UWCubeSat/DubSat1/teams/power/Documentation/Images/Battery board V4.3 v2 Z View.png

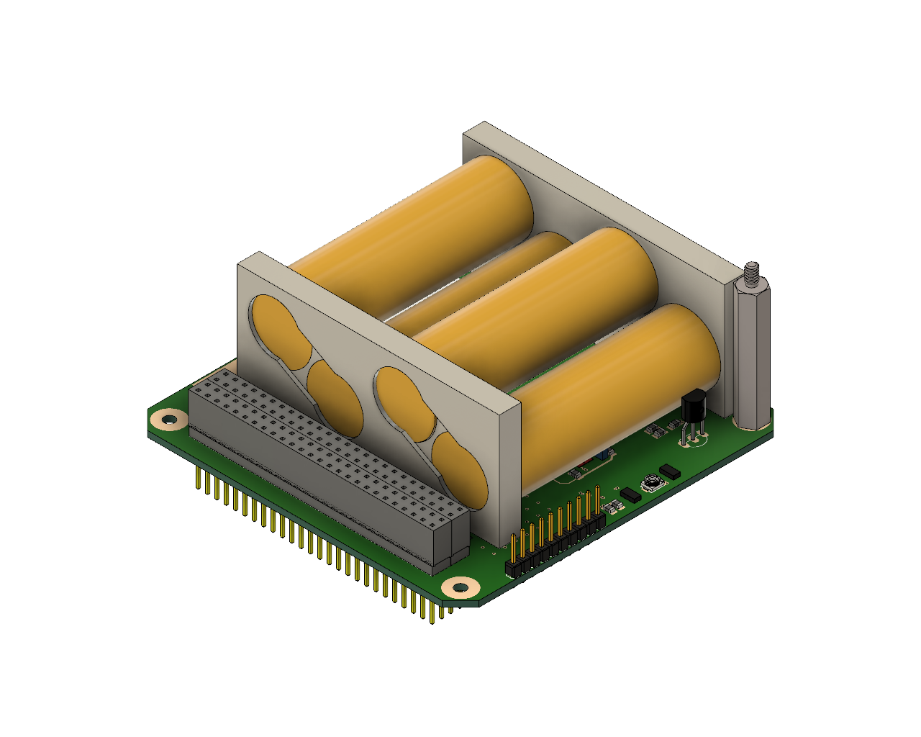
teams/power/Documentation/Images/Battery board V4.3 v2 Z View.png
