UWCubeSat/DubSat1/teams/power/Battery Board/README.md

This folder is for the Battery Board and associated assemblies.
