UWCubeSat/DubSat1/teams/power/Distribution Board/README.md

This folder is for the Distribution Board and associated assemblys
