UWCubeSat/DubSat1/teams/power/Gen Board/README.md

This folder is for the Gen Board and associated assemblies
