UWCubeSat/DubSat1/teams/power/Solar Panels/README.md

This folder is for center and side solar panels. Including assemblies and documantation related to solar panels.
