UWCubeSat/DubSat1/src/dsbase/interfaces/README.txt

This folder will hold the files that define any "interfaces" that need to be used between subsystems.  Examples of these include:

- CAN-Bus message structures (along with helpers for parsing/creating/viewing them, made as generic as possible)
- <that's all for now :)>
