UWCubeSat/DubSat1/teams/power/Gen Board/Gen Board V4/README.MD

This is an ordered board. Please See latest version
