UWCubeSat/DubSat1/teams/power/Battery Board/Battery Ballancer/README.md

This folder is for documents related to the battery balancer.
