UWCubeSat/DubSat1/teams/power/Battery Board/Coulomb Counter/README.md

This folder is for the coulomb counter. Including board designs and related documentation.
