UWCubeSat/DubSat1/teams/power/Battery Board/Battery Board V2/README.md

This is an ordered board, do not modify. See a more recent version.
