UWCubeSat/DubSat1/teams/power/Battery Board/Battery Board V3/README.md

# V3 is an ordered board please do not modify. See a more recent version.
