UWCubeSat/DubSat1/teams/power/Solar Panels/Side Panel V4/README.md

This is an ordered board, do not modify. See a more recent version.
