UWCubeSat/DubSat1/assets/calculationsCorrect.png

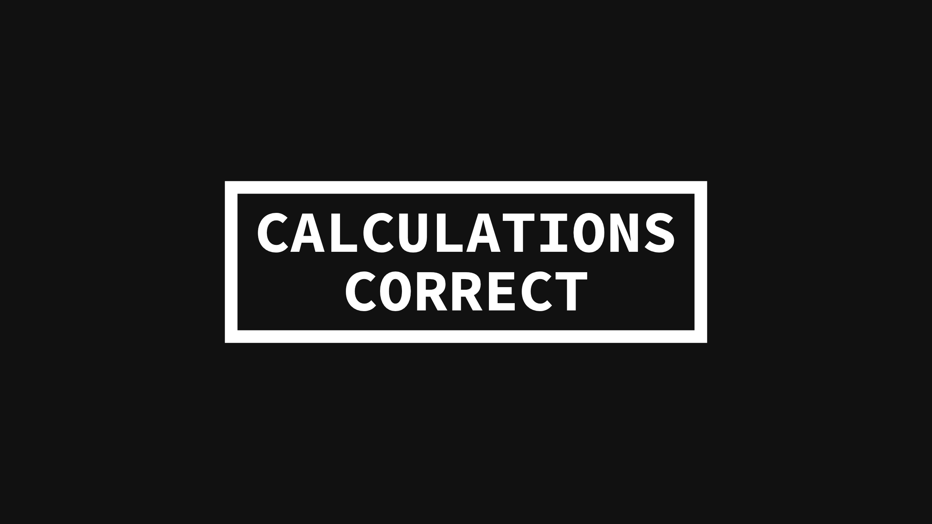
assets/calculationsCorrect.png
