UWCubeSat/DubSat1/teams/power/Documentation/Images/Blank Diagram - Page 1 (4).png

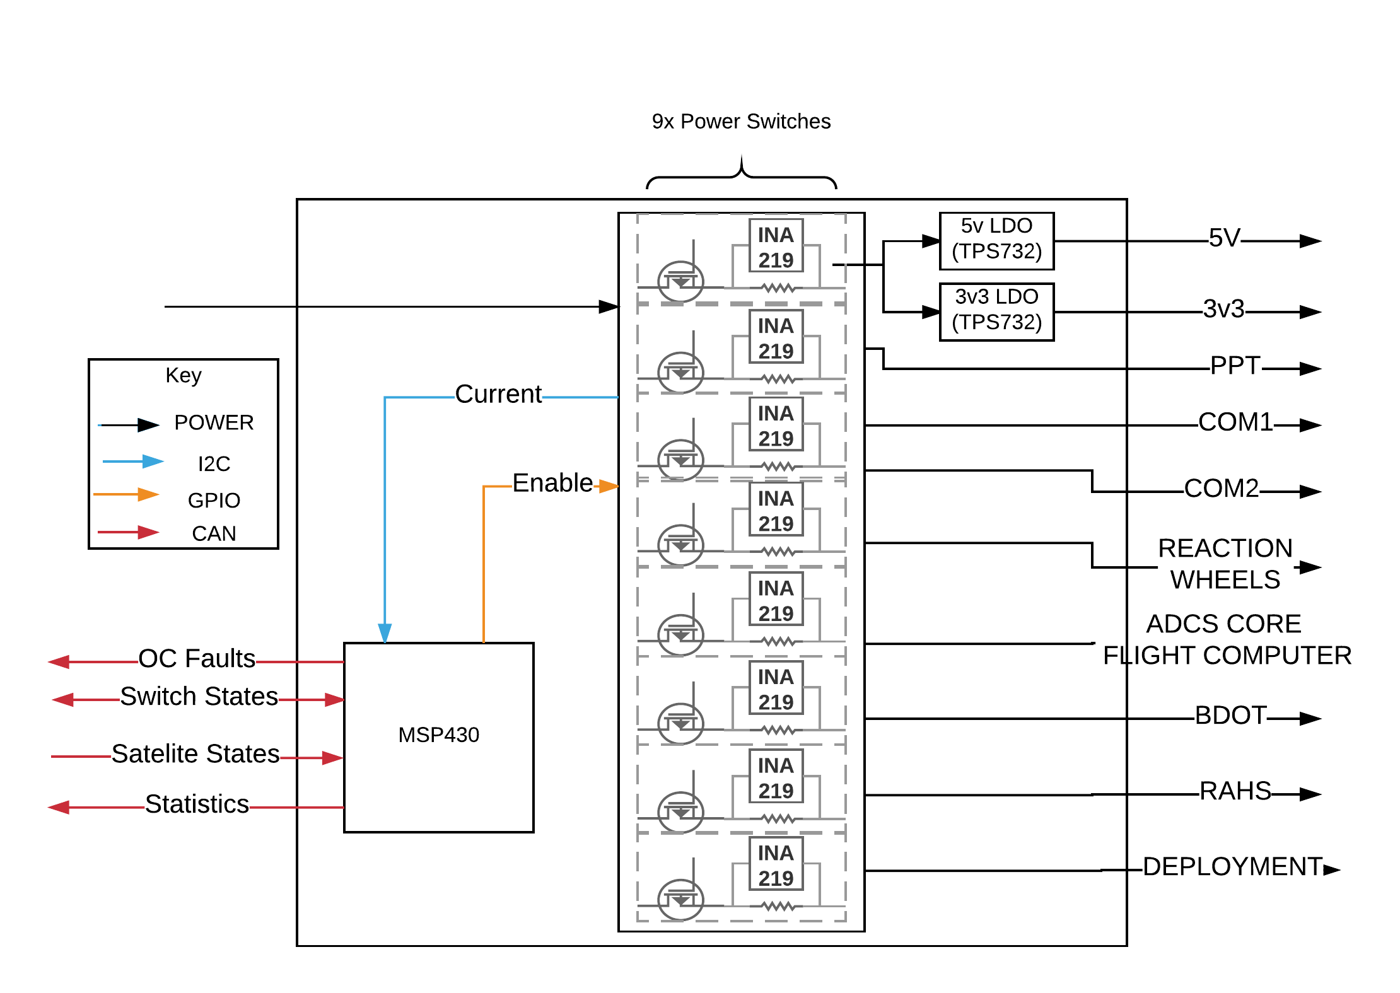
teams/power/Documentation/Images/Blank Diagram - Page 1 (4).png
