UWCubeSat/DubSat1/teams/power/Documentation/Images/Center panel V1.3 Eagle Layout.png

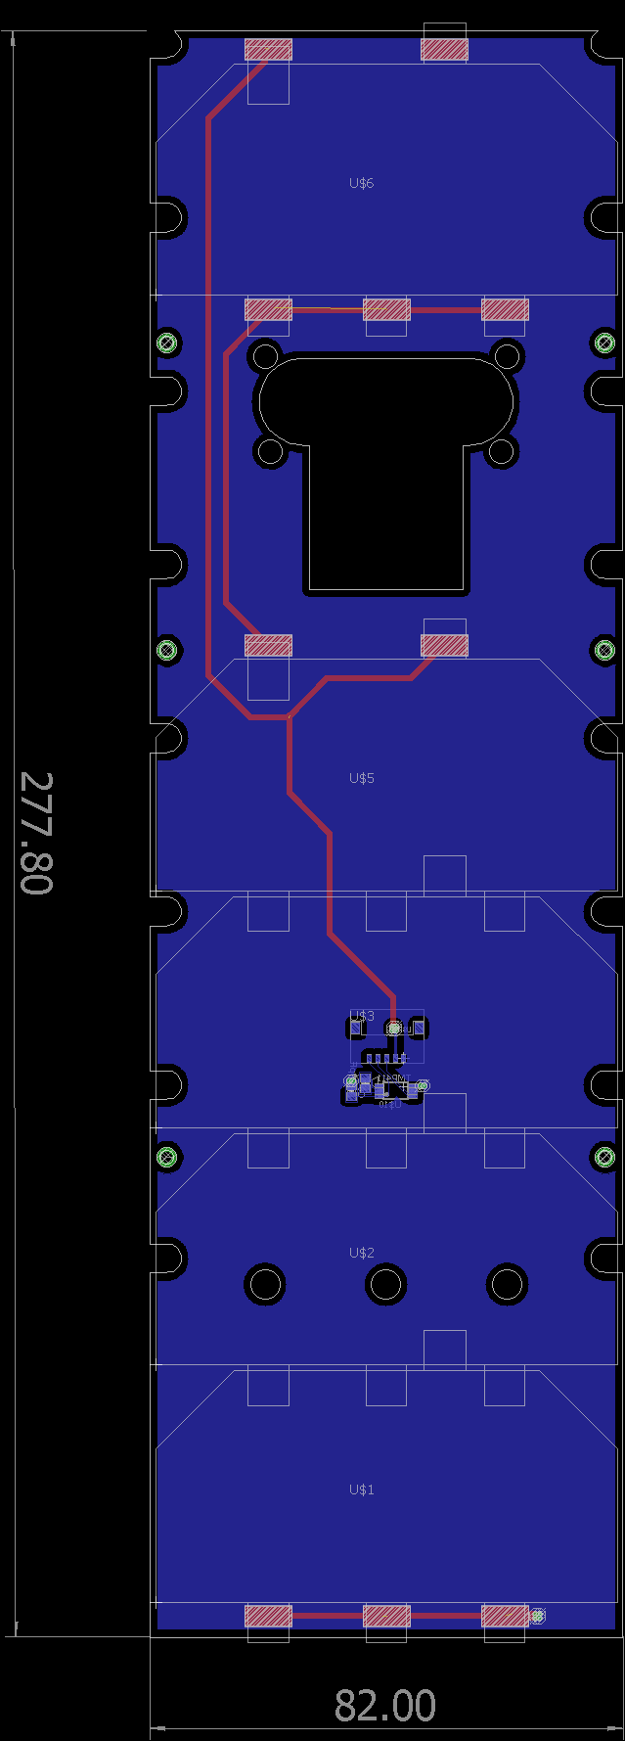
teams/power/Documentation/Images/Center panel V1.3 Eagle Layout.png
