UWCubeSat/DubSat1/teams/power/Documentation/Images/Center panel V1.3.brd v3.png

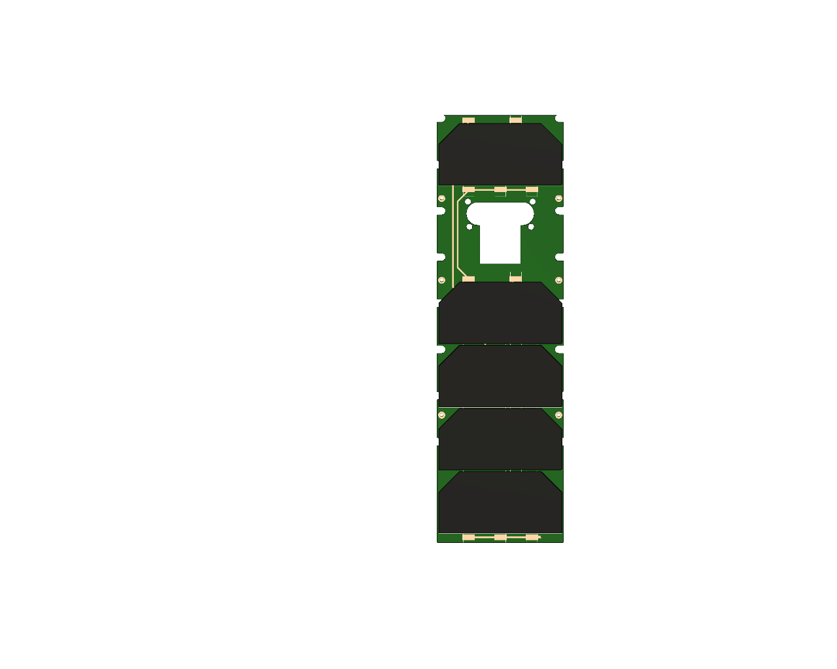
teams/power/Documentation/Images/Center panel V1.3.brd v3.png
