UWCubeSat/DubSat1/teams/power/Documentation/Images/Power Block Diagram - Page 1 (3).png

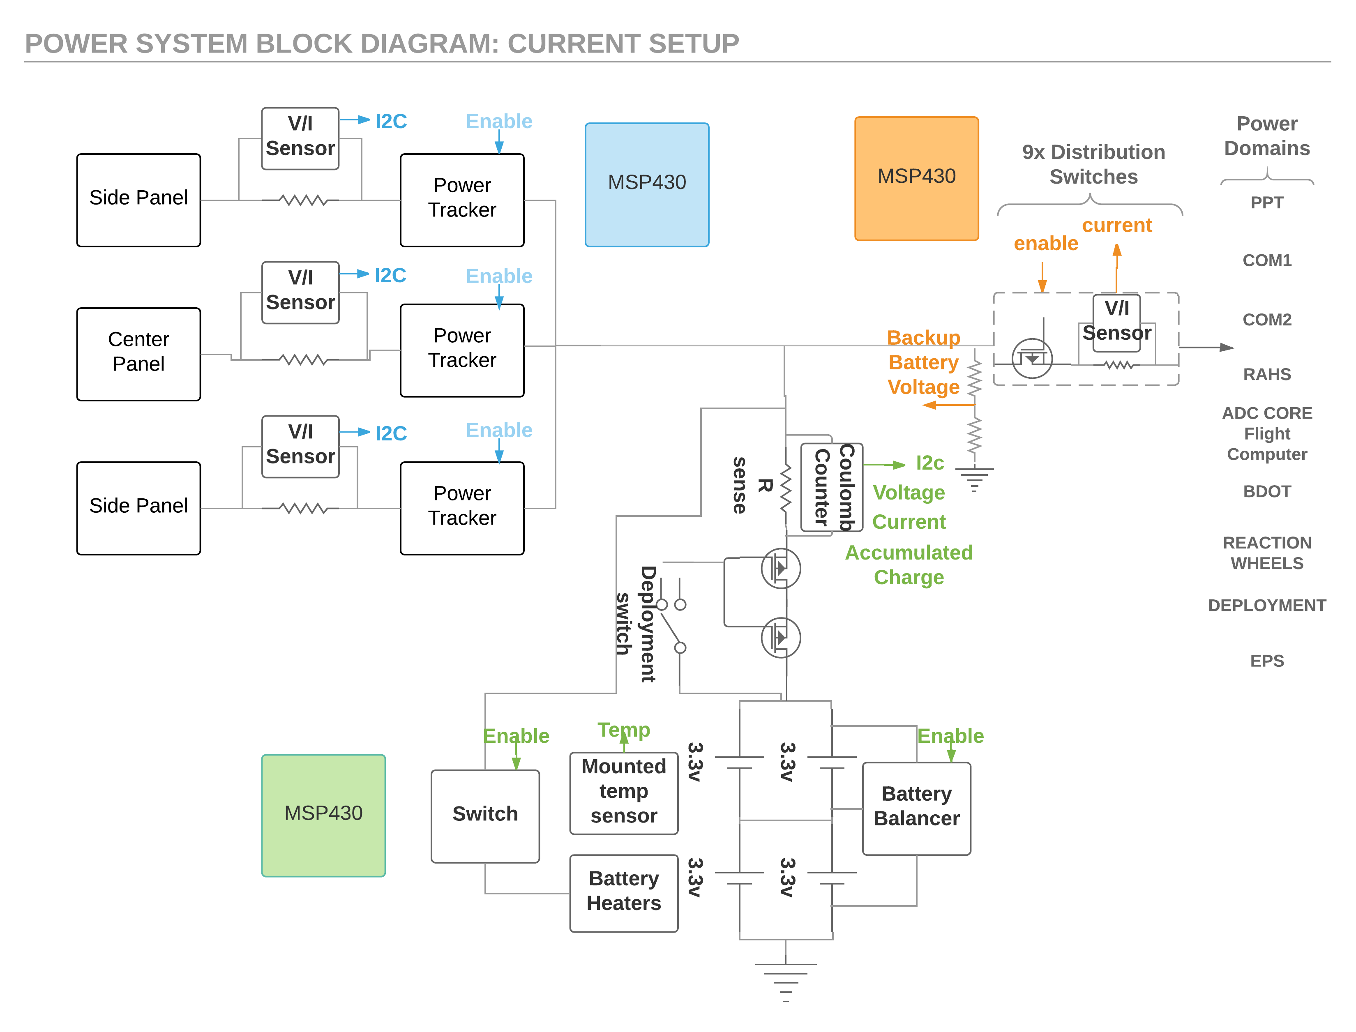
teams/power/Documentation/Images/Power Block Diagram - Page 1 (3).png
