UWCubeSat/DubSat1/teams/power/Documentation/Images/Power Gen Board Block Diagram - Page 1.png

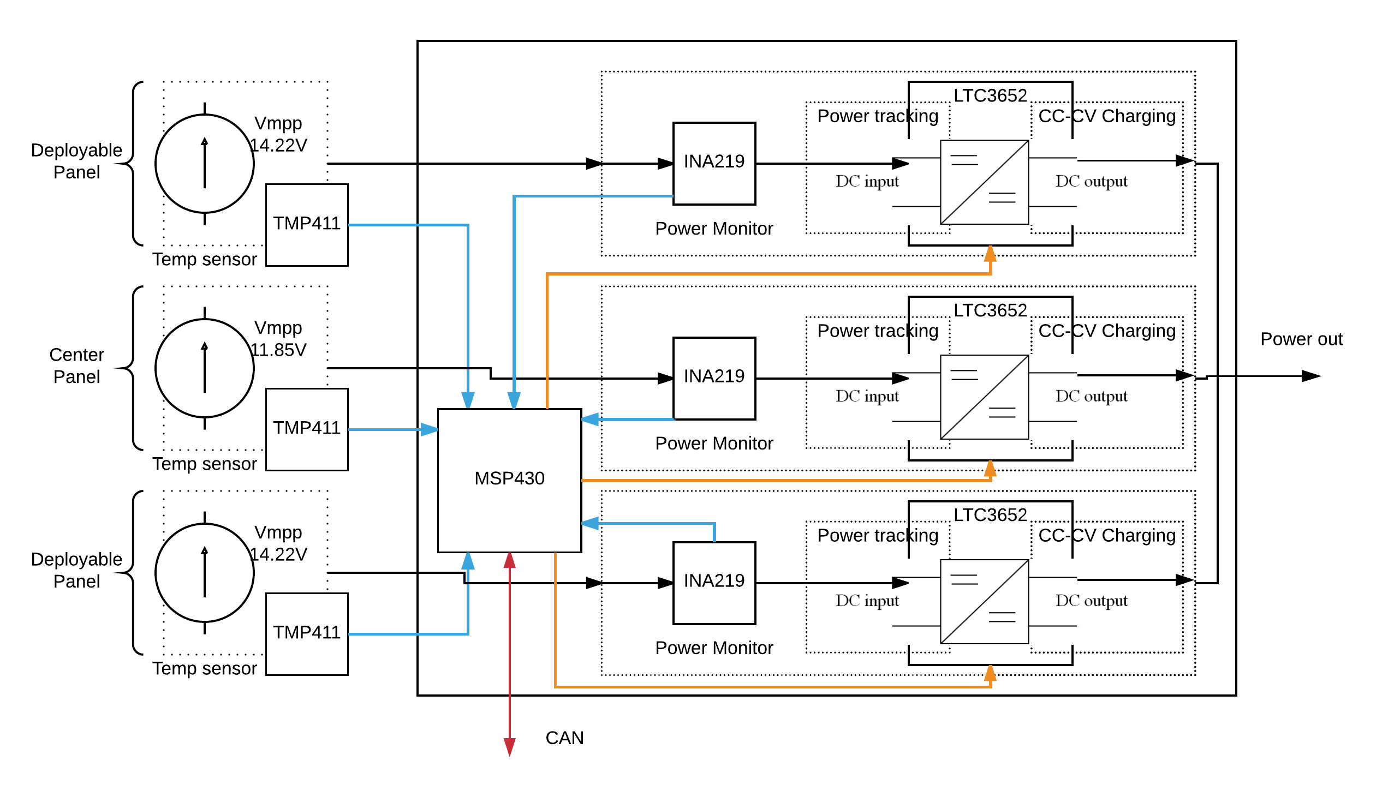
teams/power/Documentation/Images/Power Gen Board Block Diagram - Page 1.png
