UWCubeSat/DubSat1/teams/power/Documentation/Images/Power system overview - Page 1 (2).png

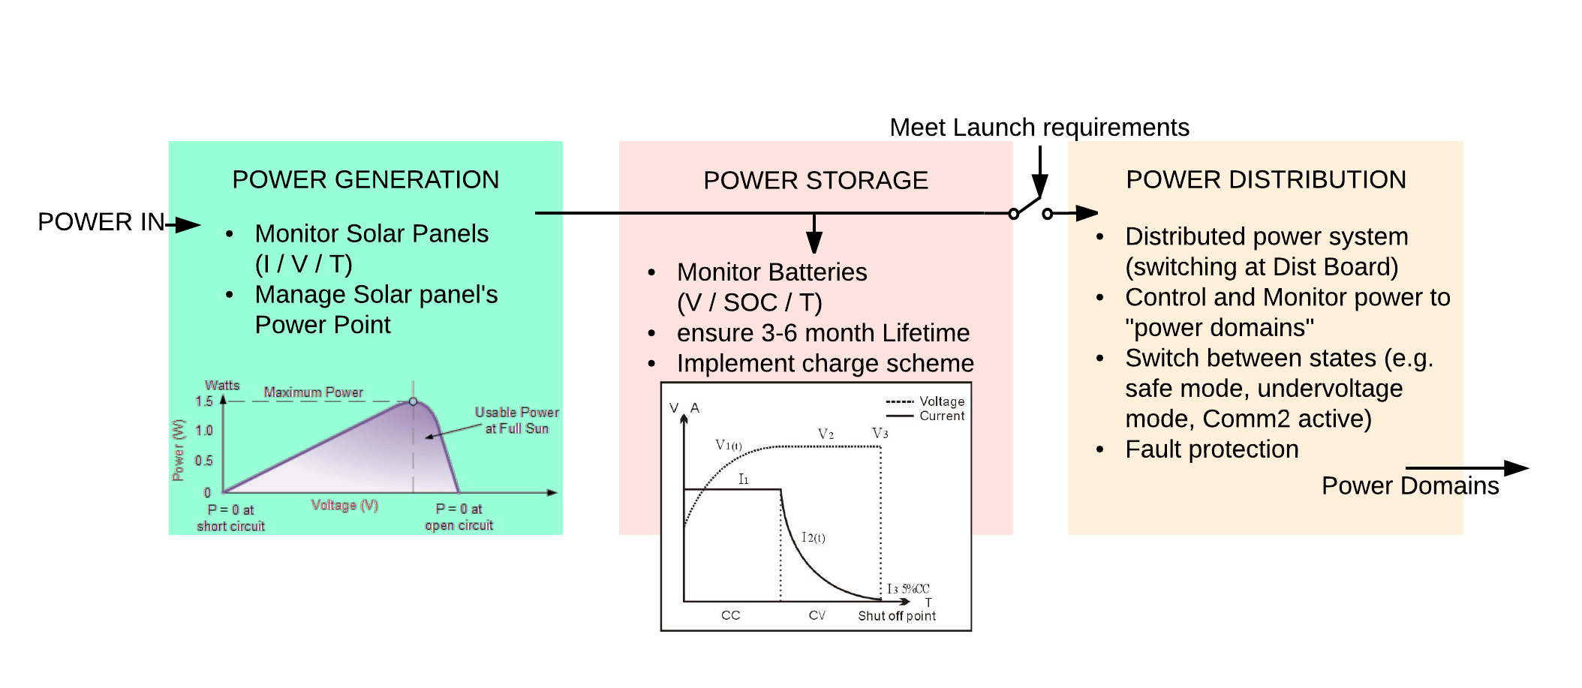
teams/power/Documentation/Images/Power system overview - Page 1 (2).png
