UWCubeSat/DubSat1/teams/power/Documentation/Images/Side panel - exploded view local render.png

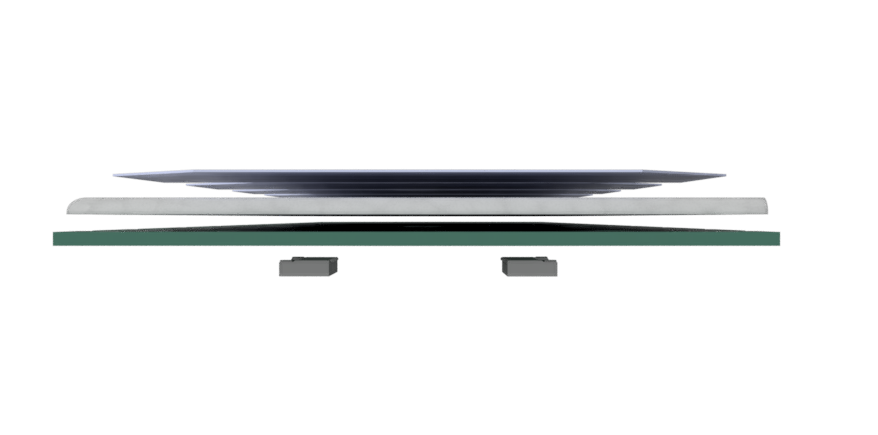
teams/power/Documentation/Images/Side panel - exploded view local render.png
