UWCubeSat/DubSat1/teams/power/Documentation/Images/Side panel Exploded View Mark-up - Page 1 (2).png

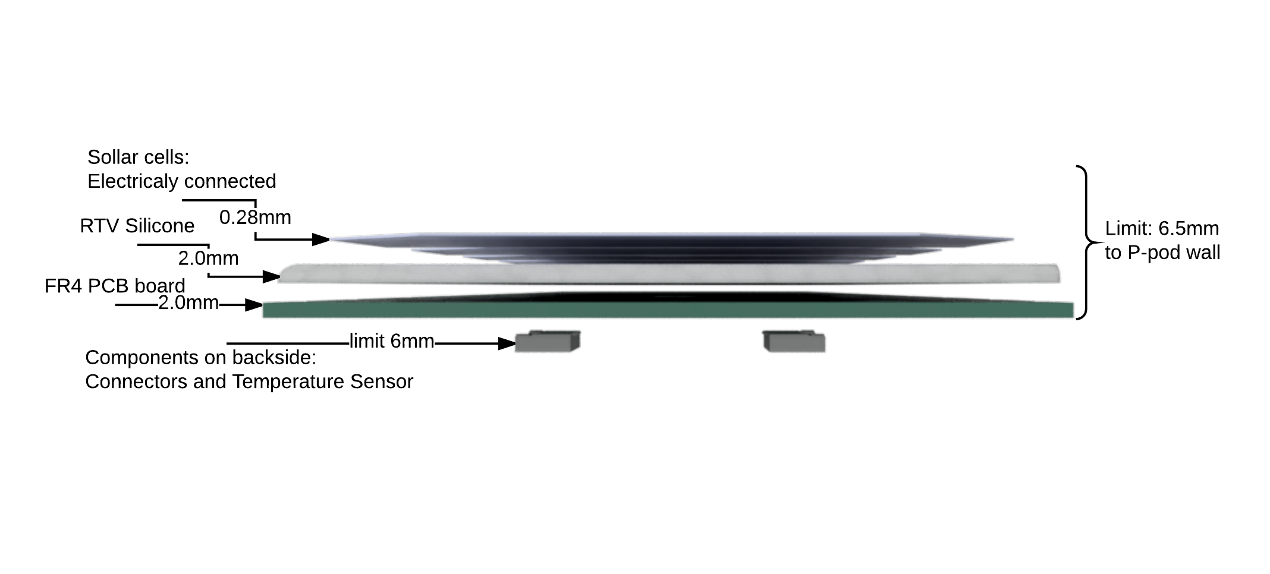
teams/power/Documentation/Images/Side panel Exploded View Mark-up - Page 1 (2).png
