UWCubeSat/DubSat1/teams/power/Documentation/Images/Side Panel V5.2 Eagle.png

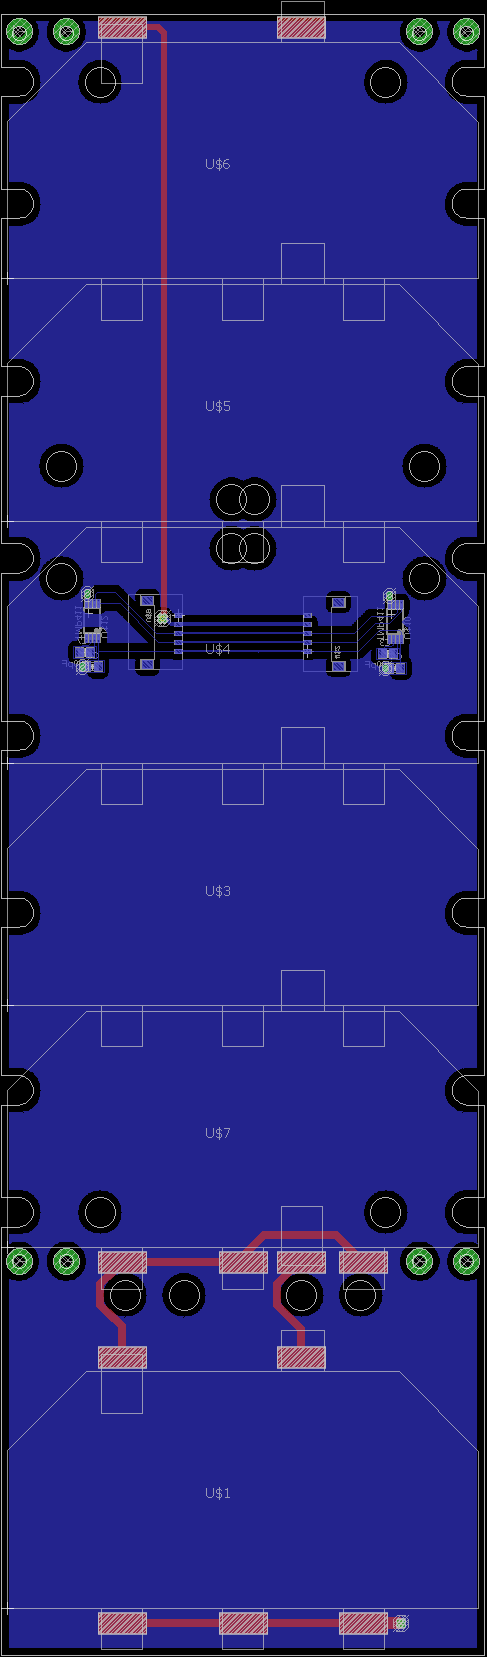
teams/power/Documentation/Images/Side Panel V5.2 Eagle.png
