UWCubeSat/DubSat1/teams/general/MOLEX comunications/Pico-lock order request 10-12-17.docx

Total order:

5x 4pin Header: 504050-0491

5x 4pin crimp housing: 504051-0401

18x 5pin Header: 504050-0591

18x 5pin crimp housing: 504051-0501

5x 6pin Header: 504050-0691

5x 6pin crimp housing: 504051-0601

5x Header: 504050-0891

5x crimp housing: 504051-0801

180x Crimp terminal 24-28 awg: 5040520098

1x Crimper: 63827-0800

Breakdown

Crimper part number: 63827-0800

1.5mm pitch – 4 pin

5x Header: 504050-0491

5x crimp housing: 504051-0401

20x Crimp terminal 24-28 awg: 5040520098

1.5mm pitch – 5 pin (these are harder to come buy so I’m asking for enough to make sets of solar panels and 3 power gen boards)

18x Header: 504050-0591

18x crimp housing: 504051-0501

90x Crimp terminal 24-28 awg: 5040520098

1.5mm Pitch – 6 pin

5x Header: 504050-0691

5x crimp housing: 504051-0601

30x Crimp terminal 24-28 awg: 5040520098

1.5mm pitch – 8 pin

5x Header: 504050-0891

5x crimp housing: 504051-0801

40x Crimp terminal 24-28 awg: 5040520098
