UWCubeSat/DubSat1/teams/power/Cycle Test/Build info/cycle test parts.xlsx

part | spec | datasheet | order | quantity
relay | 10A/ 5v coil |  | amazon (https://www.amazon.com/Songle-SRD-05VDC-SL-C-Household-Appliance-Pieces/dp/B00O9WPAJ6) | 1= (10pcs)
5/10A resistor | .33Ω/600W |  | amazon (https://www.amazon.com/SODIAL-Green-Aluminum-Shell-Resistors/dp/B00ZT9U494?s=industrial) | 2 = (4pcs)
1A resistor | 6Ω/600W |  | amazon (https://www.amazon.com/Uxcell-a12042100ux0234-Aluminum-Wirewound-Resistors/dp/B008IDA8FI) | 1 = (2pcs)
