UWCubeSat/DubSat1/teams/power/Documentation/Power Budget/power budget 7-11-2017.xlsx

Summary |  |  |  |  | Key
Average Power Disipated (W) (based on percent of orbit that devices are on) | 4.062812 | Best Case Power Gen (W) (100% in the sun 100% sun pointing) | 18.47
current on distributed 3.3V rail (mA) (everything on) | 409.55 | Worst Case Power Gen (W) (55% in the sun, Velocity pointing) | 10.82
current on distributed 5V rail (mA) (everythin on) | 50
PPT
Charge Waveform
sawtooth waveform average (1 second) | sawtoth waveform Max | charge unit (2 seconds total: 1 second sawtooth waveform between 1/2 second breaks) | fire rate ( sawtooth waveform every 2 seconds) | average current | Duty cycle (per orbit) | nominal current (mA) | nominal power (W) | comments
2.12A (14W) | 8A (52.8W) | 1.06A (7W) | .5 Hz | 1.06A | 30% | 1060 | 7 | Only fires in the sun, after the batteries are fully charged.
 |  |  |  |  |  |  | average power per orbit (W)
 |  |  |  |  |  |  | 2.1
ADCS
Battery Rail (6.6v nominal)
subassembly | Part Information | quantity | nominal current (mA) | Duty cycle (per orbit) | peak current | nominal power | average power per orbit | comments
reaction wheels | reaction wheels | 3 | 50 | 70 | 150 | 0.99 | 0.693
 |  |  |  |  |  |  | 0
 |  |  |  |  |  |  | 0
 |  |  |  |  |  |  | 0
 |  |  |  |  |  |  | 0
 |  |  |  |  |  |  | 0
 |  |  | total current (mA) |  | total peak current (mA) | Total nominal power (W) | Average Power Per Orbit
 |  |  | 70 |  | 200 | 0.462 | 0.693
3.3V Rail
subassembly | Part information |  | nominal current (mA) | Duty cycle (per orbit) | peak current | nominal power (W) | average ower per orbit | comments
msp430 | msp430 | 8 | 1.9 | 100 |  | 0.05016 | 0.05016
msp432 | msp432 | 2 | 3.9 | 80 |  | 0.02574 | 0.020592
IMU | lsm6dsm | 1 | 0.65 | 20 |  | 0.002145 | 0.000429
 | hmc5883l | 2 | 0.1 | 80 |  | 0.00066 | 0.000528
 | nano SSOC d60 | 2 | 23 | 40 |  | 0.1518 | 0.06072
 | NOVATEL OEM 615 | 1 | 300 | 10 |  | 0.99 | 0.099
photodiod wire path | photodiod wire path | 1 | tbd based on wire lengths |  |  |  | 0
 |  |  | total current (mA) |  | total peak current (mA) | total power (W) | Average power per orbit
 |  |  | 329.55 |  | 0 | 1.220505 | 0.231429
5V Rail
subassembly | Part information |  | nominal current (mA) | Duty cycle (percent of an orbit) | peak current | nominal power (W) | average ower per orbit | comments
magnetorquers | magnetorquers | 3 | 20 | 30 | 50 | 0.3 | 0.09
 |  |  |  |  |  | 0 | 0
 |  |  |  |  |  | 0 | 0
 |  |  |  |  |  | 0 | 0
 |  |  |  |  |  | 0 | 0
 |  |  |  |  |  | 0 | 0
 |  |  |  |  |  |  | 0
 |  |  | total current (mA) |  | total peak current (mA) | total power (W) | Average power per orbit
 |  |  | 20 |  | 50 | 0.3 | 0.09
Summary
 |  |  |  |  |  | total power (W) | Average power per orbit | comments
 |  |  |  |  |  | 2.962965 | 1.014429
Comm 2
Battery Rail (6.6v nominal)
subassembly | Part Information | quantity | nominal current (mA) | Duty cycle (per orbit) | peak current | nominal power (W) | average power per orbit | comments
sdr |  |  | 303 | 1.00 |  | 2 | 0.02 | 1% duty cycle is an overestimate because this syubsystem will hardly every be on.. IT will only be on during a rare pass when we happen to be pointing at UW while also velocit and sun pointing.
rasbery pi 3 |  |  | 454 | 1.00 |  | 3 | 0.03
rf front end |  |  | 1666 | 1.00 |  | 11 | 0.11
 |  |  | total current (mA) |  | total peak current (mA) | Total nominal power (W) | Average Power Per Orbit
 |  |  | 2423 |  | 0 | 16 | 0.16
Comm 1
Battery Rail (6.6v nominal)
State | Nominal current (mA) | Time on (minutes) (estimate) | On every (hours) (estimate) | Duty cycle (per orbit) | peak current | nominal power (W) | Average power per orbit | comments
Idle | 53 |  |  | 97.08333333 | 53 | 0.35 | 0.3397916667 | Duty cycle based on estimate of transmitting for 7 min every 4 hours.
Transmitting | 190 | 7 | 4 | 2.916666667 | 190 | 1.25 | 0.03645833333
 | total current (mA) |  |  |  | total peak current (mA) | Total nominal power (W) | Average Power Per Orbit
 | 243 |  |  |  | 243 | 1.6 | 0.37625
Power
Battery Rail (6.6v nominal)
subassembly | Part Information | quantity | nominal current (mA) | Duty cycle (percent of orbit) | peak current | nominal power (with efficiency) | average power per orbit | comments
Coulomb Counter | LTC2943 | 1 | 0.65 | 100 | 0.75 | 0.00429 | 0.00429
Battery Heater |  | 4 | 48.3 | 30 | 48.3 | 1.27512 | 0.382536
components running off of 5V LDO, efficiency = 5v / 6.6v = .757 |  |  |  |  |  |  | 0
Temp Sensor | LM57-q1 | 1 | 0.026 | 100 | 0.029 | 0.000227 | 0.000227
components running off of 3.3V LDO, efficiency = 3.3v / 6.6v = .5 |  |  |  |  |  |  | 0
MSP430 |  | 1 | 1.9 | 100 | 2.5 | 0.02508 | 0.02508
 |  |  | total current (mA) | Total current adjusted for efficiencys | total peak current (mA) | Total nominal power (W) | Average Power Per Orbit
 |  |  | 50.876 | 52.7843461 | 54.08830911 | 1.304717 | 0.412133
Rasbeck Aviation High School
Battery Rail (6.6v nominal)
subassembly | Part Information | quantity | nominal current (mA) | Duty cycle (percent of an orbit) | peak current | nominal power | average power per orbit | comments
Camera |  | 1 | 250 | 1 |  | 1.65 | 0.0165 | This subsystem is only turned on from the ground so I chose to estimate it as 1%
 |  |  |  |  |  | 0 | 0
 |  |  |  |  |  | 0 | 0
 |  |  |  |  |  | 0 | 0
 |  |  |  |  |  | 0 | 0
 |  |  |  |  |  | 0 | 0
 |  |  |  |  |  | 0 | 0
 |  |  | total current (mA) |  | total peak current (mA) | Total nominal power (W) | Average Power Per Orbit
 |  |  |  |  |  | 1.65 | 0.0165
3.3V Rail
subassembly | Part information |  | nominal current (mA) | Duty cycle (percent of an orbit) | peak current | nominal power (W) | average ower per orbit | comments
Rasbery Pi Zero |  | 1 | 80 | 0.01 |  | 0.264 | 2.64e-05 | This subsystem is only turned on from the ground so I chose to estimate it as 1%
 |  |  |  |  |  | 0 | 0
 |  |  |  |  |  | 0 | 0
 |  |  |  |  |  | 0 | 0
 |  |  |  |  |  | 0 | 0
 |  |  |  |  |  | 0 | 0
 |  |  |  |  |  |  | 0
 |  |  | total current (mA) |  | total peak current (mA) | total power (W) | Average power per orbit
 |  |  | 80 |  | 0 | 0.264 | 2.64e-05
5V Rail
subassembly | Part information |  | nominal current (mA) | Duty cycle (percent of an orbit) | peak current | nominal power (W) | average ower per orbit | comments
 |  |  |  |  |  | 0 | 0
 |  |  |  |  |  | 0 | 0
 |  |  |  |  |  | 0 | 0
 |  |  |  |  |  | 0 | 0
 |  |  |  |  |  | 0 | 0
 |  |  |  |  |  | 0 | 0
 |  |  |  |  |  |  | 0
 |  |  | total current (mA) |  | total peak current (mA) | total power (W) | Average power per orbit
 |  |  | 0 |  | 0 | 0 | 0
Summary
 |  |  |  |  |  | total power (W) | Average power per orbit | comments
 |  |  |  |  |  | 1.914 | 0.0165264
