UWCubeSat/DubSat1/teams/power/Documentation/purchase requests/Intro projects + temp sensor.xls

 |  |  |  |  |  |  |  | P.O., Trans., or E.P. #
 |  |  |  |  |  |  |  | Department Approval
 |  |  |  |  | Required for All Grant Budgets |  |  | (Office Use)
Your Name | Sean Poulter | Vendor Name | digikey | Purpose: | Intro project components + temp sensor for solar panels
Phone | 4257367405 | Address
Email | spoulter@uw.edu | Contact |  |  |  |  |  | PI Budget Approval
Date | 2017-12-14 | Phone
Need by: | 2017-12-21 | Email
 |  | URL | http://www.digikey.com/
 |  |  |  |  |  |  |  | Budget | % or $
 |  |  |  |  |  |  | 1
 |  |  |  |  |  |  | 2
M&E Policy & Assistance. Click here |  |  |  |  |  |  | 3
 |  |  |  |  |  |  | 4
Part # | Description |  |  | Quantity | Unit Price | Total
MCP3428-E/SL-ND | Analog to digital converter MCP3428 |  |  | 6 | 3.74 | 22.44
TMP36GRTZ-REEL7CT-ND | TMP36GRTZ-REEL7 surface mount TMP36 |  |  | 10 | 1.59 | 15.90
LM555CMX/NOPBCT-ND | LM555 |  |  | 2 | 1.02 | 2.04
 |  |  |  | 1 | 0.00 | 0.00
 |  |  |  | 1 | 0.00 | 0.00
 |  |  |  | 1 | 0.00 | 0.00
 |  |  |  | 1 | 0.00 | 0.00
 |  |  |  | 1 | 0.00 | 0.00
 |  |  |  | 1 | 0.00 | 0.00
 |  |  |  | 1 | 0.00 | 0.00
 |  |  |  |  | Subtotal | 40.38
Comments: |  |  |  |  | Estimated Shipping
Cart link: http://www.digikey.com/short/qqm95t |  |  |  |  | Tax at 10.1% | 4.08
 |  |  |  |  | Total | 44.46
 |  |  |  |  |  |  |  |  | v.7.0
