UWCubeSat/DubSat1/teams/power/Documentation/purchase requests/Hex inserts purchase request.xlsx

 |  |  |  |  |  |  |  | P.O., Trans., or E.P. #
 |  |  |  |  |  |  |  | Department Approval
 |  |  |  |  | Required for All Grant Budgets |  |  | (Office Use)
Your Name | Sean Poulter | Vendor Name | Mcmaster-Carr | Purpose: | CubeSat development
Phone | 425-736-7405 | Address | 9630 Norwalk Blvd. 90670-2932
Email | spoulter@uw.edu | Contact |  |  |  |  |  | PI Budget Approval
Date | 2017-11-11 | Phone | (562) 692-5911
Need by: | 2017-11-22 | Email | la.sales@mcmaster.com
 |  | URL | https://www.mcmaster.com/
 |  |  |  |  |  |  |  | Budget | % or $
 |  |  |  |  |  |  | 1
 |  |  |  |  |  |  | 2
M&E Policy & Assistance. Click here |  |  |  |  |  |  | 3
 |  |  |  |  |  |  | 4
Part # | Description |  |  | Quantity | Unit Price | Total
92398A112 | 18-8 Stainless Steel Twist-Resistant Hex-Shaped Inserts - 4-40 (25pk) |  |  | 1 | 9.19 | 9.19
 |  |  |  | 1 | 0.00 | 0.00
 |  |  |  | 1 | 0.00 | 0.00
 |  |  |  | 1 | 0.00 | 0.00
 |  |  |  | 1 | 0.00 | 0.00
 |  |  |  | 1 | 0.00 | 0.00
 |  |  |  | 1 | 0.00 | 0.00
 |  |  |  | 1 | 0.00 | 0.00
 |  |  |  | 1 | 0.00 | 0.00
 |  |  |  | 1 | 0.00 | 0.00
 |  |  |  |  | Subtotal | 9.19
Comments: |  |  |  |  | Estimated Shipping
Link for part: https://www.mcmaster.com/#92398a112/=1a6omp6 |  |  |  |  | Tax at 10.1% | 0.93
 |  |  |  |  | Total | 10.12
 |  |  |  |  |  |  |  |  | v.7.0
