UWCubeSat/DubSat1/teams/power/Documentation/purchase requests/INA219 breakout purchase request.xlsx

 |  |  |  |  |  |  |  | P.O., Trans., or E.P. #
 |  |  |  |  |  |  |  | Department Approval
 |  |  |  |  | Required for All Grant Budgets |  |  | (Office Use)
Your Name | Sean Poulter | Vendor Name | Amazon | Purpose: | CubeSat development
Phone | 425 736 7405 | Address
Email | spoulter@uw.edu | Contact |  |  |  |  |  | PI Budget Approval
Date | 2017-11-16 | Phone
Need by: | 2016-11-22 | Email
 |  | URL | www.amazon.com
 |  |  |  |  |  |  |  | Budget | % or $
 |  |  |  |  |  |  | 1
 |  |  |  |  |  |  | 2
M&E Policy & Assistance. Click here |  |  |  |  |  |  | 3
 |  |  |  |  |  |  | 4
Part # | Description |  |  | Quantity | Unit Price | Total
B00SK8M5GG | Adafruit Accessories INA219 DC Current Sensor Breakout (1 piece) |  |  | 2 | 13.66 | 27.32
 |  |  |  | 1 | 0.00 | 0.00
 |  |  |  | 1 | 0.00 | 0.00
 |  |  |  | 1 | 0.00 | 0.00
 |  |  |  | 1 | 0.00 | 0.00
 |  |  |  | 1 | 0.00 | 0.00
 |  |  |  | 1 | 0.00 | 0.00
 |  |  |  | 1 | 0.00 | 0.00
 |  |  |  | 1 | 0.00 | 0.00
 |  |  |  | 1 | 0.00 | 0.00
 |  |  |  |  | Subtotal | 27.32
Comments: |  |  |  |  | Estimated Shipping | 0.00
Link to part: https://www.amazon.com/Adafruit-Accessories-INA219-Current-Breakout/dp/B00SK8M5GG?s=industrial |  |  |  |  | Tax at 10.1% | 2.76
 |  |  |  |  | Total | 30.08
 |  |  |  |  |  |  |  |  | v.7.0
