UWCubeSat/DubSat1/teams/power/Documentation/purchase requests/RTV162 and silver sheet purchase request.xlsx

 |  |  |  |  |  |  |  | P.O., Trans., or E.P. #
 |  |  |  |  |  |  |  | Department Approval
 |  |  |  |  | Required for All Grant Budgets |  |  | (Office Use)
Your Name | Sean Poulter | Vendor Name | Amazon | Purpose: | CubeSat development
Phone | 425-736-7405 | Address
Email | spoulter@uw.edu | Contact |  |  |  |  |  | PI Budget Approval
Date | 2017-11-11 | Phone
Need by: | 2017-11-22 | Email
 |  | URL | www.amazon.com
 |  |  |  |  |  |  |  | Budget | % or $
 |  |  |  |  |  |  | 1
 |  |  |  |  |  |  | 2
M&E Policy & Assistance. Click here |  |  |  |  |  |  | 3
 |  |  |  |  |  |  | 4
Part # | Description |  |  | Quantity | Unit Price | Total
B004V40LXW | Momentive RTV162 One Part Silicone Sealant, 10.1 Ounce Caulker, White |  |  | 1 | 46.78 | 46.78
B00C2D67K0 | 6"x1" Solid Fine.999 Silver Sheet From 28 Gauge |  |  | 1 | 23.74 | 23.74
 |  |  |  | 1 | 0.00 | 0.00
 |  |  |  | 1 | 0.00 | 0.00
 |  |  |  | 1 | 0.00 | 0.00
 |  |  |  | 1 | 0.00 | 0.00
 |  |  |  | 1 | 0.00 | 0.00
 |  |  |  | 1 | 0.00 | 0.00
 |  |  |  | 1 | 0.00 | 0.00
 |  |  |  | 1 | 0.00 | 0.00
 |  |  |  |  | Subtotal | 70.52
Comments: |  |  |  |  | Estimated Shipping
RTV link: https://www.amazon.com/Momentive-RTV162-Silicone-Sealant-Ounce/dp/B004V40LXW Silver link: https://www.amazon.com/Solid-Fine-999-Silver-Sheet-Gauge/dp/B00C2D67K0?s=arts-crafts |  |  |  |  | Tax at 10.1% | 7.12
 |  |  |  |  | Total | 77.64
 |  |  |  |  |  |  |  |  | v.7.0
