UWCubeSat/DubSat1/teams/power/Documentation/purchase requests/RTV162 purchase request.xlsx

 |  |  |  |  |  |  |  | P.O., Trans., or E.P. #
 |  |  |  |  |  |  |  | Department Approval
 |  |  |  |  | Required for All Grant Budgets |  |  | (Office Use)
Your Name | Sean Poulter | Vendor Name | Amazon | Purpose: | CubeSat development
Phone | 425-736-7405 | Address
Email | spoulter@uw.edu | Contact |  |  |  |  |  | PI Budget Approval
Date | 2017-11-11 | Phone
Need by: | 2017-11-22 | Email
 |  | URL | www.amazon.com
 |  |  |  |  |  |  |  | Budget | % or $
 |  |  |  |  |  |  | 1
 |  |  |  |  |  |  | 2
M&E Policy & Assistance. Click here |  |  |  |  |  |  | 3
 |  |  |  |  |  |  | 4
Part # | Description |  |  | Quantity | Unit Price | Total
RTV162-10.1 | Momentive RTV162 One Part Silicone Sealant, 10.1 Ounce Caulker, White |  |  | 1 | 46.78 | 46.78
 |  |  |  | 1 | 0.00 | 0.00
 |  |  |  | 1 | 0.00 | 0.00
 |  |  |  | 1 | 0.00 | 0.00
 |  |  |  | 1 | 0.00 | 0.00
 |  |  |  | 1 | 0.00 | 0.00
 |  |  |  | 1 | 0.00 | 0.00
 |  |  |  | 1 | 0.00 | 0.00
 |  |  |  | 1 | 0.00 | 0.00
 |  |  |  | 1 | 0.00 | 0.00
 |  |  |  |  | Subtotal | 46.78
Comments: |  |  |  |  | Estimated Shipping
link: https://www.amazon.com/Momentive-RTV162-Silicone-Sealant-Ounce/dp/B004V40LXW |  |  |  |  | Tax at 10.1% | 4.72
 |  |  |  |  | Total | 51.50
 |  |  |  |  |  |  |  |  | v.7.0
