UWCubeSat/DubSat1/teams/power/Documentation/purchase requests/Through hole temp sensors.xlsx

 |  |  |  |  |  |  |  | P.O., Trans., or E.P. #
 |  |  |  |  |  |  |  | Department Approval
 |  |  |  |  | Required for All Grant Budgets |  |  | (Office Use)
Your Name | Sean Poulter | Vendor Name | Mouser | Purpose: | Temp sensor for intro projects and battery board
Phone | 4257367405 | Address
Email | spoulter@uw.edu | Contact |  |  |  |  |  | PI Budget Approval
Date | 2017-12-14 | Phone
Need by: | 2017-12-22 | Email
 |  | URL | www.mouser.com
 |  |  |  |  |  |  |  | Budget | % or $
 |  |  |  |  |  |  | 1
 |  |  |  |  |  |  | 2
M&E Policy & Assistance. Click here |  |  |  |  |  |  | 3
 |  |  |  |  |  |  | 4
Part # | Description |  |  | Quantity | Unit Price | Total
584-TMP36GT9 | TMP36GT9 |  |  | 10 | 1.39 | 13.90
 |  |  |  | 1 | 0.00 | 0.00
 |  |  |  | 1 | 0.00 | 0.00
 |  |  |  | 1 | 0.00 | 0.00
 |  |  |  | 1 | 0.00 | 0.00
 |  |  |  | 1 | 0.00 | 0.00
 |  |  |  | 1 | 0.00 | 0.00
 |  |  |  | 1 | 0.00 | 0.00
 |  |  |  | 1 | 0.00 | 0.00
 |  |  |  | 1 | 0.00 | 0.00
 |  |  |  |  | Subtotal | 13.90
Comments: |  |  |  |  | Estimated Shipping
cart link: https://www.mouser.com/ProjectManager/ProjectDetail.aspx?AccessID=02e7d1a32b |  |  |  |  | Tax at 10.1% | 1.40
 |  |  |  |  | Total | 15.30
 |  |  |  |  |  |  |  |  | v.7.0
