UWCubeSat/DubSat1/teams/adcs/hardware/actuators/reaction_wheels/RW01 - RW Board Assy Rev02 Footprint.DXF

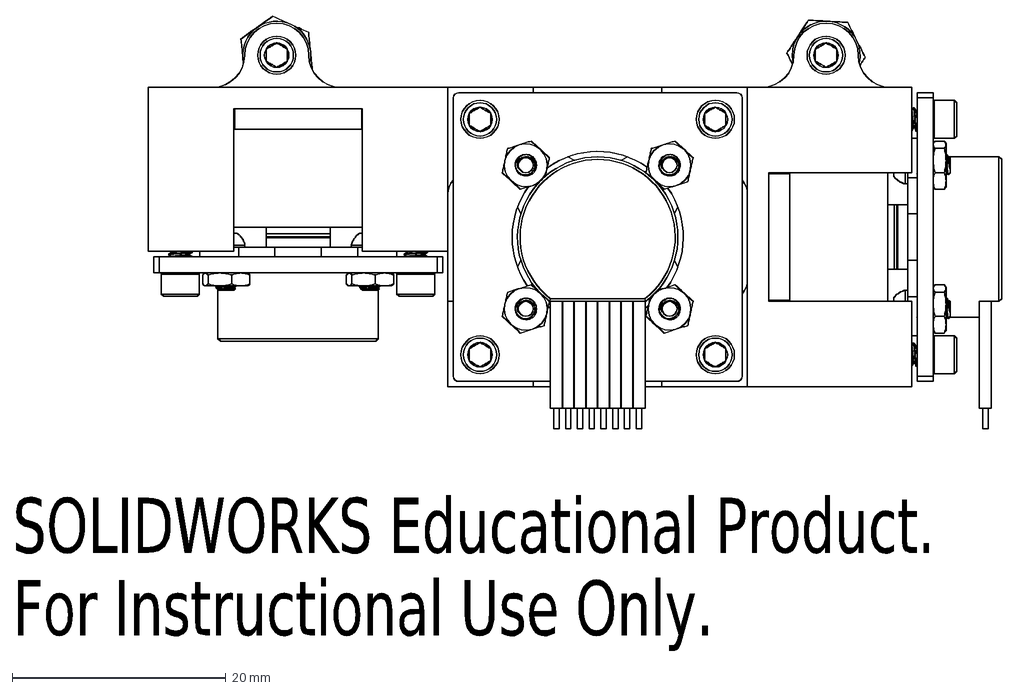
[picture p28: CAD file, 2018-04-01]
teams/adcs/hardware/actuators/reaction_wheels/RW01 - RW Board Assy Rev02 Footprint.DXF
SOLIDWORKS Educational Product.
For Instructional Use Only.
