UWCubeSat/DubSat1/teams/comm2/flight/FeedAssembly_v1/FeedAssembly_v1 DXF for flat mount2.dxf

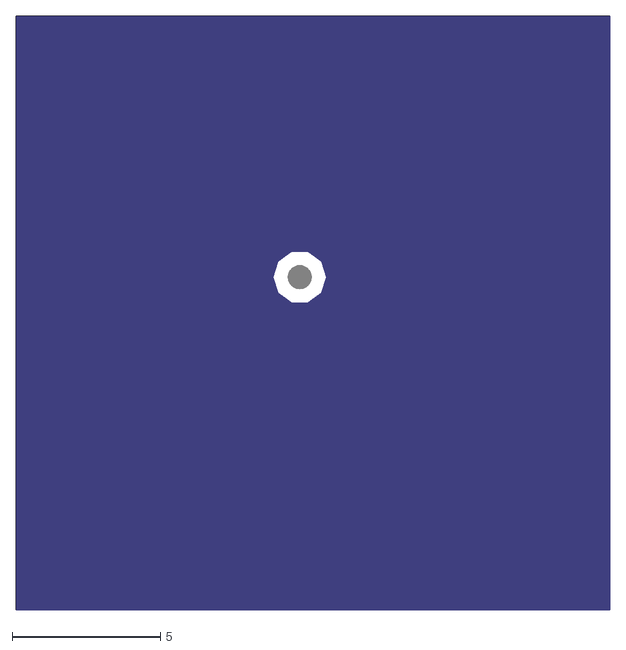
[picture p29: CAD file, 2019-07-06]
teams/comm2/flight/FeedAssembly_v1/FeedAssembly_v1 DXF for flat mount2.dxf
20.0 x 20.0
