UWCubeSat/DubSat1/teams/propulsion/flight/charger/ppt_full_charger_f1.dxf

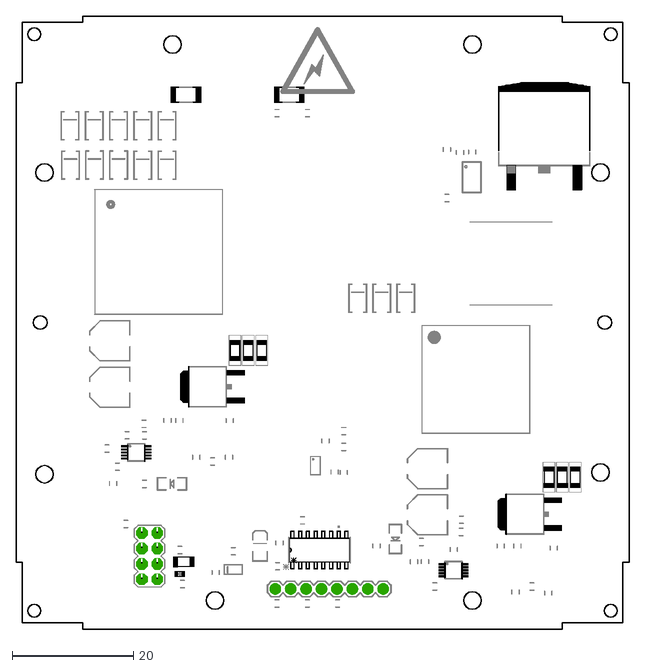
[picture p30: CAD file, 2019-07-06]
teams/propulsion/flight/charger/ppt_full_charger_f1.dxf
101.0 x 101.0
