UWCubeSat/DubSat1/teams/comm2/flight/FeedAssembly_v1/FeedAssembly_v1 for flat mount 3.dxf

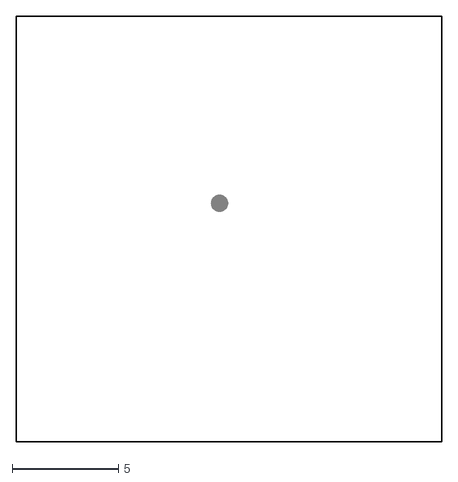
[picture p31: CAD file, 2019-07-06]
teams/comm2/flight/FeedAssembly_v1/FeedAssembly_v1 for flat mount 3.dxf
20.0 x 20.0
