UWCubeSat/DubSat1/teams/comm2/flight/FeedAssembly_v1/FeedAssembly_v1.step

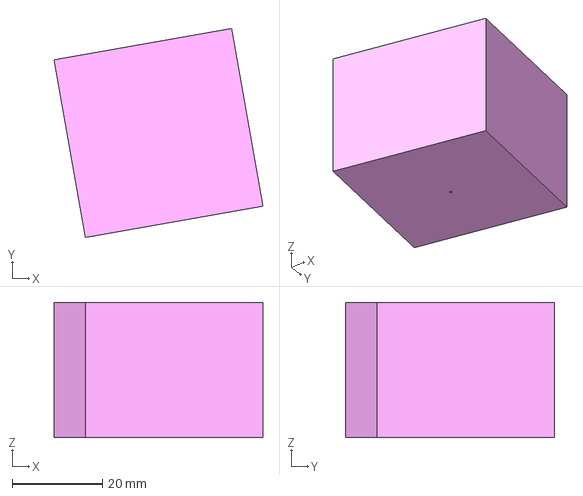
[picture p32: CAD file, 2018-04-18]
teams/comm2/flight/FeedAssembly_v1/FeedAssembly_v1.step
46.3 x 46.3 x 30.0 mm
