UWCubeSat/DubSat1/grnd/COSMOS/Demo/config/data/diamond.STL

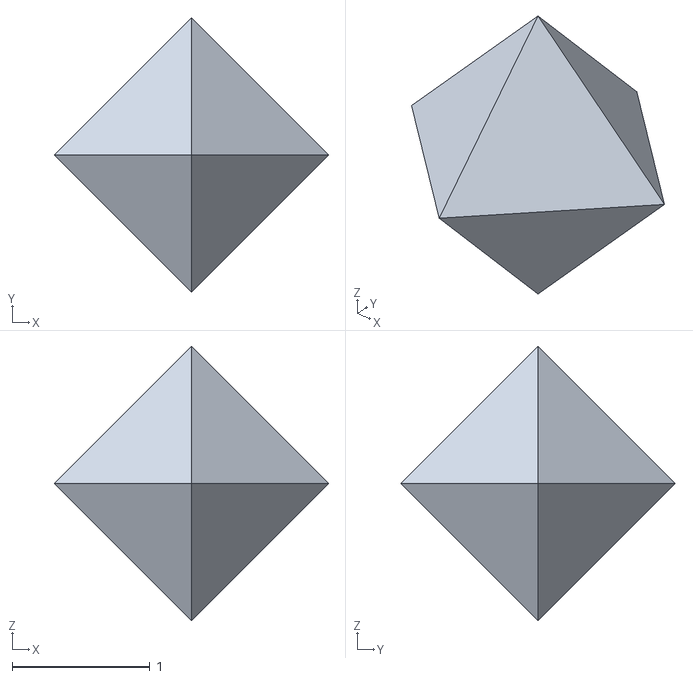
[picture p33: CAD file, 2017-10-12]
grnd/COSMOS/Demo/config/data/diamond.STL
2.00 x 2.00 x 2.00
