UWCubeSat/DubSat1/teams/comm2/flight/spacer_f1/spacer_f1.dxf

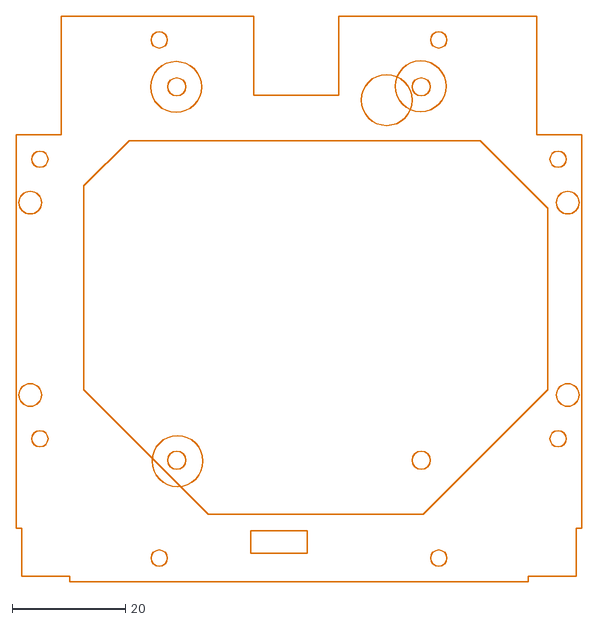
[picture p34: CAD file, 2019-07-06]
teams/comm2/flight/spacer_f1/spacer_f1.dxf
100.0 x 100.0
