UWCubeSat/DubSat1/teams/power/Battery Board/Documents/Battery Holders/Battery Holder Other Side.STEP

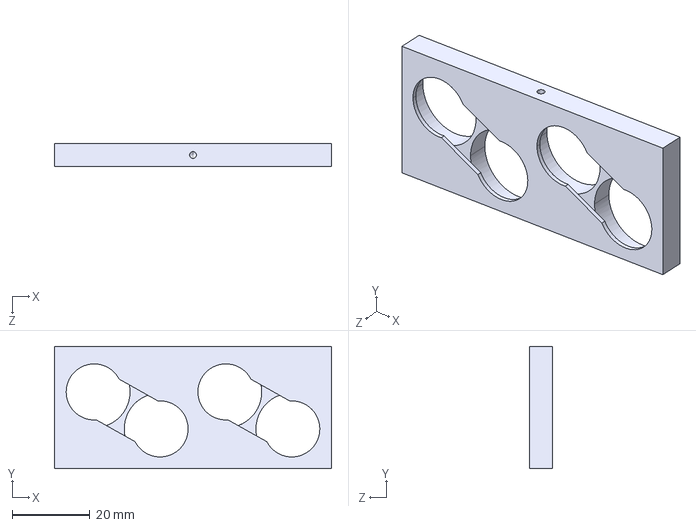
[picture p35: CAD file, 2017-10-12]
teams/power/Battery Board/Documents/Battery Holders/Battery Holder Other Side.STEP
71.1 x 31.4 x 6.00 mm
