UWCubeSat/DubSat1/teams/power/Solar Panels/documents/Solar Panel Plate.STEP

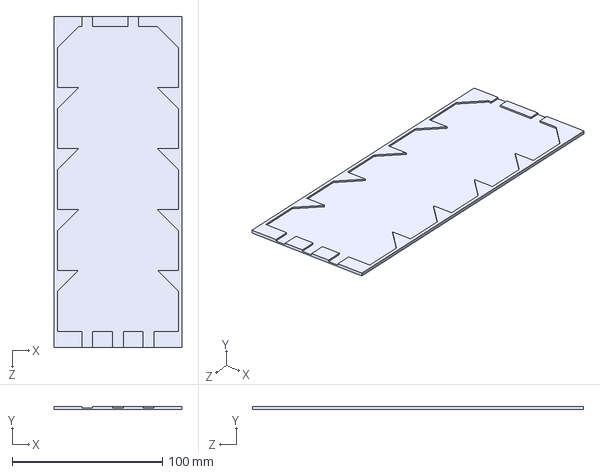
[picture p36: CAD file, 2017-10-26]
teams/power/Solar Panels/documents/Solar Panel Plate.STEP
85.0 x 2.00 x 220.0 mm
