UWCubeSat/DubSat1/teams/propulsion/charge_board_v5-3/propulsion_Structure_ChargeSection_V1.0.DXF

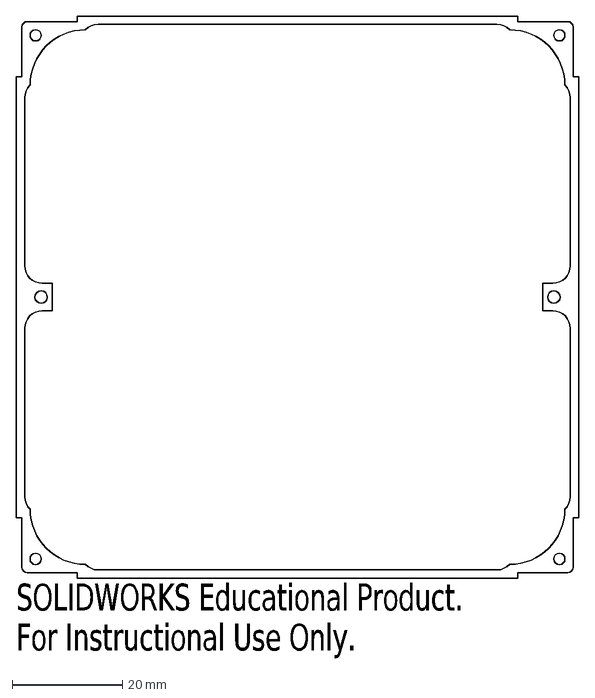
[picture p37: CAD file, 2019-07-06]
teams/propulsion/charge_board_v5-3/propulsion_Structure_ChargeSection_V1.0.DXF
SOLIDWORKS Educational Product.
For Instructional Use Only.
