UWCubeSat/DubSat1/teams/adcs/hardware/actuators/reaction_wheels/RW03 - Reaction Wheel Bracket Footprint.DXF

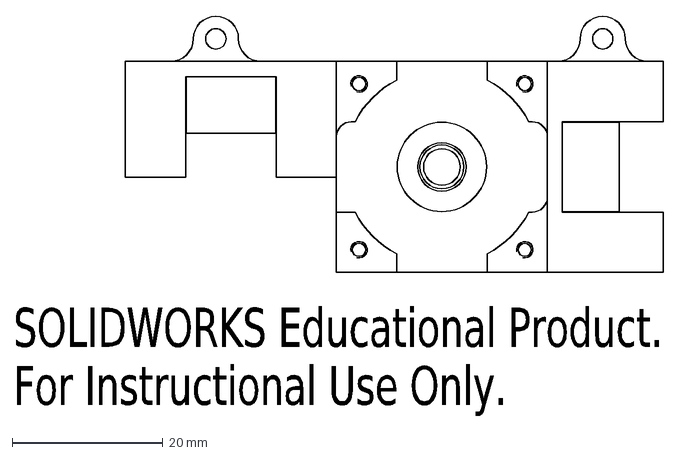
[picture p38: CAD file, 2018-04-01]
teams/adcs/hardware/actuators/reaction_wheels/RW03 - Reaction Wheel Bracket Footprint.DXF
SOLIDWORKS Educational Product.
For Instructional Use Only.
