UWCubeSat/DubSat1/teams/power/Solar Panels/documents/solar_panel_side_v6.DXF

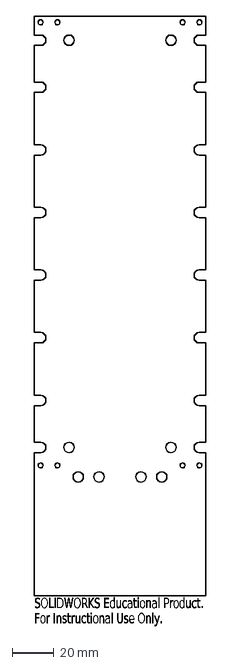
[picture p40: CAD file, 2017-09-08]
teams/power/Solar Panels/documents/solar_panel_side_v6.DXF
SOLIDWORKS Educational Product.
For Instructional Use Only.
