UWCubeSat/DubSat1/teams/propulsion/flight/charger/propulsion_Structure_ControllerSection_V1.1.DXF

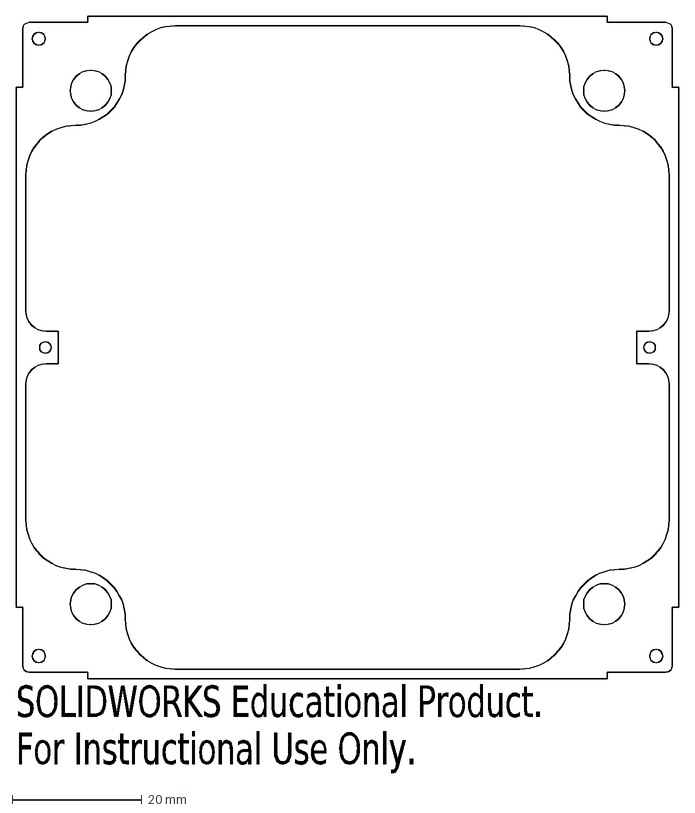
[picture p41: CAD file, 2019-07-06]
teams/propulsion/flight/charger/propulsion_Structure_ControllerSection_V1.1.DXF
SOLIDWORKS Educational Product.
For Instructional Use Only.
