UWCubeSat/DubSat1/teams/power/Battery Board/Battery Holder/Battery Holder Right side.stl

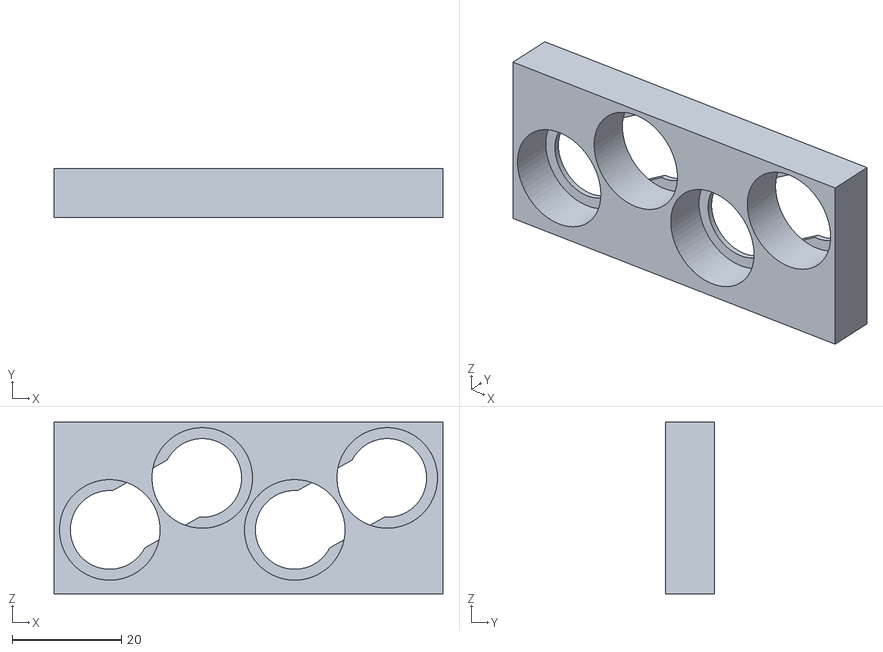
[picture p42: CAD file, 2018-01-11]
teams/power/Battery Board/Battery Holder/Battery Holder Right side.stl
71.1 x 9.00 x 31.4
