UWCubeSat/DubSat1/teams/power/Solar Panels/documents/solar_panel_center_v6.DXF

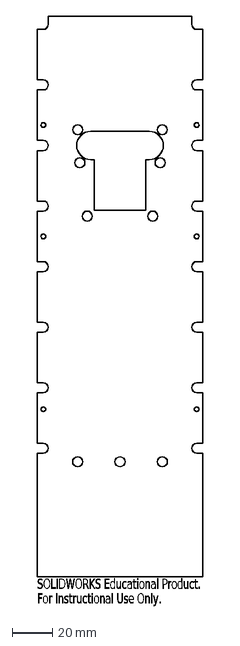
[picture p43: CAD file, 2017-09-08]
teams/power/Solar Panels/documents/solar_panel_center_v6.DXF
SOLIDWORKS Educational Product.
For Instructional Use Only.
