UWCubeSat/DubSat1/teams/comm2/flight/FeedAssembly_v1/antennas_only.dxf

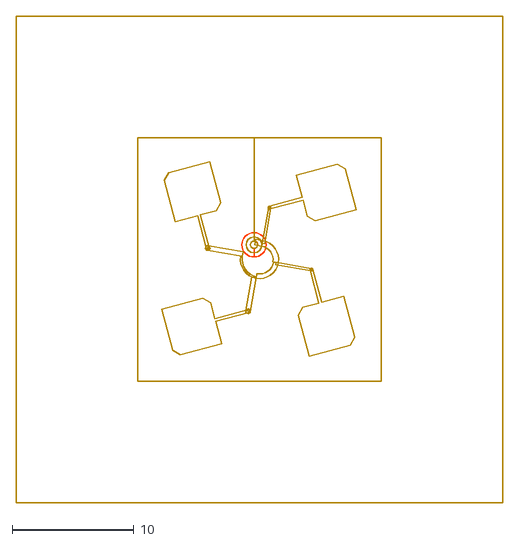
[picture p44: CAD file, 2018-04-18]
teams/comm2/flight/FeedAssembly_v1/antennas_only.dxf
40.0 x 40.0
