UWCubeSat/DubSat1/teams/comm2/flight/FeedAssembly_v1/circles.dxf

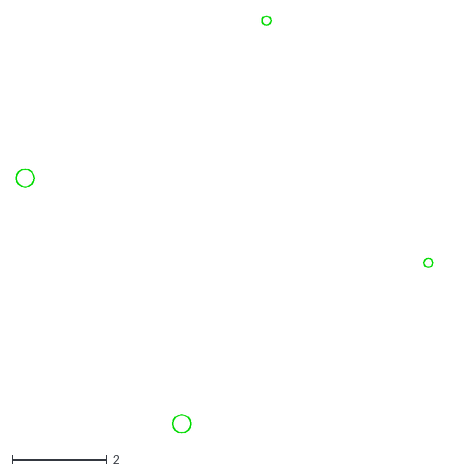
[picture p45: CAD file, 2018-04-18]
teams/comm2/flight/FeedAssembly_v1/circles.dxf
8.80 x 8.80
