UWCubeSat/DubSat1/(list of files, cad)

Other CAD files:
teams/cdh/BusExperiments/aardvark_thunk_pcwin64.obj
teams/cdh/BusExperiments/ADCS_Bdot_Experiment/aardvark_thunk_pcwin64.obj
teams/power/Battery Board/Documents/Battery Holders/Battery Holder.STEP
teams/comm2/flight/FeedAssembly_v1/FeedAssembly_v1.dxf
teams/comm2/flight/FeedAssembly_v1/FeedAssembly_v1.iges
teams/power/Battery Board/Battery Board V4/Documentation/BATTERY_PACK.f3d
teams/power/Battery Board/Battery Board V4/Documentation/Batery Pack v3 v7 v1.step
teams/power/Battery Board/Battery Board V4/Documentation/Fusion Batery Pack v3 v5.step
teams/power/Battery Board/Battery Board V5/Battery Board V5.dxf
teams/power/Battery Board/Battery Holder/92398A112_TWIST-RESISTANT PRESS-FIT INSERT FOR PLASTICS.STEP
teams/power/Battery Board/Documents/Battery Holders/Battery Holder Other Side.DXF
teams/power/Battery Board/Documents/Battery Holders/Battery Holder.DXF
teams/power/Solar Panels/Center Panel V1/Fusion360 exports/Center panel V1.2.brd v4.iges
teams/power/Solar Panels/Center Panel V1/Fusion360 exports/Center panel V1.2.brd v4.step
teams/power/Solar Panels/Center Panel V1/Fusion360 exports/Center panel V1.3.brd v1.step
teams/power/Solar Panels/Center Panel V1/Fusion360 exports/side panel V5.1.brd v2.step
teams/power/Solar Panels/Center Panel V1/dxf's/Center panel V1.2.dxf
teams/power/Solar Panels/Center Panel V1/dxf's/Center panel V1.2_2.dxf
teams/power/Solar Panels/Center Panel V1/dxf's/Center panel V1.2_3.dxf
teams/power/Solar Panels/Center Panel V1/dxf's/Center panel V1.2_4.dxf
teams/power/Solar Panels/Center Panel V1/dxf's/over-under sun sensor panel mount footprint.dxf
teams/power/Solar Panels/Center Panel V1/dxf's/side-by-side sun sensor panel mount footprint.dxf
teams/power/Solar Panels/Center Panel V1/dxf's/solar_panel_center_PCB.DXF
teams/power/Solar Panels/Side Panel V5/DXFs/side panel V5.dxf
teams/power/Solar Panels/Side Panel V5/DXFs/solar_panel_side_PCB.DXF
teams/power/Solar Panels/Side Panel V5/DXFs/structure_panel_(x).DXF
teams/power/Solar Panels/Side Panel V5/Fusion360 exports/side panel V5.1 v1.step
