UWCubeSat/DubSat1/teams/comm2/flight/FeedAssembly_v1/readme.txt

both the built in DXF importer and the ULP attached was used.

all linear pieces ported properly but all curved sections needed to be redrawn in eagle
