UWCubeSat/DubSat1/teams/power/Battery Board/Temp sensor & Heater assembly/README.md

This folder is for documents related to the the heaters including the switch and the temperature sensor setup.
