UWCubeSat/DubSat1/ref/canGettingStarted.md

# MCP25625 Getting Started

The MCP25625 has more features than this, but this is a quick and dirty guide to
getting started. **This guide does not guarentee the most efficient
implementation,** but is a reliable way to start.

Full documetnation can be found
[here](http://ww1.microchip.com/downloads/en/DeviceDoc/20005282B.pdf)

## Intro

MCP25625 CAN interfaces via 4-wire SPI.

Most of the interaction with the MCP will be in the form of a command, usually
followed a register address, possibly followed by 1 or 2 more arguments for a
value. If that command was to read something, sending an extra bit (we use 0x00)
will the MCP25625 to respond over the MISO/SDO SPI Line during that extra bit
transmission. 

The chip has 3 modes. When powering on or resetting the MCP, it goes into
configuration mode. It will only send and recieve packets after it is set
to normal mode after you've finished your configuration routine.

The chip has 3 send buffers. You can send any one of the 3 buffers. They
are mainly there for your convenience, as far as we know.

The chip has 2 receive buffers. Unlike the Tx buffers, these serve a more
important purpose. Along with each Rx buffer, there are filters associated
with it, which will reduce the number of interrupts you get for messages
you don't actually care about.

The filters work on extended IDs or standard IDs + the first 2 bits of the
message. We use extended ID filtering for HuskySat-1. Each buffer has its own
bit mask, Rx0 has 2 filters for its mask, and Rx1 has 4 filters for its mask.
The acceptance condition is as follows: For every bit in the mask that is a 1,
the corresponding filter bit must match the id bit for a message to be accepted.

The filters on Rx0 have a higher priority than the filters on Rx1.

If the filters are confusing, there is a more detailed description in the
full documentation, linked at the top. If you would like a tutorial for that,
let us know.

## Table of Commands

| Command | Byte | Description |
| --- | ----:|:---:|
| RESET | 0xC0 | Reset all registers, put into config mode |
| READ | 0x03 | Read a byte from a register |
| WRITE | 0x02 | Set a register to a value |
| RTS | 0x8? | Request to Send a message in the Tx Buffer (1)  |
| READ_STATUS | 0xA0 | Quick command to poll several status bits |
| READ_RX_BUFFER | 0x9? | Quick read Rx buffer (3) |
| BIT_MODIFY | 0x05 | Use a bit mask to set bits in a register |
| LOAD_TX_BUFFER | 0x4? | Shorthand for sending several bits to Tx Buf (2)|

(1) ?=0x4 to send Tx Buffer 2, ?=0x2 to send TxB 1, ?=0x1 to send TxB 0

(2) ?=0x0 for Tx Buffer 0 ID, ?=0x1 for TxB 0 Data, ?=0x2 for TxB 1 ID, ?=0x3
for TxB 1 Data, ?=0x4 for TxB 2 ID, ?=0x5 for TxB 2 Data.

(3) ?=0x2 for Rx0 Buffer 0 data, ?=0x6 for Rx1B Data.

## Table of Registers/Macros

This does not include all Registers, just the ones that are
necessary to get started.

| Register/Macro | Byte | Description |
| --- | ----:|:---:|
| CNF1 | 0xC0 | Configuration 1 Regsiter |
| CNF2 | 0x03 | Configuration 2 Regsiter |
| CNF3 | 0x02 | Configuration 3 Regsiter |
| CANINTE | 0x2B | CAN Interrupt Enable Register |
| CANINTF | 0x2C | CAN Interrupt Flag Register |
| RXB0CTRL | 0x60 | Rx Buffer 0 Control Register |
| RXB1CTRL | 0x70 | Rx Buffer 1 Control Register |
| CANCTRL | 0x0F | CAN Control Register |
| RXB0DLC | 0x65 | Rx Buffer 0 Data Length Register |
| RXB0SIDH | 0x61 | Rx Buffer 0 ID register (1st of 4) |
| RXB1DLC | 0x75 | Rx Buffer 1 Data Length Register |
| RXB1SIDH | 0x71 | Rx Buffer 0 ID register (1st of 4) |
| RX_BYTE | 0x00 | Macro meaning Tx any byte to receive one over SPI |

## Sequences
Here is a sequence of bits to transmit and receive over SPI we use to
initialize, Tx and Rx packets with our MCP:

### CAN Initialization

Here are the steps to follow to initialize the CAN bus. A full example
showing the initialization is at the bottom.

1. Reset
2. Set Configuration Bits
3. Enable the Rx Interrupt
4. Acceptance Filter Settings
5. Set operating mode to normal

#### 1. RESET

Commands:

```RESET```

Bits:

```0x07```

Description:

First, you need to send the RESET instruction, as you may have power-cycled,
but the MCP may not have, so you should do this to make sure you and the MCP
agree on your state.

#### 2. Set the configuration bits

Commands:

```SET CNF1 0x83 SET CNF2 0xBF SET CNF3 0x02```

Bits:

```0x02 0x2A 0x83 0x02 0x29 0xBF 0x02 0x28 0x02```

Description:

This sets registers CNF1 CNF2 and CNF3 to their correct values. This tells
the MCP25625 the speed of the bus (125kbps), the SJW (3), and some other
things. This is what we are using for HuskySat-1.

#### 3. Enable the Rx Interrupt

Commands:

```BIT_MODIFY CANINTE 0x03 0x03```

Bits:

```0x05 0x2B 0x03 0x03```

Description:

This enables the interrupts for the RX0Buffer and RX1Buffer. This will
mean the INT pin will go low when a new message has been received in either
buffer. 

#### 4. Acceptance Filter Settings

Commands:

```BIT_MODIFY RXB0CTRL 0x60 0x00 BIT_MODIFY RXB1CTRL 0x60 0x00```

Bits:

```0x05 0x60 0x60 0x00 0x05 0x70 0x60 0x00```

Description:

This sets the acceptance filters to filter only on extended IDs. This is
what we are using for Huskysat-1.

#### 5. Set Operating mode to Normal

Commands:

```BIT_MODIFY CANCTRL 0xE0 0x00```

Bits:

```0x05 0x0F 0xE0 0x00```

Description:

This will set the MCP25625 to normal mode. The chip will now start looking
for packets on the bus, as well as be able to send them.

#### Full Example:

Commands:

```
RESET

SET CNF1 0x83
SET CNF2 0xBF
SET CNF3 0x02

BIT_MODIFY CANINTE 0x03 0x03

BIT_MODIFY RXB0CTRL 0x60 0x00
BIT_MODIFY RXB1CTRL 0x60 0x00

BIT_MODIFY CANCTRL 0xE0 0x00
```

Bits:

```
0x07

0x02 0x2A 0x83
0x02 0x29 0xBF
0x02 0x28 0x02

0x05 0x2B 0x03 0x03

0x05 0x60 0x60 0x00
0x05 0x70 0x60 0x00

0x05 0x0F 0xE0 0x00
```

Description:

This fully initializes the MCP25625 so that it is ready to send and receive
messages at 125kbps, SJW 3

### CAN Sending

Unfortunately, the ID register bits don't really align with any normal byte
alignment. Don't worry, though as we've already solved this problem and will
provide example code to translate an extedned ID encoded as a uint32_t
into the correct bytes to load to the MCP25625.

We will be sending a packet of length 8 with ID 0x1BADASSS and
Data 0x0123456789ABCDEF.

A full example showing the initialization is at the bottom.

1. Convert ID to align with Registers
2. Load ID and len into TX Buffer
3. Load Data into TX Buffer
4. RTS (Request to Send)

#### 1. Convert ID to align with Registers

Code:

```c
uint32_t id = 0x1BAD555;
uint8_t NEWID_0 = (uint8_t) (id >> 21); // 0xDD
uint8_t NEWID_1 = (uint8_t) (id >> 16) & 0x03 | (uint8_t) (id >> 13) & 0xE0 | 0x08; // 0x69
uint8_t NEWID_2 = (uint8_t) (id >> 8); // 0xA5
uint8_t NEWID_3 = (uint8_t) id; // 0x55
```

Description:

We need to load the ID into the proper register, but it the registers are
not all byte aligned so we need to do some translation. the results are in
NEWID_0, NEWID_1, NEWID_2, and NEWID_3

NEWID_1 has a bitwise OR with 0x08. This enables sending the extended ID
as opposed to a Standard ID.

(Im using inttypes.h for fix width integers if it wasn't clear.)

#### 2. Load ID and len into TX Buffer

Commands:

```LOAD_TX_BUFFER NEWID_0 NEWID_1 NEWID_2 NEWID_3 0x08```

Bits:

```0x40 0xDD 0x69 0xA5 0x55 0x08```

Description:

For this example, we'll just TXB0, Therefore LOAD_TX_BUFFER will be 0x40 for
the ID.

The last bit in this step is the length of our payload. 8 in this case.

#### 3. Load Data into TX Buffer

Commands:

```LOAD_TX_BUFFER 0x01 0x23 0x45 0x67 0x89 0xAB 0xCD 0xEF```

Bits:

```0x41 0x01 0x23 0x45 0x67 0x89 0xAB 0xCD 0xEF```

Description:

For this example, we'll just TXB0, Therefore LOAD_TX_BUFFER will be 0x41 for
the data.

We are using data payload 0x0123456789ABCDEF, you can replace this with your
actual payload. It shouldn't be hard to figure out how to do that.

If the data length is less than 8, just send any garbage bits as the last bits
of this message.

#### 4. RTS (Request to Send)

Commands:

```RTS```

Bits:

```0x81```

Description:

Now all that's left is request to send the buffer. This instruction does that.
Since we're transmitting out of Tx Buffer 0, we are using 0x81.

#### Full Example:

Commands:

```
LOAD_TX_BUFFER NEWID_0 NEWID_1 NEWID_2 NEWID_3 0x08

LOAD_TX_BUFFER 0x01 0x23 0x45 0x67 0x89 0xAB 0xCD 0xEF

RTS
```

Bits:

```
0x40 0xDD 0x69 0xA5 0x55 0x08

0x41 0x01 0x23 0x45 0x67 0x89 0xAB 0xCD 0xEF

0x81
```

Description:

This example sends a message of length 8 with ID 0x1BADASSS and
Data 0x0123456789ABCDEF out of TX Buffer 0.

NEWID_0 ... NEWID_3 are defined in step 1.

### CAN Receiving

When receiving a packet, it has either been received in RxB0 or RxB1. We have
to check and act appropriately. **It is important read the packet and clear
the interrupt as fast as possible to avoid any possibility of a lost message.**
As with transmitting, the ID register bits don't really align with any normal
byte alignment. We also did the opposite conversion, from the ID bits to a
uint32_t, so code for that is below.

In this example, we will be receiving a packet of length 6 with an extended ID
that was recevied in Rx Buffer 0.

For the purposes of this tutorial, we will always assume we are going to
read an extended ID, because we always use extended IDs in space.

A full example showing the initialization is at the bottom.

1. Determine which buffer received the message
2. Get the message length
3. Get the message data
4. Get and decode the message ID
5. Clear Rx Interrupt flag

#### 1. Determine which buffer received the message

Commands:

```READ_STATUS RX_BYTE```

Bits:

```0xA0 0x00```

Code Snippet:

```c
uint8_t status;
readStatus(&status);

if(status & 0x01){
  // Message was received in Rx Buffer 0
}
if(status & 0x02){
  // Message was received in Rx Buffer 1
}
```

Description:

As you transmit RX_BYTE, you will receive the state of the status register over
the SPI MISO/SDO line. For this example, we'll pretend that the message
was received in buffer 0.

#### 2. Get the message length

Commands:

```READ RXB0DLC RX_BYTE```

Bits:

```0x03 0x65 0x00```

Description:

As you transmit RX_BYTE, you will receive the length of the message in RxB0
over the SPI MISO/SDO line. Use RXB1DLC if you got the message in RxB1.

#### 3. Get the message data

Commands:

```READ_RX_BUFFER RX_BYTE RX_BYTE RX_BYTE RX_BYTE RX_BYTE RX_BYTE RX_BYTE RX_BYTE```

Bits:

```0x92 0x00 0x00 0x00 0x00 0x00 0x00 0x00 0x00```

Description:

As you transmit the RX_BYTEs, you will receive the data payload of the message
over the SPI MISO/SDO line.

READ_RX_BUFFER=0x92 for Rx0 Buffer 0 ID, READ_RX_BUFFER=0x96 for Rx1B.

If the message is shorter than 8 bytes, that's fine, just read the remaining
bits and throw them out later. It's pretty easy that way.

#### 4. Get and decode the message ID

Commands:

```READ RXB0SIDH RX_BYTE READ RXB0SIDH+1 RX_BYTE READ RXB0SIDH+2 RX_BYTE READ RXB0SIDH+3 RX_BYTE```

Bits:

```0x03 0x61 0x00 0x03 0x62 0x00 0x03 0x63 0x00 0x03 0x64 0x00```

Code Snippet:

```c
uint32_t decoded_id = 0;
uint8_t bit_0, bit_1, bit_2, bit_3;

readRegister(MCP_RXB1SIDH, &bit_0);
readRegister(MCP_RXB1SIDH + 1, &bit_1);
readRegister(MCP_RXB1SIDH + 2, &bit_2);
readRegister(MCP_RXB1SIDH + 3, &bit_3);

decoded_id |= (uint32_t) bit_0 << 21;
decoded_id |= (uint32_t) (bit_1 & 0xE0) << 13;
decoded_id |= (uint32_t) (bit_1 & 0x03) << 16;
decoded_id |= (uint32_t) bit_2 << 8;
decoded_id |= bit_3;
```

Description:

As you transmit the RX_BYTEs, you will receive the four bytes of data
corresponding to the registers that hold the extended ID.

The code snippet shows how one would go about decoding them into a normal
uint32_t.

#### 5. Clear Rx Interrupt Flag

Commands:

```BIT_MODIFY CANINTF 0x02 0x00```

Bits:

```0x05 0x2C 0x02 0x00```

Description:

This clears the interrupt pin, and allows you to receive more messages in
the buffer.

#### Full Example:

Commands:

```
READ_STATUS RX_BYTE

READ RXB0DLC RX_BYTE

READ_RX_BUFFER RX_BYTE RX_BYTE RX_BYTE RX_BYTE RX_BYTE RX_BYTE RX_BYTE RX_BYTE

READ RXB0SIDH RX_BYTE
READ RXB0SIDH+1 RX_BYTE
READ RXB0SIDH+2 RX_BYTE
READ RXB0SIDH+3 RX_BYTE

BIT_MODIFY CANINTF 0x02 0x00
```

Bits:

```
0xA0 0x00

0x03 0x65 0x00

0x92 0x00 0x00 0x00 0x00 0x00 0x00 0x00 0x00

0x03 0x61 0x00
0x03 0x62 0x00
0x03 0x63 0x00
0x03 0x64 0x00
0x05 0x2C 0x02 0x00
```

Description:

This example receives a message with an extended ID of any length.

## Contact

Good luck! If you need any help or find a problem with these
docs, you can contact me directly at emoryeng@gmail.com
