UWCubeSat/DubSat1/teams/power/Documentation/Operations Manual/README.md

This folder is for a operations manual for flight opperations.
