UWCubeSat/DubSat1/grnd/COSMOS/Test/README.txt

This folder will hold COSMOS targets used in the ground segment.
