UWCubeSat/DubSat1/teams/cdh/VISAExperiments/instrument_hub/README.md

Instrument Bridge
=================

This tool collects instrumentation data and exposes it on a network socket.

`pip install instrument_hub`
