UWCubeSat/DubSat1/teams/adcs/tests/imu/postvibe1/README.txt

Board: A
Date completed: 3/17/18

Test:  26 Hz (High Perf)
Samples taken: 93600
Elapsed time: 4399.6359 s
Avg. sample rate: 21.2745 Hz
ARW X/Y/Z = 0.0038513/0.0054813/0.0034981
Bias instability X = 0.0012629 dps (4.5464 dph)
Bias instability Y = 0.0030615 dps (11.0215 dph)
Bias instability Z = 0.0002951 dps (1.0624 dph)
