UWCubeSat/DubSat1/teams/adcs/tests/imu/postvibe2/README.txt

Board: A
Date completed: 3/17/18

Test:  26 Hz (High Perf)
Samples taken: 93600
Elapsed time: 4390.072 s
Avg. sample rate: 21.3208 Hz
ARW X/Y/Z = 0.0039048/0.0054851/0.0035833
Bias instability X = 0.0012986 dps (4.6748 dph)
Bias instability Y = 0.0033099 dps (11.9157 dph)
Bias instability Z = 0.00030987 dps (1.1155 dph)
