UWCubeSat/DubSat1/teams/adcs/tests/imu/postvibe3/README.txt

Board: A
Date completed: 3/17/18

Test:  26 Hz (High Perf)
Samples taken: 93600
Elapsed time: 4389.1302 s
Avg. sample rate: 21.3254 Hz
ARW X/Y/Z = 0.0038095/0.0054552/0.0035616
Bias instability X = 0.00080474 dps (2.8971 dph)
Bias instability Y = 0.00201 dps (7.2361 dph)
Bias instability Z = 0.00023367 dps (0.84122 dph)
