UWCubeSat/DubSat1/teams/adcs/tests/imu/previbeB_2_14_18__1/README.txt

board: B
duration: 1 hour
date: 2/14/18, 11:20 AM
notes:
