UWCubeSat/DubSat1/teams/adcs/tests/imu/previbeB_2_14_18__2/README.txt

board: B
duration: 1 hour
date: 2/14/18, 12:39 PM
notes: the raw results show a bump ~1400 seconds in. The bias instability is noticeably higher than in the first test, especially in the Y axis.
