UWCubeSat/DubSat1/grnd/experiments/ArdMOS/cosmos/config/tools/tlm_grapher/BlinkyWatch.txt

SECONDS_PLOTTED 71.74
POINTS_SAVED 1000000
POINTS_PLOTTED 1000
REFRESH_RATE_HZ 10.0
CTS_TIMEOUT 10.0

TAB "Tab 1"
  PLOT LINEGRAPH
    X_AXIS_TITLE "Time (Seconds)"
    SHOW_ABS_X_GRID_LABELS TRUE
    SHOW_X_GRID_LINES FALSE
    SHOW_Y_GRID_LINES TRUE
    POINT_SIZE 5
    SHOW_LINES TRUE
    SHOW_LEGEND TRUE
    UNIX_EPOCH_X_VALUES TRUE
    DATA_OBJECT HOUSEKEEPING
      Y_AXIS LEFT
      ITEM BLINK SOH DELAY
      TIME_ITEM RECEIVED_TIMESECONDS
      VALUE_TYPE CONVERTED
      ANALYSIS NONE
      ANALYSIS_SAMPLES 3
      SHOW_LIMITS_LINES FALSE
    DATA_OBJECT HOUSEKEEPING
      Y_AXIS LEFT
      ITEM BLINK SOH CMDACCEPT
      TIME_ITEM RECEIVED_TIMESECONDS
      VALUE_TYPE CONVERTED
      ANALYSIS NONE
      ANALYSIS_SAMPLES 3
      SHOW_LIMITS_LINES FALSE
    DATA_OBJECT HOUSEKEEPING
      Y_AXIS LEFT
      ITEM BLINK SOH CMDRCVD
      TIME_ITEM RECEIVED_TIMESECONDS
      VALUE_TYPE CONVERTED
      ANALYSIS NONE
      ANALYSIS_SAMPLES 3
      SHOW_LIMITS_LINES FALSE

TAB "Tab 2"
  PLOT LINEGRAPH
    X_AXIS_TITLE "Time (Seconds)"
    SHOW_ABS_X_GRID_LABELS TRUE
    SHOW_X_GRID_LINES FALSE
    SHOW_Y_GRID_LINES TRUE
    POINT_SIZE 5
    SHOW_LINES TRUE
    SHOW_LEGEND TRUE
    UNIX_EPOCH_X_VALUES TRUE
