UWCubeSat/DubSat1/grnd/experiments/ArdMOS/cosmos/config/targets/RWS/screens/test.txt

SCREEN AUTO AUTO 1.0

TITLE "Reaction Wheel"

  VERTICALBOX
    LABELVALUE RWS PIDMOT RECEIVED_TIMEFORMATTED WITH_UNITS 25 # COSMOS Received Time (Local time zone, Formatted string)
    LABELVALUE RWS PIDMOT TIMECHANGE WITH_UNITS 25 # Time change covered by this telemetry entry.
    LABELVALUE RWS PIDMOT DERR WITH_UNITS 25 # Value of derivative term.
    LABELVALUE RWS PIDMOT OUTPUT WITH_UNITS 25 # Value of generated output from PID loop.
    LABELVALUELIMITSBAR RWS PIDMOT ERRSUM WITH_UNITS 25 # Total value of integral term.

    HORIZONTALLINE      
    
    LABELVALUELIMITSBAR RWS PIDMOT SETPOINT WITH_UNITS 25 # Current setpoint of PID controller.
    LABELVALUELIMITSBAR RWS PIDMOT INPUT WITH_UNITS 25 # Current input value.
    
    HORIZONTALLINE
    
    LABELVALUE RWS PIDMOT ERROR WITH_UNITS 25 # Current measured error value.
    TRENDBAR RWS PIDMOT ERROR RAW 30 400 50

  END
