UWCubeSat/DubSat1/grnd/experiments/ArdMOS/cosmos/outputs/handbooks/blink_cmd_tlm.pdf

Document No.: XXXXXXX
Revision: TBD
Date: TBD

Copies are Uncontrolled

# BLINK Command and Telemetry Handbook

### For the COSMOS Demo Project

2
3
3
3
3

## Table of Contents

### Table of Contents Commands

BLINK DELAY

### Telemetry Packets

BLINK SOH

Document No.: XXXXXXX
Revision: TBD
Date: TBD

Copies are Uncontrolled

# Commands

## BLINK DELAY

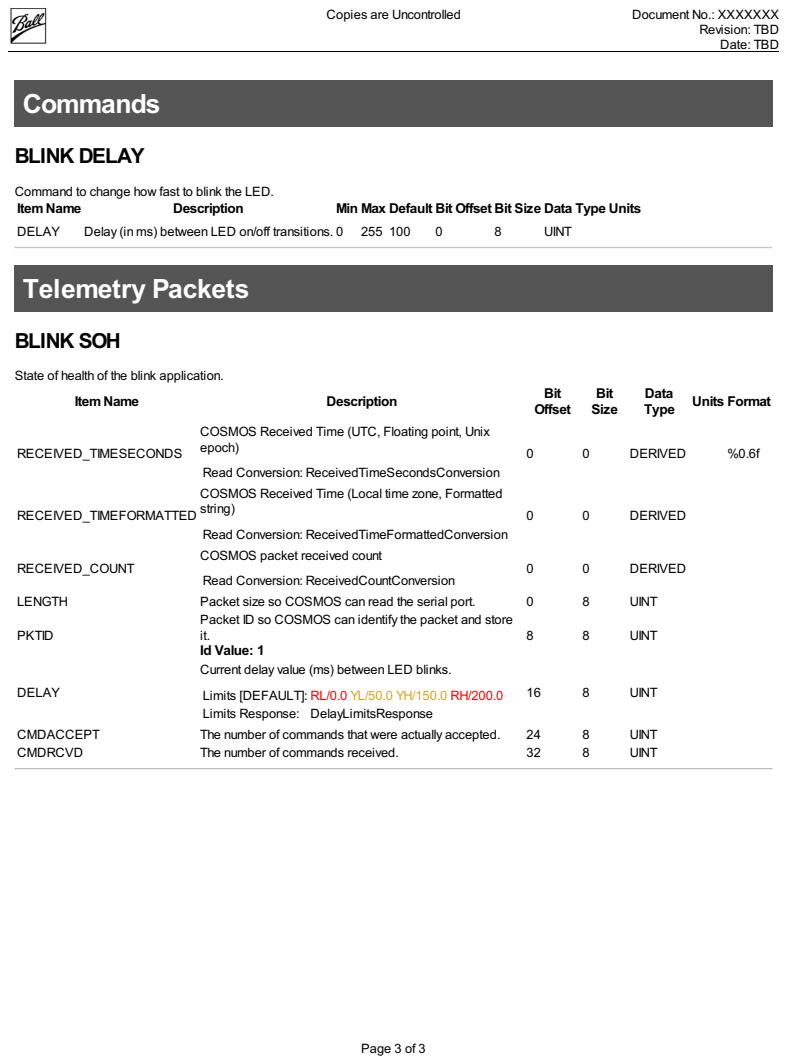
[picture p52: page 3]
ItemName; Description; Min Max Default Bit Offset Bit Size Data Type Units; DELAY; Delay (in ms) between LED on/off transitions. 0; UINT; Telemetry Packets; BLINK SOH; Bit Offset; Bit Size; Data Type; Units Format; RECEIVED_TIMESECONDS; DERIVED; RECEIVED_TIMEFORMATTED; RECEIVED_COUNT; LENGTH; Packet size so COSMOS can read the serial port.; PKTID; CMDACCEPT; The number of commands that were actually accepted.; CMDRCVD; The number of commands received.; Revision: TBD Date: TBD

Copies are Uncontrolled

Document No.: XXXXXXX

Command to change how fast to blink the LED.

State of health of the blink application.

COSMOS Received Time (UTC, Floating point, Unix
epoch)

Read Conversion: ReceivedTimeSecondsConversion
COSMOS Received Time (Local time zone, Formatted
string)

Read Conversion: ReceivedTimeFormattedConversion
COSMOS packet received count

Read Conversion: ReceivedCountConversion

Packet ID so COSMOS can identify the packet and store
Id Value: 1
Current delay value (ms) between LED blinks.

Limits [DEFAULT]: RL/0.0 YL/50.0 YH/150.0 RH/200.0
Limits Response: DelayLimitsResponse
