UWCubeSat/DubSat1/teams/cdh/BusExperiments/IMUComparison.xlsx

ID | IMU Model | Nominal Sample Rate | Info | Samp Rate | ARW-X | ARW-Y | ARW-Z | Avg ARW | Bias Stab-X | Bias Stab-Y | Bias Stab-Z | Avg Bias Stab | Avg BI Rank | Avg ARW Rank
1 | BMI160 | 25 | NormalFilter | 21.63792608 | 0.008891357282 | 0.008047274561 | 0.008109123576 | 0.008349251806 | 5.657696858 | 4.348511711 | 4.087537898 | 4.697915489 | 4 | 3
2 | BMI160 | 50 | NormalFilter | 46.68647411 | 0.01257874427 | 0.01134674851 | 0.01158233935 | 0.01183594405 | 6.999407305 | 0.9664003858 | 4.09408677 | 4.01996482 | 2 | 5
3 | BMI160 | 100 | NormalFilter | 90.77503234 | 0.01772343564 | 0.01624362877 | 0.01634918828 | 0.01677208423 | 2.336382194 | 4.106504364 | 4.100245239 | 3.514377266 | 1 | 6
4 | LSM6DSM | 12.5 | Low Power | 7.978951996 | 0.0291615891 | 0.02466406548 | 0.01990093142 | 0.02457552867 | 12.82844287 | 9.621385213 | 6.537677124 | 9.662501737 | 9 | 8
5 | LSM6DSM | 12.5 | High Perf | 7.971422454 | 0.004191971656 | 0.003249251318 | 0.002990169818 | 0.003477130931 | 9.482858209 | 4.819894605 | 4.777457711 | 6.360070175 | 6 | 1
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
