UWCubeSat/DubSat1/teams/power/Cycle Test/README.md

This folder is for code, data, and analysis of the cycle test.
