UWCubeSat/DubSat1/teams/cdh/BusExperiments/MTQ_hlt/readme.txt

4/28/2018

Hi. This directory was created by Eloise to work on matlab scripts for 
hardware-in-the-loop testing for MTQ.
