UWCubeSat/DubSat1/teams/power/thermal tests/heater test data/Heater test arduino data  3-22-18.txt

Time(s)	Ch2(C)	Ch3(C)	Ch4(C)	Ch6(C)	Ch7(C)	Ch8(C)
0.000	-52.21	22.37	-47.63	24.58	26.45	-40.98	
5.238	-51.54	22.39	-48.05	24.54	26.42	-42.92	
10.474	-51.02	22.39	-48.32	24.52	26.39	-44.34	
15.711	-50.62	22.39	-48.48	24.52	26.36	-45.38	
20.949	-50.29	22.41	-48.59	24.50	26.35	-46.14	
26.186	-50.03	22.41	-48.64	24.54	26.34	-46.65	
31.423	-49.81	22.41	-48.69	24.49	26.31	-47.09	
36.660	-49.63	22.39	-48.71	24.49	26.31	-47.41	
41.898	-49.46	22.40	-48.71	24.53	26.31	-47.63	
47.135	-49.33	22.41	-48.69	24.57	26.31	-47.80	
52.372	-49.21	22.41	-48.68	24.61	26.31	-47.89	
57.609	-49.12	22.41	-48.66	24.64	26.31	-48.01	
62.847	-49.03	22.42	-48.64	24.67	26.31	-48.08	
68.084	-48.96	22.42	-48.62	24.70	26.30	-48.13	
73.321	-48.89	22.42	-48.59	24.72	26.29	-48.16	
78.558	-48.99	22.05	-48.78	24.40	25.99	-48.38	
83.796	-49.10	21.62	-48.89	23.54	25.65	-48.47	
89.033	-49.10	21.61	-48.85	22.94	25.49	-48.45	
94.270	-49.07	21.59	-48.79	22.60	25.37	-48.46	
99.507	-49.02	21.58	-48.75	22.47	25.28	-48.43	
104.745	-48.96	21.53	-48.71	22.42	25.26	-48.44	
109.982	-48.89	21.56	-48.67	22.38	25.25	-48.43	
115.219	-48.83	21.63	-48.62	22.34	25.24	-48.41	
120.456	-48.76	21.65	-48.58	22.31	25.24	-48.40	
125.694	-48.69	21.66	-48.54	22.32	25.25	-48.38	
130.931	-48.64	21.67	-48.50	22.32	25.26	-48.37	
136.168	-48.59	21.67	-48.47	22.36	25.28	-48.36	
141.406	-48.55	21.68	-48.44	22.41	25.29	-48.34	
146.643	-48.51	21.69	-48.41	22.46	25.32	-48.33	
151.881	-48.46	21.69	-48.39	22.53	25.34	-48.26	
157.117	-48.43	21.69	-48.36	22.61	25.36	-48.25	
162.355	-48.43	21.70	-48.37	22.76	25.39	-48.29	
167.592	-48.41	21.70	-48.36	22.92	25.42	-48.29	
172.830	-48.39	21.71	-48.34	23.09	25.46	-48.28	
178.066	-48.38	21.71	-48.33	23.27	25.52	-48.28	
183.304	-48.36	21.71	-48.33	23.44	25.57	-48.28	
188.541	-48.35	21.71	-48.32	23.61	25.64	-48.28	
193.779	-48.34	21.71	-48.31	23.78	25.72	-48.27	
199.015	-48.33	21.72	-48.31	23.94	25.81	-48.26	
204.253	-48.33	21.72	-48.30	24.09	25.89	-48.26	
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
