UWCubeSat/DubSat1/grnd/experiments/ArdMOS/cosmos/outputs/handbooks/command_handbook.pdf

Document No.: XXXXXXX
Revision: TBD
Date: TBD

Copies are Uncontrolled

# Command Handbook

### For the COSMOS Demo Project

2
3
3
3

## Table of Contents

### Table of Contents Commands

BLINK DELAY
SYSTEM META

Document No.: XXXXXXX
Revision: TBD
Date: TBD

Copies are Uncontrolled

# Commands

## BLINK DELAY

Command to change how fast to blink the LED.
ItemName | Description | Min Max Default Bit Offset Bit Size Data Type Units
DELAY | Delay (in ms) between LED on/off transitions. 0 | 255 100 | 0 | 8 | UINT

## SYSTEM META

ItemName | Description | Min Max Default Bit Offset Bit Size Data Type Units
PKTID | Packet Id Id Value: 1
0 | 8 | UINT
CONFIG | Configuration Name | 8 | 256 | STRING
COSMOS_VERSION COSMOS Version | 264 | 240 | STRING
USER_VERSION | User Project Version | 504 | 240 | STRING
RUBY_VERSION | Ruby Version | 744 | 240 | STRING

Document No.: XXXXXXX
Revision: TBD
Date: TBD

Copies are Uncontrolled
