UWCubeSat/DubSat1/grnd/experiments/ArdMOS/cosmos/outputs/handbooks/system_cmd_tlm.pdf

Document No.: XXXXXXX
Revision: TBD
Date: TBD

Copies are Uncontrolled

# SYSTEM Command and Telemetry Handbook

### For the COSMOS Demo Project

2
3
3
3
3

## Table of Contents

### Table of Contents Commands

SYSTEM META

### Telemetry Packets

SYSTEM META

Document No.: XXXXXXX
Revision: TBD
Date: TBD

Copies are Uncontrolled

# Commands

## SYSTEM META

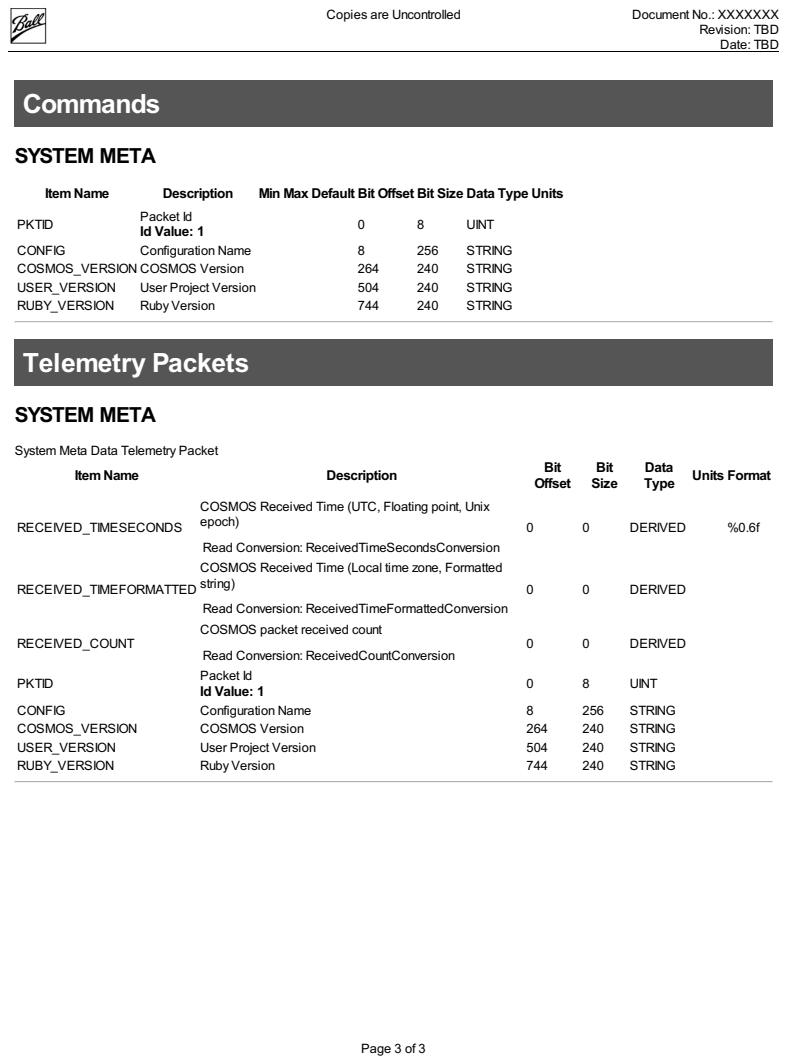
[picture p53: page 3]
ItemName; Description; Min Max Default Bit Offset Bit Size Data Type Units; PKTID; Packet Id Id Value: 1; UINT; CONFIG; Configuration Name; STRING; COSMOS_VERSION COSMOS Version; USER_VERSION; User Project Version; RUBY_VERSION; Ruby Version; Telemetry Packets; SYSTEM META; Bit Offset; Bit Size; Data Type; Units Format; RECEIVED_TIMESECONDS; DERIVED; RECEIVED_TIMEFORMATTED; RECEIVED_COUNT; COSMOS_VERSION; COSMOS Version; Revision: TBD Date: TBD

Copies are Uncontrolled

Document No.: XXXXXXX

System Meta Data Telemetry Packet

COSMOS Received Time (UTC, Floating point, Unix
epoch)

Read Conversion: ReceivedTimeSecondsConversion
COSMOS Received Time (Local time zone, Formatted
string)

Read Conversion: ReceivedTimeFormattedConversion
COSMOS packet received count

Read Conversion: ReceivedCountConversion
Packet Id
Id Value: 1
