UWCubeSat/DubSat1/grnd/experiments/ArdMOS/cosmos/outputs/handbooks/telemetry_handbook.pdf

Document No.: XXXXXXX
Revision: TBD
Date: TBD

Copies are Uncontrolled

# Telemetry Handbook

### For the COSMOS Demo Project

2
3
3
3

## Table of Contents

### Table of Contents Telemetry Packets

BLINK SOH
SYSTEM META

Document No.: XXXXXXX
Revision: TBD
Date: TBD

Copies are Uncontrolled

# Telemetry Packets

## BLINK SOH

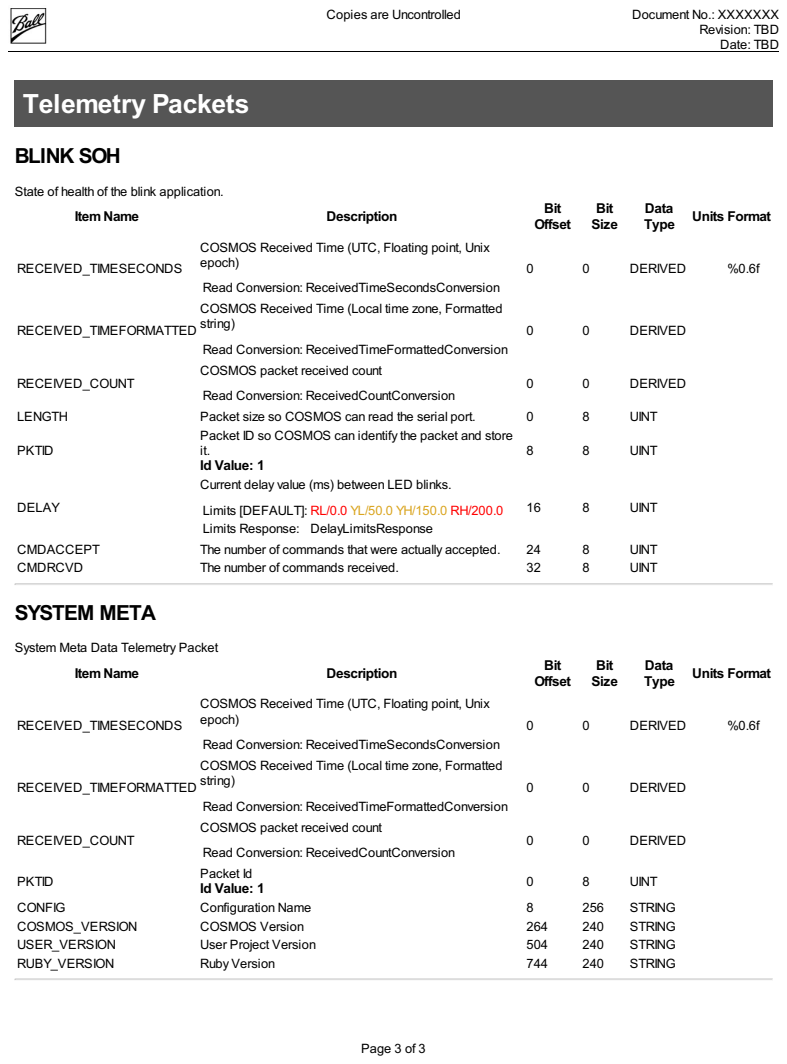
[picture p54: page 3]
ItemName; Description; Bit Offset; Bit Size; Data Type; Units Format; RECEIVED_TIMESECONDS; DERIVED; RECEIVED_TIMEFORMATTED; RECEIVED_COUNT; LENGTH; Packet size so COSMOS can read the serial port.; UINT; PKTID; DELAY; CMDACCEPT; The number of commands that were actually accepted.; CMDRCVD; The number of commands received.; SYSTEM META; CONFIG; Configuration Name; STRING; COSMOS_VERSION; COSMOS Version; USER_VERSION; User Project Version; RUBY_VERSION; Ruby Version; Revision: TBD Date: TBD

Copies are Uncontrolled

Document No.: XXXXXXX

State of health of the blink application.

COSMOS Received Time (UTC, Floating point, Unix
epoch)

Read Conversion: ReceivedTimeSecondsConversion
COSMOS Received Time (Local time zone, Formatted
string)

Read Conversion: ReceivedTimeFormattedConversion
COSMOS packet received count

Read Conversion: ReceivedCountConversion

Packet ID so COSMOS can identify the packet and store
Id Value: 1
Current delay value (ms) between LED blinks.

Limits [DEFAULT]: RL/0.0 YL/50.0 YH/150.0 RH/200.0
Limits Response: DelayLimitsResponse

System Meta Data Telemetry Packet

Packet Id
