UWCubeSat/DubSat1/teams/power/Cycle Test/charge test 7-19-2017.xlsx

VOLTAGE | CHARGE | TIMESTAMPE
6484.19 | 0.93 | 1055.33 | 1615
5717.51 | 0.93 | -18.92 | 1617
5713.91 | 0.93 | -18.92 | 1618
5714.63 | 0.93 | -18.92 | 1619
5716.79 | 0.93 | -18.92 | 1620
5719.67 | 0.93 | -18.92 | 1621
6597.63 | 1.2 | 1055.33 | 1622
6627.88 | 1.55 | 1055.33 | 1623
6640.12 | 1.82 | 1055.33 | 1624
6656.69 | 2.17 | 1055.33 | 1625
6670.37 | 2.44 | 1055.33 | 1626
5847.15 | 2.44 | -18.92 | 1627
5836.35 | 2.44 | -18.92 | 1628
5829.87 | 2.44 | -18.92 | 1629
5826.27 | 2.44 | -18.92 | 1630
5824.47 | 2.44 | -18.92 | 1631
6595.83 | 2.79 | 1055.33 | 1632
6618.16 | 3.06 | 1055.33 | 1633
6631.84 | 3.32 | 1055.33 | 1634
6643 | 3.68 | 1055.33 | 1635
6654.89 | 3.94 | 1055.33 | 1636
5912.69 | 3.94 | -18.92 | 1637
5901.89 | 3.94 | -18.92 | 1638
5895.41 | 3.94 | -18.92 | 1639
5891.45 | 3.94 | -18.92 | 1640
5888.21 | 3.94 | -18.92 | 1641
6643 | 4.3 | 1055.33 | 1642
6662.45 | 4.56 | 1055.33 | 1643
6676.13 | 4.92 | 1055.33 | 1644
6688.02 | 5.18 | 1055.33 | 1645
6697.74 | 5.45 | 1055.33 | 1646
5960.59 | 5.54 | -18.92 | 1647
5949.79 | 5.54 | -18.92 | 1648
5942.94 | 5.54 | -18.92 | 1649
5938.98 | 5.54 | -18.92 | 1650
5935.38 | 5.54 | -18.92 | 1651
6684.42 | 5.8 | 1055.33 | 1652
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
