UWCubeSat/DubSat1/teams/power/Cycle Test/charge test 7-5-2017.xlsx

VOLTAGE | CHARGE | TIMESTAMPE
6240 | 0 | -9.16 | 0
6240 | 0.27 | -9.16 | 1
6240 | 0.62 | -9.16 | 2
6240 | 0.89 | -9.16 | 3
6240 | 1.15 | -9.16 | 4
6240 | 1.42 | -9.16 | 5
6678 | 1.68 | 977.2 | 6
6678 | 1.95 | 977.2 | 7
6678 | 2.3 | 977.2 | 8
6678 | 2.57 | 977.2 | 9
6678 | 2.83 | 977.2 | 10
6678 | 3.1 | 977.2 | 11
6678 | 3.36 | 977.2 | 12
6697 | 3.72 | 986.97 | 13
6697 | 3.98 | 986.97 | 14
6697 | 4.25 | 986.97 | 15
6697 | 4.52 | 986.97 | 16
6697 | 4.78 | 986.97 | 17
6697 | 5.05 | 986.97 | 18
6697 | 5.4 | 986.97 | 19
6712 | 5.67 | 986.97 | 20
6712 | 5.93 | 986.97 | 21
6712 | 6.2 | 986.97 | 22
6712 | 6.46 | 986.97 | 23
6712 | 6.73 | 986.97 | 24
6712 | 7.08 | 986.97 | 25
6724 | 7.35 | 986.97 | 26
6724 | 7.61 | 986.97 | 27
6724 | 7.88 | 986.97 | 28
6724 | 8.15 | 986.97 | 29
6724 | 8.5 | 986.97 | 30
6724 | 8.77 | 986.97 | 31
6724 | 9.03 | 986.97 | 32
6733 | 9.3 | 986.97 | 33
6733 | 9.56 | 986.97 | 34
6733 | 9.83 | 986.97 | 35
6733 | 10.18 | 986.97 | 36
6733 | 10.45 | 986.97 | 37
6733 | 10.71 | 986.97 | 38
6743 | 10.98 | 986.97 | 39
6743 | 11.24 | 986.97 | 40
6743 | 11.51 | 986.97 | 41
6743 | 11.86 | 986.97 | 42
6743 | 12.13 | 986.97 | 43
6743 | 12.4 | 986.97 | 44
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
