UWCubeSat/DubSat1/teams/power/Cycle Test/discharge test 7-19-2017.xlsx

VOLTAGE | CHARGE
6592.23 | 10.41 | -18.92 | 153
6587.91 | 10.41 | -18.92 | 154
6585.75 | 10.41 | -18.92 | 155
6583.94 | 10.41 | -18.92 | 157
6582.14 | 10.41 | -18.92 | 158
6581.06 | 10.41 | -18.92 | 159
6579.98 | 10.41 | -18.92 | 160
6579.26 | 10.41 | -18.92 | 161
6578.54 | 10.41 | -18.92 | 162
6578.18 | 10.41 | -18.92 | 163
6577.82 | 10.41 | -18.92 | 164
6577.1 | 10.41 | -18.92 | 165
4217.28 | -0.8 | -3056.12 | 166
6535.69 | -0.8 | -18.92 | 167
6547.57 | -0.8 | -18.92 | 168
6552.97 | -0.8 | -18.92 | 169
6556.22 | -0.8 | -18.92 | 170
6558.02 | -0.8 | -18.92 | 171
4237.81 | -1.68 | -3065.89 | 172
4233.49 | -2.48 | -3056.12 | 173
4228.45 | -3.36 | -3056.12 | 174
4244.65 | -4.25 | -3065.89 | 175
4343.68 | -5.14 | -3144.02 | 176
6453.22 | -5.14 | -18.92 | 177
6471.95 | -5.14 | -18.92 | 178
6484.91 | -5.14 | -18.92 | 179
6493.56 | -5.14 | -18.92 | 180
6500.76 | -5.14 | -18.92 | 181
4354.85 | -6.02 | -3144.02 | 182
4351.6 | -6.91 | -3144.02 | 183
4341.16 | -7.79 | -3134.25 | 184
4343.32 | -8.68 | -3134.25 | 185
4344.04 | -9.56 | -3144.02 | 186
6424.05 | -9.56 | -18.92 | 187
6443.86 | -9.56 | -18.92 | 188
6456.46 | -9.56 | -18.92 | 189
6466.55 | -9.56 | -18.92 | 190
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
