UWCubeSat/DubSat1/teams/power/Cycle Test/discharge test 7-5-2017.xlsx

VOLTAGE | CHARGE |  | TIMESTAMPE
 |  | -9.16 | 0
 |  | -9.16 | 1
 |  | -9.16 | 2
 |  | -9.16 | 3
 |  | -9.16 | 4
 |  | -9.16 | 5
6313 | -1.77 | -1044.34 | 6
6313 | -2.13 | -1044.34 | 7
6313 | -2.39 | -1044.34 | 8
6313 | -2.66 | -1044.34 | 9
6313 | -3.01 | -1044.34 | 10
6313 | -3.28 | -1044.34 | 11
6291 | -3.54 | -1044.34 | 12
6291 | -3.9 | -1044.34 | 13
6291 | -4.16 | -1044.34 | 14
6291 | -4.43 | -1044.34 | 15
6291 | -4.78 | -1044.34 | 16
6291 | -5.05 | -1044.34 | 17
6291 | -5.31 | -1044.34 | 18
6281 | -5.67 | -1044.34 | 19
6281 | -5.93 | -1044.34 | 20
6281 | -6.2 | -1044.34 | 21
6281 | -6.55 | -1044.34 | 22
6281 | -6.82 | -1044.34 | 23
6281 | -7.08 | -1044.34 | 24
6281 | -7.44 | -1044.34 | 25
6274 | -7.7 | -1044.34 | 26
6274 | -7.97 | -1044.34 | 27
6274 | -8.32 | -1044.34 | 28
6274 | -8.59 | -1044.34 | 29
6274 | -8.85 | -1044.34 | 30
6274 | -9.21 | -1044.34 | 31
6269 | -9.47 | -1044.34 | 32
6269 | -9.74 | -1044.34 | 33
6269 | -10.09 | -1044.34 | 34
6269 | -10.36 | -1044.34 | 35
6269 | -10.63 | -1044.34 | 36
6269 | -10.98 | -1044.34 | 37
6269 | -11.25 | -1044.34 | 38
6266 | -11.51 | -1044.34 | 39
6266 | -11.86 | -1044.34 | 40
6266 | -12.13 | -1044.34 | 41
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
