UWCubeSat/DubSat1/teams/power/Distribution Board/Distribution Board V2/Documentation/Distribution board testing log.docx

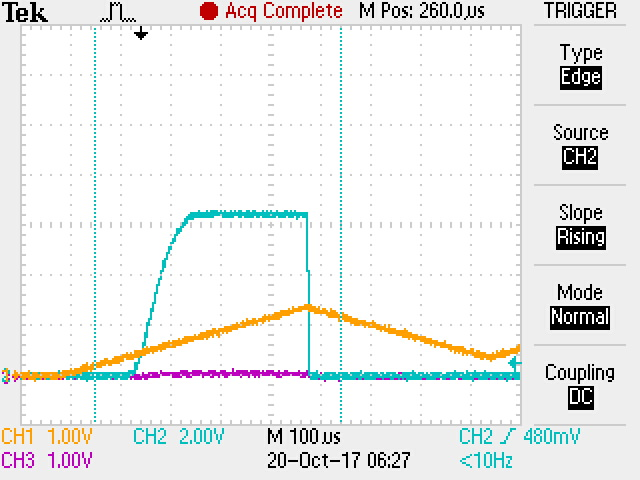
[picture p55: figure]

Figure 1: TPS Switch #5, 12 Ohm load

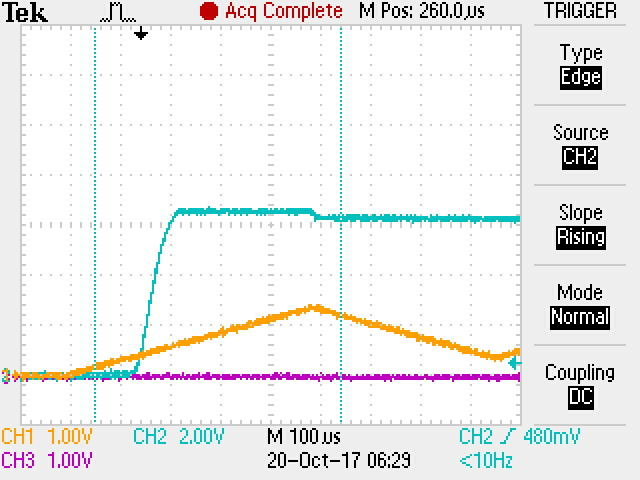
[picture p56: figure]

Figure 2: TPS Switch #5, no load

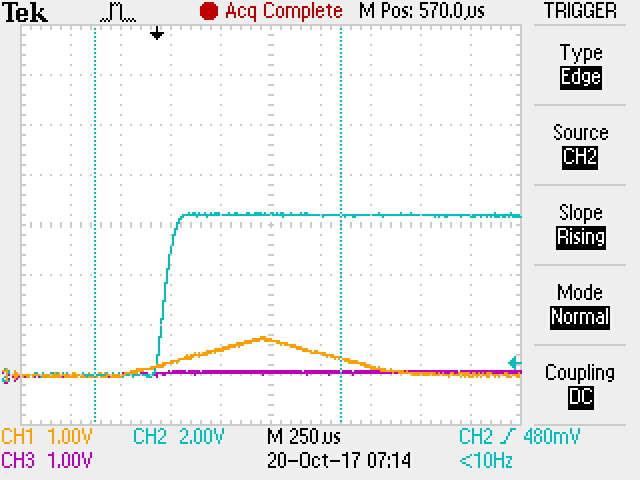
[picture p57: figure]

Figure 3: Switch #4 with 10 nF instead of 3.9 nF C_TIMER. Steady-state IMON = 0.085 V

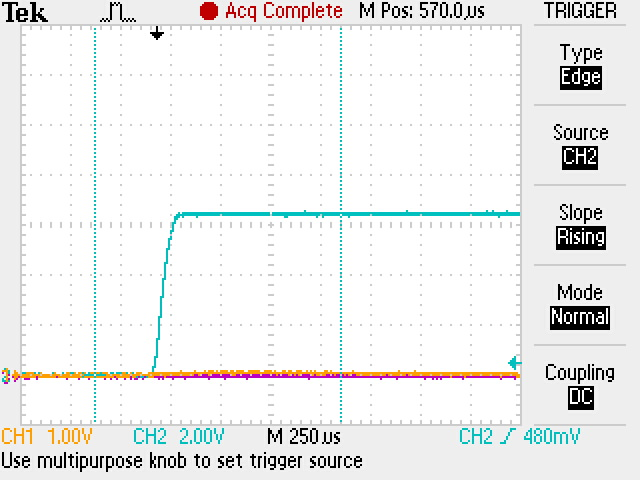
[picture p58: figure]

Figure 4: TPS switch, 12 Ohm load, steady stae IMON = 0.002 V, C_TIMER = 0.1 uF

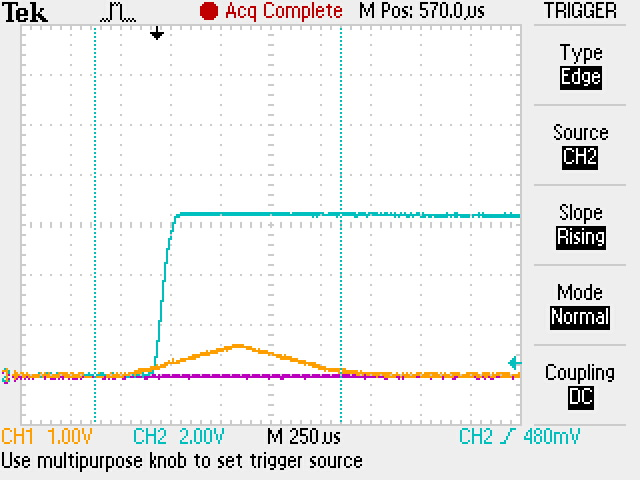
[picture p59: figure]

Figure 5: PPT Switch w/ 10 nF cap on C_TIMER, Load = 12 Ohm
