UWCubeSat/DubSat1/teams/power/Cycle Test/test 1.JPG

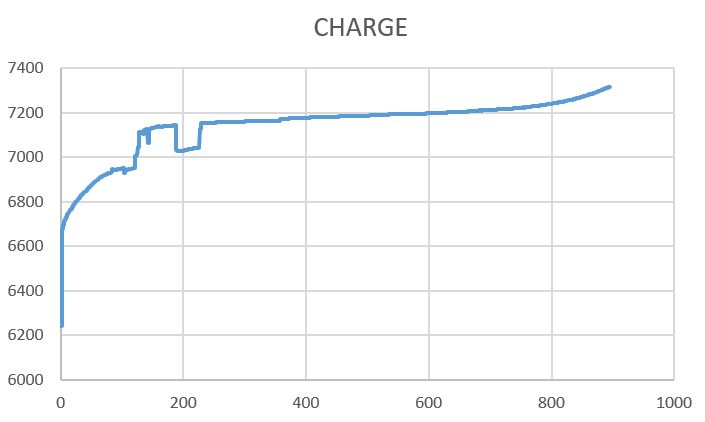
teams/power/Cycle Test/test 1.JPG
