UWCubeSat/DubSat1/teams/power/thermal tests/cold test/2018_04_02_12_55_38_tlmgrapher_screenshot.png

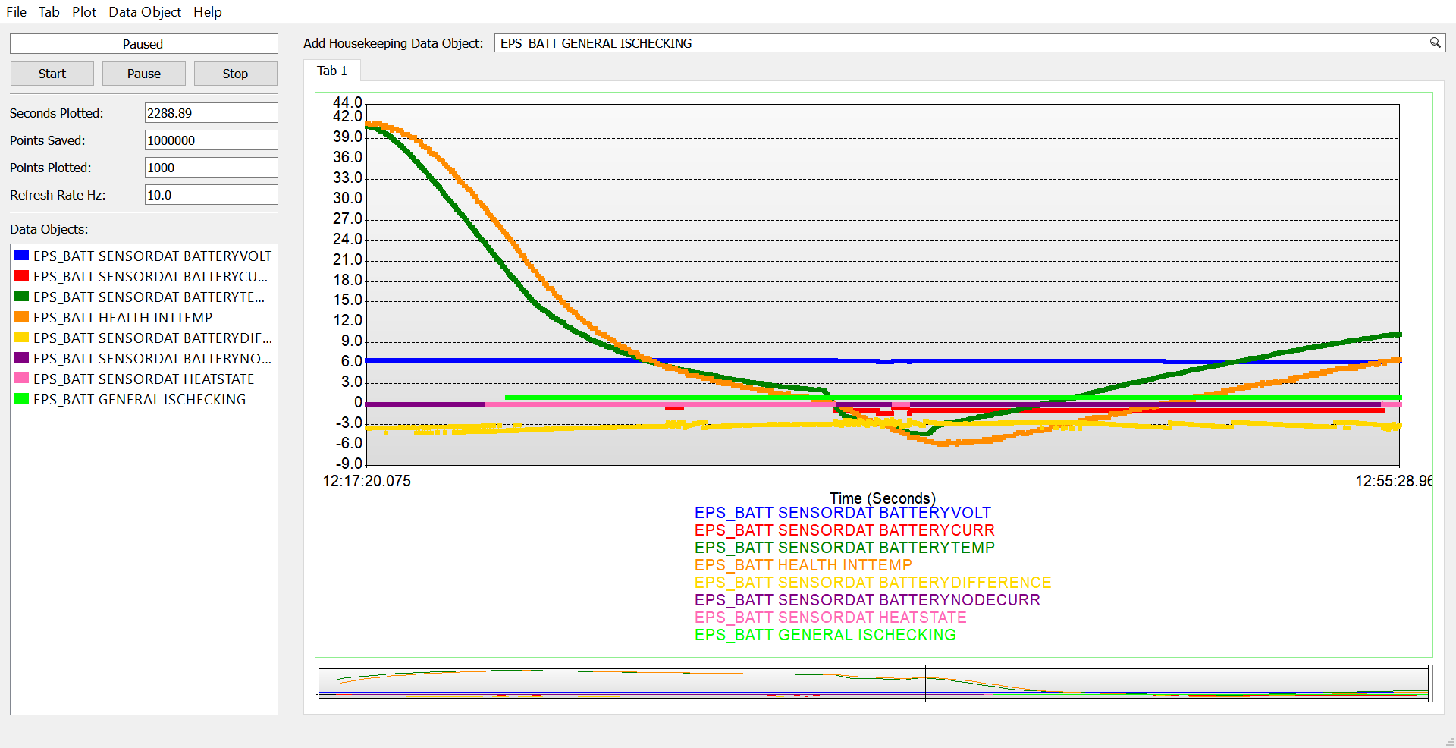
teams/power/thermal tests/cold test/2018_04_02_12_55_38_tlmgrapher_screenshot.png
