UWCubeSat/DubSat1/teams/power/thermal tests/heater test data/2018_03_22_18_08_33_tlmgrapher_screenshot.png

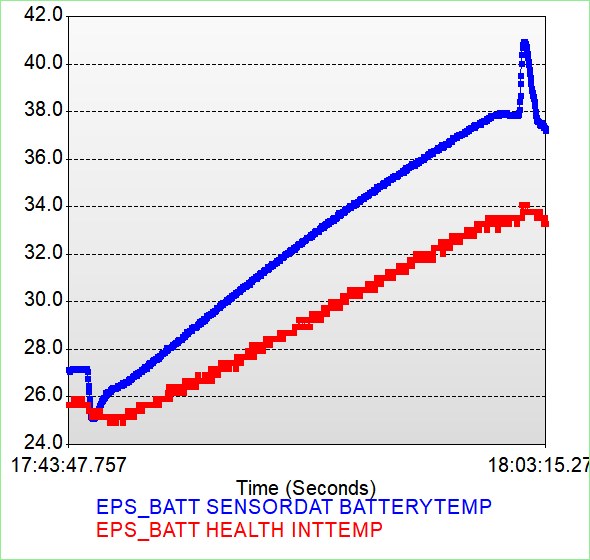
teams/power/thermal tests/heater test data/2018_03_22_18_08_33_tlmgrapher_screenshot.png
