UWCubeSat/DubSat1/teams/power/thermal tests/heater test data/Heater test matlab loacation comparison.png

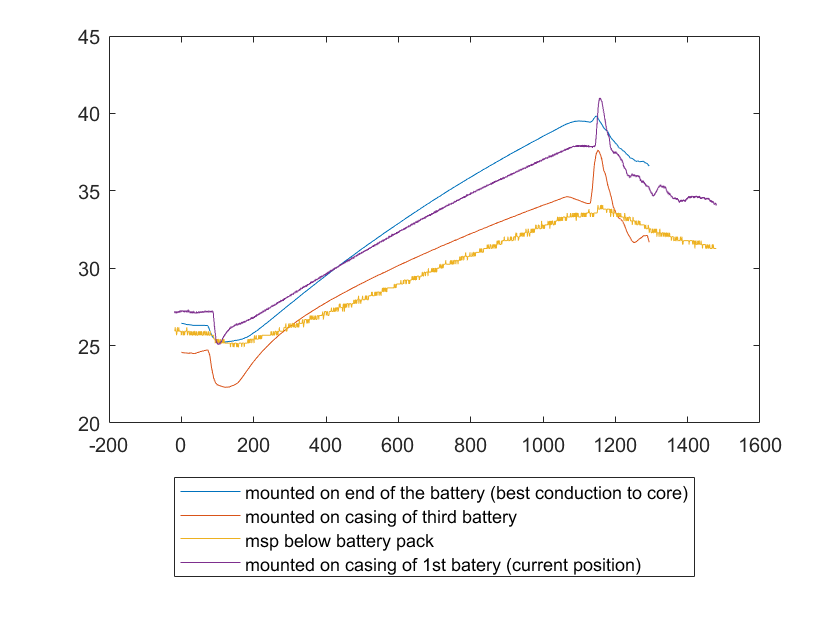
teams/power/thermal tests/heater test data/Heater test matlab loacation comparison.png
