UWCubeSat/DubSat1/teams/power/thermal tests/heater test data/heater test sections - Page 1.png

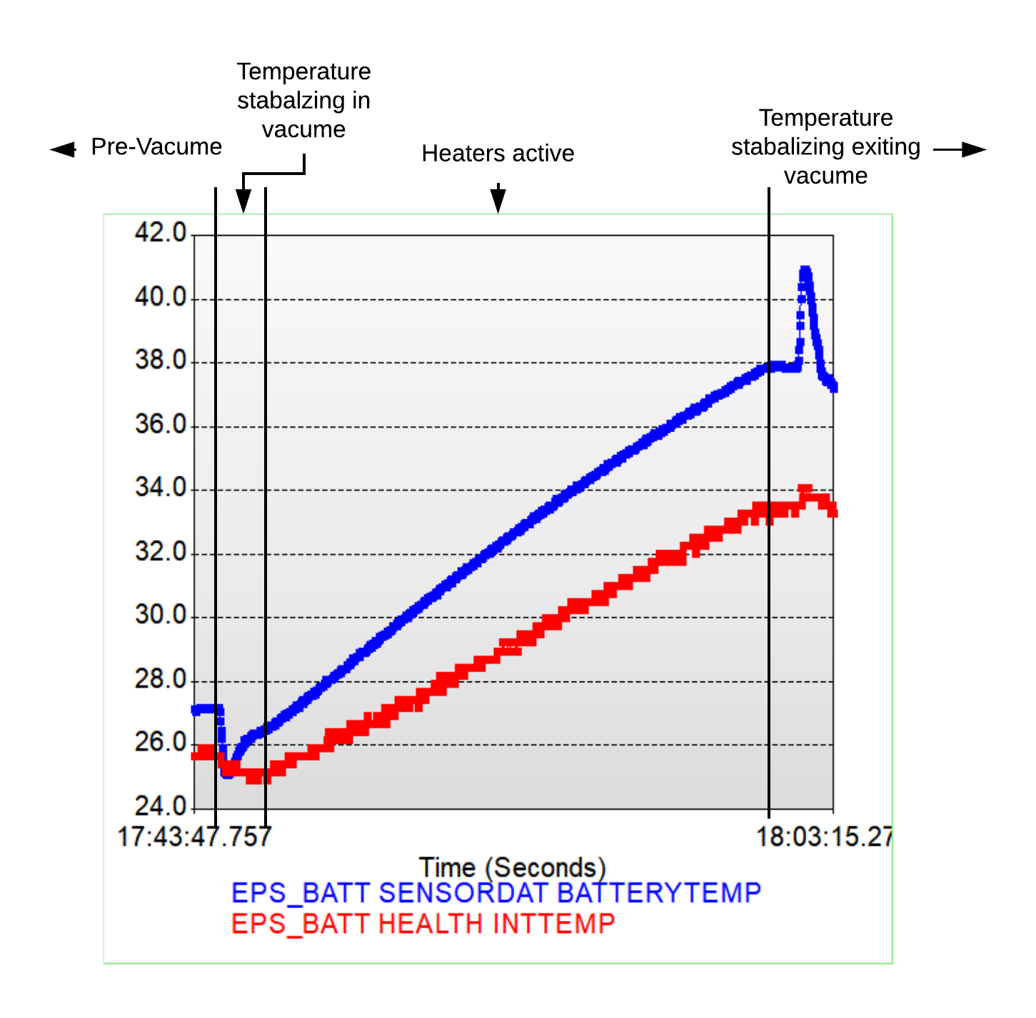
teams/power/thermal tests/heater test data/heater test sections - Page 1.png
