UWCubeSat/DubSat1/teams/power/thermal tests/heater test data/Heater test slopes.png

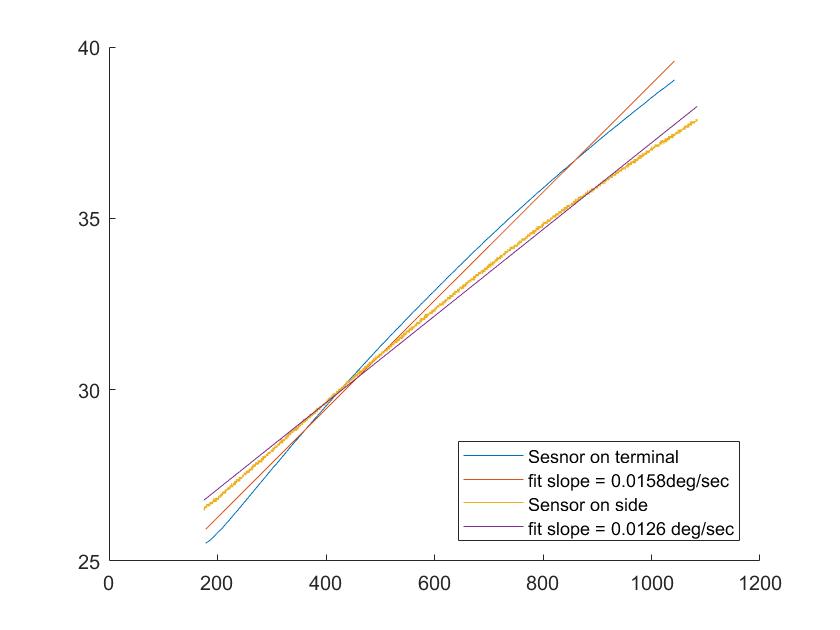
teams/power/thermal tests/heater test data/Heater test slopes.png
