UWCubeSat/DubSat1/(threads)

Thread 1 (2017-04-29):

Add I2C "middle layer" (i2cWriteBytes, etc. - sync and a sync versions, eventually)

jeffchrisope, 2017-04-29:
_From @jeffchrisope on April 10, 2017 12:9_

_Copied from original issue: UWCubeSat/I2C#8_

jeffchrisope, 2017-04-29:
Probably base loosely on wire.h, to make ports from Arduino (e.g. from the power guys) maybe less painful.

jeffchrisope, 2017-04-29:
Oops, hit the close button by mistake.  :)

jeffchrisope, 2017-04-29:
Done.

Closed 2017-04-29.

Thread 2 (2017-04-29):

Look into feasibility of introducing Hercules support to I2C library

jeffchrisope, 2017-04-29:
_From @jeffchrisope on April 10, 2017 7:33_

Likely too costly, at a number of levels.

_Copied from original issue: UWCubeSat/I2C#7_

jeffchrisope, 2017-04-29:
Almost certainly the right thing to do with I2C on the Hercules (if we end up needing to go that hardware route) is to use the Halcogen-generated I2C wrapper.  This is preferable to genericizing all the innards of our I2C library for the MSP43x.

Closed 2017-04-29.

Thread 3 (2017-04-29):

Make #define-based mechanism for specifying which I2C module is being used on MSP43x

jeffchrisope, 2017-04-29:
_From @jeffchrisope on April 10, 2017 7:33_

_Copied from original issue: UWCubeSat/I2C#6_

jeffchrisope, 2017-04-29:
Done.

jeffchrisope, 2017-04-29:
Oops, closed the wrong one.  This is still very much alive, but "nice to have" at this point, so low priority.

jeffchrisope, 2017-05-09:
New and maybe unfortunate requirement:  we MIGHT have to support multiple I2C buses going to the same 430, particularly in the ADCS subsystem, which has lots of "submodules" that will need to talk and one I2C for all of it is probably not the right call.

jeffchrisope, 2017-05-13:
See #39 for other possible twists on this - particularly the need for MULTIPLE peripherals ... ugh.

HuskySatLab, 2017-10-26:
Multiple buses now supported (as well as multiple devices.)

Closed 2017-10-26.

Thread 4 (2017-04-29):

Experiment with I2C interrupt behaviors, in preparation to do async flavor of wrapper

jeffchrisope, 2017-04-29:
_From @jeffchrisope on April 10, 2017 7:29_

_Copied from original issue: UWCubeSat/I2C#5_

Thread 5 (2017-04-29):

Add async call option for core call I2C call types

jeffchrisope, 2017-04-29:
_From @jeffchrisope on April 10, 2017 7:29_

_Copied from original issue: UWCubeSat/I2C#4_

Thread 6 (2017-04-29):

Add additional edge-case handling to synchronous I2C wrapper calls

jeffchrisope, 2017-04-29:
_From @jeffchrisope on April 10, 2017 7:27_

Right, the while loops are pretty brain-dead - at least several of them should know how to handle NACKS or otherwise exceptional cases, otherwise they will hang forever.

_Copied from original issue: UWCubeSat/I2C#3_

Thread 7 (2017-04-29):

Extract I2C and mag code from initial test harness.

jeffchrisope, 2017-04-29:
_From @jeffchrisope on April 10, 2017 7:23_

_Copied from original issue: UWCubeSat/I2C#2_

jeffchrisope, 2017-04-29:
Yep, closed.

Closed 2017-04-29.

Thread 8 (2017-04-29):

Create MAG3110 header file from datasheet

jeffchrisope, 2017-04-29:
_From @jeffchrisope on April 10, 2017 7:13_

_Copied from original issue: UWCubeSat/I2C#1_

jeffchrisope, 2017-04-29:
This is completed, and initial tests with MAG3110 are working.

Closed 2017-04-29.

Thread 16 (2017-04-30):

Create "misbehavior machine" for testing bus libraries.

jeffchrisope, 2017-04-30:
Poor behaviors include:
- simultaneous spamming SPI, I2C, UART
- invalid addresses for I2C
- CAN-Bus spamming, poorly formed messages (unknown ID's, incorrect length messages)

Thread 18 (2017-05-01):

Add standardized "bus status" structure and helpers to all comm layers (SPI, CAN, I2C)

jeffchrisope, 2017-05-01:
Should use UART as example.  Probably add sprint-based (debug only) statusToString fund for each bus, for debug console.

jeffchrisope, 2017-05-31:
Maybe have the notion of two layers of status - lightweight vs. intrusive.  The former simply captures what the software has collected (e.g. Number of bytes sent since reboot, number of overruns called), while the latter would actually call into hardware to get more info (e.g. CAN chipmtransmit/receive errors, etc.).  The idea is that sometimes just asking for status from hardware is enough to change the status, so it'd be good to have control over how lightly you want to tread.

Thread 20 (2017-05-01):

Gather requirements (from IO document?) on the range of expected analog devices

jeffchrisope, 2017-05-01:
Using ADC sensor chips? Direct connect to MSP?  How will nonlinear conversions and calibration be handled?

Thread 25 (2017-05-01):

Build first pass interrupt vector handlers for standard interrupt events

jeffchrisope, 2017-05-01:
First (and most obvious) thing to add to subsystem template, callback functions for the "standard" interrupts, including:
- sync pulse 1 and 2
- CAN messages incoming (after filter applied? Or all?)
- analog read ready on stuff?
- debug UART access

Thread 27 (2017-05-01):

BDot v2+:  sort out why always 0 outputs, despite varying inputs

jeffchrisope, 2017-05-01:

jeffchrisope, 2017-05-02:
According to input from RAIN Lab folks (thanks guys!) it looks like the issue is that my tests statically set MT_on to some value, but it's CHANGES to that variable that "pump" the system (or at least one change).  Not sure how we'll resolve this in the real situation - something will need to prime it - but for now I'll kick off a timer-based PWM with about a 1Hz/70% duty cycle and toggle it.  Should be enough to get us the next layer of testing.

jeffchrisope, 2017-05-13:
We are now getting reasonable numbers, given the noise levels from the sensor and parameters in the controller.  More tuning required.

Closed 2017-05-13.

Thread 28 (2017-05-01):

Come up with general shape and behavior of backchannel UART-based "debug console"

jeffchrisope, 2017-05-01:
Likely will have - on DEBUG builds only - the receive interrupt on the backchannel UART always on, and sending enter will yield a prompt.  From there, it's not clear if we should create some kind of pluggable "command" infrastructure, or just let each subsystem do whatever.  The former would be a better design, certainly, but might get overly complicated.

Shared stuff all subsystems SHOULD support, at least:
- access to bus status structures (so maybe those "register themselves" with commanding, when used?
- access to the state/substate (or mode/state, whatever the language is we end up using)
- specific access to CAN-Bus statistics for that subsystems

Also, would be good to be able to use the UART to see received CAN bus traffic, though that means someone has to be running with filters on

jeffchrisope, 2017-05-13:
More thoughts:
- two modes:  a "pretty print" mode for readability, and s CSV-spew mode for data capture

Closed 2017-08-20.

Thread 35 (2017-05-01):

Add correct logic for determining "is valid" for magtom measurements

jeffchrisope, 2017-05-01:

jeffchrisope, 2017-05-01:
Right now, it's just hard wired to 1 for testing ...

Thread 36 (2017-05-03):

Build lightweight SDcard logger for debugging, characterization data capture

jeffchrisope, 2017-05-03:
Current code base for this (based on Out of Box demo) is a pig, at over 60k, mostly due to the MSPWare library usage.  If we can't get this size down to something reasonable (e.g. <20k? Smaller?) then maybe we just stream data out of the UART and capture on the PC side.

jeffchrisope, 2017-06-01:
Yeah ... probably not a great idea, as the SD card interface is pretty slow, and converging on using the serial UART instead would allow us to leverage work done on the debug console.  So ... bye bye, for now.

Closed 2017-06-01.

Thread 38 (2017-05-13):

I2C hardening:  consider "reset lines"

jeffchrisope, 2017-05-13:
To protect against a misbehaving slave device from hanging the whole bus, need some way to cycle the sensor.  This could be as simple as cycling the whole subsystem board, or just power to the sensor (which should have a way to be turned off anyway?), or a true reset signal (if the device supports it).

jeffchrisope, 2017-05-20:
An alternative to this is to use the MSP430's "clock low timeout" interrupt on the I2C module (see 26.3.7.3 in the family datasheet).

Thread 39 (2017-05-13):

Determine true need for inter-board I2C bus communications and design solution

jeffchrisope, 2017-05-13:
Most likely culprit subsystem here is ADCS, and a good example is the magnetometer, which will very possibly NOT be on the same board as the BDot controller, or might be on the same board with the BDot but on a different board from the state estimator 432s, etc.

Main issues that will need to be resolved will be bus length problems (maybe needing buffers to re-boost so we don't have capacitance issues slowing the bus down and making it unreliable), and almost certainly having to solve the "reset line" issue as well.

jeffchrisope, 2017-06-03:
At this point, it looks like I2C will be used for all comms between components on the same board (if supported).  This means we need multimastering working, as well as easy use of multiple devices (with different IDs) per bus AND multiple I2C buses.

MrWilson1, 2017-06-03:
Thanks Jeff for detailed explanation on this design decision.

Hello Everyone,

If the decision is to use I2C to communicate between processors on the same board, we need to make sure that we minimize its proliferation - because it a risky endeavor (it may look easy now, but the problems won't be seen until the end).

If the plan is to have sun sensors on every subsystem board, the sensors should tie into  the existing subsystem 430 rather than adding a second 430 with an I2C communication bus.

Otherwise, we will be adding unnecessary complexity and risk to every subsystem - meaning reading a sensor is not core to the software design of a subsystem 430, but an I2C communication bus is.  And if we have a latent bug that does not show until we are in orbit - it would take out all subsystems.

Mark

Sent from my iPhone

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

jeffchrisope, 2017-06-03:
Agreed - hopefully there won't be too much cross-processor I2C needed, most of the need will be multiple I2C slave devices (sensors), which we can't get away from.  In some cases, we might want to have slaves on different buses from the same processor to mitigate risk, but I'm not 100% sure that will be needed.

The ADCS MSP432 is the main case where it's easy to imagine a scenario where a high-bandwidth comm channel is needed between it and another 430 (I.e faster than CAN), but it's possible we will avoid that entirely.  Most of that comes down to the channel between the state estimator and the model predictive controller, which likely will have to reside on two different processors.

Re: your point about whether ADCS assets located on non-ADCS-dedicated boards should drive the decision to put another (ADCS) MSP on that board ... I think we can probably avoid doing that in most, or maybe even all, cases - but if we determine we MUST add another  (e.g. the complexity of the ADCS functionality starts to drive risk up on the mission critical portions of the subsystems processor), that processor won't have a I2C channel to that local subsystem processor I wouldn't think - it will be its own island, throwing stuff onto the CAN bus.  So that is "good", I think.

But ironically, just in general, we did get the feedback from the Planetary Resources demo yesterday to not have too many compute elements.  They ended up in that boat (17!), and believe now they went a bit overboard.  Of course, they are using more powerful processors, but still ... valid general point.

On Jun 3, 2017, at 10:07 AM, Mr. Wilson <notifications@github.com<mailto:notifications@github.com>> wrote:

Thanks Jeff for detailed explanation on this design decision.

Hello Everyone,

If the decision is to use I2C to communicate between processors on the same board, we need to make sure that we minimize its proliferation - because it a risky endeavor (it may look easy now, but the problems won't be seen until the end).

If the plan is to have sun sensors on every subsystem board, the sensors should tie into the existing subsystem 430 rather than adding a second 430 with an I2C communication bus.

Otherwise, we will be adding unnecessary complexity and risk to every subsystem - meaning reading a sensor is not core to the software design of a subsystem 430, but an I2C communication bus is. And if we have a latent bug that does not show until we are in orbit - it would take out all subsystems.

Mark

Sent from my iPhone

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

—
You are receiving this because you authored the thread.
Reply to this email directly, view it on GitHub<https://github.com/UWCubeSat/DubSat1/issues/39#issuecomment-305988275>, or mute the thread<https://github.com/notifications/unsubscribe-auth/AGdloO16EjjJX-PdHHFA4WpTaCIc4dTnks5sAZLOgaJpZM4NZ-eR>.

Thread 46 (2017-05-31):

Move watchdog timer disable-ment to before C initialization

jeffchrisope, 2017-05-31:
I finally ran into this problem actually occurring when I initialized some not-terribly-large data structures.  EXTREMELY irritating.

Two ways to fix it:
- move the code to disable the WDT into int _system_pre_init(), which supposedly works in CCS
- leave code where it is (in bspInit(), currently) and link with --cinit_hold_wdt option (buried under linker settings somewhere in the CCS project properties UI)

Not sure which is better, but we have to do something.  ADCS *will* bump against this issue once their full flight software components come online.

Thread 48 (2017-06-01):

Investigate optimal feature set for BLDC drivers

jeffchrisope, 2017-06-01:
Includes stuff like whether to use Hall sensor inputs or go sensorless for the driver's commutation/coordination logic, and how tunable the driver needs to be for things like open-loop start-up time/acceleration, etc.

HuskySatLab, 2017-10-26:
Done, driver chosen.

Closed 2017-10-26.

Thread 49 (2017-06-01):

Build macro magic layer to make switching between different timers easier.

jeffchrisope, 2017-06-01:
This issue became particularly evident on the bdot controller, as there is a need to track the timing of a number of different aspects of the behavior, and not all the timers are created equal (TAx and TBx are different, of course, but also - irritatingly - e.g. TA4 has far fewer CCR registers from TA3, etc.).  I'm not sure we want a full wrapper that catches those things - you catch them pretty quickly when the macro expansion yields a register that simply doesn't exist - so for now we'll do macros and see how that holds.

Thread 50 (2017-06-01):

Add interrupt handlers for all the various non-maskable sources from the system.

jeffchrisope, 2017-06-01:
From the family datasheet:

1.3.7 SYS Interrupt Vector Generators
SYS collects all system NMI (SNMI) sources, user NMI (UNMI) sources, and BOR, POR, or PUC (reset)
sources of all the other modules. They are combined into three interrupt vectors. The interrupt vector
registers SYSRSTIV, SYSSNIV, SYSUNIV are used to determine which flags requested an interrupt or a
reset. T

Thread 54 (2017-06-03):

Move to the new HMC5983L magtom model, per PRI guidance

jeffchrisope, 2017-06-03:
Has built-in automatic temperature compensation, also faster (though that's not that interesting to us).

HuskySatLab, 2017-10-26:
Our breakout board with the new chip has been tested and works fine with identical code as the 5983.  We will want to fork the code, however, due to the slightly different settings for things like the tempco functionality.

Thread 56 (2017-06-03):

Fix error handling/telemetry in the "ERT Main" code tie-in to be smarter about recovery

jeffchrisope, 2017-06-03:
Currently, we do very little with task overrun information.  Needs to change.

Thread 62 (2017-08-12):

Add magtom self-test functionality (trippable by debug console/CAN/at startup?)

jeffchrisope, 2017-08-12:
Definitely want to do this, particularly to test for heat damage after reflow/ESD.

Thread 63 (2017-08-20):

Change I2C init take care of configuring pins as well

jeffchrisope, 2017-08-20:
Note that this should be done by redirecting through the BSP layer, so that the correct board/pin layout can be determined.

HuskySatLab, 2017-10-26:
Done.

Closed 2017-10-26.

Thread 64 (2017-08-20):

Standardize on ALL libraries taking care of pin setup.

jeffchrisope, 2017-08-20:
Note that this should be done via the BSP layer, so that the current board layout can be determined.

Thread 65 (2017-08-20):

Known new CAN messages needed

jeffchrisope, 2017-08-20:
Please use this issue/item as a temporary storage place for the CAN messages we have discussed recently, that need to be included in the official DBC file once that is picked up by the appropriate person.

Definitely needed:
- "Wake up" message:  sent upon a subsystem starting up, with as much info from registers as possible to indicate why they were power cycled
- "Request to power cycle" - since our power domains won't be fine-grained enough to allow an MSP to cycle individual (or all of its) sensors, we are going with the model that they can either power cycle just their chip (typically done by writing to the watchdog register without the magic password value, hence forcing an MSP 'reboot') or a true power cycle, by sending out this message.  The power system would listen for it, and power cycle the requesting board's power entirely.

djdupre, 2017-09-14:
I'v proposed some GPS messages in this commit: 02ffb1dfffb547e120a29692e1cb78381083c7be.

I'll see if these the Rain Lab guys agree.

djdupre, 2017-09-15:
I want to broadcast six floats for standard deviation of position and velocity. Should they each have their own message, or should they be grouped to fit in just three messages?

jeffchrisope, 2017-09-15:
Pack ‘em in as tightly as you can, the more the merrier.

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

Thread 66 (2017-09-02):

Look through latest (and correct) silicon errata for MSP43x's

jeffchrisope, 2017-09-02:
First we will need to determine which version is correct ...

Examples:  one of the latest versions mentions the ADC barfing under re-entrant sample calls, and something about certain clock phase settings only stable on some eUSCI SPI instances.  Also, the DCO continues to have possible out-of-spec transients when moving to certain higher clock speeds, necessitating a roundabout messy way of configuring the clock system.

NOTE:
- DCO issue workaround IS in place, in bspInit()

jeffchrisope, 2017-09-02:
Fairly current:  http://www.ti.com.cn/cn/lit/er/slaz681e/slaz681e.pdf

Thread 71 (2017-10-28):

CORE:  Timer library v0.9

HuskySatLab, 2017-10-28:
This initial version will have core timer functionality, allowing for easy, low-overhead timer tracking.

MrWilson1, 2017-10-28:
Task 1:  Design and Implement simple timers:
                a) Compile the existing Core code onto an MSP5994 board and become familiar BSP.h
                b) Using TimerA (values from 1uS to approx 65ms).......
                     1) Create a setTimerToZero_us_resolution() function that returns the value of TimerA
                            - Application defines variables, say CAN_timeout and I2C_timeout
                            - "clear" these variables as follows - in the appropriate places in the app code
                                     CAN_timeout = setTimerToZero_us_resolution():  //turn ON LED 0
                                     I2C_timeout = setTimerToZero_us_resolution():  // turn ON LED 1
                     2) Then use chkTimer_us_resolution(int timer_value)
                             - Application would use in appropriate places in App code
                                      if(chkTimer_us_resolution(CAN_timeout) > 50ms //make this a define
                                      {
                                            do something here - maybe record an error
                                            For now, turn OFF the LED 0 //put in place holder for now - wait for d) below to get this working
                                      }
                    
                                      if(chkTimer_us_resolution(I2C_timeout) > 2ms //make this a define
                                      {
                                            do something here
                                            For now, turn OFF the LED 1 //put in place holder for now - wait for d) below to get this working
                                      }
                b) Using variable "seconds_timer" (values from 65ms to approx 72 minutes)......
                     1) Use a setTimerToZero_sec_resolution() function that returns the value of seconds_timer
                            - Application defines variable, say Sync_timeout
                            - "clear" as follows - in appropriate place in the app code
                                     Sync_timeout = setTimerToZero_sec_resolution():  //turn ON LED 3
                     2) Then use chkTimer_sec_resolution(int timer_value)
                             - Application would use in appropriate place in App code
                                      if(chkTimer_sec_resolution(Sync_timeout) > 800ms //make this a define
                                      {
                                            do something here - maybe record an error
                                            For now, turn OFF the LED 2  //put in place holder for now - wait for d) below to get this working
                                      }

                  d) create test functions that use LED 0, 1 and 2 in bsp.h - make sure we do not check
                        these into main

MrWilson1, 2017-10-31:
Timer Type 2:  Design and Implement:

1. An Event Timer (with a 10ms Interrupt Rate, for now) Requires
    - An Interrupt Service Routine
       - Code to reload the event timer overflow register (each time)
       - 2 lines of code for each timer
    - Define 10 general timers, which will count down to zero (general_timer1, general_timer2, etc)
    - A set_timer(timer name, timer value) function that
       - Relates timer name to one of the general timers
          - Intent is to hide general timers from app developer
          - So that the ISR does not need to be updated for each new App timer
    - A chk_timer_expired(timer name) function
       - that returns True if timer equals zero
       - Needs to remove timer name from list when done (free up general timer)

Thread 72 (2017-10-28):

CORE:  Mini-stats library v0.9

HuskySatLab, 2017-10-28:
Main design points:
- user of library owns the actual arrays of data that will be analyzed (to avoid dynamic memory allocation within stats library)
- user initializes library with location and length of buffer, then library manages insertions/deletions, treating as a circular buffer as required
- statistics that are required:  min, max, mean, mode
- management functions required:  initialize, add, clear

Thread 73 (2017-10-28):

ADCS:  Photodiode library v1.0

HuskySatLab, 2017-10-28:
Remaining issue includes:
- moving to naming model where device-specific names are moved out of class/function/file names, except where they are truly device specific
- move to multi-device model, probably based on opaque handles

NOTE:  this will be the first time the new I2C multi-device work will be thoroughly exercised, so I suspect there will be bugs ... please plan accordingly.

Thread 75 (2017-10-28):

ADCS:  Sun sensor library v0.5

HuskySatLab, 2017-10-28:
First pass at the sun sensor library.  Should be pretty easy ...

... if the hardware were working ... which it apparently is not.  Jeff and Jerrold are in communications with the sensor manufacturer (Solar MEMS), and have shared a full output from the failed communication attempts.

We will update this as required.

Closed 2017-11-11.

Thread 77 (2017-10-28):

EPS:  Distribution board min-implementation v0.3

HuskySatLab, 2017-10-28:
This is an initial pass at creating MSP-based logic for the distribution board logic, specifically making sure driving the switches properly works well.  Need to confirm with EPS folks exactly what is needed, however.  Also, note this is heavily depedent on #74.

jeffchrisope, 2017-11-08:
Moving to next sprint (or later) due to hardware readiness.

Thread 80 (2017-10-28):

ADCS:  Fix RWS timing problems

HuskySatLab, 2017-10-28:
Currently there is an unknown more or less linear error source when spinning up the reaction wheels and comparing the externally measured speeds (verified with certified photo tachometers) and the calculated speeds based on timing deltas tracked in on-chip timer interrupt handlers.  The total error is on the order of 1200rpm at 8000rpm indicated.

Thread 82 (2017-10-28):

ADCS:  Address RWS dead-band and negative RPM issues

HuskySatLab, 2017-10-28:
Currently, there is no special notion of a dead-band for the reaction wheel (here referring to the minimum RPM at which the motor is still controllable - lower than that and stiction and ??? tends to stop the motor).  We will likely rely heavily on the ADCS software sending the reaction wheels commands only when outside of the band, but there still needs to be sane handling if commands happen to fall within the band - plus, more importantly, it's also possible the dead band will develop over time.

Thread 83 (2017-10-28):

ADCS:  Finish RWS PID loop tuning

HuskySatLab, 2017-10-28:
The current PID constants in the RWS test code works well enough (though note that at the time of this writing, Kd = 0 due to noise on speed feedback line), but they really should be tuned to match ADCS RWS requirements in terms of overshoot, settling time, rise time and (particularly) fall time.  Note that this last value is hard to achieve without using the "active" braking mode on the motor controllers, but it isn't yet clear that we want to enable this in all scenarios, enable in just some (i.e. when error is over a certain amount), or never.

Thread 84 (2017-10-28):

GROUND:  CAN2LAN COSMOS bridge setup working for telemetry

HuskySatLab, 2017-10-28:
We are using the PCAN-Ethernet Gateway DR for the CAN to LAN bridge for the flat-sat interface.  It is being used in the "raw TCP port" mode, where all messages are dropped onto the TCP network with a fixed, 36-byte structure per CAN message.

This task is to get the device setup and configured to talk to COSMOS, and allow COSMOS to see the CAN data fields.  It does NOT show how to read individual CAN message types at this time.

HuskySatLab, 2017-10-28:
Complete.  Note that most of the fields in the PCAN TCP packets are fixed, regardless of CAN message type - even different length CAN messages don't matter, as the PCAN packets always contain 8 bytes for the data, even if DLC is <8.

Closed 2017-10-28.

Thread 87 (2017-10-28):

PPT:  First prototype PPT software v0.5

HuskySatLab, 2017-10-28:
Actual logic needs to be written to use the timers and stats libraries to stitch together the correct control behavior.  Also includes fleshing out the state machine for the overall PPT.

Thread 88 (2017-10-28):

CAN:  Update initial DBC master for testing purposes

HuskySatLab, 2017-10-28:
The current master DBC - located at .../ref/CAN/CANDB-MASTER-DS1.dbc - is still far from complete.  Other issues will be created to track completing this file.  However, what would be useful immediately would be to make sure there is at least one instance of each "sort" of message and signal.

This includes:
- all signal bit lengths, including ones that don't map C data types cleanly
- enum-like handling using DBC "value tables/value descriptions" (note that at least the DBC Vector editor does weird stuff with these as you're saving a file ... still need to understand what's happening there)
- passing all custom "attribute definitions" along, so that they can be used "downstream" if necessary ...

HuskySatLab, 2017-11-12:
@emorye  - FYI, this file (CANDB-FeatureTest.dbc) now represents the "subset" of DBC features that we want to support, so it should be useful as a minimum test case for the wrapper generation tools.  Note that attributes at several levels (messages, nodes) are used (both enumerations and numeric types), and value tables.

Closed 2017-11-25.

Thread 90 (2017-11-01):

ADCS:  Get autocode from SL running on a 432 and perform memory/perf tests

jeffchrisope, 2017-11-01:
This is the first real attempt to get library blocks from Simulink running on the MSP432 chip.  The folder with the generated code is actually in the ADCS repo, in the adcs_fsw/matlab/test/fsw-autocode-test/ folder (specifically CDR_autocode_ert_rtw for this round).  Success here will look like taking the autocoded env estimator and EKF components, get them compiled successfully targeting our MSP432 environment, deployed, and running.  Once compiled, we will capture memory usage statistics (and hopefully find we have some headroom).  Once running, we will run the oneStep() function(s) for as much as we can, at the maximum rate, and see what that rate is.

HuskySatLab, 2017-11-01:
Updating MSP432 toolset standard version in repo.

HuskySatLab, 2017-11-01:
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
Memory usage (see project src/devmods/adcsfswtest_cdr_msp432), deployed onto actual MSP432 Launchpad.  rt_OneStep() call rates in the 35-45Hz region, which is a good starting point - though note that no actual sensor data is being fed into the system, so things will likely slow when there are more "things to do."

jeffchrisope, 2017-11-03:
Actually ... new process:  tasks aren't closed until the sprint meeting, so they can be confirmed done.  The task cards can (and should) still be moved to the completed column once done, however.

Closed 2017-11-11.

Thread 92 (2017-11-11):

EPS:  Create library for the INA power monitor.

HuskySatLab, 2017-11-11:
One of the first building-block pieces of the gen board software implementation on the MSP430.

mkyl, 2017-11-13:
I've spent the weekend reading up on the MSP430, and setting up the development chain on my laptop. I'll verify that I can push code the MSP and run it on Monday.

Thread 101 (2017-11-12):

Setup and actually use MSP43x watchdog timers

HuskySatLab, 2017-11-12:
We currently just immediately disable the WDT in all test and subsystem code.  We need to investigate if there are subsystems that should/must have watchdog protection via this timer vs. having it through some other mechanism (e.g. EPS dist board reboot on lack of role-call response)

Thread 102 (2017-12-20):

fix this piece of crap board

HuskySatLab, 2017-12-20:
sdfsdfsdf

HuskySatLab, 2017-12-20:
This was a test milestone/task to show Paul how Git can be used to track board change requests.

HuskySatLab, 2017-12-26:
Adding Paul, so he can fix this piece of crap board.

Thread 106 (2017-12-23):

Battery board v6: reinforce battery positive terminal

spoulter, 2017-12-23:

Thread 110 (2017-12-23):

battery board v6: reverse CB_EN and BB_EN

spoulter, 2017-12-23:
In the battery balance's enable logic, the gate of the transistor is supposed to go to the MSP while the source is supposed to pull down the battery balancer's enable pin. They are currently reversed.

Thread 111 (2017-12-23):

I2C:  Fix lingering reliability issues

HuskySatLab, 2017-12-23:
Two main problems became apparent working on the INA219s for the distribution board.

1)  At least Write operations, and perhaps read as well, are not totally "done" when the function returns currently - if a read or write operation is placed immediately after the write operation, the first operation is corrupted (with the partial byte problem indicated on the Total Phase Beagle).

2)  Small changes in bus response, caused by for instance unplugging the Beagle from the computer (which leads to the resistance on the I2C lines going from 25K to 50K) actually yields a lock up situation, which only very rarely the MSP can recover from.  This is apparently due to the bus getting into a bad state and the library locking up in some state that it can't recover from.

One or both of these issues could be due to peculiarities with the INA219, as we haven't run into them before, but that's not a sure thing.  More investigation needed.

Thread 112 (2018-01-29):

CAN wrap struct fields are redundant

djdupre, 2018-01-29:
Is there a reason we have struct field names like "msp_temp_temp"?

jeffchrisope, 2018-01-29:
I’m going to blame the CCS renaming “feature”.

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

emorye, 2018-01-29:
I found that it was best to not have signals ever share the same names, even if they are exclusively in different packets, since vector displays all of them in one list, and just to avoid confusion. The easiest way to prevent collisions happened to be to preceed the signal name with the frame name. So this is works as intended unless people want me to change it enough.

Closed 2018-01-29.

Thread 114 (2018-03-22):

EPS / Battery board: Correct the pin order of temp sensor

spoulter, 2018-03-22:
The temp sensors pin order is flipped, currently requiring the power and ground wires to cross and bending the temp sensor leads. Reorder according to datasheet.

Thread 115 (2018-03-22):

EPS / Battery board: Extend Coulomb Counter Pads.

spoulter, 2018-03-22:
Soldering the coulomb counter has been a constant issue due to shorting under the DFN pads. Extending the pads beyond the outline of the package will make it easier to see when the chip is aligned and provide overflow area for the solder paste.

Thread 116 (2018-03-22):

EPS / Battery board and Distribution board: Resolve jumpers colliding with battery heaters.

spoulter, 2018-03-22:
Jumpers on the distribution board are digging holes in the battery heaters. They need to be moved or possible ground down.

Thread 118 (2018-04-08):

Incorrect CAN enum error codes for sun sensor

djdupre, 2018-04-08:
The master dbc file has the correct value descriptions for sensorproc_sun_status but the macros in canwrap.h do not match (under/over illumination should be 11/12, but they're 17/18 instead).

emorye, 2018-04-08:
Has been fixed in develop

Closed 2018-04-08.

Thread 123 (2018-04-26):

SPI:  SPI hangs in some heavy CAN use scenarios (e.g. MTQ)

HuskySatLab, 2018-04-26:
From Slack:
... if you break into the MTQ code, it is hung in a SPI while loop, and IIRC nothing else comes from the MTQ (no ack packets, no COSMOS zeros).

garrettdreyfus, 2018-04-26:
Think we’re good now. The zeroes were because of stack. The other problem was conflicting interrupts.

Closed 2018-04-26.

Thread 124 (2018-04-27):

CAN delay before Port 5 Interrupt

emorye, 2018-04-27:
There is sometimes a few ms. between INT going low on the MCP And the interrupt being triggered on the MSP

garrettdreyfus, 2018-05-04:
This issue has been solved. It was due to improper interrupt usage. Rtonestep the autocode function which does a majority of the bdots logic was being called by the timer interrupt. This would take priority over the can interrupt and therefore delay its servicing.

Closed 2018-05-04.

Thread 127 (2018-04-28):

Aardvark is choking when trying to read more than ~10,000 samples

HuskySatLab, 2018-04-28:

djdupre, 2018-05-04:
I've successfully read ~40,000 samples so far with [my sendIMU script](https://github.com/UWCubeSat/DubSat1/blob/develop/teams/cdh/BusExperiments/ADCS_SP_Experiment/sendIMU.m).

djdupre, 2018-05-19:
Calling aa_i2c_slave_write_stats_ext seems to help get rid of the communication errors and allow the master to write.

Thread 130 (2018-04-29):

PD board hangs at instruction 0x04

garrettdreyfus, 2018-04-29:
cmd_rollcall is the only packet that hangs this MSP, hangs even without inserting data payload. Steps to reproduce: send cmd_rollcall

emorye, 2018-04-29:
We no longer think it is cmd_rollcall.

emorye, 2018-04-29:
Using CANWrap without registering a callback is bad as its set up right now. Default function pointer is like 0x0.

emorye, 2018-04-29:
Registered a callback, no longer freezes

Closed 2018-04-29.

Thread 135 (2018-05-04):

MTQ CAN filter not working

eloise18, 2018-05-04:
withFilter initialization of CAN doesn't receive bdot commands packet

emorye, 2018-05-04:
Incorrect Mask 1 literal was used. Switched to correct mask in canwrap.c

Closed 2018-05-04.

Thread 138 (2018-05-07):

Battery Board doesn't send rollcall

nkwacker, 2018-05-07:
Function to send rollcall exits after this line:
                rollcallPkt9_info.rc_eps_gen_9_pnl_3_temp_avg = getAvg_uint16_t(panel3Temp);
rcFlag also appears to get set to zero
also the can interrupt appears to never get hit again

nkwacker, 2018-05-07:
It appears that panel3Temp was initialized by dataArray to 12, but that the array of handlers only goes up to index 9

Closed 2018-05-08.

Thread 141 (2018-05-08):

Rollcall response packets not being sent consistently.

garrettdreyfus, 2018-05-08:
Heavy suspicion that the first rollcall response packet being sent more often than subsequent packets is due to distribution board double sending rollcall command packets.

nkwacker, 2018-05-08:
The dist board changes appear to have fixed the issue

Closed 2018-05-08.

Thread 144 (2018-05-09):

ESTIM/SensorProc:  Current draw on power domain is too high, and highly variable

HuskySatLab, 2018-05-09:
Need to understand why we draw .24A steady-state, and frequently spike above .3A (thus triggering the dist board overcurrent protection shutdown logic).  I'd rather figure out why we are drawing this much, and why it varies, than just bumping up the threshold.

djdupre, 2018-05-13:
Fixed by removing the MSP432s.

Closed 2018-05-13.

Thread 148 (2018-05-10):

Sensor proc. rollcall packets use wrong types

djdupre, 2018-05-10:
The dbc file correctly uses int16_t, but the structs for the rollcall packets use uint8_t (except for packet #1).

garrettdreyfus, 2018-05-10:
Rollcall.c also bit shifts the fields by 16 not 8

djdupre, 2018-05-10:
Fixed in #149

Closed 2018-05-10.

Thread 153 (2018-05-10):

Canwrap is filtering out rollcall commands

djdupre, 2018-05-10:
Sensor proc. doesn't get a rollcall command unless I use `canWrapInit()` without the filter.

Thread 154 (2018-05-10):

BDot HIL:  BDot response and MTQ loop spends way too long pegged at extremes

HuskySatLab, 2018-05-10:

thup15, 2018-05-10:
Bug: Magnetometer data was off by a factor of 10. ..lol

Closed 2018-05-10.

Thread 155 (2018-05-10):

Gen doesn't send rollcall

nkwacker, 2018-05-10:
Gen no longer responds to rollcall.  To reproduce, simply power cycle flatsat.

Closed 2018-05-14.

Thread 158 (2018-05-11):

Batt hangs

nkwacker, 2018-05-11:
A lot.  Just power cycle and it is bound to hang most of the time

HuskySatLab, 2018-05-12:
commenting first

nkwacker, 2018-05-12:
The issue might be hardware related, as it doesn't appear in the eps setup

nkwacker, 2018-05-14:
Can't reproduce

Closed 2018-05-14.

Thread 165 (2018-05-15):

Can Bus gets bit errors every once in awhile

garrettdreyfus, 2018-05-15:
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

Here the bit error seems to be the sun sensors sun packet, but the first 4 bytes or so are 0's.

HuskySatLab, 2018-05-15:
https://www.kvaser.com/about-can/the-can-protocol/can-error-handling/

Thread 172 (2018-05-16):

ESTIM produces garbage CAN data

nkwacker, 2018-05-16:
something on the ESTIM pd causes the CAN bus to go down and a CAN error is reported.  to reproduce, simply turn on the estim pd

Thread 173 (2018-05-17):

Add temperature readings to rollcall packets

garrettdreyfus, 2018-05-17:

garrettdreyfus, 2018-05-17:
Wasn't there once an issue with asensors ability to read temperature @nkwacker ?

nkwacker, 2018-05-17:
I believe so, but I don't recall the nature of the issue or how to replicate it.

garrettdreyfus, 2018-05-18:
all right I'll check it out tomorrow.

nkwacker, 2018-05-26:
There appears to be no issue reading temperatures

Closed 2018-05-26.

Thread 176 (2018-05-19):

CAN_LOCAL CAN_SHARED_DATA screen has many issues

HuskySatLab, 2018-05-19:
Various stuff needs fixing here, as it currently doesn't work, looks like crap, etc.  Including:
- virtually none of the fields are actually showing data (this obviously has something to do with individual boards, please followup with owners and get these working
- text fields are too small
- overall layout looks bizarre
- some values have limit bars, some don't
- screen title should be English not STUFF_LIKE_THIS
- weird label font sizes

Thread 177 (2018-05-19):

Dist sometimes doesn't send CAN

nkwacker, 2018-05-19:
After hanging and resetting, dist fails to send CAN sometimes.  The boards calls the library function, but when looking at it with a Saleae, insufficient SPI can be observed.

nkwacker, 2019-04-01:
No longer observed

Closed 2019-04-01.

Thread 179 (2018-05-20):

cosmos plots data are sporatic from all boards

HuskySatLab, 2018-05-20:
all boards's comos telemetry packets are not receiving at a constant rate. If you run it for a while, the symptoms starts to show up. Reloading configurations on cosmos temporarily relieves the problem for a few seconds.

HuskySatLab, 2018-05-20:
Sending udp packets at 600/s makes this problem show up.

HuskySatLab, 2018-05-20:
Decreasing the rate at which udp packets are sent through cosmos at 2hz with three packets of udp make everything work correctly again. Thanks David!

Closed 2018-05-20.

Thread 180 (2018-05-22):

Sensor proc's processed mag vector always reads 0

djdupre, 2018-05-22:
The autocode output for mag vector reads 0 even though the inputs are non-zero

djdupre, 2018-06-03:
The rollcall packets for mag1 and mag2 also always read 0. Updating the autocode would help.

atikinf, 2018-06-30:
Fixed by 06792a45680ff53a6cbc284b4e10d40417a73875

Closed 2018-06-30.

Thread 181 (2018-05-22):

Dist stuff I've implemented but is not running

nkwacker, 2018-05-22:

nkwacker, 2018-05-22:
Turning off subsystems if not rc response

nkwacker, 2018-05-22:
Rebooting every hour

nkwacker, 2018-05-22:
Waiting for 30min on first powerup

nkwacker, 2018-06-29:
autosequencer initialization (remove autostart)

Thread 182 (2018-05-23):

Dist's batt voltage spikes down to 0

nkwacker, 2018-05-23:
The distribution board's measured battery voltage often spikes down to 0 every 7-8min and occasionally spikes ridiculously high (3.6e16V)

Thread 184 (2018-05-25):

Distribution board wrecks CAN bus

garrettdreyfus, 2018-05-25:
Busmaster showed just bit errors being sent. We narrowed it down to the distribution board by turning off every power domain and it still sent errors.  The SPI line on the bus was acting very strangely

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

emorye, 2018-05-25:
How is the spi line acting weird?

garrettdreyfus, 2018-05-25:
Those photos of the oscilloscope are of the SPI line.

emorye, 2018-05-25:
Also is it reproducible? What are the steps to reproduce? @Paul-Sturmer @garrettdreyfus

garrettdreyfus, 2018-05-25:
The COM2 board was attached also not sure if it caused the FlatSat to be put in a bad state.

emorye, 2018-05-25:
Looks like the spi line is acting normally, characteristic of 3 tx buffers full I'll have to check why it thinks all the buffers are full.

garrettdreyfus, 2018-05-25:
That is good to know

garrettdreyfus, 2018-05-25:
Emory told me that "It looks clear that we MUST check what canSendPacket() returns
because I can 99% guarantee you it is returning nonzero (for Send failed)
(for boards in general)"  So maybe that should be the criteria for the distribution board to reset itself? @nkwacker  @Paul-Sturmer @jeffchrisope

garrettdreyfus, 2018-05-25:
Paul says this is due to deployment switch.

emorye, 2018-05-25:
What's the deployment switch?

Paul-Sturmer, 2018-05-25:
it's the switch the when depressed unpowers the entire satellite. this is
how the satellite turns on when it leaves the dispenser

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

Closed 2018-05-25.

Thread 185 (2018-05-26):

MET lengths are reversed in dist rc

nkwacker, 2018-05-26:
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
Note how overflow is 4 bytes where it should be 1 and met is 1 byte where it should be 4.

Also on a slightly unrelated note, in the COSMOS packet `RC_EPS_DIST_2` only has `RC_EPS_DIST_2_MET` but not the overflow field

garrettdreyfus, 2018-05-26:
:P. Just switched the two.
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

nkwacker, 2018-05-26:
What about the COSMOS issue?

garrettdreyfus, 2018-05-26:
canwrap issue resolved

emorye, 2018-05-26:
(Reopened b/c Cosmos issue not resolved)

nkwacker, 2018-06-14:
Remaining problem appears in issue #201

Closed 2018-06-14.

Thread 188 (2018-05-27):

Dist measures all power domains low in bursts (and they are actually low)

nkwacker, 2018-05-27:
We noticed that on the BDot power domain, both bus voltage and current would spike to zero in brief bursts at the same time that dist would report some (likely all) of power domains were low.  Reset counts on boards are also quite high, but do not appear to increment when the power domains "flicker".

nkwacker, 2018-06-22:
No that aggLib appears to be working in the long term, it is apparent that the measured voltage on dist does not spike down that low.  More likely the uart packet was somehow mangled

Closed 2018-06-22.

Thread 194 (2018-06-03):

FSW is filtering out too much CAN

djdupre, 2018-06-03:
FSW (aka MPC) isn't getting any of the CAN packets it needs. I've tested it with `CAN_ID_SENSORPROC_MAG`, `CAN_ID_MTQ_ACK`, and `CAN_ID_ESTIM_STATE`. I get the packets when I use `canWrapInit` instead of `canWrapInitWithFilter`.

emorye, 2018-06-03:
which of

cat_none
cat_brd
cat_pwr
cat_cfg
cat_cmd
cat_sensor
cat_rw
cat_adcs
cat_comm2
cat_health

does it need to receive?

djdupre, 2018-06-03:
Which ones do I need to get the three signals I listed?

djdupre, 2018-06-03:
Nevermind it's cat_adcs and cat_sensor.

emorye, 2018-06-03:
cat_sensor and cat_adcs, do you want me to add those?

djdupre, 2018-06-03:
Yes

djdupre, 2018-06-03:
Fixed by 758d428a54a5c3c49dd2cf5f160972c19cb3bfd4

Closed 2018-06-03.

Thread 197 (2018-06-09):

Phantom CAN

nkwacker, 2018-06-09:
When running rollcall at 1.25Hz, after powering off flatsat, COSMOS still seems to get data from `CAN_LOCAL` for a while.  The issue does not appear to be happening with rollcall at 0.17 Hz.

nkwacker, 2018-06-15:
We noticed the issue over uart as well as CAN.  While in the powered off state we also noticed COSMOS would show that uart targets could be disconnected and reconnected.  Reloading the COSMOS config also does not stop the inflow of data.

nkwacker, 2019-04-01:
COSMOS appears to have an issue with large amounts of data.  When rollcall runs every 2 seconds and all power domains are on, COSMOS no longer shows data coming in, likely due to the data flood from the PEAK interface.  We might be able to simply avoid the issue, but it would be good to know exactly what's going on.

Thread 202 (2018-06-14):

Averages eventually become 0xFFFF

nkwacker, 2018-06-14:
Pretty self-explanatory.  The mins and maxes seem to be reasonable, but the average does not fall between them.

nkwacker, 2018-06-19:
Reopened because the issue is still happening, specifically on dist board for all currents, COM1 voltage average, and Estim voltage average.  It is also interesting to note that these averages do not fall between their respective mins and maxes, which are still quite reasonable

nkwacker, 2018-06-19:
Bdot also seems to have the same problem for its magnetometer aggregates

nkwacker, 2018-06-19:
For Bdot this behavior makes a lot of sense, as it only was happening during SPAM.  Likely something similar is going on on dist

nkwacker, 2018-06-21:
This issue is also happening with all averages on batt

Closed 2018-06-22.

Thread 212 (2018-06-26):

Dist reboots twice

nkwacker, 2018-06-26:
Whenever the dist board starts up, it reboots once before entering normal operation

nkwacker, 2018-07-05:
The issue arises from trying to power the INA.  Paul is working on a hardware fix

nkwacker, 2018-07-09:
Adding a series resistor to the INA enable line seems to have fixed the issue

Closed 2018-07-09.

Thread 213 (2018-06-30):

Estim magnetic field is always NaN

djdupre, 2018-06-30:
The `mag_eci_unit` output is consistently NaN for all axes. Taylor told this can happen in env_estim when the TLE year falls outside a valid range, but I'm now using a 2018 TLE (copied from the [SWISSCUBE TLE in the uw_hs1_adcs repo](https://github.com/tpreynolds/uw_hs1_adcs/blob/develop/adcs/sw/components/adcs_fsw/matlab/test/sgp4-test/SWISSCUBE/SWISSCUBE.tle)) and it's still NaN.

This issue is meant to replace the "NaN BAD" sticky note.

Thread 218 (2018-07-12):

DIst turns off all power domains overnight

nkwacker, 2018-07-12:
every morning when I get in, all power domains are set to OFF_MANUAL

nkwacker, 2019-04-01:
No longer observed

Closed 2019-04-01.

Thread 221 (2018-07-21):

IMU byte endianness does not match datasheet

djdupre, 2018-07-21:
The IMU was sending terrible data (-140 deg/s on the X axis) until I flipped the byte order in 6b49b6d96c59c9420dff5e7dab85c8260e58f0a7. I tilted the flatsat on each axis and the readings are much more reasonable.

The weird part is that the datasheet says the default is "LSB @ the lower address" (little-endian), but the working code now uses the MSB at the lower address:

```C
idata.rawGyroX = (int16_t)(i2cBuff[1] | ((uint16_t)i2cBuff[0] << 8));
```

Thread 224 (2019-04-01):

Power domains tripping overcurrent while off

nkwacker, 2019-04-01:
Thought I fixed this issue with fc6614abfc0b912fb40a81f98d928093b6f8d127, but I'm still observing the behavior as of 5706647fcb874688426d97d97aae4c59f225e9df.

nkwacker, 2019-04-16:
The current spikes are not reported over backchannel, so the issue is likely in software.
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
Note here how CAN (top) reports a minimum current of ~5.2A, but the backchannel readings (bottom) stay between -0.5mA and 0.5mA.

nkwacker, 2019-05-17:
Can't replicate.  Likely resolved in fc6614abfc0b912fb40a81f98d928093b6f8d127 with https://github.com/UWCubeSat/DubSat1/blob/fc6614abfc0b912fb40a81f98d928093b6f8d127/src/ssmods/ss_EPS_Dist/eps_dist_main.c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

and the issue persisted through bad control of which code was flashed

Closed 2019-05-17.

Thread 225 (2019-04-01):

Batt board gets into a weird I2C state

nkwacker, 2019-04-01:
Batt board reports only the same 2 or 3 hex values for readings over I2C.  The issue can be fixed inconsistently through a restart, but happens after in indeterminate amount of time running.

nkwacker, 2019-04-21:
Could not replicate the issue by a continuous run of one week, so switched to cycling the power every 8 seconds (the maximum that we could achieve on orbit)

nkwacker, 2019-04-21:
Was able to observe the state both instantaneously
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
and over the course of a few restarts.
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

Both graphs have one read per cycle

nkwacker, 2019-05-01:
When the batt board is in the state, there is no I2C activity

nkwacker, 2019-05-02:
After cycling from a bad state, the i2c bus goes through a series of NAKs and ACKs before finally resuming normal operation.   This behavior is not present when cycling from a normal to a normal state.
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

nkwacker, 2019-05-09:
I can consistently replicate the issue by setting the reset bit of `UCBxCTLW0` high before a read or write, leaving I2C in a "reset state".  I suspect that this was causing the issue, as initializing the I2C library left this bit high, which I changed in 90d33a5e3f8834fd59290c174e1c4019464f60c4.  Before the change, the library would enter `i2cCoreRead()` with the reset bit high, but then it would be set low when initializing autostop. https://github.com/UWCubeSat/DubSat1/blob/90d33a5e3f8834fd59290c174e1c4019464f60c4/src/dsbase/core/i2c.c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
Note that `i2cEnable(bus);` is the line where reset is set low.

I suspect this is also the issue that caused `i2cMasterCombinedWriteRead()` to break since it does not initialize autostop, though there is no time to test if that is the case.

I am running another continuous-cycling test (the same one I used above) and if there is no error in ~36 hours I will close this issue

nkwacker, 2019-05-10:
The failure is still happening, but hopefully I can use my earlier findings to more easily diagnose and solve what is going on

nkwacker, 2019-05-14:
The bus hanging state seems to resolve itself after the SDA line is manually grabbed and pulled high, then control returned to the USCI.  I added this workaround before the registers are initialized in `bspI2CInit()` and it seems to be able to consistently recover a bus from a bad state.  (62bb41742adf6121998e332782f418570e0e68ec)

As before, I will run this new code on batt board overnight, then close this issue if there are no errors.

nkwacker, 2019-05-16:
That seems to have done it

Closed 2019-05-16.

Thread 226 (2019-04-13):

Camera Permanent Shutoff

nkwacker, 2019-04-13:
For legal reasons, we need to implement a command to permanently disable the camera

nkwacker, 2019-05-06:
No longer necessary

Closed 2019-05-06.

Thread 227 (2019-04-14):

Dist Readings pegged high after extended poweroff

nkwacker, 2019-04-14:
After towersat has been powered down for an extended period of time (over a day or so), strange behavior surrounding I2C emerges.  In this instance, it was all currents reporting ~(-5.5)A and all voltages reporting ~20.5V.  The exact time to replicate still needs to be ascertained.

nkwacker, 2019-05-17:
It appears that the fix to #225 also works for dist board as well, but I will also add the ability to manually reset i2c

nkwacker, 2019-05-20:
Could not replicate the issue through several tests of powering the satellite off overnight.  Likely fixed in the same way as #225.

Closed 2019-05-20.

Thread 228 (2019-04-14):

Duplicate WOD Data in Health

nkwacker, 2019-04-14:
For testing purposes, we need to assure that all signals present in WOD data are also present in health and that the averages and variances are over the same duration (reset after both are sent).

nkwacker, 2019-04-22:
Duplicated data from the battery and distribution boards.  Average solar panel power is currently only present in in WOD, but WOD blocking was implemented in UWCubeSat/DS1Ops@3f37bfe809f34a9a5cc26e5a4ecc75dc76c7905d

Closed 2019-04-22.
