UWCubeSat/DubSat1/teams/power/Battery Board/Battery Holder/threaded_insert_hex_4-40_92398A112.PDF

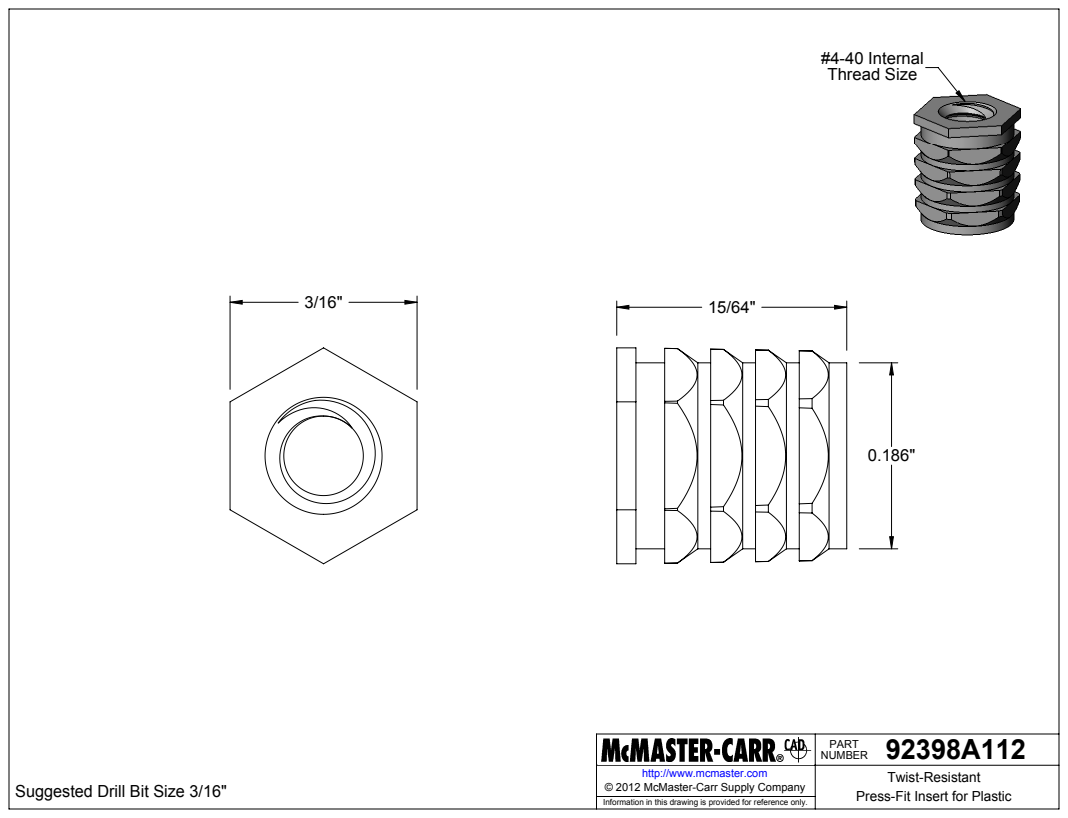
[picture p66: page 1]
#4-40 Internal Thread Size; Suggested Drill Bit Size 3/16"; Press-Fit Insert for Plastic © 2012 McMaster-Carr Supply Company

92398A112 PART NUMBER

http://www.mcmaster.com | Twist-Resistant

Information in this drawing is provided for reference only.
