UWCubeSat/DubSat1/teams/power/Gen Board/Gen Board V4/Documentation/PwrGenBrd_v4.pdf

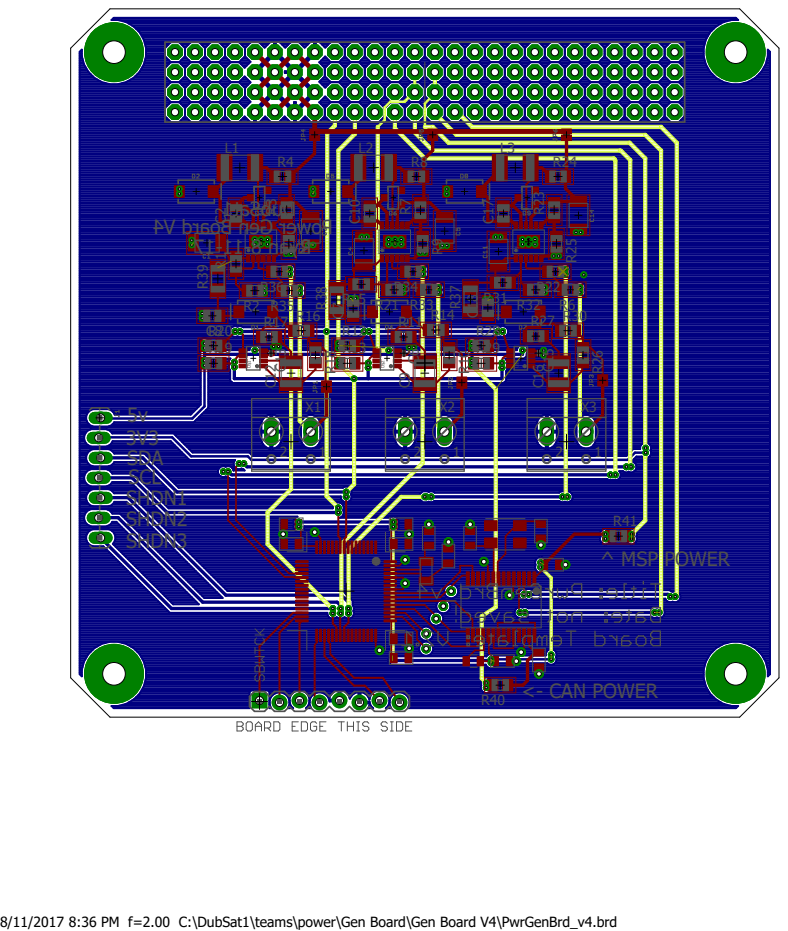
[picture p67: page 1]

8/11/2017 8:36 PM f=2.00 C:\DubSat1\teams\power\Gen Board\Gen Board V4\PwrGenBrd_v4.brd
