UWCubeSat/DubSat1/teams/power/Battery Board/Battery Board V5/Battery Board V5 back.pdf

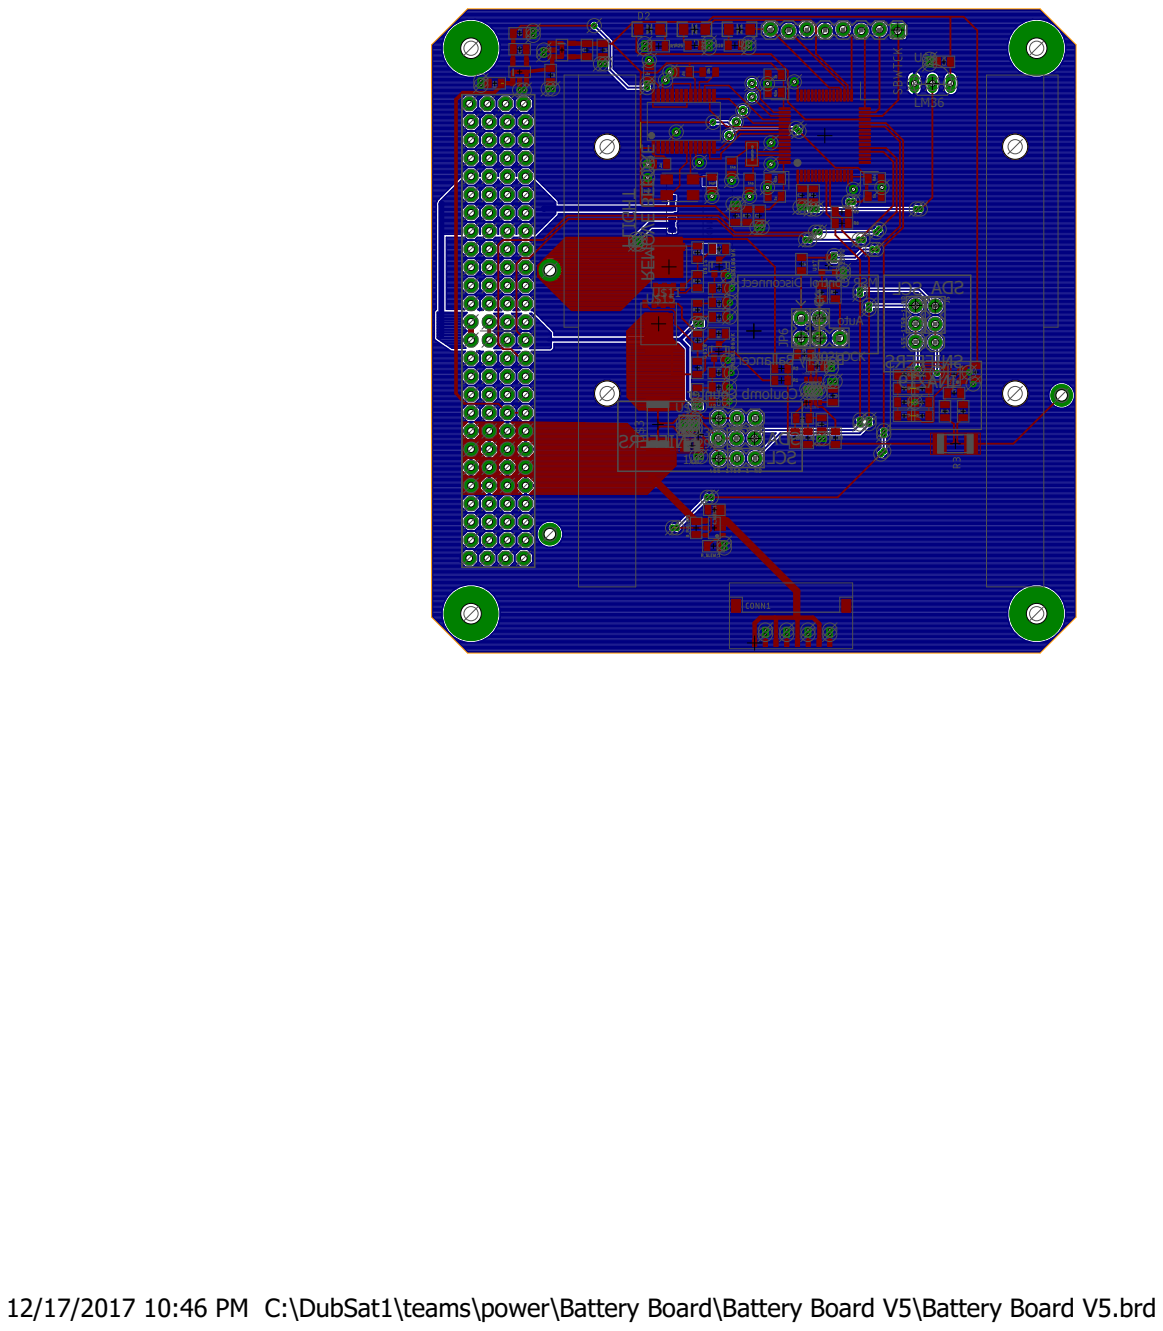
[picture p68: page 1]

12/17/2017 10:46 PM C:\DubSat1\teams\power\Battery Board\Battery Board V5\Battery Board V5.brd
