UWCubeSat/DubSat1/teams/power/Battery Board/Battery Board V5/Battery Board V5.pdf

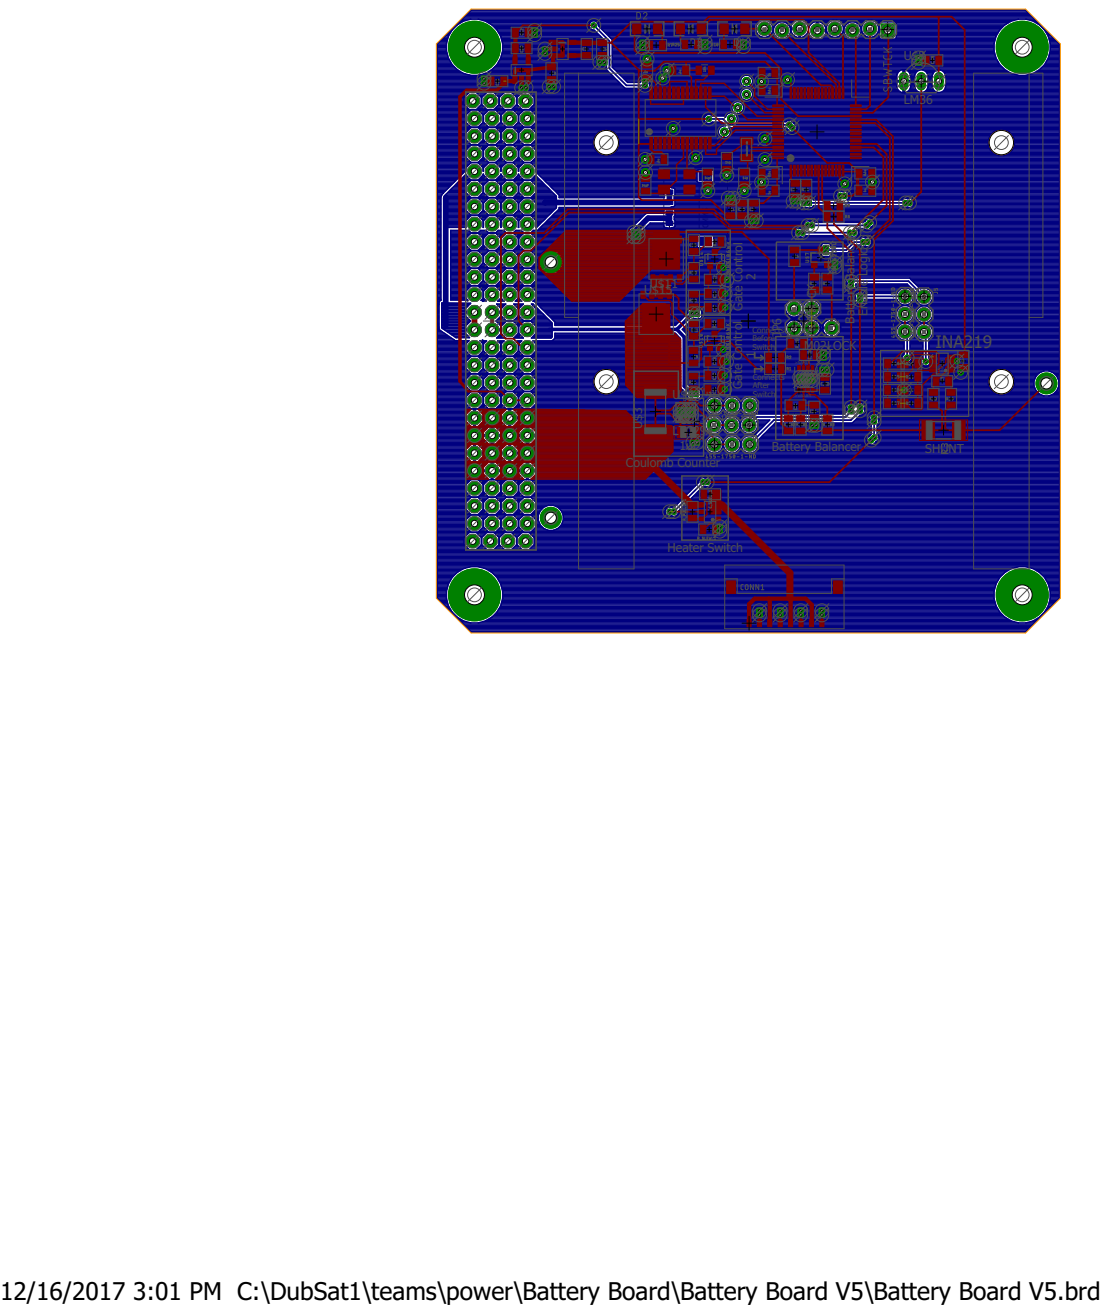
[picture p69: page 1]

Battery Balancer Enable Logic

Gate Control 2 Gate Control 1

>VALUES M02LOCK M02LOCK
Connects Before Switch Connects After Switch

12/16/2017 3:01 PM C:\DubSat1\teams\power\Battery Board\Battery Board V5\Battery Board V5.brd
