UWCubeSat/DubSat1/teams/propulsion/flight/charger/ppt_full_charger_f1.brd

## EAGLE design teams/propulsion/flight/charger/ppt_full_charger_f1.brd (2019-07-06)

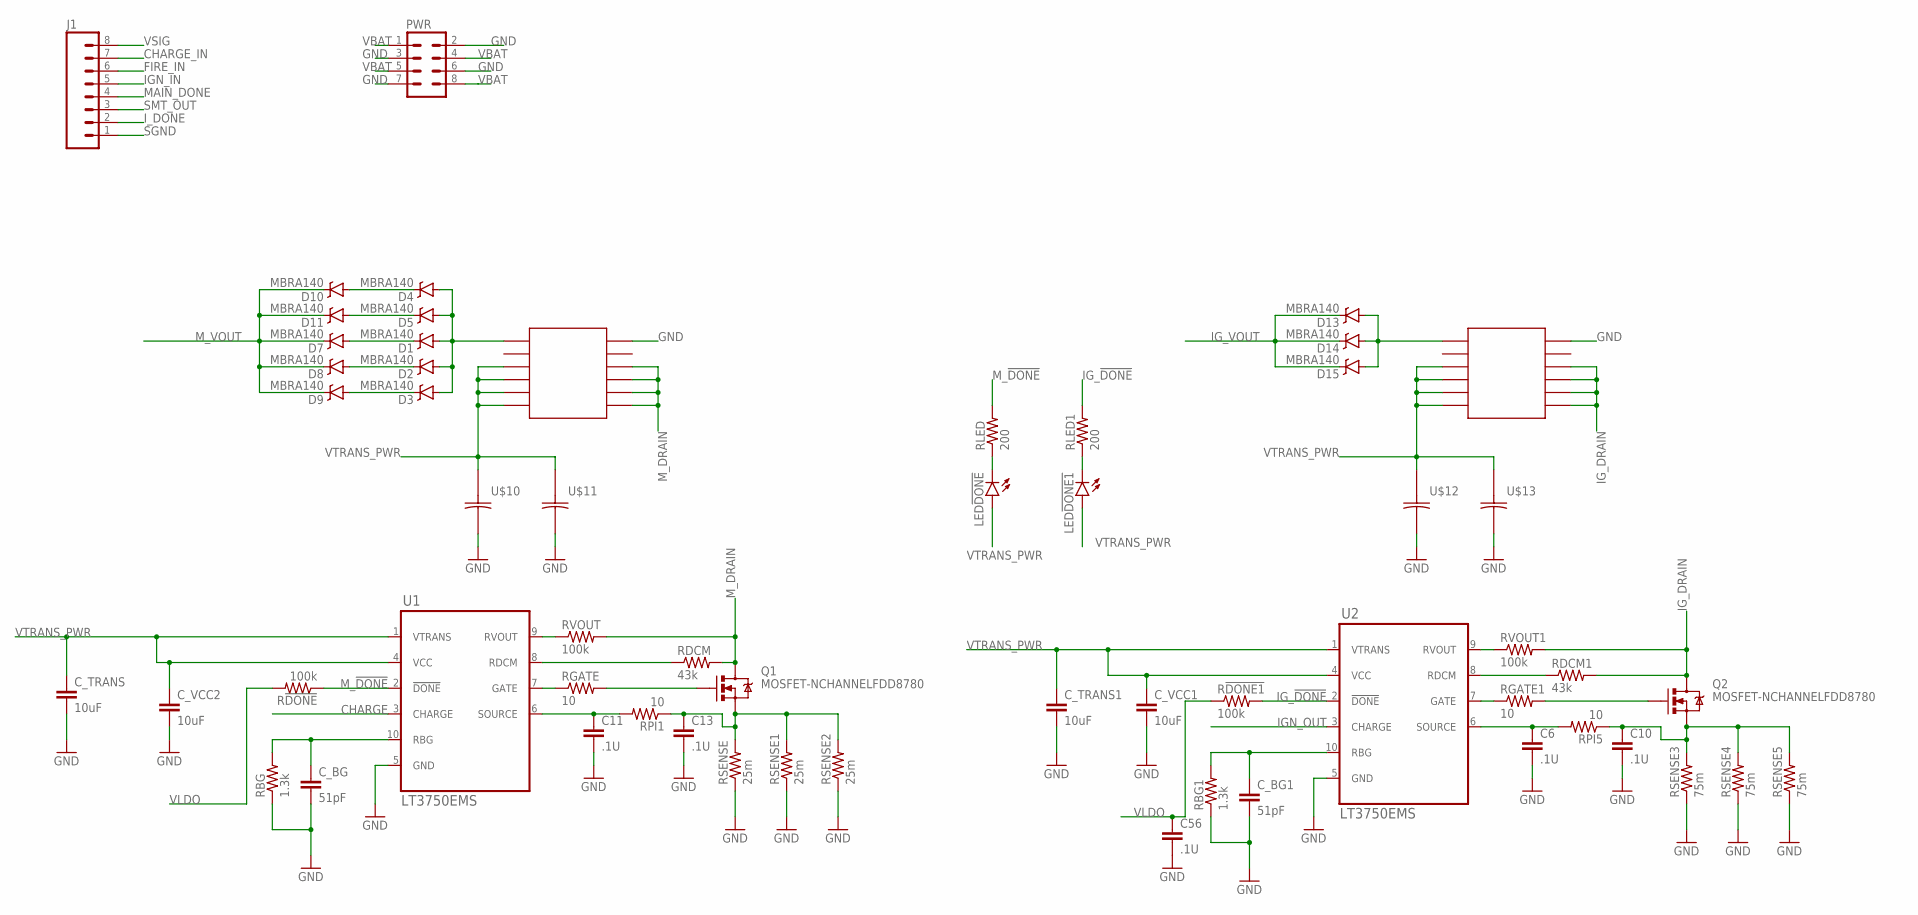
[picture p70: schematic ppt_full_charger_f1.sch, sheet 1]

Parts:
C6, C10, C11, C13, C56: .1U; 0805
C_BG, C_BG1: 51pF; 0805
C_TRANS, C_TRANS1: 10uF; 0805
C_VCC1, C_VCC2: 10uF; 0805
D1, D2, D3, D4, D5, D7, D8, D9, D10, D11, D13, D14, D15: MBRA140; SMA-DIODE
J1: M08; 1X08_ROUND
LED!DONE, LED!DONE1: LED1206; LED-1206
PWR: M04X2; 2X4
Q1, Q2: MOSFET-NCHANNELFDD8780; DPAK
R!DONE, R!DONE1: 100k; 0805
RBG, RBG1: 1.3k; 0805
RDCM, RDCM1: 43k; 0805
RGATE, RGATE1: 10; 0805
RLED, RLED1: 200; 0805
RPI1, RPI5: 10; 0805
RSENSE, RSENSE1, RSENSE2: 25m; 1206
RSENSE3, RSENSE4, RSENSE5: 75m; 1206
RVOUT, RVOUT1: 100k; 0805
U1, U2: LT3750EMS; MSOP10
U$1: COILCRAFT_DA2034; DA2034
U$2: COILCRAFT_DA2033; DA2033
U$10, U$11, U$12, U$13: PANASONIC_16SVPG270M; PANASONIC_SVPG

Connections:
7: RGATE1.1, U2.7 (GATE)
8: RDCM1.1, U2.8 (RDCM)
9: RVOUT1.1, U2.9 (RVOUT)
CHARGE: U1.3 (CHARGE); also elsewhere on the board
CHARGE_IN: J1.7; also elsewhere on the board
FIRE_IN: J1.6; also elsewhere on the board
GND: C6.2, C10.2, C11.2, C13.2, C56.2, C_BG.2, C_BG1.2, C_TRANS.2, C_TRANS1.2, C_VCC1.2, C_VCC2.2, PWR.2, PWR.3, PWR.6, PWR.7, RBG.1, RBG1.1, RSENSE.1, RSENSE1.1, RSENSE2.1, RSENSE3.1, RSENSE4.1, RSENSE5.1, U1.5 (GND), U2.5 (GND), U$1.P$12, U$2.P$12, U$10.NEG, U$11.NEG, U$12.NEG, U$13.NEG; also elsewhere on the board
IGN_IN: J1.5; also elsewhere on the board
IGN_OUT: U2.3 (CHARGE); also elsewhere on the board
IG_!DONE: R!DONE1.2, RLED1.2, U2.2 (!DONE); also elsewhere on the board
IG_BG: C_BG1.1, RBG1.2, U2.10 (RBG)
IG_DRAIN: Q2.4 (D), RDCM1.2, RVOUT1.2, U$2.P$7, U$2.P$8, U$2.P$9, U$2.P$10
IG_GATE: Q2.1 (G), RGATE1.2
IG_SENSE: C10.1, Q2.3 (S), RPI5.1, RSENSE3.2, RSENSE4.2, RSENSE5.2
IG_VOUT: D13.C, D14.C, D15.C; also elsewhere on the board
I_DONE: J1.2; also elsewhere on the board
MAIN_DONE: J1.4; also elsewhere on the board
M_!DONE: R!DONE.1, RLED.2, U1.2 (!DONE); also elsewhere on the board
M_BG: C_BG.1, RBG.2, U1.10 (RBG)
M_DRAIN: Q1.4 (D), RDCM.2, RVOUT.2, U$1.P$7, U$1.P$8, U$1.P$9, U$1.P$10
M_GATE: Q1.1 (G), RGATE.2
M_SCHMITT: J1.2
M_SENSE: C13.1, Q1.3 (S), RPI1.1, RSENSE.2, RSENSE1.2, RSENSE2.2
M_VOUT: D7.C, D8.C, D9.C, D10.C, D11.C; also elsewhere on the board
unnamed: C6.1, RPI5.2, U2.6 (SOURCE)
unnamed: RVOUT.1, U1.9 (RVOUT)
unnamed: D4.C, D10.A
unnamed: RDCM.1, U1.8 (RDCM)
unnamed: RGATE.1, U1.7 (GATE)
unnamed: D5.C, D11.A
unnamed: D1.C, D7.A
unnamed: D2.C, D8.A
unnamed: D3.C, D9.A
unnamed: LED!DONE.C, RLED.1
unnamed: LED!DONE1.C, RLED1.1
unnamed: D1.A, D2.A, D3.A, D4.A, D5.A, U$1.P$1
unnamed: C11.1, RPI1.2, U1.6 (SOURCE)
unnamed: D13.A, D14.A, D15.A, U$2.P$1
SGND: J1.1; also elsewhere on the board
SMT_OUT: J1.3; also elsewhere on the board
VBAT: PWR.1, PWR.4, PWR.5, PWR.8; also elsewhere on the board
VLDO: C56.1, R!DONE.2, R!DONE1.1; also elsewhere on the board
VSIG: J1.8; also elsewhere on the board
VTRANS_PWR: C_TRANS.1, C_TRANS1.1, C_VCC1.1, C_VCC2.1, LED!DONE.A, LED!DONE1.A, U1.1 (VTRANS), U1.4 (VCC), U2.1 (VTRANS), U2.4 (VCC), U$1.P$3, U$1.P$4, U$1.P$5, U$1.P$6, U$2.P$3, U$2.P$4, U$2.P$5, U$2.P$6, U$10.POS, U$11.POS, U$12.POS, U$13.POS; also elsewhere on the board

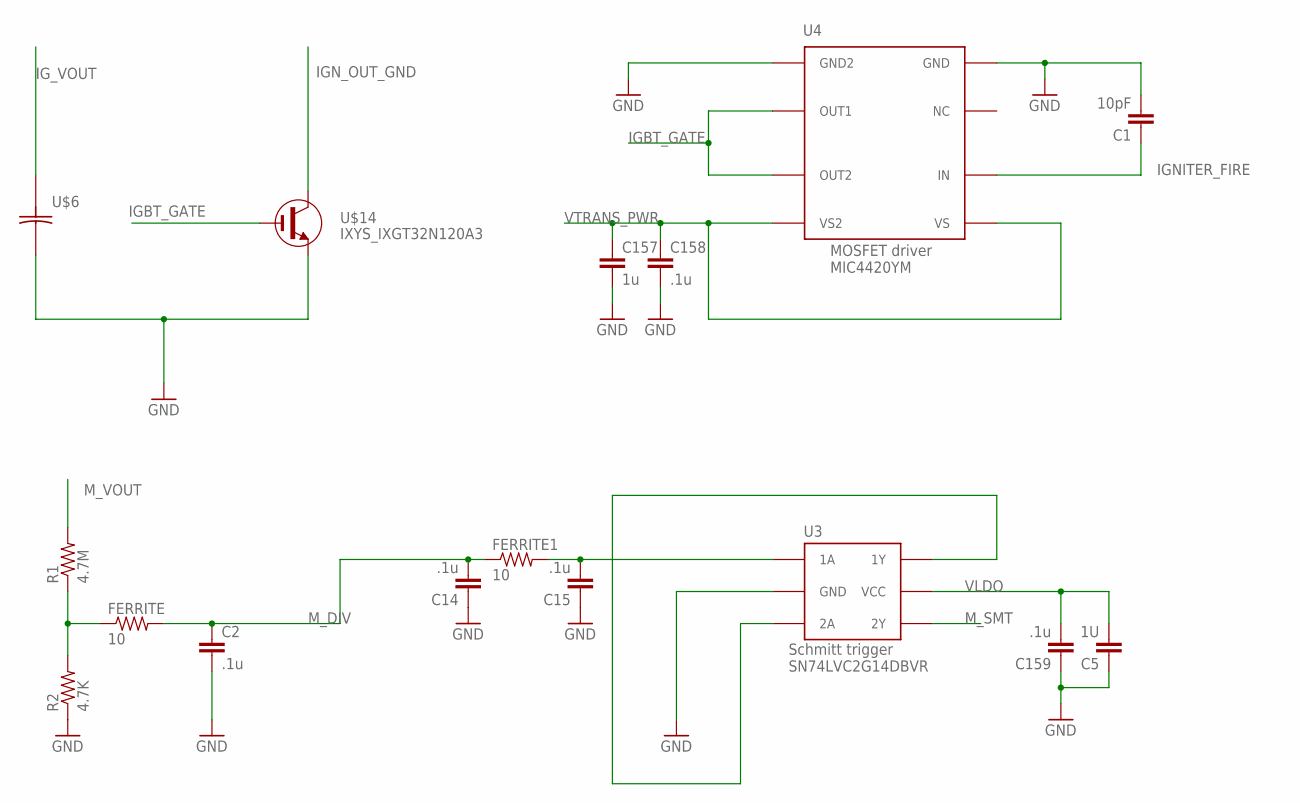
[picture p71: schematic ppt_full_charger_f1.sch, sheet 2]

Parts:
C1: 10pF; 0805
C2, C14, C15, C158, C159: .1u; 0805
C5: 1U; 0805
C157: 1u; 0805
FERRITE, FERRITE1: 10; 0805
R1: 4.7M; R2010
R2: 4.7K; R2010
U3: TI_SCHMITTRIGGER_SN74; SOT-23-6
U4: MICREL_MOSFETDRIVER_MIC4420; 8-SOIC
U$6: KEMET_LDEQH3100KA5N00; KEMET_F3078
U$14: IXYS_IXGT32N120A3; TO-268

Connections:
GND: C1.2, C2.2, C5.1, C14.1, C15.1, C157.2, C158.2, C159.1, R2.1, U3.P$2 (GND), U4.P$4 (GND), U4.P$5 (GND2), U$6.NEG, U$14.3 (E); also elsewhere on the board
IGBT_GATE: U4.P$6 (OUT1), U4.P$7 (OUT2), U$14.1 (G)
IGNITER_FIRE: C1.1, U4.P$2 (IN); also elsewhere on the board
IGN_OUT_GND: U$14.2 (C)
IG_VOUT: U$6.POS; also elsewhere on the board
M_DIV: C2.1, C14.2, FERRITE.2, FERRITE1.1
M_SMT: U3.P$4 (2Y); also elsewhere on the board
M_VOUT: R1.2; also elsewhere on the board
unnamed: U3.P$3 (2A), U3.P$6 (1Y)
unnamed: C15.2, FERRITE1.2, U3.P$1 (1A)
unnamed: FERRITE.1, R1.1, R2.2
VLDO: C5.2, C159.2, U3.P$5 (VCC); also elsewhere on the board
VTRANS_PWR: C157.1, C158.1, U4.P$1 (VS), U4.P$8 (VS2); also elsewhere on the board

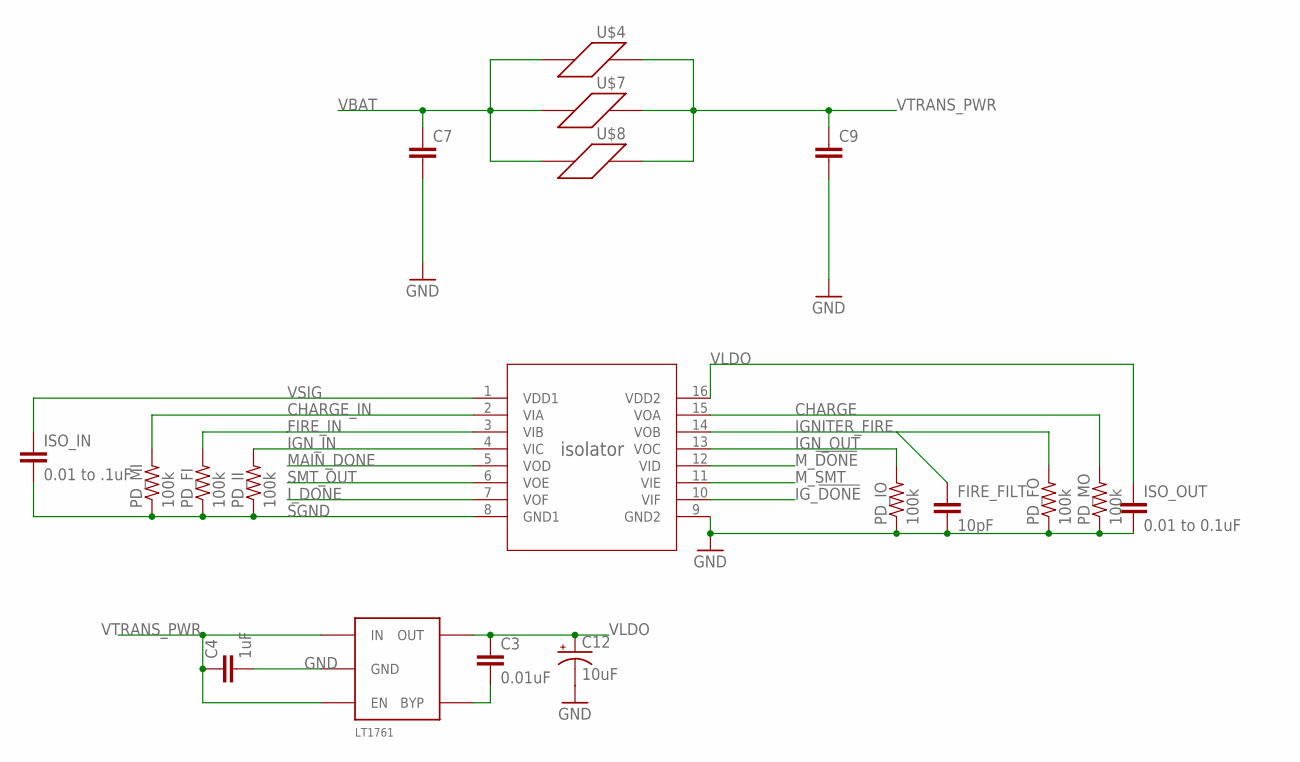
[picture p72: schematic ppt_full_charger_f1.sch, sheet 3]

Parts:
ADUM163N: ADUM163N1BRZ; R_16
C3: 0.01uF; 0805
C4: 1uF; 0805
C7, C9: CAP0805; 0805
C12: 10uF; EIA3216
FIRE_FILT: 10pF; 0805
ISO_IN: 0.01 to .1uF; 0805
ISO_OUT: 0.01 to 0.1uF; 0805
LDO: LINEAR_LDO_LT1761-X; SOT-23-5
PD_FI: 100k; 0805
PD_FO: 100k; 0805
PD_II: 100k; 0805
PD_IO: 100k; 0805
PD_MI: 100k; 0805
PD_MO: 100k; 0805
U$4: B.L1_FBMJ2125HS420-T; 0805
U$7: B.L2_FBMH1608HL121-T; 0603
U$8: I.L1_587-3855-1-ND; 1206

Connections:
CHARGE: ADUM163N.15 (VOA), PD_MO.2; also elsewhere on the board
CHARGE_IN: ADUM163N.2 (VIA), PD_MI.2; also elsewhere on the board
FIRE_IN: ADUM163N.3 (VIB), PD_FI.2; also elsewhere on the board
GND: ADUM163N.9 (GND2), C4.2, C7.2, C9.2, C12.C (-), FIRE_FILT.2, ISO_OUT.2, LDO.P$2 (GND), PD_FO.1, PD_IO.1, PD_MO.1; also elsewhere on the board
IGNITER_FIRE: ADUM163N.14 (VOB), FIRE_FILT.1, PD_FO.2; also elsewhere on the board
IGN_IN: ADUM163N.4 (VIC), PD_II.2; also elsewhere on the board
IGN_OUT: ADUM163N.13 (VOC), PD_IO.2; also elsewhere on the board
IG_!DONE: ADUM163N.10 (VIF); also elsewhere on the board
I_DONE: ADUM163N.7 (VOF); also elsewhere on the board
MAIN_DONE: ADUM163N.5 (VOD); also elsewhere on the board
M_!DONE: ADUM163N.12 (VID); also elsewhere on the board
M_SMT: ADUM163N.11 (VIE); also elsewhere on the board
unnamed: C3.2, LDO.P$4 (BYP)
SGND: ADUM163N.8 (GND1), ISO_IN.2, PD_FI.1, PD_II.1, PD_MI.1; also elsewhere on the board
SMT_OUT: ADUM163N.6 (VOE); also elsewhere on the board
VBAT: C7.1, U$4.1, U$7.1, U$8.1; also elsewhere on the board
VLDO: ADUM163N.16 (VDD2), C3.1, C12.A (+), ISO_OUT.1, LDO.P$5 (OUT); also elsewhere on the board
VSIG: ADUM163N.1 (VDD1), ISO_IN.1; also elsewhere on the board
VTRANS_PWR: C4.1, C9.1, LDO.P$1 (IN), LDO.P$3 (EN), U$4.2, U$7.2, U$8.2; also elsewhere on the board

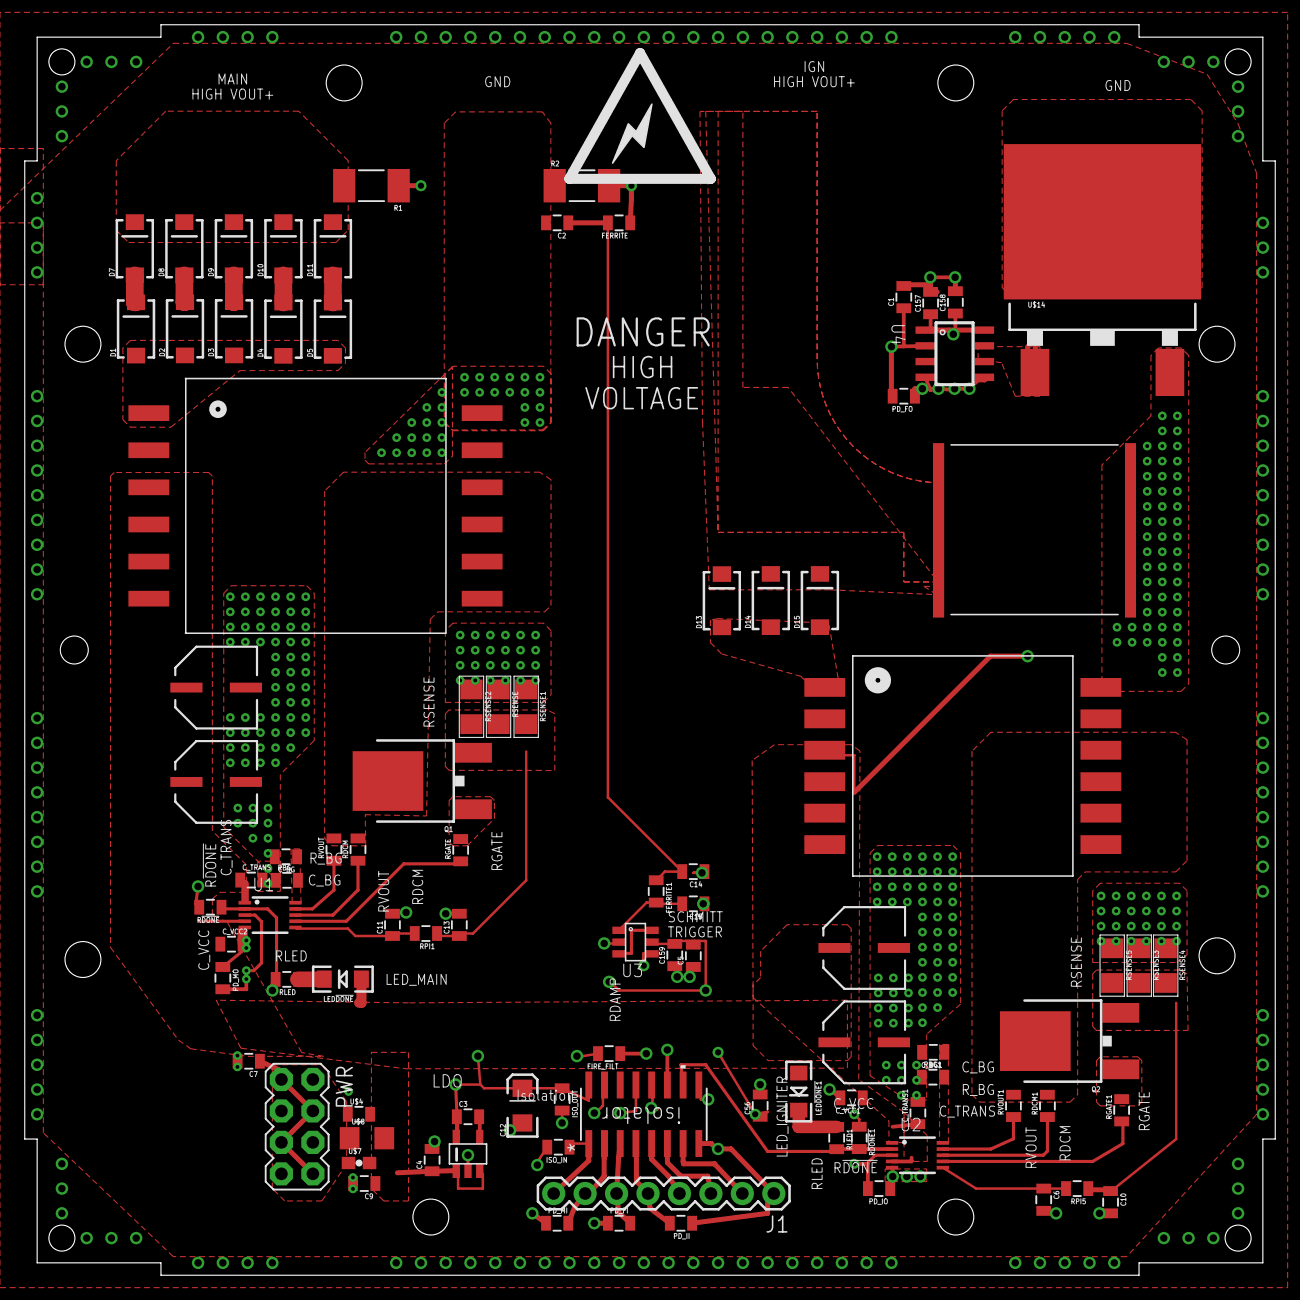
[picture p73: board ppt_full_charger_f1.brd from above]

Board: 4 copper layers, 101.0 x 101.0 mm, 94 parts (0 on the bottom side), 51 nets.

Other parts of the board:
U$3: ICON_BOLT-L
