UWCubeSat/DubSat1/teams/adcs/hardware/flight_model/magnetorquer/magnetorquer_board_f1.brd

## EAGLE design teams/adcs/hardware/flight_model/magnetorquer/magnetorquer_board_f1.brd (2019-07-06)

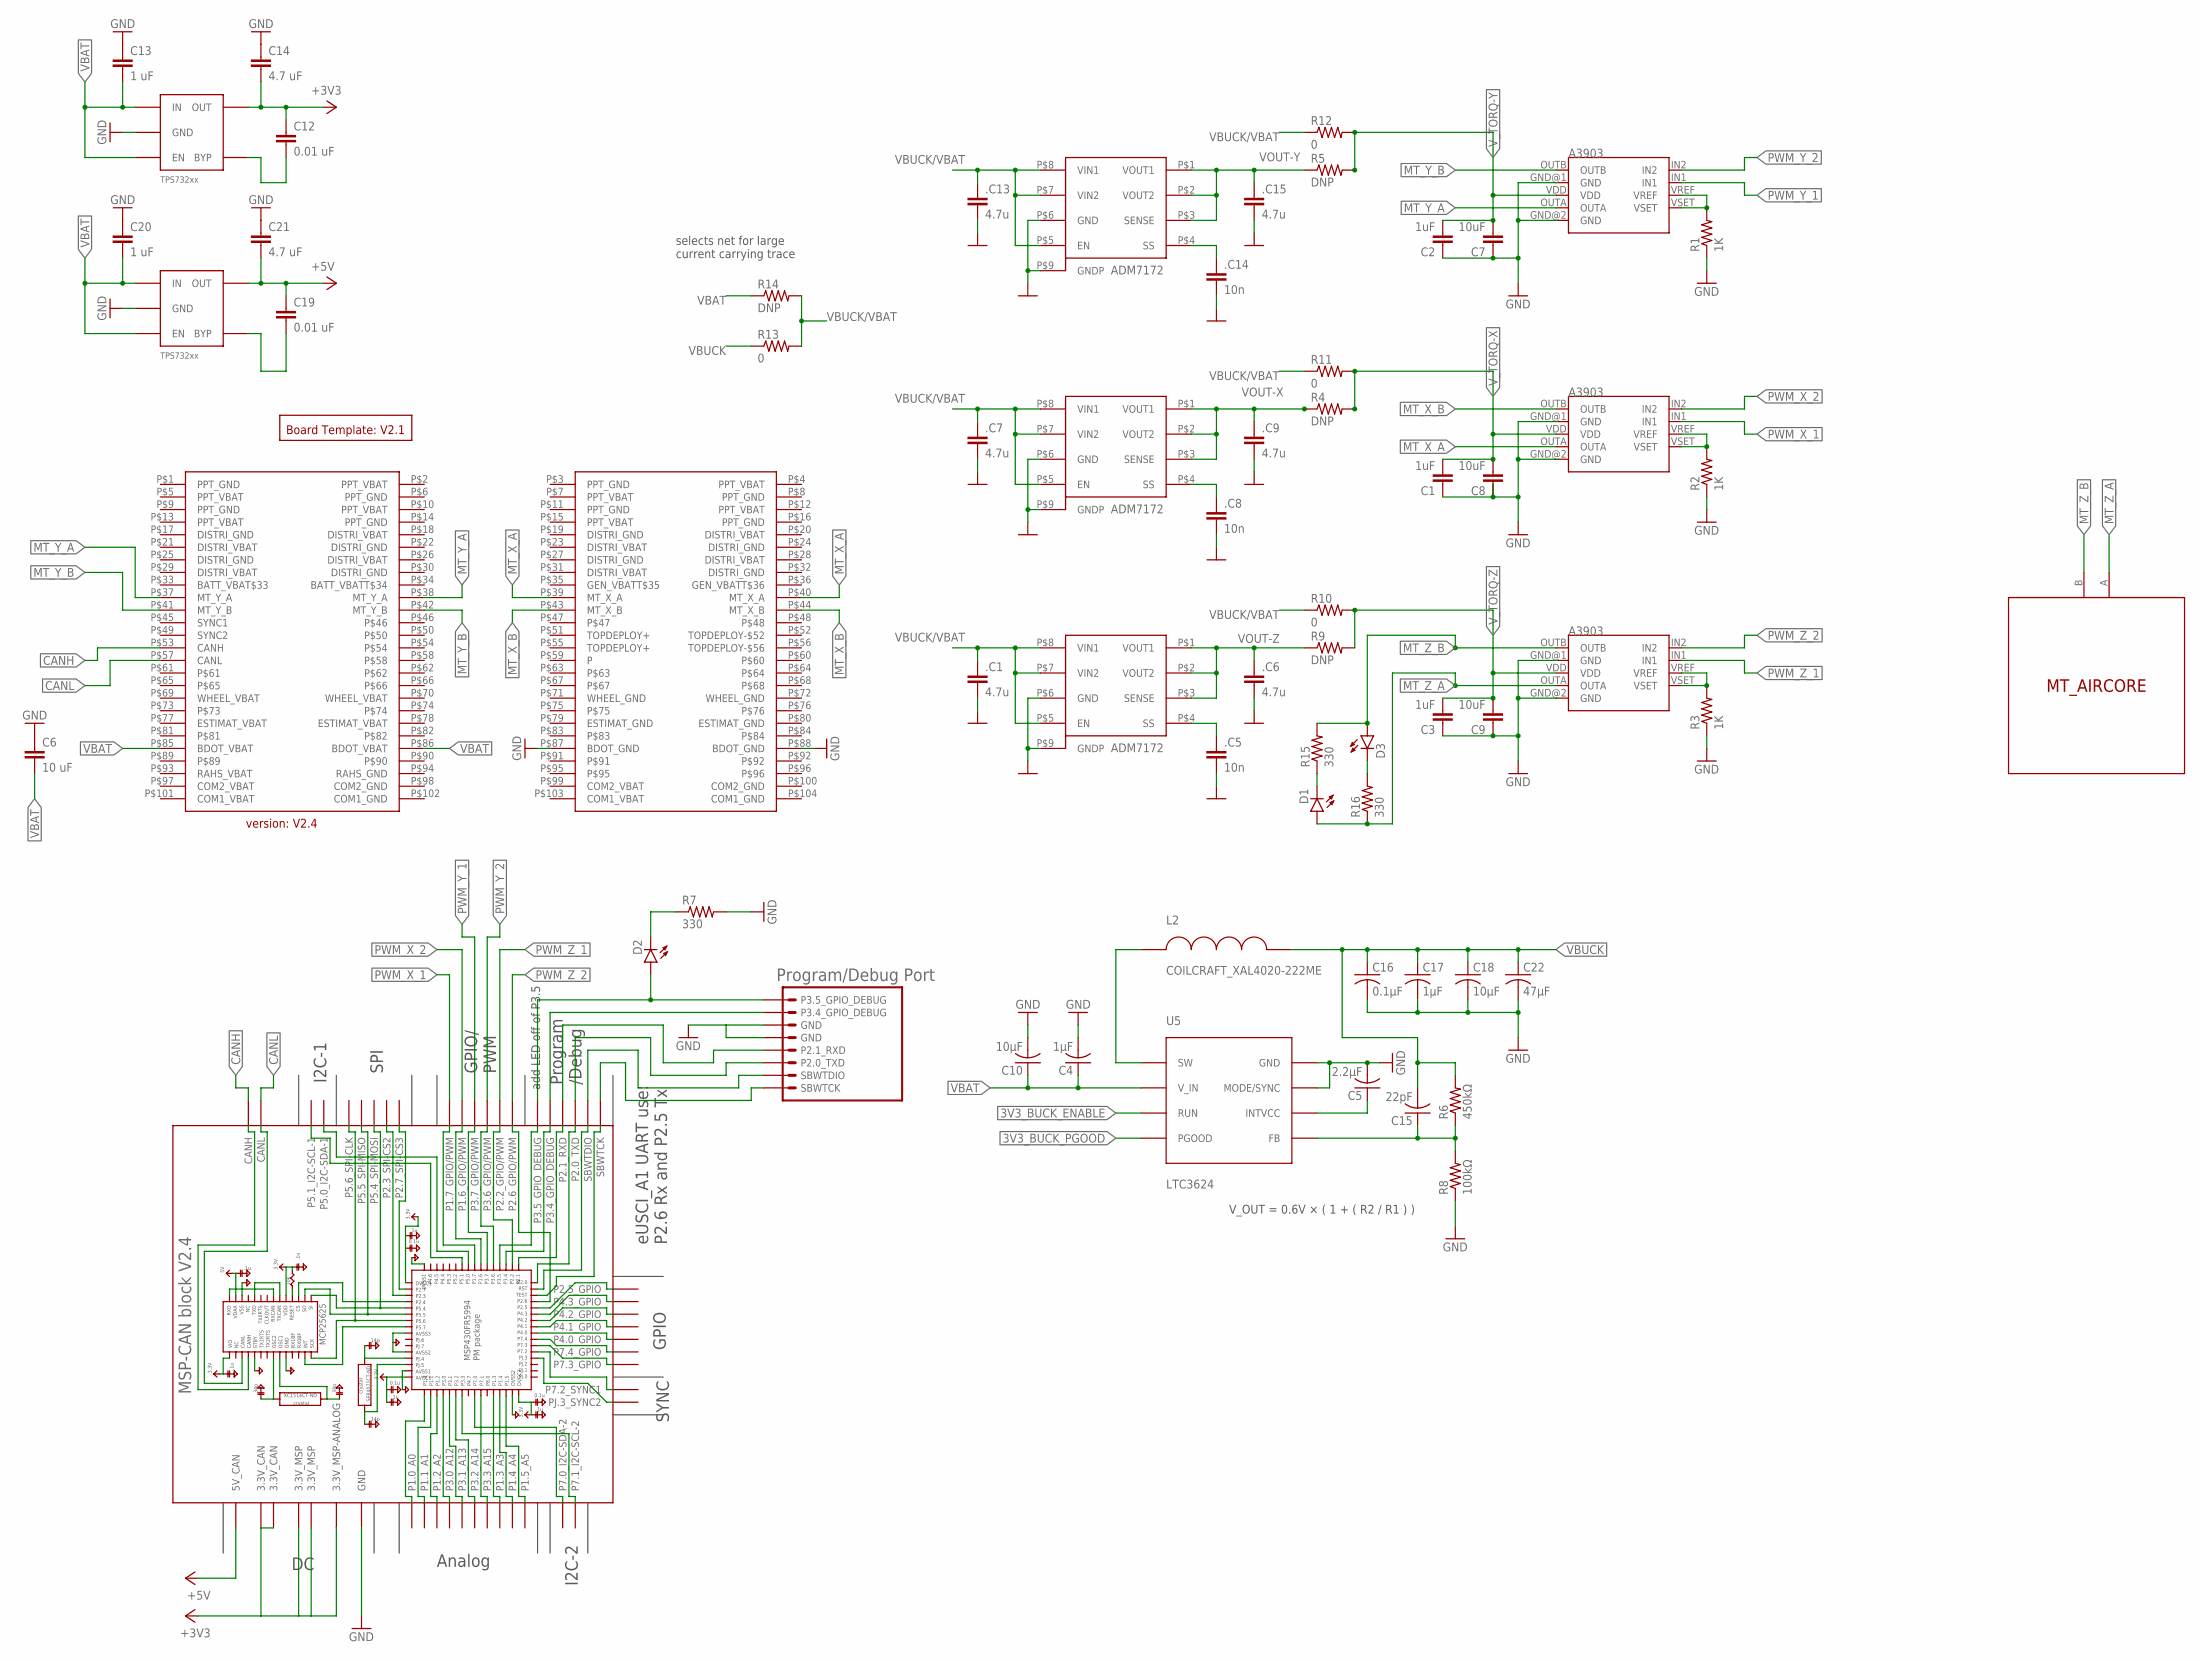
[picture p74: schematic magnetorquer_board_f1.sch]

Parts:
.C1, .C6, .C7, .C9, .C13, .C15: 4.7u; 1206
.C5, .C8, .C14: 10n; 0805
C1, C2, C3: 1uF; 0805
C4, C17: 1µF; C0805
C5: 2.2μF; C0805
C6: 10 uF; 0805
C7, C8, C9: 10uF; 0805
C10, C18: 10µF; C0805
C12, C19: 0.01 uF; 0805
C13, C20: 1 uF; 0805
C14, C21: 4.7 uF; 0805
C15: 22pF; C0805
C16: 0.1µF; C1206
C22: 47µF; C0805
D1, D2, D3: LED; LED-1206
L2: COILCRAFT_XAL4020-222ME; COILCRAFT_XAL4020
LDO_3V1, LDO_5V1: TPS732XX; SOT-23-5
R1, R2, R3: 1K; R0603
R4, R5, R9: DNP; 0805
R6: 450kΩ; R0805
R7, R15, R16: 330; 0805
R8: 100kΩ; R0805
R10, R11, R12: 0; 0805
R13: 0; R2010
R14: DNP; R2010
U1, U2, U3: A3903; DFN-8EE
U5: LTC3624
U$1: PC104_CONNECTOR
U$2: BOARD_TEMPLATE1; BOARD_TEMPLATE
U$3: MT_AIRCORE
U$4, U$5, U$9: ANALOG_LDO_ADM7172; 8-LFCSP
U$7: MSP-CAN_BLOCK
U$8: PROGRAM/DEBUG_PORT; 1X08_CONNECTOR

Connections:
3V3_BUCK_ENABLE: U5.RUN
3V3_BUCK_FB1: C15.1, R6.1, R8.2, U5.FB
3V3_BUCK_INTVCC1: C5.1, U5.INTVCC
3V3_BUCK_PGOOD: U5.PGOOD
3V3_BUCK_SW1: L2.P$1, U5.SW
+3V3: C12.1, C14.2, LDO_3V1.P$5 (OUT), U$7.3.3V@CAN1 (3.3V_CAN), U$7.3.3V@CAN2 (3.3V_CAN), U$7.3.3V@MSP1 (3.3V_MSP), U$7.3.3V@MSP2 (3.3V_MSP), U$7.3.3V_ANALOG@MSP2 (3.3V_MSP-ANALOG)
+5V: C19.1, C21.2, LDO_5V1.P$5 (OUT), U$7.5V (5V_CAN)
CANH: U$1.P$53 (CANH), U$7.CANH
CANL: U$1.P$57 (CANL), U$7.CANL
GND: .C1.2, .C5.2, .C6.2, .C7.2, .C8.2, .C9.2, .C13.2, .C14.2, .C15.2, C1.1, C2.1, C3.1, C4.2, C5.2, C6.1, C7.1, C8.1, C9.1, C10.2, C13.1, C14.1, C16.2, C17.2, C18.2, C20.1, C21.1, C22.2, LDO_3V1.P$2 (GND), LDO_5V1.P$2 (GND), R1.1, R2.1, R3.1, R7.2, R8.1, U1.GND@1 (GND), U1.GND@2 (GND), U2.GND@1 (GND), U2.GND@2 (GND), U3.GND@1 (GND), U3.GND@2 (GND), U5.GND@1 (GND), U5.GND@PAD (GND), U5.MODE/SYNC, U$1.P$87 (BDOT_GND), U$1.P$88 (BDOT_GND), U$4.P$6 (GND), U$4.P$9 (GNDP), U$5.P$6 (GND), U$5.P$9 (GNDP), U$7.GND@1 (GND), U$7.GND@2 (GND), U$7.GND@3 (GND), U$7.GND@4 (GND), U$7.GND@5 (GND), U$7.GND@7 (GND), U$7.GND@8 (GND), U$7.GND@9 (GND), U$7.GND@10 (GND), U$7.GND@11 (GND), U$7.GND@12 (GND), U$7.GND@13 (GND), U$7.GND@14 (GND), U$7.GND@15 (GND), U$7.GND@16 (GND), U$7.GND@17 (GND), U$7.GND@26 (GND), U$8.5 (GND), U$8.6 (GND), U$9.P$6 (GND), U$9.P$9 (GNDP)
MT_X_A: U2.OUTA, U$1.P$39 (MT_X_A), U$1.P$40 (MT_X_A)
MT_X_B: U2.OUTB, U$1.P$43 (MT_X_B), U$1.P$44 (MT_X_B)
MT_Y_A: U1.OUTA, U$1.P$37 (MT_Y_A), U$1.P$38 (MT_Y_A)
MT_Y_B: U1.OUTB, U$1.P$41 (MT_Y_B), U$1.P$42 (MT_Y_B)
MT_Z_A: D1.A, R16.1, U3.OUTA, U$3.A
MT_Z_B: D3.A, R15.2, U3.OUTB, U$3.B
unnamed: R1.2, U1.VREF, U1.VSET
unnamed: R2.2, U2.VREF, U2.VSET
unnamed: D2.C, R7.1
unnamed: C12.2, LDO_3V1.P$4 (BYP)
unnamed: D3.C, R16.2
unnamed: R3.2, U3.VREF, U3.VSET
unnamed: C19.2, LDO_5V1.P$4 (BYP)
unnamed: .C5.1, U$4.P$4 (SS)
unnamed: .C8.1, U$5.P$4 (SS)
unnamed: D1.C, R15.1
unnamed: .C14.1, U$9.P$4 (SS)
unnamed: U$7.SBWTCK, U$8.SBWTCK
unnamed: U$7.SBWTDIO, U$8.2 (SBWTDIO)
unnamed: U$7.P2.0_TXD, U$8.3 (P2.0_TXD)
unnamed: U$7.P2.1_RXD, U$8.4 (P2.1_RXD)
unnamed: U$7.P3.4_GPIO_DEBUG, U$8.7 (P3.4_GPIO_DEBUG)
unnamed: D2.A, U$7.P3.5_GPIO_DEBUG, U$8.8 (P3.5_GPIO_DEBUG)
PWM_X_1: U2.IN1, U$7.P1.7_GPIO/PWM
PWM_X_2: U2.IN2, U$7.P1.6_GPIO/PWM
PWM_Y_1: U1.IN1, U$7.P3.7_GPIO/PWM
PWM_Y_2: U1.IN2, U$7.P3.6_GPIO/PWM
PWM_Z_1: U3.IN1, U$7.P2.2_GPIO/PWM
PWM_Z_2: U3.IN2, U$7.P2.6_GPIO/PWM
VBAT: C4.1, C6.2, C10.1, C13.2, C20.2, LDO_3V1.P$1 (IN), LDO_3V1.P$3 (EN), LDO_5V1.P$1 (IN), LDO_5V1.P$3 (EN), R14.1, U5.V_IN, U$1.P$85 (BDOT_VBAT), U$1.P$86 (BDOT_VBAT)
VBUCK: C15.2, C16.1, C17.1, C18.1, C22.1, L2.P$2, R6.2, R13.1
VBUCK/VBAT: .C1.1, .C7.1, .C13.1, R10.1, R11.1, R12.1, R13.2, R14.2, U$4.P$5 (EN), U$4.P$7 (VIN2), U$4.P$8 (VIN1), U$5.P$5 (EN), U$5.P$7 (VIN2), U$5.P$8 (VIN1), U$9.P$5 (EN), U$9.P$7 (VIN2), U$9.P$8 (VIN1)
VOUT-X: .C9.1, R4.1, U$5.P$1 (VOUT1), U$5.P$2 (VOUT2), U$5.P$3 (SENSE)
VOUT-Y: .C15.1, R5.1, U$9.P$1 (VOUT1), U$9.P$2 (VOUT2), U$9.P$3 (SENSE)
VOUT-Z: .C6.1, R9.1, U$4.P$1 (VOUT1), U$4.P$2 (VOUT2), U$4.P$3 (SENSE)
V_TORQ-X: C1.2, C8.2, R4.2, R11.2, U2.VDD
V_TORQ-Y: C2.2, C7.2, R5.2, R12.2, U1.VDD
V_TORQ-Z: C3.2, C9.2, R9.2, R10.2, U3.VDD

Notes on the sheet:
V_OUT = 0.6V × ( 1 + ( R2 / R1 ) )
selects net for large current carrying trace

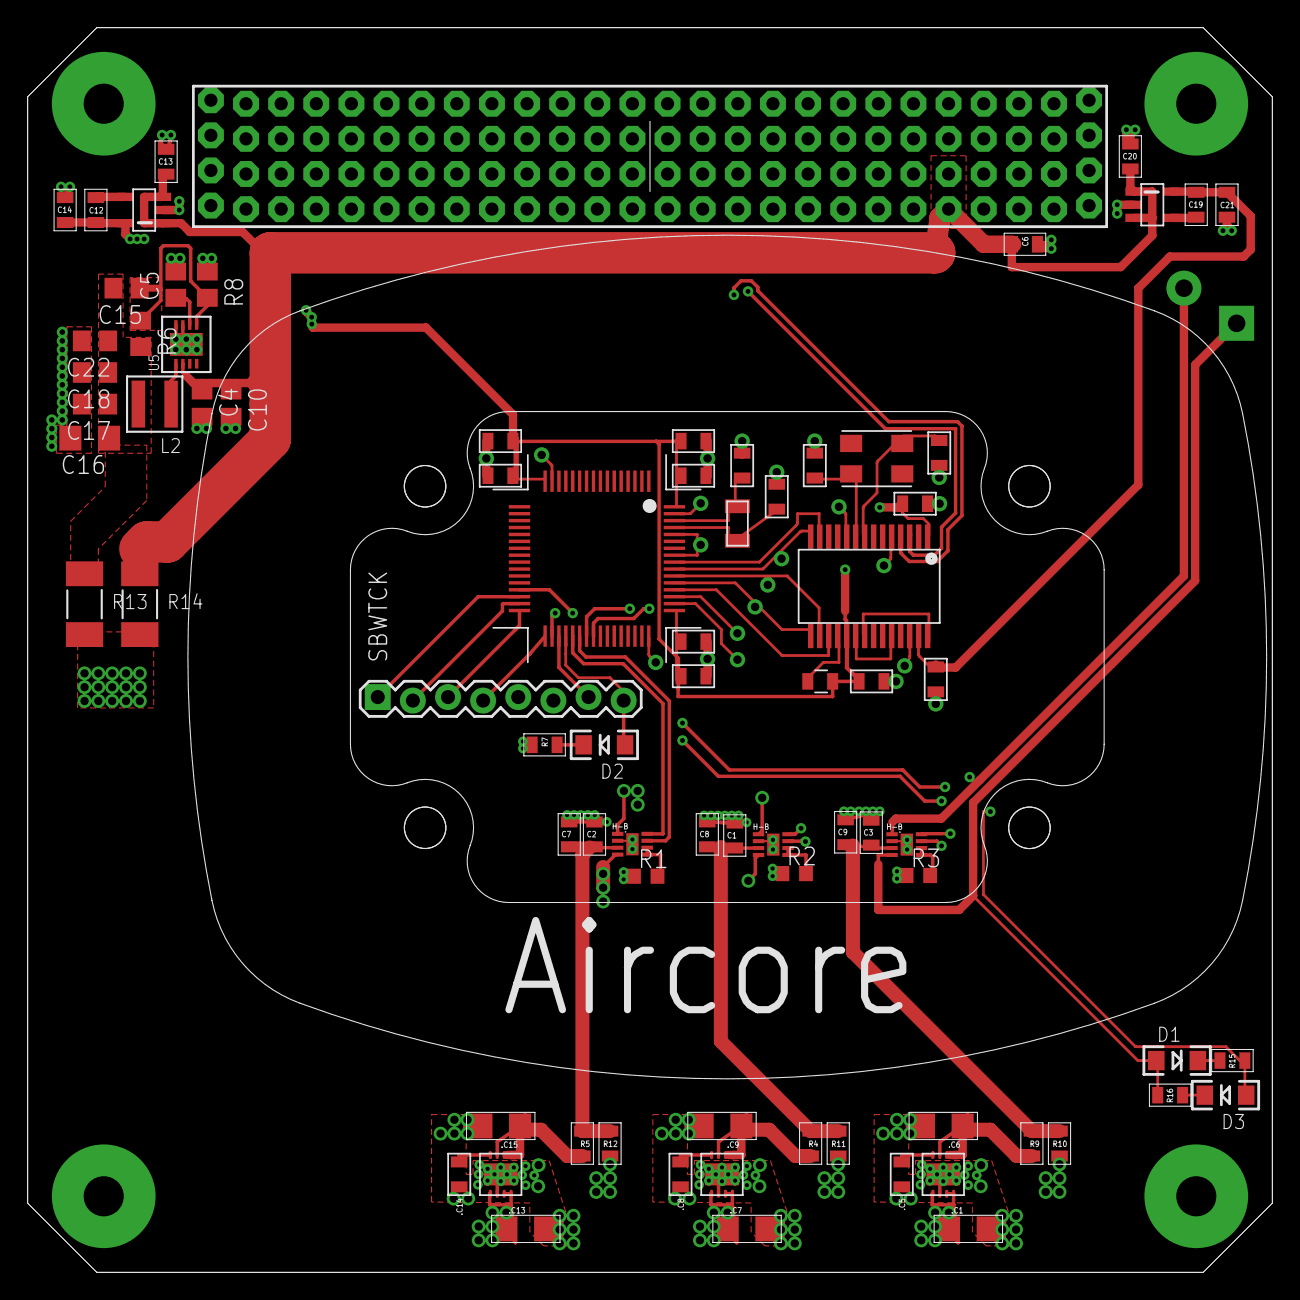
[picture p75: board magnetorquer_board_f1.brd from above]

Board: 4 copper layers, 90.0 x 90.0 mm, 64 parts (0 on the bottom side), 46 nets.
