UWCubeSat/DubSat1/teams/power/Flight/Side Panels/Side_Panel_f1.brd

## EAGLE design teams/power/Flight/Side Panels/Side_Panel_f1.brd (2019-07-06)

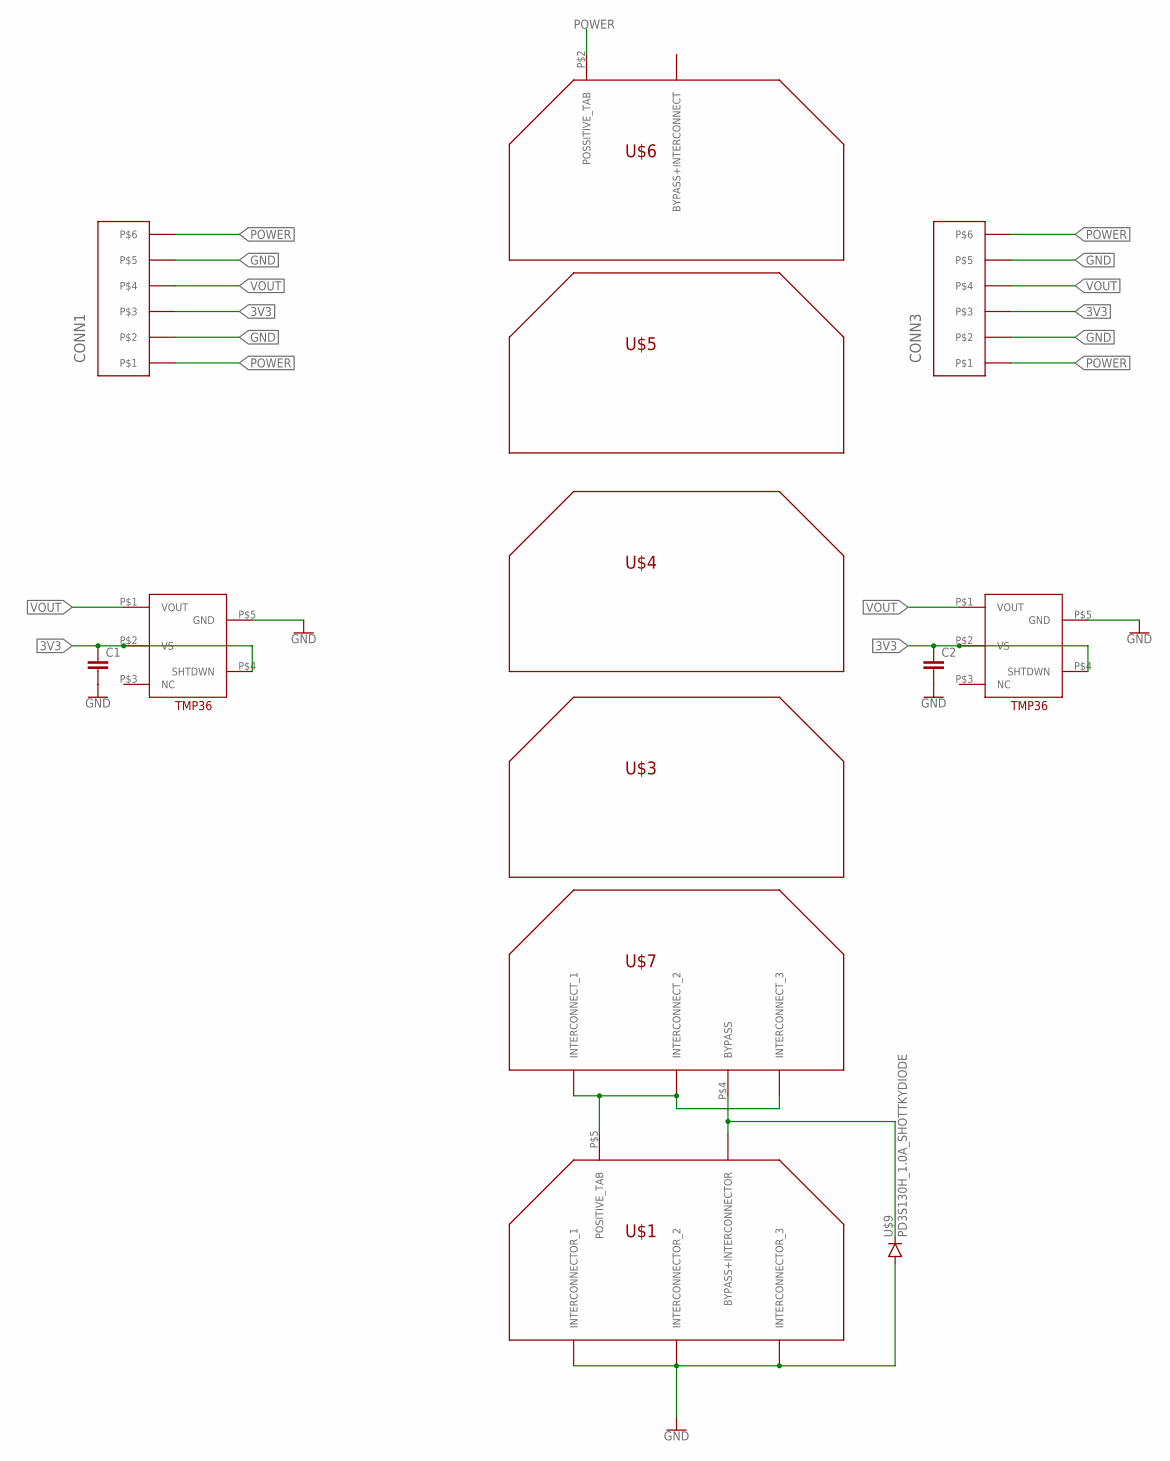
[picture p76: schematic Side_Panel_f1.sch]

Parts:
C1, C2: CAPACITOR0805; 0805
CONN1, CONN3: PICOLOCK_6PICOLOCK_6; PICOLOCK_6
U$1: SOLAR_CELL_STAND-ALONE
U$2, U$8: TMP36; SOT-23-5
U$3, U$4, U$5: SOALAR_CELL_OUTLINE; SOLAR_CELL_OUTLINE
U$6: SOLAR_CELL_TOP; SOLAR_CELL_TOP_SHORT-PAD
U$7: SOLAR_CELL_BOTTOM+BYPASS
U$9: PD3S130H_1.0A_SHOTTKYDIODE; POWERDI_323

Connections:
3V3: C1.1, C2.1, CONN1.P$3, CONN3.P$3, U$2.P$2 (VS), U$2.P$4 (SHTDWN), U$8.P$2 (VS), U$8.P$4 (SHTDWN)
GND: C1.2, C2.2, CONN1.P$2, CONN1.P$5, CONN3.P$2, CONN3.P$5, U$1.P$1 (INTERCONNECTOR_1), U$1.P$2 (INTERCONNECTOR_2), U$1.P$3 (INTERCONNECTOR_3), U$2.P$5 (GND), U$8.P$5 (GND), U$9.P$2 (A)
unnamed: U$1.P$4 (BYPASS+INTERCONNECTOR), U$7.P$4 (BYPASS), U$9.P$1 (C)
unnamed: U$1.P$5 (POSITIVE_TAB), U$7.P$1 (INTERCONNECT_1), U$7.P$2 (INTERCONNECT_2), U$7.P$3 (INTERCONNECT_3)
POWER: CONN1.P$1, CONN1.P$6, CONN3.P$1, CONN3.P$6, U$6.P$2 (POSSITIVE_TAB)
VOUT: CONN1.P$4, CONN3.P$4, U$2.P$1 (VOUT), U$8.P$1 (VOUT)

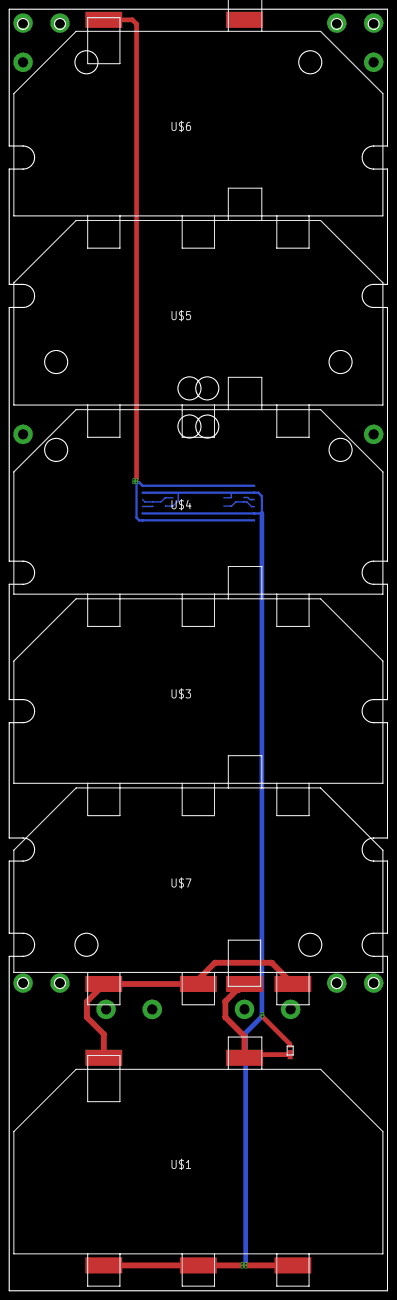
[picture p77: board Side_Panel_f1.brd from above]

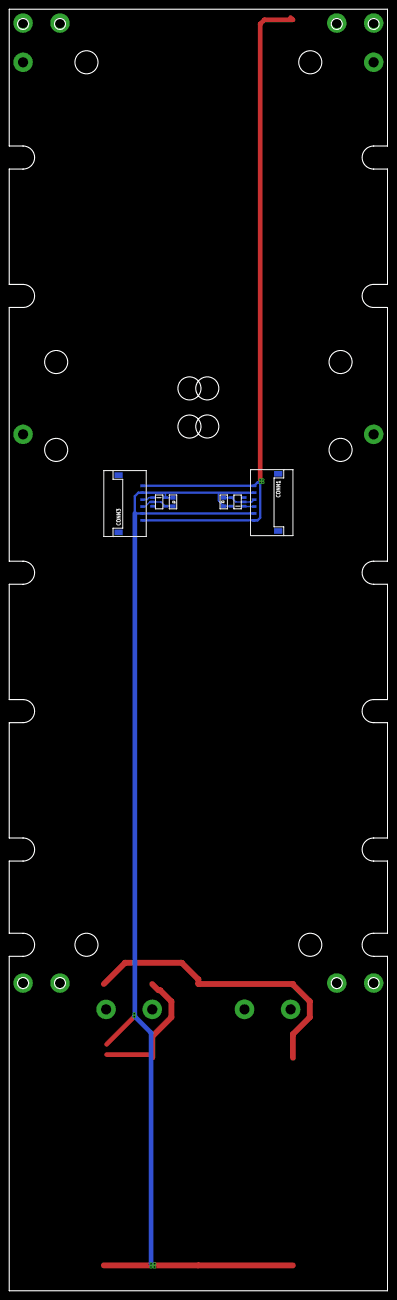
[picture p78: board Side_Panel_f1.brd from below]

Board: 2 copper layers, 82.0 x 277.8 mm, 13 parts (6 on the bottom side), 6 nets.
