UWCubeSat/DubSat1/teams/power/Flight/Generation/generation_board_f1.brd

## EAGLE design teams/power/Flight/Generation/generation_board_f1.brd (2019-07-06)

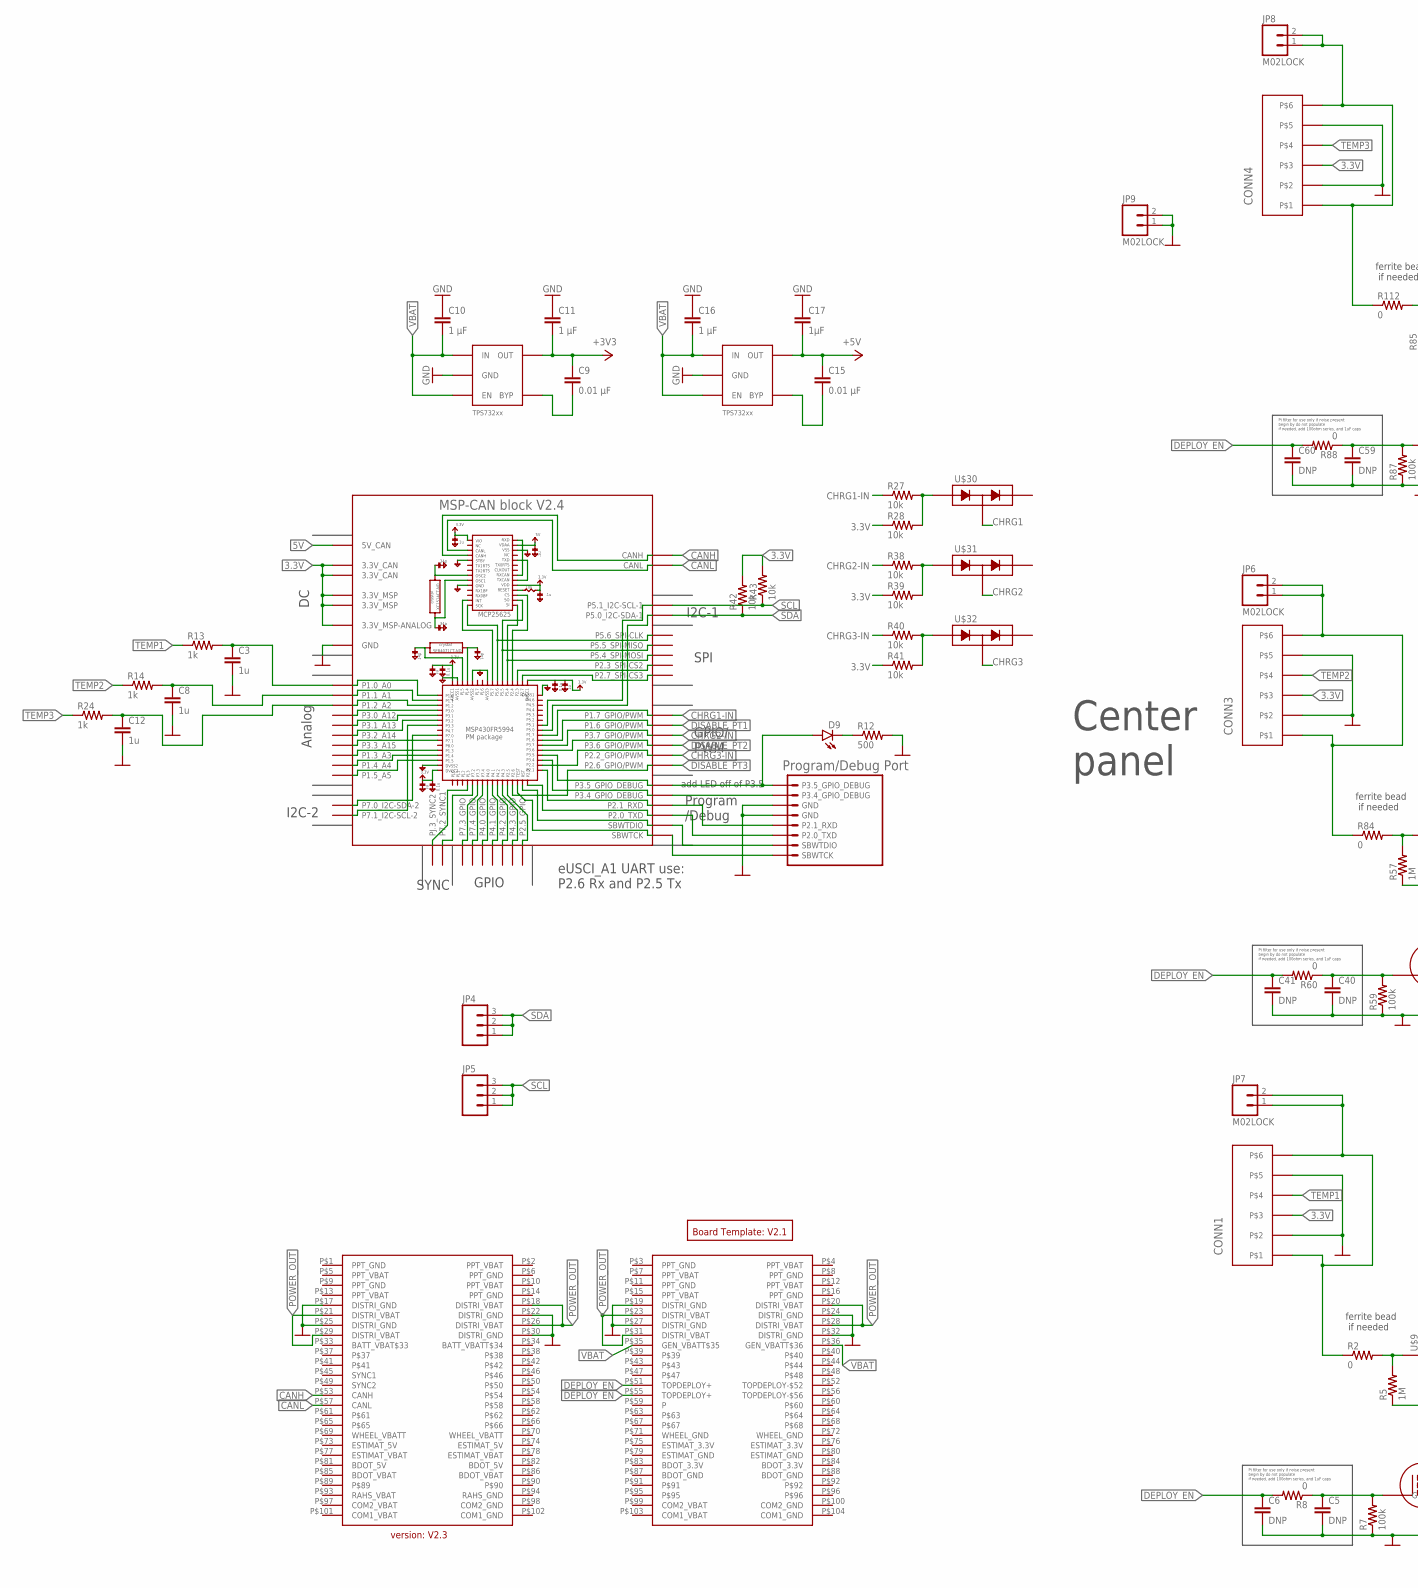
[picture p79: schematic generation_board_f1.sch, part in row 1, column 1]

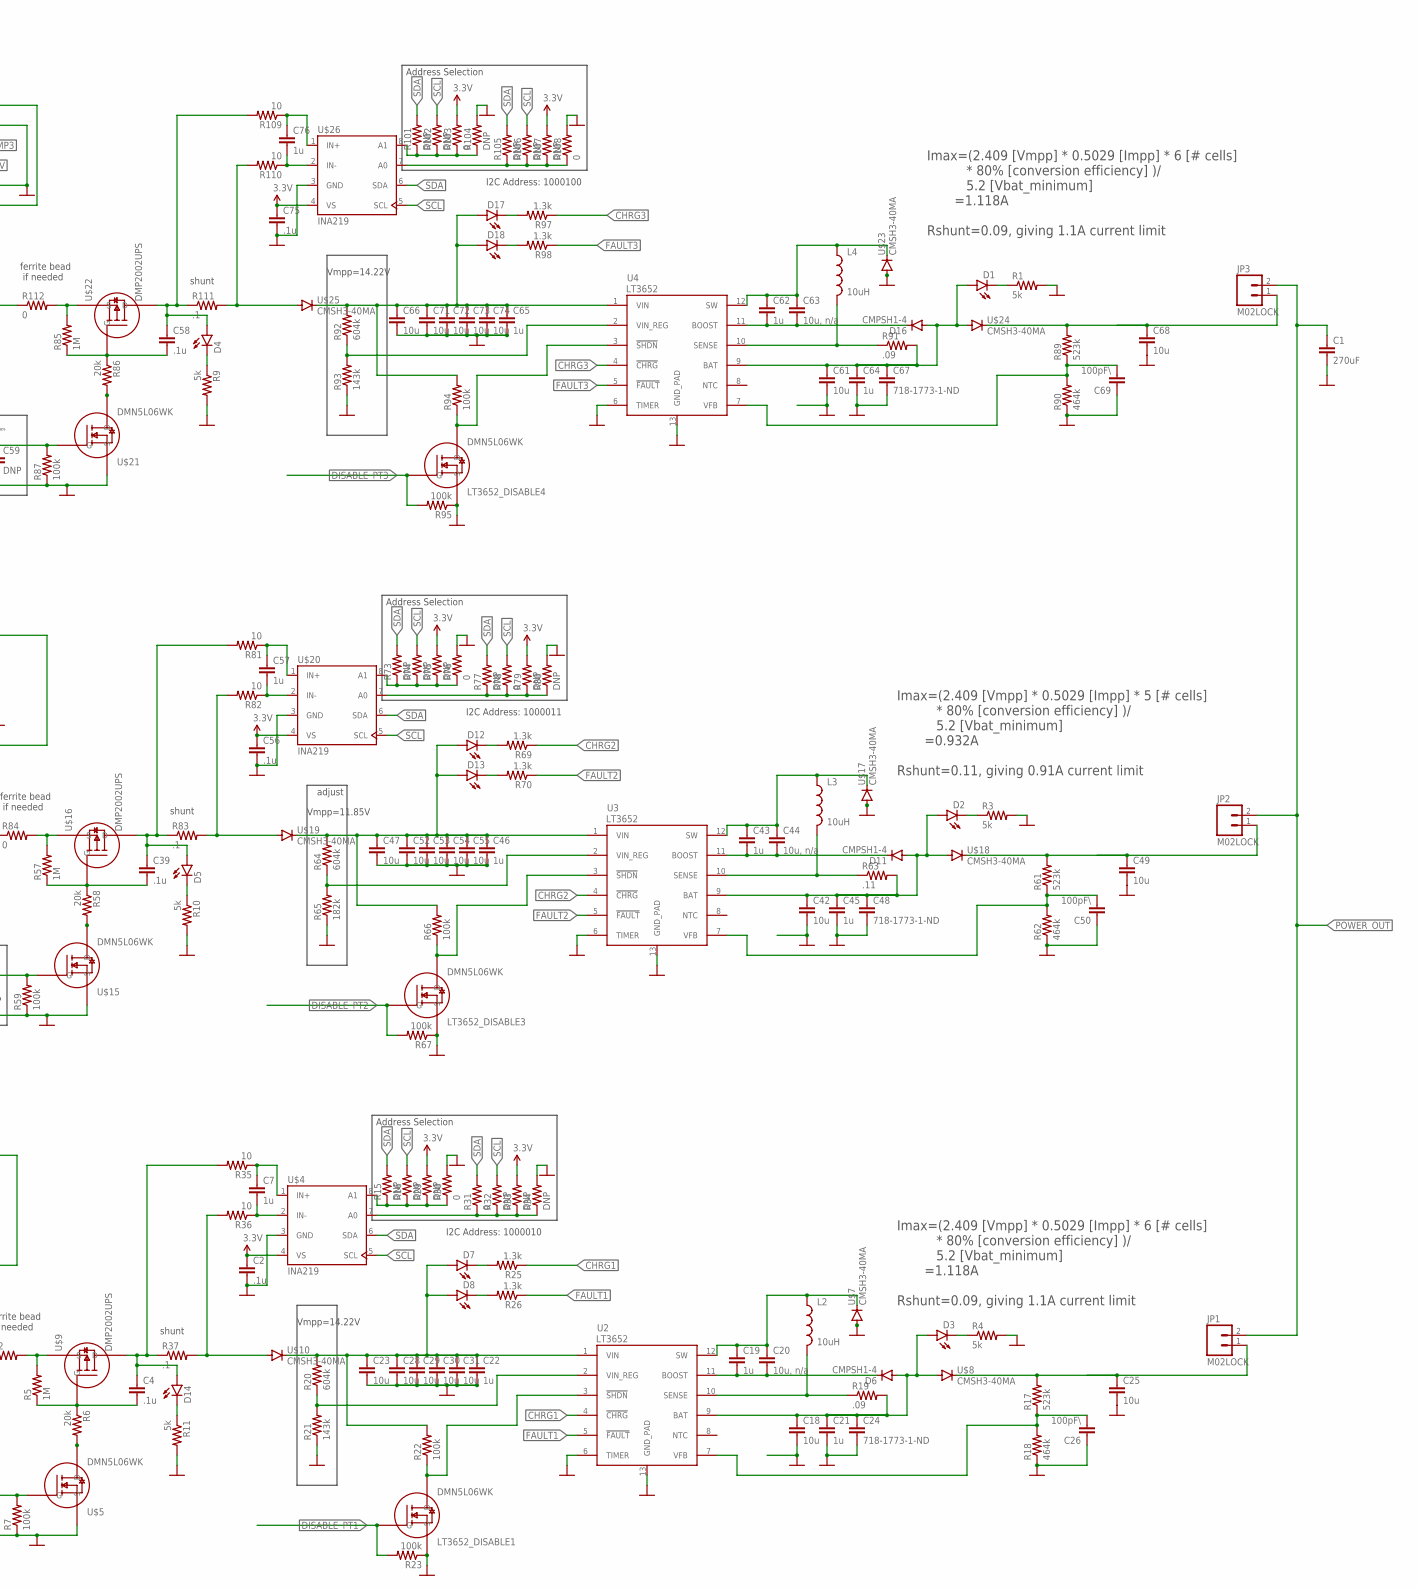
[picture p80: schematic generation_board_f1.sch, part in row 1, column 2]

Parts:
BLK1: MSP-CAN_BLOCK
C1: 270uF; 2917
C2, C4, C39, C56, C58, C75: .1u; 0805
C3, C7, C8, C12, C19, C21, C22, C43, C45, C46, C57, C62, C64, C65, C76: 1u; 0805
C5, C6, C40, C41, C59, C60: DNP; 0805
C9, C15: 0.01 μF; 0805
C10, C11, C16: 1 μF; 0805
C17: 1μF; 0805
C18, C25, C42, C49, C61, C68: 10u; 0805
C20, C44, C63: 10u, n/a; 0805
C23, C28, C29, C30, C31, C47, C52, C53, C54, C55, C66, C71, C72, C73, C74: 10u; 1210
C24, C48, C67: 718-1773-1-ND; 2917
C26, C50, C69: 100pF\; 0805
CONN1, CONN3, CONN4: PICOLOCK_6
D1, D2, D3, D4, D5, D7, D8, D9, D12, D13, D14, D17, D18: LED; LED-1206
D6, D11, D16: CMPSH1-4; SOT23-3
JP1, JP2, JP3, JP6, JP7, JP8, JP9: M02LOCK; 1X02_LOCK
JP4, JP5: M03LOCK; 1X03_LOCK
L2, L3, L4: 10uH; VISHAY_SERIES_01
LT3652_DISABLE1, LT3652_DISABLE3, LT3652_DISABLE4: DMN5L06WK; SOT-323
R1, R3, R4, R9, R10, R11: 5k; 0805
R2, R8, R30, R31, R60, R76, R78, R84, R88, R103, R108, R112: 0; 0805
R5, R57, R85: 1M; 0805
R6, R58, R86: 20k; 0805
R7, R22, R23, R59, R66, R67, R87, R94, R95: 100k; 0805
R12: 500; 0805
R13, R14, R24: 1k; 0805
R15, R16, R29, R32, R33, R34, R73, R74, R75, R77, R79, R80, R101, R102, R104, R105, R106, R107: DNP; 0805
R17, R61, R89: 523k; 0805
R18, R62, R90: 464k; 0805
R19, R91: .09; R2010
R20, R64, R92: 604k; 0805
R21, R93: 143k; 0805
R25, R26, R69, R70, R97, R98: 1.3k; 0805
R27, R28, R38, R39, R40, R41, R42, R43: 10k; 0805
R35, R36, R81, R82, R109, R110: 10; 0805
R37, R83, R111: .1; R2010
R63: .11; R2010
R65: 182k; 0805
U2, U3, U4: LT3652; MSOP-12_GND
U5, U7: TPS732XX; SOT-23-5
U$1: PC104_CONNECTOR
U$2: BOARD_TEMPLATE1; BOARD_TEMPLATE
U$3: PROGRAM/DEBUG_PORT; 1X08_CONNECTOR
U$4, U$20, U$26: INA219; SOT-23-8
U$5, U$15, U$21: DMN5L06WK; SOT-323
U$7, U$8, U$10, U$17, U$18, U$19, U$23, U$24, U$25: CMSH3-40MA; SMA-DIODE
U$9, U$16, U$22: DMP2002UPS; POWERDI5060-8
U$30, U$31, U$32: ONSEMI_DIODE_BAT54SL; SOT23-3

Connections:
3.3V: BLK1.3.3V@CAN1 (3.3V_CAN), BLK1.3.3V@CAN2 (3.3V_CAN), BLK1.3.3V@MSP1 (3.3V_MSP), BLK1.3.3V@MSP2 (3.3V_MSP), BLK1.3.3V_ANALOG@MSP2 (3.3V_MSP-ANALOG), C2.1, C9.1, C11.2, C56.1, C75.1, CONN1.P$3, CONN3.P$3, CONN4.P$3, R28.1, R29.2, R33.2, R39.1, R41.1, R42.2, R43.2, R75.2, R79.2, R103.2, R107.2, U5.P$5 (OUT), U$4.4 (VS), U$20.4 (VS), U$26.4 (VS)
5V: BLK1.5V (5V_CAN), C15.1, C17.2, U7.P$5 (OUT)
BAT1: C18.1, C21.1, C24.1, D3.A, D6.1 (A), R19.2, U2.9 (BAT), U$8.A
BAT2: C42.1, C45.1, C48.1, D2.A, D11.1 (A), R63.2, U3.9 (BAT), U$18.A
BAT3: C61.1, C64.1, C67.1, D1.A, D16.1 (A), R91.2, U4.9 (BAT), U$24.A
BOOST1: C19.2, C20.2, D6.3 (C), U2.11 (BOOST)
BOOST2: C43.2, C44.2, D11.3 (C), U3.11 (BOOST)
BOOST3: C62.2, C63.2, D16.3 (C), U4.11 (BOOST)
CANH: BLK1.CANH, U$1.P$53 (CANH)
CANL: BLK1.CANL, U$1.P$57 (CANL)
CHRG1: R25.1, U2.4 (!CHRG), U$30.3
CHRG1-IN: BLK1.P1.7_GPIO/PWM, R27.1
CHRG2: R69.1, U3.4 (!CHRG), U$31.3
CHRG2-IN: BLK1.P3.7_GPIO/PWM, R38.1
CHRG3: R97.1, U4.4 (!CHRG), U$32.3
CHRG3-IN: BLK1.P2.2_GPIO/PWM, R40.1
DEPLOY_EN: C6.1, C41.1, C60.1, R8.2, R60.2, R88.2, U$1.P$51 (TOPDEPLOY+), U$1.P$55 (TOPDEPLOY+)
DISABLE_PT1: BLK1.P1.6_GPIO/PWM, LT3652_DISABLE1.1 (G), R23.2
DISABLE_PT2: BLK1.P3.6_GPIO/PWM, LT3652_DISABLE3.1 (G), R67.2
DISABLE_PT3: BLK1.P2.6_GPIO/PWM, LT3652_DISABLE4.1 (G), R95.2
FAULT1: R26.1, U2.5 (!FAULT)
FAULT2: R70.1, U3.5 (!FAULT)
FAULT3: R98.1, U4.5 (!FAULT)
GND: BLK1.GND@1 (GND), BLK1.GND@2 (GND), BLK1.GND@3 (GND), BLK1.GND@4 (GND), BLK1.GND@5 (GND), BLK1.GND@7 (GND), BLK1.GND@8 (GND), BLK1.GND@9 (GND), BLK1.GND@10 (GND), BLK1.GND@11 (GND), BLK1.GND@12 (GND), BLK1.GND@13 (GND), BLK1.GND@14 (GND), BLK1.GND@15 (GND), BLK1.GND@16 (GND), BLK1.GND@17 (GND), BLK1.GND@26 (GND), C1.2, C2.2, C3.2, C5.2, C6.2, C8.2, C10.1, C11.1, C12.2, C16.1, C17.1, C18.2, C21.2, C22.2, C23.2, C24.2, C25.2, C26.1, C28.2, C29.2, C30.2, C31.2, C40.2, C41.2, C42.2, C45.2, C46.2, C47.2, C48.2, C49.2, C50.1, C52.2, C53.2, C54.2, C55.2, C56.2, C59.2, C60.2, C61.2, C64.2, C65.2, C66.2, C67.2, C68.2, C69.1, C71.2, C72.2, C73.2, C74.2, C75.2, CONN1.P$2, CONN1.P$5, CONN3.P$2, CONN3.P$5, CONN4.P$2, CONN4.P$5, JP9.1, JP9.2, LT3652_DISABLE1.2 (S), LT3652_DISABLE3.2 (S), LT3652_DISABLE4.2 (S), R1.2, R3.2, R4.2, R7.1, R9.2, R10.2, R11.2, R12.2, R18.1, R21.1, R23.1, R30.2, R34.2, R59.1, R62.1, R65.1, R67.1, R76.2, R80.2, R87.1, R90.1, R93.1, R95.1, R104.2, R108.2, U2.6 (TIMER), U2.13 (GND_PAD), U3.6 (TIMER), U3.13 (GND_PAD), U4.6 (TIMER), U4.13 (GND_PAD), U5.P$2 (GND), U7.P$2 (GND), U$1.P$17 (DISTRI_GND), U$1.P$19 (DISTRI_GND), U$1.P$22 (DISTRI_GND), U$1.P$24 (DISTRI_GND), U$1.P$25 (DISTRI_GND), U$1.P$27 (DISTRI_GND), U$1.P$30 (DISTRI_GND), U$1.P$32 (DISTRI_GND), U$3.5 (GND), U$3.6 (GND), U$4.3 (GND), U$5.2 (S), U$7.A, U$15.2 (S), U$17.A, U$20.3 (GND), U$21.2 (S), U$23.A, U$26.3 (GND)
IN1: R2.2, R5.2, U$9.S1 (S), U$9.S2 (S), U$9.S3 (S)
IN2: R57.2, R84.2, U$16.S1 (S), U$16.S2 (S), U$16.S3 (S)
IN3: R85.2, R112.2, U$22.S1 (S), U$22.S2 (S), U$22.S3 (S)
INA219_A0_1: R31.1, R32.1, R33.1, R34.1, U$4.7 (A0)
INA219_A0_2: R77.1, R78.1, R79.1, R80.1, U$20.7 (A0)
INA219_A0_3: R105.1, R106.1, R107.1, R108.1, U$26.7 (A0)
INA219_A1_1: R15.1, R16.1, R29.1, R30.1, U$4.8 (A1)
INA219_A1_2: R73.1, R74.1, R75.1, R76.1, U$20.8 (A1)
INA219_A1_3: R101.1, R102.1, R103.1, R104.1, U$26.8 (A1)
INA219_IN+_1: C7.1, R35.1, U$4.1 (IN+)
INA219_IN+_2: C57.1, R81.1, U$20.1 (IN+)
INA219_IN+_3: C76.1, R109.1, U$26.1 (IN+)
INA219_IN-_1: C7.2, R36.1, U$4.2 (IN-)
INA219_IN-_2: C57.2, R82.1, U$20.2 (IN-)
INA219_IN-_3: C76.2, R110.1, U$26.2 (IN-)
INPUT_PANEL1: CONN1.P$1, CONN1.P$6, JP7.1, JP7.2, R2.1
INPUT_PANEL2: CONN3.P$1, CONN3.P$6, JP6.1, JP6.2, R84.1
INPUT_PANEL3: CONN4.P$1, CONN4.P$6, JP8.1, JP8.2, R112.1
LDO_3V3_BYP2: C9.2, U5.P$4 (BYP)
LDO_5V_BYP2: C15.2, U7.P$4 (BYP)
LOAD1: R36.2, R37.2, U$10.A
LOAD2: R82.2, R83.2, U$19.A
LOAD3: R110.2, R111.2, U$25.A
unnamed: C4.2, R5.1, R6.1, U$9.G
unnamed: C5.1, R7.2, R8.1, U$5.1 (G)
unnamed: BLK1.P3.5_GPIO_DEBUG, D9.A, U$3.8 (P3.5_GPIO_DEBUG)
unnamed: BLK1.P3.4_GPIO_DEBUG, U$3.7 (P3.4_GPIO_DEBUG)
unnamed: BLK1.P2.1_RXD, U$3.4 (P2.1_RXD)
unnamed: R6.2, U$5.3 (D)
unnamed: BLK1.P2.0_TXD, U$3.3 (P2.0_TXD)
unnamed: BLK1.SBWTDIO, U$3.2 (SBWTDIO)
unnamed: BLK1.SBWTCK, U$3.SBWTCK
unnamed: D1.C, R1.1
unnamed: D2.C, R3.1
unnamed: D3.C, R4.1
unnamed: D4.C, R9.1
unnamed: C39.2, R57.1, R58.1, U$16.G
unnamed: C40.1, R59.2, R60.1, U$15.1 (G)
unnamed: LT3652_DISABLE1.3 (D), R22.1, U2.3 (!SHDN)
unnamed: D8.C, R26.2
unnamed: D7.C, R25.2
unnamed: R58.2, U$15.3 (D)
unnamed: BLK1.P1.1_A1, C8.1, R14.2
unnamed: D9.C, R12.1
unnamed: LT3652_DISABLE3.3 (D), R66.1, U3.3 (!SHDN)
unnamed: D13.C, R70.2
unnamed: D12.C, R69.2
unnamed: D14.C, R11.1
unnamed: D5.C, R10.1
unnamed: C58.2, R85.1, R86.1, U$22.G
unnamed: C59.1, R87.2, R88.1, U$21.1 (G)
unnamed: R86.2, U$21.3 (D)
unnamed: LT3652_DISABLE4.3 (D), R94.1, U4.3 (!SHDN)
unnamed: D18.C, R98.2
unnamed: D17.C, R97.2
unnamed: BLK1.P1.2_A2, C12.1, R24.2
unnamed: BLK1.P1.0_A0, C3.1, R13.2
unnamed: R27.2, R28.2, U$30.1
unnamed: R38.2, R39.2, U$31.1
unnamed: R40.2, R41.2, U$32.1
OUT1: C4.1, D14.A, R35.2, R37.1, U$9.D1 (D), U$9.D2 (D), U$9.D3 (D), U$9.D4 (D), U$9.D5 (D)
OUT2: C39.1, D5.A, R81.2, R83.1, U$16.D1 (D), U$16.D2 (D), U$16.D3 (D), U$16.D4 (D), U$16.D5 (D)
OUT3: C58.1, D4.A, R109.2, R111.1, U$22.D1 (D), U$22.D2 (D), U$22.D3 (D), U$22.D4 (D), U$22.D5 (D)
OUTPUT1: C25.1, JP1.1, R17.2, U$8.C
OUTPUT2: C49.1, JP2.1, R61.2, U$18.C
OUTPUT3: C68.1, JP3.1, R89.2, U$24.C
POWER_OUT: C1.1, JP1.2, JP2.2, JP3.2, U$1.P$18 (DISTRI_VBAT), U$1.P$20 (DISTRI_VBAT), U$1.P$21 (DISTRI_VBAT), U$1.P$23 (DISTRI_VBAT), U$1.P$26 (DISTRI_VBAT), U$1.P$28 (DISTRI_VBAT), U$1.P$29 (DISTRI_VBAT), U$1.P$31 (DISTRI_VBAT)
SCL: BLK1.P5.1_I2C-SCL-1, JP5.1, JP5.2, JP5.3, R16.2, R32.2, R43.1, R74.2, R78.2, R102.2, R106.2, U$4.5 (SCL), U$20.5 (SCL), U$26.5 (SCL)
SDA: BLK1.P5.0_I2C-SDA-1, JP4.1, JP4.2, JP4.3, R15.2, R31.2, R42.1, R73.2, R77.2, R101.2, R105.2, U$4.6 (SDA), U$20.6 (SDA), U$26.6 (SDA)
SENSE1: L2.P$2 (2), R19.1, U2.10 (SENSE)
SENSE2: L3.P$2 (2), R63.1, U3.10 (SENSE)
SENSE3: L4.P$2 (2), R91.1, U4.10 (SENSE)
SW1: C19.1, C20.1, L2.P$1 (1), U2.12 (SW), U$7.C
SW2: C43.1, C44.1, L3.P$1 (1), U3.12 (SW), U$17.C
SW3: C62.1, C63.1, L4.P$1 (1), U4.12 (SW), U$23.C
TEMP1: CONN1.P$4, R13.1
TEMP2: CONN3.P$4, R14.1
TEMP3: CONN4.P$4, R24.1
VBAT: C10.2, C16.2, U5.P$1 (IN), U5.P$3 (EN), U7.P$1 (IN), U7.P$3 (EN), U$1.P$35 (GEN_VBATT$35), U$1.P$36 (GEN_VBATT$36)
VFB1: C26.2, R17.1, R18.2, U2.7 (VFB)
VFB2: C50.2, R61.1, R62.2, U3.7 (VFB)
VFB3: C69.2, R89.1, R90.2, U4.7 (VFB)
VIN1: C22.1, C23.1, C28.1, C29.1, C30.1, C31.1, D7.A, D8.A, R20.2, R22.2, U2.1 (VIN), U$10.C
VIN2: C46.1, C47.1, C52.1, C53.1, C54.1, C55.1, D12.A, D13.A, R64.2, R66.2, U3.1 (VIN), U$19.C
VIN3: C65.1, C66.1, C71.1, C72.1, C73.1, C74.1, D17.A, D18.A, R92.2, R94.2, U4.1 (VIN), U$25.C
VIN_REG1: R20.1, R21.2, U2.2 (VIN_REG)
VIN_REG2: R64.1, R65.2, U3.2 (VIN_REG)
VIN_REG3: R92.1, R93.2, U4.2 (VIN_REG)

Notes on the sheet:
Pi filter for use only if noise present begin by do not populate if needed, add 100ohm series, and 1uF caps
Address Selection
ferrite bead if needed
shunt
adjust
Vmpp=14.22V
Center panel
Imax=(2.409 [Vmpp] * 0.5029 [Impp] * 6 [# cells] * 80% [conversion efficiency] )/ 5.2 [Vbat_minimum] =1.118A Rshunt=0.09, giving 1.1A current limit
Imax=(2.409 [Vmpp] * 0.5029 [Impp] * 5 [# cells] * 80% [conversion efficiency] )/ 5.2 [Vbat_minimum] =0.932A Rshunt=0.11, giving 0.91A current limit
Vmpp=11.85V
I2C Address: 1000010
I2C Address: 1000011
I2C Address: 1000100

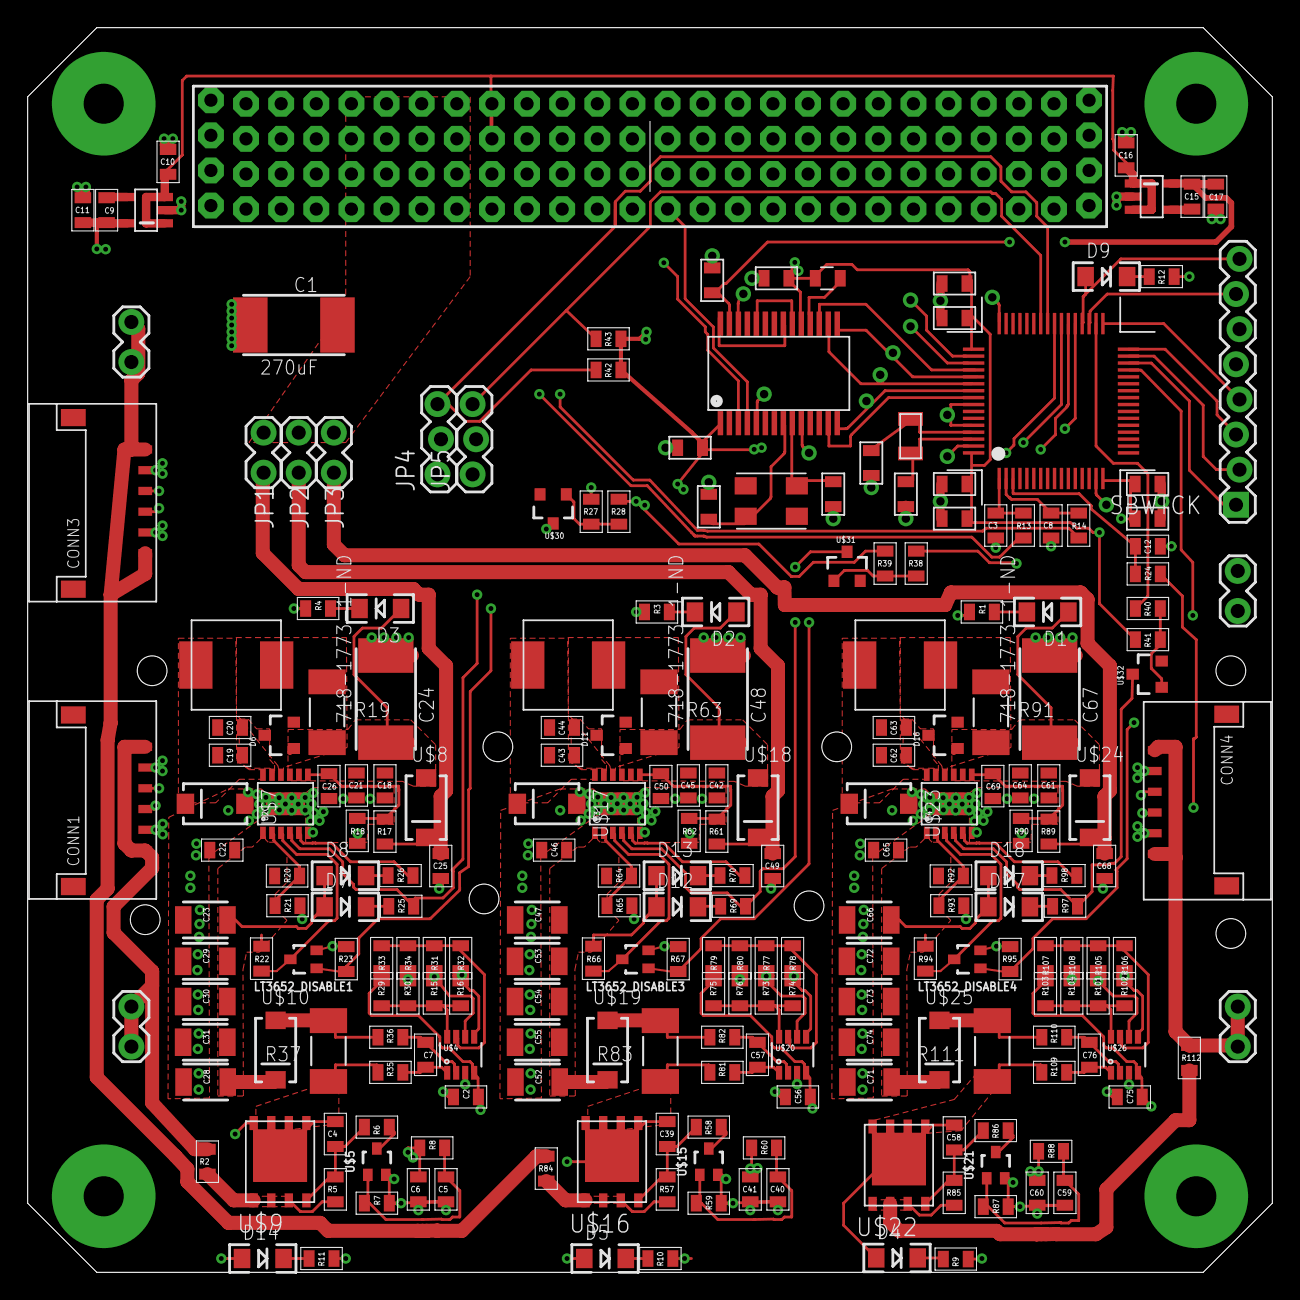
[picture p81: board generation_board_f1.brd from above]

Board: 4 copper layers, 90.0 x 90.0 mm, 229 parts (0 on the bottom side), 112 nets.

Other parts of the board:
U$6, U$11, U$12, U$13, U$14, U$27, U$28, U$29: #2-56_BOLT_HOLE
