UWCubeSat/DubSat1/teams/power/Flight/Center Panel/Center_Panel_f1.brd

## EAGLE design teams/power/Flight/Center Panel/Center_Panel_f1.brd (2019-07-06)

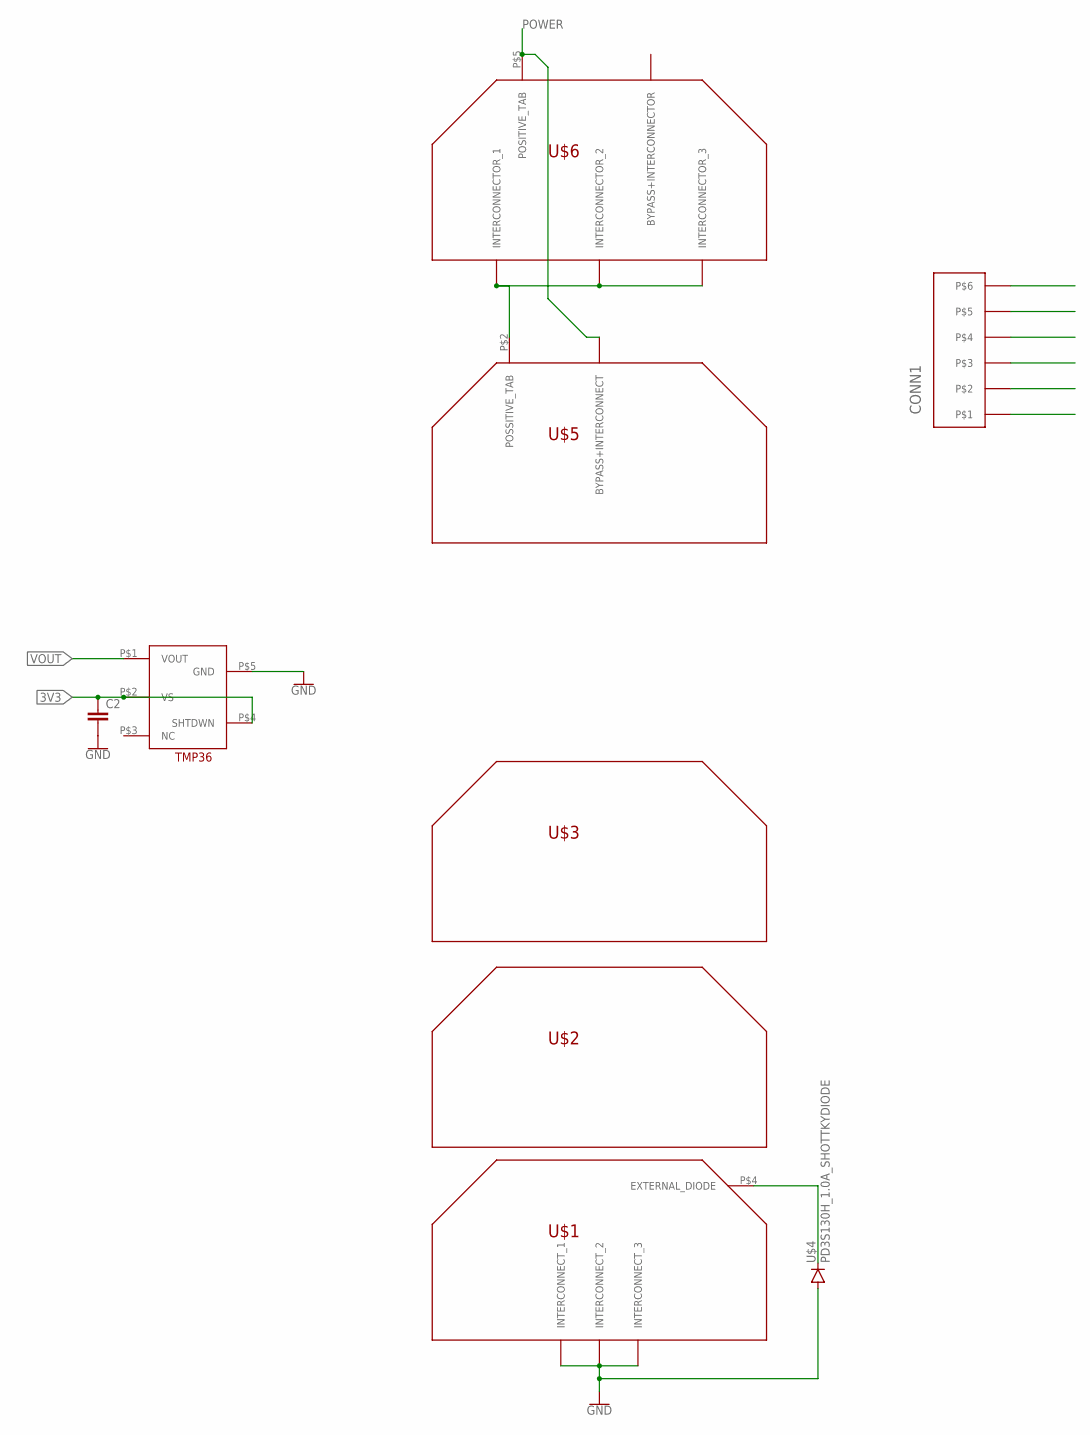
[picture p82: schematic Center_Panel_f1.sch]

Parts:
C2: CAPACITOR0805; 0805
CONN1: PICOLOCK_6
U$1: SOLAR_CELL_BOTTOM_W_DIODE; SOLAR_CELL_BOTTOM_SHORT-PADS
U$2, U$3: SOALAR_CELL_OUTLINE; SOLAR_CELL_OUTLINE
U$4: PD3S130H_1.0A_SHOTTKYDIODE; POWERDI_323
U$5: SOLAR_CELL_TOP; SOLAR_CELL_TOP_SHORT-PAD
U$6: SOLAR_CELL_STAND-ALONE
U$7: TMP36; SOT-23-5

Connections:
3V3: C2.1, CONN1.P$3, U$7.P$2 (VS), U$7.P$4 (SHTDWN)
GND: CONN1.P$2, CONN1.P$5, U$1.P$1 (INTERCONNECT_1), U$1.P$2 (INTERCONNECT_2), U$1.P$3 (INTERCONNECT_3), U$4.P$2 (A), U$7.P$5 (GND)
unnamed: U$5.P$2 (POSSITIVE_TAB), U$6.P$1 (INTERCONNECTOR_1), U$6.P$2 (INTERCONNECTOR_2), U$6.P$3 (INTERCONNECTOR_3)
unnamed: U$1.P$4 (EXTERNAL_DIODE), U$4.P$1 (C)
POWER: CONN1.P$1, CONN1.P$6, U$5.P$1 (BYPASS+INTERCONNECT), U$6.P$5 (POSITIVE_TAB)
VOUT: CONN1.P$4, U$7.P$1 (VOUT)

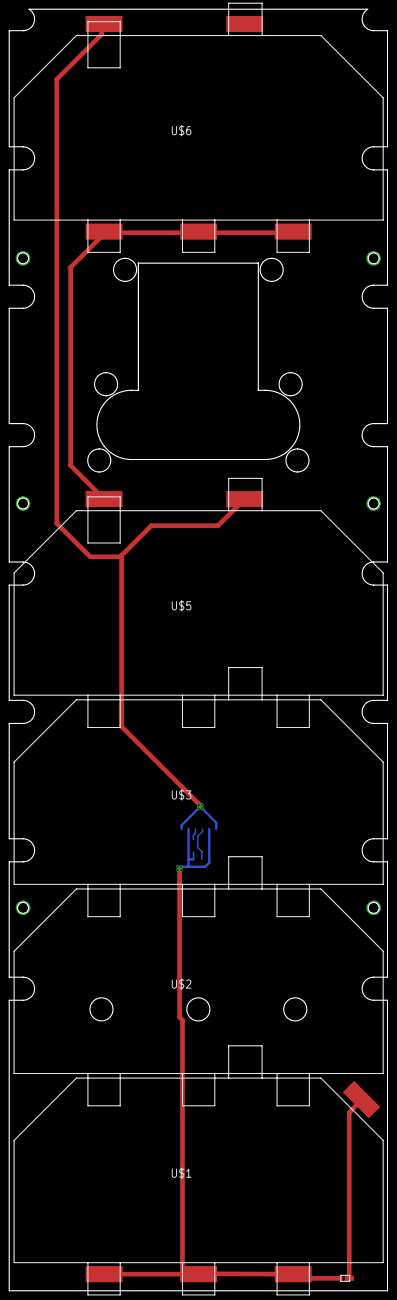
[picture p83: board Center_Panel_f1.brd from above]

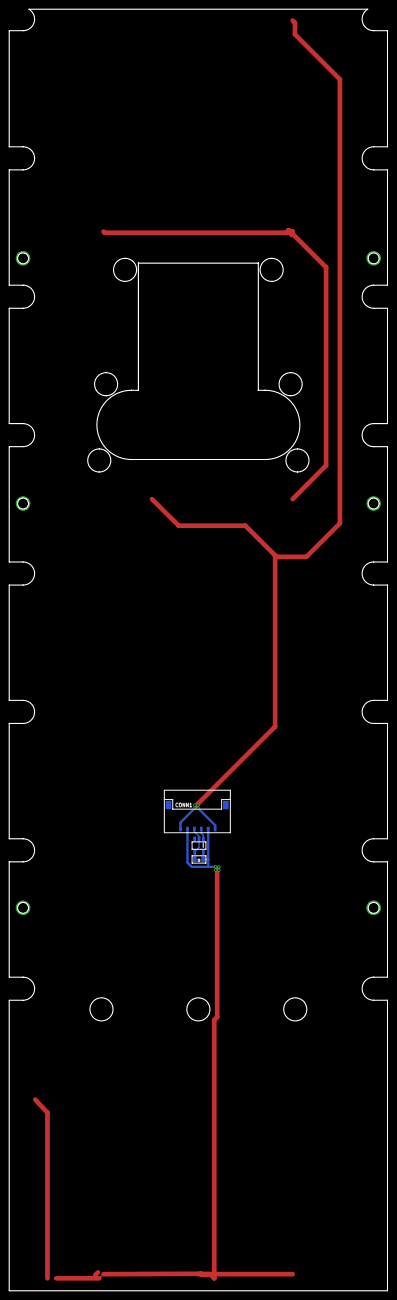
[picture p84: board Center_Panel_f1.brd from below]

Board: 2 copper layers, 82.0 x 277.8 mm, 9 parts (3 on the bottom side), 6 nets.
