UWCubeSat/DubSat1/teams/propulsion/flight/controller/PPT_controller_flight1.brd

## EAGLE design teams/propulsion/flight/controller/PPT_controller_flight1.brd (2019-07-06)

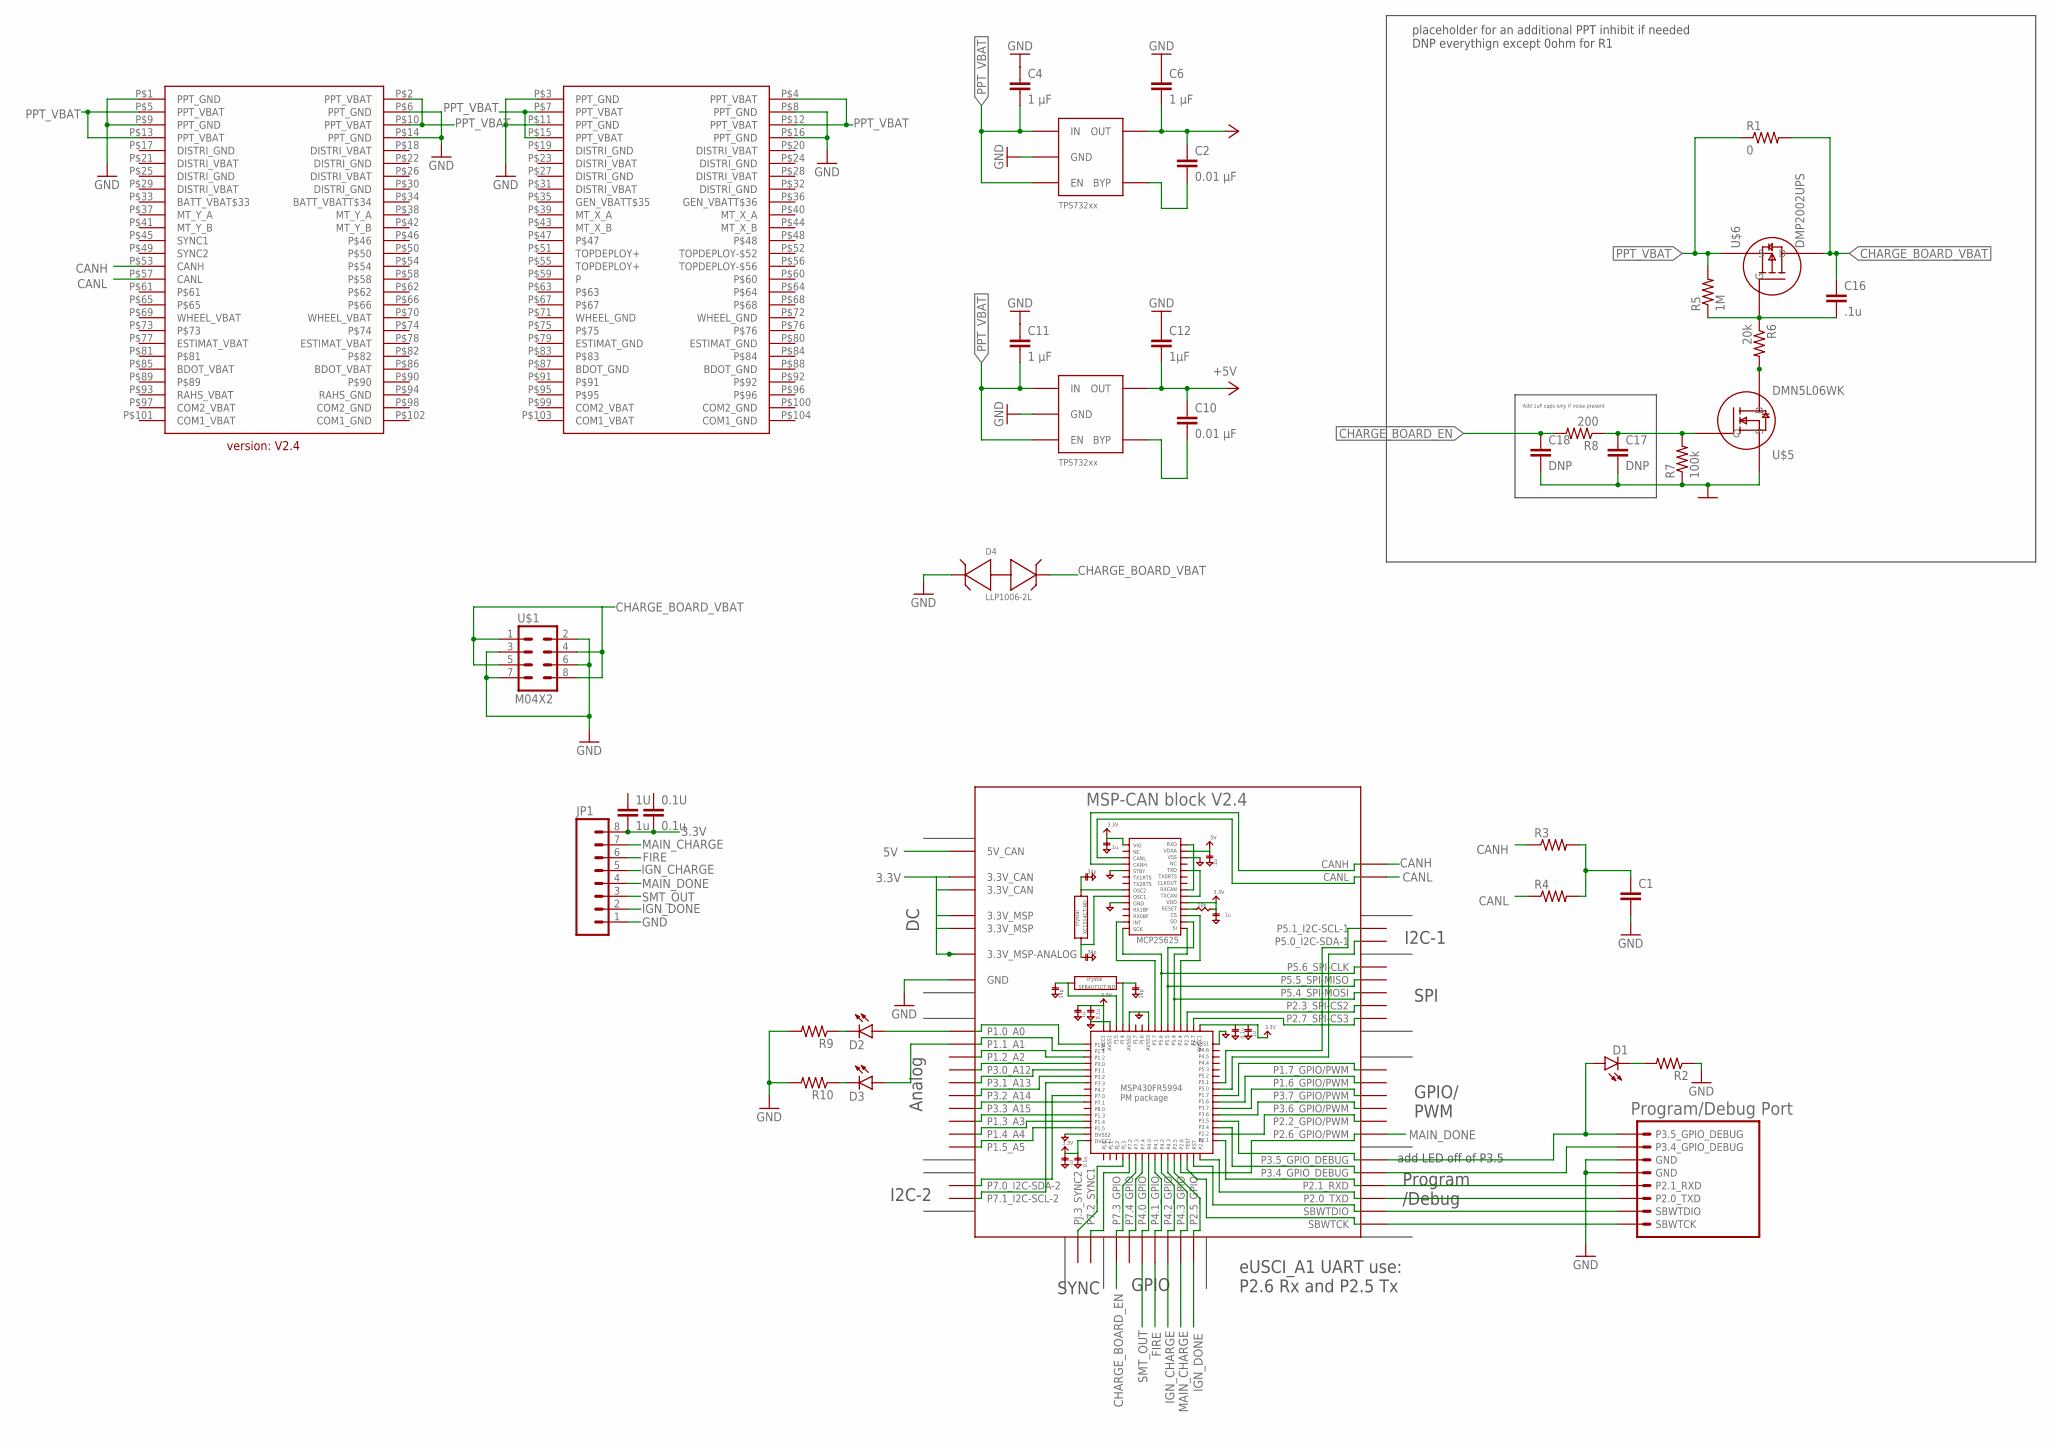
[picture p85: schematic PPT_controller_flight1.sch]

Parts:
0.1U: 0.1u; 0805
1U: 1u; 0805
BLK1: MSP-CAN_BLOCK
C1: CAPACITOR0805; 0805
C2, C10: 0.01 μF; 0805
C4, C6, C11: 1 μF; 0805
C12: 1μF; 0805
C16: .1u; 0805
C17, C18: DNP; 0805
D1, D2, D3: LED; LED-1206
D4: LLP1006-2L
JP1: M08; 1X08_PIN1_NO_SILK
R1: 0; R2010
R2, R3, R4, R9, R10: RESISTOR0805; 0805
R5: 1M; 0805
R6: 20k; 0805
R7: 100k; 0805
R8: 200; 0805
U2, U4: TPS732XX; SOT-23-5
U$1: M04X2; 2X4
U$2: PC104_CONNECTOR
U$3: PROGRAM/DEBUG_PORT; 1X08_CONNECTOR
U$5: DMN5L06WK; SOT-323
U$6: DMP2002UPS; POWERDI5060-8

Connections:
3.3V: 0.1U.2, 1U.2, BLK1.3.3V@CAN1 (3.3V_CAN), BLK1.3.3V@CAN2 (3.3V_CAN), BLK1.3.3V@MSP1 (3.3V_MSP), BLK1.3.3V@MSP2 (3.3V_MSP), BLK1.3.3V_ANALOG@MSP2 (3.3V_MSP-ANALOG), C2.1, C6.2, JP1.8, U2.P$5 (OUT)
5V: BLK1.5V (5V_CAN), C10.1, C12.2, U4.P$5 (OUT)
CANH: BLK1.CANH, R3.1, U$2.P$53 (CANH)
CANL: BLK1.CANL, R4.1, U$2.P$57 (CANL)
CHARGE_BOARD_EN: BLK1.P7.3_GPIO, C18.1, R8.2
CHARGE_BOARD_VBAT: C16.1, D4.P$2, R1.2, U$1.1, U$1.4, U$1.5, U$1.8, U$6.D1 (D), U$6.D2 (D), U$6.D3 (D), U$6.D4 (D), U$6.D5 (D)
FIRE: BLK1.P4.1_GPIO, JP1.6
GND: BLK1.GND@1 (GND), BLK1.GND@2 (GND), BLK1.GND@3 (GND), BLK1.GND@4 (GND), BLK1.GND@5 (GND), BLK1.GND@7 (GND), BLK1.GND@8 (GND), BLK1.GND@9 (GND), BLK1.GND@10 (GND), BLK1.GND@11 (GND), BLK1.GND@12 (GND), BLK1.GND@13 (GND), BLK1.GND@14 (GND), BLK1.GND@15 (GND), BLK1.GND@16 (GND), BLK1.GND@17 (GND), BLK1.GND@26 (GND), C1.2, C4.1, C6.1, C11.1, C12.1, C17.2, C18.2, D4.P$1, JP1.1, R2.1, R7.1, R9.2, R10.2, U2.P$2 (GND), U4.P$2 (GND), U$1.2, U$1.3, U$1.6, U$1.7, U$2.P$1 (PPT_GND), U$2.P$3 (PPT_GND), U$2.P$6 (PPT_GND), U$2.P$8 (PPT_GND), U$2.P$9 (PPT_GND), U$2.P$11 (PPT_GND), U$2.P$14 (PPT_GND), U$2.P$16 (PPT_GND), U$3.5 (GND), U$3.6 (GND), U$5.2 (S)
IGN_CHARGE: BLK1.P4.2_GPIO, JP1.5
IGN_DONE: BLK1.P2.5_GPIO, JP1.2
LDO_3V3_BYP2: C2.2, U2.P$4 (BYP)
LDO_5V_BYP2: C10.2, U4.P$4 (BYP)
MAIN_CHARGE: BLK1.P4.3_GPIO, JP1.7
MAIN_DONE: BLK1.P2.6_GPIO/PWM, JP1.4
unnamed: C16.2, R5.1, R6.1, U$6.G
unnamed: C17.1, R7.2, R8.1, U$5.1 (G)
unnamed: BLK1.SBWTCK, U$3.SBWTCK
unnamed: BLK1.SBWTDIO, U$3.2 (SBWTDIO)
unnamed: BLK1.P2.0_TXD, U$3.3 (P2.0_TXD)
unnamed: R6.2, U$5.3 (D)
unnamed: BLK1.P2.1_RXD, U$3.4 (P2.1_RXD)
unnamed: BLK1.P3.4_GPIO_DEBUG, U$3.7 (P3.4_GPIO_DEBUG)
unnamed: BLK1.P3.5_GPIO_DEBUG, D1.A, U$3.8 (P3.5_GPIO_DEBUG)
unnamed: C1.1, R3.2, R4.2
unnamed: D1.C, R2.2
unnamed: BLK1.P1.0_A0, D2.A
unnamed: BLK1.P1.1_A1, D3.A
unnamed: D3.C, R10.1
unnamed: D2.C, R9.1
PPT_VBAT: C4.2, C11.2, R1.1, R5.2, U2.P$1 (IN), U2.P$3 (EN), U4.P$1 (IN), U4.P$3 (EN), U$2.P$2 (PPT_VBAT), U$2.P$4 (PPT_VBAT), U$2.P$5 (PPT_VBAT), U$2.P$7 (PPT_VBAT), U$2.P$10 (PPT_VBAT), U$2.P$12 (PPT_VBAT), U$2.P$13 (PPT_VBAT), U$2.P$15 (PPT_VBAT), U$6.S1 (S), U$6.S2 (S), U$6.S3 (S)
SMT_OUT: BLK1.P4.0_GPIO, JP1.3

Notes on the sheet:
Add 1uF caps only if noise present
placeholder for an additional PPT inhibit if needed DNP everythign except 0ohm for R1

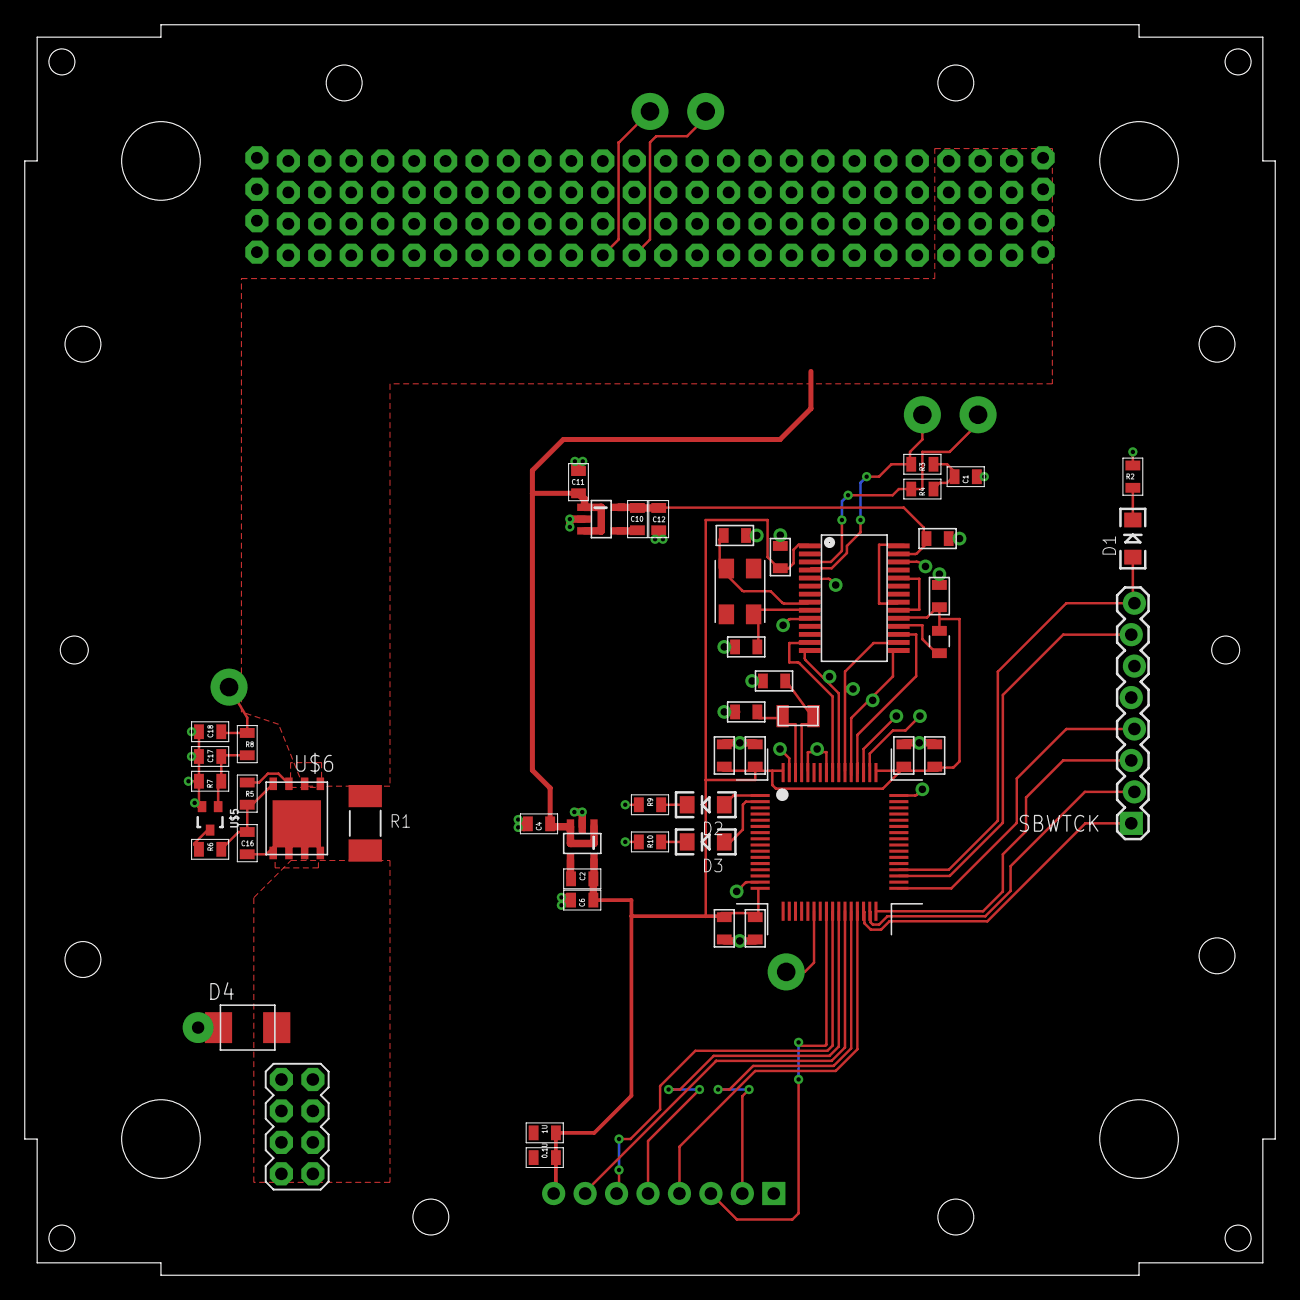
[picture p86: board PPT_controller_flight1.brd from above]

Board: 2 copper layers, 101.0 x 101.0 mm, 35 parts (1 on the bottom side), 31 nets.
