UWCubeSat/DubSat1/teams/power/Flight/Distribution/distribution_board_f1.brd

## EAGLE design teams/power/Flight/Distribution/distribution_board_f1.brd (2019-07-06)

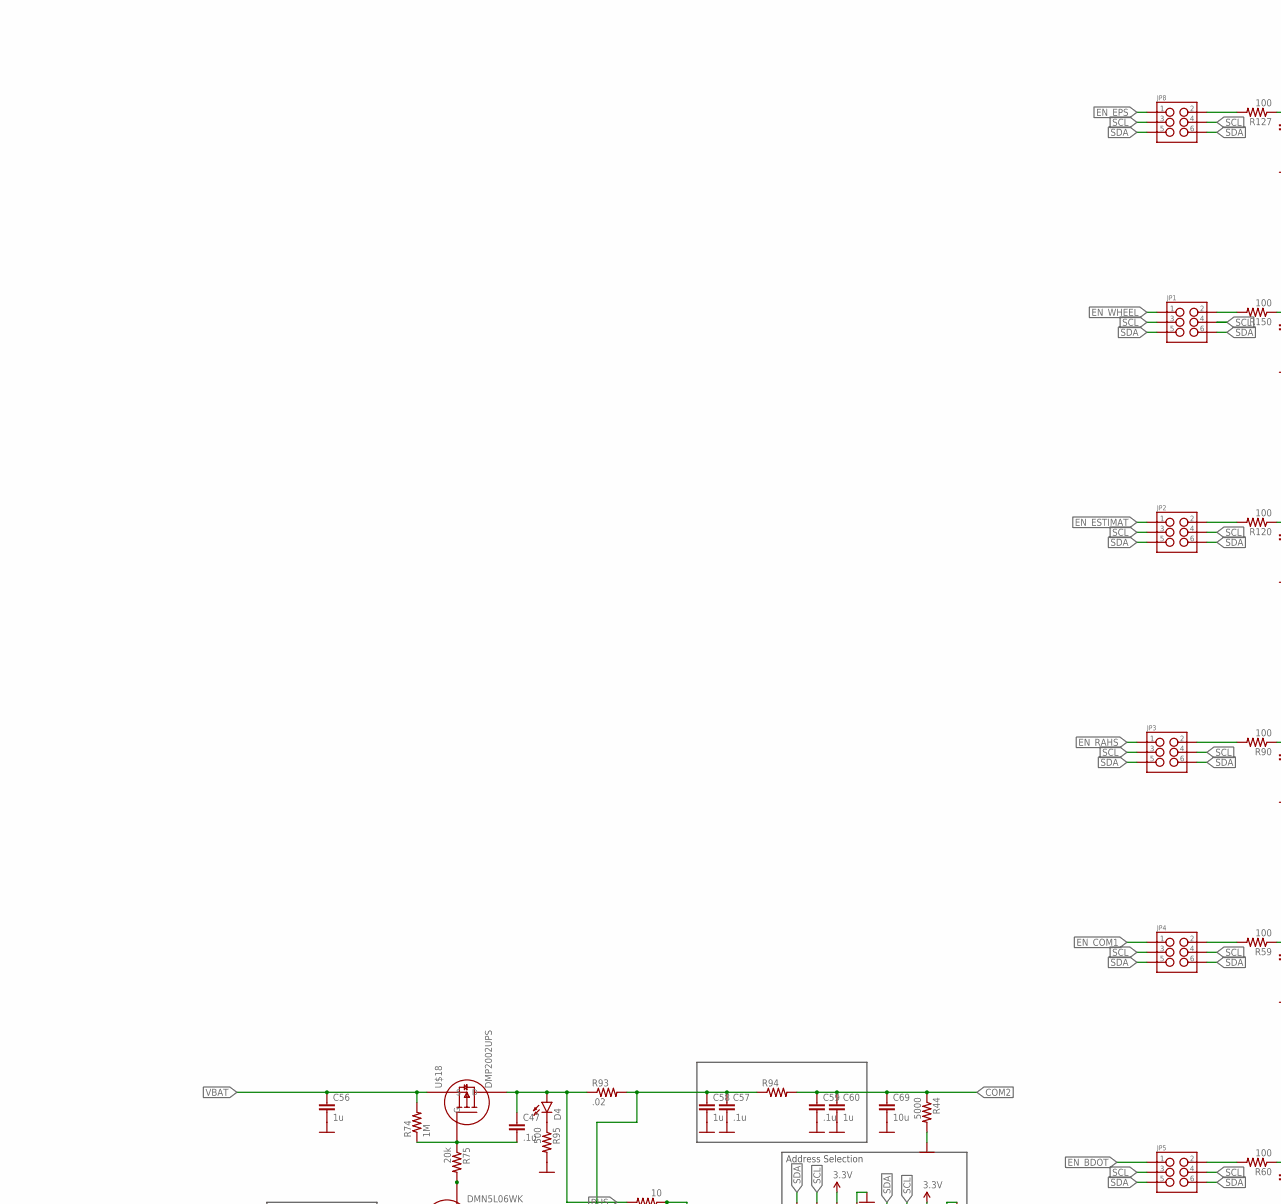
[picture p87: schematic distribution_board_f1.sch, part in row 1, column 1]

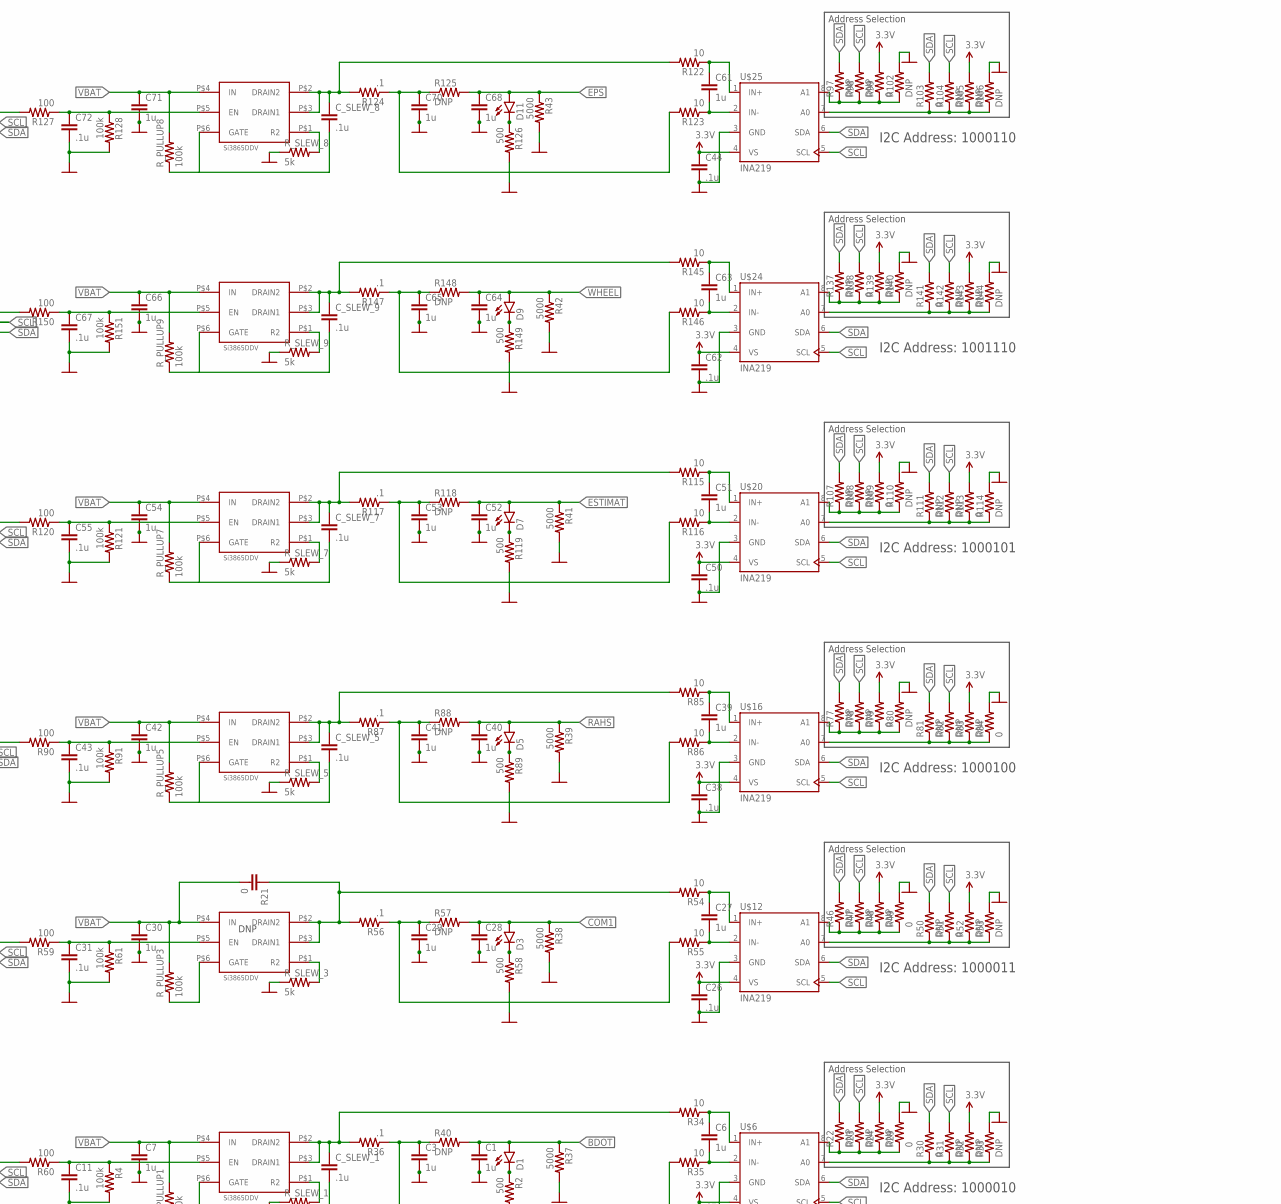
[picture p88: schematic distribution_board_f1.sch, part in row 1, column 2]

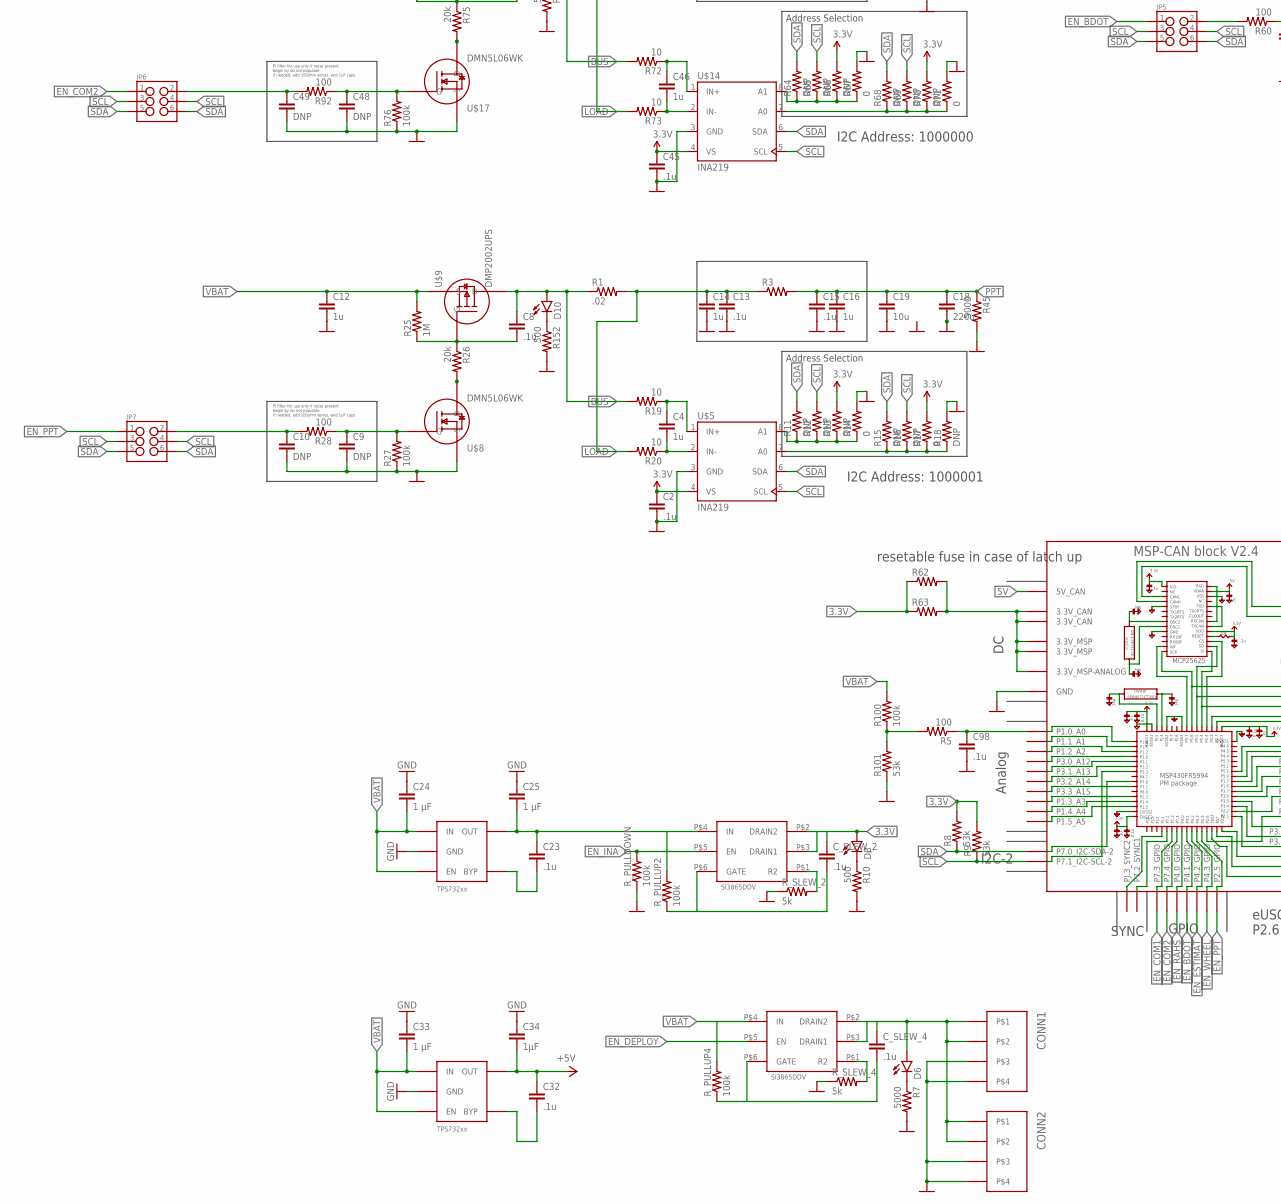
[picture p89: schematic distribution_board_f1.sch, part in row 2, column 1]

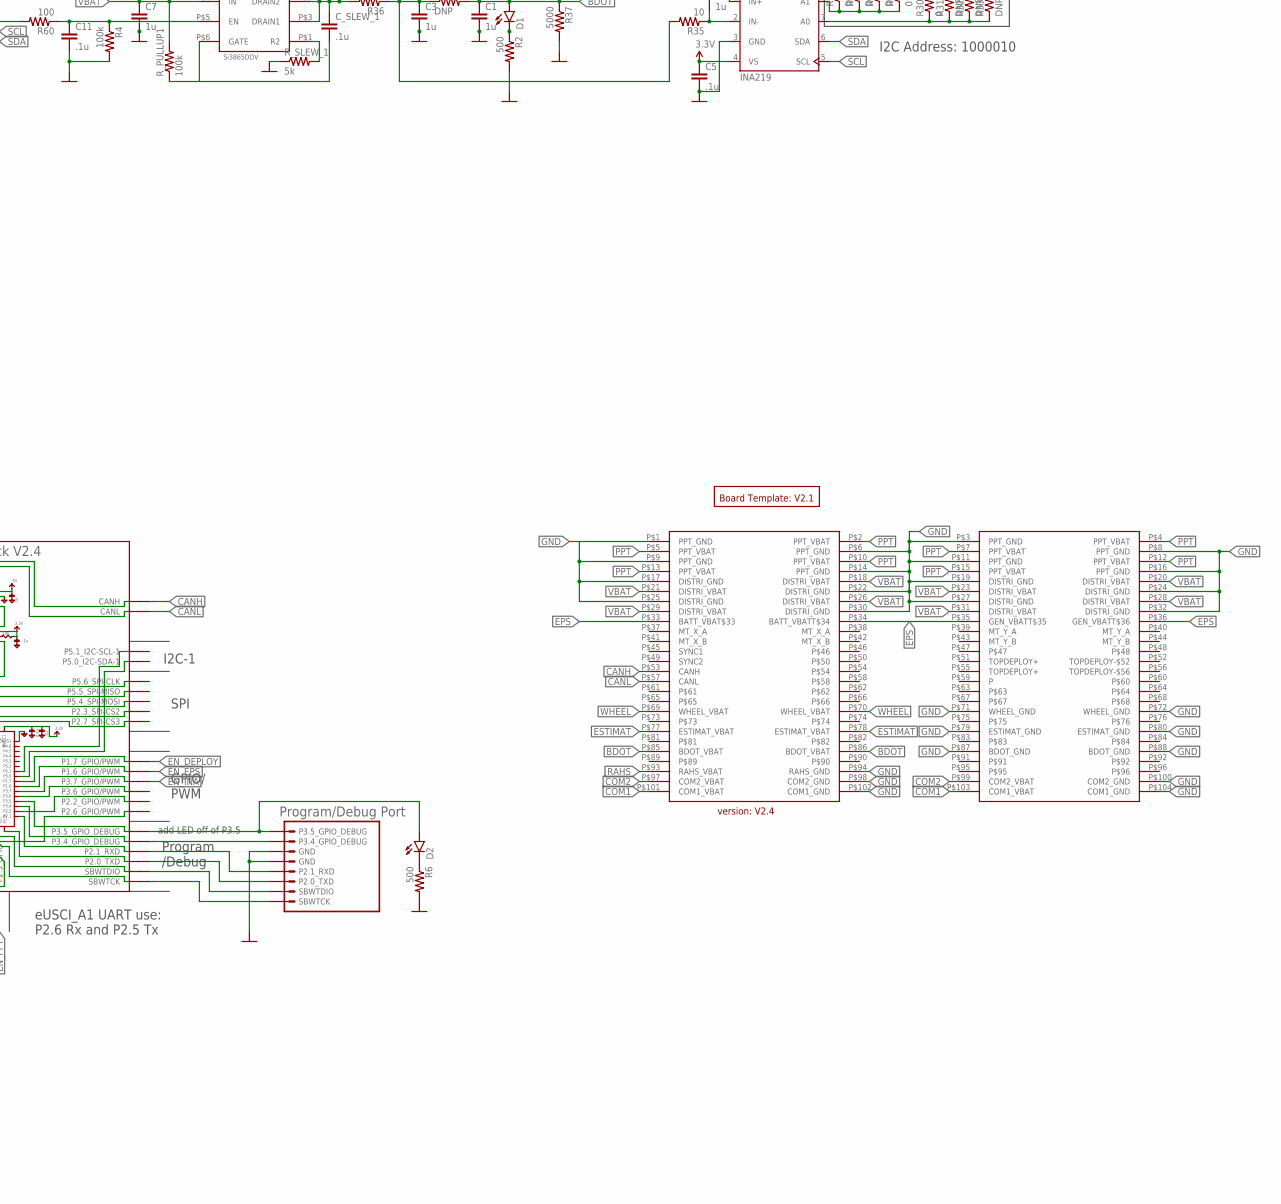
[picture p90: schematic distribution_board_f1.sch, part in row 2, column 2]

Parts:
BLK1: MSP-CAN_BLOCK
C1, C3, C4, C6, C7, C12, C14, C16, C27, C28, C29, C30, C39, C40, C41, C42, C46, C51, C52, C53, C54, C56, C58, C60, C61, C63, C64, C65, C66, C68, C70, C71: 1u; 0805
C2, C5, C8, C11, C13, C15, C23, C26, C31, C32, C38, C43, C44, C45, C47, C50, C55, C57, C59, C62, C67, C72, C98: .1u; 0805
C9, C10, C48, C49: DNP; 0805
C18: 220u; 2917
C19, C69: 10u; 1210
C24, C25, C33: 1 μF; 0805
C34: 1μF; 0805
CONN1, CONN2: PICOLOCK_4-LEGACY
C_SLEW_1, C_SLEW_2, C_SLEW_4, C_SLEW_5, C_SLEW_7, C_SLEW_8, C_SLEW_9: .1u; 0805
D1, D2, D3, D4, D5, D6, D7, D8, D9, D10, D11: LED; LED-1206
JP1, JP2, JP3, JP4, JP5, JP6, JP7, JP8: M03X2NO_SILK; 2X3-NS
R1, R93: .02; R2010
R2, R6, R10, R58, R89, R95, R119, R126, R149, R152: 500; 0805
R3, R94: RESISTOR1206; 1206
R4, R27, R61, R76, R91, R100, R121, R128, R151: 100k; 0805
R5, R28, R59, R60, R90, R92, R120, R127, R150: 100; 0805
R7, R37, R38, R39, R41, R42, R43, R44, R45: 5000; 0805
R8, R9, R101: 53k; 0805
R11, R12, R13, R15, R16, R18, R22, R23, R24, R31, R32, R33, R40, R46, R47, R48, R50, R52, R53, R57, R64, R65, R66, R68, R69, R70, R77, R78, R80, R81, R82, R83, R88, R97, R98, R102, R104, R105, R106, R107, R108, R110, R111, R112, R114, R118, R125, R137, R139, R140, R142, R143, R144, R148: DNP; 0805
R14, R17, R21, R29, R30, R49, R51, R67, R71, R79, R84, R99, R103, R109, R113, R138, R141: 0; 0805
R19, R20, R34, R35, R54, R55, R72, R73, R85, R86, R115, R116, R122, R123, R145, R146: 10; 0805
R25, R74: 1M; 0805
R26, R75: 20k; 0805
R36, R56, R87, R117, R124, R147: .1; R2010
R62: RESISTOR0603; 0603
R63: RESISTOR0805; 0805
R_PULLDOWN: 100k; 0805
R_PULLUP1, R_PULLUP2, R_PULLUP3, R_PULLUP4, R_PULLUP5, R_PULLUP7, R_PULLUP8, R_PULLUP9: 100k; 0805
R_SLEW_1, R_SLEW_2, R_SLEW_3, R_SLEW_4, R_SLEW_5, R_SLEW_7, R_SLEW_8, R_SLEW_9: 5k; 0805
U2, U3: TPS732XX; SOT-23-5
U$1: PROGRAM/DEBUG_PORT; 1X08_CONNECTOR
U$2: PC104_CONNECTOR
U$3: BOARD_TEMPLATE1; BOARD_TEMPLATE
U$5, U$6, U$12, U$14, U$16, U$20, U$24, U$25: INA219; SOT-23-8
U$7, U$10, U$11, U$13, U$15, U$19, U$22, U$23: SI3865DDV; TSOP-6
U$8, U$17: DMN5L06WK; SOT-323
U$9, U$18: DMP2002UPS; POWERDI5060-8

Connections:
3.3V: BLK1.3.3V@CAN1 (3.3V_CAN), BLK1.3.3V@CAN2 (3.3V_CAN), BLK1.3.3V@MSP1 (3.3V_MSP), BLK1.3.3V@MSP2 (3.3V_MSP), BLK1.3.3V_ANALOG@MSP2 (3.3V_MSP-ANALOG), C2.1, C5.1, C23.1, C25.2, C26.1, C38.1, C44.1, C45.1, C50.1, C62.1, C_SLEW_2.1, D8.A, R8.2, R9.2, R13.2, R17.2, R24.2, R32.2, R48.2, R52.2, R62.1, R62.2, R63.1, R63.2, R66.2, R70.2, R79.2, R83.2, R99.2, R105.2, R109.2, R113.2, R139.2, R143.2, R_PULLUP2.2, U2.P$5 (OUT), U$5.4 (VS), U$6.4 (VS), U$7.P$2 (DRAIN2), U$7.P$3 (DRAIN1), U$7.P$4 (IN), U$12.4 (VS), U$14.4 (VS), U$16.4 (VS), U$20.4 (VS), U$24.4 (VS), U$25.4 (VS)
5V: BLK1.5V (5V_CAN), C32.1, C34.2, U3.P$5 (OUT)
BDOT: C1.1, D1.A, R37.1, R40.2, U$2.P$85 (BDOT_VBAT), U$2.P$86 (BDOT_VBAT)
BUS: C8.1, C47.1, D4.A, D10.A, R1.1, R19.2, R72.2, R93.1, U$9.D1 (D), U$9.D2 (D), U$9.D3 (D), U$9.D4 (D), U$9.D5 (D), U$18.D1 (D), U$18.D2 (D), U$18.D3 (D), U$18.D4 (D), U$18.D5 (D)
CANH: BLK1.CANH, U$2.P$53 (CANH)
CANL: BLK1.CANL, U$2.P$57 (CANL)
COM1: C28.1, D3.A, R38.1, R57.2, U$2.P$101 (COM1_VBAT), U$2.P$103 (COM1_VBAT)
COM2: C59.1, C60.1, C69.1, R44.1, R94.2, U$2.P$97 (COM2_VBAT), U$2.P$99 (COM2_VBAT)
DEPLOY: CONN1.P$1, CONN1.P$2, CONN2.P$1, CONN2.P$2, C_SLEW_4.1, D6.A, U$13.P$2 (DRAIN2), U$13.P$3 (DRAIN1)
EN_BDOT: BLK1.P4.1_GPIO, JP5.1, JP5.2, R60.2
EN_COM1: BLK1.P7.3_GPIO, JP4.1, JP4.2, R59.2
EN_COM2: BLK1.P7.4_GPIO, C49.1, JP6.1, JP6.2, R92.2
EN_DEPLOY: BLK1.P1.7_GPIO/PWM, U$13.P$5 (EN)
EN_EPS: BLK1.P1.6_GPIO/PWM, JP8.1, JP8.2, R127.2
EN_ESTIMAT: BLK1.P4.2_GPIO, JP2.1, JP2.2, R120.2
EN_INA: BLK1.P3.7_GPIO/PWM, R_PULLDOWN.2, U$7.P$5 (EN)
EN_PPT: BLK1.P2.5_GPIO, C10.1, JP7.1, JP7.2, R28.2
EN_RAHS: BLK1.P4.0_GPIO, JP3.1, JP3.2, R90.2
EN_WHEEL: BLK1.P4.3_GPIO, JP1.1, JP1.2, R150.2
EPS: C68.1, D11.A, R43.1, R125.2, U$2.P$33 (BATT_VBAT$33), U$2.P$34 (BATT_VBATT$34), U$2.P$35 (GEN_VBATT$35), U$2.P$36 (GEN_VBATT$36)
ESTIMAT: C52.1, D7.A, R41.1, R118.2, U$2.P$77 (ESTIMAT_VBAT), U$2.P$78 (ESTIMAT_VBAT)
GND: BLK1.GND@1 (GND), BLK1.GND@2 (GND), BLK1.GND@3 (GND), BLK1.GND@4 (GND), BLK1.GND@5 (GND), BLK1.GND@7 (GND), BLK1.GND@8 (GND), BLK1.GND@9 (GND), BLK1.GND@10 (GND), BLK1.GND@11 (GND), BLK1.GND@12 (GND), BLK1.GND@13 (GND), BLK1.GND@14 (GND), BLK1.GND@15 (GND), BLK1.GND@16 (GND), BLK1.GND@17 (GND), BLK1.GND@26 (GND), C1.2, C2.2, C3.2, C5.2, C7.2, C9.2, C10.2, C11.2, C12.2, C13.2, C14.2, C15.2, C16.2, C18.2, C19.2, C24.1, C25.1, C26.2, C28.2, C29.2, C30.2, C31.2, C33.1, C34.1, C38.2, C40.2, C41.2, C42.2, C43.2, C44.2, C45.2, C48.2, C49.2, C50.2, C52.2, C53.2, C54.2, C55.2, C56.2, C57.2, C58.2, C59.2, C60.2, C62.2, C64.2, C65.2, C66.2, C67.2, C68.2, C69.2, C70.2, C71.2, C72.2, C98.2, CONN1.P$3, CONN1.P$4, CONN2.P$3, CONN2.P$4, R2.2, R4.2, R6.2, R7.2, R10.2, R14.2, R18.2, R27.1, R29.2, R33.2, R37.2, R38.2, R39.2, R41.2, R42.2, R43.2, R44.2, R45.2, R49.2, R53.2, R58.2, R61.2, R67.2, R71.2, R76.1, R80.2, R84.2, R89.2, R91.2, R95.2, R101.1, R102.2, R106.2, R110.2, R114.2, R119.2, R121.2, R126.2, R128.2, R140.2, R144.2, R149.2, R151.2, R152.2, R_PULLDOWN.1, R_SLEW_1.1, R_SLEW_2.1, R_SLEW_3.1, R_SLEW_4.1, R_SLEW_5.1, R_SLEW_7.1, R_SLEW_8.1, R_SLEW_9.1, U2.P$2 (GND), U3.P$2 (GND), U$1.5 (GND), U$1.6 (GND), U$2.P$1 (PPT_GND), U$2.P$3 (PPT_GND), U$2.P$6 (PPT_GND), U$2.P$8 (PPT_GND), U$2.P$9 (PPT_GND), U$2.P$11 (PPT_GND), U$2.P$14 (PPT_GND), U$2.P$16 (PPT_GND), U$2.P$17 (DISTRI_GND), U$2.P$19 (DISTRI_GND), U$2.P$22 (DISTRI_GND), U$2.P$24 (DISTRI_GND), U$2.P$27 (DISTRI_GND), U$2.P$30 (DISTRI_GND), U$2.P$32 (DISTRI_GND), U$2.P$71 (WHEEL_GND), U$2.P$72 (WHEEL_GND), U$2.P$79 (ESTIMAT_GND), U$2.P$80 (ESTIMAT_GND), U$2.P$87 (BDOT_GND), U$2.P$88 (BDOT_GND), U$2.P$94 (RAHS_GND), U$2.P$98 (COM2_GND), U$2.P$100 (COM2_GND), U$2.P$102 (COM1_GND), U$2.P$104 (COM1_GND), U$5.3 (GND), U$6.3 (GND), U$8.2 (S), U$12.3 (GND), U$14.3 (GND), U$16.3 (GND), U$17.2 (S), U$20.3 (GND), U$24.3 (GND), U$25.3 (GND)
INA219_A0_1: R15.1, R16.1, R17.1, R18.1, U$5.7 (A0)
INA219_A0_2: R30.1, R31.1, R32.1, R33.1, U$6.7 (A0)
INA219_A0_4: R50.1, R51.1, R52.1, R53.1, U$12.7 (A0)
INA219_A0_5: R68.1, R69.1, R70.1, R71.1, U$14.7 (A0)
INA219_A0_6: R81.1, R82.1, R83.1, R84.1, U$16.7 (A0)
INA219_A0_7: R103.1, R104.1, R105.1, R106.1, U$25.7 (A0)
INA219_A0_8: R111.1, R112.1, R113.1, R114.1, U$20.7 (A0)
INA219_A0_10: R141.1, R142.1, R143.1, R144.1, U$24.7 (A0)
INA219_A1_1: R11.1, R12.1, R13.1, R14.1, U$5.8 (A1)
INA219_A1_2: R22.1, R23.1, R24.1, R29.1, U$6.8 (A1)
INA219_A1_4: R46.1, R47.1, R48.1, R49.1, U$12.8 (A1)
INA219_A1_5: R64.1, R65.1, R66.1, R67.1, U$14.8 (A1)
INA219_A1_6: R77.1, R78.1, R79.1, R80.1, U$16.8 (A1)
INA219_A1_7: R97.1, R98.1, R99.1, R102.1, U$25.8 (A1)
INA219_A1_8: R107.1, R108.1, R109.1, R110.1, U$20.8 (A1)
INA219_A1_10: R137.1, R138.1, R139.1, R140.1, U$24.8 (A1)
INA219_IN+_1: C4.1, R19.1, U$5.1 (IN+)
INA219_IN+_2: C6.1, R34.1, U$6.1 (IN+)
INA219_IN+_4: C27.1, R54.1, U$12.1 (IN+)
INA219_IN+_5: C46.1, R72.1, U$14.1 (IN+)
INA219_IN+_6: C39.1, R85.1, U$16.1 (IN+)
INA219_IN+_7: C61.1, R122.1, U$25.1 (IN+)
INA219_IN+_8: C51.1, R115.1, U$20.1 (IN+)
INA219_IN+_10: C63.1, R145.1, U$24.1 (IN+)
INA219_IN-_1: C4.2, R20.1, U$5.2 (IN-)
INA219_IN-_2: C6.2, R35.1, U$6.2 (IN-)
INA219_IN-_4: C27.2, R55.1, U$12.2 (IN-)
INA219_IN-_5: C46.2, R73.1, U$14.2 (IN-)
INA219_IN-_6: C39.2, R86.1, U$16.2 (IN-)
INA219_IN-_7: C61.2, R123.1, U$25.2 (IN-)
INA219_IN-_8: C51.2, R116.1, U$20.2 (IN-)
INA219_IN-_10: C63.2, R146.1, U$24.2 (IN-)
LDO_3V3_BYP2: C23.2, U2.P$4 (BYP)
LDO_5V_BYP2: C32.2, U3.P$4 (BYP)
LOAD: C13.1, C14.1, C57.1, C58.1, R1.2, R3.1, R20.2, R73.2, R93.2, R94.1
unnamed: C8.2, R25.1, R26.1, U$9.G
unnamed: C9.1, R27.2, R28.1, U$8.1 (G)
unnamed: D1.C, R2.1
unnamed: C11.1, R4.1, R60.1, U$11.P$5 (EN)
unnamed: R5.2, R100.1, R101.2
unnamed: R26.2, U$8.3 (D)
unnamed: BLK1.P1.0_A0, C98.1, R5.1
unnamed: R_SLEW_2.2, U$7.P$1 (R2)
unnamed: R_SLEW_1.2, U$11.P$1 (R2)
unnamed: C_SLEW_1.2, R_PULLUP1.1, U$11.P$6 (GATE)
unnamed: C_SLEW_2.2, R_PULLUP2.1, U$7.P$6 (GATE)
unnamed: R_SLEW_3.2, U$10.P$1 (R2)
unnamed: R_PULLUP3.1, U$10.P$6 (GATE)
unnamed: D3.C, R58.1
unnamed: C31.1, R59.1, R61.1, U$10.P$5 (EN)
unnamed: C47.2, R74.1, R75.1, U$18.G
unnamed: C48.1, R76.2, R92.1, U$17.1 (G)
unnamed: R75.2, U$17.3 (D)
unnamed: D4.C, R95.1
unnamed: R_SLEW_5.2, U$15.P$1 (R2)
unnamed: C_SLEW_5.2, R_PULLUP5.1, U$15.P$6 (GATE)
unnamed: D5.C, R89.1
unnamed: C43.1, R90.1, R91.1, U$15.P$5 (EN)
unnamed: BLK1.P3.5_GPIO_DEBUG, D2.A, U$1.8 (P3.5_GPIO_DEBUG)
unnamed: BLK1.P3.4_GPIO_DEBUG, U$1.7 (P3.4_GPIO_DEBUG)
unnamed: BLK1.P2.1_RXD, U$1.4 (P2.1_RXD)
unnamed: BLK1.P2.0_TXD, U$1.3 (P2.0_TXD)
unnamed: R_SLEW_7.2, U$19.P$1 (R2)
unnamed: C_SLEW_7.2, R_PULLUP7.1, U$19.P$6 (GATE)
unnamed: D7.C, R119.1
unnamed: C55.1, R120.1, R121.1, U$19.P$5 (EN)
unnamed: BLK1.SBWTDIO, U$1.2 (SBWTDIO)
unnamed: BLK1.SBWTCK, U$1.SBWTCK
unnamed: R_SLEW_4.2, U$13.P$1 (R2)
unnamed: C_SLEW_4.2, R_PULLUP4.1, U$13.P$6 (GATE)
unnamed: R_SLEW_9.2, U$23.P$1 (R2)
unnamed: C_SLEW_9.2, R_PULLUP9.1, U$23.P$6 (GATE)
unnamed: D9.C, R149.1
unnamed: C67.1, R150.1, R151.1, U$23.P$5 (EN)
unnamed: D10.C, R152.1
unnamed: D2.C, R6.1
unnamed: D8.C, R10.1
unnamed: D6.C, R7.1
unnamed: R_SLEW_8.2, U$22.P$1 (R2)
unnamed: C_SLEW_8.2, R_PULLUP8.1, U$22.P$6 (GATE)
unnamed: D11.C, R126.1
unnamed: C72.1, R127.1, R128.1, U$22.P$5 (EN)
OUTPUT1: C3.1, R35.2, R36.1, R40.1
OUTPUT3: C29.1, R55.2, R56.1, R57.1
OUTPUT4: C70.1, R123.2, R124.1, R125.1
OUTPUT5: C41.1, R86.2, R87.1, R88.1
OUTPUT7: C53.1, R116.2, R117.1, R118.1
OUTPUT9: C65.1, R146.2, R147.1, R148.1
OUT_1: C_SLEW_1.1, R34.2, R36.2, U$11.P$2 (DRAIN2), U$11.P$3 (DRAIN1)
OUT_3: R21.1, R54.2, R56.2, U$10.P$2 (DRAIN2), U$10.P$3 (DRAIN1)
OUT_4: C_SLEW_8.1, R122.2, R124.2, U$22.P$2 (DRAIN2), U$22.P$3 (DRAIN1)
OUT_5: C_SLEW_5.1, R85.2, R87.2, U$15.P$2 (DRAIN2), U$15.P$3 (DRAIN1)
OUT_7: C_SLEW_7.1, R115.2, R117.2, U$19.P$2 (DRAIN2), U$19.P$3 (DRAIN1)
OUT_9: C_SLEW_9.1, R145.2, R147.2, U$23.P$2 (DRAIN2), U$23.P$3 (DRAIN1)
PPT: C15.1, C16.1, C18.1, C19.1, R3.2, R45.1, U$2.P$2 (PPT_VBAT), U$2.P$4 (PPT_VBAT), U$2.P$5 (PPT_VBAT), U$2.P$7 (PPT_VBAT), U$2.P$10 (PPT_VBAT), U$2.P$12 (PPT_VBAT), U$2.P$13 (PPT_VBAT), U$2.P$15 (PPT_VBAT)
RAHS: C40.1, D5.A, R39.1, R88.2, U$2.P$93 (RAHS_VBAT)
SCL: BLK1.P7.1_I2C-SCL-2, JP1.3, JP1.4, JP2.3, JP2.4, JP3.3, JP3.4, JP4.3, JP4.4, JP5.3, JP5.4, JP6.3, JP6.4, JP7.3, JP7.4, JP8.3, JP8.4, R9.1, R12.2, R16.2, R23.2, R31.2, R47.2, R51.2, R65.2, R69.2, R78.2, R82.2, R98.2, R104.2, R108.2, R112.2, R138.2, R142.2, U$5.5 (SCL), U$6.5 (SCL), U$12.5 (SCL), U$14.5 (SCL), U$16.5 (SCL), U$20.5 (SCL), U$24.5 (SCL), U$25.5 (SCL)
SDA: BLK1.P7.0_I2C-SDA-2, JP1.5, JP1.6, JP2.5, JP2.6, JP3.5, JP3.6, JP4.5, JP4.6, JP5.5, JP5.6, JP6.5, JP6.6, JP7.5, JP7.6, JP8.5, JP8.6, R8.1, R11.2, R15.2, R22.2, R30.2, R46.2, R50.2, R64.2, R68.2, R77.2, R81.2, R97.2, R103.2, R107.2, R111.2, R137.2, R141.2, U$5.6 (SDA), U$6.6 (SDA), U$12.6 (SDA), U$14.6 (SDA), U$16.6 (SDA), U$20.6 (SDA), U$24.6 (SDA), U$25.6 (SDA)
VBAT: C7.1, C12.1, C24.2, C30.1, C33.2, C42.1, C54.1, C56.1, C66.1, C71.1, R21.2, R25.2, R74.2, R100.2, R_PULLUP1.2, R_PULLUP3.2, R_PULLUP4.2, R_PULLUP5.2, R_PULLUP7.2, R_PULLUP8.2, R_PULLUP9.2, U2.P$1 (IN), U2.P$3 (EN), U3.P$1 (IN), U3.P$3 (EN), U$2.P$18 (DISTRI_VBAT), U$2.P$20 (DISTRI_VBAT), U$2.P$21 (DISTRI_VBAT), U$2.P$23 (DISTRI_VBAT), U$2.P$26 (DISTRI_VBAT), U$2.P$28 (DISTRI_VBAT), U$2.P$29 (DISTRI_VBAT), U$2.P$31 (DISTRI_VBAT), U$9.S1 (S), U$9.S2 (S), U$9.S3 (S), U$10.P$4 (IN), U$11.P$4 (IN), U$13.P$4 (IN), U$15.P$4 (IN), U$18.S1 (S), U$18.S2 (S), U$18.S3 (S), U$19.P$4 (IN), U$22.P$4 (IN), U$23.P$4 (IN)
WHEEL: C64.1, D9.A, R42.1, R148.2, U$2.P$69 (WHEEL_VBAT), U$2.P$70 (WHEEL_VBAT)

Notes on the sheet:
Address Selection
Pi filter for use only if noise present begin by do not populate if needed, add 100ohm series, and 1uF caps
I2C Address: 1000000
I2C Address: 1000001
I2C Address: 1000010
I2C Address: 1000011
I2C Address: 1000100
I2C Address: 1000101
I2C Address: 1001110
I2C Address: 1000110
DNP
resetable fuse in case of latch up

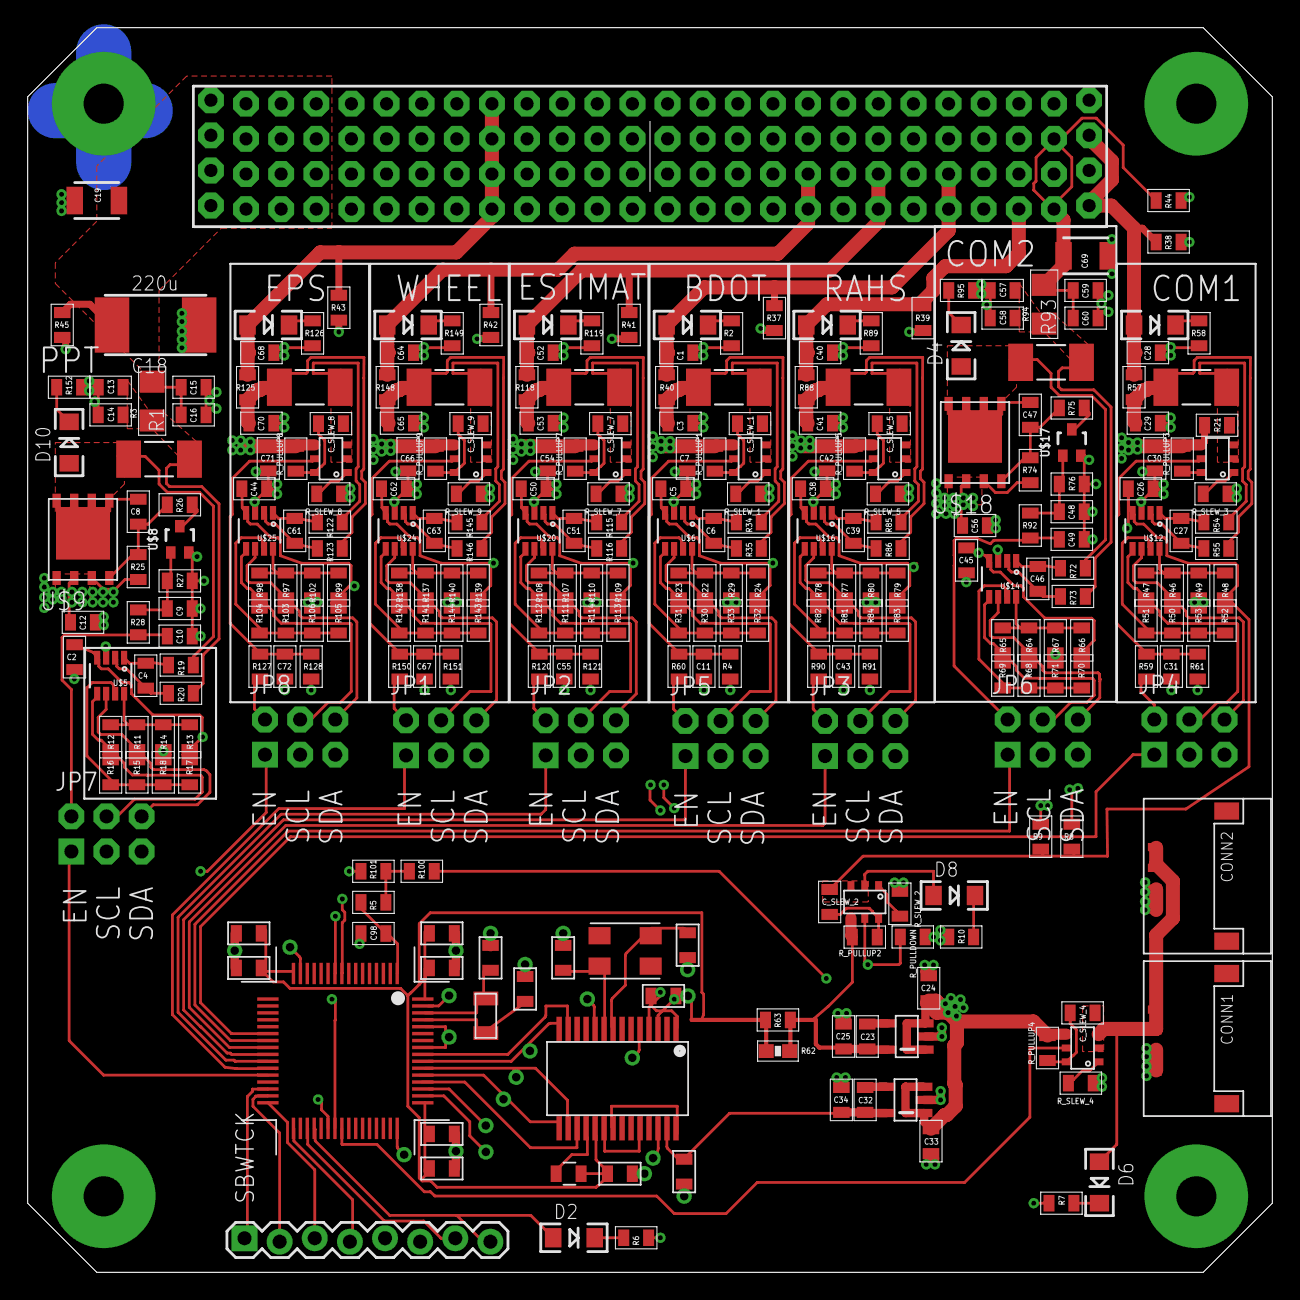
[picture p91: board distribution_board_f1.brd from above]

Board: 4 copper layers, 90.0 x 90.0 mm, 280 parts (0 on the bottom side), 122 nets.
