UWCubeSat/DubSat1/teams/power/Flight/Battery/Battery_Board_f1.brd

## EAGLE design teams/power/Flight/Battery/Battery_Board_f1.brd (2019-07-06)

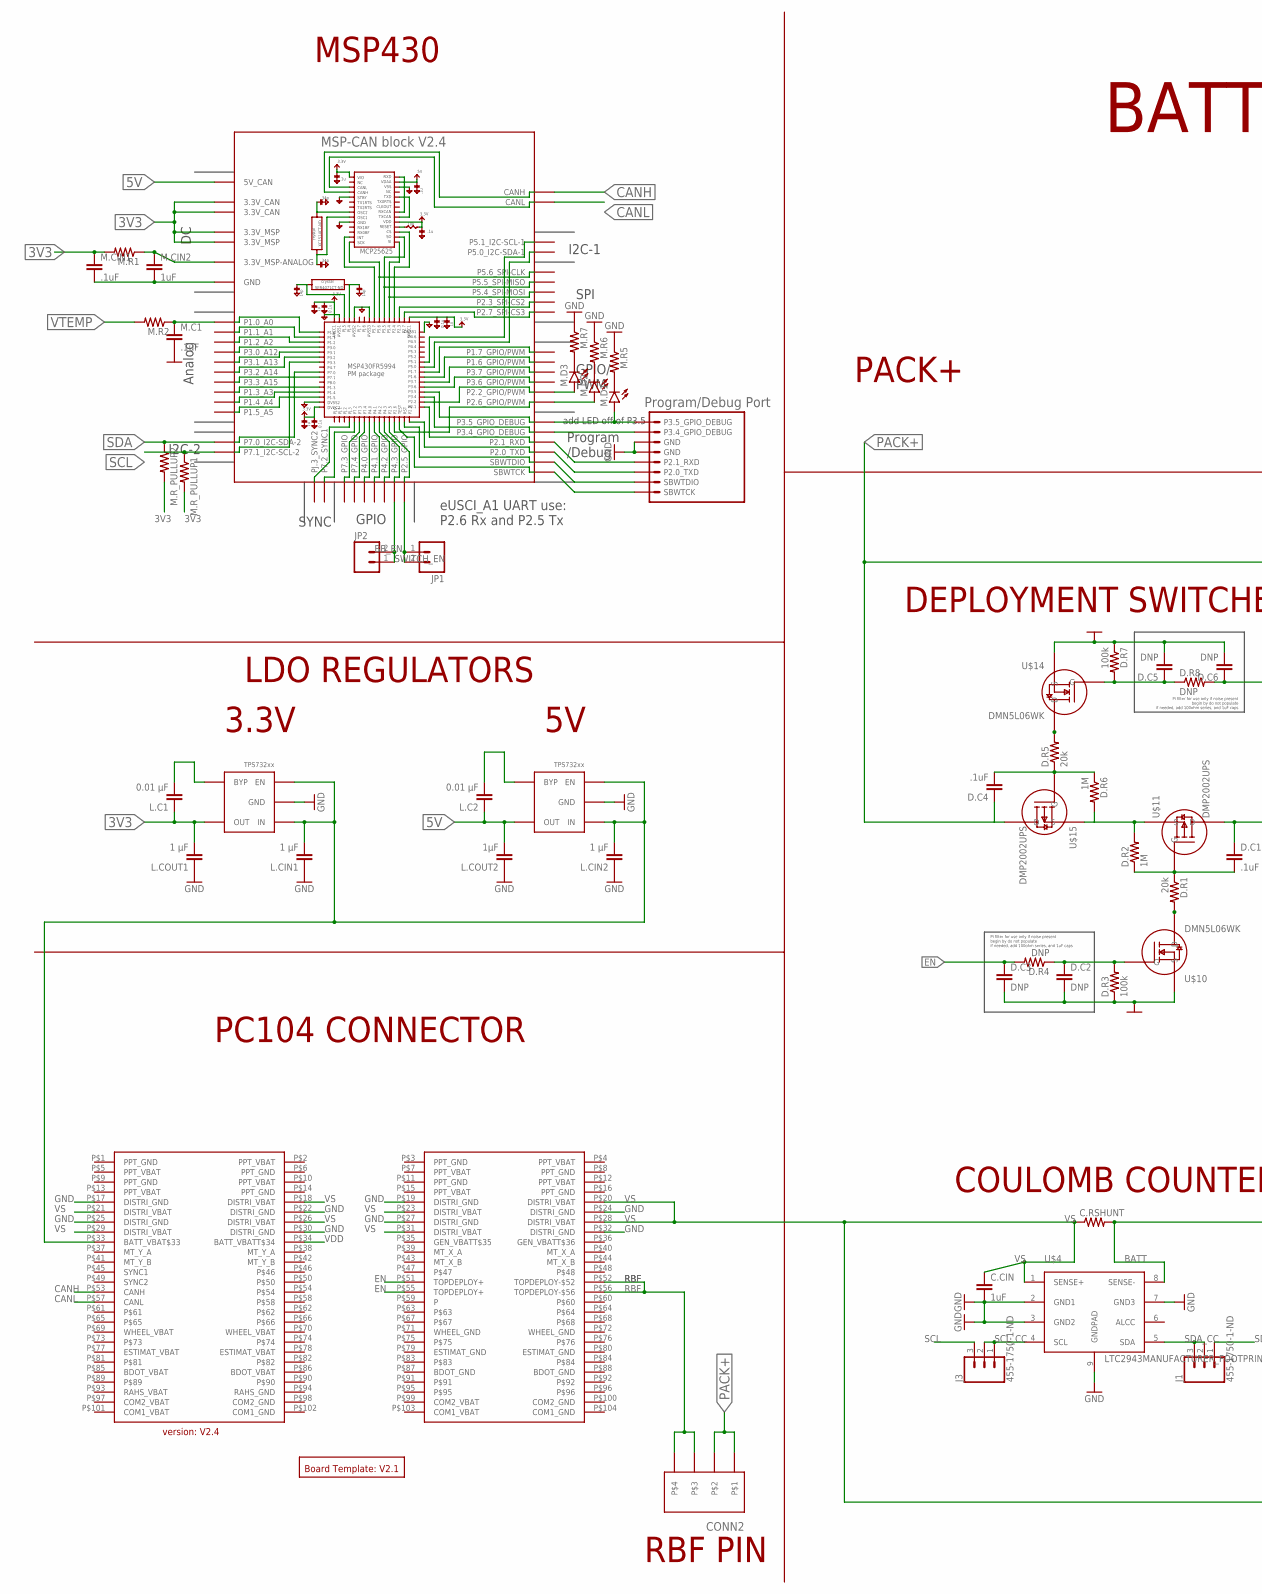
[picture p92: schematic Battery_Board_f1.sch, part in row 1, column 1]

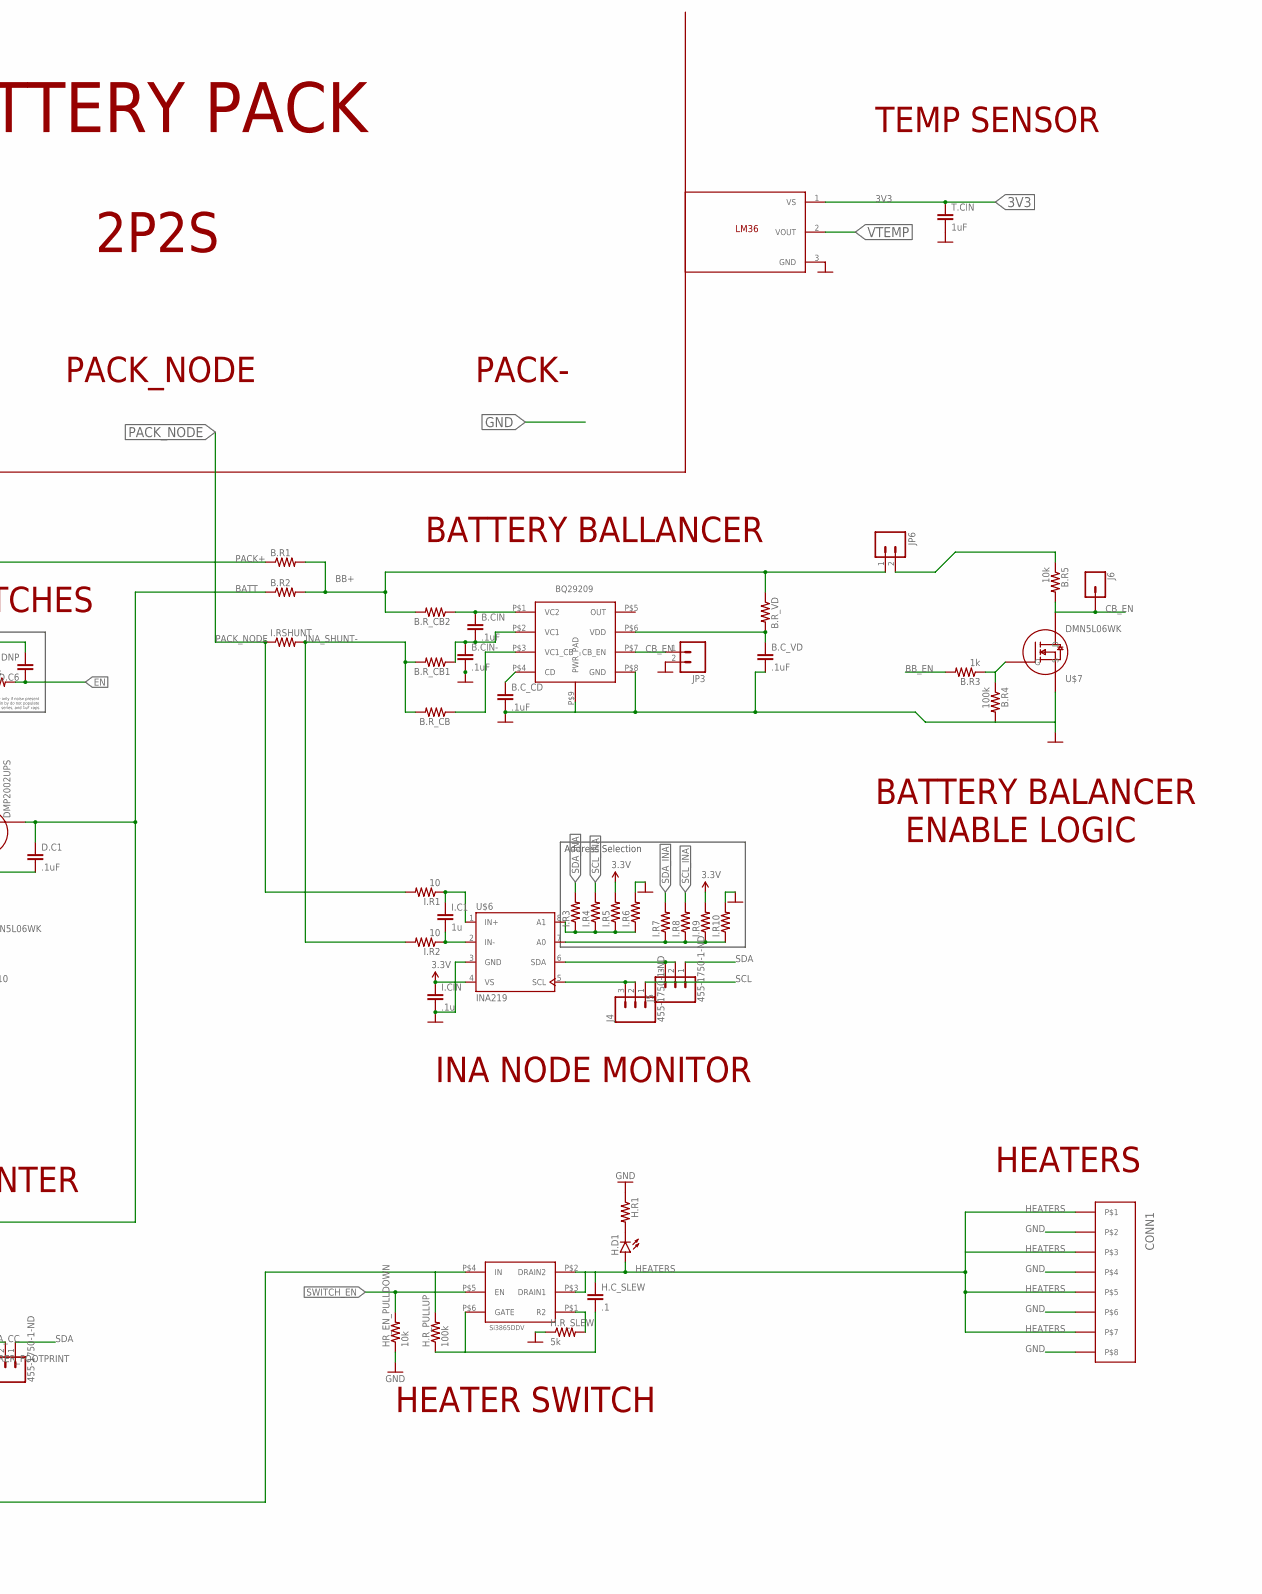
[picture p93: schematic Battery_Board_f1.sch, part in row 1, column 2]

Parts:
B.CIN, B.CIN-, B.C_CD, B.C_VD: .1uF; 0805
B.R1, B.R2, B.R_CB, B.R_CB1, B.R_CB2, B.R_VD: RESISTOR0805; 0805
B.R3: 1k; 0805
B.R4: 100k; 0805
B.R5: 10k; 0805
BLK1: MSP-CAN_BLOCK
C.CIN: 1uF; 0805
C.RSHUNT: RESISTOR2512; R2512
CONN1: PICOLOCK_8PICOLOCK_8; PICOLOCK_8
CONN2: PICOLOCK_4PICOLOCK_4; PICOLOCK_4
D.C1, D.C4: .1uF; 0805
D.C2, D.C3, D.C5, D.C6, D.R4, D.R8: DNP; 0805
D.R1, D.R5: 20k; 0805
D.R2, D.R6: 1M; 0805
D.R3, D.R7: 100k; 0805
H.C_SLEW: .1; 0805
H.D1: LED; LED-1206
H.R1: RESISTOR0805; 0805
H.R_PULLUP: 100k; 0805
H.R_SLEW: 5k; 0805
HR_EN_PULLDOWN: 10k; 0805
I.C1: 1u; 0805
I.CIN: .1u; 0805
I.R1, I.R2: 10; 0805
I.R3, I.R4, I.R5, I.R6, I.R7, I.R8, I.R9, I.R10: RESISTOR0805; 0805
I.RSHUNT: RESISTOR2010; R2010
J1, J3, J4, J5: 455-1750-1-ND; 1X03
J6: CONN_01; 1X01
JP1, JP2, JP3, JP6: M02LOCK; 1X02_LOCK
L.C1, L.C2: 0.01 μF; 0805
L.CIN1, L.CIN2, L.COUT1: 1 μF; 0805
L.COUT2: 1μF; 0805
M.C1, M.CIN1: .1uF; 0805
M.CIN2: 1uF; 0805
M.D1, M.D2, M.D3: LED; LED-1206
M.R1, M.R2, M.R5, M.R6, M.R7, M.R_PULLUP1, M.R_PULLUP2: RESISTOR0805; 0805
T.CIN: 1uF; 0805
U1, U4: TPS732XX; SOT-23-5
U$1: BOARD_TEMPLATE3D; BOARD_TEMPLATE
U$2: PC104_CONNECTOR
U$4: LTC2943MANUFACTURER_FOOTPRINT; DFN-8_DD
U$5: BQ29209; VSON8
U$6: INA219; SOT-23-8
U$7, U$10, U$14: DMN5L06WK; SOT-323
U$8: LM36; TO-92-3
U$11, U$15: DMP2002UPS; POWERDI5060-8
U$12: PROGRAM/DEBUG_PORT; 1X08_CONNECTOR
U$16: SI3865DDV; TSOP-6

Connections:
3V3: BLK1.3.3V@CAN1 (3.3V_CAN), BLK1.3.3V@CAN2 (3.3V_CAN), BLK1.3.3V@MSP1 (3.3V_MSP), BLK1.3.3V@MSP2 (3.3V_MSP), I.CIN.1, I.R5.2, I.R9.2, L.C1.1, L.COUT1.2, M.CIN1.1, M.R1.2, M.R_PULLUP1.2, M.R_PULLUP2.2, T.CIN.1, U1.P$5 (OUT), U$6.4 (VS), U$8.1 (VS)
3V3_MSP-ANALOG: BLK1.3.3V_ANALOG@MSP2 (3.3V_MSP-ANALOG), M.CIN2.1, M.R1.1
5V: BLK1.5V (5V_CAN), L.C2.1, L.COUT2.2, U4.P$5 (OUT)
BATT: B.R2.1, C.RSHUNT.2, D.C1.1, U$4.8 (SENSE-), U$11.D1 (D), U$11.D2 (D), U$11.D3 (D), U$11.D4 (D), U$11.D5 (D)
BB+: B.R1.2, B.R2.2, B.R_CB2.2, B.R_VD.1, JP6.1
BB_EN: B.R3.2, BLK1.P4.3_GPIO, JP2.1, JP2.2
CANH: BLK1.CANH, U$2.P$53 (CANH)
CANL: BLK1.CANL, U$2.P$57 (CANL)
CB_EN: B.R5.2, J6.1, JP3.1, U$5.P$7 (CB_EN), U$7.3 (D)
EN: D.C3.1, D.C6.1, D.R4.2, D.R8.2, U$2.P$51 (TOPDEPLOY+), U$2.P$55 (TOPDEPLOY+)
GND: B.CIN-.2, B.C_CD.2, B.C_VD.2, B.R4.2, BLK1.GND@1 (GND), BLK1.GND@2 (GND), BLK1.GND@3 (GND), BLK1.GND@4 (GND), BLK1.GND@5 (GND), BLK1.GND@7 (GND), BLK1.GND@8 (GND), BLK1.GND@9 (GND), BLK1.GND@10 (GND), BLK1.GND@11 (GND), BLK1.GND@12 (GND), BLK1.GND@13 (GND), BLK1.GND@14 (GND), BLK1.GND@15 (GND), BLK1.GND@16 (GND), BLK1.GND@17 (GND), BLK1.GND@26 (GND), C.CIN.2, CONN1.P$2, CONN1.P$4, CONN1.P$6, CONN1.P$8, D.C2.2, D.C3.2, D.C5.2, D.C6.2, D.R3.1, D.R7.1, H.R1.1, H.R_SLEW.1, HR_EN_PULLDOWN.1, I.CIN.2, I.R6.2, I.R10.2, JP3.2, L.CIN1.1, L.CIN2.1, L.COUT1.1, L.COUT2.1, M.C1.2, M.CIN1.2, M.CIN2.2, M.R5.1, M.R6.1, M.R7.1, T.CIN.2, U1.P$2 (GND), U4.P$2 (GND), U$2.P$17 (DISTRI_GND), U$2.P$19 (DISTRI_GND), U$2.P$22 (DISTRI_GND), U$2.P$24 (DISTRI_GND), U$2.P$25 (DISTRI_GND), U$2.P$27 (DISTRI_GND), U$2.P$30 (DISTRI_GND), U$2.P$32 (DISTRI_GND), U$4.2 (GND1), U$4.3 (GND2), U$4.7 (GND3), U$4.9 (GNDPAD), U$5.P$8 (GND), U$5.P$9 (PWR_PAD), U$6.3 (GND), U$7.2 (S), U$8.3 (GND), U$10.2 (S), U$12.5 (GND), U$12.6 (GND), U$14.2 (S)
HEATERS: CONN1.P$1, CONN1.P$3, CONN1.P$5, CONN1.P$7, H.C_SLEW.1, H.D1.A, U$16.P$2 (DRAIN2), U$16.P$3 (DRAIN1)
IN: D.R2.2, D.R6.2, U$11.S1 (S), U$11.S2 (S), U$11.S3 (S), U$15.S1 (S), U$15.S2 (S), U$15.S3 (S)
INA219_A0_1: I.R7.1, I.R8.1, I.R9.1, I.R10.1, U$6.7 (A0)
INA219_A1_1: I.R3.1, I.R4.1, I.R5.1, I.R6.1, U$6.8 (A1)
INA219_IN+_1: I.C1.1, I.R1.1, U$6.1 (IN+)
INA219_IN-_1: I.C1.2, I.R2.1, U$6.2 (IN-)
INA_SHUNT-: B.R_CB.2, B.R_CB1.2, I.R2.2, I.RSHUNT.2
LDO_3V3_BYP1: L.C1.2, U1.P$4 (BYP)
LDO_5V_BYP1: L.C2.2, U4.P$4 (BYP)
unnamed: BLK1.P3.5_GPIO_DEBUG, M.D1.A, U$12.8 (P3.5_GPIO_DEBUG)
unnamed: B.R5.1, JP6.2
unnamed: BLK1.P3.4_GPIO_DEBUG, U$12.7 (P3.4_GPIO_DEBUG)
unnamed: BLK1.P2.1_RXD, U$12.4 (P2.1_RXD)
unnamed: B.CIN.1, B.R_CB2.1, U$5.P$1 (VC2)
unnamed: B.CIN.2, B.CIN-.1, B.R_CB1.1, U$5.P$2 (VC1)
unnamed: D.C1.2, D.R1.1, D.R2.1, U$11.G
unnamed: D.C2.1, D.R3.2, D.R4.1, U$10.1 (G)
unnamed: B.R_CB.1, U$5.P$3 (VC1_CB)
unnamed: B.C_CD.1, U$5.P$4 (CD)
unnamed: D.R1.2, U$10.3 (D)
unnamed: B.R3.1, B.R4.1, U$7.1 (G)
unnamed: B.C_VD.1, B.R_VD.2, U$5.P$6 (VDD)
unnamed: D.C4.2, D.R5.1, D.R6.1, U$15.G
unnamed: D.C5.1, D.R7.2, D.R8.1, U$14.1 (G)
unnamed: D.R5.2, U$14.3 (D)
unnamed: BLK1.P2.0_TXD, U$12.3 (P2.0_TXD)
unnamed: BLK1.SBWTDIO, U$12.2 (SBWTDIO)
unnamed: BLK1.SBWTCK, U$12.SBWTCK
unnamed: M.D1.C, M.R5.2
unnamed: BLK1.P1.0_A0, M.C1.1, M.R2.1
unnamed: M.D2.C, M.R6.2
unnamed: M.D3.C, M.R7.2
unnamed: H.R_SLEW.2, U$16.P$1 (R2)
unnamed: H.C_SLEW.2, H.R_PULLUP.1, U$16.P$6 (GATE)
unnamed: BLK1.P2.2_GPIO/PWM, M.D3.A
unnamed: BLK1.P2.6_GPIO/PWM, M.D2.A
unnamed: H.D1.C, H.R1.2
PACK+: B.R1.1, CONN2.P$1, CONN2.P$2, D.C4.1, U$15.D1 (D), U$15.D2 (D), U$15.D3 (D), U$15.D4 (D), U$15.D5 (D)
PACK_NODE: I.R1.2, I.RSHUNT.1
RBF: CONN2.P$3, CONN2.P$4, U$2.P$52 (TOPDEPLOY-$52), U$2.P$56 (TOPDEPLOY-$56)
SCL: BLK1.P7.1_I2C-SCL-2, J3.3, J4.1, M.R_PULLUP1.1
SCL_CC: J3.1, J3.2, U$4.4 (SCL)
SCL_INA: I.R4.2, I.R8.2, J4.2, J4.3, U$6.5 (SCL)
SDA: BLK1.P7.0_I2C-SDA-2, J1.1, J5.1, M.R_PULLUP2.1
SDA_CC: J1.2, J1.3, U$4.5 (SDA)
SDA_INA: I.R3.2, I.R7.2, J5.2, J5.3, U$6.6 (SDA)
SWITCH_EN: BLK1.P2.5_GPIO, HR_EN_PULLDOWN.2, JP1.1, JP1.2, U$16.P$5 (EN)
VDD: L.CIN1.2, L.CIN2.2, U1.P$1 (IN), U1.P$3 (EN), U4.P$1 (IN), U4.P$3 (EN), U$2.P$33 (BATT_VBAT$33), U$2.P$34 (BATT_VBATT$34)
VS: C.CIN.1, C.RSHUNT.1, H.R_PULLUP.2, U$2.P$18 (DISTRI_VBAT), U$2.P$20 (DISTRI_VBAT), U$2.P$21 (DISTRI_VBAT), U$2.P$23 (DISTRI_VBAT), U$2.P$26 (DISTRI_VBAT), U$2.P$28 (DISTRI_VBAT), U$2.P$29 (DISTRI_VBAT), U$2.P$31 (DISTRI_VBAT), U$4.1 (SENSE+), U$16.P$4 (IN)
VTEMP: M.R2.2, U$8.2 (VOUT)

Notes on the sheet:
Address Selection
Pi filter for use only if noise present begin by do not populate if needed, add 100ohm series, and 1uF caps
BATTERY PACK
2P2S
PACK+
PACK_NODE
PACK-
DEPLOYMENT SWITCHES
COULOMB COUNTER
HEATER SWITCH
HEATERS
LDO REGULATORS
3.3V
INA NODE MONITOR
BATTERY BALLANCER
BATTERY BALANCER ENABLE LOGIC
TEMP SENSOR
MSP430
PC104 CONNECTOR
RBF PIN
