UWCubeSat/DubSat1/teams/power/Flight/Battery/Battery_Board_f1.brd

## EAGLE design teams/power/Flight/Battery/Battery_Board_f1.brd (continued)

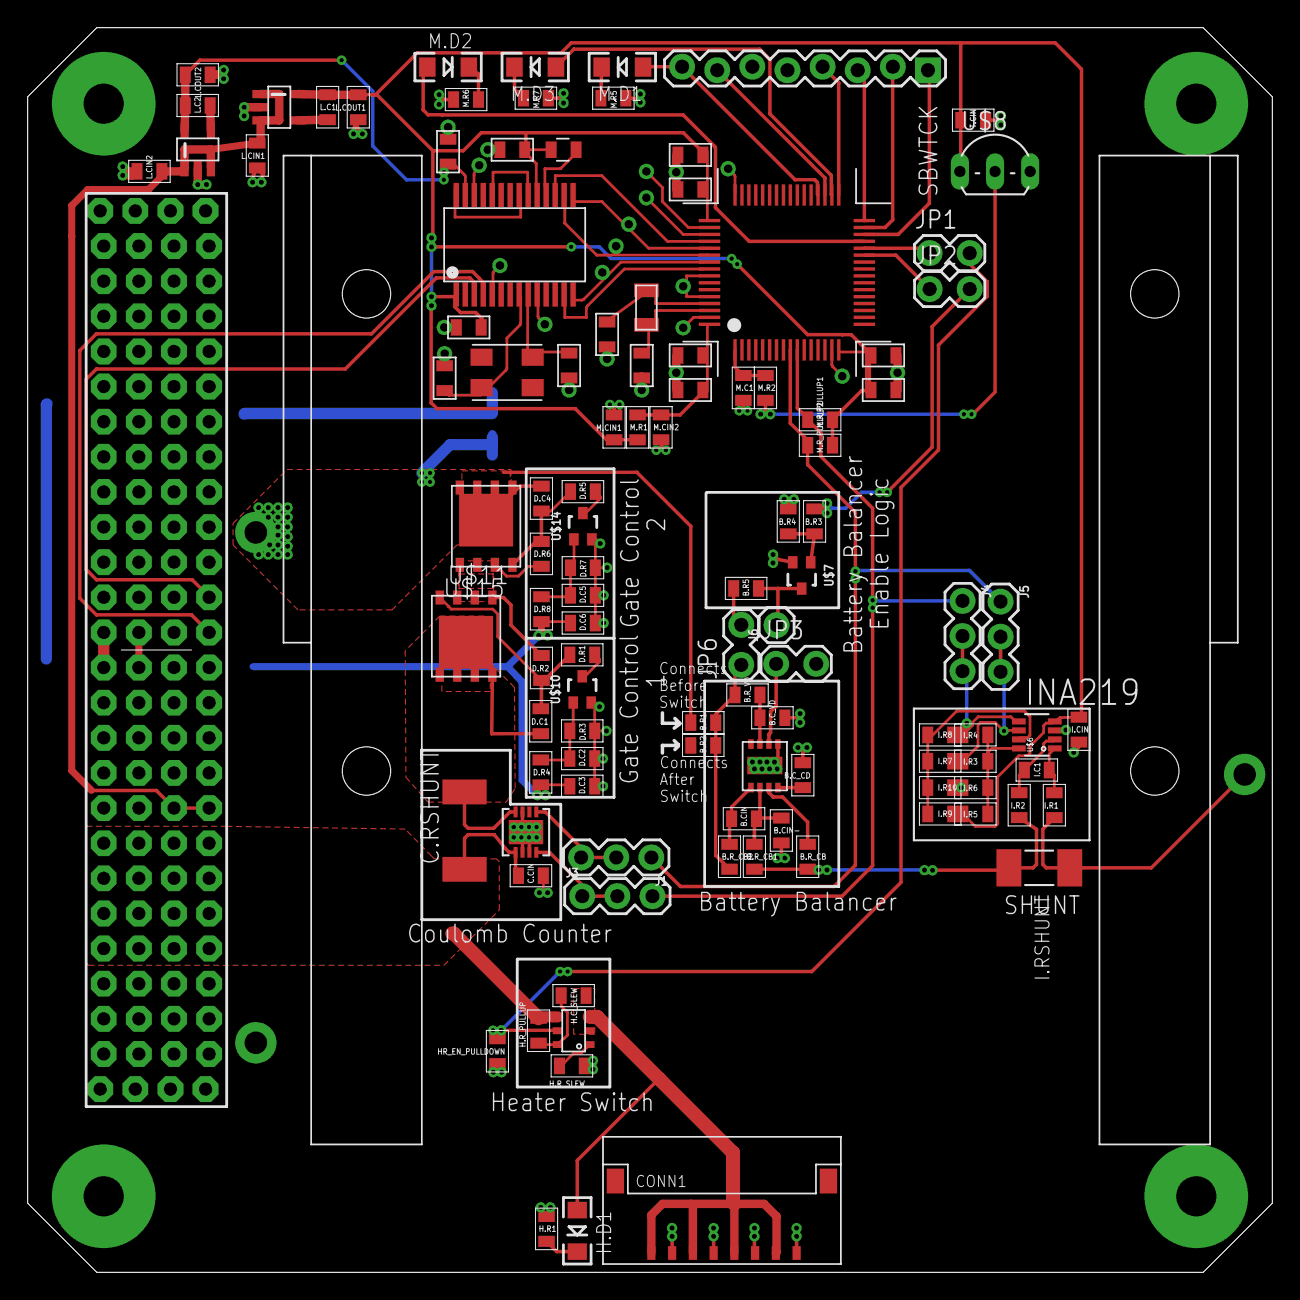
[picture p94: board Battery_Board_f1.brd from above]

Board: 2 copper layers, 90.0 x 90.0 mm, 96 parts (1 on the bottom side), 61 nets.

Other parts of the board:
U$9: BATTERY_HOLDERS
