UWCubeSat/DubSat1/teams/adcs/hardware/flight_model/flight_computer/flight_computer_board_f1.brd

## EAGLE design teams/adcs/hardware/flight_model/flight_computer/flight_computer_board_f1.brd (2019-07-06)

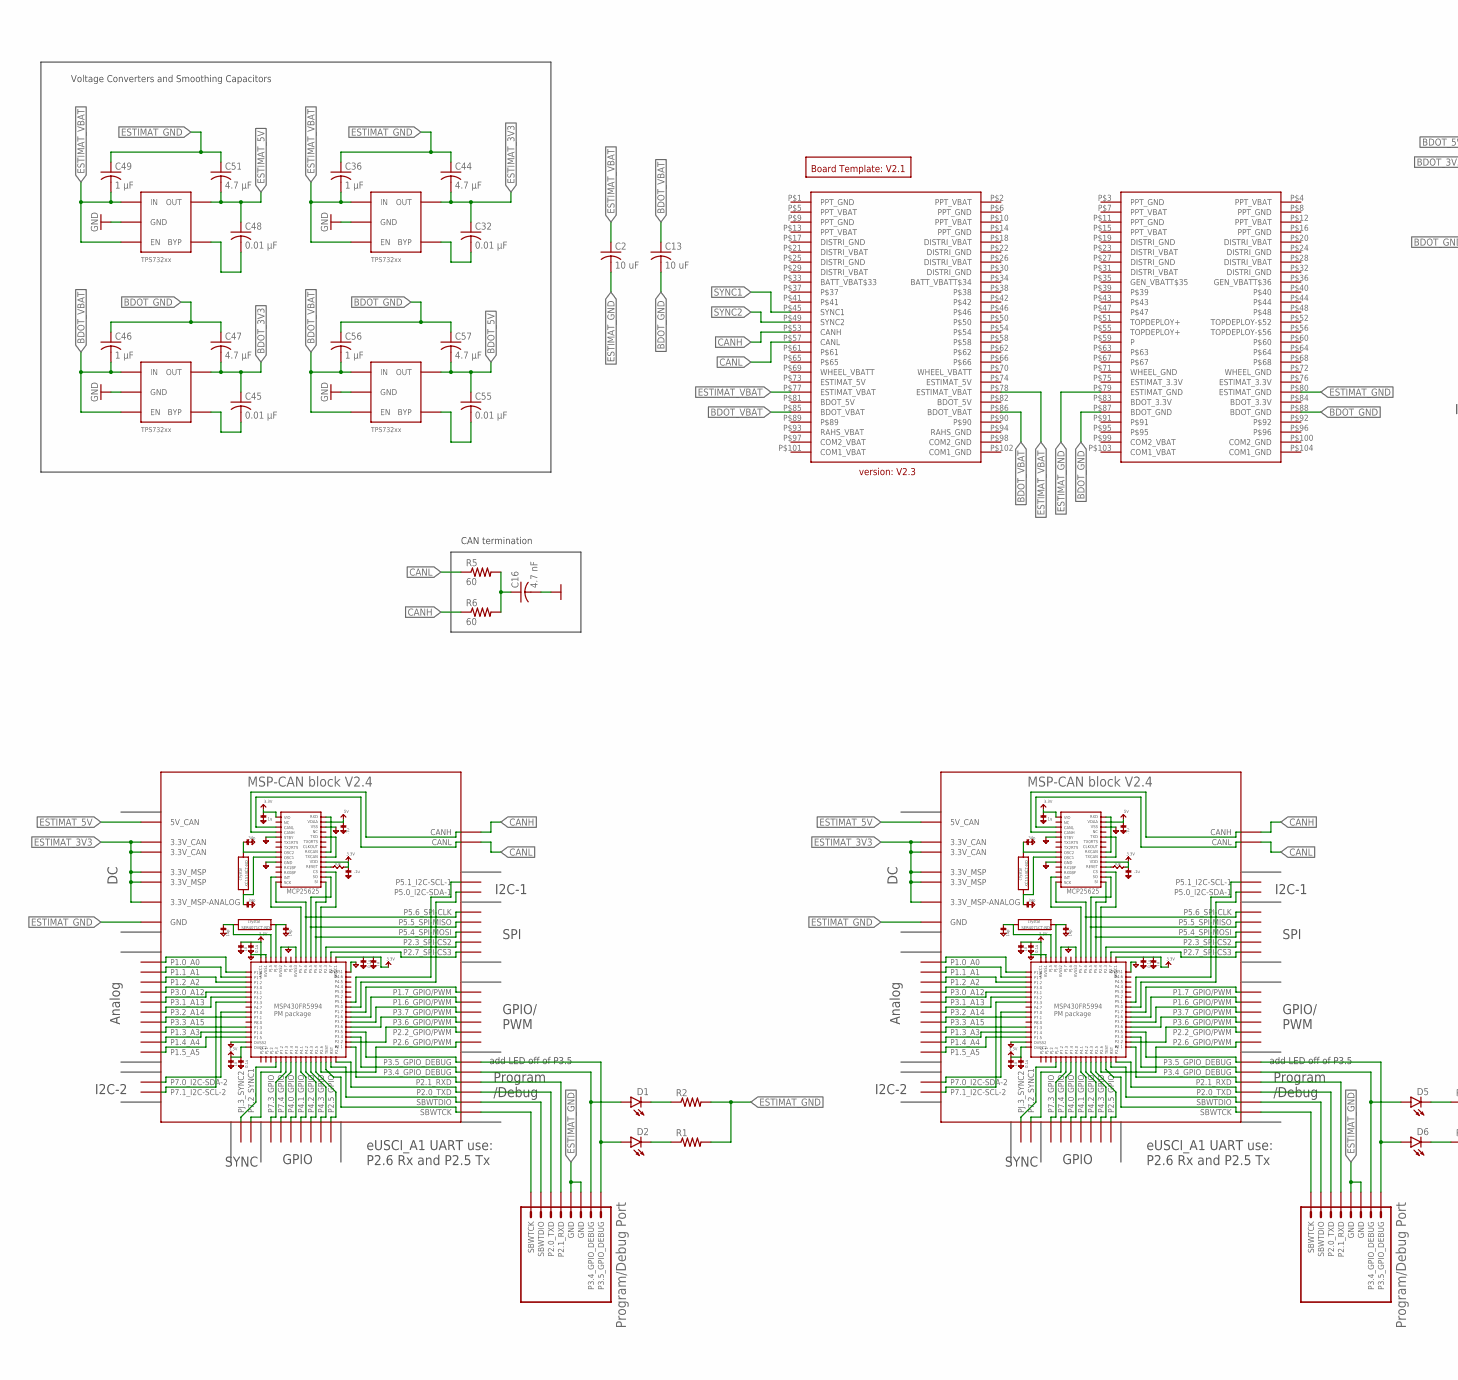
[picture p95: schematic flight_computer_board_f1.sch, part in row 1, column 1]

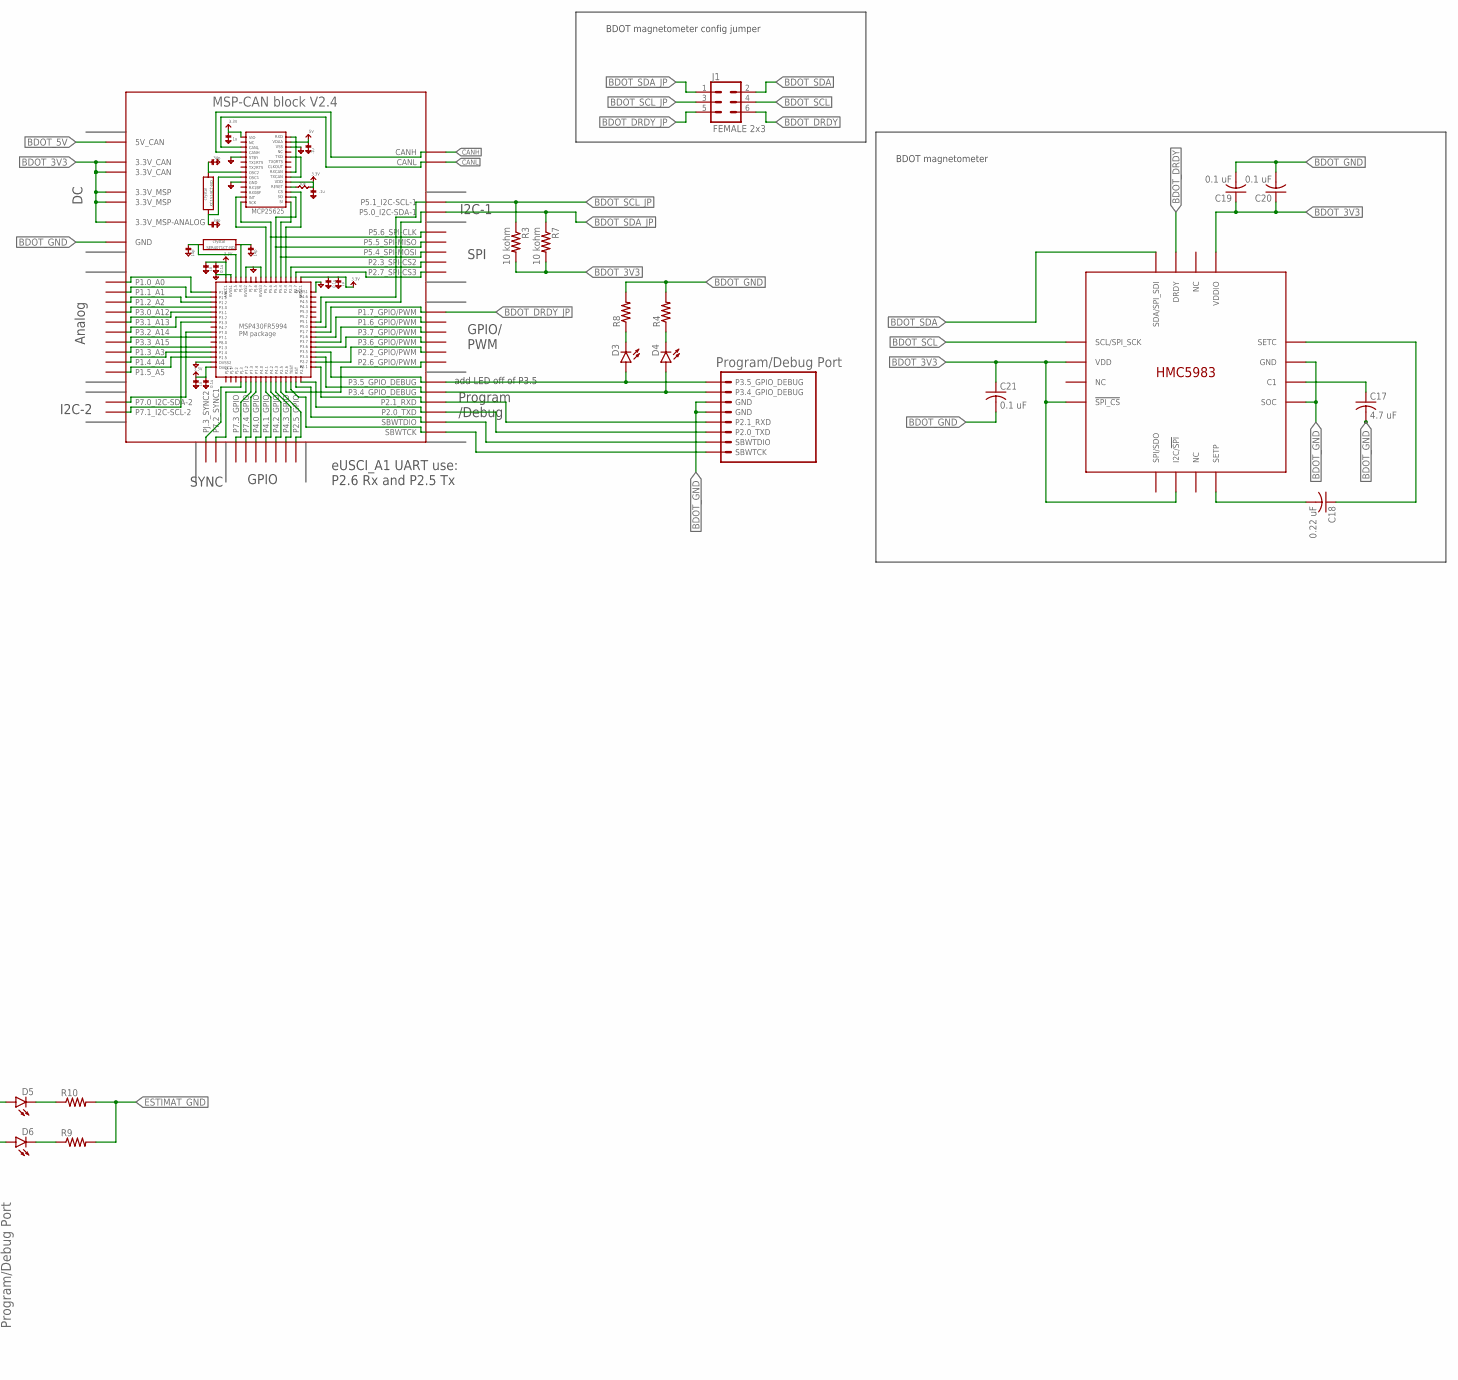
[picture p96: schematic flight_computer_board_f1.sch, part in row 1, column 2]

Parts:
BLK1, BLK2: MSP-CAN_BLOCK
C2, C13: 10 uF; C0805
C16: 4.7 nF; C0805
C17: 4.7 uF; C0805
C18: 0.22 uF; C0805
C19, C20, C21: 0.1 uF; C0805
C32, C45, C48, C55: 0.01 μF; C0805
C36, C46, C49, C56: 1 μF; C0805
C44, C47, C51, C57: 4.7 μF; C0805
D1, D2, D3, D4, D5, D6: LED; LED-1206
J1: FEMALE 2x3; 2X3
R1, R2, R4, R8, R9, R10: RESISTOR0805; 0805
R3, R7: 10 kohm; 0805
R5, R6: 60; 0805
U4, U5, U6, U8: TPS732XX; SOT-23-5
U$1, U$2, U$14: PROGRAM/DEBUG_PORT; 1X08_CONNECTOR
U$5: BOARD_TEMPLATE1; BOARD_TEMPLATE
U$6: PC104_CONNECTOR
U$7: MSP-CAN_BLOCK
U$15: HMC5983

Connections:
BDOT_3V3: C19.1, C20.1, C21.1, C45.1, C47.2, R3.2, R7.2, U5.P$5 (OUT), U$7.3.3V@CAN1 (3.3V_CAN), U$7.3.3V@CAN2 (3.3V_CAN), U$7.3.3V@MSP1 (3.3V_MSP), U$7.3.3V@MSP2 (3.3V_MSP), U$7.3.3V_ANALOG@MSP2 (3.3V_MSP-ANALOG), U$15.!SPI_CS, U$15.I2C/!SPI, U$15.VDD, U$15.VDDIO
BDOT_5V: C55.1, C57.2, U8.P$5 (OUT), U$7.5V (5V_CAN)
BDOT_DRDY: J1.6, U$15.DRDY
BDOT_DRDY_JP: J1.5, U$7.P1.7_GPIO/PWM
BDOT_GND: C13.2, C17.2, C19.2, C20.2, C21.2, C46.1, C47.1, C56.1, C57.1, R4.2, R8.2, U5.P$2 (GND), U8.P$2 (GND), U$6.P$87 (BDOT_GND), U$6.P$88 (BDOT_GND), U$7.GND@1 (GND), U$7.GND@2 (GND), U$7.GND@3 (GND), U$7.GND@4 (GND), U$7.GND@5 (GND), U$7.GND@7 (GND), U$7.GND@8 (GND), U$7.GND@9 (GND), U$7.GND@10 (GND), U$7.GND@11 (GND), U$7.GND@12 (GND), U$7.GND@13 (GND), U$7.GND@14 (GND), U$7.GND@15 (GND), U$7.GND@16 (GND), U$7.GND@17 (GND), U$7.GND@26 (GND), U$14.5 (GND), U$14.6 (GND), U$15.GND, U$15.SOC
BDOT_LDO_3V3_BYP: C45.2, U5.P$4 (BYP)
BDOT_LDO_5V_BYP: C55.2, U8.P$4 (BYP)
BDOT_P3.4_GPIO_DEBUG: D4.A, U$7.P3.4_GPIO_DEBUG, U$14.7 (P3.4_GPIO_DEBUG)
BDOT_P3.5_GPIO_DEBUG: D3.A, U$7.P3.5_GPIO_DEBUG, U$14.8 (P3.5_GPIO_DEBUG)
BDOT_RXD: U$7.P2.1_RXD, U$14.4 (P2.1_RXD)
BDOT_SBWTCK: U$7.SBWTCK, U$14.SBWTCK
BDOT_SBWTDIO: U$7.SBWTDIO, U$14.2 (SBWTDIO)
BDOT_SCL: J1.4, U$15.SCL/SPI_SCK
BDOT_SCL_JP: J1.3, R3.1, U$7.P5.1_I2C-SCL-1
BDOT_SDA: J1.2, U$15.SDA/SPI_SDI
BDOT_SDA_JP: J1.1, R7.1, U$7.P5.0_I2C-SDA-1
BDOT_TXD: U$7.P2.0_TXD, U$14.3 (P2.0_TXD)
BDOT_VBAT: C13.1, C46.2, C56.2, U5.P$1 (IN), U5.P$3 (EN), U8.P$1 (IN), U8.P$3 (EN), U$6.P$85 (BDOT_VBAT), U$6.P$86 (BDOT_VBAT)
CANH: BLK1.CANH, BLK2.CANH, R6.1, U$6.P$53 (CANH), U$7.CANH
CANL: BLK1.CANL, BLK2.CANL, R5.1, U$6.P$57 (CANL), U$7.CANL
ESTIMAT_3V3: BLK1.3.3V@CAN1 (3.3V_CAN), BLK1.3.3V@CAN2 (3.3V_CAN), BLK1.3.3V@MSP1 (3.3V_MSP), BLK1.3.3V@MSP2 (3.3V_MSP), BLK1.3.3V_ANALOG@MSP2 (3.3V_MSP-ANALOG), BLK2.3.3V@CAN1 (3.3V_CAN), BLK2.3.3V@CAN2 (3.3V_CAN), BLK2.3.3V@MSP1 (3.3V_MSP), BLK2.3.3V@MSP2 (3.3V_MSP), BLK2.3.3V_ANALOG@MSP2 (3.3V_MSP-ANALOG), C32.1, C44.2, U4.P$5 (OUT)
ESTIMAT_5V: BLK1.5V (5V_CAN), BLK2.5V (5V_CAN), C48.1, C51.2, U6.P$5 (OUT)
ESTIMAT_GND: BLK1.GND@1 (GND), BLK1.GND@2 (GND), BLK1.GND@3 (GND), BLK1.GND@4 (GND), BLK1.GND@5 (GND), BLK1.GND@7 (GND), BLK1.GND@8 (GND), BLK1.GND@9 (GND), BLK1.GND@10 (GND), BLK1.GND@11 (GND), BLK1.GND@12 (GND), BLK1.GND@13 (GND), BLK1.GND@14 (GND), BLK1.GND@15 (GND), BLK1.GND@16 (GND), BLK1.GND@17 (GND), BLK1.GND@26 (GND), BLK2.GND@1 (GND), BLK2.GND@2 (GND), BLK2.GND@3 (GND), BLK2.GND@4 (GND), BLK2.GND@5 (GND), BLK2.GND@7 (GND), BLK2.GND@8 (GND), BLK2.GND@9 (GND), BLK2.GND@10 (GND), BLK2.GND@11 (GND), BLK2.GND@12 (GND), BLK2.GND@13 (GND), BLK2.GND@14 (GND), BLK2.GND@15 (GND), BLK2.GND@16 (GND), BLK2.GND@17 (GND), BLK2.GND@26 (GND), C2.2, C16.2, C36.1, C44.1, C49.1, C51.1, R1.2, R2.2, R9.2, R10.2, U4.P$2 (GND), U6.P$2 (GND), U$1.5 (GND), U$1.6 (GND), U$2.5 (GND), U$2.6 (GND), U$6.P$79 (ESTIMAT_GND), U$6.P$80 (ESTIMAT_GND)
ESTIMAT_LDO_3V3_BYP: C32.2, U4.P$4 (BYP)
ESTIMAT_LDO_5V_BYP: C48.2, U6.P$4 (BYP)
ESTIMAT_VBAT: C2.1, C36.2, C49.2, U4.P$1 (IN), U4.P$3 (EN), U6.P$1 (IN), U6.P$3 (EN), U$6.P$77 (ESTIMAT_VBAT), U$6.P$78 (ESTIMAT_VBAT)
unnamed: D2.C, R1.1
unnamed: D1.C, R2.1
unnamed: D6.C, R9.1
unnamed: D5.C, R10.1
unnamed: D4.C, R4.1
unnamed: C16.1, R5.2, R6.2
unnamed: D3.C, R8.1
unnamed: C17.1, U$15.C1
unnamed: C18.2, U$15.SETP
unnamed: C18.1, U$15.SETC
P3.4_GPIO_DEBUG: BLK1.P3.4_GPIO_DEBUG, D1.A, U$1.7 (P3.4_GPIO_DEBUG)
P3.4_GPIO_DEBUG1: BLK2.P3.4_GPIO_DEBUG, D5.A, U$2.7 (P3.4_GPIO_DEBUG)
P3.5_GPIO_DEBUG: BLK1.P3.5_GPIO_DEBUG, D2.A, U$1.8 (P3.5_GPIO_DEBUG)
P3.5_GPIO_DEBUG1: BLK2.P3.5_GPIO_DEBUG, D6.A, U$2.8 (P3.5_GPIO_DEBUG)
RXD: BLK1.P2.1_RXD, U$1.4 (P2.1_RXD)
RXD1: BLK2.P2.1_RXD, U$2.4 (P2.1_RXD)
SBWTCK: BLK1.SBWTCK, U$1.SBWTCK
SBWTCK1: BLK2.SBWTCK, U$2.SBWTCK
SBWTDIO: BLK1.SBWTDIO, U$1.2 (SBWTDIO)
SBWTDIO1: BLK2.SBWTDIO, U$2.2 (SBWTDIO)
SYNC1: U$6.P$45 (SYNC1)
SYNC2: U$6.P$49 (SYNC2)
TXD: BLK1.P2.0_TXD, U$1.3 (P2.0_TXD)
TXD1: BLK2.P2.0_TXD, U$2.3 (P2.0_TXD)

Notes on the sheet:
CAN termination
Voltage Converters and Smoothing Capacitors
BDOT magnetometer
BDOT magnetometer config jumper

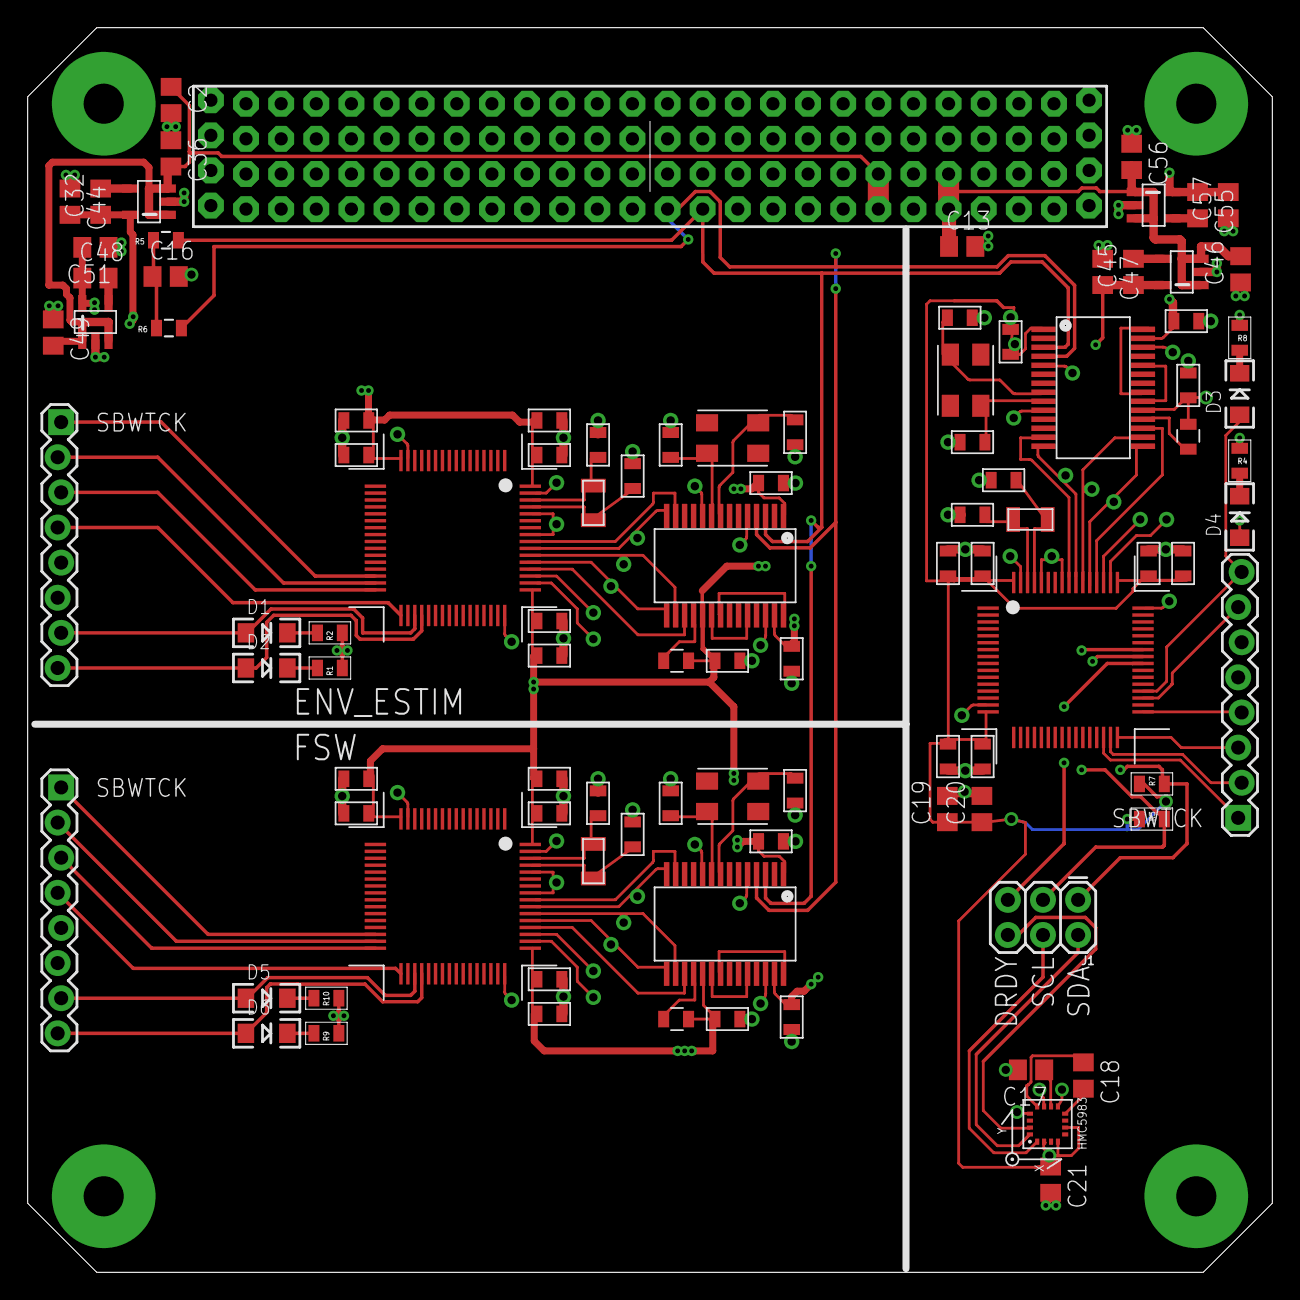
[picture p97: board flight_computer_board_f1.brd from above]

Board: 4 copper layers, 90.0 x 90.0 mm, 50 parts (0 on the bottom side), 48 nets.
