UWCubeSat/DubSat1/teams/adcs/hardware/flight_model/sensor/sensor_f1.brd

## EAGLE design teams/adcs/hardware/flight_model/sensor/sensor_f1.brd (2019-07-06)

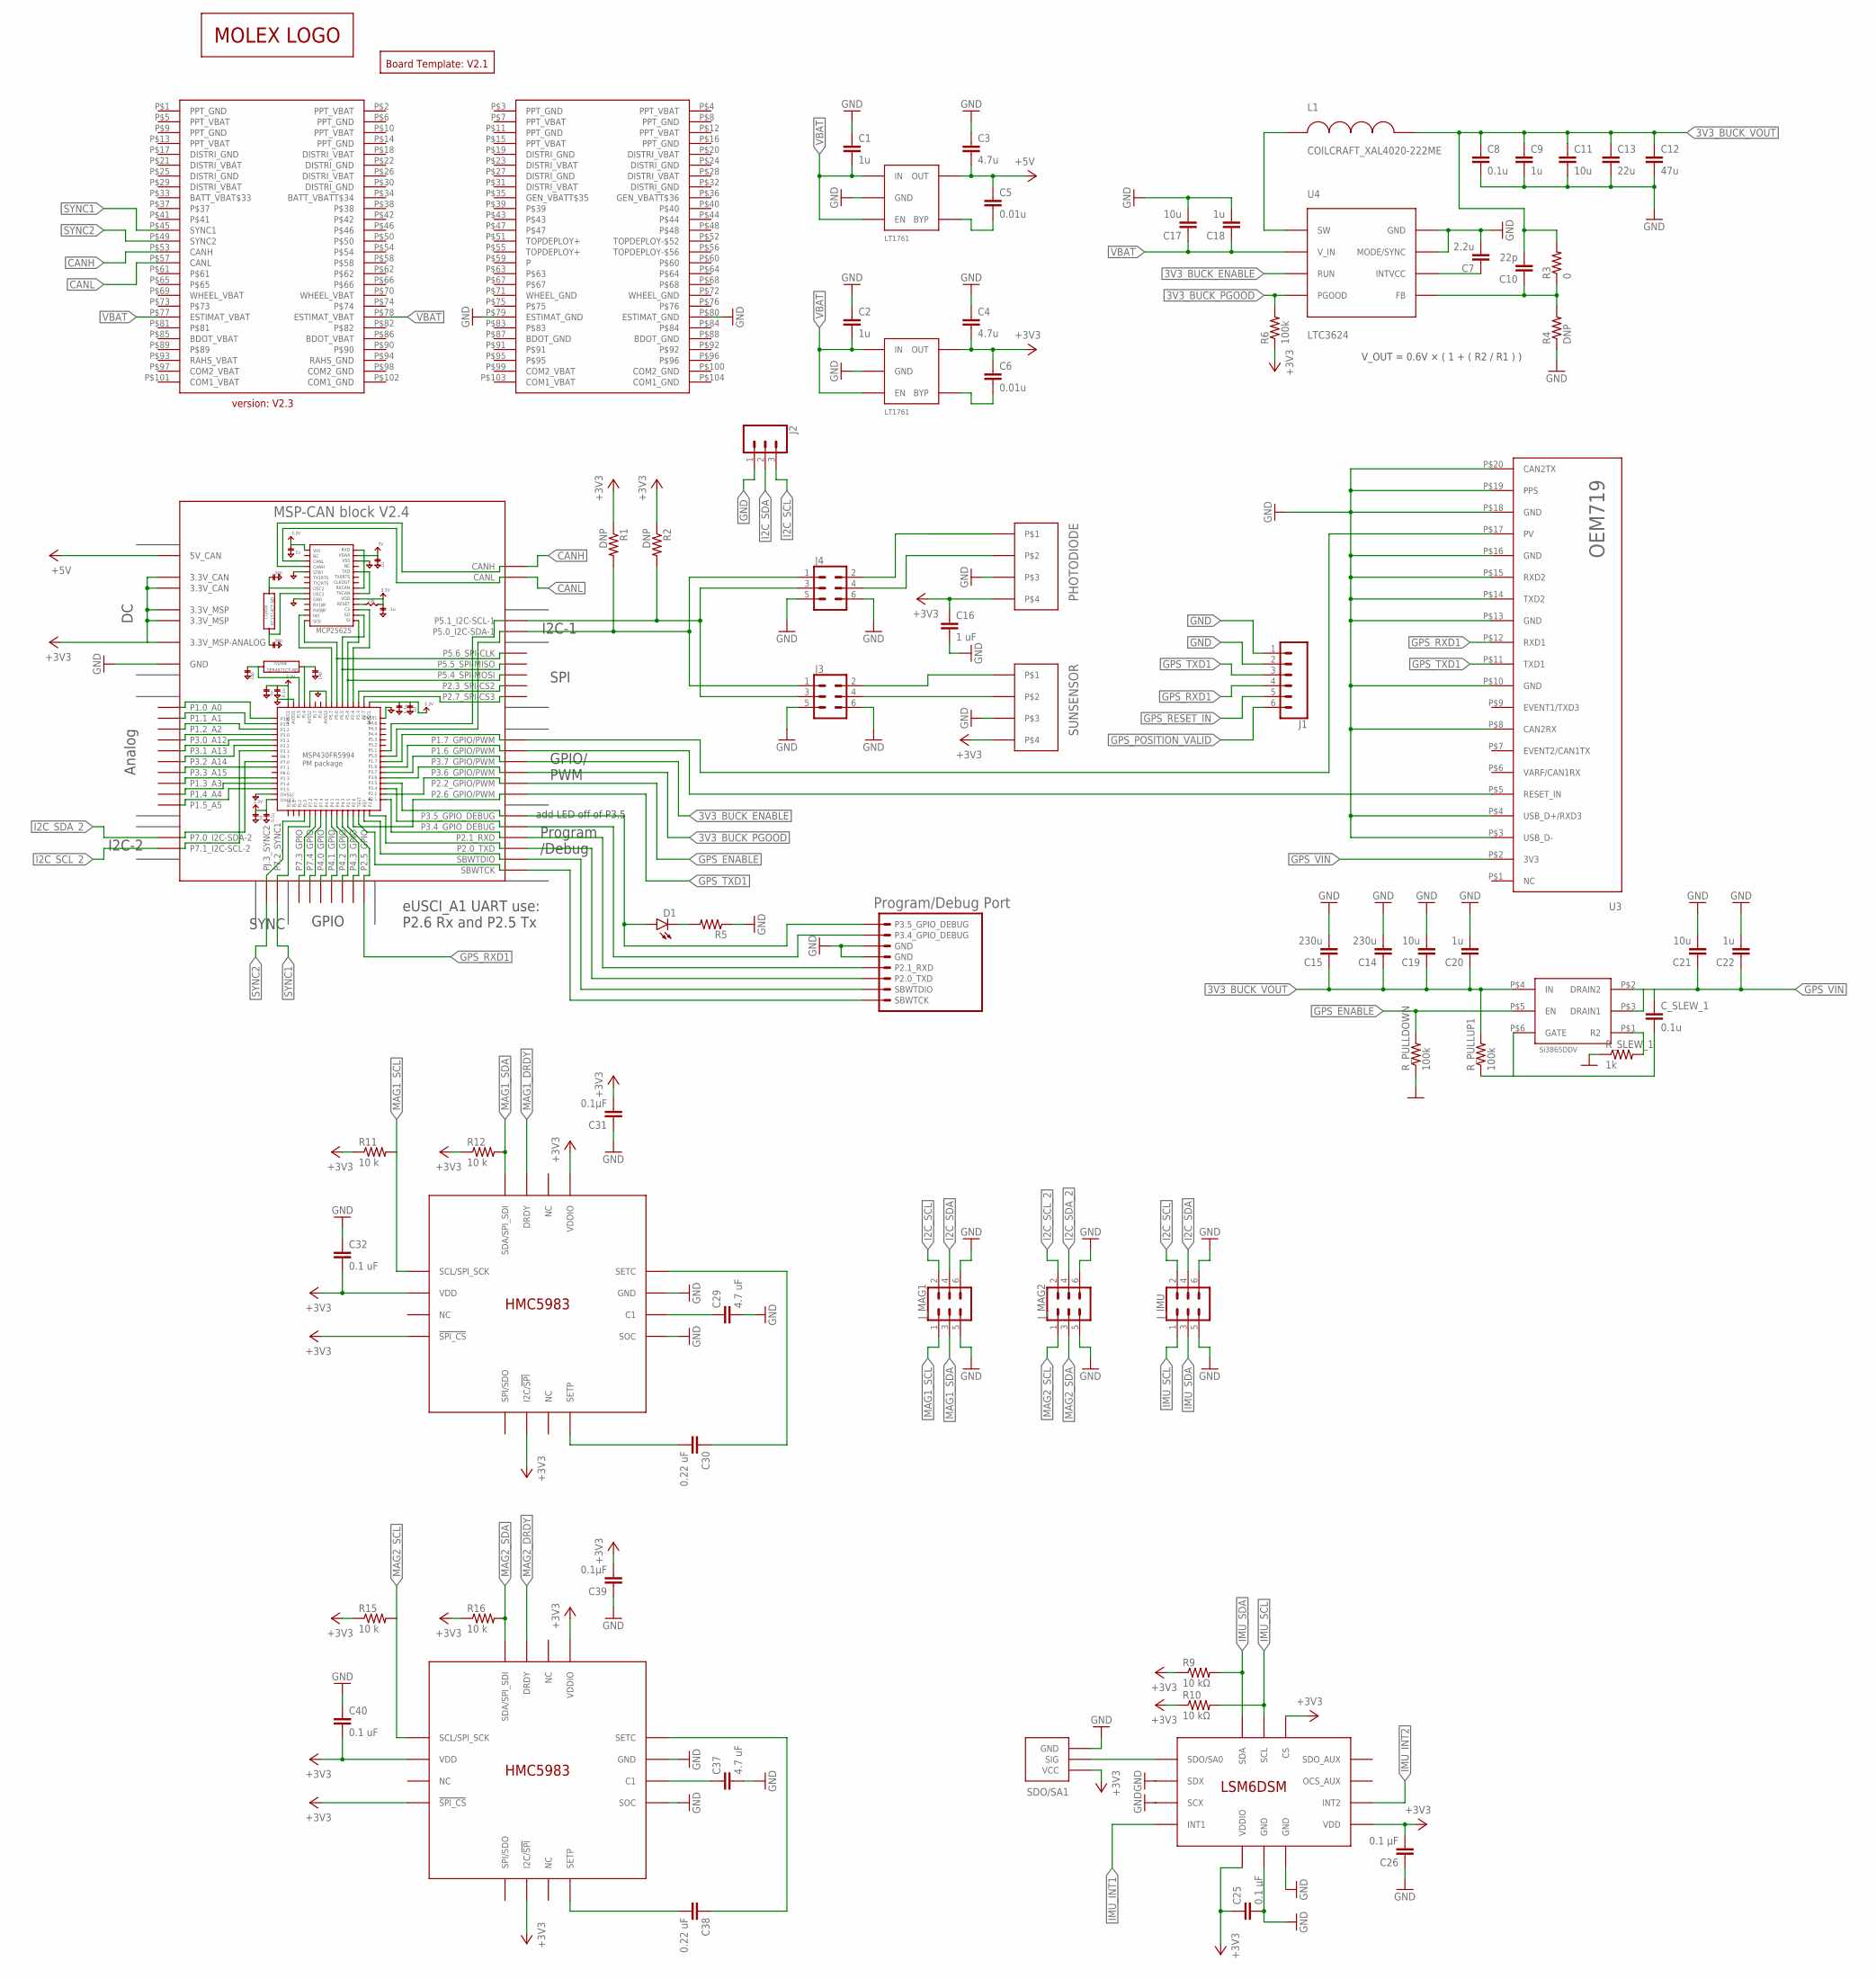
[picture p98: schematic sensor_f1.sch]

Parts:
B1: BOARD_TEMPLATESERCURED; BOARD_TEMPLATE_SECURED
BLK1: MSP-CAN_BLOCK
C1, C2, C9, C18, C20, C22: 1u; 0805
C3, C4: 4.7u; 0805
C5, C6: 0.01u; 0805
C7: 2.2u; 0805
C8: 0.1u; 0805
C10: 22p; 0805
C11, C17, C19, C21: 10u; 0805
C12: 47u; 1206
C13: 22u; 1206
C14, C15: 230u; PANASONIC_SVPG
C16: 1 uF; 0805
C25, C26: 0.1 μF; 0805
C29, C37: 4.7 uF; 0805
C30, C38: 0.22 uF; 0805
C31, C39: 0.1µF; 0805
C32, C40: 0.1 uF; 0805
CONN1: PC104_CONNECTOR
C_SLEW_1: 0.1u; 0805
D1: LED; LED-1206
J1: CONN_06LOCK; 1X06_LOCK
J2: CONN_03LOCK; 1X03_LOCK
J3, J4: CONN_03X22X3_SILK_MALE_PTH; 2X3
J_IMU: CONN_03X22X3_SILK_MALE_PTH; 2X3
J_MAG1, J_MAG2: CONN_03X22X3_SILK_MALE_PTH; 2X3
L1: COILCRAFT_XAL4020-222ME; COILCRAFT_XAL4020
PHOTODIODE: PICOLOCK_4
R1, R2, R4: DNP; 0805
R3: 0; 0805
R5: RESISTOR0805; 0805
R6: 100k; 0805
R9, R10: 10 kΩ; 0805
R11, R12, R15, R16: 10 k; 0805
R_PULLDOWN: 100k; 0805
R_PULLUP1: 100k; 0805
R_SLEW_1: 1k; 0805
SDO/SA1: 0_OHM_JUMPER
SUNSENSOR: PICOLOCK_4
U1, U2: LT1761-X; SOT-23-5
U3: OEM719
U4: LTC3624
U$1: LOGO_MOLEX
U$2: PROGRAM/DEBUG_PORT; 1X08_CONNECTOR
U$3: SI3865DDV; TSOP-6
U$5: LSM6DSM
U$6, U$8: HMC5983

Connections:
3V3_BUCK_ENABLE: BLK1.P3.7_GPIO/PWM, U4.RUN
3V3_BUCK_FB: C10.1, R3.1, R4.2, U4.FB
3V3_BUCK_INTVCC: C7.1, U4.INTVCC
3V3_BUCK_PGOOD: BLK1.P3.6_GPIO/PWM, R6.2, U4.PGOOD
3V3_BUCK_SW: L1.P$1, U4.SW
3V3_BUCK_VOUT: C8.1, C9.1, C10.2, C11.1, C12.1, C13.1, C14.POS (1), C15.POS (1), C19.1, C20.1, L1.P$2, R3.2, R_PULLUP1.2, U$3.P$4 (IN)
+3V3: R6.1
CANH: BLK1.CANH, CONN1.P$53 (CANH)
CANL: BLK1.CANL, CONN1.P$57 (CANL)
GND: BLK1.GND@1 (GND), BLK1.GND@2 (GND), BLK1.GND@3 (GND), BLK1.GND@4 (GND), BLK1.GND@5 (GND), BLK1.GND@7 (GND), BLK1.GND@8 (GND), BLK1.GND@9 (GND), BLK1.GND@10 (GND), BLK1.GND@11 (GND), BLK1.GND@12 (GND), BLK1.GND@13 (GND), BLK1.GND@14 (GND), BLK1.GND@15 (GND), BLK1.GND@16 (GND), BLK1.GND@17 (GND), BLK1.GND@26 (GND), C1.1, C2.1, C3.1, C4.1, C7.2, C8.2, C9.2, C11.2, C12.2, C13.2, C14.NEG (2), C15.NEG (2), C16.2, C17.2, C18.2, C19.2, C20.2, C21.2, C22.2, C25.2, C26.1, C29.2, C31.1, C32.1, C37.2, C39.1, C40.1, CONN1.P$79 (ESTIMAT_GND), CONN1.P$80 (ESTIMAT_GND), J1.1, J1.2, J2.1, J3.5, J3.6, J4.5, J4.6, J_IMU.5, J_IMU.6, J_MAG1.5, J_MAG1.6, J_MAG2.5, J_MAG2.6, PHOTODIODE.P$3, R4.1, R5.1, R_PULLDOWN.1, R_SLEW_1.1, SDO/SA1.P$1 (GND), SUNSENSOR.P$3, U1.P$2 (GND), U2.P$2 (GND), U3.P$3 (USB_D-), U3.P$4 (USB_D+/RXD3), U3.P$8 (CAN2RX), U3.P$10 (GND), U3.P$13 (GND), U3.P$14 (TXD2), U3.P$15 (RXD2), U3.P$16 (GND), U3.P$18 (GND), U3.P$19 (PPS), U3.P$20 (CAN2TX), U4.GND@1 (GND), U4.GND@PAD (GND), U4.MODE/SYNC, U$2.5 (GND), U$2.6 (GND), U$5.GND@1 (GND), U$5.GND@2 (GND), U$5.SCX, U$5.SDX, U$6.GND, U$6.SOC, U$8.GND, U$8.SOC
GPS_ENABLE: BLK1.P2.2_GPIO/PWM, R_PULLDOWN.2, U$3.P$5 (EN)
GPS_POSITION_VALID: BLK1.P1.7_GPIO/PWM, J1.6, U3.P$17 (PV)
GPS_RESET_IN: BLK1.P1.6_GPIO/PWM, J1.5, U3.P$5 (RESET_IN)
GPS_RXD1: BLK1.P2.5_GPIO, J1.4, U3.P$12 (RXD1)
GPS_TXD1: BLK1.P2.6_GPIO/PWM, J1.3, U3.P$11 (TXD1)
GPS_VIN: C21.1, C22.1, C_SLEW_1.1, U3.P$2 (3V3), U$3.P$2 (DRAIN2), U$3.P$3 (DRAIN1)
I2C_SCL: BLK1.P5.1_I2C-SCL-1, J2.3, J3.3, J4.3, J_IMU.2, J_MAG1.2, R2.2
I2C_SCL_2: BLK1.P7.1_I2C-SCL-2, J_MAG2.2
I2C_SDA: BLK1.P5.0_I2C-SDA-1, J2.2, J3.1, J4.1, J_IMU.4, J_MAG1.4, R1.2
I2C_SDA_2: BLK1.P7.0_I2C-SDA-2, J_MAG2.4
IMU_INT1: U$5.INT1
IMU_INT2: U$5.INT2
IMU_SCL: J_IMU.1, R10.2, U$5.SCL
IMU_SDA: J_IMU.3, R9.2, U$5.SDA
LDO_3V3: BLK1.3.3V@CAN1 (3.3V_CAN), BLK1.3.3V@CAN2 (3.3V_CAN), BLK1.3.3V@MSP1 (3.3V_MSP), BLK1.3.3V@MSP2 (3.3V_MSP), BLK1.3.3V_ANALOG@MSP2 (3.3V_MSP-ANALOG), C4.2, C6.1, C16.1, C25.1, C26.2, C31.2, C32.2, C39.2, C40.2, PHOTODIODE.P$4, R1.1, R2.1, R9.1, R10.1, R11.1, R12.1, R15.1, R16.1, SDO/SA1.P$3 (VCC), SUNSENSOR.P$4, U2.P$5 (OUT), U$5.CS, U$5.VDD, U$5.VDDIO, U$6.!SPI_CS, U$6.I2C/!SPI, U$6.VDD, U$6.VDDIO, U$8.!SPI_CS, U$8.I2C/!SPI, U$8.VDD, U$8.VDDIO
LDO_3V3_BYP: C6.2, U2.P$4 (BYP)
LDO_5V: BLK1.5V (5V_CAN), C3.2, C5.1, U1.P$5 (OUT)
LDO_5V_BYP: C5.2, U1.P$4 (BYP)
MA1G_C2: C29.1, U$6.C1
MAG1_DRDY: U$6.DRDY
MAG1_SCL: J_MAG1.1, R11.2, U$6.SCL/SPI_SCK
MAG1_SDA: J_MAG1.3, R12.2, U$6.SDA/SPI_SDI
MAG1_SETC1: C30.1, U$6.SETC
MAG1_SETP1: C30.2, U$6.SETP
MAG2_C1: C37.1, U$8.C1
MAG2_DRDY: U$8.DRDY
MAG2_SCL: J_MAG2.1, R15.2, U$8.SCL/SPI_SCK
MAG2_SDA: J_MAG2.3, R16.2, U$8.SDA/SPI_SDI
MAG2_SETC: C38.1, U$8.SETC
MAG2_SETP: C38.2, U$8.SETP
unnamed: BLK1.P3.5_GPIO_DEBUG, D1.A, U$2.8 (P3.5_GPIO_DEBUG)
unnamed: R_SLEW_1.2, U$3.P$1 (R2)
unnamed: BLK1.P3.4_GPIO_DEBUG, U$2.7 (P3.4_GPIO_DEBUG)
unnamed: C_SLEW_1.2, R_PULLUP1.1, U$3.P$6 (GATE)
unnamed: BLK1.P2.1_RXD, U$2.4 (P2.1_RXD)
unnamed: BLK1.P2.0_TXD, U$2.3 (P2.0_TXD)
unnamed: BLK1.SBWTDIO, U$2.2 (SBWTDIO)
unnamed: BLK1.SBWTCK, U$2.SBWTCK
unnamed: D1.C, R5.2
unnamed: SDO/SA1.P$2 (SIG), U$5.SDO/SA0
PHOTODIODE_SCL: J4.4, PHOTODIODE.P$2
PHOTODIODE_SDA: J4.2, PHOTODIODE.P$1
SUNSENSOR_SCL: J3.4, SUNSENSOR.P$2
SUNSENSOR_SDA: J3.2, SUNSENSOR.P$1
SYNC1: BLK1.P7.2_SYNC1, CONN1.P$45 (SYNC1)
SYNC2: BLK1.PJ.3_SYNC2, CONN1.P$49 (SYNC2)
VBAT: C1.2, C2.2, C17.1, C18.1, CONN1.P$77 (ESTIMAT_VBAT), CONN1.P$78 (ESTIMAT_VBAT), U1.P$1 (IN), U1.P$3 (EN), U2.P$1 (IN), U2.P$3 (EN), U4.V_IN

Notes on the sheet:
V_OUT = 0.6V × ( 1 + ( R2 / R1 ) )

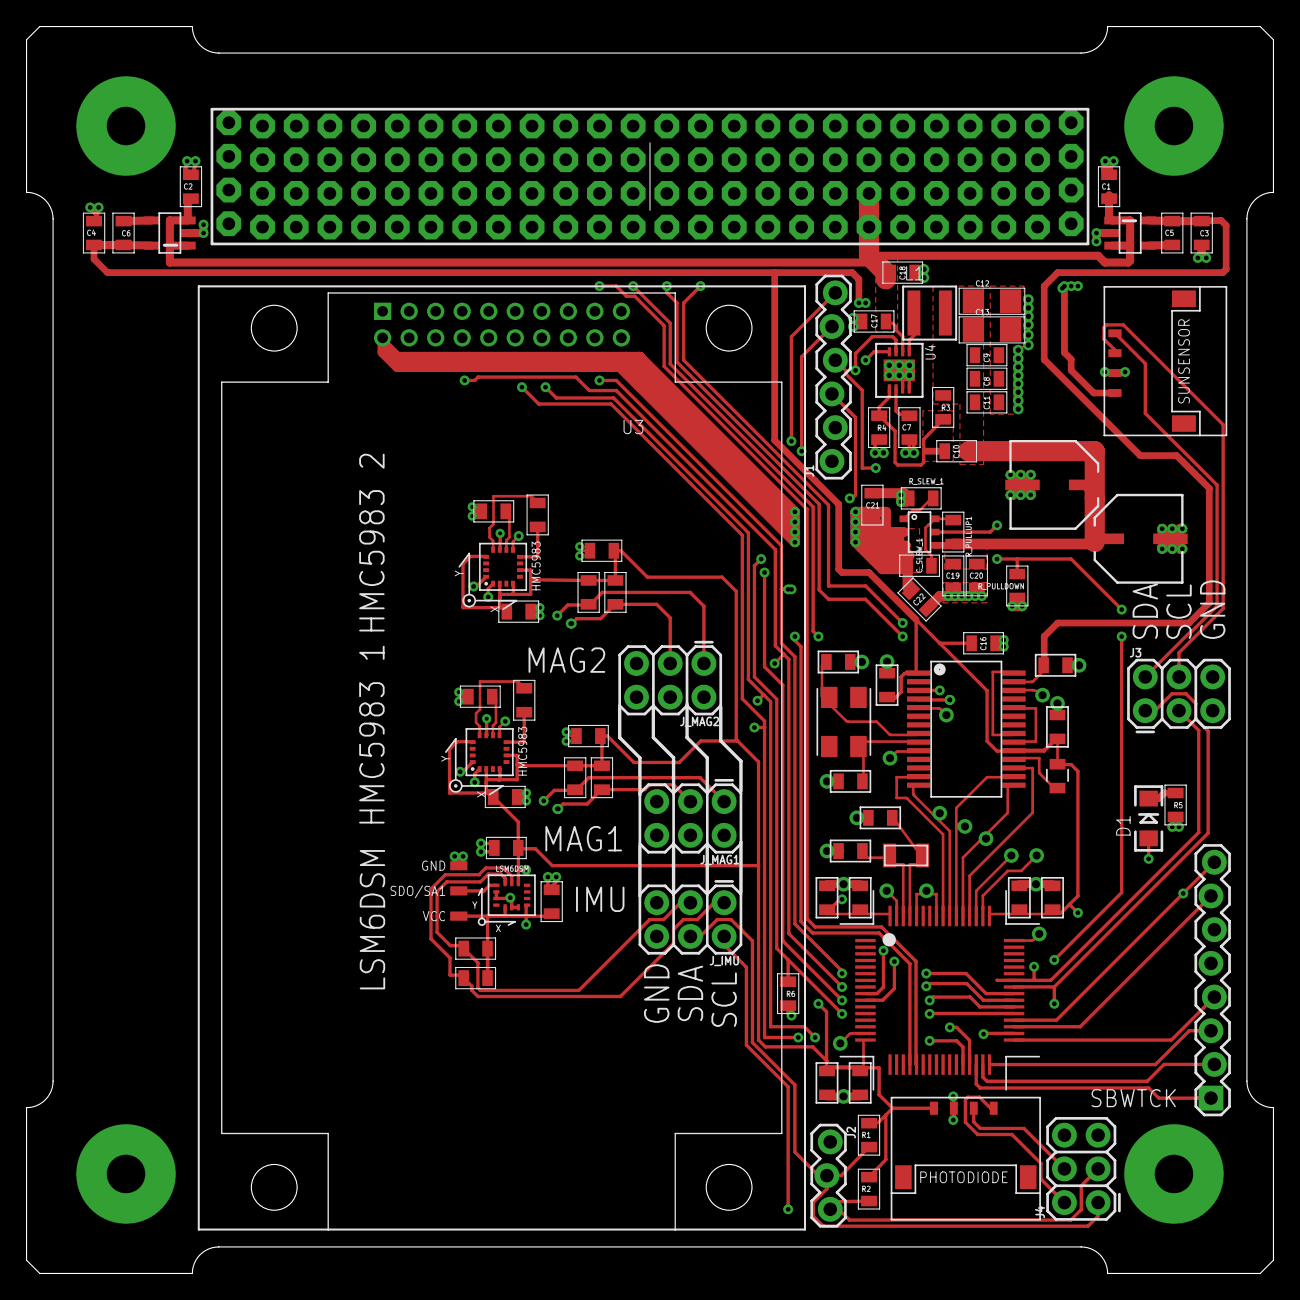
[picture p99: board sensor_f1.brd from above]

Board: 2 copper layers, 94.0 x 94.0 mm, 73 parts (1 on the bottom side), 52 nets.
