UWCubeSat/DubSat1/teams/adcs/hardware/flight_model/magnetorquer_extension/magnetorquer_extension_board_f1.brd

## EAGLE design teams/adcs/hardware/flight_model/magnetorquer_extension/magnetorquer_extension_board_f1.brd (2019-07-06)

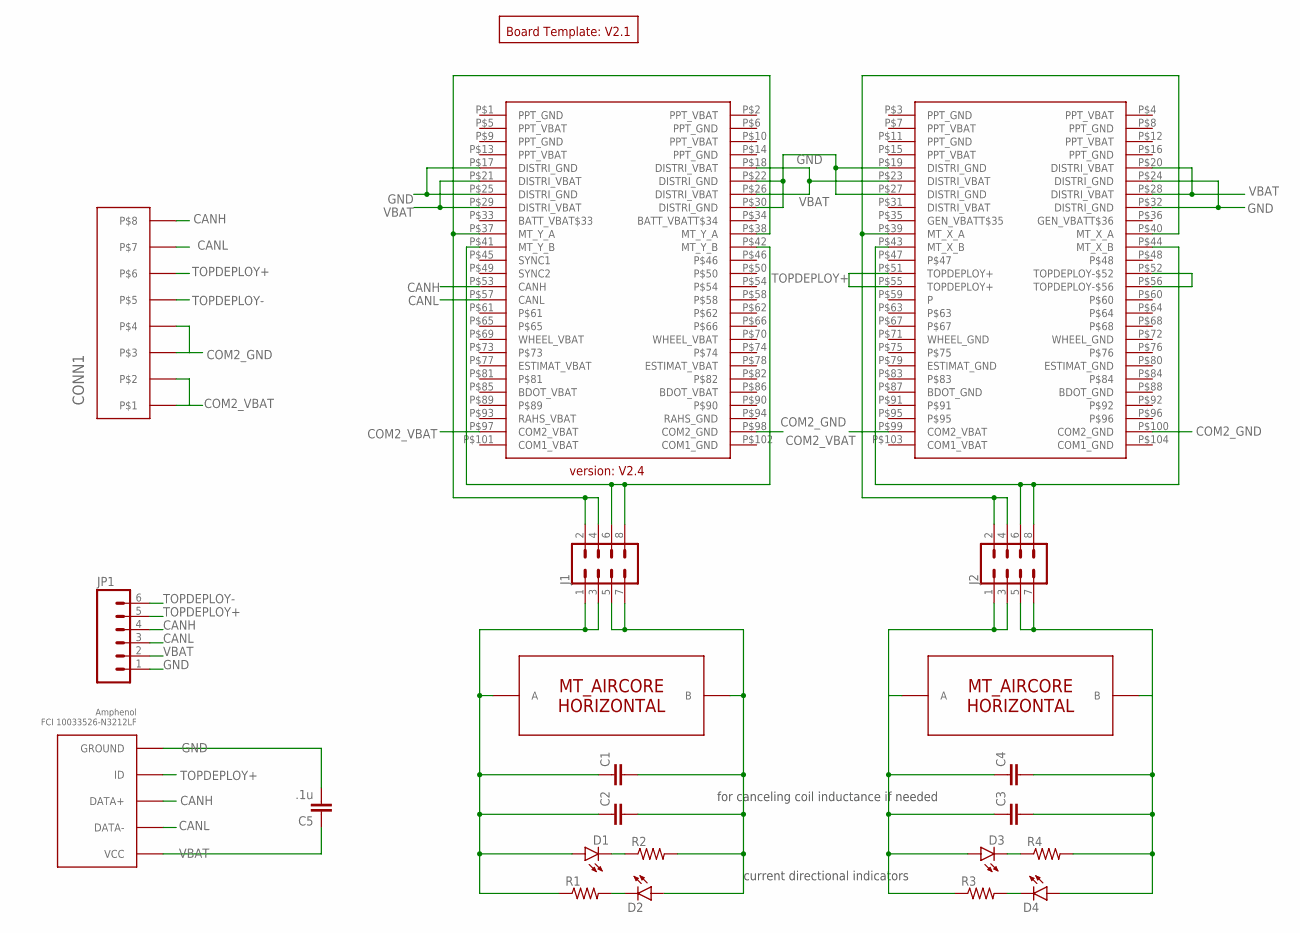
[picture p100: schematic magnetorquer_extension_board_f1.sch]

Parts:
C1, C4: CAPACITOR0805; 0805
C2, C3: CAPACITOR1210; 1210
C5: .1u; 0805
CONN1: PICOLOCK_8PICOLOCK_8; PICOLOCK_8
D1, D2, D3, D4: LED; LED-1206
J1, J2: CONN_04X2; 2X4
JP1: M06LOCK; 1X06_LOCK
MT_X: MT_AIRCORE_HORIZONTAL
MT_Y: MT_AIRCORE_HORIZONTAL
R1, R2, R3, R4: RESISTOR0805; 0805
U$1: PC104_CONNECTOR
U$2: BOARD_TEMPLATESERCURED; BOARD_TEMPLATE_SECURED
U$3: USB_MINI-B_AMPHENOL; USB_MINI_B

Connections:
CANH: CONN1.P$8, JP1.4, U$1.P$53 (CANH), U$3.DATA+
CANL: CONN1.P$7, JP1.3, U$1.P$57 (CANL), U$3.DATA-
COM2_GND: CONN1.P$3, CONN1.P$4, U$1.P$98 (COM2_GND), U$1.P$100 (COM2_GND)
COM2_VBAT: CONN1.P$1, CONN1.P$2, U$1.P$97 (COM2_VBAT), U$1.P$99 (COM2_VBAT)
GND: C5.2, JP1.1, U$1.P$17 (DISTRI_GND), U$1.P$19 (DISTRI_GND), U$1.P$22 (DISTRI_GND), U$1.P$24 (DISTRI_GND), U$1.P$25 (DISTRI_GND), U$1.P$27 (DISTRI_GND), U$1.P$30 (DISTRI_GND), U$1.P$32 (DISTRI_GND), U$3.GND1 (GROUND), U$3.GND2 (GROUND), U$3.GND3 (GROUND), U$3.GND4 (GROUND), U$3.GROUND
MT_X_A: C3.1, C4.1, D3.A, J2.1, J2.3, MT_Y.A, R3.1
MT_X_A_STACK: J2.2, J2.4, U$1.P$39 (MT_X_A), U$1.P$40 (MT_X_A)
MT_X_B: C3.2, C4.2, D4.A, J2.5, J2.7, MT_Y.B, R4.2
MT_X_B_STACK: J2.6, J2.8, U$1.P$43 (MT_X_B), U$1.P$44 (MT_X_B)
MT_Y_A: C1.1, C2.1, D1.A, J1.1, J1.3, MT_X.A, R1.1
MT_Y_A_STACK: J1.2, J1.4, U$1.P$37 (MT_Y_A), U$1.P$38 (MT_Y_A)
MT_Y_B: C1.2, C2.2, D2.A, J1.5, J1.7, MT_X.B, R2.2
MT_Y_B_STACK: J1.6, J1.8, U$1.P$41 (MT_Y_B), U$1.P$42 (MT_Y_B)
unnamed: D1.C, R2.1
unnamed: D2.C, R1.2
unnamed: D3.C, R4.1
unnamed: D4.C, R3.2
TOPDEPLOY+: CONN1.P$6, JP1.5, U$1.P$51 (TOPDEPLOY+), U$1.P$55 (TOPDEPLOY+), U$3.ID
TOPDEPLOY-: CONN1.P$5, JP1.6, U$1.P$52 (TOPDEPLOY-$52), U$1.P$56 (TOPDEPLOY-$56)
VBAT: C5.1, JP1.2, U$1.P$18 (DISTRI_VBAT), U$1.P$20 (DISTRI_VBAT), U$1.P$21 (DISTRI_VBAT), U$1.P$23 (DISTRI_VBAT), U$1.P$26 (DISTRI_VBAT), U$1.P$28 (DISTRI_VBAT), U$1.P$29 (DISTRI_VBAT), U$3.VCC

Notes on the sheet:
for canceling coil inductance if needed
current directional indicators
