UWCubeSat/DubSat1/teams/adcs/hardware/flight_model/magnetorquer_extension/magnetorquer_extension_board_f1.brd

## EAGLE design teams/adcs/hardware/flight_model/magnetorquer_extension/magnetorquer_extension_board_f1.brd (continued)

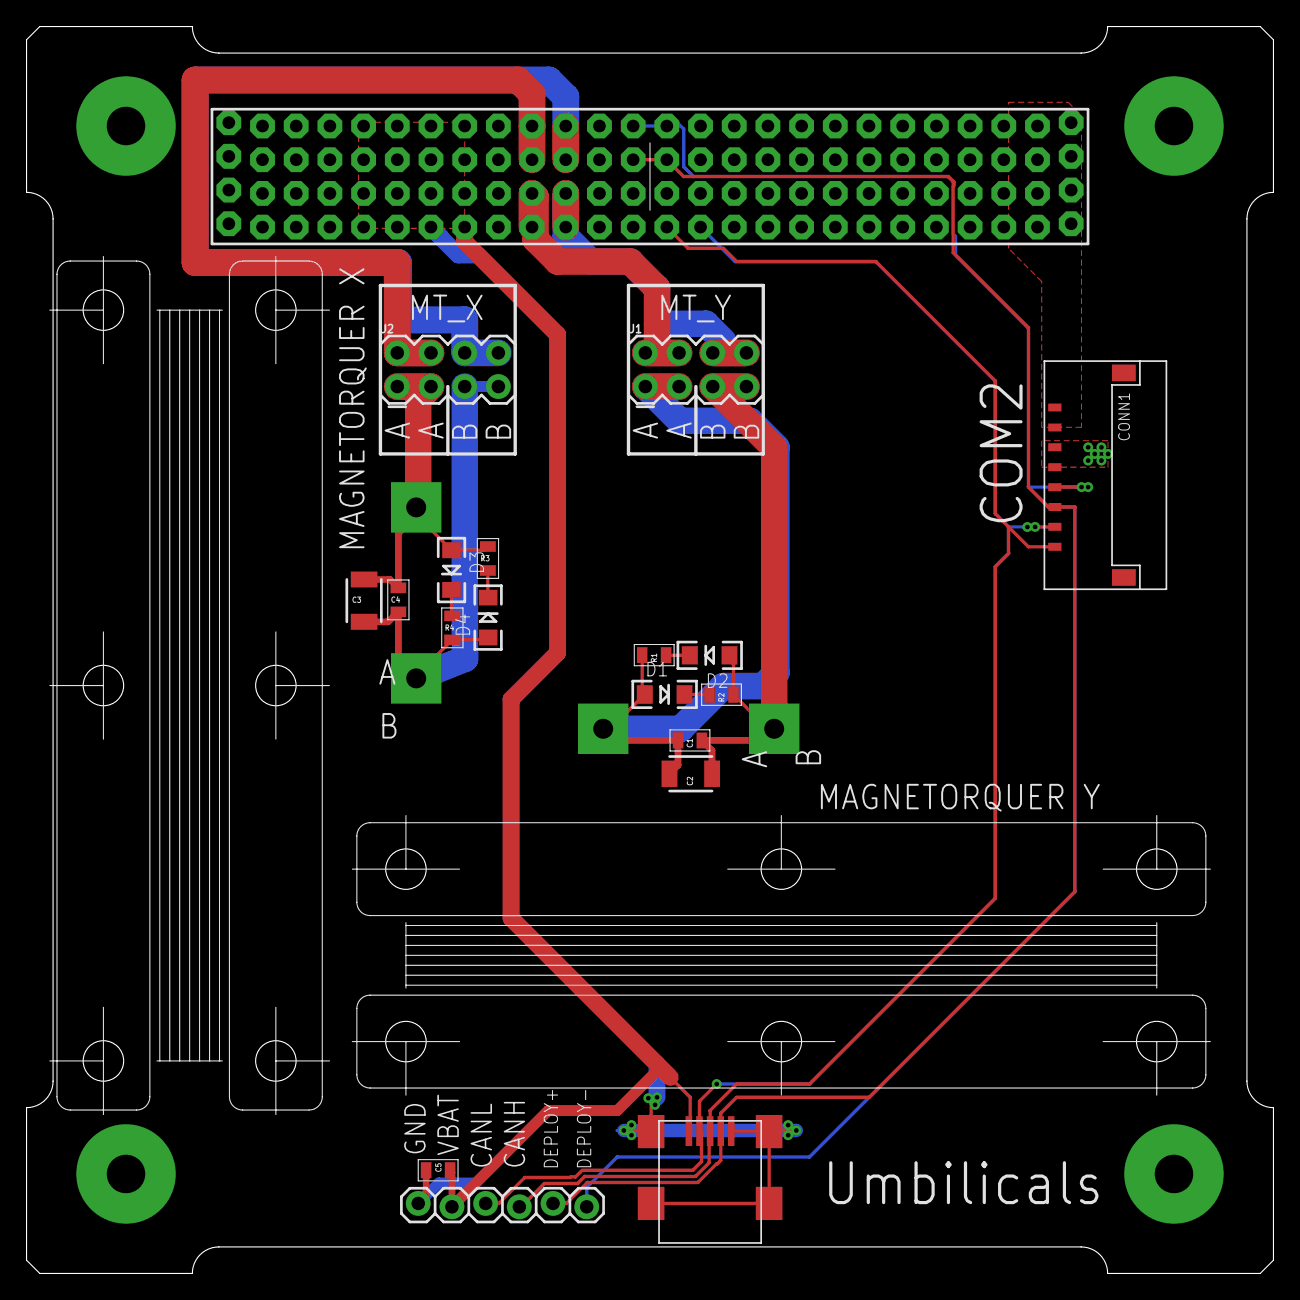
[picture p101: board magnetorquer_extension_board_f1.brd from above]

Board: 2 copper layers, 94.0 x 94.0 mm, 22 parts (0 on the bottom side), 20 nets.
