UWCubeSat/DubSat1/teams/comm2/engineering models/RFfrontend_v3/RFfrontend_v4.brd

## EAGLE design teams/comm2/engineering models/RFfrontend_v3/RFfrontend_v4.brd (2017-11-11)

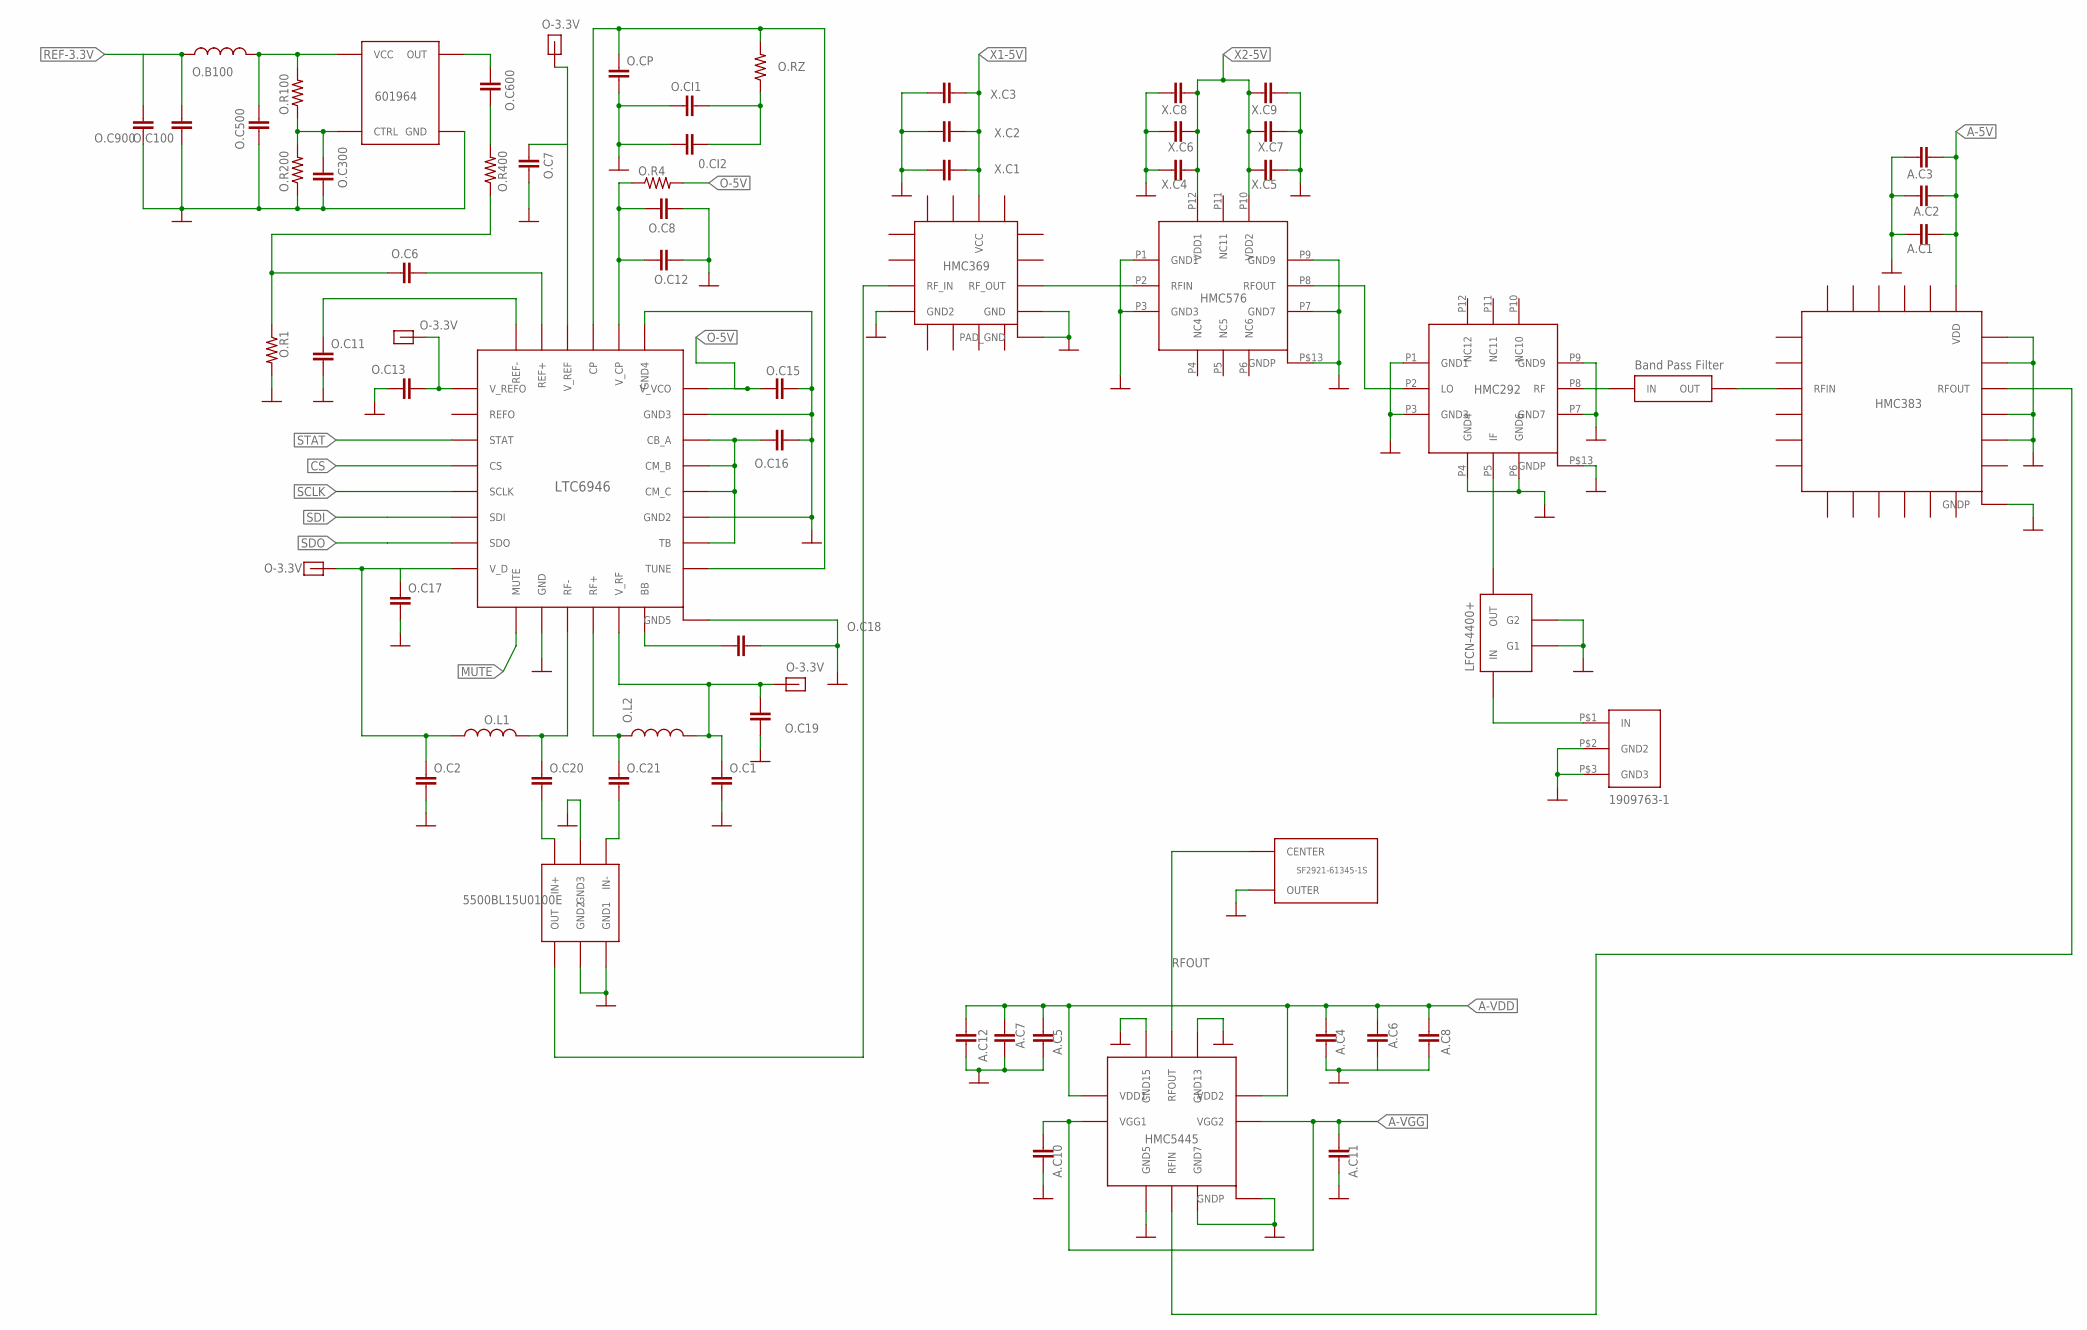
[picture p102: schematic RFfrontend_v4.sch, sheet 1]

Parts:
0.CI2: CAP0805; 0805
3.3V: 1PIN_B-T-B_TOPPAD
A.C1, A.C4, A.C5, A.C10, A.C11: CAP0402-CAP; 0402-CAP
A.C2, A.C6, A.C7: CAP0603-CAP; 0603-CAP
A.C3, A.C8, A.C12: CAP0805; 0805
O-3.3V: 1PIN_B-T-B_TOPPAD
O.B100: INDUCTOR0603; 0603
O.C1, O.C2, O.C6, O.C7, O.C11, O.C12, O.C13, O.C15, O.C17, O.C19, O.C20, O.C21: CAP0402-CAP; 0402-CAP
O.C8, O.C16, O.C18: CAP0805; 0805
O.C100, O.C900: CAP1206; 1206
O.C300, O.C500, O.C600, O.CI1, O.CP: CAP0603-CAP; 0603-CAP
O.L1, O.L2: INDUCTOR0402; C0402
O.R1, O.R4: RESISTOR0402-RES; 0402-RES
O.R100, O.R200, O.R400, O.RZ: RESISTOR0603; 0603-RES
U$1: LINEAR_LTC6946; QFN_28PIN
U$9, U$18: 1PIN_B-T-B_TOPPAD
U$13: CRYSTEK_601964; 4_PIN_9X14MM
U$14: HITTITE_HMC369; LP3
U$15: MINICIRCUITS_LPF; FV1206
U$22: HITTITE_HMC576; 12PIN_QFN
U$29: HITTITE_HMC292; 12PIN_QFN
U$39: JOHNSON_5500BL15U0100; 6_PIN_BALUN
U$41: BPF_24GHZ
U$43: HITTITE_HMC383; 24-QFN
U$44: HITTITE_HMC5445; 16PIN_SMT
U$75: SMA_STRAIGHT_SF2921-61345-1S
U$169: TE_UMCC_CONNECTOR; 3_PIN_UMCC
X.C1, X.C4, X.C5: CAP0402-CAP; 0402-CAP
X.C2, X.C6, X.C7: CAP0603-CAP; 0603-CAP
X.C3, X.C8, X.C9: CAP0805; 0805

Connections:
12GHZ: U$14.PIN10 (RF_OUT), U$22.P2 (RFIN)
A-5V: A.C1.2, A.C2.2, A.C3.2, U$43.P$19 (VDD); also elsewhere on the board
A-VDD: A.C4.2, A.C5.2, A.C6.2, A.C7.2, A.C8.2, A.C12.2, U$44.P1 (VDD1), U$44.P11 (VDD2); also elsewhere on the board
A-VGG: A.C10.2, A.C11.2, U$44.P2 (VGG1), U$44.P10 (VGG2); also elsewhere on the board
AGND: 0.CI2.1, A.C1.1, A.C2.1, A.C3.1, A.C4.1, A.C5.1, A.C6.1, A.C7.1, A.C8.1, A.C10.1, A.C11.1, A.C12.1, O.C1.2, O.C2.2, O.C7.1, O.C8.2, O.C11.2, O.C12.2, O.C13.1, O.C15.2, O.C16.2, O.C17.2, O.C18.2, O.C19.1, O.C100.1, O.C300.2, O.C500.2, O.C900.1, O.CI1.1, O.CP.2, O.R1.2, O.R200.1, U$1.P$10 (GND), U$1.P$17 (GND2), U$1.P$21 (GND3), U$1.P$23 (GND4), U$1.P$29 (GND5), U$13.GND, U$14.PAD_GND, U$14.PIN4 (GND2), U$14.PIN9 (GND), U$15.P$1 (G1), U$15.P$2 (G2), U$22.P1 (GND1), U$22.P3 (GND3), U$22.P7 (GND7), U$22.P9 (GND9), U$22.P$13 (GNDP), U$29.P1 (GND1), U$29.P3 (GND3), U$29.P4 (GND4), U$29.P6 (GND6), U$29.P7 (GND7), U$29.P9 (GND9), U$29.P$13 (GNDP), U$39.P$2 (GND2), U$39.P$3 (GND1), U$39.P$5 (GND3), U$43.P$14 (NC14), U$43.P$15 (NC15), U$43.P$17 (NC17), U$43.P$18 (NC18), U$43.P$25 (GNDP), U$44.GNDP, U$44.P5 (GND5), U$44.P7 (GND7), U$44.P13 (GND13), U$44.P15 (GND15), U$75.OUTER, U$169.P$2 (GND2), U$169.P$3 (GND3), X.C1.1, X.C2.1, X.C3.1, X.C4.1, X.C5.2, X.C6.1, X.C7.2, X.C8.1, X.C9.2; also elsewhere on the board
CS: U$1.P$4 (CS); also elsewhere on the board
MUTE: U$1.P$9 (MUTE); also elsewhere on the board
unnamed: O.C8.1, O.C12.1, O.R4.1, U$1.P$24 (V_CP)
unnamed: O.C16.1, U$1.P$16 (TB), U$1.P$18 (CM_C), U$1.P$19 (CM_B), U$1.P$20 (CB_A)
unnamed: O.C20.2, U$39.P$6 (IN+)
unnamed: 0.CI2.2, O.CI1.2, O.RZ.1
unnamed: O.CP.1, O.RZ.2, U$1.P$15 (TUNE), U$1.P$25 (CP)
unnamed: O.C18.1, U$1.P$14 (BB)
unnamed: O.C20.1, O.L1.2, U$1.P$11 (RF-)
unnamed: O.C21.1, O.L2.1, U$1.P$12 (RF+)
unnamed: O.C21.2, U$39.P$4 (IN-)
unnamed: U$14.PIN3 (RF_IN), U$39.P$1 (OUT)
unnamed: O.C11.1, U$1.P$28 (REF-)
unnamed: O.C6.2, U$1.P$27 (REF+)
unnamed: O.C6.1, O.R1.1, O.R400.1
unnamed: O.B100.2, O.C500.1, O.R100.2, U$13.VCC
unnamed: O.C300.1, O.R100.1, O.R200.2, U$13.VCTRL (CTRL)
unnamed: O.C600.1, U$13.OUT
unnamed: U$22.P8 (RFOUT), U$29.P2 (LO)
unnamed: O.C600.2, O.R400.2
unnamed: U$15.P$4 (OUT), U$29.P5 (IF)
unnamed: U$29.P8 (RF), U$41.IN
unnamed: U$41.OUT, U$43.P$3 (RFIN)
unnamed: U$43.P$16 (RFOUT), U$44.P6 (RFIN)
unnamed: U$15.P$3 (IN), U$169.P$1 (IN)
O-3.3V: 3.3V.P$1, O-3.3V.P$1, O.C1.1, O.C2.1, O.C7.2, O.C13.2, O.C17.1, O.C19.2, O.L1.1, O.L2.2, U$1.P$1 (V_REFO), U$1.P$8 (V_D), U$1.P$13 (V_RF), U$1.P$26 (V_REF), U$9.P$1, U$18.P$1; also elsewhere on the board
O-5V: O.C15.1, O.R4.2, U$1.P$22 (V_VCO); also elsewhere on the board
REF-3.3V: O.B100.1, O.C100.2, O.C900.2; also elsewhere on the board
RFOUT: U$44.P14 (RFOUT), U$75.CENTER
SCLK: U$1.P$5 (SCLK); also elsewhere on the board
SDI: U$1.P$6 (SDI); also elsewhere on the board
SDO: U$1.P$7 (SDO); also elsewhere on the board
STAT: U$1.P$3 (STAT); also elsewhere on the board
X1-5V: U$14.PIN14 (VCC), X.C1.2, X.C2.2, X.C3.2; also elsewhere on the board
X2-5V: U$22.P10 (VDD2), U$22.P12 (VDD1), X.C4.2, X.C5.1, X.C6.2, X.C7.1, X.C8.2, X.C9.1; also elsewhere on the board

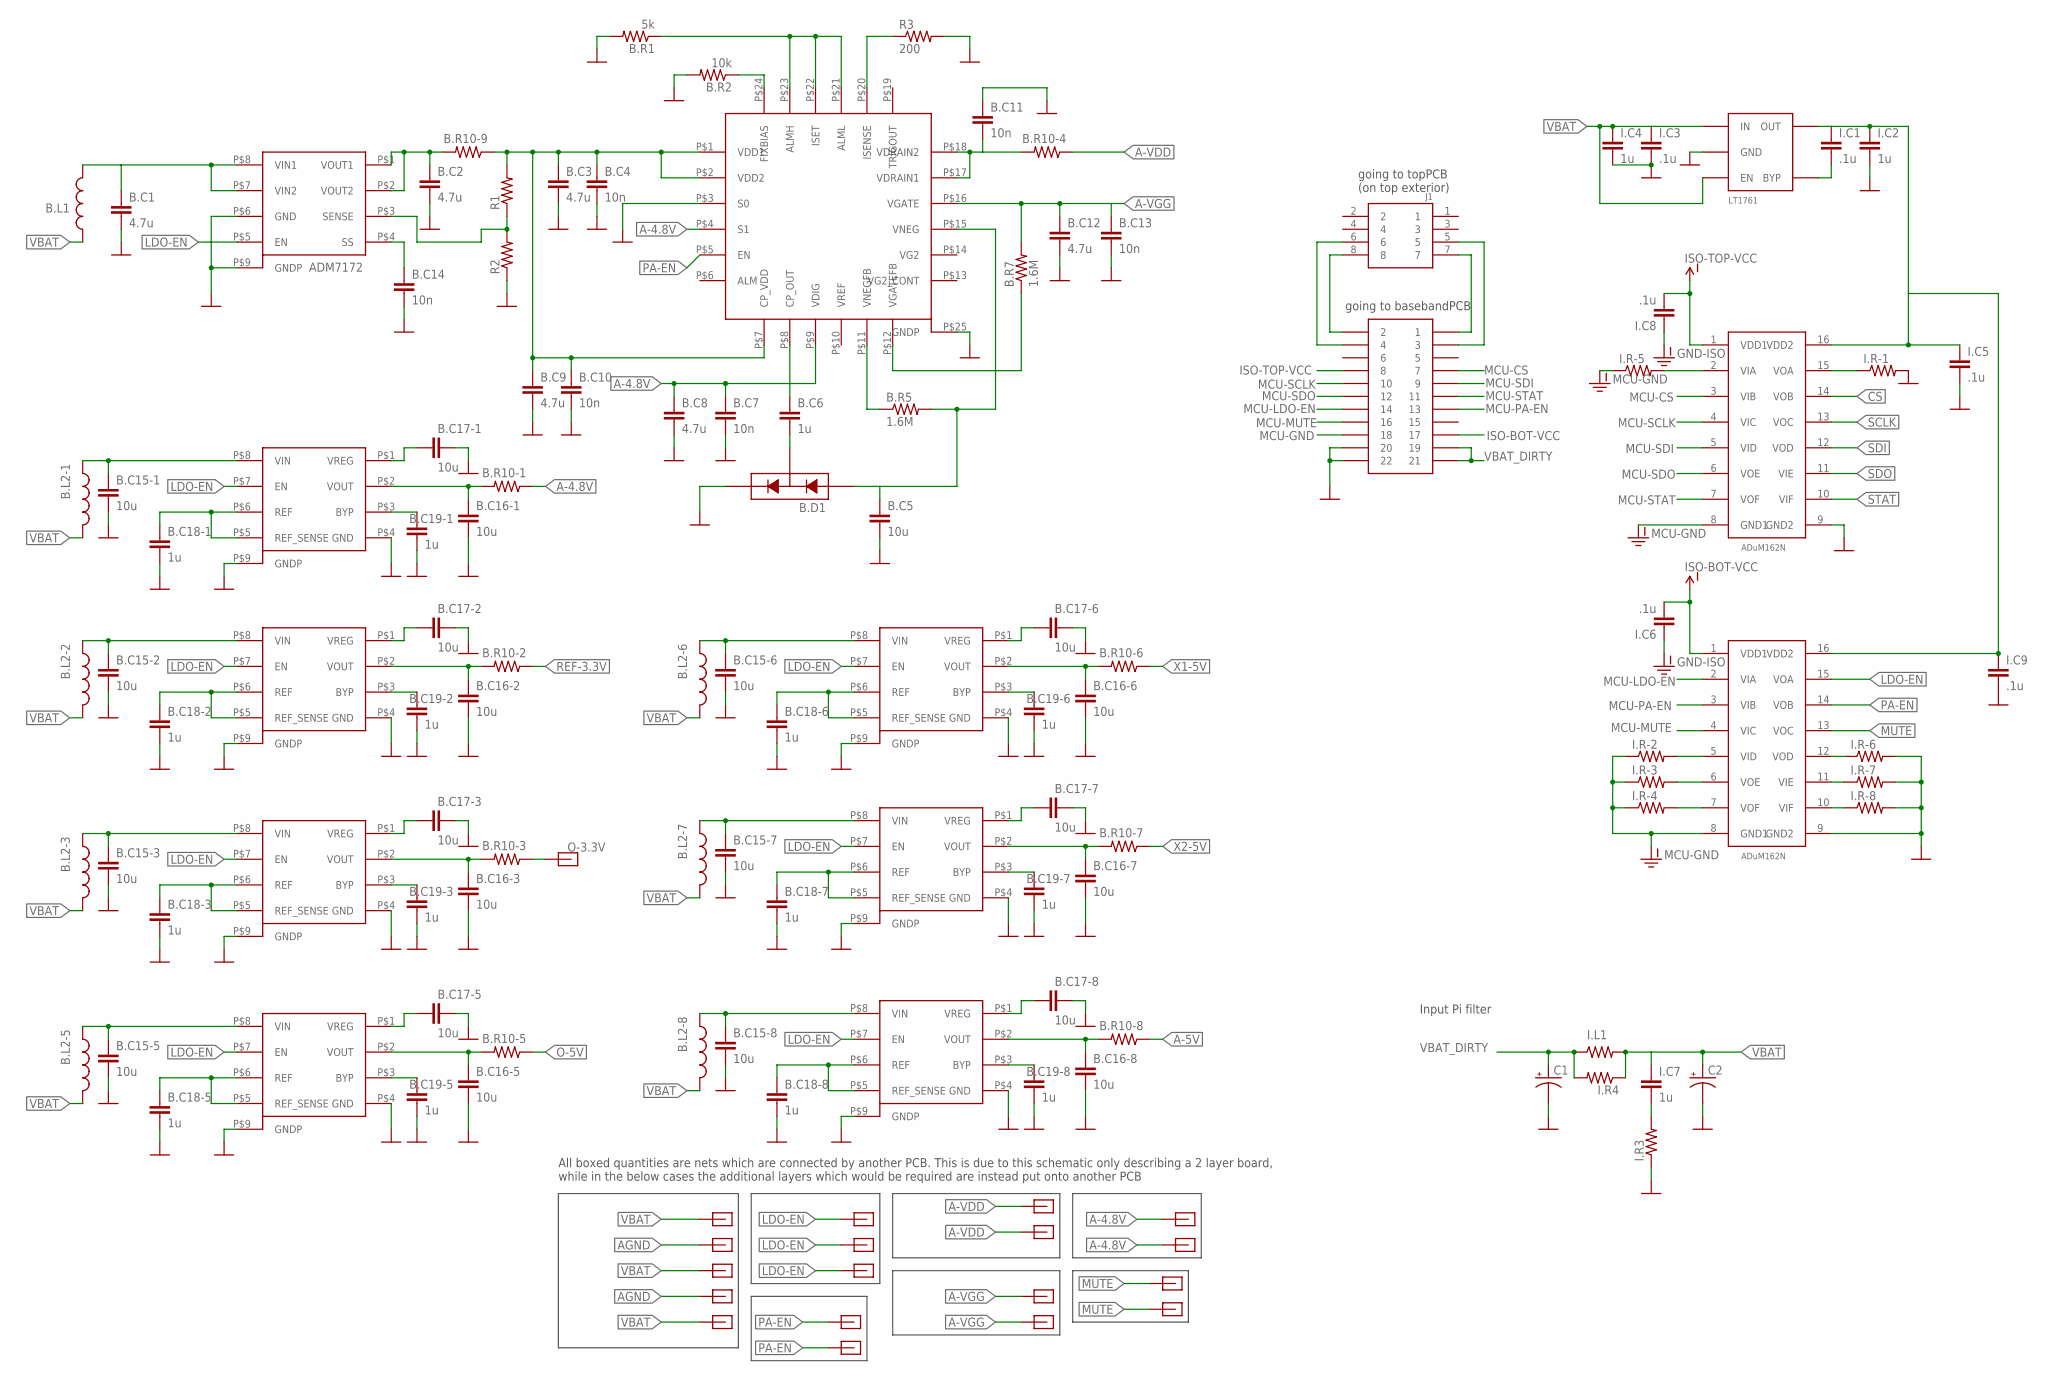
[picture p103: schematic RFfrontend_v4.sch, sheet 2]

Parts:
B.C1, B.C2: 4.7u; 1206
B.C3, B.C8, B.C9, B.C12: 4.7u; 0603-CAP
B.C4, B.C7, B.C10, B.C11, B.C13, B.C14: 10n; 0603-CAP
B.C5, B.C15-1, B.C15-2, B.C15-3, B.C15-5, B.C15-6, B.C15-7, B.C15-8, B.C16-1, B.C16-2, B.C16-3, B.C16-5, B.C16-6, B.C16-7, B.C16-8, B.C17-1, B.C17-2, B.C17-3, B.C17-5, B.C17-6, B.C17-7, B.C17-8: 10u; 0805
B.C6, B.C18-1, B.C18-2, B.C18-3, B.C18-5, B.C18-6, B.C18-7, B.C18-8, B.C19-1, B.C19-2, B.C19-3, B.C19-5, B.C19-6, B.C19-7, B.C19-8: 1u; 0805
B.D1: ONSEMI_DIODE_BAT54SL; SOT23-3
B.L1: INDUCTOR0805; 0805
B.L2-1, B.L2-2, B.L2-3, B.L2-5, B.L2-6, B.L2-7, B.L2-8: INDUCTOR0603; 0603
B.R1: 5k; 0603-RES
B.R2: 10k; 0805
B.R5, B.R7: 1.6M; 0805
B.R10-1, B.R10-2, B.R10-3, B.R10-4, B.R10-5, B.R10-6, B.R10-7, B.R10-8, B.R10-9: RESISTOR0805-RES; 0805
C1, C2: CAP_POL7343; EIA7343
I.C1, I.C3, I.C5, I.C6, I.C8, I.C9: .1u; 0402-CAP
I.C2, I.C4, I.C7: 1u; 0805
I.L1: RESISTOR1206; 1206
I.R3, I.R4: RESISTOR0805-RES; 0805
I.R-1, I.R-2, I.R-3, I.R-4, I.R-5, I.R-6, I.R-7, I.R-8: RESISTOR0402-RES; 0402-RES
J1: SLW-104-01-X-D
R1, R2: RESISTOR0805-RES; 0805
R3: 200; 0805
U$19, U$20, U$25, U$26, U$28, U$35, U$36, U$153, U$154, U$155, U$157, U$174, U$175, U$176, U$177, U$189, U$190: 1PIN_B-T-B_TOPPAD
U$51, U$111: ANALOG_ADUM162N0BRZ; SO16
U$61: ANALOG_LDO_ADM7172; 8-LFCSP
U$62: HITTITE_HMC980LP4E; 24-QFN
U$84, U$95, U$103, U$119, U$127, U$135, U$143: ANALOG_LDO_ADM7150; 8-LFCSP
U$113: LINEAR_LDO_LT1761-X; SOT-23-5
U$152, U$156: 1PIN_B-T-B_GROUND
U$180: SSW-111-XX-XXX-D

Connections:
6.3V: B.C3.1, B.C4.1, B.C9.1, B.C10.1, B.R10-9.1, R1.2, U$62.P$1 (VDD1), U$62.P$2 (VDD2), U$62.P$7 (CP_VDD)
A-4.8V: B.C7.1, B.C8.1, B.C16-1.1, B.R10-1.1, B.R10-1.2, U$26.P$1, U$28.P$1, U$62.P$4 (S1), U$62.P$9 (VDIG), U$84.P$2 (VOUT)
A-5V: B.R10-8.1; also elsewhere on the board
A-VDD: B.C11.2, B.R10-4.1, B.R10-4.2, U$62.P$17 (VDRAIN1), U$62.P$18 (VDRAIN2), U$174.P$1, U$175.P$1; also elsewhere on the board
A-VGG: B.C12.1, B.C13.1, B.R7.2, U$62.P$16 (VGATE), U$176.P$1, U$177.P$1; also elsewhere on the board
AGND: B.C1.2, B.C2.2, B.C3.2, B.C4.2, B.C5.2, B.C7.2, B.C8.2, B.C9.2, B.C10.2, B.C11.1, B.C12.2, B.C13.2, B.C14.2, B.C15-1.2, B.C15-2.2, B.C15-3.2, B.C15-5.2, B.C15-6.2, B.C15-7.2, B.C15-8.2, B.C16-1.2, B.C16-2.2, B.C16-3.2, B.C16-5.2, B.C16-6.2, B.C16-7.2, B.C16-8.2, B.C17-1.1, B.C17-2.1, B.C17-3.1, B.C17-5.1, B.C17-6.1, B.C17-7.1, B.C17-8.1, B.C18-1.2, B.C18-2.2, B.C18-3.2, B.C18-5.2, B.C18-6.2, B.C18-7.2, B.C18-8.2, B.C19-1.2, B.C19-2.2, B.C19-3.2, B.C19-5.2, B.C19-6.2, B.C19-7.2, B.C19-8.2, B.D1.2, B.R1.2, B.R2.2, C1.C (-), C2.C (-), I.C2.2, I.C3.2, I.C4.2, I.C5.2, I.C9.2, I.R3.1, I.R-1.2, I.R-6.2, I.R-7.2, I.R-8.2, R2.1, R3.2, U$51.9 (GND2), U$61.P$6 (GND), U$61.P$9 (GNDP), U$62.P$3 (S0), U$62.P$25 (GNDP), U$84.P$4 (GND), U$84.P$9 (GNDP), U$95.P$4 (GND), U$95.P$9 (GNDP), U$103.P$4 (GND), U$103.P$9 (GNDP), U$111.9 (GND2), U$113.P$2 (GND), U$119.P$4 (GND), U$119.P$9 (GNDP), U$127.P$4 (GND), U$127.P$9 (GNDP), U$135.P$4 (GND), U$135.P$9 (GNDP), U$143.P$4 (GND), U$143.P$9 (GNDP), U$152.P$2, U$156.P$2, U$180.20, U$180.22; also elsewhere on the board
CS: U$111.14 (VOB); also elsewhere on the board
ISO-3.3V: I.C1.1, I.C2.1, I.C5.1, I.C9.1, U$51.16 (VDD2), U$111.16 (VDD2), U$113.P$5 (OUT)
ISO-BOT-VCC: I.C6.2, U$51.1 (VDD1), U$180.17
ISO-TOP-VCC: I.C8.2, U$111.1 (VDD1), U$180.8
LDO-EN: U$35.P$1, U$36.P$1, U$51.15 (VOA), U$61.P$5 (EN), U$84.P$7 (EN), U$95.P$7 (EN), U$103.P$7 (EN), U$119.P$7 (EN), U$127.P$7 (EN), U$135.P$7 (EN), U$143.P$7 (EN), U$153.P$1
MCU-CS: U$111.3 (VIB), U$180.7
MCU-GND: I.C6.1, I.C8.1, I.R-2.1, I.R-3.1, I.R-4.1, I.R-5.1, U$51.8 (GND1), U$111.8 (GND1), U$180.18
MCU-LDO-EN: U$51.2 (VIA), U$180.14
MCU-MUTE: U$51.4 (VIC), U$180.16
MCU-PA-EN: U$51.3 (VIB), U$180.13
MCU-SCLK: U$111.4 (VIC), U$180.10
MCU-SDI: U$111.5 (VID), U$180.9
MCU-SDO: U$111.6 (VOE), U$180.12
MCU-STAT: U$111.7 (VOF), U$180.11
MUTE: U$51.13 (VOC), U$189.P$1, U$190.P$1; also elsewhere on the board
unnamed: R1.1, R2.2, U$61.P$3 (SENSE)
unnamed: I.R-1.1, U$111.15 (VOA)
unnamed: R3.1, U$62.P$20 (ISENSE)
unnamed: B.R7.1, U$62.P$12 (VGATEFB)
unnamed: B.C5.1, B.D1.1, B.R5.2, U$62.P$15 (VNEG)
unnamed: B.R5.1, U$62.P$11 (VNEGFB)
unnamed: B.C6.1, U$62.P$8 (CP_OUT)
unnamed: B.C6.2, B.D1.3
unnamed: B.R1.1, U$62.P$21 (ALML), U$62.P$22 (ISET), U$62.P$23 (ALMH)
unnamed: B.R2.1, U$62.P$24 (FIXBIAS)
unnamed: B.C14.1, U$61.P$4 (SS)
unnamed: B.C15-1.1, B.L2-1.1, U$84.P$8 (VIN)
unnamed: B.C17-1.2, U$84.P$1 (VREG)
unnamed: B.C18-1.1, U$84.P$5 (REF_SENSE), U$84.P$6 (REF)
unnamed: B.C15-2.1, B.L2-2.1, U$95.P$8 (VIN)
unnamed: J1.7, U$180.1
unnamed: B.C19-1.1, U$84.P$3 (BYP)
unnamed: B.C18-2.1, U$95.P$5 (REF_SENSE), U$95.P$6 (REF)
unnamed: B.C19-2.1, U$95.P$3 (BYP)
unnamed: B.C16-2.1, B.R10-2.2, U$95.P$2 (VOUT)
unnamed: B.C15-5.1, B.L2-5.1, U$119.P$8 (VIN)
unnamed: B.C15-3.1, B.L2-3.1, U$103.P$8 (VIN)
unnamed: B.C17-3.2, U$103.P$1 (VREG)
unnamed: B.C18-3.1, U$103.P$5 (REF_SENSE), U$103.P$6 (REF)
unnamed: B.C19-3.1, U$103.P$3 (BYP)
unnamed: B.C16-3.1, B.R10-3.2, U$103.P$2 (VOUT)
unnamed: B.C17-5.2, U$119.P$1 (VREG)
unnamed: I.C1.2, U$113.P$4 (BYP)
unnamed: J1.5, U$180.3
unnamed: B.C17-2.2, U$95.P$1 (VREG)
unnamed: B.C18-5.1, U$119.P$5 (REF_SENSE), U$119.P$6 (REF)
unnamed: B.C19-5.1, U$119.P$3 (BYP)
unnamed: B.C16-5.1, B.R10-5.2, U$119.P$2 (VOUT)
unnamed: B.C15-6.1, B.L2-6.1, U$127.P$8 (VIN)
unnamed: B.C17-6.2, U$127.P$1 (VREG)
unnamed: B.C18-6.1, U$127.P$5 (REF_SENSE), U$127.P$6 (REF)
unnamed: I.R-5.2, U$111.2 (VIA)
unnamed: B.C16-6.1, B.R10-6.2, U$127.P$2 (VOUT)
unnamed: B.C15-7.1, B.L2-7.1, U$135.P$8 (VIN)
unnamed: B.C17-7.2, U$135.P$1 (VREG)
unnamed: B.C18-7.1, U$135.P$5 (REF_SENSE), U$135.P$6 (REF)
unnamed: B.C19-7.1, U$135.P$3 (BYP)
unnamed: B.C16-7.1, B.R10-7.2, U$135.P$2 (VOUT)
unnamed: B.C15-8.1, B.L2-8.1, U$143.P$8 (VIN)
unnamed: B.C17-8.2, U$143.P$1 (VREG)
unnamed: B.C18-8.1, U$143.P$5 (REF_SENSE), U$143.P$6 (REF)
unnamed: B.C19-8.1, U$143.P$3 (BYP)
unnamed: B.C16-8.1, B.R10-8.2, U$143.P$2 (VOUT)
unnamed: B.C2.1, B.R10-9.2, U$61.P$1 (VOUT1), U$61.P$2 (VOUT2)
unnamed: I.C7.2, I.R3.2
unnamed: J1.8, U$180.2
unnamed: J1.6, U$180.4
unnamed: I.R-2.2, U$51.5 (VID)
unnamed: I.R-4.2, U$51.7 (VOF)
unnamed: I.R-3.2, U$51.6 (VOE)
unnamed: I.R-6.1, U$51.12 (VOD)
unnamed: I.R-7.1, U$51.11 (VIE)
unnamed: I.R-8.1, U$51.10 (VIF)
unnamed: B.C19-6.1, U$127.P$3 (BYP)
O-3.3V: B.R10-3.1, U$19.P$1; also elsewhere on the board
O-5V: B.R10-5.1; also elsewhere on the board
PA-EN: U$51.14 (VOB), U$62.P$5 (EN), U$154.P$1, U$157.P$1
REF-3.3V: B.R10-2.1; also elsewhere on the board
SCLK: U$111.13 (VOC); also elsewhere on the board
SDI: U$111.12 (VOD); also elsewhere on the board
SDO: U$111.11 (VIE); also elsewhere on the board
STAT: U$111.10 (VIF); also elsewhere on the board
VBAT: B.L1.1, B.L2-1.2, B.L2-2.2, B.L2-3.2, B.L2-5.2, B.L2-6.2, B.L2-7.2, B.L2-8.2, C2.A (+), I.C3.1, I.C4.1, I.C7.1, I.L1.2, I.R4.1, U$20.P$1, U$25.P$1, U$113.P$1 (IN), U$113.P$3 (EN), U$155.P$1
VBAT_DIRTY: C1.A (+), I.L1.1, I.R4.2, U$180.19, U$180.21
VIN: B.C1.1, B.L1.2, U$61.P$7 (VIN2), U$61.P$8 (VIN1)
X1-5V: B.R10-6.1; also elsewhere on the board
X2-5V: B.R10-7.1; also elsewhere on the board

Notes on the sheet:
Input Pi filter
All boxed quantities are nets which are connected by another PCB. This is due to this schematic only describing a 2 layer board, while in the below cases the additional layers which would be required are instead put onto another PCB
going to basebandPCB
going to topPCB (on top exterior)

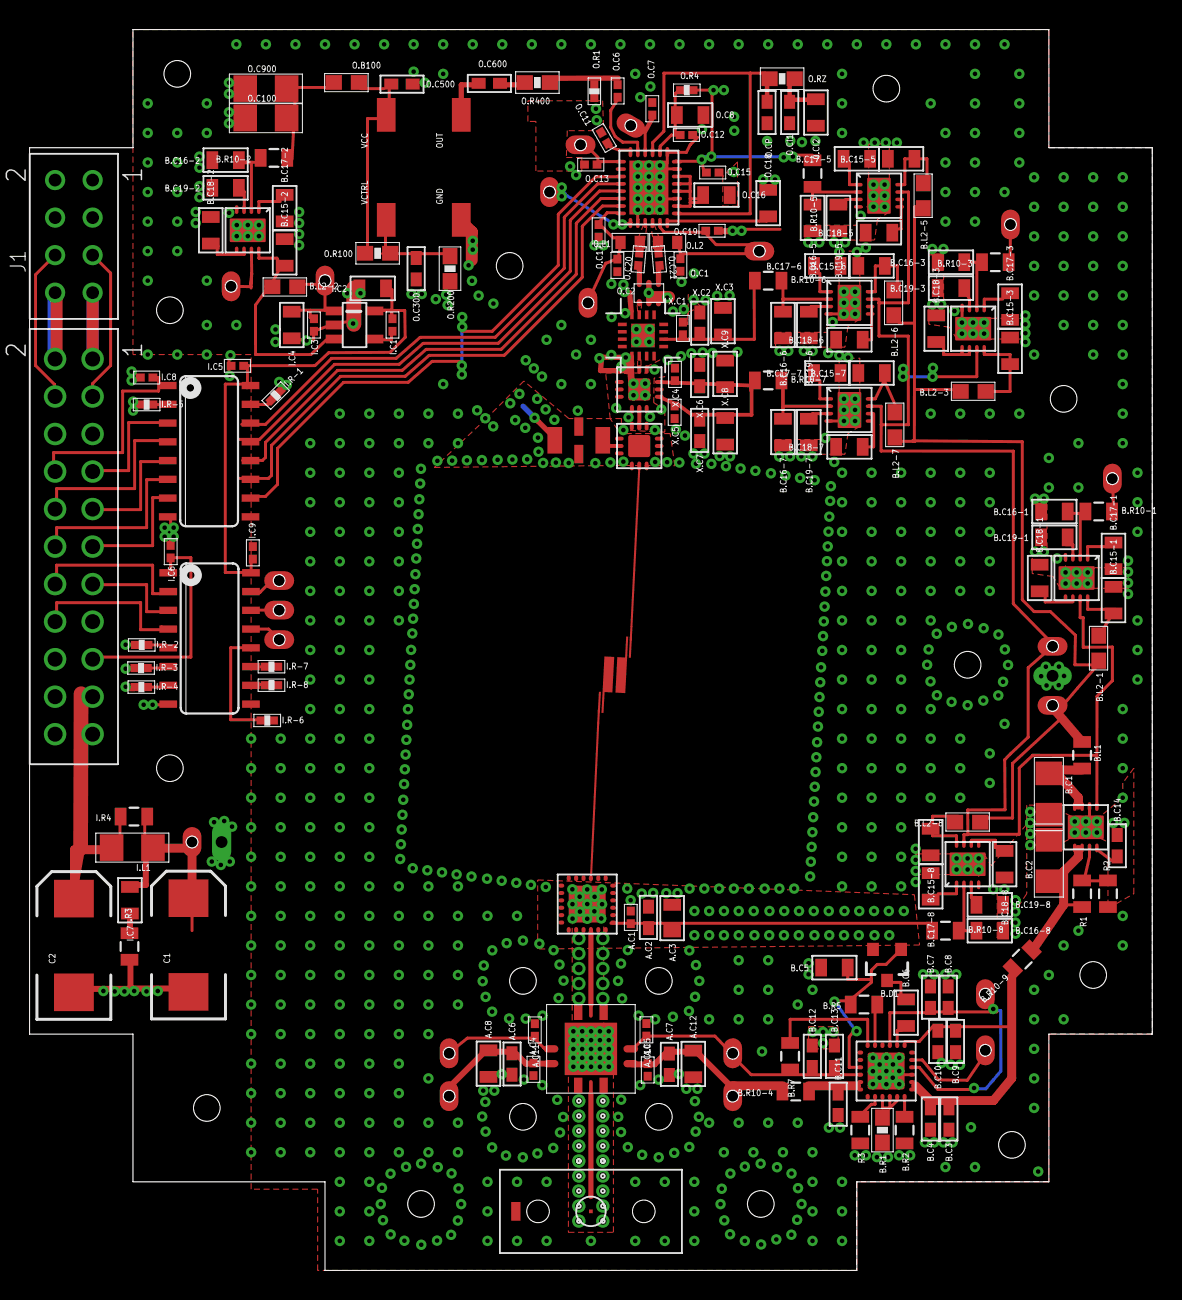
[picture p104: board RFfrontend_v4.brd from above]

Board: 3 copper layers, 76.0 x 84.0 mm, 216 parts (1 on the bottom side), 118 nets.

Other parts of the board:
U$45, U$158, U$159, U$160, U$161, U$162, U$163, U$164, U$165, U$166, U$167, U$170, U$171, U$172, U$173, U$178: #1-72_BOLT_HOLE
U$151: RF_FRONT_END_OUTLINE_V1
U$191, U$192: CPW_VIA_GUIDE
