UWCubeSat/DubSat1/teams/comm2/flight/bottomPCB_f1/bottomPCB_f1.brd

## EAGLE design teams/comm2/flight/bottomPCB_f1/bottomPCB_f1.brd (2018-04-18)

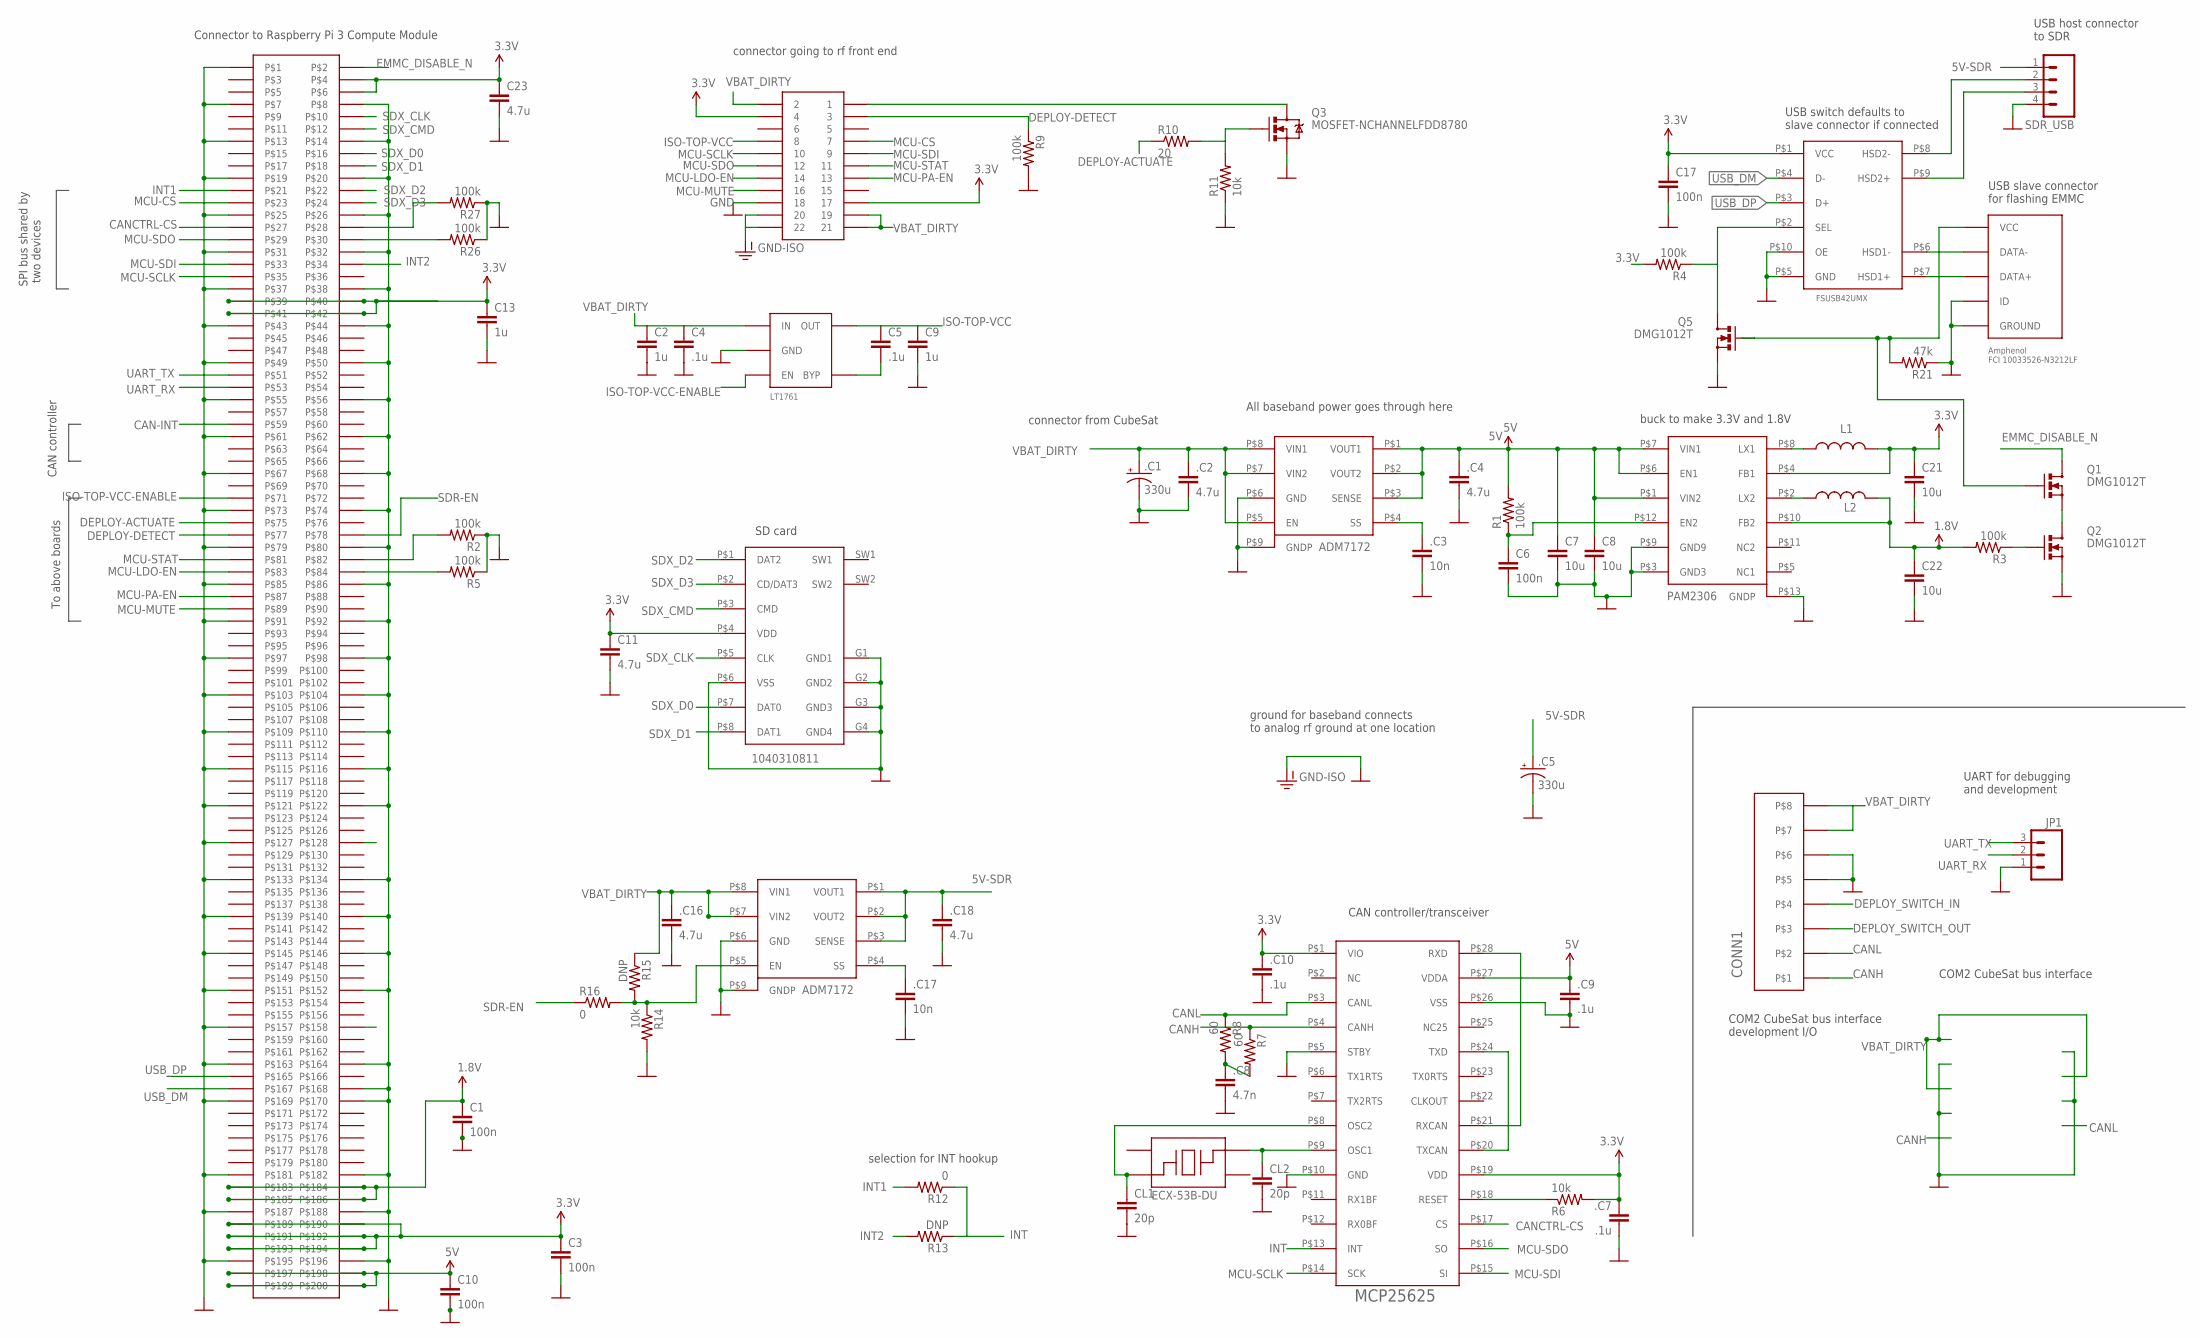
[picture p105: schematic bottomPCB_f1.sch]

Parts:
.C1, .C5: 330u; EIA7343
.C2, .C4, .C16, .C18: 4.7u; 1206
.C3, .C17: 10n; 0805
.C7, .C9, .C10: .1u; 0805
.C8: 4.7n; 0805
C1, C3, C6, C10, C17: 100n; 0805
C2, C9, C13: 1u; 0805
C4, C5: .1u; 0805
C7, C8, C21, C22: 10u; 1206
C11, C23: 4.7u; 0805
CL1, CL2: 20p; 0805
CONN1: PICOLOCK_8PICOLOCK_8; PICOLOCK_8
JP1: M03LOCK; 1X03_LOCK
L1, L2: INDUCTOR_SRN4018; SDR0403
Q1, Q2, Q5: DMG1012T; SOT523
Q3: MOSFET-NCHANNELFDD8780; DPAK
R1, R2, R3, R4, R5, R9, R26, R27: 100k; 0805
R6, R11, R14: 10k; 0805
R7, R8: 60; 0805
R10: 20; 0805
R12, R16: 0; 0805
R13, R15: DNP; 0805
R21: 47k; 0805
SDR_USB: M04LOCK; 1X04_LOCK
U$15: USB_MINI-B_AMPHENOL; USB_MINI_B
U$16, U$26: ANALOG_LDO_ADM7172; 8-LFCSP
U$17: DIDOESINCORPORATED_BUCK_PAM2306; WDFN-12L
U$18: MICROCHIP_CAN_MCP25625_SSOP; SSOP-28
U$19: FAIRCHILD_USB_FSUSB42UMX; MSOP_10_LEAD
U$20: LINEAR_LDO_LT1761-X; SOT-23-5
U$21: DDR2_AMPHENOL_10033853-052FSLF; DDR2
U$22: SD_CARD_1040310811
U$24: ECS_CRYSTAL_ECX-53B-DU; SMD_CRYSTAL
U$180: SSW-111-XX-XXX-D

Connections:
1.8V: C1.1, C22.1, L2.P$2 (2), R3.2, U$17.P$10 (FB2), U$21.P$183, U$21.P$184, U$21.P$185, U$21.P$186
3.3V: .C7.1, .C10.1, C3.1, C11.1, C13.1, C17.1, C21.1, C23.1, L1.P$2 (2), R4.2, R6.2, U$17.P$4 (FB1), U$18.P$1 (VIO), U$18.P$19 (VDD), U$19.P$1 (VCC), U$21.P$4, U$21.P$6, U$21.P$39, U$21.P$40, U$21.P$41, U$21.P$42, U$21.P$189, U$21.P$190, U$21.P$191, U$21.P$192, U$21.P$193, U$21.P$194, U$22.P$4 (VDD), U$180.4, U$180.17
5V: .C4.1, .C9.1, C7.1, C8.1, C10.1, R1.2, U$16.P$1 (VOUT1), U$16.P$2 (VOUT2), U$16.P$3 (SENSE), U$17.P$1 (VIN2), U$17.P$6 (EN1), U$17.P$7 (VIN1), U$18.P$27 (VDDA), U$21.P$197, U$21.P$198, U$21.P$199, U$21.P$200
5V-SDR: .C5.A (+), .C18.1, SDR_USB.1, U$26.P$1 (VOUT1), U$26.P$2 (VOUT2), U$26.P$3 (SENSE)
CAN-INT: U$21.P$59
CANCTRL-CS: U$18.P$17 (CS), U$21.P$27
CANH: CONN1.P$1, R7.1, U$18.P$4 (CANH)
CANL: CONN1.P$2, R8.1, U$18.P$3 (CANL)
DEPLOY-ACTUATE: R10.1, U$21.P$75
DEPLOY-DETECT: R9.1, U$21.P$77, U$180.3
DEPLOY_NEG: Q3.4 (D), U$180.1
DEPLOY_SWITCH_IN: CONN1.P$4
DEPLOY_SWITCH_OUT: CONN1.P$3
EMMC_DISABLE_N: Q1.D, U$21.P$2
EN: R14.1, R15.2, R16.2, U$26.P$5 (EN)
GND: .C1.C (-), .C2.2, .C3.2, .C4.2, .C5.C (-), .C7.2, .C8.2, .C9.2, .C10.2, .C16.2, .C17.2, .C18.2, C1.2, C2.2, C3.2, C4.2, C6.2, C7.2, C8.2, C9.2, C10.2, C11.2, C13.2, C17.2, C21.2, C22.2, C23.2, CL1.2, CL2.2, CONN1.P$5, CONN1.P$6, JP1.1, Q2.S, Q3.3 (S), Q5.S, R2.1, R5.1, R9.2, R11.1, R14.2, R21.1, R26.1, R27.1, SDR_USB.4, U$15.GND1 (GROUND), U$15.GND2 (GROUND), U$15.GND3 (GROUND), U$15.GND4 (GROUND), U$15.GROUND, U$15.ID, U$16.P$6 (GND), U$16.P$9 (GNDP), U$17.P$3 (GND3), U$17.P$9 (GND9), U$17.P$13 (GNDP), U$18.P$5 (STBY), U$18.P$10 (GND), U$18.P$26 (VSS), U$19.P$5 (GND), U$19.P$10 (OE), U$20.P$2 (GND), U$21.P$1, U$21.P$7, U$21.P$8, U$21.P$13, U$21.P$14, U$21.P$19, U$21.P$20, U$21.P$25, U$21.P$26, U$21.P$31, U$21.P$32, U$21.P$37, U$21.P$38, U$21.P$43, U$21.P$44, U$21.P$49, U$21.P$50, U$21.P$55, U$21.P$56, U$21.P$61, U$21.P$62, U$21.P$67, U$21.P$68, U$21.P$73, U$21.P$74, U$21.P$79, U$21.P$80, U$21.P$85, U$21.P$86, U$21.P$91, U$21.P$92, U$21.P$97, U$21.P$98, U$21.P$103, U$21.P$104, U$21.P$109, U$21.P$110, U$21.P$115, U$21.P$116, U$21.P$121, U$21.P$122, U$21.P$127, U$21.P$133, U$21.P$134, U$21.P$139, U$21.P$140, U$21.P$145, U$21.P$146, U$21.P$151, U$21.P$152, U$21.P$157, U$21.P$163, U$21.P$164, U$21.P$168, U$21.P$169, U$21.P$170, U$21.P$181, U$21.P$182, U$21.P$187, U$21.P$188, U$21.P$195, U$21.P$196, U$22.G1 (GND1), U$22.G2 (GND2), U$22.G3 (GND3), U$22.G4 (GND4), U$22.P$6 (VSS), U$26.P$6 (GND), U$26.P$9 (GNDP), U$180.18, U$180.20, U$180.22
INT: R12.1, R13.1, U$18.P$13 (INT)
INT1: R12.2, U$21.P$21
INT2: R13.2, U$21.P$34
ISO-TOP-VCC: C5.1, C9.1, U$20.P$5 (OUT), U$180.8
ISO-TOP-VCC-ENABLE: U$20.P$3 (EN), U$21.P$71
MCU-CS: U$21.P$23, U$180.7
MCU-LDO-EN: U$21.P$83, U$180.14
MCU-MUTE: U$21.P$89, U$180.16
MCU-PA-EN: U$21.P$87, U$180.13
MCU-SCLK: U$18.P$14 (SCK), U$21.P$35, U$180.10
MCU-SDI: U$18.P$15 (SI), U$21.P$33, U$180.9
MCU-SDO: U$18.P$16 (SO), U$21.P$29, U$180.12
MCU-STAT: U$21.P$81, U$180.11
unnamed: L1.P$1 (1), U$17.P$8 (LX1)
unnamed: .C3.1, U$16.P$4 (SS)
unnamed: Q1.S, Q2.D
unnamed: L2.P$1 (1), U$17.P$2 (LX2)
unnamed: C6.1, R1.1, U$17.P$12 (EN2)
unnamed: R27.2, U$21.P$28
unnamed: R26.2, U$21.P$30
unnamed: U$15.DATA-, U$19.P$6 (HSD1-)
unnamed: U$15.DATA+, U$19.P$7 (HSD1+)
unnamed: SDR_USB.2, U$19.P$8 (HSD2-)
unnamed: SDR_USB.3, U$19.P$9 (HSD2+)
unnamed: Q5.D, R4.1, U$19.P$2 (SEL)
unnamed: R2.2, U$21.P$82
unnamed: R5.2, U$21.P$84
unnamed: C5.2, U$20.P$4 (BYP)
unnamed: R6.1, U$18.P$18 (RESET)
unnamed: U$18.P$20 (TXCAN), U$18.P$24 (TXD)
unnamed: .C8.1, R7.2, R8.2
unnamed: CL2.1, U$18.P$9 (OSC1), U$24.P$3
unnamed: CL1.1, U$18.P$8 (OSC2), U$24.P$1
unnamed: U$18.P$21 (RXCAN), U$18.P$28 (RXD)
unnamed: Q3.1 (G), R10.2, R11.2
unnamed: .C17.1, U$26.P$4 (SS)
Q2: Q2.G, R3.1
SDR-EN: R16.1, U$21.P$78
SDX_CLK: U$21.P$10, U$22.P$5 (CLK)
SDX_CMD: U$21.P$12, U$22.P$3 (CMD)
SDX_D0: U$21.P$16, U$22.P$7 (DAT0)
SDX_D1: U$21.P$18, U$22.P$8 (DAT1)
SDX_D2: U$21.P$22, U$22.P$1 (DAT2)
SDX_D3: U$21.P$24, U$22.P$2 (CD/DAT3)
UART_RX: JP1.2, U$21.P$53
UART_TX: JP1.3, U$21.P$51
USB_DM: U$19.P$4 (D-), U$21.P$167
USB_DP: U$19.P$3 (D+), U$21.P$165
VBAT_DIRTY: .C1.A (+), .C2.1, .C16.1, C2.1, C4.1, CONN1.P$7, CONN1.P$8, R15.1, U$16.P$5 (EN), U$16.P$7 (VIN2), U$16.P$8 (VIN1), U$20.P$1 (IN), U$26.P$7 (VIN2), U$26.P$8 (VIN1), U$180.2, U$180.19, U$180.21
VBUSB: Q1.G, Q5.G, R21.2, U$15.VCC

Notes on the sheet:
ground for baseband connects to analog rf ground at one location
connector going to rf front end
connector from CubeSat
All baseband power goes through here
buck to make 3.3V and 1.8V
USB switch defaults to slave connector if connected
USB slave connector for flashing EMMC
USB host connector to SDR
Connector to Raspberry Pi 3 Compute Module
UART for debugging and development
SPI bus shared by two devices
To above boards
COM2 CubeSat bus interface
CAN controller
COM2 CubeSat bus interface development I/O
CAN controller/transceiver
SD card
selection for INT hookup
