UWCubeSat/DubSat1/teams/comm2/flight/bottomPCB_f1/bottomPCB_f1.brd

## EAGLE design teams/comm2/flight/bottomPCB_f1/bottomPCB_f1.brd (continued)

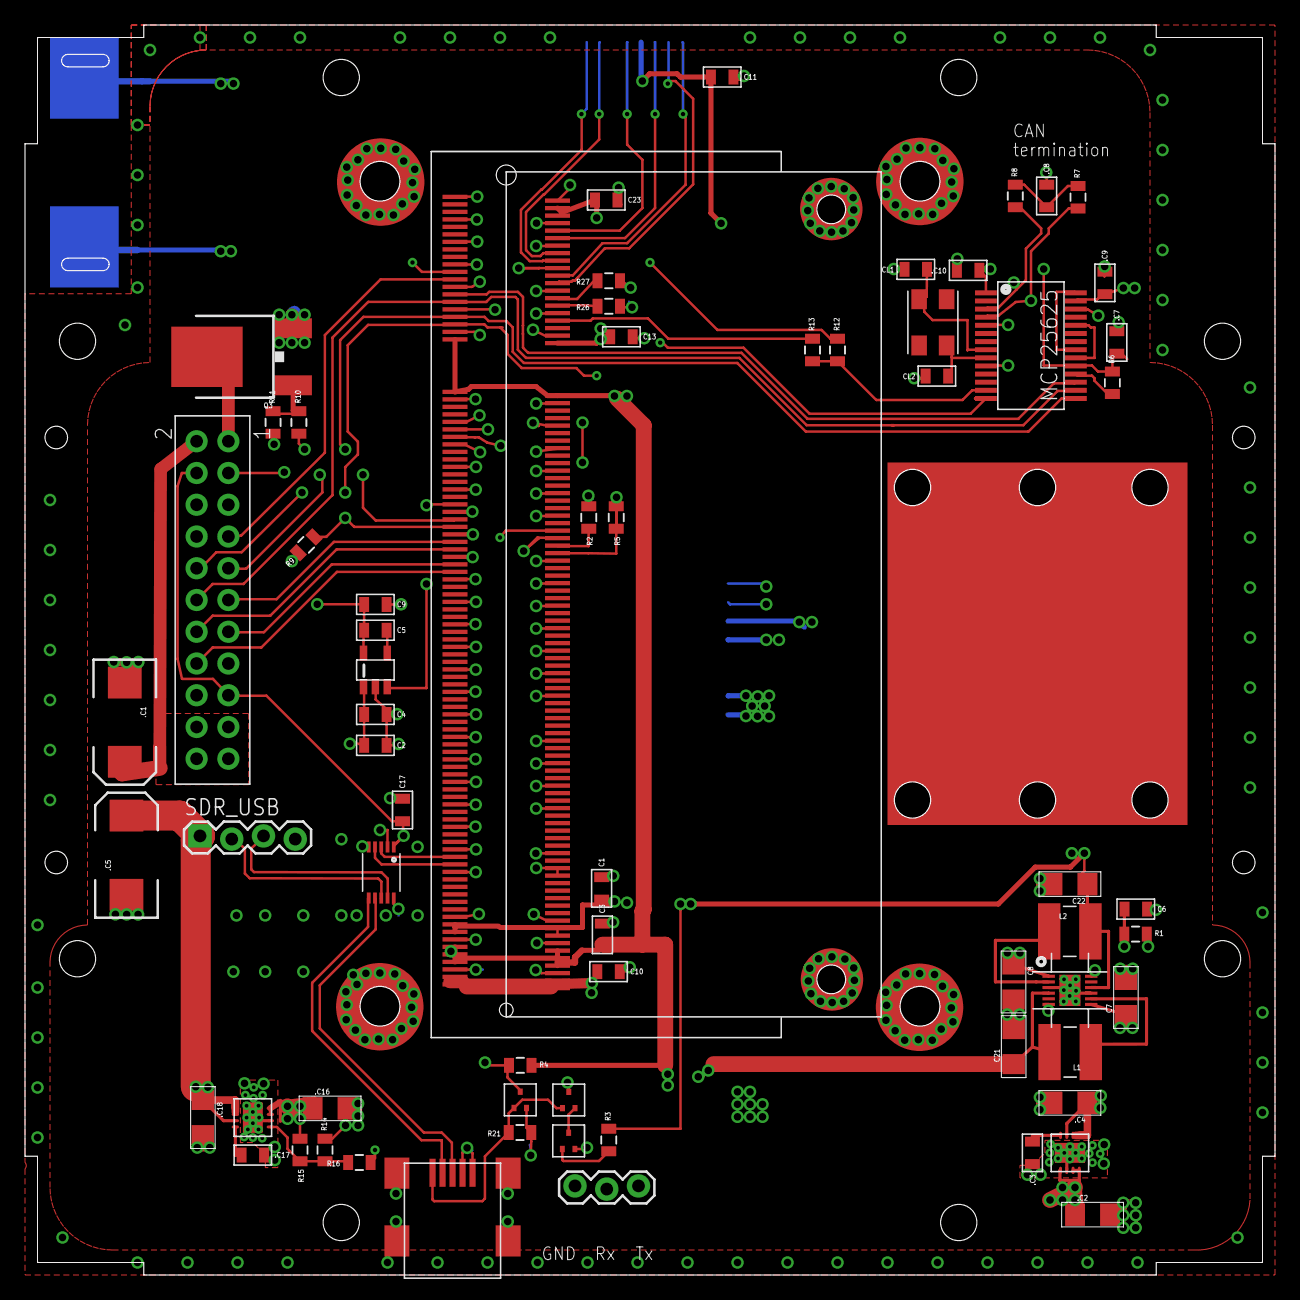
[picture p106: board bottomPCB_f1.brd from above]

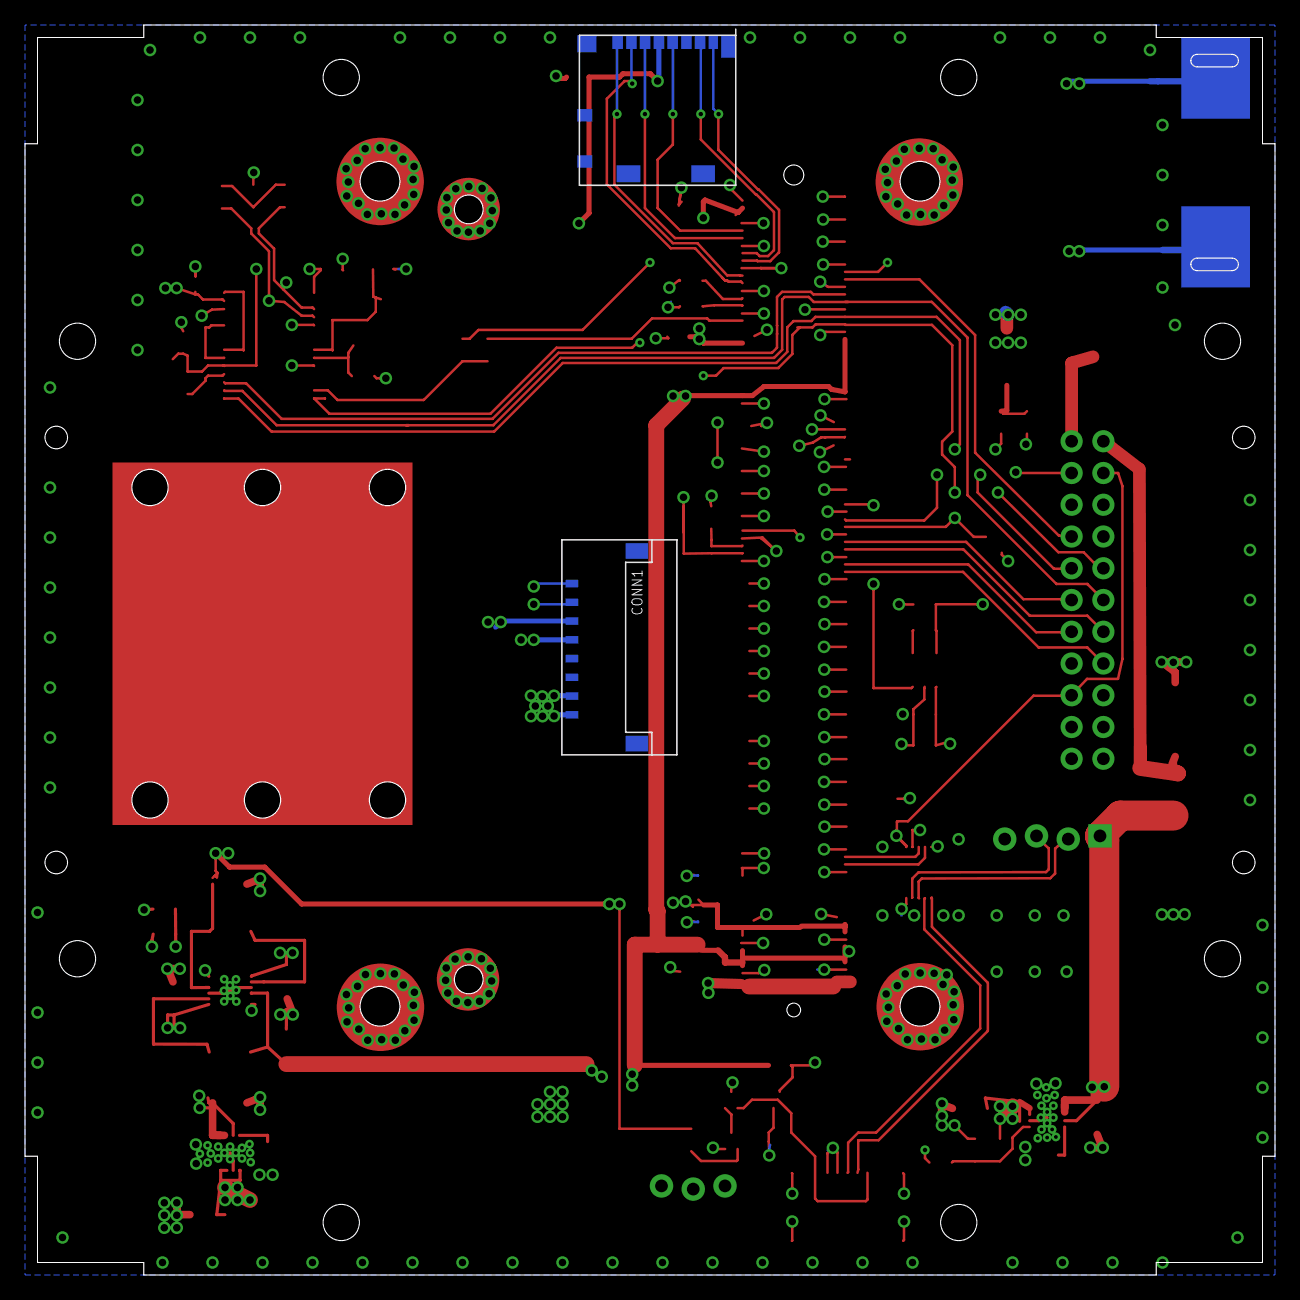
[picture p107: board bottomPCB_f1.brd from below]

Board: 4 copper layers, 100.0 x 100.0 mm, 82 parts (2 on the bottom side), 63 nets.

Other parts of the board:
U$1, U$2, U$3, U$4, U$7, U$8, U$9, U$10: #4-40_BOLT_HOLE
U$5, U$6, U$11, U$12: #1-72_BOLT_HOLE
U$23: SDR_B200MINI
