UWCubeSat/DubSat1/teams/adcs/hardware/engineering_model/reaction_wheel/reaction_wheel_board_2017_12_11.brd

## EAGLE design teams/adcs/hardware/engineering_model/reaction_wheel/reaction_wheel_board_2017_12_11.brd (2018-04-01)

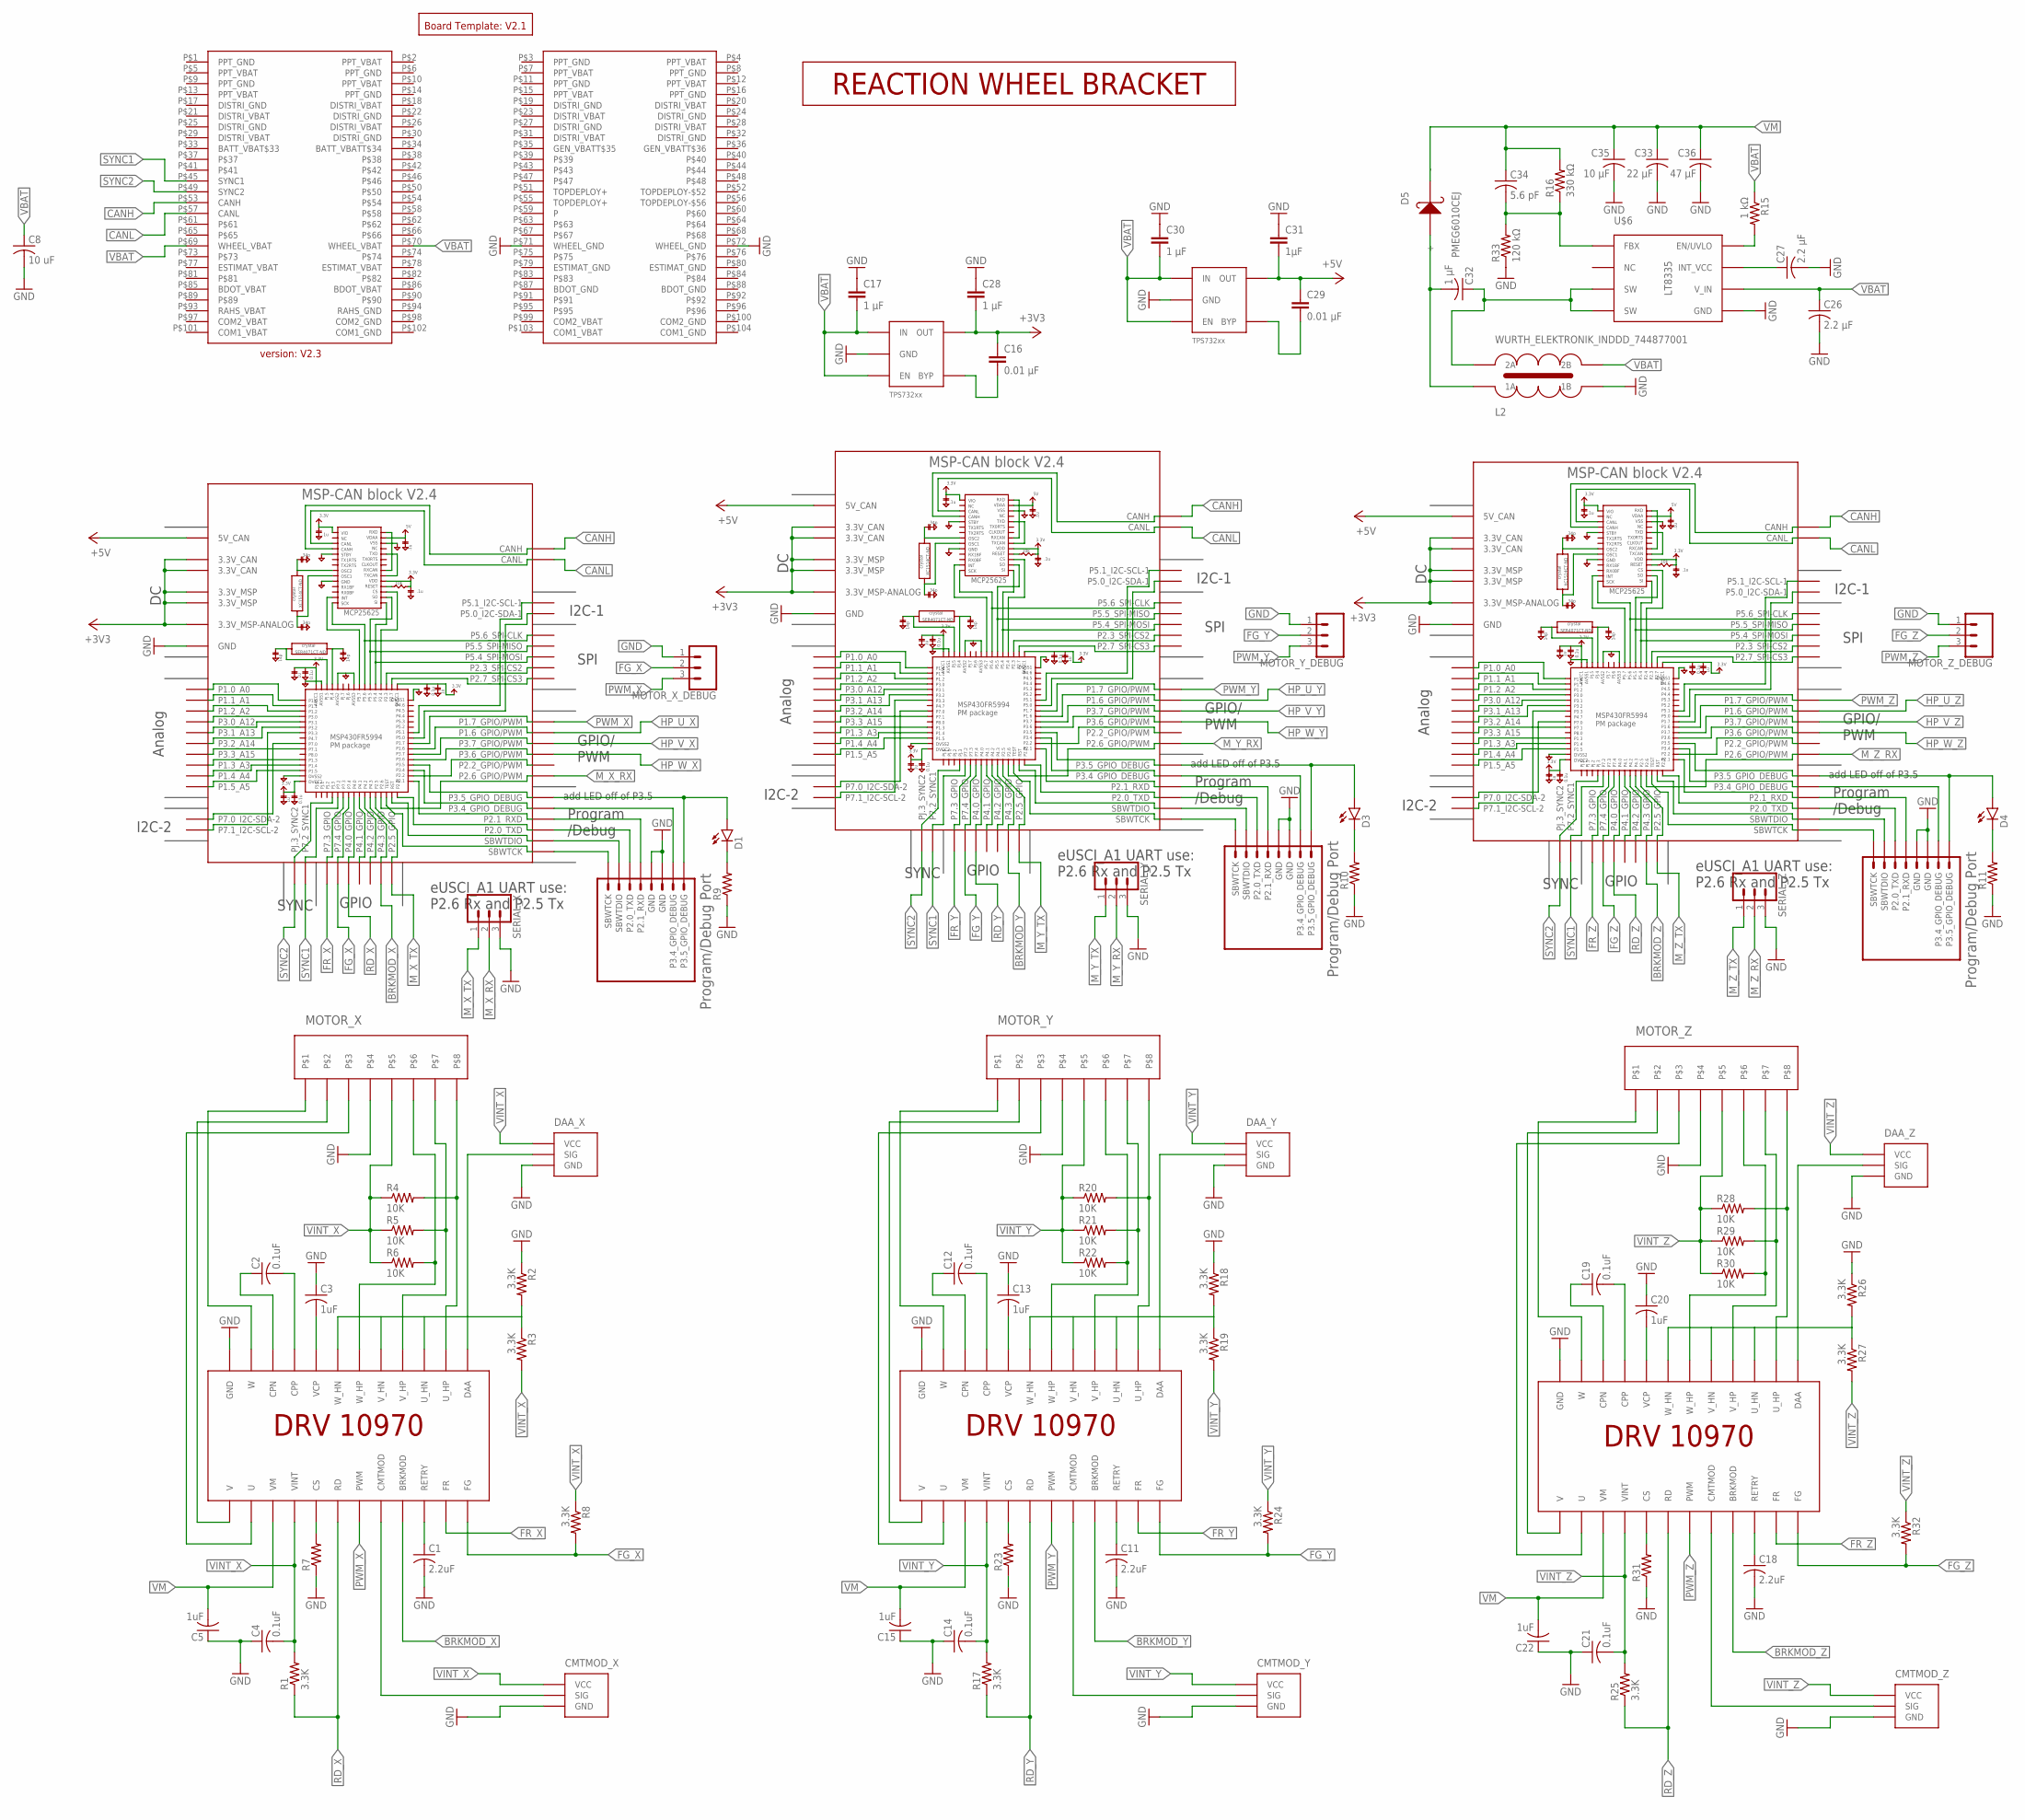
[picture p108: schematic reaction_wheel_board_2017_12_11.sch]

Parts:
C1, C11, C18: 2.2uF; C1206
C2, C4, C12, C14, C19, C21: 0.1uF; C0805
C3, C5, C13, C15, C20, C22: 1uF; C1206
C8: 10 uF; C0805
C16, C29: 0.01 μF; 0805
C17, C28, C30: 1 μF; 0805
C26, C27: 2.2 μF; C0805
C31: 1μF; 0805
C32: 1 μF; C0805
C33: 22 μF; C1206
C34: 5.6 pF; C0805
C35: 10 μF; C0805
C36: 47 μF; C1206
CMTMOD_X: 0_OHM_JUMPER
CMTMOD_Y: 0_OHM_JUMPER
CMTMOD_Z: 0_OHM_JUMPER
D1, D3, D4: LED; LED-1206
D5: PMEG6010CEJ; SC-90
DAA_X: 0_OHM_JUMPER
DAA_Y: 0_OHM_JUMPER
DAA_Z: 0_OHM_JUMPER
L2: WURTH_ELEKTRONIK_INDDD_744877001
MOTOR_X: PICOLOCK_8
MOTOR_X_DEBUG: CONN_03LOCK; 1X03_LOCK
MOTOR_Y: PICOLOCK_8
MOTOR_Y_DEBUG: CONN_03LOCK; 1X03_LOCK
MOTOR_Z: PICOLOCK_8
MOTOR_Z_DEBUG: CONN_03LOCK; 1X03_LOCK
MSP_X_DEBUG: PROGRAM/DEBUG_PORT; 1X08_CONNECTOR
MSP_Y_DEBUG: PROGRAM/DEBUG_PORT; 1X08_CONNECTOR
MSP_Z_DEBUG: PROGRAM/DEBUG_PORT; 1X08_CONNECTOR
PC104: PC104_CONNECTOR
R1, R2, R3, R8, R17, R18, R19, R24, R25, R26, R27, R32: 3.3K; 0805
R4, R5, R6, R20, R21, R22, R28, R29, R30: 10K; 0805
R7, R9, R10, R11, R23, R31: RESISTOR0805; 0805
R15: 1 kΩ; 0805
R16: 330 kΩ; 0805
R33: 120 kΩ; 0805
SERIAL_X: CONN_03LOCK; 1X03_LOCK
SERIAL_Y: CONN_03LOCK; 1X03_LOCK
SERIAL_Z: CONN_03LOCK; 1X03_LOCK
U2, U3: TPS732XX; SOT-23-5
U$1: BOARD_TEMPLATESERCURED; BOARD_TEMPLATE_SECURED
U$3, U$10, U$13: MSP-CAN_BLOCK
U$6: LT8335; DDB
U$7, U$12, U$15: DRV10970
U$9: REACTION_WHEEL_BRACKET

Connections:
+3V3: C16.1, C28.2, U2.P$5 (OUT), U$3.3.3V@CAN1 (3.3V_CAN), U$3.3.3V@CAN2 (3.3V_CAN), U$3.3.3V@MSP1 (3.3V_MSP), U$3.3.3V@MSP2 (3.3V_MSP), U$3.3.3V_ANALOG@MSP2 (3.3V_MSP-ANALOG), U$10.3.3V@CAN1 (3.3V_CAN), U$10.3.3V@CAN2 (3.3V_CAN), U$10.3.3V@MSP1 (3.3V_MSP), U$10.3.3V@MSP2 (3.3V_MSP), U$10.3.3V_ANALOG@MSP2 (3.3V_MSP-ANALOG), U$13.3.3V@CAN1 (3.3V_CAN), U$13.3.3V@CAN2 (3.3V_CAN), U$13.3.3V@MSP1 (3.3V_MSP), U$13.3.3V@MSP2 (3.3V_MSP), U$13.3.3V_ANALOG@MSP2 (3.3V_MSP-ANALOG)
+5V: C29.1, C31.2, U3.P$5 (OUT), U$3.5V (5V_CAN), U$10.5V (5V_CAN), U$13.5V (5V_CAN)
BRKMOD_X: U$3.P4.3_GPIO, U$7.BRKMOD
BRKMOD_Y: U$10.P4.3_GPIO, U$12.BRKMOD
BRKMOD_Z: U$13.P4.3_GPIO, U$15.BRKMOD
CANH: PC104.P$53 (CANH), U$3.CANH, U$10.CANH, U$13.CANH
CANL: PC104.P$57 (CANL), U$3.CANL, U$10.CANL, U$13.CANL
CMTMOD_X: CMTMOD_X.P$2 (SIG), U$7.CMTMOD
CMTMOD_Y: CMTMOD_Y.P$2 (SIG), U$12.CMTMOD
CMTMOD_Z: CMTMOD_Z.P$2 (SIG), U$15.CMTMOD
CPN_X: C2.1, U$7.CPN
CPN_Y: C12.1, U$12.CPN
CPN_Z: C19.1, U$15.CPN
CPP_X: C2.2, U$7.CPP
CPP_Y: C12.2, U$12.CPP
CPP_Z: C19.2, U$15.CPP
CS_X: R7.2, U$7.CS
CS_Y: R23.2, U$12.CS
CS_Z: R31.2, U$15.CS
DAA_X: DAA_X.P$2 (SIG), U$7.DAA
DAA_Y: DAA_Y.P$2 (SIG), U$12.DAA
DAA_Z: DAA_Z.P$2 (SIG), U$15.DAA
EN_UVLO: R15.2, U$6.P$8 (EN/UVLO)
FBX: C34.2, R16.1, R33.2, U$6.P$1 (FBX)
FG_X: MOTOR_X_DEBUG.2, R8.2, U$3.P7.4_GPIO, U$7.FG
FG_Y: MOTOR_Y_DEBUG.2, R24.2, U$10.P7.4_GPIO, U$12.FG
FG_Z: MOTOR_Z_DEBUG.2, R32.2, U$13.P7.4_GPIO, U$15.FG
FR_X: U$3.P7.3_GPIO, U$7.FR
FR_Y: U$10.P7.3_GPIO, U$12.FR
FR_Z: U$13.P7.3_GPIO, U$15.FR
GND: C1.2, C3.1, C4.1, C5.1, C8.2, C11.2, C13.1, C14.1, C15.1, C17.1, C18.2, C20.1, C21.1, C22.1, C26.2, C27.2, C28.1, C30.1, C31.1, C33.2, C35.2, C36.2, CMTMOD_X.P$1 (GND), CMTMOD_Y.P$1 (GND), CMTMOD_Z.P$1 (GND), DAA_X.P$1 (GND), DAA_Y.P$1 (GND), DAA_Z.P$1 (GND), L2.P$2 (1B), MOTOR_X.P$4, MOTOR_X_DEBUG.1, MOTOR_Y.P$4, MOTOR_Y_DEBUG.1, MOTOR_Z.P$4, MOTOR_Z_DEBUG.1, MSP_X_DEBUG.5 (GND), MSP_X_DEBUG.6 (GND), MSP_Y_DEBUG.5 (GND), MSP_Y_DEBUG.6 (GND), MSP_Z_DEBUG.5 (GND), MSP_Z_DEBUG.6 (GND), PC104.P$71 (WHEEL_GND), PC104.P$72 (WHEEL_GND), R2.1, R7.1, R9.1, R10.1, R11.1, R18.1, R23.1, R26.1, R31.1, R33.1, SERIAL_X.3, SERIAL_Y.3, SERIAL_Z.3, U2.P$2 (GND), U3.P$2 (GND), U$3.GND@1 (GND), U$3.GND@2 (GND), U$3.GND@3 (GND), U$3.GND@4 (GND), U$3.GND@5 (GND), U$3.GND@7 (GND), U$3.GND@8 (GND), U$3.GND@9 (GND), U$3.GND@10 (GND), U$3.GND@11 (GND), U$3.GND@12 (GND), U$3.GND@13 (GND), U$3.GND@14 (GND), U$3.GND@15 (GND), U$3.GND@16 (GND), U$3.GND@17 (GND), U$3.GND@26 (GND), U$6.GND, U$6.P$5 (GND), U$7.GND@1 (GND), U$7.GND@2 (GND), U$10.GND@1 (GND), U$10.GND@2 (GND), U$10.GND@3 (GND), U$10.GND@4 (GND), U$10.GND@5 (GND), U$10.GND@7 (GND), U$10.GND@8 (GND), U$10.GND@9 (GND), U$10.GND@10 (GND), U$10.GND@11 (GND), U$10.GND@12 (GND), U$10.GND@13 (GND), U$10.GND@14 (GND), U$10.GND@15 (GND), U$10.GND@16 (GND), U$10.GND@17 (GND), U$10.GND@26 (GND), U$12.GND@1 (GND), U$12.GND@2 (GND), U$13.GND@1 (GND), U$13.GND@2 (GND), U$13.GND@3 (GND), U$13.GND@4 (GND), U$13.GND@5 (GND), U$13.GND@7 (GND), U$13.GND@8 (GND), U$13.GND@9 (GND), U$13.GND@10 (GND), U$13.GND@11 (GND), U$13.GND@12 (GND), U$13.GND@13 (GND), U$13.GND@14 (GND), U$13.GND@15 (GND), U$13.GND@16 (GND), U$13.GND@17 (GND), U$13.GND@26 (GND), U$15.GND@1 (GND), U$15.GND@2 (GND)
GPIO_DEBUG_3.4_X: MSP_X_DEBUG.7 (P3.4_GPIO_DEBUG), U$3.P3.4_GPIO_DEBUG
GPIO_DEBUG_3.4_Y: MSP_Y_DEBUG.7 (P3.4_GPIO_DEBUG), U$10.P3.4_GPIO_DEBUG
GPIO_DEBUG_3.4_Z: MSP_Z_DEBUG.7 (P3.4_GPIO_DEBUG), U$13.P3.4_GPIO_DEBUG
GPIO_DEBUG_3.5_X: D1.A, MSP_X_DEBUG.8 (P3.5_GPIO_DEBUG), U$3.P3.5_GPIO_DEBUG
GPIO_DEBUG_3.5_Y: D3.A, MSP_Y_DEBUG.8 (P3.5_GPIO_DEBUG), U$10.P3.5_GPIO_DEBUG
GPIO_DEBUG_3.5_Z: D4.A, MSP_Z_DEBUG.8 (P3.5_GPIO_DEBUG), U$13.P3.5_GPIO_DEBUG
HN_X: R2.2, R3.1, U$7.U_HN, U$7.V_HN, U$7.W_HN
HN_Y: R18.2, R19.1, U$12.U_HN, U$12.V_HN, U$12.W_HN
HN_Z: R26.2, R27.1, U$15.U_HN, U$15.V_HN, U$15.W_HN
HP_U_X: MOTOR_X.P$8, R4.2, U$3.P1.6_GPIO/PWM, U$7.U_HP
HP_U_Y: MOTOR_Y.P$8, R20.2, U$10.P1.6_GPIO/PWM, U$12.U_HP
HP_U_Z: MOTOR_Z.P$8, R28.2, U$13.P1.6_GPIO/PWM, U$15.U_HP
HP_V_X: MOTOR_X.P$7, R5.2, U$3.P3.7_GPIO/PWM, U$7.V_HP
HP_V_Y: MOTOR_Y.P$7, R21.2, U$10.P3.7_GPIO/PWM, U$12.V_HP
HP_V_Z: MOTOR_Z.P$7, R29.2, U$13.P3.7_GPIO/PWM, U$15.V_HP
HP_W_X: MOTOR_X.P$6, R6.2, U$3.P3.6_GPIO/PWM, U$7.W_HP
HP_W_Y: MOTOR_Y.P$6, R22.2, U$10.P3.6_GPIO/PWM, U$12.W_HP
HP_W_Z: MOTOR_Z.P$6, R30.2, U$13.P3.6_GPIO/PWM, U$15.W_HP
INT_VCC: C27.1, U$6.P$7 (INT_VCC)
LDO_3V3_BYP2: C16.2, U2.P$4 (BYP)
LDO_5V_BYP: C29.2, U3.P$4 (BYP)
M_X_RX: SERIAL_X.2, U$3.P2.6_GPIO/PWM
M_X_TX: SERIAL_X.1, U$3.P2.5_GPIO
M_Y_RX: SERIAL_Y.2, U$10.P2.6_GPIO/PWM
M_Y_TX: SERIAL_Y.1, U$10.P2.5_GPIO
M_Z_RX: SERIAL_Z.2, U$13.P2.6_GPIO/PWM
M_Z_TX: SERIAL_Z.1, U$13.P2.5_GPIO
unnamed: D4.C, R11.2
unnamed: D3.C, R10.2
unnamed: D1.C, R9.2
PWM_X: MOTOR_X_DEBUG.3, U$3.P1.7_GPIO/PWM, U$7.PWM
PWM_Y: MOTOR_Y_DEBUG.3, U$10.P1.7_GPIO/PWM, U$12.PWM
PWM_Z: MOTOR_Z_DEBUG.3, U$13.P1.7_GPIO/PWM, U$15.PWM
RD_X: R1.1, U$3.P4.0_GPIO, U$7.RD
RD_Y: R17.1, U$10.P4.0_GPIO, U$12.RD
RD_Z: R25.1, U$13.P4.0_GPIO, U$15.RD
RETRY_X: C1.1, U$7.RETRY
RETRY_Y: C11.1, U$12.RETRY
RETRY_Z: C18.1, U$15.RETRY
RXD_X: MSP_X_DEBUG.4 (P2.1_RXD), U$3.P2.1_RXD
RXD_Y: MSP_Y_DEBUG.4 (P2.1_RXD), U$10.P2.1_RXD
RXD_Z: MSP_Z_DEBUG.4 (P2.1_RXD), U$13.P2.1_RXD
SBWTCK_X: MSP_X_DEBUG.SBWTCK, U$3.SBWTCK
SBWTCK_Y: MSP_Y_DEBUG.SBWTCK, U$10.SBWTCK
SBWTCK_Z: MSP_Z_DEBUG.SBWTCK, U$13.SBWTCK
SBWTDIO_X: MSP_X_DEBUG.2 (SBWTDIO), U$3.SBWTDIO
SBWTDIO_Y: MSP_Y_DEBUG.2 (SBWTDIO), U$10.SBWTDIO
SBWTDIO_Z: MSP_Z_DEBUG.2 (SBWTDIO), U$13.SBWTDIO
SW: C32.1, L2.P$3 (2A), U$6.P$3 (SW), U$6.P$4 (SW)
SYNC1: PC104.P$45 (SYNC1), U$3.P7.2_SYNC1, U$10.P7.2_SYNC1, U$13.P7.2_SYNC1
SYNC2: PC104.P$49 (SYNC2), U$3.PJ.3_SYNC2, U$10.PJ.3_SYNC2, U$13.PJ.3_SYNC2
TXD_X: MSP_X_DEBUG.3 (P2.0_TXD), U$3.P2.0_TXD
TXD_Y: MSP_Y_DEBUG.3 (P2.0_TXD), U$10.P2.0_TXD
TXD_Z: MSP_Z_DEBUG.3 (P2.0_TXD), U$13.P2.0_TXD
U_X: MOTOR_X.P$3, U$7.U
U_Y: MOTOR_Y.P$3, U$12.U
U_Z: MOTOR_Z.P$3, U$15.U
VBAT: C8.1, C17.2, C26.1, C30.2, L2.P$4 (2B), PC104.P$69 (WHEEL_VBAT), PC104.P$70 (WHEEL_VBAT), R15.1, U2.P$1 (IN), U2.P$3 (EN), U3.P$1 (IN), U3.P$3 (EN), U$6.P$6 (V_IN)
VCP_X: C3.2, U$7.VCP
VCP_Y: C13.2, U$12.VCP
VCP_Z: C20.2, U$15.VCP
VD: C32.2, D5.P$1 (+), L2.P$1 (1A)
VINT_X: C4.2, CMTMOD_X.P$3 (VCC), DAA_X.P$3 (VCC), MOTOR_X.P$5, R1.2, R3.2, R4.1, R5.1, R6.1, R8.1, U$7.VINT
VINT_Y: C14.2, CMTMOD_Y.P$3 (VCC), DAA_Y.P$3 (VCC), MOTOR_Y.P$5, R17.2, R19.2, R20.1, R21.1, R22.1, R24.1, U$12.VINT
VINT_Z: C21.2, CMTMOD_Z.P$3 (VCC), DAA_Z.P$3 (VCC), MOTOR_Z.P$5, R25.2, R27.2, R28.1, R29.1, R30.1, R32.1, U$15.VINT
VM: C5.2, C15.2, C22.2, C33.1, C34.1, C35.1, C36.1, D5.P$2 (-), R16.2, U$7.VM, U$12.VM, U$15.VM
V_X: MOTOR_X.P$2, U$7.V
V_Y: MOTOR_Y.P$2, U$12.V
V_Z: MOTOR_Z.P$2, U$15.V
W_X: MOTOR_X.P$1, U$7.W
W_Y: MOTOR_Y.P$1, U$12.W
W_Z: MOTOR_Z.P$1, U$15.W

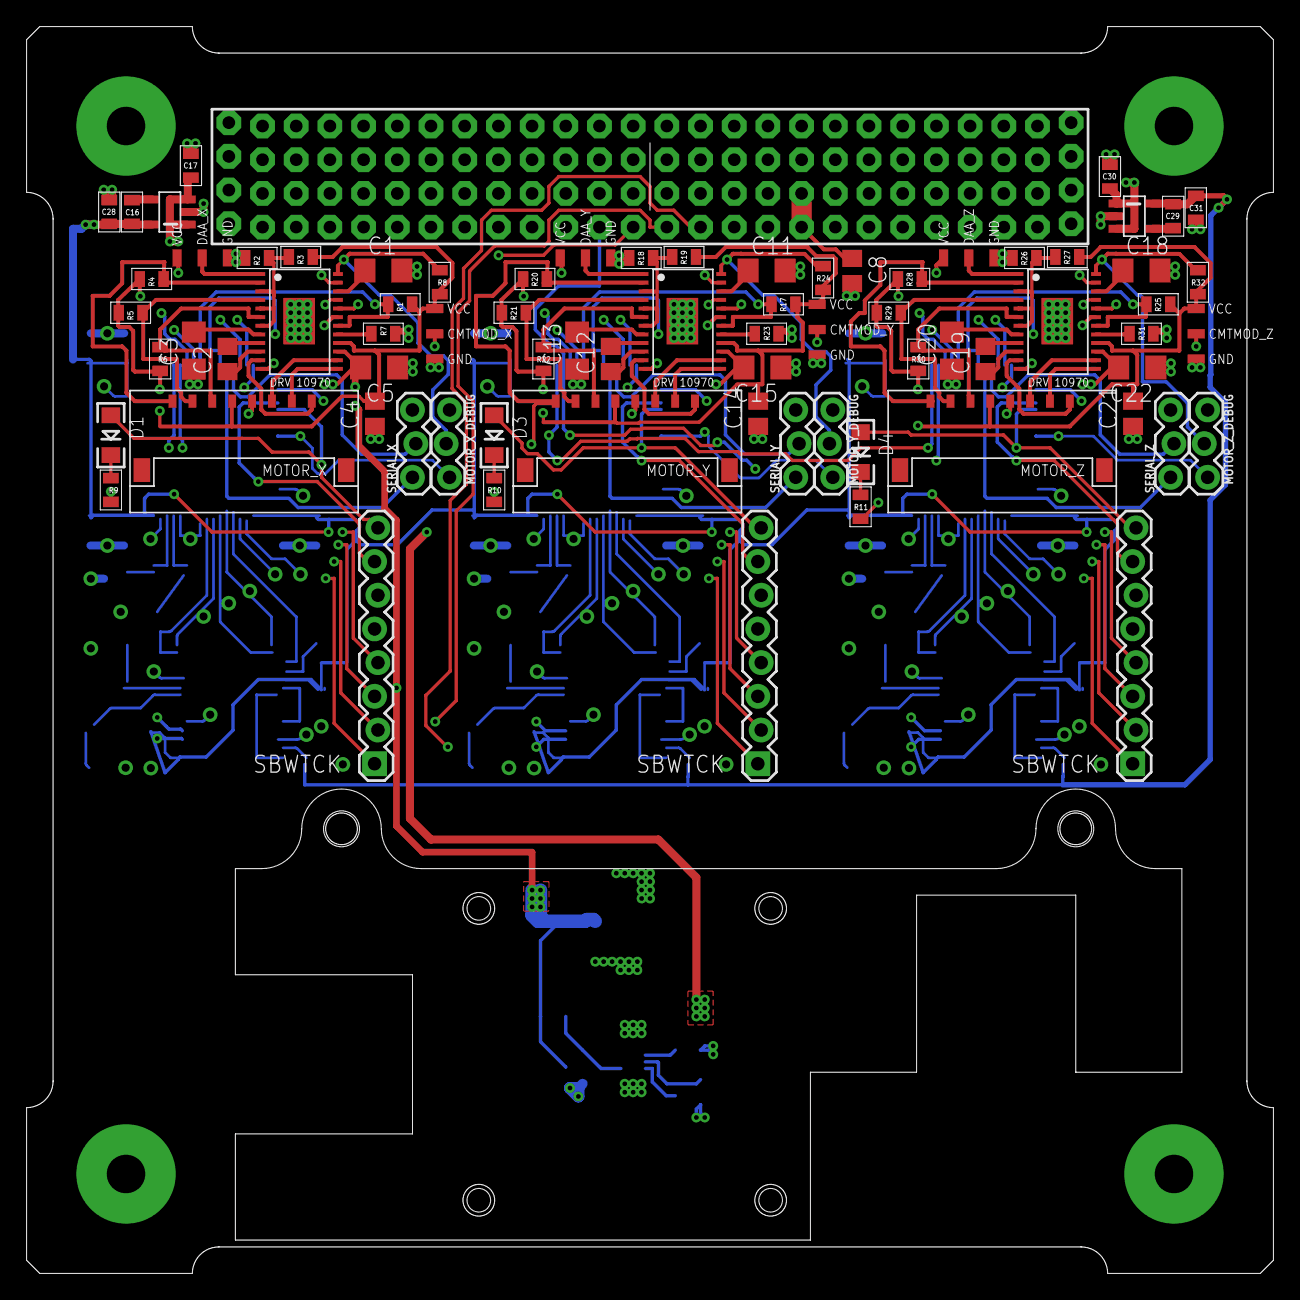
[picture p109: board reaction_wheel_board_2017_12_11.brd from above]

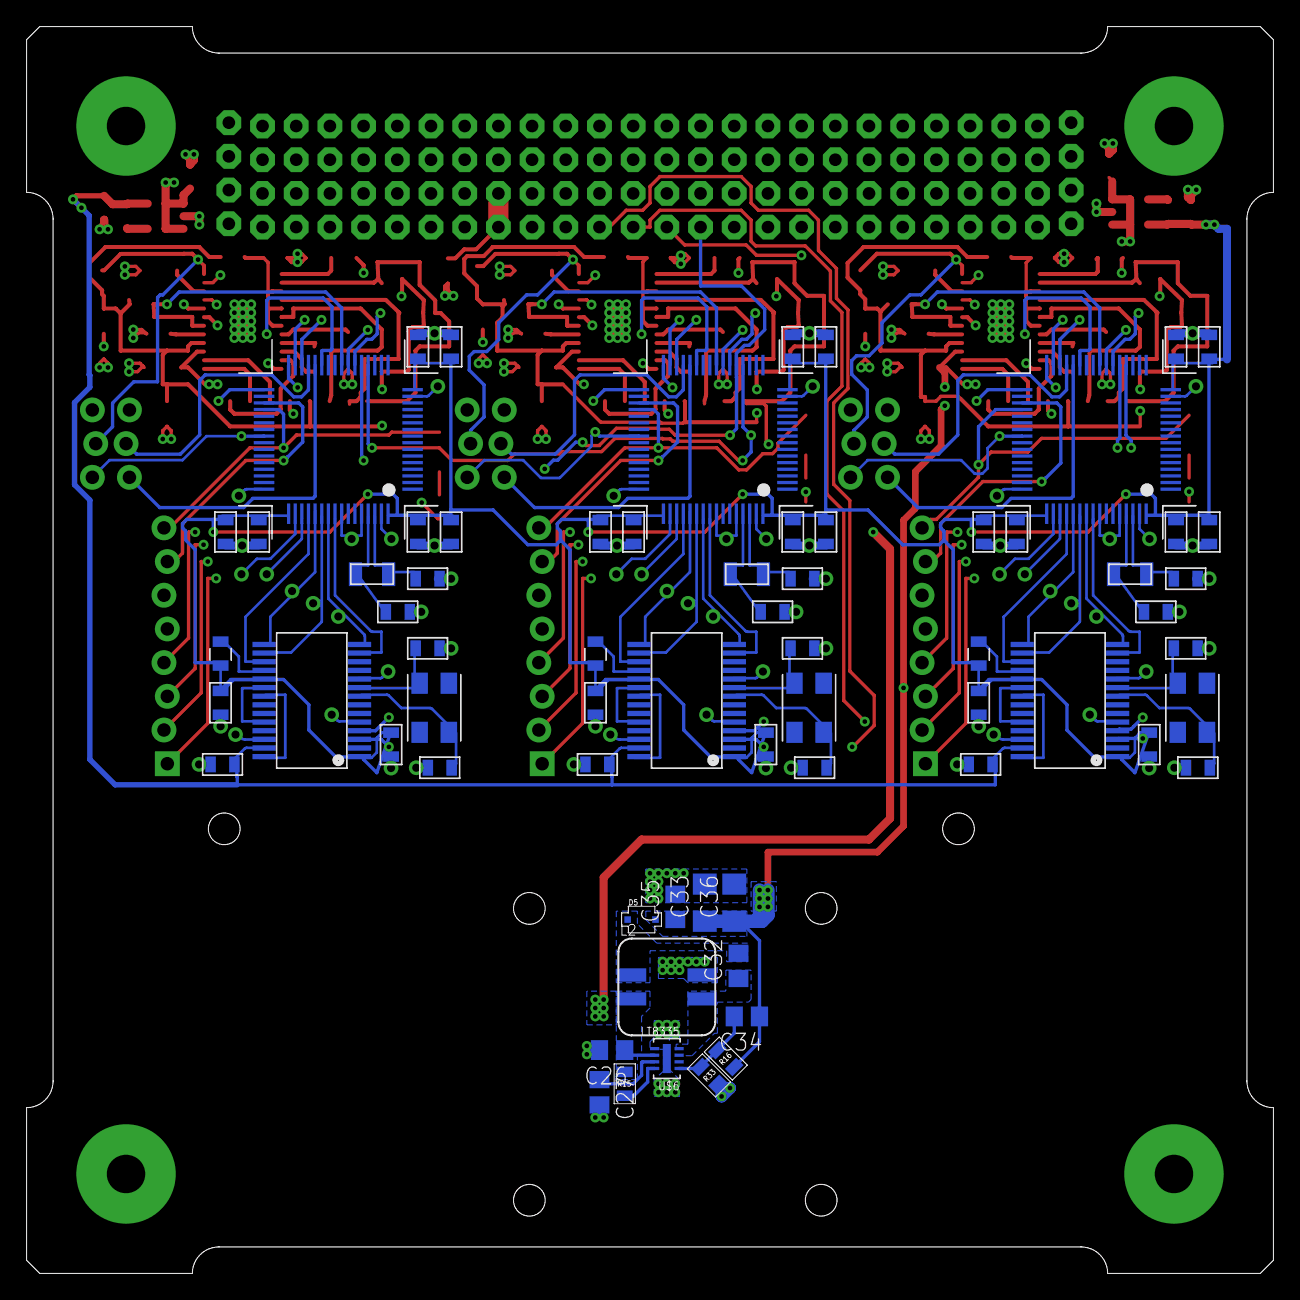
[picture p110: board reaction_wheel_board_2017_12_11.brd from below]

Board: 4 copper layers, 94.0 x 94.0 mm, 94 parts (16 on the bottom side), 103 nets.
