UWCubeSat/DubSat1/teams/adcs/hardware/engineering_model/photodiode/photodiode_front_2017_12_11.brd

## EAGLE design teams/adcs/hardware/engineering_model/photodiode/photodiode_front_2017_12_11.brd (2017-11-04)

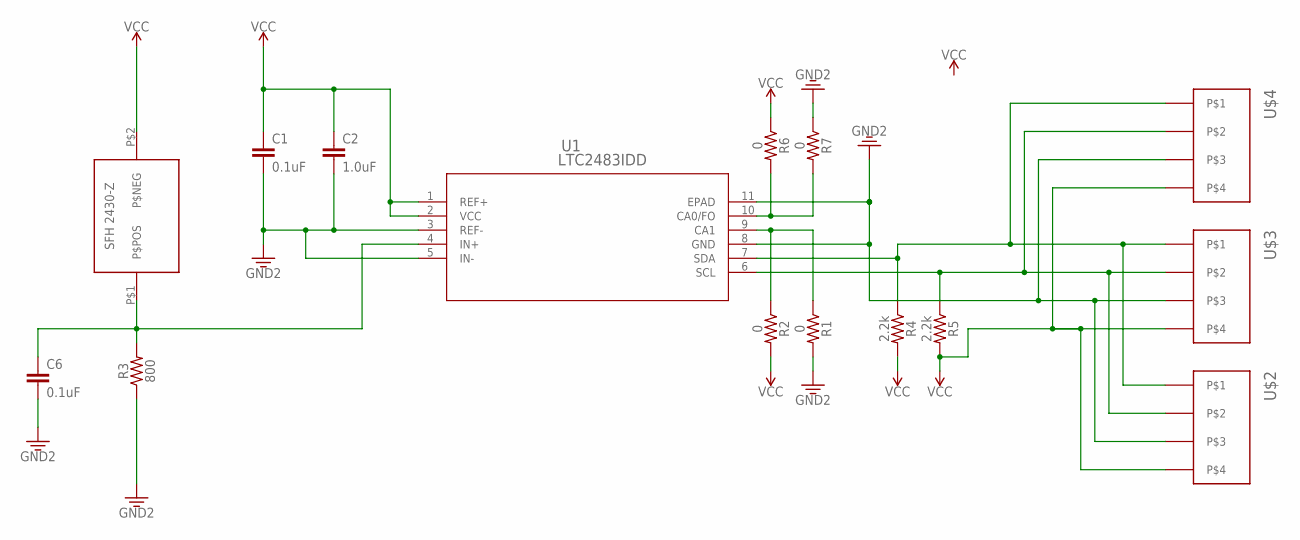
[picture p111: schematic photodiode_front_2017_12_11.sch]

Parts:
C1, C6: 0.1uF; 0805
C2: 1.0uF; 0805
R1, R2, R6, R7: 0; 0805
R3: 800; 0805
R4, R5: 2.2k; 0805
U1: LTC2483IDD; DFN-10_DD
U$1: SFH-2430-Z; DIL
U$2, U$3, U$4: PICOLOCK_4PICOLOCK_4; PICOLOCK_4

Connections:
CA0: R6.2, R7.2, U1.10 (CA0/FO)
CA1: R1.1, R2.1, U1.9 (CA1)
GND: C1.2, C2.2, C6.2, R1.2, R3.1, R7.1, U1.3 (REF-), U1.5 (IN-), U1.8 (GND), U1.11 (EPAD), U$2.P$3, U$3.P$3, U$4.P$3
OUTPUT: C6.1, R3.2, U1.4 (IN+), U$1.P$1 (P$POS)
SCL: R5.1, U1.6 (SCL), U$2.P$2, U$3.P$2, U$4.P$2
SDA: R4.1, U1.7 (SDA), U$2.P$1, U$3.P$1, U$4.P$1
VCC: C1.1, C2.1, R2.2, R4.2, R5.2, R6.1, U1.1 (REF+), U1.2 (VCC), U$1.P$2 (P$NEG), U$2.P$4, U$3.P$4, U$4.P$4

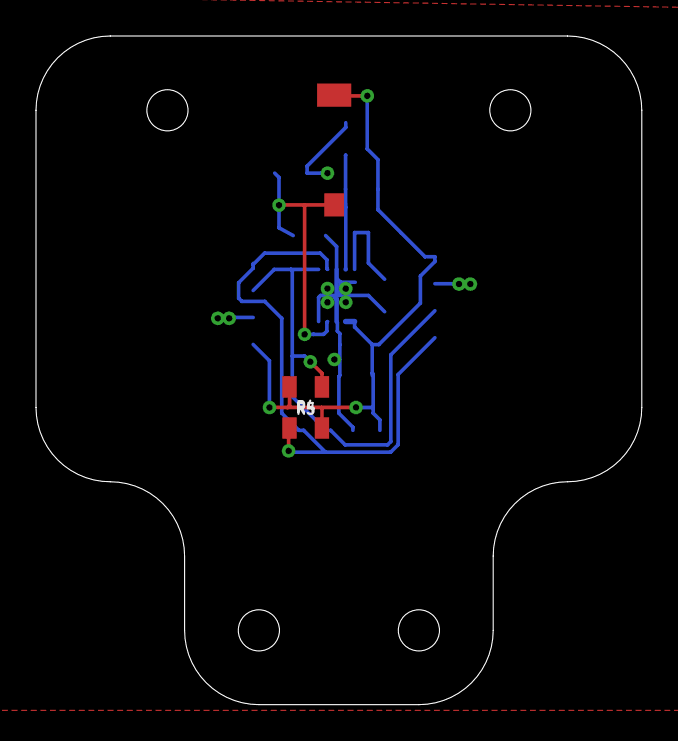
[picture p112: board photodiode_front_2017_12_11.brd from above]

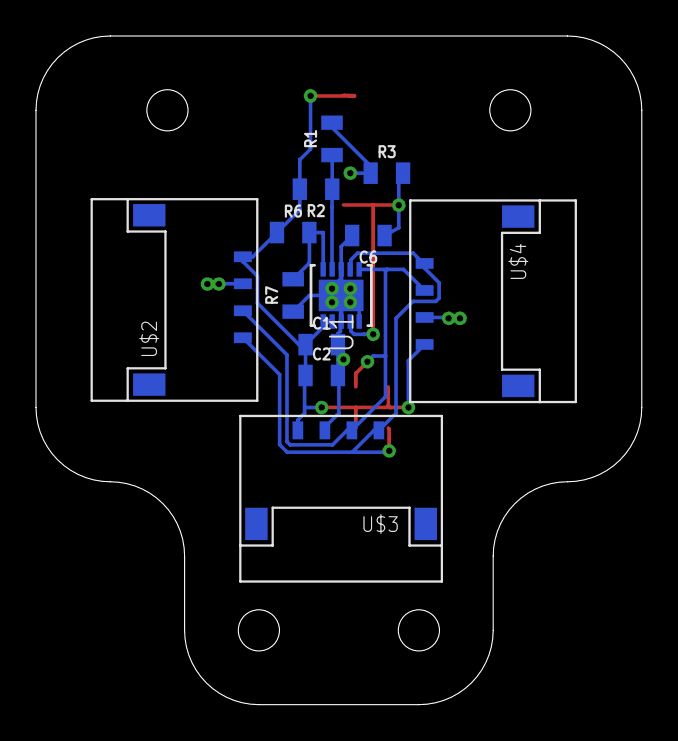
[picture p113: board photodiode_front_2017_12_11.brd from below]

Board: 2 copper layers, 33.7 x 37.1 mm, 15 parts (12 on the bottom side), 7 nets.
