UWCubeSat/DubSat1/teams/power/Battery Board/Battery Board V6/Battery Board V6.brd

## EAGLE design teams/power/Battery Board/Battery Board V6/Battery Board V6.brd (2018-01-11, an earlier design)

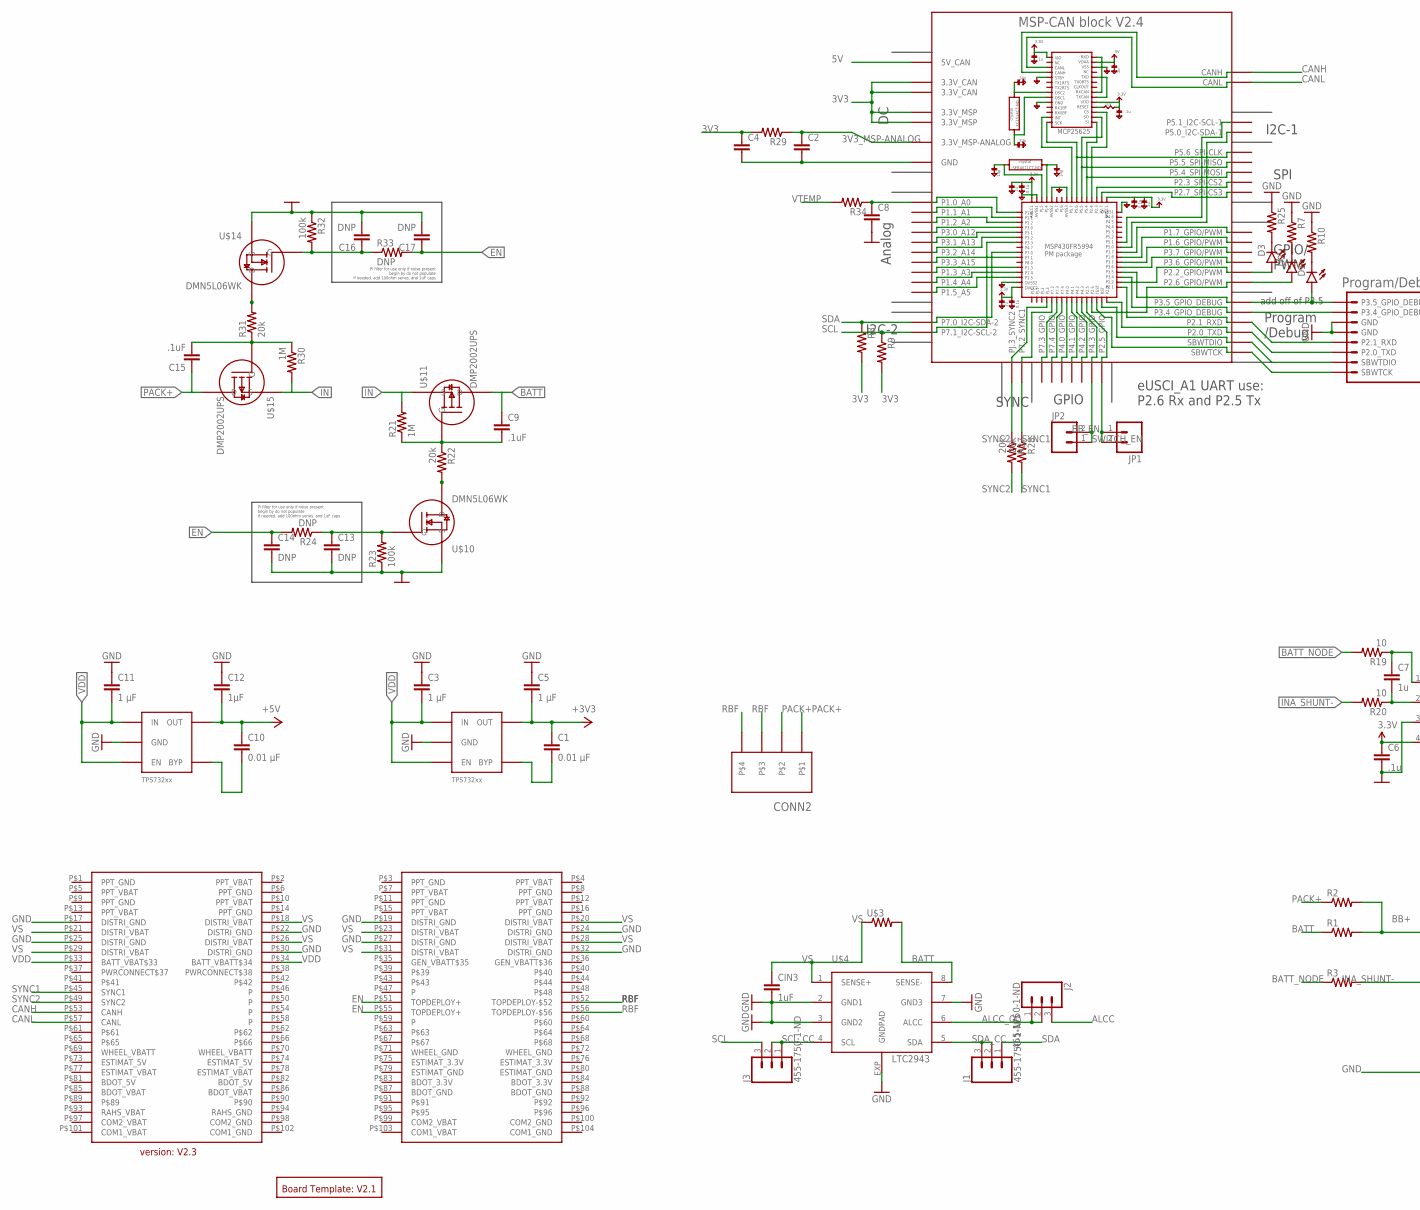
[picture p114: schematic Battery Board V6.sch, part in row 1, column 1]

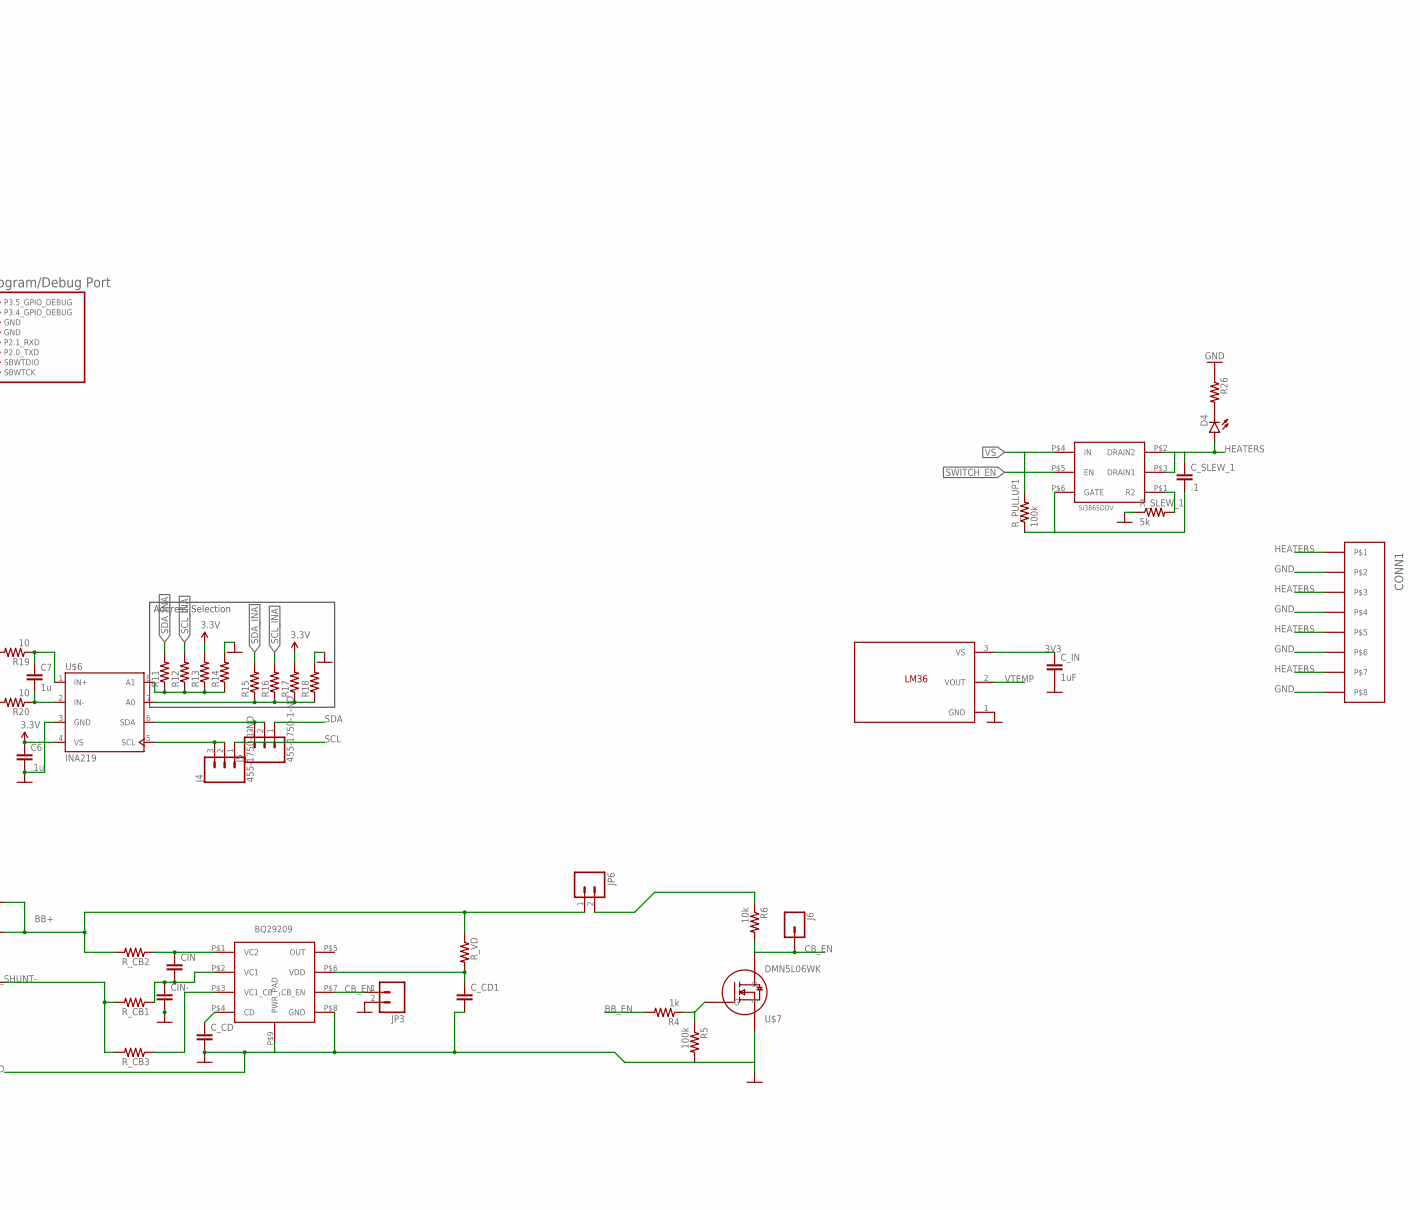
[picture p115: schematic Battery Board V6.sch, part in row 1, column 2]

Parts:
BLK1: MSP-CAN_BLOCK
C1, C10: 0.01 μF; 0805
C2, C4, C8: CAPACITOR0805; 0805
C3, C5, C11: 1 μF; 0805
C6: .1u; 0805
C7: 1u; 0805
C9, C15: .1uF; 0805
C12: 1μF; 0805
C13, C14, C16, C17: DNP; 0805
CIN: CAPACITOR0805; 0805
CIN3: 1uF; C0805
CIN-: CAPACITOR0805; 0805
CONN1: PICOLOCK_8
CONN2: PICOLOCK_4
C_CD, C_CD1: CAPACITOR0805; 0805
C_IN: 1uF; 0805
C_SLEW_1: .1; 0805
D1, D2, D3, D4: LED; LED-1206
J1, J2, J3, J4, J5: 455-1750-1-ND; 1X03
J6: CONN_01; 1X01
JP1, JP2, JP3, JP6: M02LOCK; 1X02_LOCK
R1, R2, R7, R8, R9, R10, R11, R12, R13, R14, R15, R16, R17, R18, R25, R26, R29, R34: RESISTOR0805; 0805
R3: RESISTOR2010; R2010
R4: 1k; 0805
R5, R23, R32: 100k; 0805
R6: 10k; 0805
R19, R20: 10; 0805
R21, R30: 1M; 0805
R22, R27, R28, R31: 20k; 0805
R24, R33: DNP; 0805
R_CB1, R_CB2, R_CB3: RESISTOR0805; 0805
R_PULLUP1: 100k; 0805
R_SLEW_1: 5k; 0805
R_VD: RESISTOR0805; 0805
U1, U4: TPS732XX; SOT-23-5
U$1: BOARD_TEMPLATE1; BOARD_TEMPLATE
U$2: PC104_CONNECTOR
U$3: RESISTOR2512; R2512
U$4: LTC2943; DFN8(3X3)LT
U$5: BQ29209; VSON8
U$6: INA219; SOT-23-8
U$7, U$10, U$14: DMN5L06WK; SOT-323
U$8: LM36; TO-92-3
U$11, U$15: DMP2002UPS; POWERDI5060-8
U$12: PROGRAM/DEBUG_PORT; 1X08_CONNECTOR
U$16: SI3865DDV; TSOP-6

Connections:
3V3: BLK1.3.3V@CAN1 (3.3V_CAN), BLK1.3.3V@CAN2 (3.3V_CAN), BLK1.3.3V@MSP1 (3.3V_MSP), BLK1.3.3V@MSP2 (3.3V_MSP), C1.1, C4.1, C5.2, C6.1, C_IN.1, R8.2, R9.2, R13.2, R17.2, R29.2, U1.P$5 (OUT), U$6.4 (VS), U$8.3 (VS)
3V3_MSP-ANALOG: BLK1.3.3V_ANALOG@MSP2 (3.3V_MSP-ANALOG), C2.1, R29.1
5V: BLK1.5V (5V_CAN), C10.1, C12.2, U4.P$5 (OUT)
ALCC: J2.3
ALCC_CC: J2.1, J2.2, U$4.6 (ALCC)
BATT: C9.1, R1.1, U$3.2, U$4.8 (SENSE-), U$11.D1 (D), U$11.D2 (D), U$11.D3 (D), U$11.D4 (D), U$11.D5 (D)
BATT_NODE: R3.1, R19.2
BB+: JP6.1, R1.2, R2.2, R_CB2.2, R_VD.1
BB_EN: BLK1.P4.3_GPIO, JP2.1, JP2.2, R4.2
CANH: BLK1.CANH, U$2.P$53 (CANH)
CANL: BLK1.CANL, U$2.P$57 (CANL)
CB_EN: J6.1, JP3.1, R6.2, U$5.P$7 (CB_EN), U$7.3 (D)
EN: C14.1, C17.1, R24.2, R33.2, U$2.P$51 (TOPDEPLOY+), U$2.P$55 (TOPDEPLOY+)
GND: BLK1.GND@1 (GND), BLK1.GND@2 (GND), BLK1.GND@3 (GND), BLK1.GND@4 (GND), BLK1.GND@5 (GND), BLK1.GND@7 (GND), BLK1.GND@8 (GND), BLK1.GND@9 (GND), BLK1.GND@10 (GND), BLK1.GND@11 (GND), BLK1.GND@12 (GND), BLK1.GND@13 (GND), BLK1.GND@14 (GND), BLK1.GND@15 (GND), BLK1.GND@16 (GND), BLK1.GND@17 (GND), BLK1.GND@26 (GND), C2.2, C3.1, C4.2, C5.1, C6.2, C8.2, C11.1, C12.1, C13.2, C14.2, C16.2, C17.2, CIN3.2, CIN-.2, CONN1.P$2, CONN1.P$4, CONN1.P$6, CONN1.P$8, C_CD.2, C_CD1.2, C_IN.2, JP3.2, R5.2, R7.1, R10.1, R14.2, R18.2, R23.1, R25.1, R26.1, R32.1, R_SLEW_1.1, U1.P$2 (GND), U4.P$2 (GND), U$2.P$17 (DISTRI_GND), U$2.P$19 (DISTRI_GND), U$2.P$22 (DISTRI_GND), U$2.P$24 (DISTRI_GND), U$2.P$25 (DISTRI_GND), U$2.P$27 (DISTRI_GND), U$2.P$30 (DISTRI_GND), U$2.P$32 (DISTRI_GND), U$4.2 (GND1), U$4.3 (GND2), U$4.7 (GND3), U$4.EXP (GNDPAD), U$5.P$8 (GND), U$5.P$9 (PWR_PAD), U$6.3 (GND), U$7.2 (S), U$8.1 (GND), U$10.2 (S), U$12.5 (GND), U$12.6 (GND), U$14.2 (S)
HEATERS: CONN1.P$1, CONN1.P$3, CONN1.P$5, CONN1.P$7, C_SLEW_1.1, D4.A, U$16.P$2 (DRAIN2), U$16.P$3 (DRAIN1)
IN: R21.2, R30.2, U$11.S1 (S), U$11.S2 (S), U$11.S3 (S), U$15.S1 (S), U$15.S2 (S), U$15.S3 (S)
INA219_A0_1: R15.1, R16.1, R17.1, R18.1, U$6.7 (A0)
INA219_A1_1: R11.1, R12.1, R13.1, R14.1, U$6.8 (A1)
INA219_IN+_1: C7.1, R19.1, U$6.1 (IN+)
INA219_IN-_1: C7.2, R20.1, U$6.2 (IN-)
INA_SHUNT-: R3.2, R20.2, R_CB1.2, R_CB3.2
LDO_3V3_BYP1: C1.2, U1.P$4 (BYP)
LDO_5V_BYP1: C10.2, U4.P$4 (BYP)
unnamed: BLK1.P3.5_GPIO_DEBUG, D1.A, U$12.8 (P3.5_GPIO_DEBUG)
unnamed: JP6.2, R6.1
unnamed: BLK1.P3.4_GPIO_DEBUG, U$12.7 (P3.4_GPIO_DEBUG)
unnamed: BLK1.P2.1_RXD, U$12.4 (P2.1_RXD)
unnamed: CIN.1, R_CB2.1, U$5.P$1 (VC2)
unnamed: CIN.2, CIN-.1, R_CB1.1, U$5.P$2 (VC1)
unnamed: C9.2, R21.1, R22.1, U$11.G
unnamed: C13.1, R23.2, R24.1, U$10.1 (G)
unnamed: R_CB3.1, U$5.P$3 (VC1_CB)
unnamed: C_CD.1, U$5.P$4 (CD)
unnamed: R22.2, U$10.3 (D)
unnamed: R4.1, R5.1, U$7.1 (G)
unnamed: C_CD1.1, R_VD.2, U$5.P$6 (VDD)
unnamed: C15.2, R30.1, R31.1, U$15.G
unnamed: C16.1, R32.2, R33.1, U$14.1 (G)
unnamed: R31.2, U$14.3 (D)
unnamed: BLK1.P2.0_TXD, U$12.3 (P2.0_TXD)
unnamed: BLK1.SBWTDIO, U$12.2 (SBWTDIO)
unnamed: BLK1.SBWTCK, U$12.SBWTCK
unnamed: D1.C, R10.2
unnamed: BLK1.P1.0_A0, C8.1, R34.1
unnamed: D2.C, R7.2
unnamed: D3.C, R25.2
unnamed: R_SLEW_1.2, U$16.P$1 (R2)
unnamed: C_SLEW_1.2, R_PULLUP1.1, U$16.P$6 (GATE)
unnamed: BLK1.P2.2_GPIO/PWM, D3.A
unnamed: BLK1.P2.6_GPIO/PWM, D2.A
unnamed: D4.C, R26.2
PACK+: C15.1, CONN2.P$1, CONN2.P$2, R2.1, U$15.D1 (D), U$15.D2 (D), U$15.D3 (D), U$15.D4 (D), U$15.D5 (D)
RBF: CONN2.P$3, CONN2.P$4, U$2.P$52 (TOPDEPLOY-$52), U$2.P$56 (TOPDEPLOY-$56)
SCL: BLK1.P7.1_I2C-SCL-2, J3.3, J4.1, R9.1
SCL_CC: J3.1, J3.2, U$4.4 (SCL)
SCL_INA: J4.2, J4.3, R12.2, R16.2, U$6.5 (SCL)
SDA: BLK1.P7.0_I2C-SDA-2, J1.1, J5.1, R8.1
SDA_CC: J1.2, J1.3, U$4.5 (SDA)
SDA_INA: J5.2, J5.3, R11.2, R15.2, U$6.6 (SDA)
SWITCH_EN: BLK1.P2.5_GPIO, JP1.1, JP1.2, U$16.P$5 (EN)
SYNC1: BLK1.P7.2_SYNC1, R28.1, R28.2, U$2.P$45 (SYNC1)
SYNC2: BLK1.PJ.3_SYNC2, R27.1, R27.2, U$2.P$49 (SYNC2)
VDD: C3.2, C11.2, U1.P$1 (IN), U1.P$3 (EN), U4.P$1 (IN), U4.P$3 (EN), U$2.P$33 (BATT_VBAT$33), U$2.P$34 (BATT_VBATT$34)
VS: CIN3.1, R_PULLUP1.2, U$2.P$18 (DISTRI_VBAT), U$2.P$20 (DISTRI_VBAT), U$2.P$21 (DISTRI_VBAT), U$2.P$23 (DISTRI_VBAT), U$2.P$26 (DISTRI_VBAT), U$2.P$28 (DISTRI_VBAT), U$2.P$29 (DISTRI_VBAT), U$2.P$31 (DISTRI_VBAT), U$3.1, U$4.1 (SENSE+), U$16.P$4 (IN)
VTEMP: R34.2, U$8.2 (VOUT)

Notes on the sheet:
Address Selection
Pi filter for use only if noise present begin by do not populate if needed, add 100ohm series, and 1uF caps

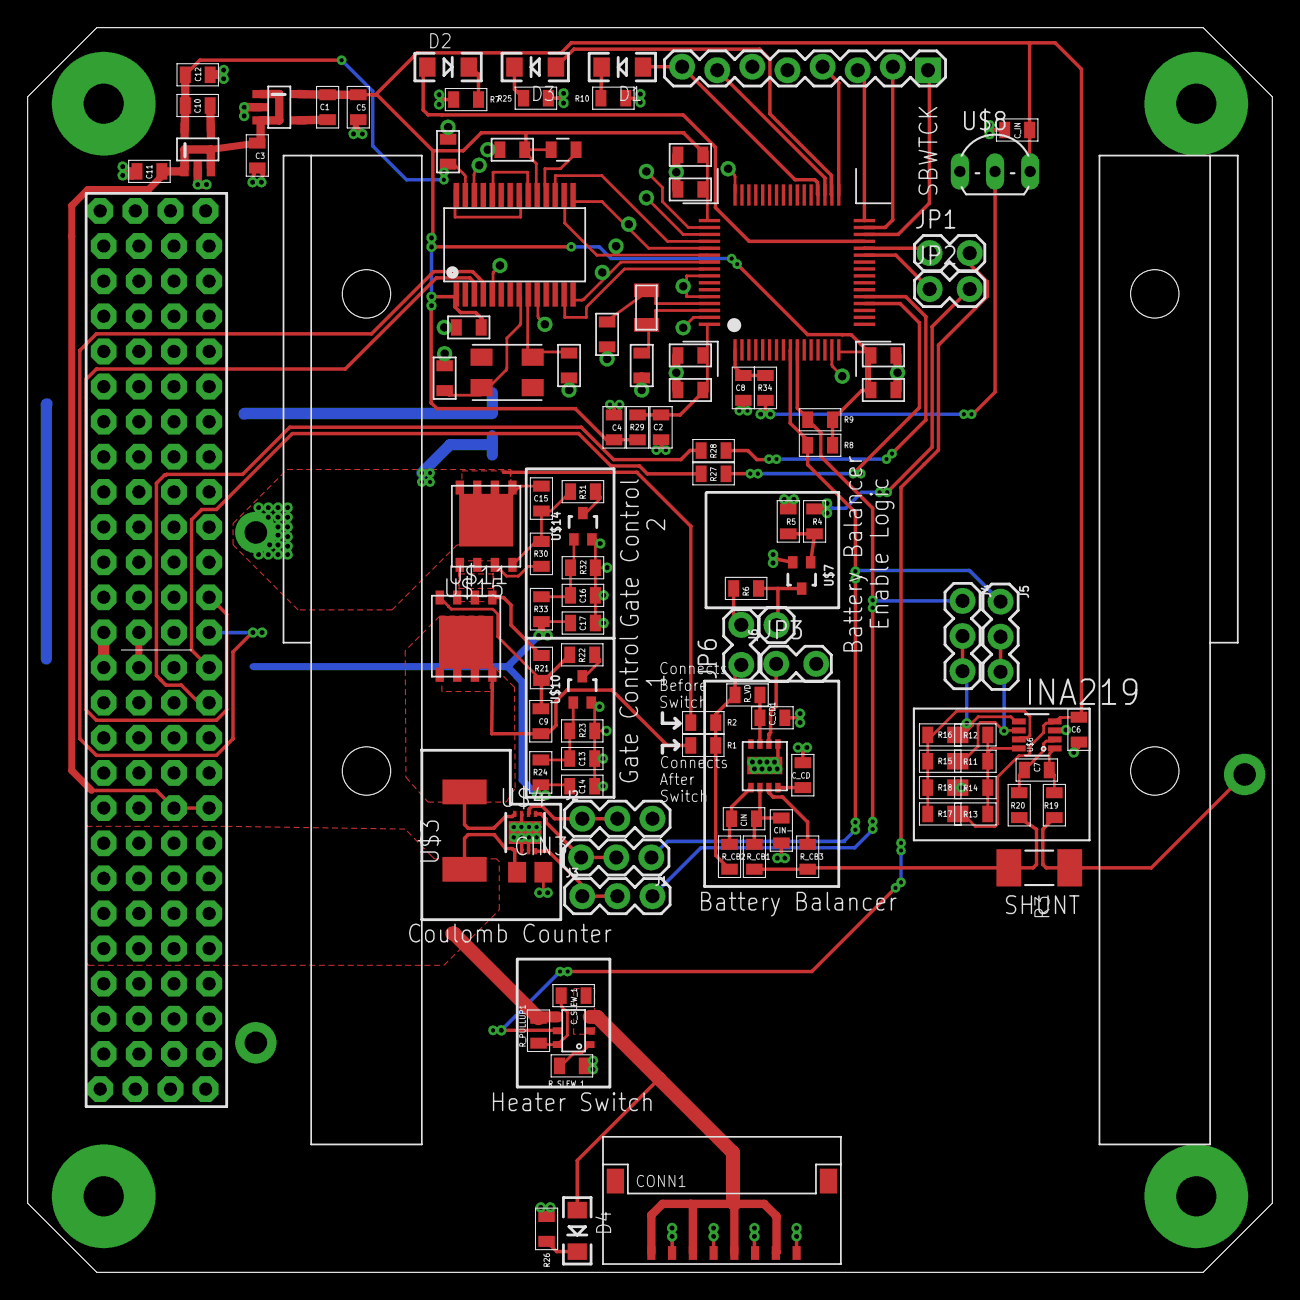
[picture p116: board Battery Board V6.brd from above]

Board: 2 copper layers, 90.0 x 90.0 mm, 98 parts (1 on the bottom side), 64 nets.

Other parts of the board:
U$9: BATTERY_HOLDERS
