UWCubeSat/DubSat1/teams/power/Battery Board/Battery Board V4/Battery board V4.4.brd

## EAGLE design teams/power/Battery Board/Battery Board V4/Battery board V4.4.brd (2018-01-11, an earlier design)

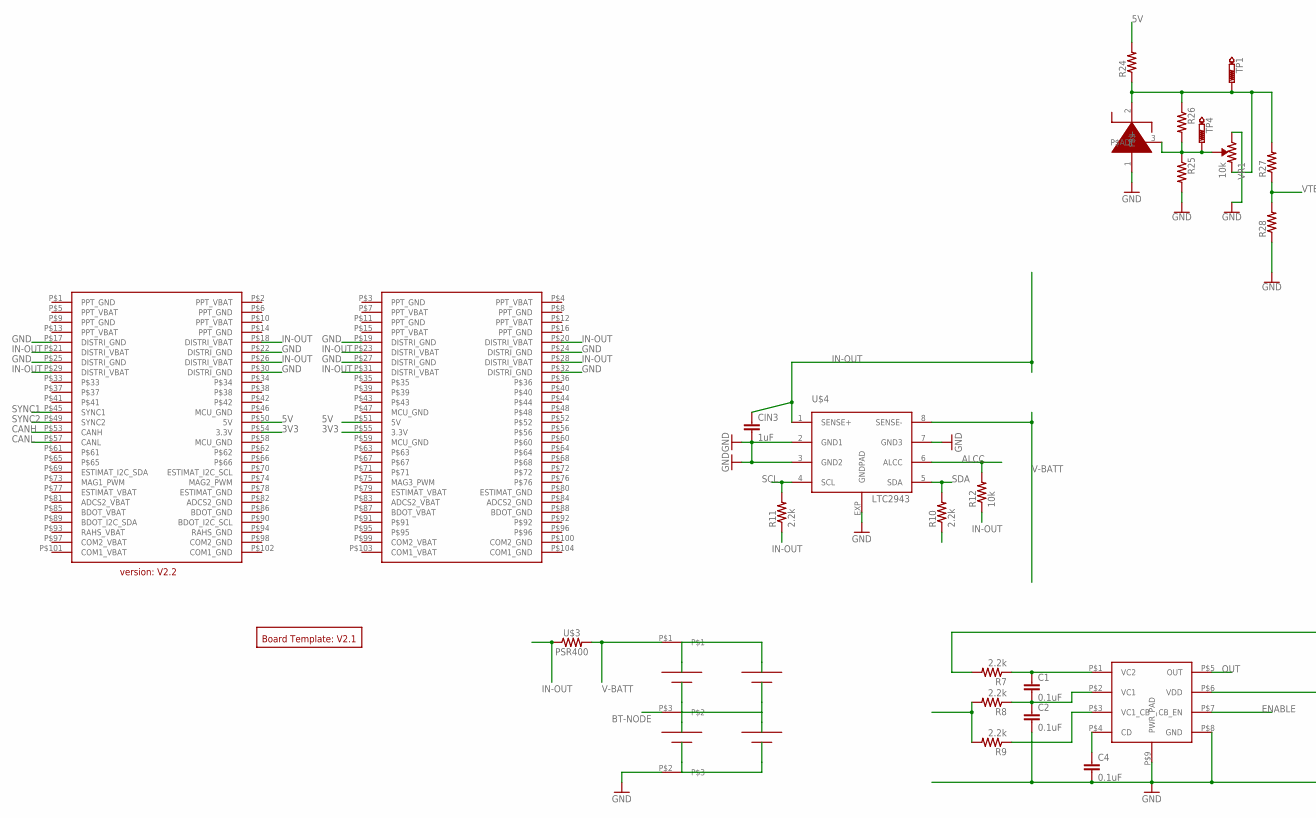
[picture p117: schematic Battery board V4.4.sch, part in row 1, column 1]

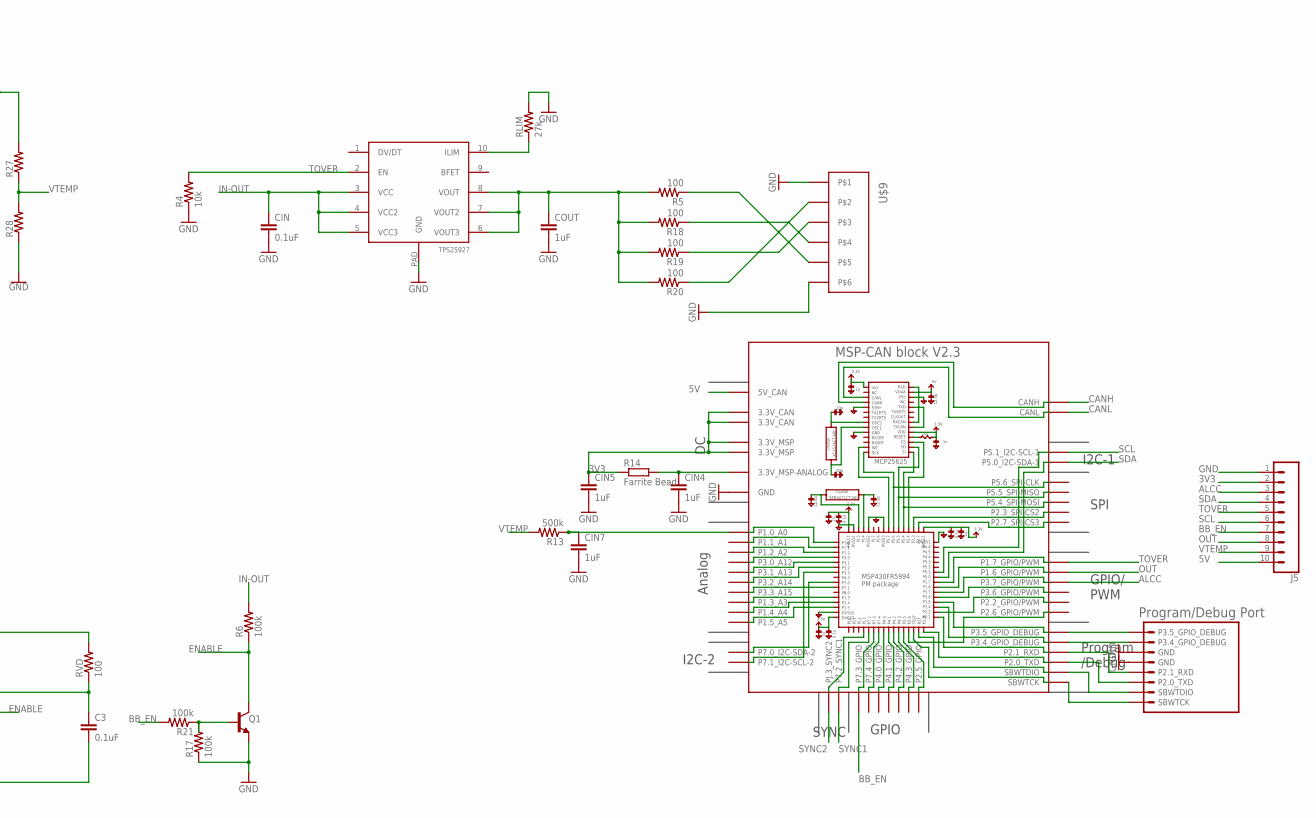
[picture p118: schematic Battery board V4.4.sch, part in row 1, column 2]

Parts:
C1, C2, C3, C4: 0.1uF; C0805
CIN: 0.1uF; C0805
CIN3, CIN4, CIN5, CIN7: 1uF; C0805
COUT: 1uF; C0805
J5: CONN_10LOCK; 1X10_LOCK
Q1: TRANS_NPN-MMBT2222AL; SOT23-3
R4, R12: 10k; R0805
R5, R18, R19, R20: 100; R0805
R6: 100k; R0805
R7, R8, R9, R10, R11: 2.2k; R0805
R13: 500k; R0805
R14: Farrite Bead; R1206
R17, R21: 100k; M0805
R24, R25, R26, R27, R28: R-US_R0805; R0805
RLIM: 27k; R0805
RVD: 100; R0805
TP1, TP4: PTR1PAD1-13Y; P1-13Y
U$1: MSP-CAN_BLOCK
U$2: PROGRAM/DEBUG_PORT; 1X08_CONNECTOR
U$3: PSR400
U$4: LTC2943; DFN8(3X3)LT
U$5: TPS252927; VSON10
U$6: POWER_PACK; BATTERY_PACK
U$7: PC104_CONNECTOR
U$8: BQ29209; VSON8
U$9: PICOLOCK_6
U$10: LM135Z; TO-92-3
U$11: BOARD_TEMPLATE
VR1: 10k; TRIMPOT-SMD-TC33X

Connections:
3V3: CIN5.1, J5.2, R14.1, U$1.3.3V@CAN1 (3.3V_CAN), U$1.3.3V@CAN2 (3.3V_CAN), U$1.3.3V@MSP1 (3.3V_MSP), U$1.3.3V@MSP2 (3.3V_MSP), U$7.P$54 (3.3V), U$7.P$55 (3.3V)
5V: J5.10, R24.2, U$1.5V (5V_CAN), U$7.P$50 (5V), U$7.P$51 (5V)
ALCC: J5.3, R12.2, U$1.P3.7_GPIO/PWM, U$4.6 (ALCC)
BASE: Q1.1 (B), R17.2, R21.1
BB_EN: J5.7, R21.2, U$1.P7.3_GPIO
BT-NODE: R8.2, R9.2, U$6.P$3
CANH: U$1.CANH, U$7.P$53 (CANH)
CANL: U$1.CANL, U$7.P$57 (CANL)
ENABLE: Q1.3 (C), R6.1, U$8.P$7 (CB_EN)
FERRITE-BEAD: CIN4.1, R14.2, U$1.3.3V_ANALOG@MSP2 (3.3V_MSP-ANALOG)
GND: C2.2, C3.2, C4.2, CIN.2, CIN3.2, CIN4.2, CIN5.2, CIN7.2, COUT.2, J5.1, Q1.2 (E), R4.1, R17.1, R25.2, R28.1, RLIM.2, U$1.GND@1 (GND), U$1.GND@2 (GND), U$1.GND@3 (GND), U$1.GND@4 (GND), U$1.GND@5 (GND), U$1.GND@7 (GND), U$1.GND@8 (GND), U$1.GND@9 (GND), U$1.GND@10 (GND), U$1.GND@11 (GND), U$1.GND@12 (GND), U$1.GND@13 (GND), U$1.GND@14 (GND), U$1.GND@15 (GND), U$1.GND@16 (GND), U$1.GND@17 (GND), U$1.GND@26 (GND), U$2.5 (GND), U$2.6 (GND), U$4.2 (GND1), U$4.3 (GND2), U$4.7 (GND3), U$4.EXP (GNDPAD), U$5.PAD (GND), U$6.P$2, U$7.P$17 (DISTRI_GND), U$7.P$19 (DISTRI_GND), U$7.P$22 (DISTRI_GND), U$7.P$24 (DISTRI_GND), U$7.P$25 (DISTRI_GND), U$7.P$27 (DISTRI_GND), U$7.P$30 (DISTRI_GND), U$7.P$32 (DISTRI_GND), U$8.P$8 (GND), U$8.P$9 (PWR_PAD), U$9.P$1, U$9.P$6, U$10.1 (P$-), VR1.1 (CW)
IN-OUT: CIN.1, CIN3.1, R6.2, R7.2, R10.1, R11.1, R12.1, RVD.2, U$3.P$1 (1), U$4.1 (SENSE+), U$5.3 (VCC), U$5.4 (VCC2), U$5.5 (VCC3), U$7.P$18 (DISTRI_VBAT), U$7.P$20 (DISTRI_VBAT), U$7.P$21 (DISTRI_VBAT), U$7.P$23 (DISTRI_VBAT), U$7.P$26 (DISTRI_VBAT), U$7.P$28 (DISTRI_VBAT), U$7.P$29 (DISTRI_VBAT), U$7.P$31 (DISTRI_VBAT)
unnamed: R20.1, U$9.P$2
unnamed: C1.1, R7.1, U$8.P$1 (VC2)
unnamed: C1.2, C2.1, R8.1, U$8.P$2 (VC1)
unnamed: C3.1, RVD.1, U$8.P$6 (VDD)
unnamed: C4.1, U$8.P$4 (CD)
unnamed: COUT.1, R5.2, R18.2, R19.2, R20.2, U$5.6 (VOUT3), U$5.7 (VOUT2), U$5.8 (VOUT)
unnamed: RLIM.1, U$5.10 (ILIM)
unnamed: R19.1, U$9.P$3
unnamed: R18.1, U$9.P$4
unnamed: U$1.P3.5_GPIO_DEBUG, U$2.8 (P3.5_GPIO_DEBUG)
unnamed: U$1.P3.4_GPIO_DEBUG, U$2.7 (P3.4_GPIO_DEBUG)
unnamed: R5.1, U$9.P$5
unnamed: U$1.P2.1_RXD, U$2.4 (P2.1_RXD)
unnamed: U$1.P2.0_TXD, U$2.3 (P2.0_TXD)
unnamed: U$1.SBWTDIO, U$2.2 (SBWTDIO)
unnamed: U$1.SBWTCK, U$2.SBWTCK
unnamed: R24.1, R26.1, R27.2, TP1.TP, U$10.2 (P$+), VR1.3 (CCW)
unnamed: R25.1, R26.2, TP4.TP, U$10.3 (P$ADJ), VR1.2 (WIPER)
unnamed: R9.1, U$8.P$3 (VC1_CB)
OUT: J5.8, U$1.P1.6_GPIO/PWM, U$8.P$5 (OUT)
SCL: J5.6, R11.2, U$1.P5.1_I2C-SCL-1, U$4.4 (SCL)
SDA: J5.4, R10.2, U$1.P5.0_I2C-SDA-1, U$4.5 (SDA)
SYNC1: U$1.P7.2_SYNC1, U$7.P$45 (SYNC1)
SYNC2: U$1.PJ.3_SYNC2, U$7.P$49 (SYNC2)
TOVER: J5.5, R4.2, U$1.P1.7_GPIO/PWM, U$5.2 (EN)
V-BATT: U$3.P$2 (2), U$4.8 (SENSE-), U$6.P$1
VTEMP: J5.9, R13.2, R27.1, R28.2
VTEMP_FILTERED: CIN7.1, R13.1, U$1.P1.0_A0

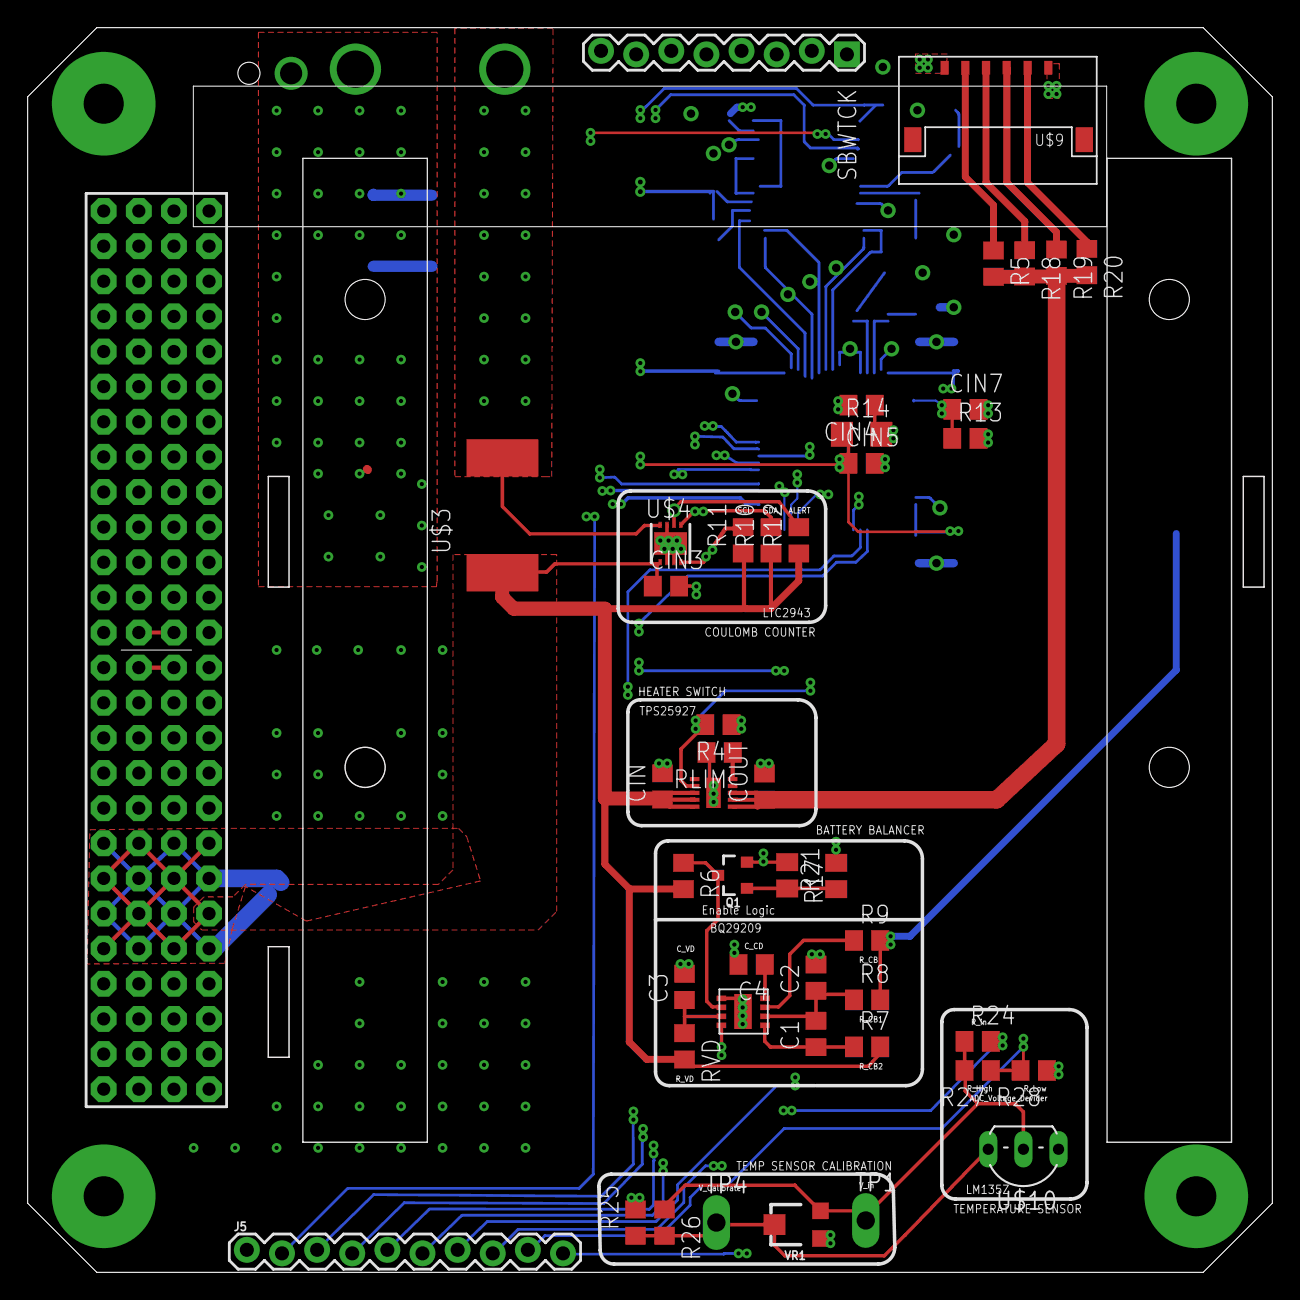
[picture p119: board Battery board V4.4.brd from above]

Board: 4 copper layers, 90.0 x 90.0 mm, 49 parts (1 on the bottom side), 40 nets.
