UWCubeSat/DubSat1/teams/general/MotherBoard/motherboard_v1.brd

## EAGLE design teams/general/MotherBoard/motherboard_v1.brd (2018-01-11)

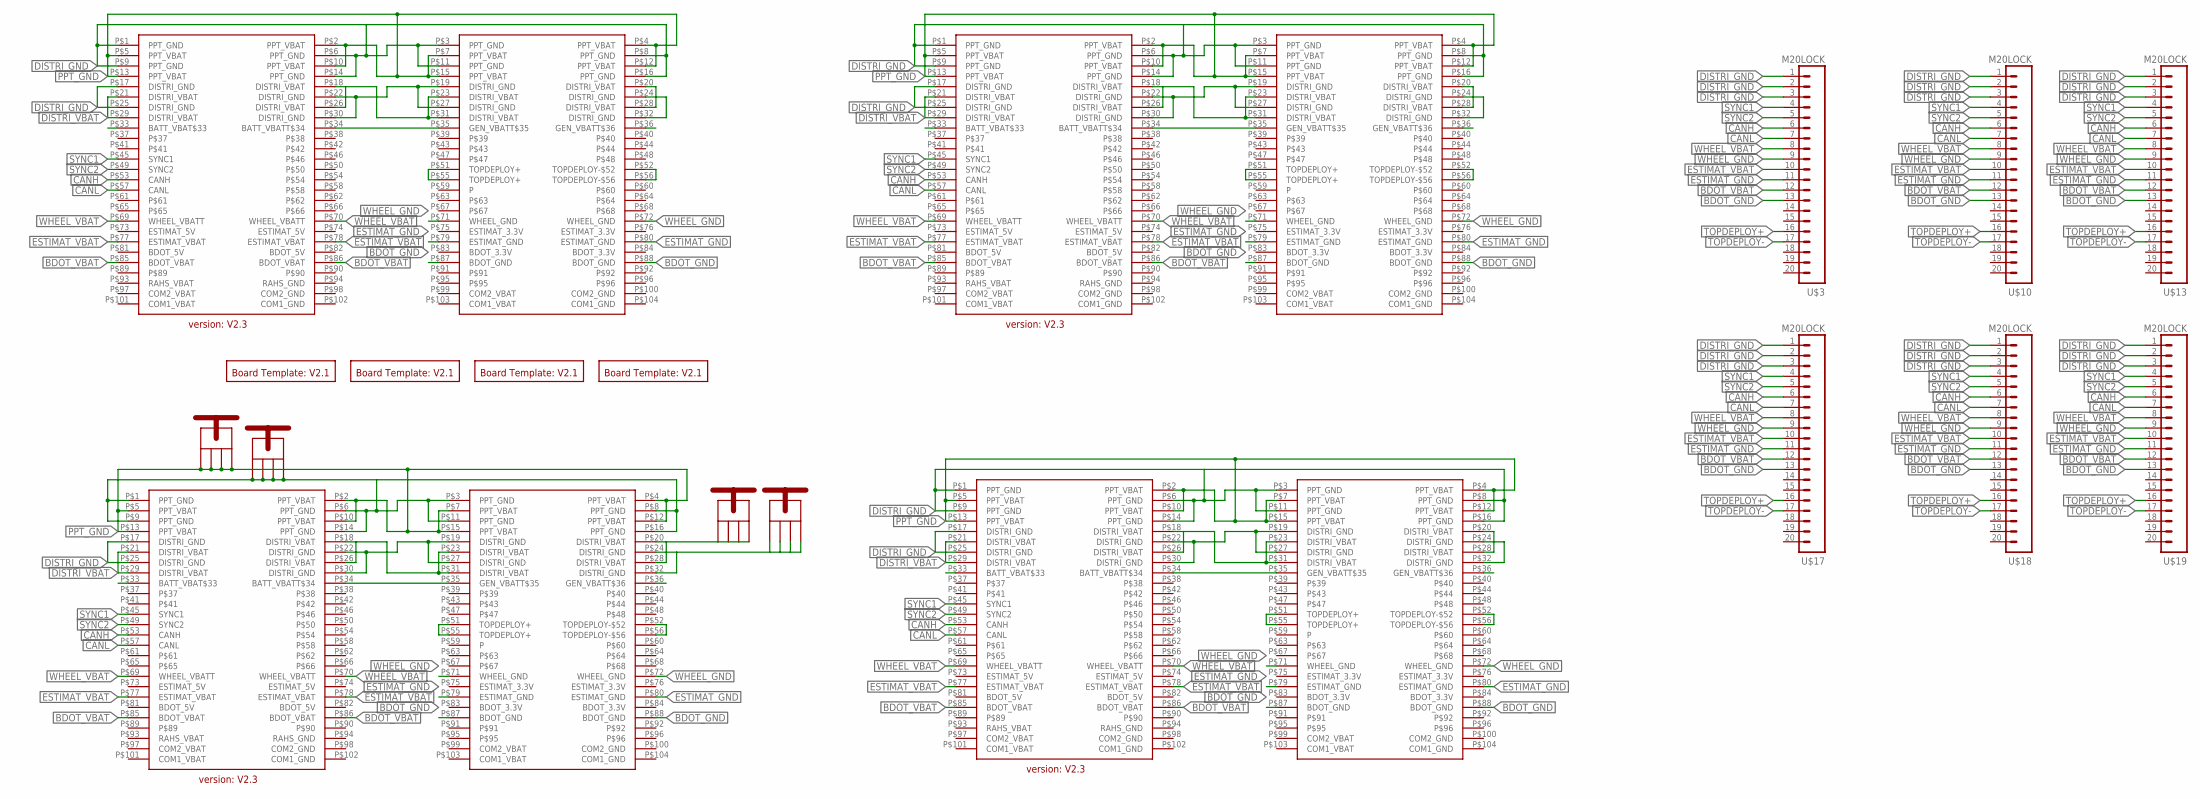
[picture p120: schematic motherboard_v1.sch]

Parts:
JP1, JP2, JP9, JP10: KEYSTONE_SCREW_TERMINAL_7701; 7701
U$1, U$4, U$5, U$6: BOARD_TEMPLATESILKONLY; BOARD_TEMPLATE_SILKONLY
U$2, U$7, U$9, U$11: PC104_CONNECTOR
U$3, U$10, U$13, U$17, U$18, U$19: M20LOCK; 1X20_LOCK

Connections:
BDOT_GND: U$2.P$87 (BDOT_GND), U$2.P$88 (BDOT_GND), U$3.13, U$7.P$87 (BDOT_GND), U$7.P$88 (BDOT_GND), U$9.P$87 (BDOT_GND), U$9.P$88 (BDOT_GND), U$10.13, U$11.P$87 (BDOT_GND), U$11.P$88 (BDOT_GND), U$13.13, U$17.13, U$18.13, U$19.13
BDOT_VBAT: U$2.P$85 (BDOT_VBAT), U$2.P$86 (BDOT_VBAT), U$3.12, U$7.P$85 (BDOT_VBAT), U$7.P$86 (BDOT_VBAT), U$9.P$85 (BDOT_VBAT), U$9.P$86 (BDOT_VBAT), U$10.12, U$11.P$85 (BDOT_VBAT), U$11.P$86 (BDOT_VBAT), U$13.12, U$17.12, U$18.12, U$19.12
CANH: U$2.P$53 (CANH), U$3.6, U$7.P$53 (CANH), U$9.P$53 (CANH), U$10.6, U$11.P$53 (CANH), U$13.6, U$17.6, U$18.6, U$19.6
CANL: U$2.P$57 (CANL), U$3.7, U$7.P$57 (CANL), U$9.P$57 (CANL), U$10.7, U$11.P$57 (CANL), U$13.7, U$17.7, U$18.7, U$19.7
DISTRI_GND: JP2.P$1, JP2.P$2, JP2.P$3, JP2.P$4, JP10.P$1, JP10.P$2, JP10.P$3, JP10.P$4, U$2.P$1 (PPT_GND), U$2.P$3 (PPT_GND), U$2.P$6 (PPT_GND), U$2.P$8 (PPT_GND), U$2.P$9 (PPT_GND), U$2.P$11 (PPT_GND), U$2.P$14 (PPT_GND), U$2.P$16 (PPT_GND), U$2.P$17 (DISTRI_GND), U$2.P$19 (DISTRI_GND), U$2.P$22 (DISTRI_GND), U$2.P$24 (DISTRI_GND), U$2.P$25 (DISTRI_GND), U$2.P$27 (DISTRI_GND), U$2.P$30 (DISTRI_GND), U$2.P$32 (DISTRI_GND), U$3.1, U$3.2, U$3.3, U$7.P$1 (PPT_GND), U$7.P$3 (PPT_GND), U$7.P$6 (PPT_GND), U$7.P$8 (PPT_GND), U$7.P$9 (PPT_GND), U$7.P$11 (PPT_GND), U$7.P$14 (PPT_GND), U$7.P$16 (PPT_GND), U$7.P$17 (DISTRI_GND), U$7.P$19 (DISTRI_GND), U$7.P$22 (DISTRI_GND), U$7.P$24 (DISTRI_GND), U$7.P$25 (DISTRI_GND), U$7.P$27 (DISTRI_GND), U$7.P$30 (DISTRI_GND), U$7.P$32 (DISTRI_GND), U$9.P$1 (PPT_GND), U$9.P$3 (PPT_GND), U$9.P$6 (PPT_GND), U$9.P$8 (PPT_GND), U$9.P$9 (PPT_GND), U$9.P$11 (PPT_GND), U$9.P$14 (PPT_GND), U$9.P$16 (PPT_GND), U$9.P$17 (DISTRI_GND), U$9.P$19 (DISTRI_GND), U$9.P$22 (DISTRI_GND), U$9.P$24 (DISTRI_GND), U$9.P$25 (DISTRI_GND), U$9.P$27 (DISTRI_GND), U$9.P$30 (DISTRI_GND), U$9.P$32 (DISTRI_GND), U$10.1, U$10.2, U$10.3, U$11.P$1 (PPT_GND), U$11.P$3 (PPT_GND), U$11.P$6 (PPT_GND), U$11.P$8 (PPT_GND), U$11.P$9 (PPT_GND), U$11.P$11 (PPT_GND), U$11.P$14 (PPT_GND), U$11.P$16 (PPT_GND), U$11.P$17 (DISTRI_GND), U$11.P$19 (DISTRI_GND), U$11.P$22 (DISTRI_GND), U$11.P$24 (DISTRI_GND), U$11.P$25 (DISTRI_GND), U$11.P$27 (DISTRI_GND), U$11.P$30 (DISTRI_GND), U$11.P$32 (DISTRI_GND), U$13.1, U$13.2, U$13.3, U$17.1, U$17.2, U$17.3, U$18.1, U$18.2, U$18.3, U$19.1, U$19.2, U$19.3
DISTRI_VBAT: JP1.P$1, JP1.P$2, JP1.P$3, JP1.P$4, U$2.P$18 (DISTRI_VBAT), U$2.P$20 (DISTRI_VBAT), U$2.P$21 (DISTRI_VBAT), U$2.P$23 (DISTRI_VBAT), U$2.P$26 (DISTRI_VBAT), U$2.P$28 (DISTRI_VBAT), U$2.P$29 (DISTRI_VBAT), U$2.P$31 (DISTRI_VBAT), U$7.P$18 (DISTRI_VBAT), U$7.P$20 (DISTRI_VBAT), U$7.P$21 (DISTRI_VBAT), U$7.P$23 (DISTRI_VBAT), U$7.P$26 (DISTRI_VBAT), U$7.P$28 (DISTRI_VBAT), U$7.P$29 (DISTRI_VBAT), U$7.P$31 (DISTRI_VBAT), U$9.P$18 (DISTRI_VBAT), U$9.P$20 (DISTRI_VBAT), U$9.P$21 (DISTRI_VBAT), U$9.P$23 (DISTRI_VBAT), U$9.P$26 (DISTRI_VBAT), U$9.P$28 (DISTRI_VBAT), U$9.P$29 (DISTRI_VBAT), U$9.P$31 (DISTRI_VBAT), U$11.P$18 (DISTRI_VBAT), U$11.P$20 (DISTRI_VBAT), U$11.P$21 (DISTRI_VBAT), U$11.P$23 (DISTRI_VBAT), U$11.P$26 (DISTRI_VBAT), U$11.P$28 (DISTRI_VBAT), U$11.P$29 (DISTRI_VBAT), U$11.P$31 (DISTRI_VBAT)
EPS: U$2.P$33 (BATT_VBAT$33), U$2.P$34 (BATT_VBATT$34), U$2.P$35 (GEN_VBATT$35), U$2.P$36 (GEN_VBATT$36), U$7.P$33 (BATT_VBAT$33), U$7.P$34 (BATT_VBATT$34), U$7.P$35 (GEN_VBATT$35), U$7.P$36 (GEN_VBATT$36), U$9.P$33 (BATT_VBAT$33), U$9.P$34 (BATT_VBATT$34), U$9.P$35 (GEN_VBATT$35), U$9.P$36 (GEN_VBATT$36), U$11.P$33 (BATT_VBAT$33), U$11.P$34 (BATT_VBATT$34), U$11.P$35 (GEN_VBATT$35), U$11.P$36 (GEN_VBATT$36)
ESTIMAT_GND: U$2.P$79 (ESTIMAT_GND), U$2.P$80 (ESTIMAT_GND), U$3.11, U$7.P$79 (ESTIMAT_GND), U$7.P$80 (ESTIMAT_GND), U$9.P$79 (ESTIMAT_GND), U$9.P$80 (ESTIMAT_GND), U$10.11, U$11.P$79 (ESTIMAT_GND), U$11.P$80 (ESTIMAT_GND), U$13.11, U$17.11, U$18.11, U$19.11
ESTIMAT_VBAT: U$2.P$77 (ESTIMAT_VBAT), U$2.P$78 (ESTIMAT_VBAT), U$3.10, U$7.P$77 (ESTIMAT_VBAT), U$7.P$78 (ESTIMAT_VBAT), U$9.P$77 (ESTIMAT_VBAT), U$9.P$78 (ESTIMAT_VBAT), U$10.10, U$11.P$77 (ESTIMAT_VBAT), U$11.P$78 (ESTIMAT_VBAT), U$13.10, U$17.10, U$18.10, U$19.10
PPT_GND: JP9.P$1, JP9.P$2, JP9.P$3, JP9.P$4, U$2.P$2 (PPT_VBAT), U$2.P$4 (PPT_VBAT), U$2.P$5 (PPT_VBAT), U$2.P$7 (PPT_VBAT), U$2.P$10 (PPT_VBAT), U$2.P$12 (PPT_VBAT), U$2.P$13 (PPT_VBAT), U$2.P$15 (PPT_VBAT), U$7.P$2 (PPT_VBAT), U$7.P$4 (PPT_VBAT), U$7.P$5 (PPT_VBAT), U$7.P$7 (PPT_VBAT), U$7.P$10 (PPT_VBAT), U$7.P$12 (PPT_VBAT), U$7.P$13 (PPT_VBAT), U$7.P$15 (PPT_VBAT), U$9.P$2 (PPT_VBAT), U$9.P$4 (PPT_VBAT), U$9.P$5 (PPT_VBAT), U$9.P$7 (PPT_VBAT), U$9.P$10 (PPT_VBAT), U$9.P$12 (PPT_VBAT), U$9.P$13 (PPT_VBAT), U$9.P$15 (PPT_VBAT), U$11.P$2 (PPT_VBAT), U$11.P$4 (PPT_VBAT), U$11.P$5 (PPT_VBAT), U$11.P$7 (PPT_VBAT), U$11.P$10 (PPT_VBAT), U$11.P$12 (PPT_VBAT), U$11.P$13 (PPT_VBAT), U$11.P$15 (PPT_VBAT)
SYNC1: U$2.P$45 (SYNC1), U$3.4, U$7.P$45 (SYNC1), U$9.P$45 (SYNC1), U$10.4, U$11.P$45 (SYNC1), U$13.4, U$17.4, U$18.4, U$19.4
SYNC2: U$2.P$49 (SYNC2), U$3.5, U$7.P$49 (SYNC2), U$9.P$49 (SYNC2), U$10.5, U$11.P$49 (SYNC2), U$13.5, U$17.5, U$18.5, U$19.5
TOPDEPLOY+: U$2.P$51 (TOPDEPLOY+), U$2.P$55 (TOPDEPLOY+), U$3.16, U$7.P$51 (TOPDEPLOY+), U$7.P$55 (TOPDEPLOY+), U$9.P$51 (TOPDEPLOY+), U$9.P$55 (TOPDEPLOY+), U$10.16, U$11.P$51 (TOPDEPLOY+), U$11.P$55 (TOPDEPLOY+), U$13.16, U$17.16, U$18.16, U$19.16
TOPDEPLOY-: U$2.P$52 (TOPDEPLOY-$52), U$2.P$56 (TOPDEPLOY-$56), U$3.17, U$7.P$52 (TOPDEPLOY-$52), U$7.P$56 (TOPDEPLOY-$56), U$9.P$52 (TOPDEPLOY-$52), U$9.P$56 (TOPDEPLOY-$56), U$10.17, U$11.P$52 (TOPDEPLOY-$52), U$11.P$56 (TOPDEPLOY-$56), U$13.17, U$17.17, U$18.17, U$19.17
WHEEL_GND: U$2.P$71 (WHEEL_GND), U$2.P$72 (WHEEL_GND), U$3.9, U$7.P$71 (WHEEL_GND), U$7.P$72 (WHEEL_GND), U$9.P$71 (WHEEL_GND), U$9.P$72 (WHEEL_GND), U$10.9, U$11.P$71 (WHEEL_GND), U$11.P$72 (WHEEL_GND), U$13.9, U$17.9, U$18.9, U$19.9
WHEEL_VBAT: U$2.P$69 (WHEEL_VBATT), U$2.P$70 (WHEEL_VBATT), U$3.8, U$7.P$69 (WHEEL_VBATT), U$7.P$70 (WHEEL_VBATT), U$9.P$69 (WHEEL_VBATT), U$9.P$70 (WHEEL_VBATT), U$10.8, U$11.P$69 (WHEEL_VBATT), U$11.P$70 (WHEEL_VBATT), U$13.8, U$17.8, U$18.8, U$19.8
