UWCubeSat/DubSat1/teams/general/MotherBoard/motherboard_v1.brd

## EAGLE design teams/general/MotherBoard/motherboard_v1.brd (continued)

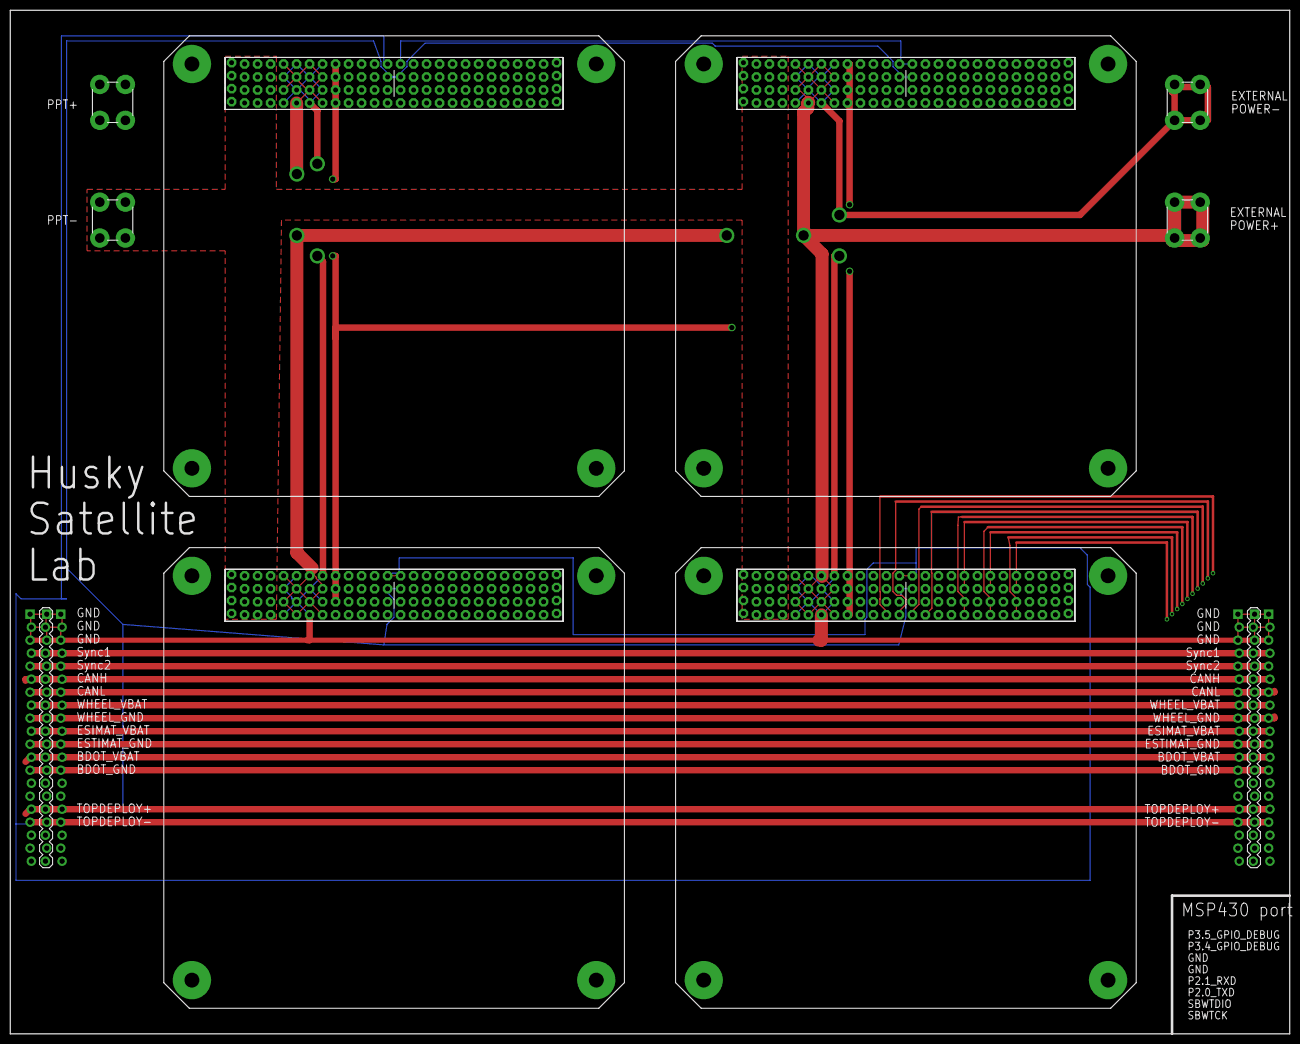
[picture p121: board motherboard_v1.brd from above]

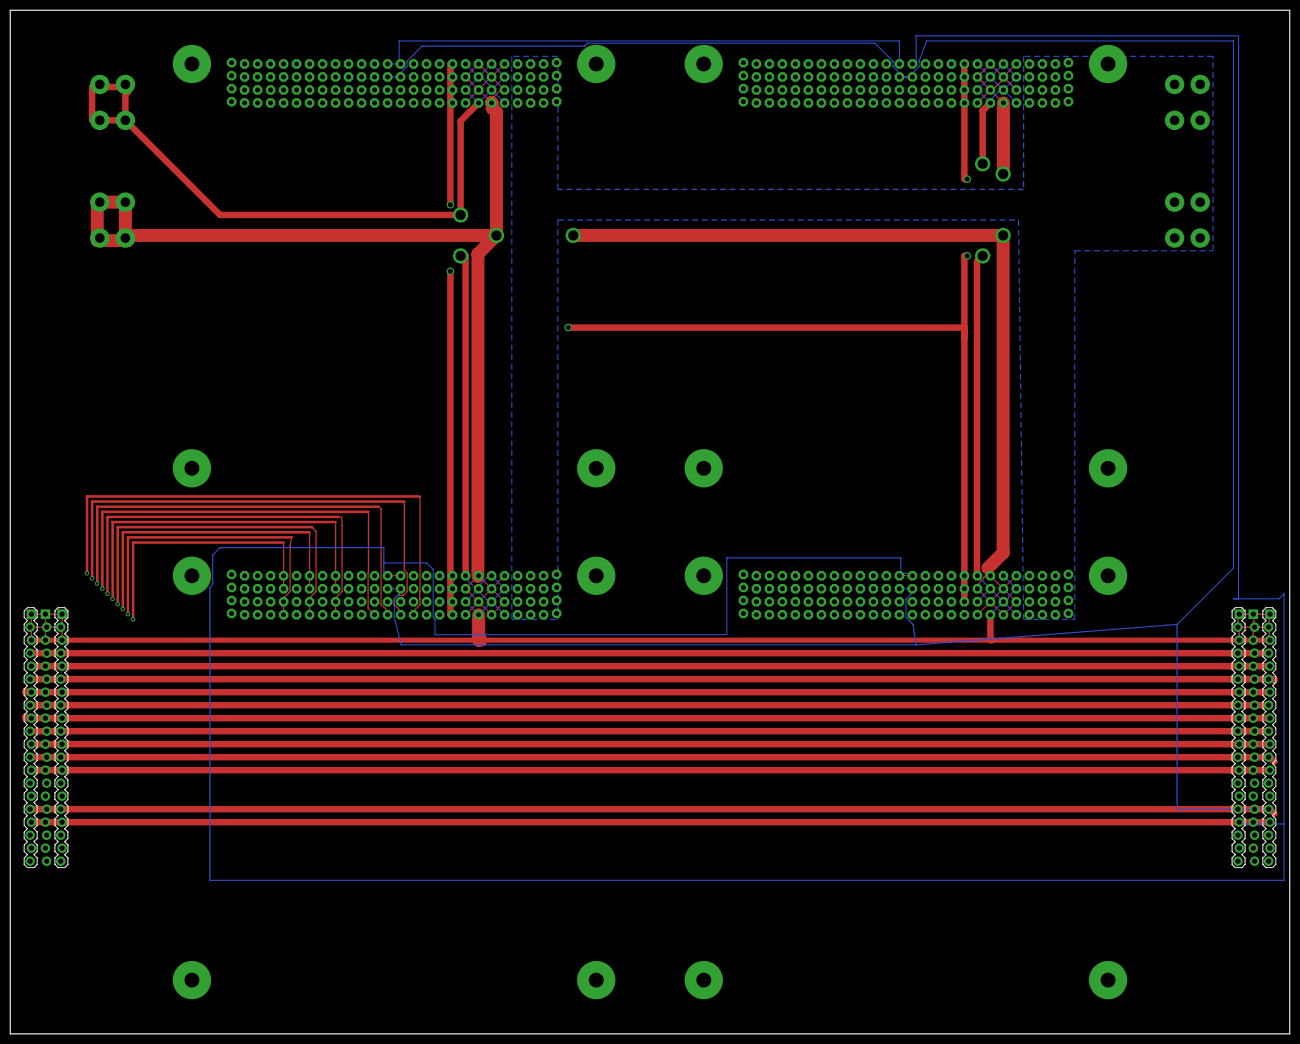
[picture p122: board motherboard_v1.brd from below]

Board: 4 copper layers, 250.0 x 200.0 mm, 18 parts (4 on the bottom side), 16 nets.
