UWCubeSat/DubSat1/teams/general/Intro Project Boards to Order/Temp Sensor 3 - Daniel/ADC.brd

## EAGLE design teams/general/Intro Project Boards to Order/Temp Sensor 3 - Daniel/ADC.brd (2018-01-11)

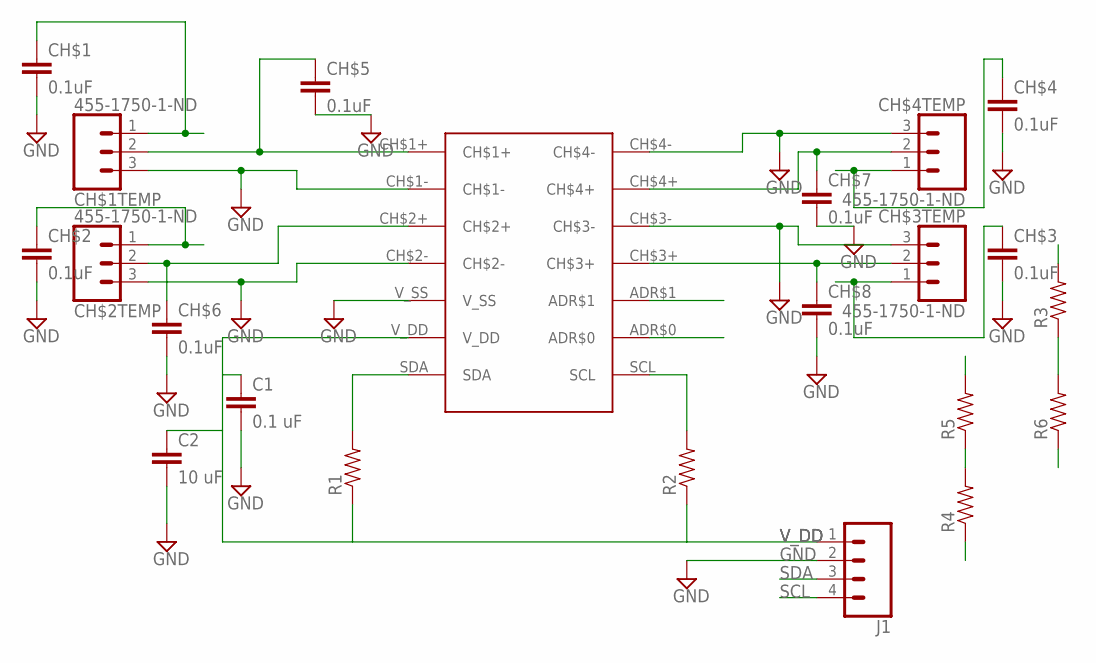
[picture p123: schematic ADC.sch]

Parts:
C1: 0.1 uF; 0805
C2: 10 uF; 0805
CH$1, CH$2, CH$3, CH$4, CH$5, CH$6, CH$7, CH$8: 0.1uF; 0805
CH$1TEMP, CH$2TEMP, CH$3TEMP, CH$4TEMP: 455-1750-1-ND; 1X03
J1: CONN_04; 1X04
R1, R2, R3, R4, R5, R6: RESISTOR0805; 0805
U$1: MCP3428-E/SL; MICROCHIP_MCP3428

Connections:
ADR0: R4.2, R5.1, U$1.ADR$0
ADR1: R3.1, R6.2, U$1.ADR$1
CH$2+: CH$2TEMP.2, CH$6.1, U$1.CH$2+
CH$3+: CH$3TEMP.2, CH$8.1, U$1.CH$3+
CH$4+: CH$4TEMP.2, CH$7.1, U$1.CH$4+
GND: C1.2, C2.2, CH$1.2, CH$1TEMP.3, CH$2.2, CH$2TEMP.3, CH$3.2, CH$3TEMP.3, CH$4.2, CH$4TEMP.3, CH$5.2, CH$6.2, CH$7.2, CH$8.2, J1.2, R4.1, R6.1, U$1.CH$1-, U$1.CH$2-, U$1.CH$3-, U$1.CH$4-, U$1.V_SS
unnamed: CH$1TEMP.2, CH$5.1, U$1.CH$1+
SCL: J1.4, R2.2, U$1.SCL
SDA: J1.3, R1.2, U$1.SDA
V_DD: C1.1, C2.1, CH$1.1, CH$1TEMP.1, CH$2.1, CH$2TEMP.1, CH$3.1, CH$3TEMP.1, CH$4.1, CH$4TEMP.1, J1.1, R1.1, R2.1, R3.2, R5.2, U$1.V_DD

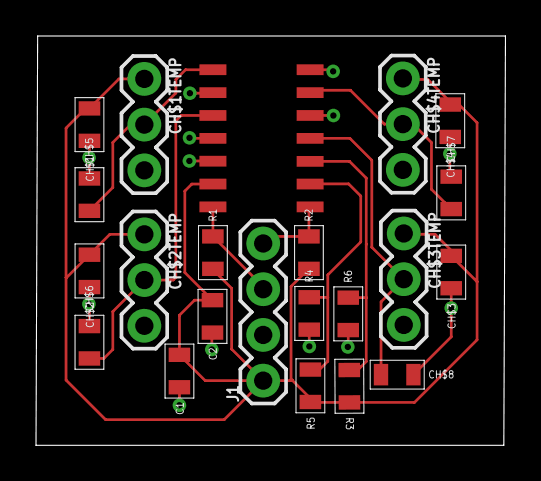
[picture p124: board ADC.brd from above]

Board: 2 copper layers, 26.1 x 22.7 mm, 22 parts (0 on the bottom side), 10 nets.
