UWCubeSat/DubSat1/teams/power/Deployment/Mosfet switch options breakout board.sch

## EAGLE design teams/power/Deployment/Mosfet switch options breakout board.sch (2017-10-12)

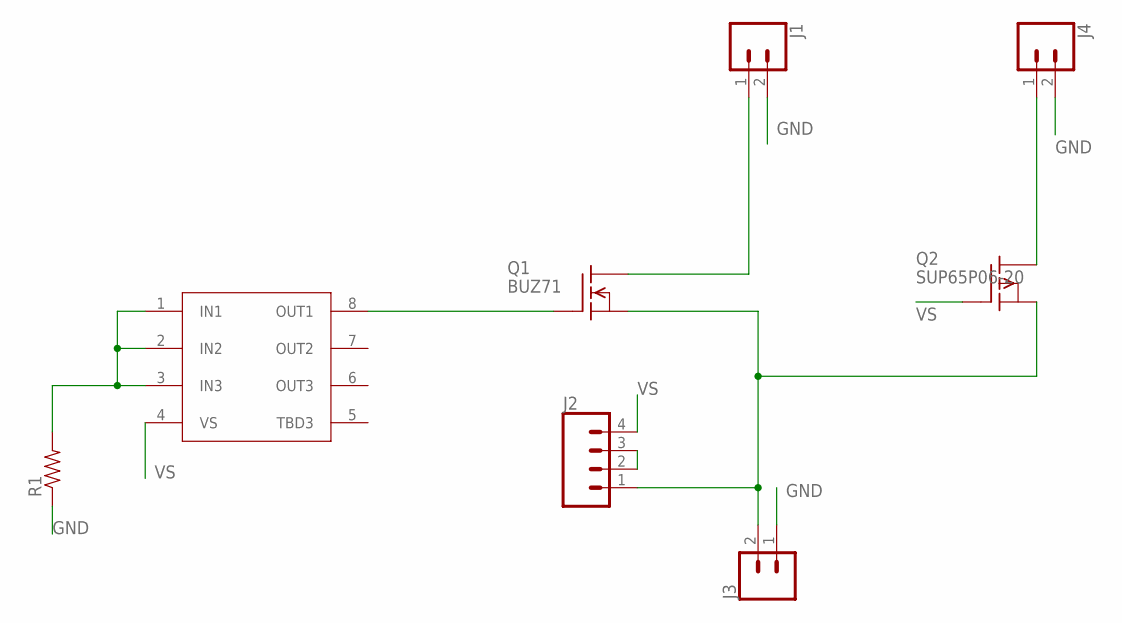
[picture p125: schematic Mosfet switch options breakout board.sch]

Parts:
J1, J3, J4: CONN_02; 1X02
J2: CONN_04; 1X04
Q1: BUZ71; TO220
Q2: SUP65P06-20; TO220
R1: RESISTOR0805; 0805
U$1: (TEMP)MOSFET_DRIVER; TSSOP-8

Connections:
GND: J1.2, J3.1, J4.2, R1.1
unnamed: Q1.1 (G), U$1.8 (OUT1)
unnamed: R1.2, U$1.1 (IN1), U$1.2 (IN2), U$1.3 (IN3)
unnamed: J4.1, Q2.2 (D)
unnamed: J1.1, Q1.2 (D)
unnamed: J2.2, J2.3
VBATT: J2.1, J3.2, Q1.3 (S), Q2.3 (S)
VS: J2.4, Q2.1 (G), U$1.4 (VS)
