UWCubeSat/DubSat1/teams/power/Other/INA219_design_block_buildin.sch

## EAGLE design teams/power/Other/INA219_design_block_buildin.sch (2017-11-25)

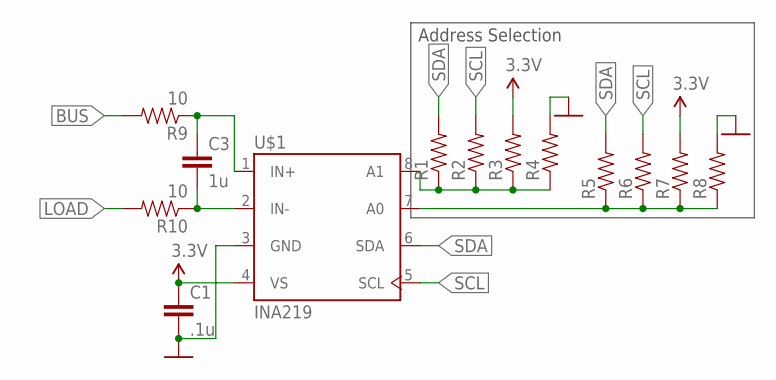
[picture p126: schematic INA219_design_block_buildin.sch]

Parts:
C1: .1u; 0805
C3: 1u; 0805
R1, R2, R3, R4, R5, R6, R7, R8: RESISTOR0805; 0805
R9, R10: 10; 0805
U$1: INA219; SOT-23-8

Connections:
3.3V: C1.1, R3.2, R7.2, U$1.4 (VS)
BUS: R9.2
GND: C1.2, R4.2, R8.2, U$1.3 (GND)
INA219_A0: R5.1, R6.1, R7.1, R8.1, U$1.7 (A0)
INA219_A1: R1.1, R2.1, R3.1, R4.1, U$1.8 (A1)
INA219_IN+: C3.1, R9.1, U$1.1 (IN+)
INA219_IN-: C3.2, R10.1, U$1.2 (IN-)
LOAD: R10.2
SCL: R2.2, R6.2, U$1.5 (SCL)
SDA: R1.2, R5.2, U$1.6 (SDA)

Notes on the sheet:
Address Selection
