UWCubeSat/DubSat1/teams/adcs/hardware/breakouts/LT8335_6V.sch

## EAGLE design teams/adcs/hardware/breakouts/LT8335_6V.sch (2017-11-11)

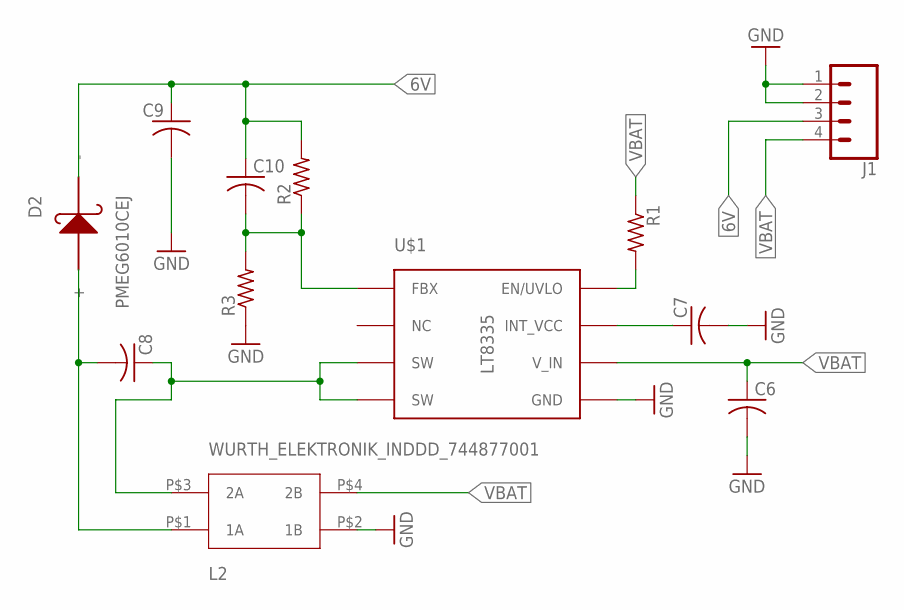
[picture p127: schematic LT8335_6V.sch]

Parts:
C6, C7, C8, C9, C10: C-USC0805; C0805
D2: PMEG6010CEJ; SC-90
J1: CONN_04LOCK; 1X04_LOCK
L2: WURTH_ELEKTRONIK_INDDD_744877001
R1, R2, R3: R-US_R0805; R0805
U$1: LT8335; DDB

Connections:
6V: C9.1, C10.1, D2.P$2 (-), J1.3, R2.2
EN_UVLO1: R1.2, U$1.P$8 (EN/UVLO)
FBX1: C10.2, R2.1, R3.2, U$1.P$1 (FBX)
GND: C6.2, C7.2, C9.2, J1.1, J1.2, L2.P$2 (1B), R3.1, U$1.GND
INT_VCC1: C7.1, U$1.P$7 (INT_VCC)
unnamed: C8.2, D2.P$1 (+), L2.P$1 (1A)
SW1: C8.1, L2.P$3 (2A), U$1.P$3 (SW), U$1.P$4 (SW)
VBAT: C6.1, J1.4, L2.P$4 (2B), R1.1, U$1.P$6 (V_IN)
