UWCubeSat/DubSat1/teams/power/Gen Board/Gen Board V3 (Justin's work)/PwrGenBrd_v3.sch

## EAGLE design teams/power/Gen Board/Gen Board V3 (Justin's work)/PwrGenBrd_v3.sch (2017-07-28)

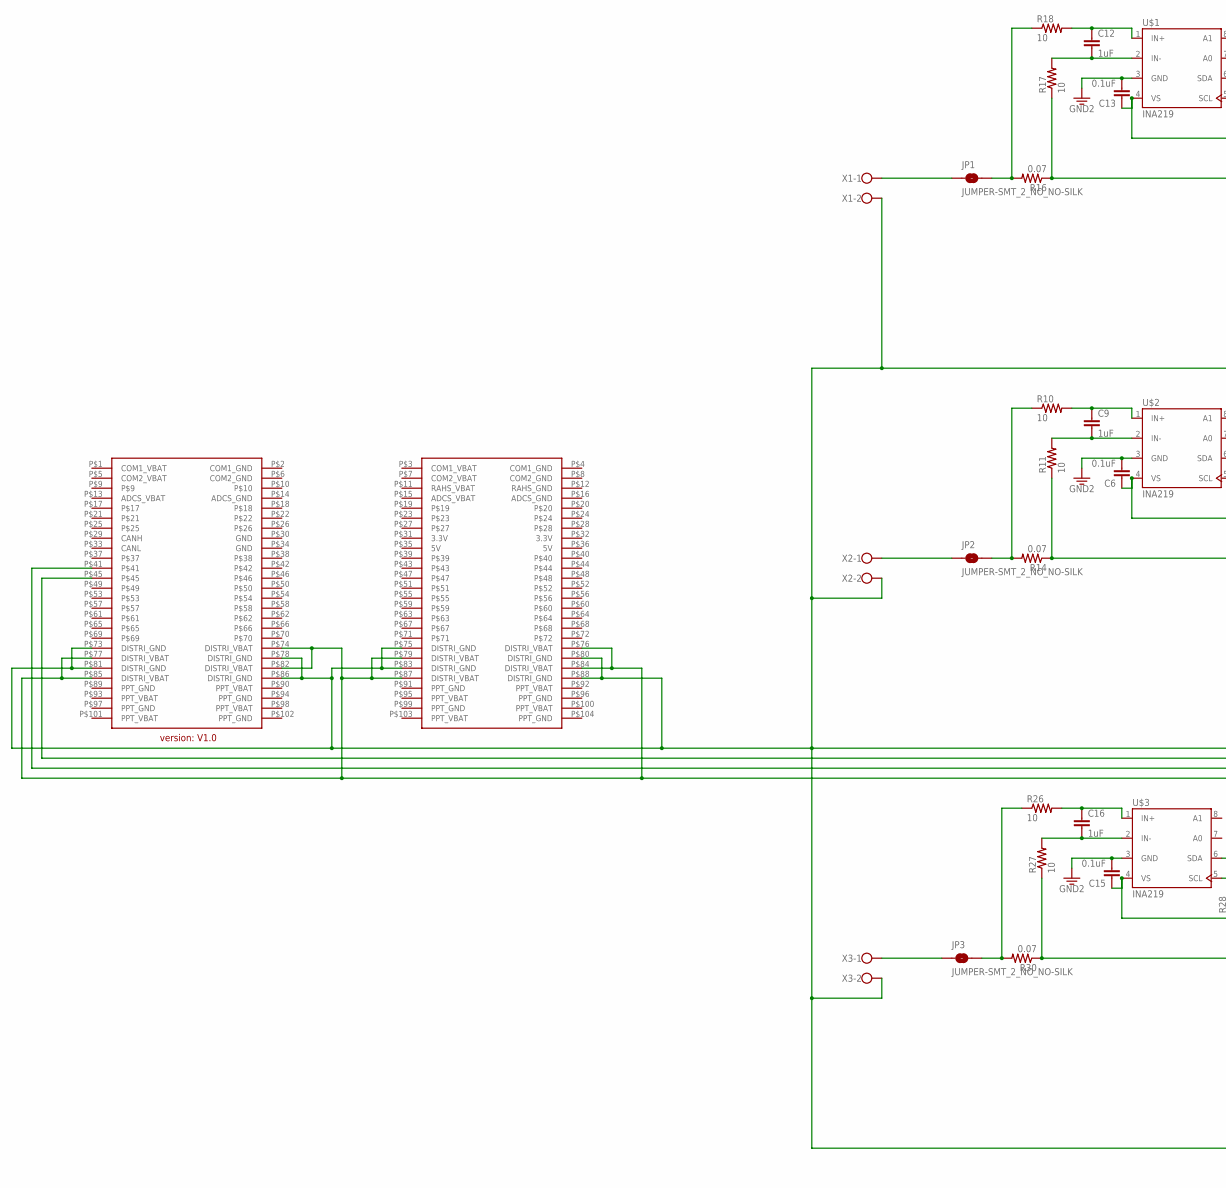
[picture p135: schematic PwrGenBrd_v3.sch, part in row 1, column 1]

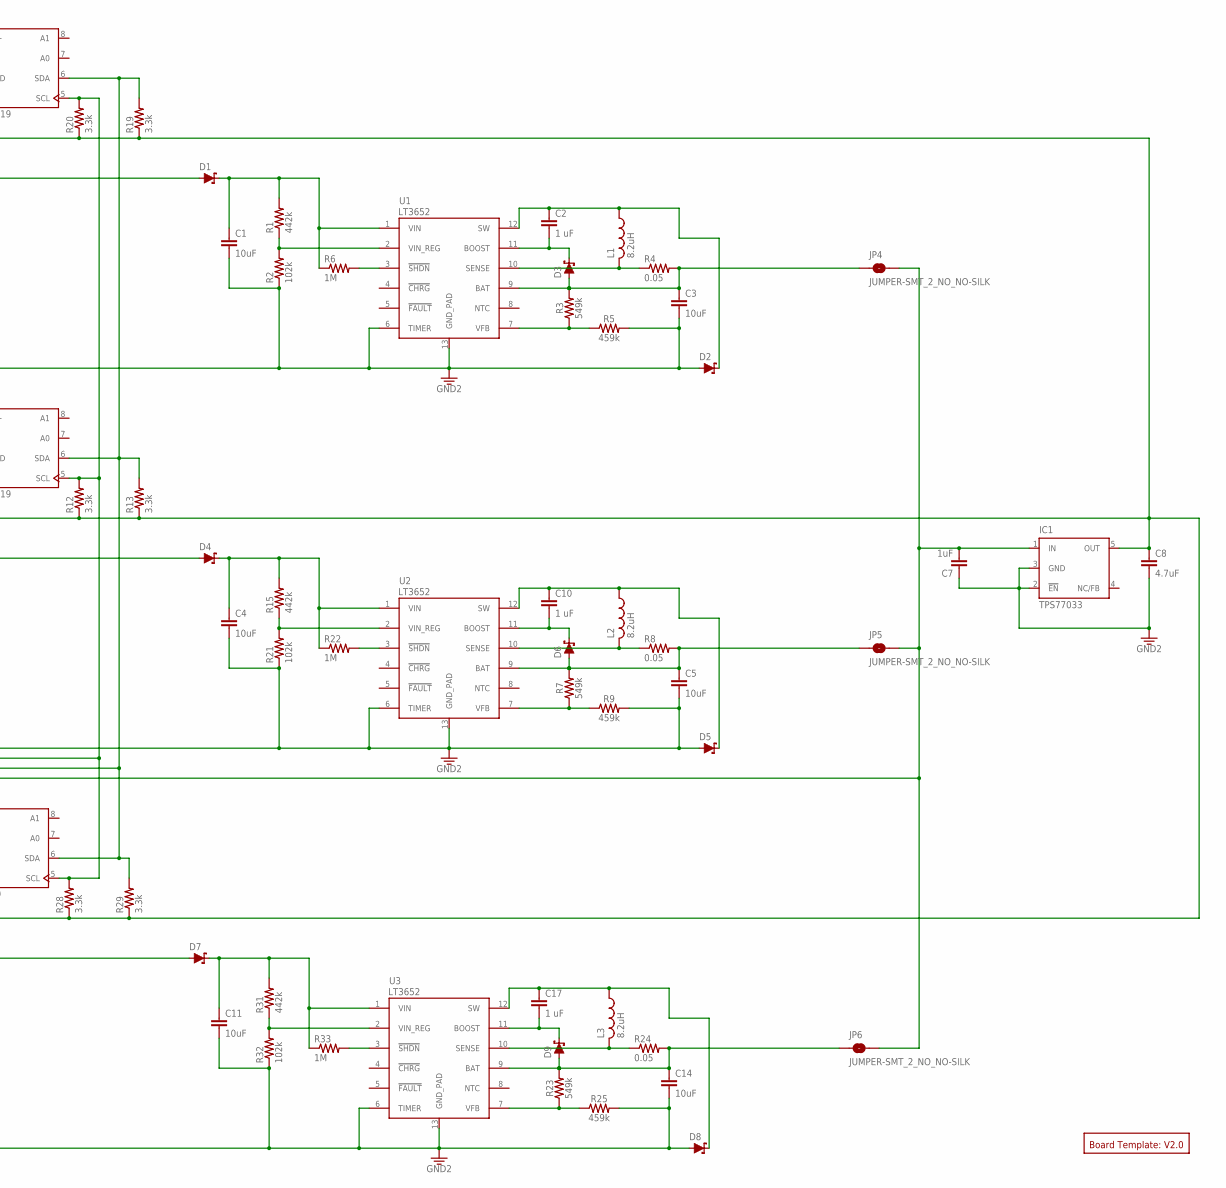
[picture p136: schematic PwrGenBrd_v3.sch, part in row 1, column 2]

Parts:
C1, C3, C4, C5, C11, C14: 10uF; 1210
C2, C10, C17: 1 uF; C0805
C6, C13, C15: 0.1uF; C0201
C7, C9, C12, C16: 1uF; C1210
C8: 4.7uF; 0603
D1, D2, D4, D5, D7, D8: DIODE-SCHOTTKY-B340A; SMA-DIODE
D3, D6, D9: DIODE-SCHOTTKY-ZLLS500; SOT23-3
IC1: TPS77033; SOT23-DBV
JP1, JP2, JP3, JP4, JP5, JP6: JUMPER-SMT_2_NO_NO-SILK; SMT-JUMPER_2_NO_NO-SILK
L1, L2, L3: 8.2uH; L1812
R1, R15, R31: 442k; R0402
R2, R21, R32: 102k; R0402
R3, R7, R23: 549k; 0805
R4, R8, R24: 0.05; R2512
R5, R9, R25: 459k; 1206
R6, R22, R33: 1M; R0402
R10, R11, R17, R18, R26, R27: 10; R0402
R12, R13, R19, R20, R28, R29: 3.3k; R0603
R14, R16, R30: 0.07; R2512
U1, U2, U3: LT3652; MSOP-12_GND
U$1, U$2, U$3: INA219; SO08
U$4: 2X26_CONNECTOR; 4X26_CONNECTOR_(V1.0)
U$5: BOARD_TEMPLATE; BOARD_TEMPLATE_(V2.0)
X1, X2, X3: W237-102

Connections:
BATT: C3.1, D3.1 (A), JP4.1, R3.2, R4.2, U1.9 (BAT)
BATT1: C5.1, D6.1 (A), JP5.1, R7.2, R8.2, U2.9 (BAT)
BATT2: C14.1, D9.1 (A), JP6.1, R23.2, R24.2, U3.9 (BAT)
BOOST: C2.2, D3.3 (C), U1.11 (BOOST)
BOOST1: C10.2, D6.3 (C), U2.11 (BOOST)
BOOST2: C17.2, D9.3 (C), U3.11 (BOOST)
GND: C1.2, C3.2, C4.2, C5.2, C6.2, C11.2, C13.2, C14.2, C15.2, D2.A, D5.A, D8.A, R2.1, R5.2, R9.2, R21.1, R25.2, R32.1, U1.6 (TIMER), U1.13 (GND_PAD), U2.6 (TIMER), U2.13 (GND_PAD), U3.6 (TIMER), U3.13 (GND_PAD), U$1.3 (GND), U$2.3 (GND), U$3.3 (GND), U$4.P$73 (DISTRI_GND), U$4.P$75 (DISTRI_GND), U$4.P$78 (DISTRI_GND), U$4.P$80 (DISTRI_GND), U$4.P$81 (DISTRI_GND), U$4.P$83 (DISTRI_GND), U$4.P$86 (DISTRI_GND), U$4.P$88 (DISTRI_GND), X1.2, X2.2, X3.2
GND4: C7.1, C8.2, IC1.2 (!EN), IC1.3 (GND)
IN+: C12.1, R18.2, U$1.1 (IN+)
IN+1: C9.1, R10.2, U$2.1 (IN+)
IN+2: C16.1, R26.2, U$3.1 (IN+)
IN++: JP1.2, R16.2, R18.1
IN++1: JP2.2, R10.1, R14.2
IN++2: JP3.2, R26.1, R30.2
IN-: C12.2, R17.2, U$1.2 (IN-)
IN-1: C9.2, R11.2, U$2.2 (IN-)
IN-2: C16.2, R27.2, U$3.2 (IN-)
IN--: D1.A, R16.1, R17.1
IN--1: D4.A, R11.1, R14.1
IN--2: D7.A, R27.1, R30.1
unnamed: R6.2, U1.3 (!SHDN)
PNL1: JP1.1, X1.1
PNL2: JP2.1, X2.1
PNL3: JP3.1, X3.1
SCL: R12.2, R20.2, R28.2, U$1.5 (SCL), U$2.5 (SCL), U$3.5 (SCL), U$4.P$45
SDA: R13.2, R19.2, R29.2, U$1.6 (SDA), U$2.6 (SDA), U$3.6 (SDA), U$4.P$41
SENSE: L1.2, R4.1, U1.10 (SENSE)
SENSE1: L2.2, R8.1, U2.10 (SENSE)
SENSE2: L3.2, R24.1, U3.10 (SENSE)
SHDN2: R22.2, U2.3 (!SHDN)
SHDN3: R33.2, U3.3 (!SHDN)
SW: C2.1, D2.C, L1.1, U1.12 (SW)
SW1: C10.1, D5.C, L2.1, U2.12 (SW)
SW2: C17.1, D8.C, L3.1, U3.12 (SW)
VBATT: C7.2, IC1.1 (IN), JP4.2, JP5.2, JP6.2, U$4.P$74 (DISTRI_VBAT), U$4.P$76 (DISTRI_VBAT), U$4.P$77 (DISTRI_VBAT), U$4.P$79 (DISTRI_VBAT), U$4.P$82 (DISTRI_VBAT), U$4.P$84 (DISTRI_VBAT), U$4.P$85 (DISTRI_VBAT), U$4.P$87 (DISTRI_VBAT)
VFB: R3.1, R5.1, U1.7 (VFB)
VFB1: R7.1, R9.1, U2.7 (VFB)
VFB2: R23.1, R25.1, U3.7 (VFB)
VIN: C1.1, D1.C, R1.2, R6.1, U1.1 (VIN)
VIN1: C4.1, D4.C, R15.2, R22.1, U2.1 (VIN)
VIN2: C11.1, D7.C, R31.2, R33.1, U3.1 (VIN)
VIN_REG: R1.1, R2.2, U1.2 (VIN_REG)
VIN_REG1: R15.1, R21.2, U2.2 (VIN_REG)
VIN_REG2: R31.1, R32.2, U3.2 (VIN_REG)
VS: C6.1, C8.1, C13.1, C15.1, IC1.5 (OUT), R12.1, R13.1, R19.1, R20.1, R28.1, R29.1, U$1.4 (VS), U$2.4 (VS), U$3.4 (VS)
