UWCubeSat/DubSat1/teams/power/Gen Board/Gen Board V4/PwrGenBrd_v4.2.sch

## EAGLE design teams/power/Gen Board/Gen Board V4/PwrGenBrd_v4.2.sch (2017-08-14)

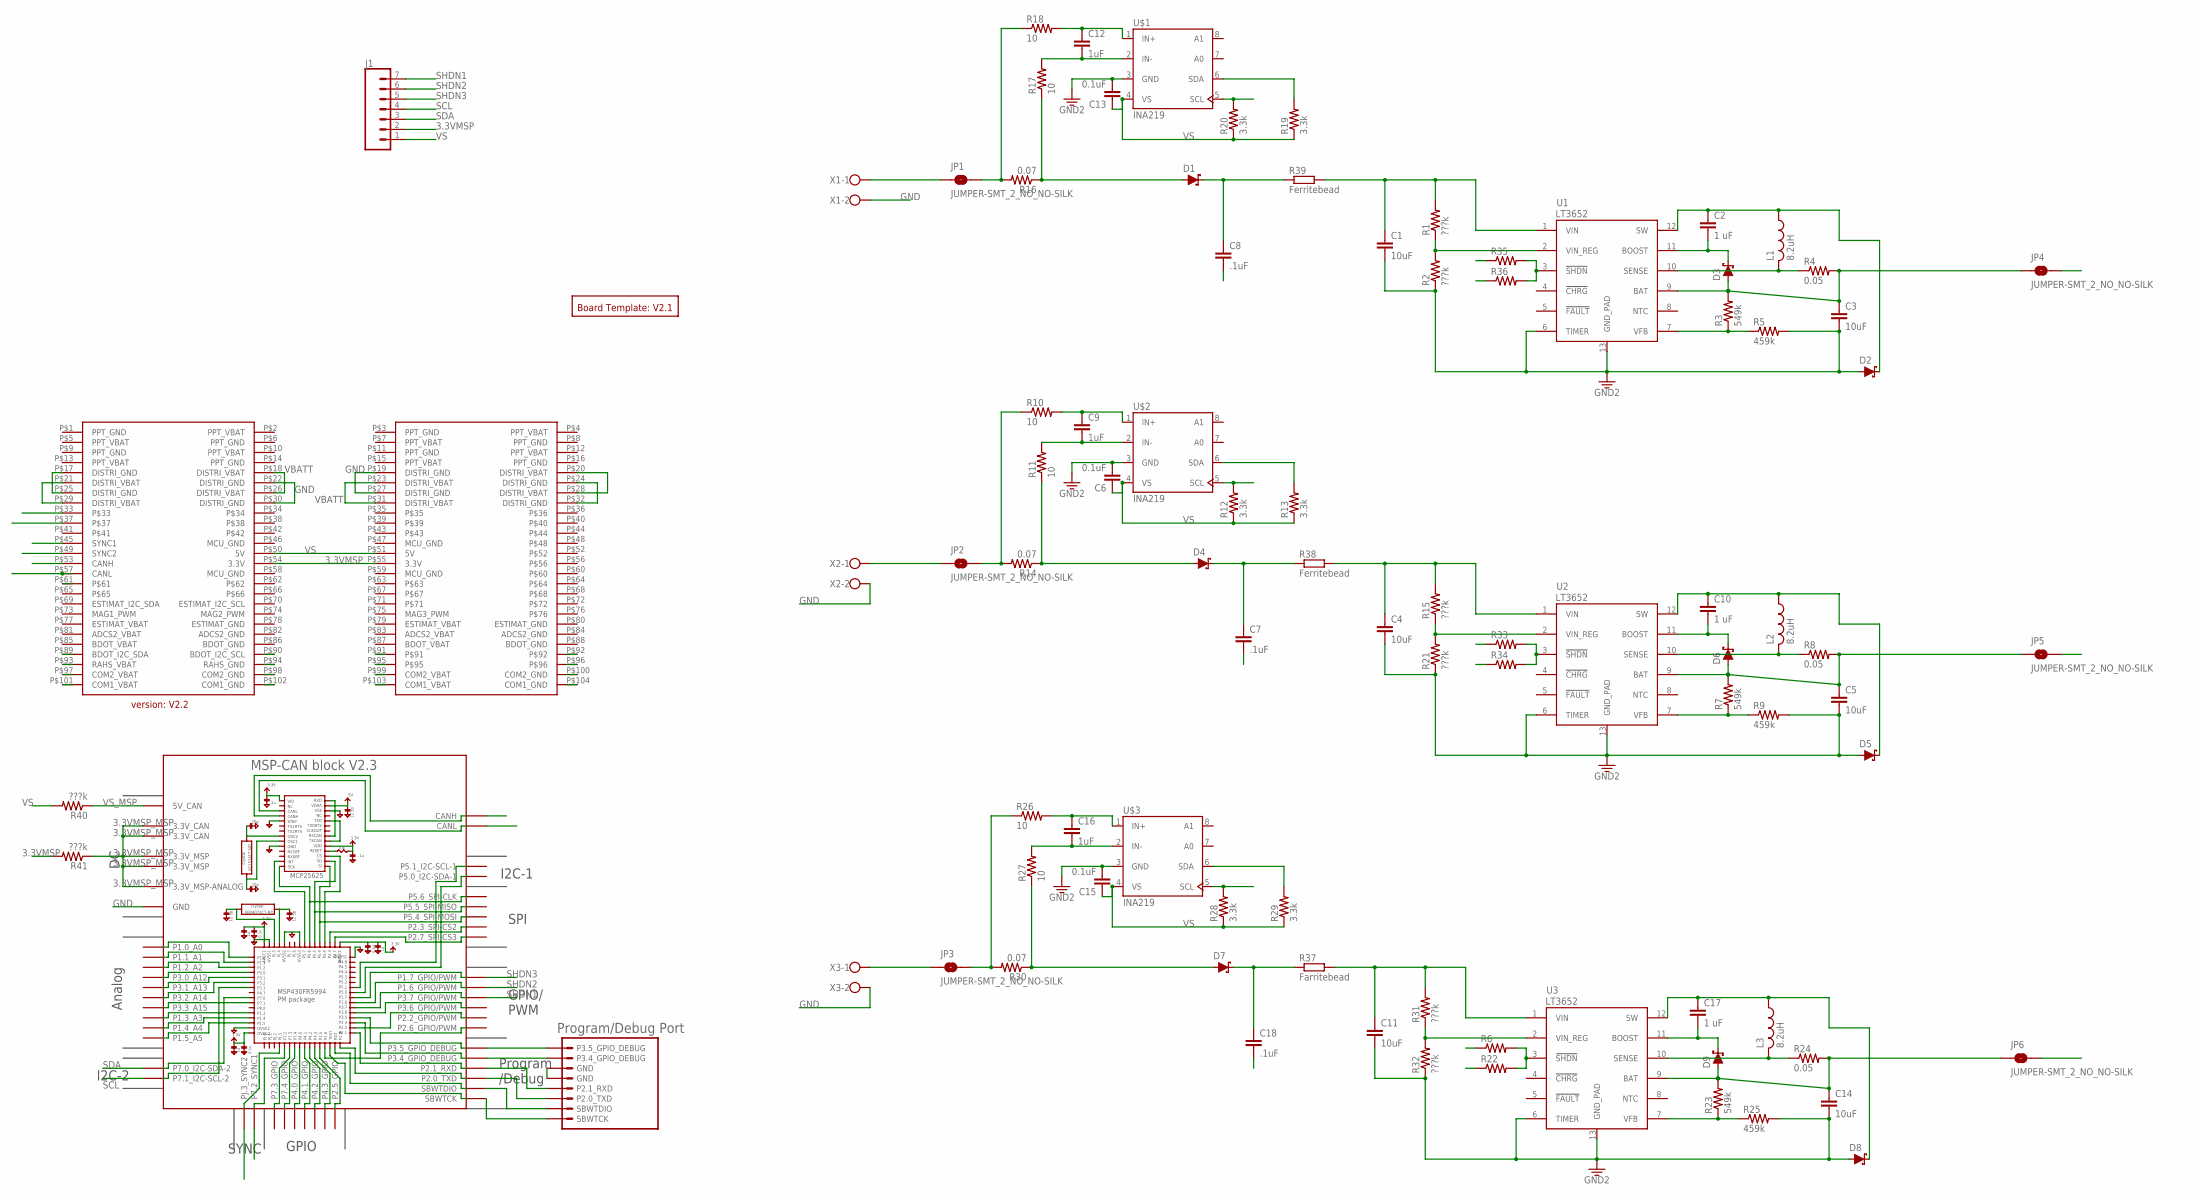
[picture p137: schematic PwrGenBrd_v4.2.sch, sheet 1]

Parts:
C1, C4, C11: 10uF; 1210
C2, C10, C17: 1 uF; C0805
C3, C5, C14: 10uF; C0805
C6, C13, C15: 0.1uF; C0805
C7, C8, C18: .1uF; C0805
C9, C12, C16: 1uF; C0805
D1, D2, D4, D5, D7, D8: DIODE-SCHOTTKY-B340A; SMA-DIODE
D3, D6, D9: DIODE-SCHOTTKY-ZLLS500; SOT23-3
J1: CONN_07LOCK_LONGPADS; 1X07_LOCK_LONGPADS
JP1, JP2, JP3, JP4, JP5, JP6: JUMPER-SMT_2_NO_NO-SILK; SMT-JUMPER_2_NO_NO-SILK
L1, L2, L3: 8.2uH; L1812
R1, R2, R15, R21, R31, R32, R40, R41: ???k; R0805
R3, R7, R23: 549k; R0805
R4, R8, R24: 0.05; R0805
R5, R9, R25: 459k; R0805
R6, R22, R33, R34, R35, R36: R-US_R0805; R0805
R10, R11, R17, R18, R26, R27: 10; R0805
R12, R13, R19, R20, R28, R29: 3.3k; R0805
R14, R16, R30: 0.07; R0805
R37: Farritebead; R1206
R38, R39: Ferritebead; R1206
U1, U2, U3: LT3652; MSOP-12_GND
U$1, U$2, U$3: INA219; SO08
U$4: PC104_CONNECTOR
U$5: MSP-CAN_BLOCK
U$6: BOARD_TEMPLATE_(V2.1)
U$8: PROGRAM/DEBUG_PORT; 1X08_CONNECTOR
X1, X2, X3: W237-102

Connections:
3.3VMSP: J1.2, R41.2, U$4.P$54 (3.3V), U$4.P$55 (3.3V)
3.3VMSP_MSP: R41.1, U$5.3.3V@CAN1 (3.3V_CAN), U$5.3.3V@CAN2 (3.3V_CAN), U$5.3.3V@MSP1 (3.3V_MSP), U$5.3.3V@MSP2 (3.3V_MSP), U$5.3.3V_ANALOG@MSP2 (3.3V_MSP-ANALOG)
BATT: C3.1, D3.1 (A), JP4.1, R3.2, R4.2, U1.9 (BAT)
BATT1: C5.1, D6.1 (A), JP5.1, R7.2, R8.2, U2.9 (BAT)
BATT2: C14.1, D9.1 (A), JP6.1, R23.2, R24.2, U3.9 (BAT)
BOOST: C2.2, D3.3 (C), U1.11 (BOOST)
BOOST1: C10.2, D6.3 (C), U2.11 (BOOST)
BOOST2: C17.2, D9.3 (C), U3.11 (BOOST)
CANH: U$4.P$53 (CANH), U$5.CANH
CANL: U$4.P$57 (CANL), U$5.CANL
GND: C1.2, C3.2, C4.2, C5.2, C6.2, C7.2, C8.2, C11.2, C13.2, C14.2, C15.2, C18.2, D2.A, D5.A, D8.A, R2.1, R5.2, R9.2, R21.1, R25.2, R32.1, U1.6 (TIMER), U1.13 (GND_PAD), U2.6 (TIMER), U2.13 (GND_PAD), U3.6 (TIMER), U3.13 (GND_PAD), U$1.3 (GND), U$2.3 (GND), U$3.3 (GND), U$4.P$17 (DISTRI_GND), U$4.P$19 (DISTRI_GND), U$4.P$22 (DISTRI_GND), U$4.P$24 (DISTRI_GND), U$4.P$25 (DISTRI_GND), U$4.P$27 (DISTRI_GND), U$4.P$30 (DISTRI_GND), U$4.P$32 (DISTRI_GND), U$5.GND@1 (GND), U$8.5 (GND), U$8.6 (GND), X1.2, X2.2, X3.2
IN+: C12.1, R18.2, U$1.1 (IN+)
IN+1: C9.1, R10.2, U$2.1 (IN+)
IN+2: C16.1, R26.2, U$3.1 (IN+)
IN++: JP1.2, R16.2, R18.1
IN++1: JP2.2, R10.1, R14.2
IN++2: JP3.2, R26.1, R30.2
IN-: C12.2, R17.2, U$1.2 (IN-)
IN-1: C9.2, R11.2, U$2.2 (IN-)
IN-2: C16.2, R27.2, U$3.2 (IN-)
IN--: D1.A, R16.1, R17.1
IN--1: D4.A, R11.1, R14.1
IN--2: D7.A, R27.1, R30.1
unnamed: R6.2, R22.2, U3.3 (!SHDN)
unnamed: C8.1, D1.C, R39.1
unnamed: C7.1, D4.C, R38.1
unnamed: R33.2, R34.2, U2.3 (!SHDN)
unnamed: C18.1, D7.C, R37.1
unnamed: R35.2, R36.2, U1.3 (!SHDN)
P2.0TXD: U$5.P2.0_TXD, U$8.3 (P2.0_TXD)
P2.1RXD: U$5.P2.1_RXD, U$8.4 (P2.1_RXD)
P3.4GPIO: U$5.P3.4_GPIO_DEBUG, U$8.7 (P3.4_GPIO_DEBUG)
P3.5GPIO: U$5.P3.5_GPIO_DEBUG, U$8.8 (P3.5_GPIO_DEBUG)
PNL1: JP1.1, R35.1, X1.1
PNL2: JP2.1, R33.1, X2.1
PNL3: JP3.1, R6.1, X3.1
SBWTCK: U$5.SBWTCK, U$8.SBWTCK
SBWTDIO: U$5.SBWTDIO, U$8.2 (SBWTDIO)
SCL: J1.4, R12.2, R20.2, R28.2, U$1.5 (SCL), U$2.5 (SCL), U$3.5 (SCL), U$4.P$33, U$5.P7.1_I2C-SCL-2
SDA: J1.3, R13.2, R19.2, R29.2, U$1.6 (SDA), U$2.6 (SDA), U$3.6 (SDA), U$4.P$37, U$5.P7.0_I2C-SDA-2
SENSE: L1.2, R4.1, U1.10 (SENSE)
SENSE1: L2.2, R8.1, U2.10 (SENSE)
SENSE2: L3.2, R24.1, U3.10 (SENSE)
SHDN1: J1.7, R36.1, U$5.P3.7_GPIO/PWM
SHDN2: J1.6, R34.1, U$5.P1.6_GPIO/PWM
SHDN3: J1.5, R22.1, U$5.P1.7_GPIO/PWM
SW: C2.1, D2.C, L1.1, U1.12 (SW)
SW1: C10.1, D5.C, L2.1, U2.12 (SW)
SW2: C17.1, D8.C, L3.1, U3.12 (SW)
SYNC1: U$4.P$45 (SYNC1), U$5.P7.2_SYNC1
SYNC2: U$4.P$49 (SYNC2), U$5.PJ.3_SYNC2
VBATT: JP4.2, JP5.2, JP6.2, U$4.P$18 (DISTRI_VBAT), U$4.P$20 (DISTRI_VBAT), U$4.P$21 (DISTRI_VBAT), U$4.P$23 (DISTRI_VBAT), U$4.P$26 (DISTRI_VBAT), U$4.P$28 (DISTRI_VBAT), U$4.P$29 (DISTRI_VBAT), U$4.P$31 (DISTRI_VBAT)
VFB: R3.1, R5.1, U1.7 (VFB)
VFB1: R7.1, R9.1, U2.7 (VFB)
VFB2: R23.1, R25.1, U3.7 (VFB)
VIN: C1.1, R1.2, R39.2, U1.1 (VIN)
VIN1: C4.1, R15.2, R38.2, U2.1 (VIN)
VIN2: C11.1, R31.2, R37.2, U3.1 (VIN)
VIN_REG: R1.1, R2.2, U1.2 (VIN_REG)
VIN_REG1: R15.1, R21.2, U2.2 (VIN_REG)
VIN_REG2: R31.1, R32.2, U3.2 (VIN_REG)
VS: C6.1, C13.1, C15.1, J1.1, R12.1, R13.1, R19.1, R20.1, R28.1, R29.1, R40.2, U$1.4 (VS), U$2.4 (VS), U$3.4 (VS), U$4.P$50 (5V), U$4.P$51 (5V)
VS_MSP: R40.1, U$5.5V (5V_CAN)
