UWCubeSat/DubSat1/teams/adcs/hardware/actuators/reaction_wheels/motor_controller_single.sch

## EAGLE design teams/adcs/hardware/actuators/reaction_wheels/motor_controller_single.sch (2017-09-08)

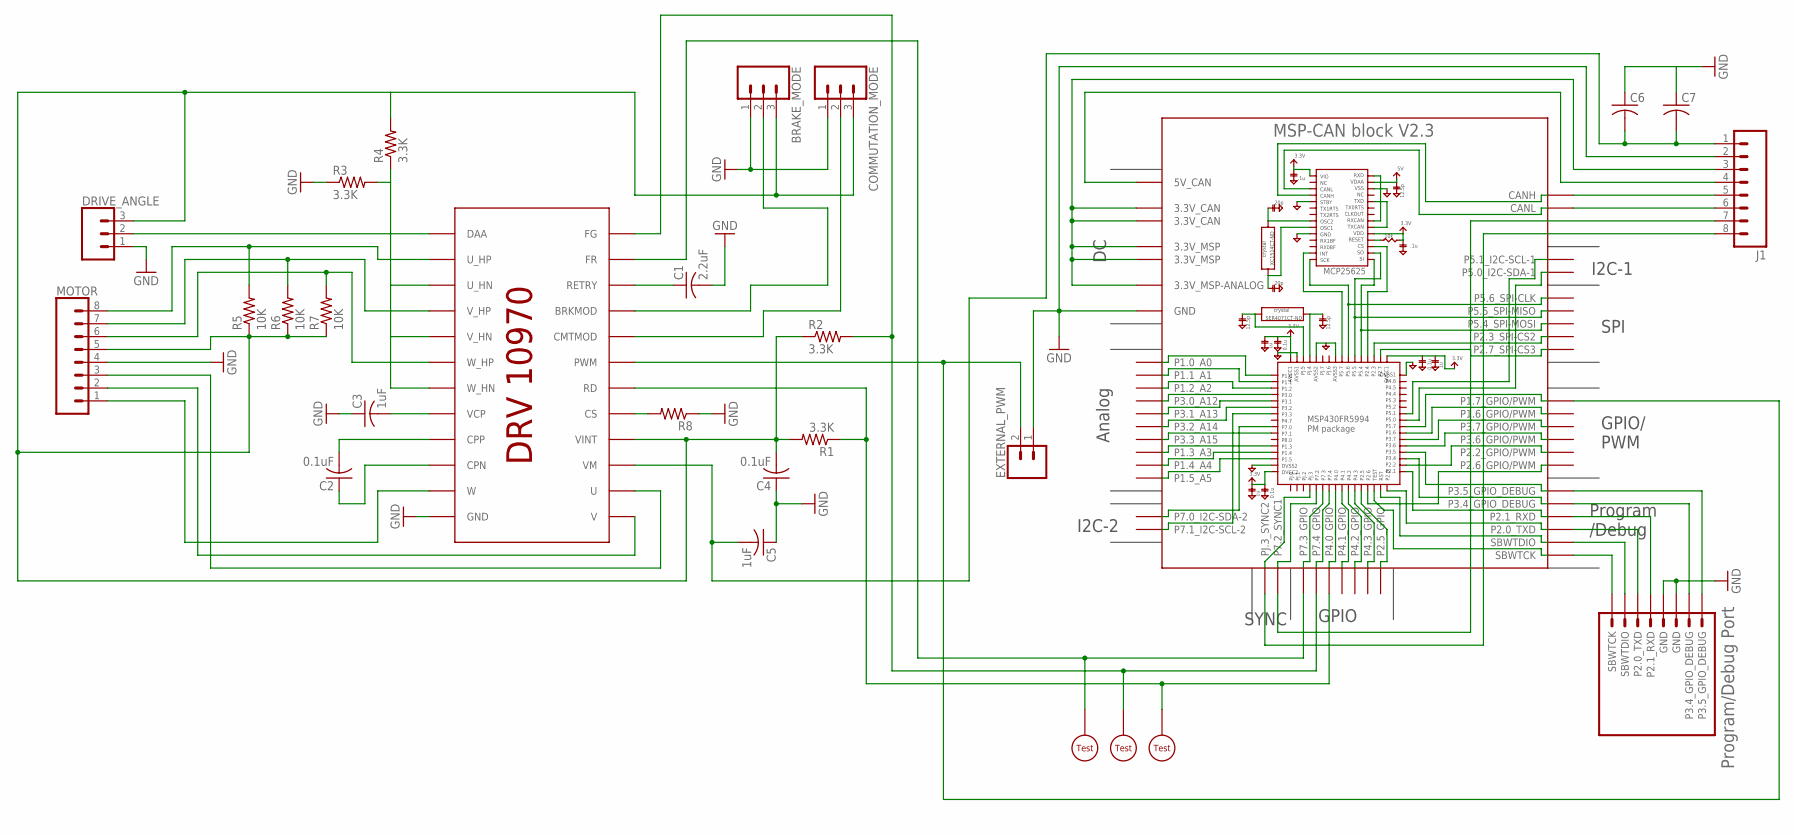
[picture p140: schematic motor_controller_single.sch]

Parts:
BRAKE_MODE: CONN_03LOCK; 1X03_LOCK
C1: 2.2uF; C1206
C2, C4: 0.1uF; C0805
C3, C5: 1uF; C1206
C6, C7: C-USC0805; C0805
COMMUTATION_MODE: CONN_03LOCK; 1X03_LOCK
DRIVE_ANGLE: CONN_03LOCK; 1X03_LOCK
EXTERNAL_PWM: CONN_02LOCK; 1X02_LOCK
J1: M08LOCK; 1X08_LOCK
MOTOR: CONN_08"; 1X08@1
R1, R2, R3, R4: 3.3K; R0805
R5, R6, R7: 10K; R0805
R8: R-US_R0805; R0805
U$1: DRV10970
U$2: MSP-CAN_BLOCK
U$3: PROGRAM/DEBUG_PORT; 1X08_CONNECTOR
U$4, U$5, U$6: KEYSTONE_SMD_TEST_POINT

Connections:
GND: BRAKE_MODE.1, C1.2, C3.1, C4.1, C5.1, C6.1, C7.1, COMMUTATION_MODE.1, DRIVE_ANGLE.1, EXTERNAL_PWM.1, J1.2, MOTOR.4, R3.1, R8.1, U$1.GND@1 (GND), U$2.GND@1 (GND), U$3.5 (GND), U$3.6 (GND)
unnamed: C2.2, U$1.CPP
unnamed: C1.1, U$1.RETRY
unnamed: U$2.SBWTCK, U$3.SBWTCK
unnamed: U$2.SBWTDIO, U$3.2 (SBWTDIO)
unnamed: U$2.P2.0_TXD, U$3.3 (P2.0_TXD)
unnamed: U$2.P2.1_RXD, U$3.4 (P2.1_RXD)
unnamed: U$2.P3.4_GPIO_DEBUG, U$3.7 (P3.4_GPIO_DEBUG)
unnamed: U$2.P3.5_GPIO_DEBUG, U$3.8 (P3.5_GPIO_DEBUG)
unnamed: R1.1, U$1.RD, U$2.P4.0_GPIO, U$6.P$1
unnamed: EXTERNAL_PWM.2, U$1.PWM, U$2.P1.7_GPIO/PWM
unnamed: R2.2, U$1.FG, U$2.P7.4_GPIO, U$5.P$1
unnamed: U$1.FR, U$2.P7.3_GPIO, U$4.P$1
unnamed: C2.1, U$1.CPN
unnamed: J1.6, U$2.CANL
unnamed: C3.2, U$1.VCP
unnamed: C5.2, C6.2, C7.2, J1.1, U$1.VM
unnamed: R3.2, R4.1, U$1.U_HN, U$1.V_HN, U$1.W_HN
unnamed: DRIVE_ANGLE.2, U$1.DAA
unnamed: COMMUTATION_MODE.2, U$1.CMTMOD
unnamed: BRAKE_MODE.2, U$1.BRKMOD
unnamed: BRAKE_MODE.3, C4.2, COMMUTATION_MODE.3, DRIVE_ANGLE.3, MOTOR.5, R1.2, R2.1, R4.2, R5.1, R6.1, R7.1, U$1.VINT
unnamed: J1.5, U$2.CANH
unnamed: J1.4, U$2.5V (5V_CAN)
unnamed: J1.3, U$2.3.3V@CAN1 (3.3V_CAN), U$2.3.3V@CAN2 (3.3V_CAN), U$2.3.3V@MSP1 (3.3V_MSP), U$2.3.3V@MSP2 (3.3V_MSP), U$2.3.3V_ANALOG@MSP2 (3.3V_MSP-ANALOG)
unnamed: R8.2, U$1.CS
unnamed: MOTOR.1, U$1.W
unnamed: MOTOR.6, R7.2, U$1.W_HP
unnamed: MOTOR.7, R6.2, U$1.V_HP
unnamed: MOTOR.8, R5.2, U$1.U_HP
unnamed: MOTOR.2, U$1.V
unnamed: MOTOR.3, U$1.U
SYNC1: J1.7, U$2.P7.2_SYNC1
SYNC2: J1.8, U$2.PJ.3_SYNC2
