UWCubeSat/DubSat1/teams/power/Battery Board/Battery Ballancer/BQ29209 breakout board V1.1/BQ29209 breakout board V1.1.sch

## EAGLE design teams/power/Battery Board/Battery Ballancer/BQ29209 breakout board V1.1/BQ29209 breakout board V1.1.sch (2017-07-28)

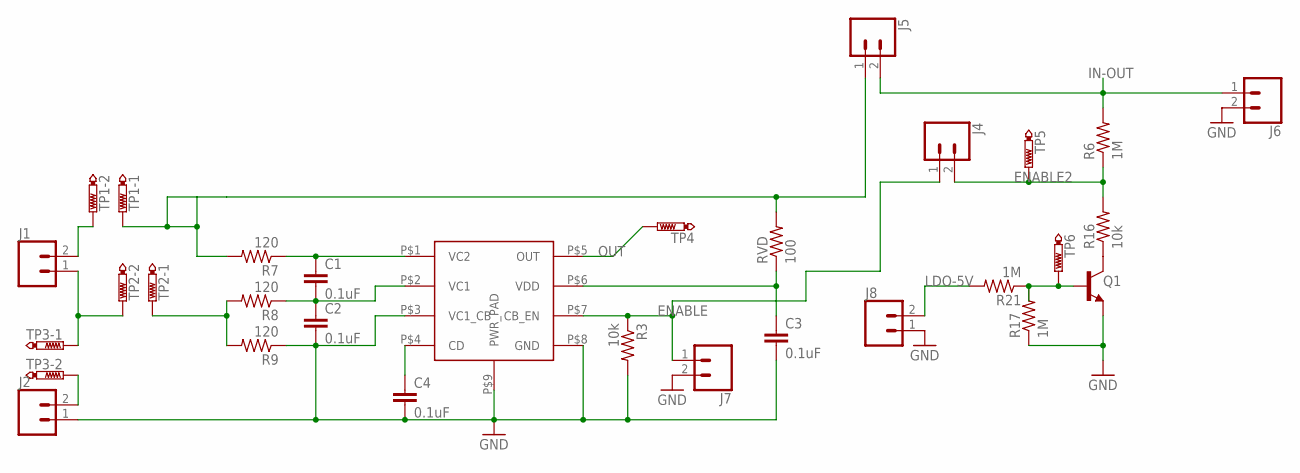
[picture p141: schematic BQ29209 breakout board V1.1.sch]

Parts:
C1, C2, C3, C4: 0.1uF; C0805
J1, J2, J4, J5, J6, J7, J8: CONN_02; 1X02
Q1: TRANS_NPN-MMBT2222AL; SOT23-3
R3, R16: 10k; R0805
R6: 1M; R0805
R7, R8, R9: 120; R0805
R17, R21: 1M; M0805
RVD: 100; R0805
TP1, TP2, TP3: PTR2; P2-38-17
TP4, TP5, TP6: PTR1PAD1-13Y; P1-13Y
U$8: BQ29209; VSON8

Connections:
BASE: Q1.1 (B), R17.2, R21.1, TP6.TP
ENABLE: J4.1, J7.1, R3.1, U$8.P$7 (CB_EN)
ENABLE2: J4.2, R6.1, R16.2, TP5.TP
GND: C2.2, C3.2, C4.2, J2.1, J6.2, J7.2, J8.1, Q1.2 (E), R3.2, R9.1, R17.1, U$8.P$3 (VC1_CB), U$8.P$8 (GND), U$8.P$9 (PWR_PAD)
IN-OUT: J5.2, J6.1, R6.2
LDO-5V: J8.2, R21.2
unnamed: J1.2, TP1.TP-2
unnamed: R8.2, R9.2, TP2.TP-1
unnamed: J1.1, TP2.TP-2, TP3.TP-1
unnamed: C1.1, R7.1, U$8.P$1 (VC2)
unnamed: C1.2, C2.1, R8.1, U$8.P$2 (VC1)
unnamed: C3.1, RVD.1, U$8.P$6 (VDD)
unnamed: Q1.3 (C), R16.1
unnamed: C4.1, U$8.P$4 (CD)
unnamed: J2.2, TP3.TP-2
OUT: TP4.TP, U$8.P$5 (OUT)
V-BATT: J5.1, R7.2, RVD.2, TP1.TP-1
