UWCubeSat/DubSat1/teams/power/Battery Board/Coulomb Counter/Coulomb Counter Breakout Board/Coulomb Counter Test Board.sch

## EAGLE design teams/power/Battery Board/Coulomb Counter/Coulomb Counter Breakout Board/Coulomb Counter Test Board.sch (2017-07-28)

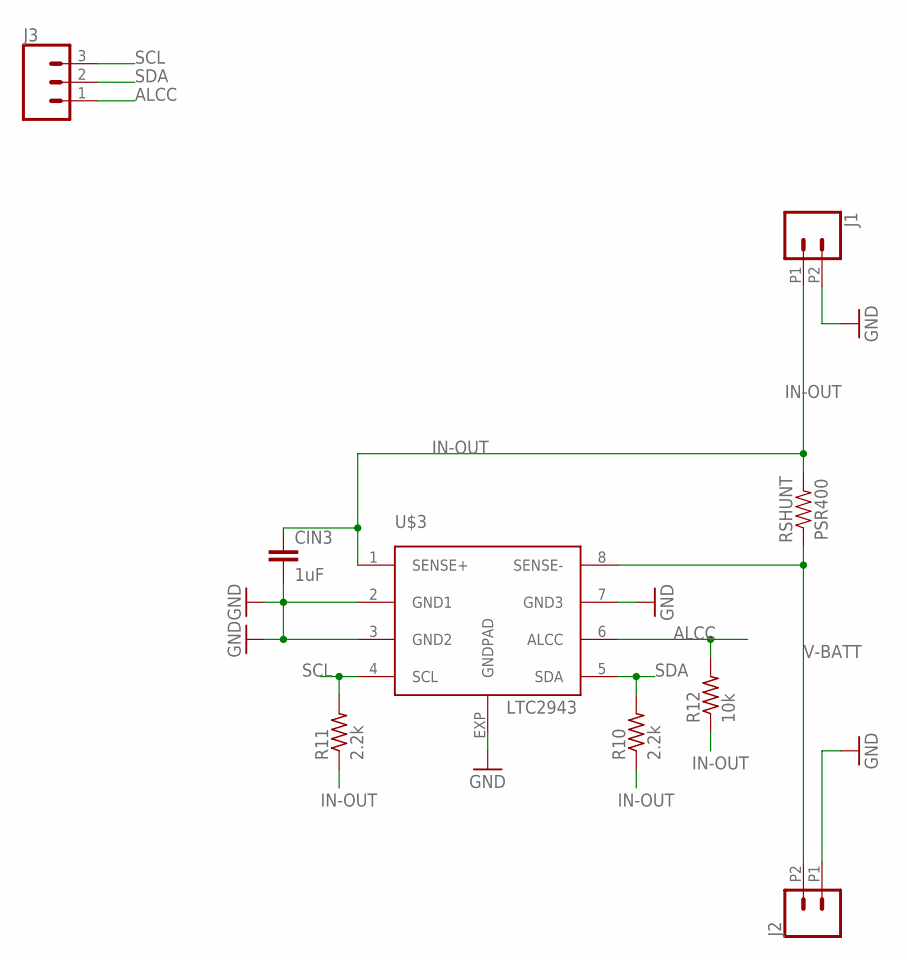
[picture p142: schematic Coulomb Counter Test Board.sch]

Parts:
CIN3: 1uF; 0402-CAP
J1, J2: CONN_022.54MM_SCREWTERM; 1X02_2.54_SCREWTERM
J3: CONN_03; 1X03
R10, R11: 2.2k; R0805
R12: 10k; R0805
RSHUNT: PSR400
U$3: LTC2943; DFN8(3X3)LT

Connections:
ALCC: J3.1, R12.2, U$3.6 (ALCC)
GND: CIN3.2, J1.P2 (2), J2.P1 (1), U$3.2 (GND1), U$3.3 (GND2), U$3.7 (GND3), U$3.EXP (GNDPAD)
IN-OUT: CIN3.1, J1.P1 (1), R10.1, R11.1, R12.1, RSHUNT.P$2 (2), U$3.1 (SENSE+)
SCL: J3.3, R11.2, U$3.4 (SCL)
SDA: J3.2, R10.2, U$3.5 (SDA)
V-BATT: J2.P2 (2), RSHUNT.P$1 (1), U$3.8 (SENSE-)
