UWCubeSat/DubSat1/teams/power/Battery Board/Temp sensor & Heater assembly/mounted temp sensor breakout board V1/mounted temp sensor breakout board V1.sch

## EAGLE design teams/power/Battery Board/Temp sensor & Heater assembly/mounted temp sensor breakout board V1/mounted temp sensor breakout board V1.sch (2017-08-01)

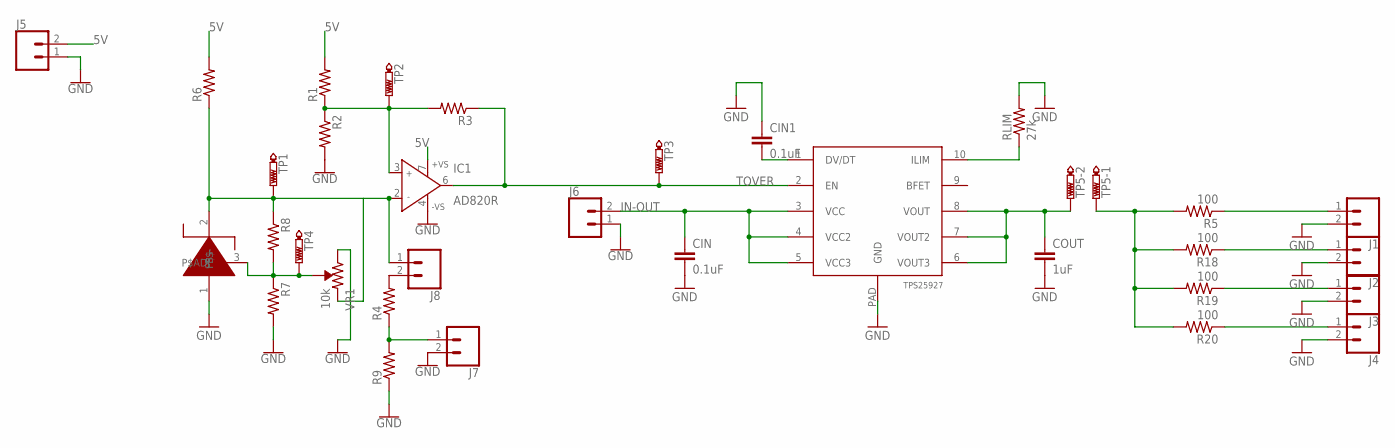
[picture p143: schematic mounted temp sensor breakout board V1.sch]

Parts:
CIN, CIN1: 0.1uF; C0805
COUT: 1uF; C0805
IC1: AD820R; SO8
J1, J2, J3, J4, J5, J6: CONN_02PTH4; 1X02_XTRA_BIG
J7: CONN_02PTH3; 1X02_LONGPADS
J8: CONN_02; 1X02
R1, R2, R3, R4, R6, R7, R8, R9: R-US_R0805; R0805
R5, R18, R19, R20: 100; R0805
RLIM: 27k; R0805
TP1, TP2, TP3, TP4: PTR1PAD1-13Y; P1-13Y
TP5: PTR2; P2-38-17
U$1: LM135Z; TO-92-3
U$5: TPS252927; VSON10
VR1: 10k; TRIMPOT-SMD-TC33X

Connections:
5V: IC1.7 (+VS), J5.2, R1.2, R6.2
GND: CIN.2, CIN1.1, COUT.2, IC1.4 (-VS), J1.2, J2.2, J3.2, J4.2, J5.1, J6.1, J7.2, R2.2, R7.2, R9.1, RLIM.2, U$1.1 (P$-), U$5.PAD (GND), VR1.1 (CW)
HEATER1: J3.1, R19.1
IN-OUT: CIN.1, J6.2, U$5.3 (VCC), U$5.4 (VCC2), U$5.5 (VCC3)
unnamed: J1.1, R5.1
unnamed: IC1.3 (IN+), R1.1, R2.1, R3.2, TP2.TP
unnamed: IC1.2 (IN-), J8.1, R6.1, R8.1, TP1.TP, U$1.2 (P$+), VR1.3 (CCW)
unnamed: R7.1, R8.2, TP4.TP, U$1.3 (P$ADJ), VR1.2 (WIPER)
unnamed: J2.1, R18.1
unnamed: J4.1, R20.1
unnamed: J7.1, R4.1, R9.2
unnamed: CIN1.2, U$5.1 (DV/DT)
unnamed: R5.2, R18.2, R19.2, R20.2, TP5.TP-1
unnamed: RLIM.1, U$5.10 (ILIM)
unnamed: J8.2, R4.2
unnamed: COUT.1, TP5.TP-2, U$5.6 (VOUT3), U$5.7 (VOUT2), U$5.8 (VOUT)
TOVER: IC1.6 (OUT), R3.1, TP3.TP, U$5.2 (EN)
