UWCubeSat/DubSat1/teams/power/Solar Panels/documents/Attempt at 6 cells/Side Panel Experement - 6 cells.sch

## EAGLE design teams/power/Solar Panels/documents/Attempt at 6 cells/Side Panel Experement - 6 cells.sch (2017-08-14)

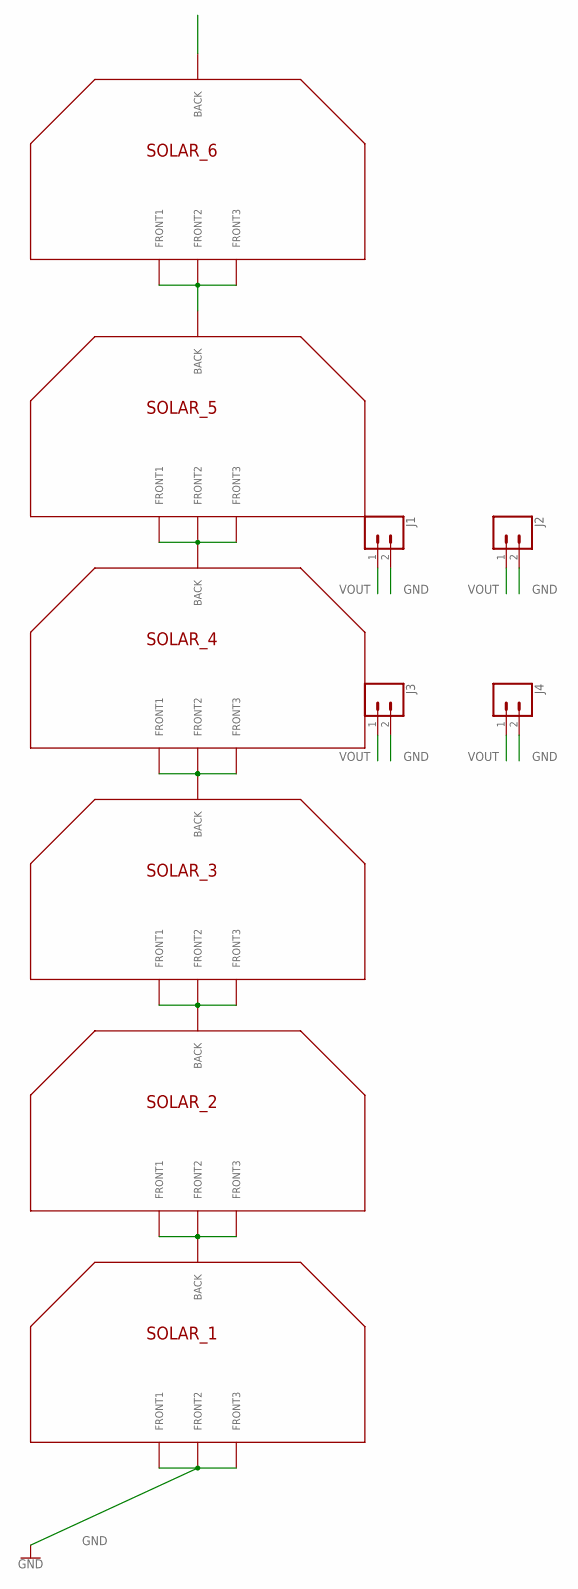
[picture p144: schematic Side Panel Experement - 6 cells.sch]

Parts:
J1, J2, J3, J4: CONN_02; 1X02
SOLAR_1, SOLAR_2, SOLAR_3, SOLAR_4, SOLAR_5, SOLAR_6: SOLAR_CELL_HALF_TABSFULL_TABS; SOLAR_CELL_3G30A_FULL_TABS

Connections:
1-2: SOLAR_1.P$1 (BACK), SOLAR_2.P$F1 (FRONT1), SOLAR_2.P$F2 (FRONT2), SOLAR_2.P$F3 (FRONT3)
2-3: SOLAR_2.P$1 (BACK), SOLAR_3.P$F1 (FRONT1), SOLAR_3.P$F2 (FRONT2), SOLAR_3.P$F3 (FRONT3)
3-4: SOLAR_3.P$1 (BACK), SOLAR_4.P$F1 (FRONT1), SOLAR_4.P$F2 (FRONT2), SOLAR_4.P$F3 (FRONT3)
4-5: SOLAR_4.P$1 (BACK), SOLAR_5.P$F1 (FRONT1), SOLAR_5.P$F2 (FRONT2), SOLAR_5.P$F3 (FRONT3)
GND: J1.2, J2.2, J3.2, J4.2, SOLAR_1.P$F1 (FRONT1), SOLAR_1.P$F2 (FRONT2), SOLAR_1.P$F3 (FRONT3)
unnamed: SOLAR_5.P$1 (BACK), SOLAR_6.P$F1 (FRONT1), SOLAR_6.P$F2 (FRONT2), SOLAR_6.P$F3 (FRONT3)
VOUT: J1.1, J2.1, J3.1, J4.1
