UWCubeSat/DubSat1/src/devmods/power_current_sensor/power_current_sensor.h

/*
 * POWER_CURRENT_SENSOR.h
 *
 *  Created on: November 21, 2017
 *      Author: Mohammad Kayali
 */

#ifndef POWER_CURRENT_SENSOR_H_
#define POWER_CURRENT_SENSOR_H_

#include "power_current_sensor.h"

#include "../../dsbase/core/i2c.h"

#endif /* POWER_CURRENT_SENSOR_H_ */
