UWCubeSat/DubSat1/src/dsbase/sensors/pcvsensor.h

/*
 * POWER_CURRENT_SENSOR.h
 *
 *  Created on: November 21, 2017
 *      Author: Mohammad Kayali
 */

#ifndef POWER_CURRENT_SENSOR_H_
#define POWER_CURRENT_SENSOR_H_

#include "INA219_pcvsensor.h"
#include "../core/i2c.h"

#define MAX_NUM_PCVSENSORS  16
#define DEFAULT_MAX_CURRENT_AMPS    16  // If max=0 is selected

typedef struct _pcvSensorData {

    int16_t rawBusVoltage;
    int16_t rawShuntVoltage;
    int16_t rawCurrent;
    int16_t rawPower;

    float busVoltageV;
    float shuntVoltageV;
    float calcdCurrentA;
    float calcdPowerW;

} PCVSensorData;

typedef struct _device_context_pcvsensor {
    BOOL initialized;
    bus_instance_i2c bus;
    uint8_t slaveaddr;
    hDev hI2CDevice;

    float shuntResistance;
    float maxCurrent;
    float currentLSB;
    float powerLSB;
    uint16_t calibFactor;

    PCVSensorData sensordata;
} deviceContextPCVSensor;

typedef enum {
    Read_ShuntV = 0x01,
    Read_BusV = 0x02,
    Read_CurrentA = 0x04,
    Read_PowerW = 0x08,
} pcv_read_type_flags;

hDev pcvsensorInit(bus_instance_i2c bus, uint8_t i2cAddr, float shuntResistance, float maxCurrent);
PCVSensorData *pcvsensorRead(hDev hSensor, pcv_read_type_flags rtype);

hDev pcvsensorGetUnderlyingDevice(hDev hSensor);

#endif /* POWER_CURRENT_SENSOR_H_ */
