UWCubeSat/DubSat1/src/dsbase/interfaces/canwrap.c

/*
 * canwrap.c
 *
 *  Created on: Aug 14, 2017
 *      Author: emoryeng
 */

#include "canwrap.h"
#include "../bsp/bsp.h"

void setMaskOrFilter(uint8_t addr, uint32_t filter){
    setTheFilter(addr, filter);
}

void wrapCB0(uint8_t length, uint8_t* data, uint32_t id){
    CANPacket packet = {0};
    CANPacket *p = &packet;
    p -> id = id;
    uint8_t i;
    for(i = 0 ; i < length; i++){
        p -> data[i] = data[i];
    }
    p -> bufferNum = 0;
    CANPacketReceived(p);
}

void wrapCB1(uint8_t length, uint8_t* data, uint32_t id){
    CANPacket packet = {0};
    CANPacket *p = &packet;
    p -> id = id;
    uint8_t i;
    for(i = 0 ; i < length; i++){
        p -> data[i] = data[i];
    }
    p -> bufferNum = 1;
    CANPacketReceived(p);
}

void canWrapInit(){
    canInit();
    setReceiveCallback0(wrapCB0);
    setReceiveCallback1(wrapCB1);
}

void canWrapInitWithFilter(){
    canWrapInit();
    SubsystemModule ss = bspGetModule();
    uint8_t filter_one = 0x0;
    uint8_t filter_two = 0x0;
    uint8_t filter_three = 0x0;
    uint8_t filter_four = 0x0;
    switch(ss) {
      case Module_Test :
        filter_one = 0x01;
        filter_two = 0x02;
        filter_three = 0x03;
        filter_four = 0x04;
        break;
      case Module_ADCS_BDot :
        filter_one = 0x01;
        filter_two = 0x03;
        filter_three = 0x04;
        filter_four = 0x07;
        break;
      case Module_ADCS_RWX :
        filter_one = 0x01;
        filter_two = 0x03;
        filter_three = 0x04;
        filter_four = 0x04;
        break;
      case Module_ADCS_RWY :
        filter_one = 0x01;
        filter_two = 0x03;
        filter_three = 0x04;
        filter_four = 0x04;
        break;
      case Module_ADCS_RWZ :
        filter_one = 0x01;
        filter_two = 0x03;
        filter_three = 0x04;
        filter_four = 0x04;
        break;
      case Module_PPT :
        filter_one = 0x01;
        filter_two = 0x03;
        filter_three = 0x04;
        filter_four = 0x04;
        break;
      case Module_EPS_Dist :
        filter_one = 0x01;
        filter_two = 0x03;
        filter_three = 0x04;
        filter_four = 0x04;
        break;
      case Module_EPS_Gen :
        filter_one = 0x01;
        filter_two = 0x03;
        filter_three = 0x04;
        filter_four = 0x04;
        break;
      case Module_EPS_Batt :
        filter_one = 0x01;
        filter_two = 0x03;
        filter_three = 0x04;
        filter_four = 0x04;
        break;
      case Module_ADCS_Estim :
        filter_one = 0x01;
        filter_two = 0x03;
        filter_three = 0x04;
        filter_four = 0x07;
        break;
      case Module_ADCS_MPC :
        filter_one = 0x01;
        filter_two = 0x04;
        filter_three = 0x05;
        filter_four = 0x07;
        break;
      case Module_ADCS_SensorProc :
        filter_one = 0x01;
        filter_two = 0x03;
        filter_three = 0x04;
        filter_four = 0x04;
        break;
      case Module_ADCS_MTQ :
        filter_one = 0x01;
        filter_two = 0x03;
        filter_three = 0x04;
        filter_four = 0x07;
        break;
      case Module_COM1 :
        filter_one = 0x01;
        filter_two = 0x03;
        filter_three = 0x04;
        filter_four = 0x04;
        break;
      case Module_COM2 :
        filter_one = 0x01;
        filter_two = 0x03;
        filter_three = 0x04;
        filter_four = 0x04;
        break;
      case Module_RAHS :
        filter_one = 0x01;
        filter_two = 0x03;
        filter_three = 0x04;
        filter_four = 0x04;
        break;
      default :
        filter_one = 0x01;
        filter_two = 0x03;
        filter_three = 0x04;
        filter_four = 0x04;
  	}
  	setTheFilter(CAN_MASK_0, (uint32_t) 0x1e000000);
   	setTheFilter(CAN_FILTER_0, (uint32_t) 0x00);
   	setTheFilter(CAN_FILTER_1, (uint32_t) 0x00);

   	setTheFilter(CAN_MASK_1, (uint32_t) 0xf0000);
   	setTheFilter(CAN_FILTER_2, (uint32_t) filter_one << 16);
    setTheFilter(CAN_FILTER_3, (uint32_t) filter_two << 16);
    setTheFilter(CAN_FILTER_4, (uint32_t) filter_three << 16);
    setTheFilter(CAN_FILTER_5, (uint32_t) filter_four << 16);
}


void reverseArray(uint8_t arr[], uint8_t start, uint8_t end) {
    uint8_t temp;
    if (start >= end)
        return;
    temp = arr[start];
    arr[start] = arr[end];
    arr[end] = temp;
    reverseArray(arr, start+1, end-1);
}

uint8_t canSendPacket(CANPacket *packet){
    uint8_t tech[5] = {
       (uint8_t) (packet->id >> 21),
       (uint8_t) (packet->id >> 16) & 0x03 | (uint8_t) (packet->id >> 13) & 0xE0 | 0x08,
       (uint8_t) (packet->id >> 8),
       (uint8_t) packet->id,
       packet->length
    };

    const uint8_t bufferAvailability = canTxCheck();
    if (!(canTxCheck() & 0x01)){
        canSend(0, tech, packet->data);
        return 0;
    }
    if (!(canTxCheck() & 0x02)){
        canSend(1, tech, packet->data);
        return 0;
    }
    if (!(canTxCheck() & 0x04)){
        canSend(2, tech, packet->data);
        return 0;
    }
    return 1;
}

void setCANPacketRxCallback(void (*ReceiveCallbackArg)(CANPacket *packet)) {
    CANPacketReceived = ReceiveCallbackArg;
}

// AUTOGEN STUFF HERE

void decodegcmd_reset_i2c(CANPacket *input, gcmd_reset_i2c *output){
    uint64_t *thePointer = (uint64_t *) input -> data;
    reverseArray(input -> data, 0, 7);
    const uint64_t fullData = *thePointer;
}

void encodegcmd_reset_i2c(gcmd_reset_i2c *input, CANPacket *output){
    output -> id = 302252768;
    output -> length = 0;
    uint64_t fullPacketData = 0x0000000000000000;
    uint64_t *thePointer = (uint64_t *) (&(output -> data));
    *thePointer = fullPacketData;
    reverseArray((output->data), 0, 7);
}

void decoderc_adcs_bdot_11(CANPacket *input, rc_adcs_bdot_11 *output){
    uint64_t *thePointer = (uint64_t *) input -> data;
    reverseArray(input -> data, 0, 7);
    const uint64_t fullData = *thePointer;
    output -> rc_adcs_bdot_11_mag_z_var = (uint16_t) (((fullData & ((uint64_t) 0xffff << 16)) >> 16));
    output -> rc_adcs_bdot_11_mag_y_var = (uint16_t) (((fullData & ((uint64_t) 0xffff << 32)) >> 32));
    output -> rc_adcs_bdot_11_mag_x_var = (uint16_t) (((fullData & ((uint64_t) 0xffff << 48)) >> 48));
}

void encoderc_adcs_bdot_11(rc_adcs_bdot_11 *input, CANPacket *output){
    output -> id = 308871796;
    output -> length = 6;
    uint64_t fullPacketData = 0x0000000000000000;
    fullPacketData |= (((uint64_t)((input -> rc_adcs_bdot_11_mag_z_var))) & 0xffff) << 16;
    fullPacketData |= (((uint64_t)((input -> rc_adcs_bdot_11_mag_y_var))) & 0xffff) << 32;
    fullPacketData |= (((uint64_t)((input -> rc_adcs_bdot_11_mag_x_var))) & 0xffff) << 48;
    uint64_t *thePointer = (uint64_t *) (&(output -> data));
    *thePointer = fullPacketData;
    reverseArray((output->data), 0, 7);
}

void decodecom1_mode(CANPacket *input, com1_mode *output){
    uint64_t *thePointer = (uint64_t *) input -> data;
    reverseArray(input -> data, 0, 7);
    const uint64_t fullData = *thePointer;
    output -> com1_mode_mode = (uint8_t) (((fullData & ((uint64_t) 0xff << 56)) >> 56));
}

void encodecom1_mode(com1_mode *input, CANPacket *output){
    output -> id = 302252858;
    output -> length = 1;
    uint64_t fullPacketData = 0x0000000000000000;
    fullPacketData |= (((uint64_t)((input -> com1_mode_mode))) & 0xff) << 56;
    uint64_t *thePointer = (uint64_t *) (&(output -> data));
    *thePointer = fullPacketData;
    reverseArray((output->data), 0, 7);
}

void decodegcmd_com1_mode_camera(CANPacket *input, gcmd_com1_mode_camera *output){
    uint64_t *thePointer = (uint64_t *) input -> data;
    reverseArray(input -> data, 0, 7);
    const uint64_t fullData = *thePointer;
    output -> gcmd_com1_mode_camera_time = (uint8_t) (((fullData & ((uint64_t) 0xff << 56)) >> 56));
}

void encodegcmd_com1_mode_camera(gcmd_com1_mode_camera *input, CANPacket *output){
    output -> id = 302252856;
    output -> length = 1;
    uint64_t fullPacketData = 0x0000000000000000;
    fullPacketData |= (((uint64_t)((input -> gcmd_com1_mode_camera_time))) & 0xff) << 56;
    uint64_t *thePointer = (uint64_t *) (&(output -> data));
    *thePointer = fullPacketData;
    reverseArray((output->data), 0, 7);
}

void decodegcmd_com1_mode_realtime(CANPacket *input, gcmd_com1_mode_realtime *output){
    uint64_t *thePointer = (uint64_t *) input -> data;
    reverseArray(input -> data, 0, 7);
    const uint64_t fullData = *thePointer;
    output -> gcmd_com1_mode_realtime_time = (uint8_t) (((fullData & ((uint64_t) 0xff << 56)) >> 56));
}

void encodegcmd_com1_mode_realtime(gcmd_com1_mode_realtime *input, CANPacket *output){
    output -> id = 302252855;
    output -> length = 1;
    uint64_t fullPacketData = 0x0000000000000000;
    fullPacketData |= (((uint64_t)((input -> gcmd_com1_mode_realtime_time))) & 0xff) << 56;
    uint64_t *thePointer = (uint64_t *) (&(output -> data));
    *thePointer = fullPacketData;
    reverseArray((output->data), 0, 7);
}

void decodegcmd_com1_mode_health(CANPacket *input, gcmd_com1_mode_health *output){
    uint64_t *thePointer = (uint64_t *) input -> data;
    reverseArray(input -> data, 0, 7);
    const uint64_t fullData = *thePointer;
}

void encodegcmd_com1_mode_health(gcmd_com1_mode_health *input, CANPacket *output){
    output -> id = 302252854;
    output -> length = 0;
    uint64_t fullPacketData = 0x0000000000000000;
    uint64_t *thePointer = (uint64_t *) (&(output -> data));
    *thePointer = fullPacketData;
    reverseArray((output->data), 0, 7);
}

void decodegcmd_com1_mode_safe(CANPacket *input, gcmd_com1_mode_safe *output){
    uint64_t *thePointer = (uint64_t *) input -> data;
    reverseArray(input -> data, 0, 7);
    const uint64_t fullData = *thePointer;
}

void encodegcmd_com1_mode_safe(gcmd_com1_mode_safe *input, CANPacket *output){
    output -> id = 302252853;
    output -> length = 0;
    uint64_t fullPacketData = 0x0000000000000000;
    uint64_t *thePointer = (uint64_t *) (&(output -> data));
    *thePointer = fullPacketData;
    reverseArray((output->data), 0, 7);
}

void decodegcmd_com1_transponder_off(CANPacket *input, gcmd_com1_transponder_off *output){
    uint64_t *thePointer = (uint64_t *) input -> data;
    reverseArray(input -> data, 0, 7);
    const uint64_t fullData = *thePointer;
}

void encodegcmd_com1_transponder_off(gcmd_com1_transponder_off *input, CANPacket *output){
    output -> id = 302252852;
    output -> length = 0;
    uint64_t fullPacketData = 0x0000000000000000;
    uint64_t *thePointer = (uint64_t *) (&(output -> data));
    *thePointer = fullPacketData;
    reverseArray((output->data), 0, 7);
}

void decodegcmd_com1_transponder_on(CANPacket *input, gcmd_com1_transponder_on *output){
    uint64_t *thePointer = (uint64_t *) input -> data;
    reverseArray(input -> data, 0, 7);
    const uint64_t fullData = *thePointer;
}

void encodegcmd_com1_transponder_on(gcmd_com1_transponder_on *input, CANPacket *output){
    output -> id = 302252851;
    output -> length = 0;
    uint64_t fullPacketData = 0x0000000000000000;
    uint64_t *thePointer = (uint64_t *) (&(output -> data));
    *thePointer = fullPacketData;
    reverseArray((output->data), 0, 7);
}

void decoderahs_camera(CANPacket *input, rahs_camera *output){
    uint64_t *thePointer = (uint64_t *) input -> data;
    reverseArray(input -> data, 0, 7);
    const uint64_t fullData = *thePointer;
    output -> rahs_camera_data = (uint64_t) (((fullData & ((uint64_t) 0xffffffffffffffff))));
}

void encoderahs_camera(rahs_camera *input, CANPacket *output){
    output -> id = 303563552;
    output -> length = 8;
    uint64_t fullPacketData = 0x0000000000000000;
    fullPacketData |= (((uint64_t)((input -> rahs_camera_data))) & 0xffffffffffffffff);
    uint64_t *thePointer = (uint64_t *) (&(output -> data));
    *thePointer = fullPacketData;
    reverseArray((output->data), 0, 7);
}

void decoderc_eps_gen_10(CANPacket *input, rc_eps_gen_10 *output){
    uint64_t *thePointer = (uint64_t *) input -> data;
    reverseArray(input -> data, 0, 7);
    const uint64_t fullData = *thePointer;
    output -> rc_eps_gen_10_pnl_3_power_avg = (uint16_t) (((fullData & ((uint64_t) 0xffff << 16)) >> 16));
    output -> rc_eps_gen_10_pnl_2_power_avg = (uint16_t) (((fullData & ((uint64_t) 0xffff << 32)) >> 32));
    output -> rc_eps_gen_10_pnl_1_power_avg = (uint16_t) (((fullData & ((uint64_t) 0xffff << 48)) >> 48));
}

void encoderc_eps_gen_10(rc_eps_gen_10 *input, CANPacket *output){
    output -> id = 309920562;
    output -> length = 6;
    uint64_t fullPacketData = 0x0000000000000000;
    fullPacketData |= (((uint64_t)((input -> rc_eps_gen_10_pnl_3_power_avg))) & 0xffff) << 16;
    fullPacketData |= (((uint64_t)((input -> rc_eps_gen_10_pnl_2_power_avg))) & 0xffff) << 32;
    fullPacketData |= (((uint64_t)((input -> rc_eps_gen_10_pnl_1_power_avg))) & 0xffff) << 48;
    uint64_t *thePointer = (uint64_t *) (&(output -> data));
    *thePointer = fullPacketData;
    reverseArray((output->data), 0, 7);
}

void decodegcmd_autoseq_enable(CANPacket *input, gcmd_autoseq_enable *output){
    uint64_t *thePointer = (uint64_t *) input -> data;
    reverseArray(input -> data, 0, 7);
    const uint64_t fullData = *thePointer;
    output -> gcmd_autoseq_enable_enable = (uint8_t) (((fullData & ((uint64_t) 0xff << 56)) >> 56));
}

void encodegcmd_autoseq_enable(gcmd_autoseq_enable *input, CANPacket *output){
    output -> id = 302252849;
    output -> length = 1;
    uint64_t fullPacketData = 0x0000000000000000;
    fullPacketData |= (((uint64_t)((input -> gcmd_autoseq_enable_enable))) & 0xff) << 56;
    uint64_t *thePointer = (uint64_t *) (&(output -> data));
    *thePointer = fullPacketData;
    reverseArray((output->data), 0, 7);
}

void decodegcmd_dist_autoshutoff(CANPacket *input, gcmd_dist_autoshutoff *output){
    uint64_t *thePointer = (uint64_t *) input -> data;
    reverseArray(input -> data, 0, 7);
    const uint64_t fullData = *thePointer;
    output -> gcmd_dist_autoshutoff_ppt = (uint8_t) (((fullData & ((uint64_t) 0x3 << 52)) >> 52));
    output -> gcmd_dist_autoshutoff_eps = (uint8_t) (((fullData & ((uint64_t) 0x3 << 54)) >> 54));
    output -> gcmd_dist_autoshutoff_estim = (uint8_t) (((fullData & ((uint64_t) 0x3 << 56)) >> 56));
    output -> gcmd_dist_autoshutoff_bdot = (uint8_t) (((fullData & ((uint64_t) 0x3 << 58)) >> 58));
    output -> gcmd_dist_autoshutoff_rahs = (uint8_t) (((fullData & ((uint64_t) 0x3 << 60)) >> 60));
    output -> gcmd_dist_autoshutoff_com2 = (uint8_t) (((fullData & ((uint64_t) 0x3 << 62)) >> 62));
}

void encodegcmd_dist_autoshutoff(gcmd_dist_autoshutoff *input, CANPacket *output){
    output -> id = 302252847;
    output -> length = 2;
    uint64_t fullPacketData = 0x0000000000000000;
    fullPacketData |= (((uint64_t)((input -> gcmd_dist_autoshutoff_ppt))) & 0x3) << 52;
    fullPacketData |= (((uint64_t)((input -> gcmd_dist_autoshutoff_eps))) & 0x3) << 54;
    fullPacketData |= (((uint64_t)((input -> gcmd_dist_autoshutoff_estim))) & 0x3) << 56;
    fullPacketData |= (((uint64_t)((input -> gcmd_dist_autoshutoff_bdot))) & 0x3) << 58;
    fullPacketData |= (((uint64_t)((input -> gcmd_dist_autoshutoff_rahs))) & 0x3) << 60;
    fullPacketData |= (((uint64_t)((input -> gcmd_dist_autoshutoff_com2))) & 0x3) << 62;
    uint64_t *thePointer = (uint64_t *) (&(output -> data));
    *thePointer = fullPacketData;
    reverseArray((output->data), 0, 7);
}

void decodegcmd_ppt_halt(CANPacket *input, gcmd_ppt_halt *output){
    uint64_t *thePointer = (uint64_t *) input -> data;
    reverseArray(input -> data, 0, 7);
    const uint64_t fullData = *thePointer;
    output -> gcmd_ppt_halt_confirm = (uint8_t) (((fullData & ((uint64_t) 0x1 << 63)) >> 63));
}

void encodegcmd_ppt_halt(gcmd_ppt_halt *input, CANPacket *output){
    output -> id = 285475076;
    output -> length = 1;
    uint64_t fullPacketData = 0x0000000000000000;
    fullPacketData |= (((uint64_t)((input -> gcmd_ppt_halt_confirm))) & 0x1) << 63;
    uint64_t *thePointer = (uint64_t *) (&(output -> data));
    *thePointer = fullPacketData;
    reverseArray((output->data), 0, 7);
}

void decodegcmd_dist_reset_mission(CANPacket *input, gcmd_dist_reset_mission *output){
    uint64_t *thePointer = (uint64_t *) input -> data;
    reverseArray(input -> data, 0, 7);
    const uint64_t fullData = *thePointer;
}

void encodegcmd_dist_reset_mission(gcmd_dist_reset_mission *input, CANPacket *output){
    output -> id = 302252767;
    output -> length = 0;
    uint64_t fullPacketData = 0x0000000000000000;
    uint64_t *thePointer = (uint64_t *) (&(output -> data));
    *thePointer = fullPacketData;
    reverseArray((output->data), 0, 7);
}

void decodegcmd_dist_self_restart(CANPacket *input, gcmd_dist_self_restart *output){
    uint64_t *thePointer = (uint64_t *) input -> data;
    reverseArray(input -> data, 0, 7);
    const uint64_t fullData = *thePointer;
}

void encodegcmd_dist_self_restart(gcmd_dist_self_restart *input, CANPacket *output){
    output -> id = 302252766;
    output -> length = 0;
    uint64_t fullPacketData = 0x0000000000000000;
    uint64_t *thePointer = (uint64_t *) (&(output -> data));
    *thePointer = fullPacketData;
    reverseArray((output->data), 0, 7);
}

void decoderc_eps_dist_18(CANPacket *input, rc_eps_dist_18 *output){
    uint64_t *thePointer = (uint64_t *) input -> data;
    reverseArray(input -> data, 0, 7);
    const uint64_t fullData = *thePointer;
    output -> rc_eps_dist_18_rahs_ocp_thresh = (uint16_t) (((fullData & ((uint64_t) 0x1ff << 10)) >> 10));
    output -> rc_eps_dist_18_ppt_ocp_thresh = (uint16_t) (((fullData & ((uint64_t) 0x1ff << 19)) >> 19));
    output -> rc_eps_dist_18_estim_ocp_thresh = (uint16_t) (((fullData & ((uint64_t) 0x1ff << 28)) >> 28));
    output -> rc_eps_dist_18_eps_ocp_thresh = (uint16_t) (((fullData & ((uint64_t) 0x1ff << 37)) >> 37));
    output -> rc_eps_dist_18_com2_ocp_thresh = (uint16_t) (((fullData & ((uint64_t) 0x1ff << 46)) >> 46));
    output -> rc_eps_dist_18_bdot_ocp_thresh = (uint16_t) (((fullData & ((uint64_t) 0x1ff << 55)) >> 55));
}

void encoderc_eps_dist_18(rc_eps_dist_18 *input, CANPacket *output){
    output -> id = 307823323;
    output -> length = 7;
    uint64_t fullPacketData = 0x0000000000000000;
    fullPacketData |= (((uint64_t)((input -> rc_eps_dist_18_rahs_ocp_thresh))) & 0x1ff) << 10;
    fullPacketData |= (((uint64_t)((input -> rc_eps_dist_18_ppt_ocp_thresh))) & 0x1ff) << 19;
    fullPacketData |= (((uint64_t)((input -> rc_eps_dist_18_estim_ocp_thresh))) & 0x1ff) << 28;
    fullPacketData |= (((uint64_t)((input -> rc_eps_dist_18_eps_ocp_thresh))) & 0x1ff) << 37;
    fullPacketData |= (((uint64_t)((input -> rc_eps_dist_18_com2_ocp_thresh))) & 0x1ff) << 46;
    fullPacketData |= (((uint64_t)((input -> rc_eps_dist_18_bdot_ocp_thresh))) & 0x1ff) << 55;
    uint64_t *thePointer = (uint64_t *) (&(output -> data));
    *thePointer = fullPacketData;
    reverseArray((output->data), 0, 7);
}

void decoderc_adcs_bdot_10(CANPacket *input, rc_adcs_bdot_10 *output){
    uint64_t *thePointer = (uint64_t *) input -> data;
    reverseArray(input -> data, 0, 7);
    const uint64_t fullData = *thePointer;
    output -> rc_adcs_bdot_10_dipole_var_z = (uint16_t) (((fullData & ((uint64_t) 0xffff << 16)) >> 16));
    output -> rc_adcs_bdot_10_dipole_var_y = (uint16_t) (((fullData & ((uint64_t) 0xffff << 32)) >> 32));
    output -> rc_adcs_bdot_10_dipole_var_x = (uint16_t) (((fullData & ((uint64_t) 0xffff << 48)) >> 48));
}

void encoderc_adcs_bdot_10(rc_adcs_bdot_10 *input, CANPacket *output){
    output -> id = 308871901;
    output -> length = 6;
    uint64_t fullPacketData = 0x0000000000000000;
    fullPacketData |= (((uint64_t)((input -> rc_adcs_bdot_10_dipole_var_z))) & 0xffff) << 16;
    fullPacketData |= (((uint64_t)((input -> rc_adcs_bdot_10_dipole_var_y))) & 0xffff) << 32;
    fullPacketData |= (((uint64_t)((input -> rc_adcs_bdot_10_dipole_var_x))) & 0xffff) << 48;
    uint64_t *thePointer = (uint64_t *) (&(output -> data));
    *thePointer = fullPacketData;
    reverseArray((output->data), 0, 7);
}

void decoderc_adcs_bdot_9(CANPacket *input, rc_adcs_bdot_9 *output){
    uint64_t *thePointer = (uint64_t *) input -> data;
    reverseArray(input -> data, 0, 7);
    const uint64_t fullData = *thePointer;
    output -> rc_adcs_bdot_9_dipole_gain_z = (uint8_t) (((fullData & ((uint64_t) 0xff))));
    output -> rc_adcs_bdot_9_dipole_gain_y = (uint8_t) (((fullData & ((uint64_t) 0xff << 8)) >> 8));
    output -> rc_adcs_bdot_9_spam_off_z_mtq_z = (int16_t) (((fullData & ((uint64_t) 0xffff << 16)) >> 16));
    output -> rc_adcs_bdot_9_spam_off_z_mtq_y = (int16_t) (((fullData & ((uint64_t) 0xffff << 32)) >> 32));
    output -> rc_adcs_bdot_9_spam_off_z_mtq_x = (int16_t) (((fullData & ((uint64_t) 0xffff << 48)) >> 48));
}

void encoderc_adcs_bdot_9(rc_adcs_bdot_9 *input, CANPacket *output){
    output -> id = 308871795;
    output -> length = 8;
    uint64_t fullPacketData = 0x0000000000000000;
    fullPacketData |= (((uint64_t)((input -> rc_adcs_bdot_9_dipole_gain_z))) & 0xff);
    fullPacketData |= (((uint64_t)((input -> rc_adcs_bdot_9_dipole_gain_y))) & 0xff) << 8;
    fullPacketData |= (((uint64_t)((input -> rc_adcs_bdot_9_spam_off_z_mtq_z))) & 0xffff) << 16;
    fullPacketData |= (((uint64_t)((input -> rc_adcs_bdot_9_spam_off_z_mtq_y))) & 0xffff) << 32;
    fullPacketData |= (((uint64_t)((input -> rc_adcs_bdot_9_spam_off_z_mtq_x))) & 0xffff) << 48;
    uint64_t *thePointer = (uint64_t *) (&(output -> data));
    *thePointer = fullPacketData;
    reverseArray((output->data), 0, 7);
}

void decoderc_adcs_bdot_8(CANPacket *input, rc_adcs_bdot_8 *output){
    uint64_t *thePointer = (uint64_t *) input -> data;
    reverseArray(input -> data, 0, 7);
    const uint64_t fullData = *thePointer;
    output -> rc_adcs_bdot_8_spam_off_y_mtq_z = (int16_t) (((fullData & ((uint64_t) 0xffff))));
    output -> rc_adcs_bdot_8_spam_off_y_mtq_y = (int16_t) (((fullData & ((uint64_t) 0xffff << 16)) >> 16));
    output -> rc_adcs_bdot_8_spam_off_y_mtq_x = (int16_t) (((fullData & ((uint64_t) 0xffff << 32)) >> 32));
    output -> rc_adcs_bdot_8_spam_off_x_mtq_z = (int16_t) (((fullData & ((uint64_t) 0xffff << 48)) >> 48));
}

void encoderc_adcs_bdot_8(rc_adcs_bdot_8 *input, CANPacket *output){
    output -> id = 308871794;
    output -> length = 8;
    uint64_t fullPacketData = 0x0000000000000000;
    fullPacketData |= (((uint64_t)((input -> rc_adcs_bdot_8_spam_off_y_mtq_z))) & 0xffff);
    fullPacketData |= (((uint64_t)((input -> rc_adcs_bdot_8_spam_off_y_mtq_y))) & 0xffff) << 16;
    fullPacketData |= (((uint64_t)((input -> rc_adcs_bdot_8_spam_off_y_mtq_x))) & 0xffff) << 32;
    fullPacketData |= (((uint64_t)((input -> rc_adcs_bdot_8_spam_off_x_mtq_z))) & 0xffff) << 48;
    uint64_t *thePointer = (uint64_t *) (&(output -> data));
    *thePointer = fullPacketData;
    reverseArray((output->data), 0, 7);
}

void decodegcmd_batt_set_heater_check(CANPacket *input, gcmd_batt_set_heater_check *output){
    uint64_t *thePointer = (uint64_t *) input -> data;
    reverseArray(input -> data, 0, 7);
    const uint64_t fullData = *thePointer;
    output -> gcmd_batt_set_heater_check_state = (uint8_t) (((fullData & ((uint64_t) 0x3 << 62)) >> 62));
}

void encodegcmd_batt_set_heater_check(gcmd_batt_set_heater_check *input, CANPacket *output){
    output -> id = 301990618;
    output -> length = 1;
    uint64_t fullPacketData = 0x0000000000000000;
    fullPacketData |= (((uint64_t)((input -> gcmd_batt_set_heater_check_state))) & 0x3) << 62;
    uint64_t *thePointer = (uint64_t *) (&(output -> data));
    *thePointer = fullPacketData;
    reverseArray((output->data), 0, 7);
}

void decodeeps_dist_autoseq_get_met_rsp(CANPacket *input, eps_dist_autoseq_get_met_rsp *output){
    uint64_t *thePointer = (uint64_t *) input -> data;
    reverseArray(input -> data, 0, 7);
    const uint64_t fullData = *thePointer;
    output -> eps_dist_autoseq_get_met_rsp_met = (uint32_t) (((fullData & ((uint64_t) 0xffffffff << 32)) >> 32));
}

void encodeeps_dist_autoseq_get_met_rsp(eps_dist_autoseq_get_met_rsp *input, CANPacket *output){
    output -> id = 307233497;
    output -> length = 4;
    uint64_t fullPacketData = 0x0000000000000000;
    fullPacketData |= (((uint64_t)((input -> eps_dist_autoseq_get_met_rsp_met))) & 0xffffffff) << 32;
    uint64_t *thePointer = (uint64_t *) (&(output -> data));
    *thePointer = fullPacketData;
    reverseArray((output->data), 0, 7);
}

void decodeeps_dist_autoseq_get_ind_rsp(CANPacket *input, eps_dist_autoseq_get_ind_rsp *output){
    uint64_t *thePointer = (uint64_t *) input -> data;
    reverseArray(input -> data, 0, 7);
    const uint64_t fullData = *thePointer;
    output -> eps_dist_autoseq_get_ind_rsp_ind = (uint64_t) (((fullData & ((uint64_t) 0xffffffffffffffff))));
}

void encodeeps_dist_autoseq_get_ind_rsp(eps_dist_autoseq_get_ind_rsp *input, CANPacket *output){
    output -> id = 307233496;
    output -> length = 8;
    uint64_t fullPacketData = 0x0000000000000000;
    fullPacketData |= (((uint64_t)((input -> eps_dist_autoseq_get_ind_rsp_ind))) & 0xffffffffffffffff);
    uint64_t *thePointer = (uint64_t *) (&(output -> data));
    *thePointer = fullPacketData;
    reverseArray((output->data), 0, 7);
}

void decodegcmd_autoseq_get_met(CANPacket *input, gcmd_autoseq_get_met *output){
    uint64_t *thePointer = (uint64_t *) input -> data;
    reverseArray(input -> data, 0, 7);
    const uint64_t fullData = *thePointer;
    output -> gcmd_autoseq_get_met_index = (uint8_t) (((fullData & ((uint64_t) 0xff << 56)) >> 56));
}

void encodegcmd_autoseq_get_met(gcmd_autoseq_get_met *input, CANPacket *output){
    output -> id = 302252759;
    output -> length = 1;
    uint64_t fullPacketData = 0x0000000000000000;
    fullPacketData |= (((uint64_t)((input -> gcmd_autoseq_get_met_index))) & 0xff) << 56;
    uint64_t *thePointer = (uint64_t *) (&(output -> data));
    *thePointer = fullPacketData;
    reverseArray((output->data), 0, 7);
}

void decodegcmd_autoseq_get_indices(CANPacket *input, gcmd_autoseq_get_indices *output){
    uint64_t *thePointer = (uint64_t *) input -> data;
    reverseArray(input -> data, 0, 7);
    const uint64_t fullData = *thePointer;
    output -> gcmd_autoseq_get_indices_id = (uint32_t) (((fullData & ((uint64_t) 0x1fffffff << 35)) >> 35));
}

void encodegcmd_autoseq_get_indices(gcmd_autoseq_get_indices *input, CANPacket *output){
    output -> id = 302252758;
    output -> length = 4;
    uint64_t fullPacketData = 0x0000000000000000;
    fullPacketData |= (((uint64_t)((input -> gcmd_autoseq_get_indices_id))) & 0x1fffffff) << 35;
    uint64_t *thePointer = (uint64_t *) (&(output -> data));
    *thePointer = fullPacketData;
    reverseArray((output->data), 0, 7);
}

void decodegcmd_autoseq_remove_can_id(CANPacket *input, gcmd_autoseq_remove_can_id *output){
    uint64_t *thePointer = (uint64_t *) input -> data;
    reverseArray(input -> data, 0, 7);
    const uint64_t fullData = *thePointer;
    output -> gcmd_autoseq_remove_can_id_id = (uint32_t) (((fullData & ((uint64_t) 0x1fffffff << 35)) >> 35));
}

void encodegcmd_autoseq_remove_can_id(gcmd_autoseq_remove_can_id *input, CANPacket *output){
    output -> id = 302252757;
    output -> length = 4;
    uint64_t fullPacketData = 0x0000000000000000;
    fullPacketData |= (((uint64_t)((input -> gcmd_autoseq_remove_can_id_id))) & 0x1fffffff) << 35;
    uint64_t *thePointer = (uint64_t *) (&(output -> data));
    *thePointer = fullPacketData;
    reverseArray((output->data), 0, 7);
}

void decodegcmd_autoseq_rm_at_index(CANPacket *input, gcmd_autoseq_rm_at_index *output){
    uint64_t *thePointer = (uint64_t *) input -> data;
    reverseArray(input -> data, 0, 7);
    const uint64_t fullData = *thePointer;
    output -> gcmd_autoseq_rm_at_index_index = (uint8_t) (((fullData & ((uint64_t) 0xff << 56)) >> 56));
}

void encodegcmd_autoseq_rm_at_index(gcmd_autoseq_rm_at_index *input, CANPacket *output){
    output -> id = 302252756;
    output -> length = 1;
    uint64_t fullPacketData = 0x0000000000000000;
    fullPacketData |= (((uint64_t)((input -> gcmd_autoseq_rm_at_index_index))) & 0xff) << 56;
    uint64_t *thePointer = (uint64_t *) (&(output -> data));
    *thePointer = fullPacketData;
    reverseArray((output->data), 0, 7);
}

void decodegcmd_autoseq_add_2(CANPacket *input, gcmd_autoseq_add_2 *output){
    uint64_t *thePointer = (uint64_t *) input -> data;
    reverseArray(input -> data, 0, 7);
    const uint64_t fullData = *thePointer;
    output -> gcmd_autoseq_add_2_data = (uint64_t) (((fullData & ((uint64_t) 0xffffffffffffffff))));
}

void encodegcmd_autoseq_add_2(gcmd_autoseq_add_2 *input, CANPacket *output){
    output -> id = 302252755;
    output -> length = 8;
    uint64_t fullPacketData = 0x0000000000000000;
    fullPacketData |= (((uint64_t)((input -> gcmd_autoseq_add_2_data))) & 0xffffffffffffffff);
    uint64_t *thePointer = (uint64_t *) (&(output -> data));
    *thePointer = fullPacketData;
    reverseArray((output->data), 0, 7);
}

void decodegcmd_autoseq_add_1(CANPacket *input, gcmd_autoseq_add_1 *output){
    uint64_t *thePointer = (uint64_t *) input -> data;
    reverseArray(input -> data, 0, 7);
    const uint64_t fullData = *thePointer;
    output -> gcmd_autoseq_add_1_sendflg = (uint8_t) (((fullData & ((uint64_t) 0x1 << 2)) >> 2));
    output -> gcmd_autoseq_add_1_met = (uint32_t) (((fullData & ((uint64_t) 0xffffffff << 3)) >> 3));
    output -> gcmd_autoseq_add_1_can_id = (uint32_t) (((fullData & ((uint64_t) 0x1fffffff << 35)) >> 35));
}

void encodegcmd_autoseq_add_1(gcmd_autoseq_add_1 *input, CANPacket *output){
    output -> id = 302252754;
    output -> length = 8;
    uint64_t fullPacketData = 0x0000000000000000;
    fullPacketData |= (((uint64_t)((input -> gcmd_autoseq_add_1_sendflg))) & 0x1) << 2;
    fullPacketData |= (((uint64_t)((input -> gcmd_autoseq_add_1_met))) & 0xffffffff) << 3;
    fullPacketData |= (((uint64_t)((input -> gcmd_autoseq_add_1_can_id))) & 0x1fffffff) << 35;
    uint64_t *thePointer = (uint64_t *) (&(output -> data));
    *thePointer = fullPacketData;
    reverseArray((output->data), 0, 7);
}

void decoderc_adcs_bdot_7(CANPacket *input, rc_adcs_bdot_7 *output){
    uint64_t *thePointer = (uint64_t *) input -> data;
    reverseArray(input -> data, 0, 7);
    const uint64_t fullData = *thePointer;
    output -> rc_adcs_bdot_7_dipole_gain_x = (uint8_t) (((fullData & ((uint64_t) 0xff))));
    output -> rc_adcs_bdot_7_spam_off_x_mtq_y = (int16_t) (((fullData & ((uint64_t) 0xffff << 8)) >> 8));
    output -> rc_adcs_bdot_7_spam_off_x_mtq_x = (int16_t) (((fullData & ((uint64_t) 0xffff << 24)) >> 24));
    output -> rc_adcs_bdot_7_spam_magnitude_z = (int16_t) (((fullData & ((uint64_t) 0xff << 40)) >> 40));
    output -> rc_adcs_bdot_7_spam_magnitude_y = (int16_t) (((fullData & ((uint64_t) 0xff << 48)) >> 48));
    output -> rc_adcs_bdot_7_spam_magnitude_x = (int16_t) (((fullData & ((uint64_t) 0xff << 56)) >> 56));
}

void encoderc_adcs_bdot_7(rc_adcs_bdot_7 *input, CANPacket *output){
    output -> id = 308871793;
    output -> length = 8;
    uint64_t fullPacketData = 0x0000000000000000;
    fullPacketData |= (((uint64_t)((input -> rc_adcs_bdot_7_dipole_gain_x))) & 0xff);
    fullPacketData |= (((uint64_t)((input -> rc_adcs_bdot_7_spam_off_x_mtq_y))) & 0xffff) << 8;
    fullPacketData |= (((uint64_t)((input -> rc_adcs_bdot_7_spam_off_x_mtq_x))) & 0xffff) << 24;
    fullPacketData |= (((uint64_t)((input -> rc_adcs_bdot_7_spam_magnitude_z))) & 0xff) << 40;
    fullPacketData |= (((uint64_t)((input -> rc_adcs_bdot_7_spam_magnitude_y))) & 0xff) << 48;
    fullPacketData |= (((uint64_t)((input -> rc_adcs_bdot_7_spam_magnitude_x))) & 0xff) << 56;
    uint64_t *thePointer = (uint64_t *) (&(output -> data));
    *thePointer = fullPacketData;
    reverseArray((output->data), 0, 7);
}

void decoderc_adcs_bdot_6(CANPacket *input, rc_adcs_bdot_6 *output){
    uint64_t *thePointer = (uint64_t *) input -> data;
    reverseArray(input -> data, 0, 7);
    const uint64_t fullData = *thePointer;
    output -> rc_adcs_bdot_6_spam_on_time = (uint16_t) (((fullData & ((uint64_t) 0xffff << 32)) >> 32));
    output -> rc_adcs_bdot_6_spam_off_time = (uint16_t) (((fullData & ((uint64_t) 0xffff << 48)) >> 48));
    output -> rc_adcs_bdot_6_spam_control = (uint8_t) (((fullData & ((uint64_t) 0x1 << 31)) >> 31));
    output -> rc_adcs_bdot_6_pop_status_z = (uint8_t) (((fullData & ((uint64_t) 0x1 << 10)) >> 10));
    output -> rc_adcs_bdot_6_pop_status_y = (uint8_t) (((fullData & ((uint64_t) 0x1 << 11)) >> 11));
    output -> rc_adcs_bdot_6_pop_status_x = (uint8_t) (((fullData & ((uint64_t) 0x1 << 12)) >> 12));
    output -> rc_adcs_bdot_6_max_tumble_time = (uint16_t) (((fullData & ((uint64_t) 0xffff << 15)) >> 15));
    output -> rc_adcs_bdot_6_mag_control = (uint8_t) (((fullData & ((uint64_t) 0x3 << 5)) >> 5));
    output -> rc_adcs_bdot_6_gain_ovr_status_z = (uint8_t) (((fullData & ((uint64_t) 0x1 << 7)) >> 7));
    output -> rc_adcs_bdot_6_gain_ovr_status_y = (uint8_t) (((fullData & ((uint64_t) 0x1 << 8)) >> 8));
    output -> rc_adcs_bdot_6_gain_ovr_status_x = (uint8_t) (((fullData & ((uint64_t) 0x1 << 9)) >> 9));
    output -> rc_adcs_bdot_6_current_state = (uint8_t) (((fullData & ((uint64_t) 0x3 << 13)) >> 13));
}

void encoderc_adcs_bdot_6(rc_adcs_bdot_6 *input, CANPacket *output){
    output -> id = 307823216;
    output -> length = 8;
    uint64_t fullPacketData = 0x0000000000000000;
    fullPacketData |= (((uint64_t)((input -> rc_adcs_bdot_6_spam_on_time))) & 0xffff) << 32;
    fullPacketData |= (((uint64_t)((input -> rc_adcs_bdot_6_spam_off_time))) & 0xffff) << 48;
    fullPacketData |= (((uint64_t)((input -> rc_adcs_bdot_6_spam_control))) & 0x1) << 31;
    fullPacketData |= (((uint64_t)((input -> rc_adcs_bdot_6_pop_status_z))) & 0x1) << 10;
    fullPacketData |= (((uint64_t)((input -> rc_adcs_bdot_6_pop_status_y))) & 0x1) << 11;
    fullPacketData |= (((uint64_t)((input -> rc_adcs_bdot_6_pop_status_x))) & 0x1) << 12;
    fullPacketData |= (((uint64_t)((input -> rc_adcs_bdot_6_max_tumble_time))) & 0xffff) << 15;
    fullPacketData |= (((uint64_t)((input -> rc_adcs_bdot_6_mag_control))) & 0x3) << 5;
    fullPacketData |= (((uint64_t)((input -> rc_adcs_bdot_6_gain_ovr_status_z))) & 0x1) << 7;
    fullPacketData |= (((uint64_t)((input -> rc_adcs_bdot_6_gain_ovr_status_y))) & 0x1) << 8;
    fullPacketData |= (((uint64_t)((input -> rc_adcs_bdot_6_gain_ovr_status_x))) & 0x1) << 9;
    fullPacketData |= (((uint64_t)((input -> rc_adcs_bdot_6_current_state))) & 0x3) << 13;
    uint64_t *thePointer = (uint64_t *) (&(output -> data));
    *thePointer = fullPacketData;
    reverseArray((output->data), 0, 7);
}

void decodegcmd_ppt_multiple_fire(CANPacket *input, gcmd_ppt_multiple_fire *output){
    uint64_t *thePointer = (uint64_t *) input -> data;
    reverseArray(input -> data, 0, 7);
    const uint64_t fullData = *thePointer;
    output -> gcmd_ppt_multiple_fire_override = (uint8_t) (((fullData & ((uint64_t) 0x1 << 55)) >> 55));
    output -> gcmd_ppt_multiple_fire_count = (uint8_t) (((fullData & ((uint64_t) 0xff << 56)) >> 56));
}

void encodegcmd_ppt_multiple_fire(gcmd_ppt_multiple_fire *input, CANPacket *output){
    output -> id = 302252753;
    output -> length = 2;
    uint64_t fullPacketData = 0x0000000000000000;
    fullPacketData |= (((uint64_t)((input -> gcmd_ppt_multiple_fire_override))) & 0x1) << 55;
    fullPacketData |= (((uint64_t)((input -> gcmd_ppt_multiple_fire_count))) & 0xff) << 56;
    uint64_t *thePointer = (uint64_t *) (&(output -> data));
    *thePointer = fullPacketData;
    reverseArray((output->data), 0, 7);
}

void decodegcmd_mtq_pwm_time(CANPacket *input, gcmd_mtq_pwm_time *output){
    uint64_t *thePointer = (uint64_t *) input -> data;
    reverseArray(input -> data, 0, 7);
    const uint64_t fullData = *thePointer;
    output -> gcmd_mtq_pwm_time_measurement = (uint8_t) (((fullData & ((uint64_t) 0xff << 48)) >> 48));
    output -> gcmd_mtq_pwm_time_actuation = (uint8_t) (((fullData & ((uint64_t) 0xff << 56)) >> 56));
}

void encodegcmd_mtq_pwm_time(gcmd_mtq_pwm_time *input, CANPacket *output){
    output -> id = 302252752;
    output -> length = 2;
    uint64_t fullPacketData = 0x0000000000000000;
    fullPacketData |= (((uint64_t)((input -> gcmd_mtq_pwm_time_measurement))) & 0xff) << 48;
    fullPacketData |= (((uint64_t)((input -> gcmd_mtq_pwm_time_actuation))) & 0xff) << 56;
    uint64_t *thePointer = (uint64_t *) (&(output -> data));
    *thePointer = fullPacketData;
    reverseArray((output->data), 0, 7);
}

void decodegcmd_eps_batt_fulldef(CANPacket *input, gcmd_eps_batt_fulldef *output){
    uint64_t *thePointer = (uint64_t *) input -> data;
    reverseArray(input -> data, 0, 7);
    const uint64_t fullData = *thePointer;
    uint32_t tempgcmd_eps_batt_fulldef_const_volt = (uint32_t) ((fullData & ((uint64_t) 0xffffffff << 32)) >> 32);
    output -> gcmd_eps_batt_fulldef_const_volt = (*((float *)(&(tempgcmd_eps_batt_fulldef_const_volt))));
    uint32_t tempgcmd_eps_batt_fulldef_chg_curr = (uint32_t) ((fullData & ((uint64_t) 0xffffffff)));
    output -> gcmd_eps_batt_fulldef_chg_curr = (*((float *)(&(tempgcmd_eps_batt_fulldef_chg_curr))));
}

void encodegcmd_eps_batt_fulldef(gcmd_eps_batt_fulldef *input, CANPacket *output){
    output -> id = 302252751;
    output -> length = 8;
    uint64_t fullPacketData = 0x0000000000000000;
    const float tempgcmd_eps_batt_fulldef_const_volt = ((input -> gcmd_eps_batt_fulldef_const_volt));
    fullPacketData |= ((uint64_t)(*((uint32_t *)(&(tempgcmd_eps_batt_fulldef_const_volt))))) << 32;
    const float tempgcmd_eps_batt_fulldef_chg_curr = ((input -> gcmd_eps_batt_fulldef_chg_curr));
    fullPacketData |= ((uint64_t)(*((uint32_t *)(&(tempgcmd_eps_batt_fulldef_chg_curr)))));
    uint64_t *thePointer = (uint64_t *) (&(output -> data));
    *thePointer = fullPacketData;
    reverseArray((output->data), 0, 7);
}

void decoderc_adcs_bdot_5(CANPacket *input, rc_adcs_bdot_5 *output){
    uint64_t *thePointer = (uint64_t *) input -> data;
    reverseArray(input -> data, 0, 7);
    const uint64_t fullData = *thePointer;
    output -> rc_adcs_bdot_5_spam_on_z_mtq_z = (int16_t) (((fullData & ((uint64_t) 0xffff << 16)) >> 16));
    output -> rc_adcs_bdot_5_spam_on_z_mtq_y = (int16_t) (((fullData & ((uint64_t) 0xffff << 32)) >> 32));
    output -> rc_adcs_bdot_5_spam_on_z_mtq_x = (int16_t) (((fullData & ((uint64_t) 0xffff << 48)) >> 48));
}

void encoderc_adcs_bdot_5(rc_adcs_bdot_5 *input, CANPacket *output){
    output -> id = 307823196;
    output -> length = 6;
    uint64_t fullPacketData = 0x0000000000000000;
    fullPacketData |= (((uint64_t)((input -> rc_adcs_bdot_5_spam_on_z_mtq_z))) & 0xffff) << 16;
    fullPacketData |= (((uint64_t)((input -> rc_adcs_bdot_5_spam_on_z_mtq_y))) & 0xffff) << 32;
    fullPacketData |= (((uint64_t)((input -> rc_adcs_bdot_5_spam_on_z_mtq_x))) & 0xffff) << 48;
    uint64_t *thePointer = (uint64_t *) (&(output -> data));
    *thePointer = fullPacketData;
    reverseArray((output->data), 0, 7);
}

void decodegcmd_reset_minmax(CANPacket *input, gcmd_reset_minmax *output){
    uint64_t *thePointer = (uint64_t *) input -> data;
    reverseArray(input -> data, 0, 7);
    const uint64_t fullData = *thePointer;
    output -> gcmd_reset_minmax_mtq = (uint8_t) (((fullData & ((uint64_t) 0x1 << 55)) >> 55));
    output -> gcmd_reset_minmax_sensorproc = (uint8_t) (((fullData & ((uint64_t) 0x1 << 56)) >> 56));
    output -> gcmd_reset_minmax_mpc = (uint8_t) (((fullData & ((uint64_t) 0x1 << 57)) >> 57));
    output -> gcmd_reset_minmax_estim = (uint8_t) (((fullData & ((uint64_t) 0x1 << 58)) >> 58));
    output -> gcmd_reset_minmax_batt = (uint8_t) (((fullData & ((uint64_t) 0x1 << 59)) >> 59));
    output -> gcmd_reset_minmax_gen = (uint8_t) (((fullData & ((uint64_t) 0x1 << 60)) >> 60));
    output -> gcmd_reset_minmax_dist = (uint8_t) (((fullData & ((uint64_t) 0x1 << 61)) >> 61));
    output -> gcmd_reset_minmax_ppt = (uint8_t) (((fullData & ((uint64_t) 0x1 << 62)) >> 62));
    output -> gcmd_reset_minmax_bdot = (uint8_t) (((fullData & ((uint64_t) 0x1 << 63)) >> 63));
}

void encodegcmd_reset_minmax(gcmd_reset_minmax *input, CANPacket *output){
    output -> id = 302252750;
    output -> length = 2;
    uint64_t fullPacketData = 0x0000000000000000;
    fullPacketData |= (((uint64_t)((input -> gcmd_reset_minmax_mtq))) & 0x1) << 55;
    fullPacketData |= (((uint64_t)((input -> gcmd_reset_minmax_sensorproc))) & 0x1) << 56;
    fullPacketData |= (((uint64_t)((input -> gcmd_reset_minmax_mpc))) & 0x1) << 57;
    fullPacketData |= (((uint64_t)((input -> gcmd_reset_minmax_estim))) & 0x1) << 58;
    fullPacketData |= (((uint64_t)((input -> gcmd_reset_minmax_batt))) & 0x1) << 59;
    fullPacketData |= (((uint64_t)((input -> gcmd_reset_minmax_gen))) & 0x1) << 60;
    fullPacketData |= (((uint64_t)((input -> gcmd_reset_minmax_dist))) & 0x1) << 61;
    fullPacketData |= (((uint64_t)((input -> gcmd_reset_minmax_ppt))) & 0x1) << 62;
    fullPacketData |= (((uint64_t)((input -> gcmd_reset_minmax_bdot))) & 0x1) << 63;
    uint64_t *thePointer = (uint64_t *) (&(output -> data));
    *thePointer = fullPacketData;
    reverseArray((output->data), 0, 7);
}

void decoderc_eps_batt_h2(CANPacket *input, rc_eps_batt_h2 *output){
    uint64_t *thePointer = (uint64_t *) input -> data;
    reverseArray(input -> data, 0, 7);
    const uint64_t fullData = *thePointer;
    output -> rc_eps_batt_h2_last_i2c_res = (uint8_t) (((fullData & ((uint64_t) 0xff << 48)) >> 48));
    output -> rc_eps_batt_h2_canrxerror = (uint8_t) (((fullData & ((uint64_t) 0xff << 56)) >> 56));
}

void encoderc_eps_batt_h2(rc_eps_batt_h2 *input, CANPacket *output){
    output -> id = 308871790;
    output -> length = 2;
    uint64_t fullPacketData = 0x0000000000000000;
    fullPacketData |= (((uint64_t)((input -> rc_eps_batt_h2_last_i2c_res))) & 0xff) << 48;
    fullPacketData |= (((uint64_t)((input -> rc_eps_batt_h2_canrxerror))) & 0xff) << 56;
    uint64_t *thePointer = (uint64_t *) (&(output -> data));
    *thePointer = fullPacketData;
    reverseArray((output->data), 0, 7);
}

void decoderc_adcs_bdot_h2(CANPacket *input, rc_adcs_bdot_h2 *output){
    uint64_t *thePointer = (uint64_t *) input -> data;
    reverseArray(input -> data, 0, 7);
    const uint64_t fullData = *thePointer;
    output -> rc_adcs_bdot_h2_canrxerror = (uint8_t) (((fullData & ((uint64_t) 0xff << 56)) >> 56));
}

void encoderc_adcs_bdot_h2(rc_adcs_bdot_h2 *input, CANPacket *output){
    output -> id = 308871789;
    output -> length = 1;
    uint64_t fullPacketData = 0x0000000000000000;
    fullPacketData |= (((uint64_t)((input -> rc_adcs_bdot_h2_canrxerror))) & 0xff) << 56;
    uint64_t *thePointer = (uint64_t *) (&(output -> data));
    *thePointer = fullPacketData;
    reverseArray((output->data), 0, 7);
}

void decoderc_eps_dist_h2(CANPacket *input, rc_eps_dist_h2 *output){
    uint64_t *thePointer = (uint64_t *) input -> data;
    reverseArray(input -> data, 0, 7);
    const uint64_t fullData = *thePointer;
    output -> rc_eps_dist_h2_canrxerror = (uint8_t) (((fullData & ((uint64_t) 0xff << 56)) >> 56));
}

void encoderc_eps_dist_h2(rc_eps_dist_h2 *input, CANPacket *output){
    output -> id = 308871788;
    output -> length = 1;
    uint64_t fullPacketData = 0x0000000000000000;
    fullPacketData |= (((uint64_t)((input -> rc_eps_dist_h2_canrxerror))) & 0xff) << 56;
    uint64_t *thePointer = (uint64_t *) (&(output -> data));
    *thePointer = fullPacketData;
    reverseArray((output->data), 0, 7);
}

void decoderc_adcs_mpc_h2(CANPacket *input, rc_adcs_mpc_h2 *output){
    uint64_t *thePointer = (uint64_t *) input -> data;
    reverseArray(input -> data, 0, 7);
    const uint64_t fullData = *thePointer;
    output -> rc_adcs_mpc_h2_canrxerror = (uint8_t) (((fullData & ((uint64_t) 0xff << 56)) >> 56));
}

void encoderc_adcs_mpc_h2(rc_adcs_mpc_h2 *input, CANPacket *output){
    output -> id = 308871787;
    output -> length = 8;
    uint64_t fullPacketData = 0x0000000000000000;
    fullPacketData |= (((uint64_t)((input -> rc_adcs_mpc_h2_canrxerror))) & 0xff) << 56;
    uint64_t *thePointer = (uint64_t *) (&(output -> data));
    *thePointer = fullPacketData;
    reverseArray((output->data), 0, 7);
}

void decoderc_adcs_estim_h2(CANPacket *input, rc_adcs_estim_h2 *output){
    uint64_t *thePointer = (uint64_t *) input -> data;
    reverseArray(input -> data, 0, 7);
    const uint64_t fullData = *thePointer;
    output -> rc_adcs_estim_h2_canrxerror = (uint8_t) (((fullData & ((uint64_t) 0xff << 56)) >> 56));
}

void encoderc_adcs_estim_h2(rc_adcs_estim_h2 *input, CANPacket *output){
    output -> id = 307823210;
    output -> length = 1;
    uint64_t fullPacketData = 0x0000000000000000;
    fullPacketData |= (((uint64_t)((input -> rc_adcs_estim_h2_canrxerror))) & 0xff) << 56;
    uint64_t *thePointer = (uint64_t *) (&(output -> data));
    *thePointer = fullPacketData;
    reverseArray((output->data), 0, 7);
}

void decoderc_eps_gen_h2(CANPacket *input, rc_eps_gen_h2 *output){
    uint64_t *thePointer = (uint64_t *) input -> data;
    reverseArray(input -> data, 0, 7);
    const uint64_t fullData = *thePointer;
    output -> rc_eps_gen_h2_canrxerror = (uint8_t) (((fullData & ((uint64_t) 0xff << 56)) >> 56));
}

void encoderc_eps_gen_h2(rc_eps_gen_h2 *input, CANPacket *output){
    output -> id = 308871784;
    output -> length = 8;
    uint64_t fullPacketData = 0x0000000000000000;
    fullPacketData |= (((uint64_t)((input -> rc_eps_gen_h2_canrxerror))) & 0xff) << 56;
    uint64_t *thePointer = (uint64_t *) (&(output -> data));
    *thePointer = fullPacketData;
    reverseArray((output->data), 0, 7);
}

void decoderc_adcs_mtq_h2(CANPacket *input, rc_adcs_mtq_h2 *output){
    uint64_t *thePointer = (uint64_t *) input -> data;
    reverseArray(input -> data, 0, 7);
    const uint64_t fullData = *thePointer;
    output -> rc_adcs_mtq_h2_canrxerror = (uint8_t) (((fullData & ((uint64_t) 0xff << 56)) >> 56));
}

void encoderc_adcs_mtq_h2(rc_adcs_mtq_h2 *input, CANPacket *output){
    output -> id = 308871783;
    output -> length = 1;
    uint64_t fullPacketData = 0x0000000000000000;
    fullPacketData |= (((uint64_t)((input -> rc_adcs_mtq_h2_canrxerror))) & 0xff) << 56;
    uint64_t *thePointer = (uint64_t *) (&(output -> data));
    *thePointer = fullPacketData;
    reverseArray((output->data), 0, 7);
}

void decoderc_ppt_h2(CANPacket *input, rc_ppt_h2 *output){
    uint64_t *thePointer = (uint64_t *) input -> data;
    reverseArray(input -> data, 0, 7);
    const uint64_t fullData = *thePointer;
    output -> rc_ppt_h2_last_fire_result = (uint8_t) (((fullData & ((uint64_t) 0x3 << 54)) >> 54));
    output -> rc_ppt_h2_canrxerror = (uint8_t) (((fullData & ((uint64_t) 0xff << 56)) >> 56));
}

void encoderc_ppt_h2(rc_ppt_h2 *input, CANPacket *output){
    output -> id = 308871782;
    output -> length = 2;
    uint64_t fullPacketData = 0x0000000000000000;
    fullPacketData |= (((uint64_t)((input -> rc_ppt_h2_last_fire_result))) & 0x3) << 54;
    fullPacketData |= (((uint64_t)((input -> rc_ppt_h2_canrxerror))) & 0xff) << 56;
    uint64_t *thePointer = (uint64_t *) (&(output -> data));
    *thePointer = fullPacketData;
    reverseArray((output->data), 0, 7);
}

void decoderc_eps_batt_h1(CANPacket *input, rc_eps_batt_h1 *output){
    uint64_t *thePointer = (uint64_t *) input -> data;
    reverseArray(input -> data, 0, 7);
    const uint64_t fullData = *thePointer;
    output -> rc_eps_batt_h1_temp_min = (int16_t) (((fullData & ((uint64_t) 0xffff << 48)) >> 48));
    output -> rc_eps_batt_h1_temp_max = (int16_t) (((fullData & ((uint64_t) 0xffff << 32)) >> 32));
    output -> rc_eps_batt_h1_temp_avg = (int16_t) (((fullData & ((uint64_t) 0xffff << 16)) >> 16));
    output -> rc_eps_batt_h1_sysrstiv = (uint8_t) (((fullData & ((uint64_t) 0xff << 8)) >> 8));
    output -> rc_eps_batt_h1_reset_count = (uint8_t) (((fullData & ((uint64_t) 0xff))));
}

void encoderc_eps_batt_h1(rc_eps_batt_h1 *input, CANPacket *output){
    output -> id = 308871781;
    output -> length = 8;
    uint64_t fullPacketData = 0x0000000000000000;
    fullPacketData |= (((uint64_t)((input -> rc_eps_batt_h1_temp_min))) & 0xffff) << 48;
    fullPacketData |= (((uint64_t)((input -> rc_eps_batt_h1_temp_max))) & 0xffff) << 32;
    fullPacketData |= (((uint64_t)((input -> rc_eps_batt_h1_temp_avg))) & 0xffff) << 16;
    fullPacketData |= (((uint64_t)((input -> rc_eps_batt_h1_sysrstiv))) & 0xff) << 8;
    fullPacketData |= (((uint64_t)((input -> rc_eps_batt_h1_reset_count))) & 0xff);
    uint64_t *thePointer = (uint64_t *) (&(output -> data));
    *thePointer = fullPacketData;
    reverseArray((output->data), 0, 7);
}

void decoderc_adcs_bdot_h1(CANPacket *input, rc_adcs_bdot_h1 *output){
    uint64_t *thePointer = (uint64_t *) input -> data;
    reverseArray(input -> data, 0, 7);
    const uint64_t fullData = *thePointer;
    output -> rc_adcs_bdot_h1_temp_min = (int16_t) (((fullData & ((uint64_t) 0xffff << 48)) >> 48));
    output -> rc_adcs_bdot_h1_temp_max = (int16_t) (((fullData & ((uint64_t) 0xffff << 32)) >> 32));
    output -> rc_adcs_bdot_h1_temp_avg = (int16_t) (((fullData & ((uint64_t) 0xffff << 16)) >> 16));
    output -> rc_adcs_bdot_h1_sysrstiv = (uint8_t) (((fullData & ((uint64_t) 0xff << 8)) >> 8));
    output -> rc_adcs_bdot_h1_reset_count = (uint8_t) (((fullData & ((uint64_t) 0xff))));
}

void encoderc_adcs_bdot_h1(rc_adcs_bdot_h1 *input, CANPacket *output){
    output -> id = 308871780;
    output -> length = 8;
    uint64_t fullPacketData = 0x0000000000000000;
    fullPacketData |= (((uint64_t)((input -> rc_adcs_bdot_h1_temp_min))) & 0xffff) << 48;
    fullPacketData |= (((uint64_t)((input -> rc_adcs_bdot_h1_temp_max))) & 0xffff) << 32;
    fullPacketData |= (((uint64_t)((input -> rc_adcs_bdot_h1_temp_avg))) & 0xffff) << 16;
    fullPacketData |= (((uint64_t)((input -> rc_adcs_bdot_h1_sysrstiv))) & 0xff) << 8;
    fullPacketData |= (((uint64_t)((input -> rc_adcs_bdot_h1_reset_count))) & 0xff);
    uint64_t *thePointer = (uint64_t *) (&(output -> data));
    *thePointer = fullPacketData;
    reverseArray((output->data), 0, 7);
}

void decoderc_eps_dist_h1(CANPacket *input, rc_eps_dist_h1 *output){
    uint64_t *thePointer = (uint64_t *) input -> data;
    reverseArray(input -> data, 0, 7);
    const uint64_t fullData = *thePointer;
    output -> rc_eps_dist_h1_temp_min = (int16_t) (((fullData & ((uint64_t) 0xffff << 48)) >> 48));
    output -> rc_eps_dist_h1_temp_max = (int16_t) (((fullData & ((uint64_t) 0xffff << 32)) >> 32));
    output -> rc_eps_dist_h1_temp_avg = (int16_t) (((fullData & ((uint64_t) 0xffff << 16)) >> 16));
    output -> rc_eps_dist_h1_sysrstiv = (uint8_t) (((fullData & ((uint64_t) 0xff << 8)) >> 8));
    output -> rc_eps_dist_h1_reset_count = (uint8_t) (((fullData & ((uint64_t) 0xff))));
}

void encoderc_eps_dist_h1(rc_eps_dist_h1 *input, CANPacket *output){
    output -> id = 308871779;
    output -> length = 8;
    uint64_t fullPacketData = 0x0000000000000000;
    fullPacketData |= (((uint64_t)((input -> rc_eps_dist_h1_temp_min))) & 0xffff) << 48;
    fullPacketData |= (((uint64_t)((input -> rc_eps_dist_h1_temp_max))) & 0xffff) << 32;
    fullPacketData |= (((uint64_t)((input -> rc_eps_dist_h1_temp_avg))) & 0xffff) << 16;
    fullPacketData |= (((uint64_t)((input -> rc_eps_dist_h1_sysrstiv))) & 0xff) << 8;
    fullPacketData |= (((uint64_t)((input -> rc_eps_dist_h1_reset_count))) & 0xff);
    uint64_t *thePointer = (uint64_t *) (&(output -> data));
    *thePointer = fullPacketData;
    reverseArray((output->data), 0, 7);
}

void decoderc_adcs_mpc_h1(CANPacket *input, rc_adcs_mpc_h1 *output){
    uint64_t *thePointer = (uint64_t *) input -> data;
    reverseArray(input -> data, 0, 7);
    const uint64_t fullData = *thePointer;
    output -> rc_adcs_mpc_h1_temp_min = (int16_t) (((fullData & ((uint64_t) 0xffff << 48)) >> 48));
    output -> rc_adcs_mpc_h1_temp_max = (int16_t) (((fullData & ((uint64_t) 0xffff << 32)) >> 32));
    output -> rc_adcs_mpc_h1_temp_avg = (int16_t) (((fullData & ((uint64_t) 0xffff << 16)) >> 16));
    output -> rc_adcs_mpc_h1_sysrstiv = (uint8_t) (((fullData & ((uint64_t) 0xff << 8)) >> 8));
    output -> rc_adcs_mpc_h1_reset_count = (uint8_t) (((fullData & ((uint64_t) 0xff))));
}

void encoderc_adcs_mpc_h1(rc_adcs_mpc_h1 *input, CANPacket *output){
    output -> id = 308871778;
    output -> length = 8;
    uint64_t fullPacketData = 0x0000000000000000;
    fullPacketData |= (((uint64_t)((input -> rc_adcs_mpc_h1_temp_min))) & 0xffff) << 48;
    fullPacketData |= (((uint64_t)((input -> rc_adcs_mpc_h1_temp_max))) & 0xffff) << 32;
    fullPacketData |= (((uint64_t)((input -> rc_adcs_mpc_h1_temp_avg))) & 0xffff) << 16;
    fullPacketData |= (((uint64_t)((input -> rc_adcs_mpc_h1_sysrstiv))) & 0xff) << 8;
    fullPacketData |= (((uint64_t)((input -> rc_adcs_mpc_h1_reset_count))) & 0xff);
    uint64_t *thePointer = (uint64_t *) (&(output -> data));
    *thePointer = fullPacketData;
    reverseArray((output->data), 0, 7);
}

void decoderc_adcs_estim_h1(CANPacket *input, rc_adcs_estim_h1 *output){
    uint64_t *thePointer = (uint64_t *) input -> data;
    reverseArray(input -> data, 0, 7);
    const uint64_t fullData = *thePointer;
    output -> rc_adcs_estim_h1_temp_min = (int16_t) (((fullData & ((uint64_t) 0xffff << 48)) >> 48));
    output -> rc_adcs_estim_h1_temp_max = (int16_t) (((fullData & ((uint64_t) 0xffff << 32)) >> 32));
    output -> rc_adcs_estim_h1_temp_avg = (int16_t) (((fullData & ((uint64_t) 0xffff << 16)) >> 16));
    output -> rc_adcs_estim_h1_sysrstiv = (uint8_t) (((fullData & ((uint64_t) 0xff << 8)) >> 8));
    output -> rc_adcs_estim_h1_reset_count = (uint8_t) (((fullData & ((uint64_t) 0xff))));
}

void encoderc_adcs_estim_h1(rc_adcs_estim_h1 *input, CANPacket *output){
    output -> id = 307823201;
    output -> length = 8;
    uint64_t fullPacketData = 0x0000000000000000;
    fullPacketData |= (((uint64_t)((input -> rc_adcs_estim_h1_temp_min))) & 0xffff) << 48;
    fullPacketData |= (((uint64_t)((input -> rc_adcs_estim_h1_temp_max))) & 0xffff) << 32;
    fullPacketData |= (((uint64_t)((input -> rc_adcs_estim_h1_temp_avg))) & 0xffff) << 16;
    fullPacketData |= (((uint64_t)((input -> rc_adcs_estim_h1_sysrstiv))) & 0xff) << 8;
    fullPacketData |= (((uint64_t)((input -> rc_adcs_estim_h1_reset_count))) & 0xff);
    uint64_t *thePointer = (uint64_t *) (&(output -> data));
    *thePointer = fullPacketData;
    reverseArray((output->data), 0, 7);
}

void decoderc_adcs_sp_h1(CANPacket *input, rc_adcs_sp_h1 *output){
    uint64_t *thePointer = (uint64_t *) input -> data;
    reverseArray(input -> data, 0, 7);
    const uint64_t fullData = *thePointer;
    output -> rc_adcs_sp_h1_temp_min = (int16_t) (((fullData & ((uint64_t) 0xffff << 48)) >> 48));
    output -> rc_adcs_sp_h1_temp_max = (int16_t) (((fullData & ((uint64_t) 0xffff << 32)) >> 32));
    output -> rc_adcs_sp_h1_temp_avg = (int16_t) (((fullData & ((uint64_t) 0xffff << 16)) >> 16));
    output -> rc_adcs_sp_h1_sysrstiv = (uint8_t) (((fullData & ((uint64_t) 0xff << 8)) >> 8));
    output -> rc_adcs_sp_h1_reset_count = (uint8_t) (((fullData & ((uint64_t) 0xff))));
}

void encoderc_adcs_sp_h1(rc_adcs_sp_h1 *input, CANPacket *output){
    output -> id = 308871776;
    output -> length = 8;
    uint64_t fullPacketData = 0x0000000000000000;
    fullPacketData |= (((uint64_t)((input -> rc_adcs_sp_h1_temp_min))) & 0xffff) << 48;
    fullPacketData |= (((uint64_t)((input -> rc_adcs_sp_h1_temp_max))) & 0xffff) << 32;
    fullPacketData |= (((uint64_t)((input -> rc_adcs_sp_h1_temp_avg))) & 0xffff) << 16;
    fullPacketData |= (((uint64_t)((input -> rc_adcs_sp_h1_sysrstiv))) & 0xff) << 8;
    fullPacketData |= (((uint64_t)((input -> rc_adcs_sp_h1_reset_count))) & 0xff);
    uint64_t *thePointer = (uint64_t *) (&(output -> data));
    *thePointer = fullPacketData;
    reverseArray((output->data), 0, 7);
}

void decoderc_eps_gen_h1(CANPacket *input, rc_eps_gen_h1 *output){
    uint64_t *thePointer = (uint64_t *) input -> data;
    reverseArray(input -> data, 0, 7);
    const uint64_t fullData = *thePointer;
    output -> rc_eps_gen_h1_temp_min = (int16_t) (((fullData & ((uint64_t) 0xffff << 48)) >> 48));
    output -> rc_eps_gen_h1_temp_max = (int16_t) (((fullData & ((uint64_t) 0xffff << 32)) >> 32));
    output -> rc_eps_gen_h1_temp_avg = (int16_t) (((fullData & ((uint64_t) 0xffff << 16)) >> 16));
    output -> rc_eps_gen_h1_sysrstiv = (uint8_t) (((fullData & ((uint64_t) 0xff << 8)) >> 8));
    output -> rc_eps_gen_h1_reset_count = (uint8_t) (((fullData & ((uint64_t) 0xff))));
}

void encoderc_eps_gen_h1(rc_eps_gen_h1 *input, CANPacket *output){
    output -> id = 308871775;
    output -> length = 8;
    uint64_t fullPacketData = 0x0000000000000000;
    fullPacketData |= (((uint64_t)((input -> rc_eps_gen_h1_temp_min))) & 0xffff) << 48;
    fullPacketData |= (((uint64_t)((input -> rc_eps_gen_h1_temp_max))) & 0xffff) << 32;
    fullPacketData |= (((uint64_t)((input -> rc_eps_gen_h1_temp_avg))) & 0xffff) << 16;
    fullPacketData |= (((uint64_t)((input -> rc_eps_gen_h1_sysrstiv))) & 0xff) << 8;
    fullPacketData |= (((uint64_t)((input -> rc_eps_gen_h1_reset_count))) & 0xff);
    uint64_t *thePointer = (uint64_t *) (&(output -> data));
    *thePointer = fullPacketData;
    reverseArray((output->data), 0, 7);
}

void decoderc_adcs_mtq_h1(CANPacket *input, rc_adcs_mtq_h1 *output){
    uint64_t *thePointer = (uint64_t *) input -> data;
    reverseArray(input -> data, 0, 7);
    const uint64_t fullData = *thePointer;
    output -> rc_adcs_mtq_h1_temp_min = (int16_t) (((fullData & ((uint64_t) 0xffff << 48)) >> 48));
    output -> rc_adcs_mtq_h1_temp_max = (int16_t) (((fullData & ((uint64_t) 0xffff << 32)) >> 32));
    output -> rc_adcs_mtq_h1_temp_avg = (int16_t) (((fullData & ((uint64_t) 0xffff << 16)) >> 16));
    output -> rc_adcs_mtq_h1_sysrstiv = (uint8_t) (((fullData & ((uint64_t) 0xff << 8)) >> 8));
    output -> rc_adcs_mtq_h1_reset_count = (uint8_t) (((fullData & ((uint64_t) 0xff))));
}

void encoderc_adcs_mtq_h1(rc_adcs_mtq_h1 *input, CANPacket *output){
    output -> id = 308871774;
    output -> length = 8;
    uint64_t fullPacketData = 0x0000000000000000;
    fullPacketData |= (((uint64_t)((input -> rc_adcs_mtq_h1_temp_min))) & 0xffff) << 48;
    fullPacketData |= (((uint64_t)((input -> rc_adcs_mtq_h1_temp_max))) & 0xffff) << 32;
    fullPacketData |= (((uint64_t)((input -> rc_adcs_mtq_h1_temp_avg))) & 0xffff) << 16;
    fullPacketData |= (((uint64_t)((input -> rc_adcs_mtq_h1_sysrstiv))) & 0xff) << 8;
    fullPacketData |= (((uint64_t)((input -> rc_adcs_mtq_h1_reset_count))) & 0xff);
    uint64_t *thePointer = (uint64_t *) (&(output -> data));
    *thePointer = fullPacketData;
    reverseArray((output->data), 0, 7);
}

void decoderc_ppt_h1(CANPacket *input, rc_ppt_h1 *output){
    uint64_t *thePointer = (uint64_t *) input -> data;
    reverseArray(input -> data, 0, 7);
    const uint64_t fullData = *thePointer;
    output -> rc_ppt_h1_temp_min = (int16_t) (((fullData & ((uint64_t) 0xffff << 48)) >> 48));
    output -> rc_ppt_h1_temp_max = (int16_t) (((fullData & ((uint64_t) 0xffff << 32)) >> 32));
    output -> rc_ppt_h1_temp_avg = (int16_t) (((fullData & ((uint64_t) 0xffff << 16)) >> 16));
    output -> rc_ppt_h1_sysrstiv = (uint8_t) (((fullData & ((uint64_t) 0xff << 8)) >> 8));
    output -> rc_ppt_h1_reset_count = (uint8_t) (((fullData & ((uint64_t) 0xff))));
}

void encoderc_ppt_h1(rc_ppt_h1 *input, CANPacket *output){
    output -> id = 308871773;
    output -> length = 8;
    uint64_t fullPacketData = 0x0000000000000000;
    fullPacketData |= (((uint64_t)((input -> rc_ppt_h1_temp_min))) & 0xffff) << 48;
    fullPacketData |= (((uint64_t)((input -> rc_ppt_h1_temp_max))) & 0xffff) << 32;
    fullPacketData |= (((uint64_t)((input -> rc_ppt_h1_temp_avg))) & 0xffff) << 16;
    fullPacketData |= (((uint64_t)((input -> rc_ppt_h1_sysrstiv))) & 0xff) << 8;
    fullPacketData |= (((uint64_t)((input -> rc_ppt_h1_reset_count))) & 0xff);
    uint64_t *thePointer = (uint64_t *) (&(output -> data));
    *thePointer = fullPacketData;
    reverseArray((output->data), 0, 7);
}

void decodegcmd_mtq_pms(CANPacket *input, gcmd_mtq_pms *output){
    uint64_t *thePointer = (uint64_t *) input -> data;
    reverseArray(input -> data, 0, 7);
    const uint64_t fullData = *thePointer;
    output -> gcmd_mtq_pms_z = (int8_t) (((fullData & ((uint64_t) 0xff << 40)) >> 40));
    output -> gcmd_mtq_pms_y = (int8_t) (((fullData & ((uint64_t) 0xff << 48)) >> 48));
    output -> gcmd_mtq_pms_x = (int8_t) (((fullData & ((uint64_t) 0xff << 56)) >> 56));
    output -> gcmd_mtq_pms_enable = (uint8_t) (((fullData & ((uint64_t) 0x3 << 38)) >> 38));
}

void encodegcmd_mtq_pms(gcmd_mtq_pms *input, CANPacket *output){
    output -> id = 302252749;
    output -> length = 4;
    uint64_t fullPacketData = 0x0000000000000000;
    fullPacketData |= (((uint64_t)((input -> gcmd_mtq_pms_z))) & 0xff) << 40;
    fullPacketData |= (((uint64_t)((input -> gcmd_mtq_pms_y))) & 0xff) << 48;
    fullPacketData |= (((uint64_t)((input -> gcmd_mtq_pms_x))) & 0xff) << 56;
    fullPacketData |= (((uint64_t)((input -> gcmd_mtq_pms_enable))) & 0x3) << 38;
    uint64_t *thePointer = (uint64_t *) (&(output -> data));
    *thePointer = fullPacketData;
    reverseArray((output->data), 0, 7);
}

void decodegcmd_bdot_max_tumble(CANPacket *input, gcmd_bdot_max_tumble *output){
    uint64_t *thePointer = (uint64_t *) input -> data;
    reverseArray(input -> data, 0, 7);
    const uint64_t fullData = *thePointer;
    output -> gcmd_bdot_max_tumble_time = (uint16_t) (((fullData & ((uint64_t) 0xffff << 48)) >> 48));
}

void encodegcmd_bdot_max_tumble(gcmd_bdot_max_tumble *input, CANPacket *output){
    output -> id = 302252748;
    output -> length = 2;
    uint64_t fullPacketData = 0x0000000000000000;
    fullPacketData |= (((uint64_t)((input -> gcmd_bdot_max_tumble_time))) & 0xffff) << 48;
    uint64_t *thePointer = (uint64_t *) (&(output -> data));
    *thePointer = fullPacketData;
    reverseArray((output->data), 0, 7);
}

void decodegcmd_bdot_spam(CANPacket *input, gcmd_bdot_spam *output){
    uint64_t *thePointer = (uint64_t *) input -> data;
    reverseArray(input -> data, 0, 7);
    const uint64_t fullData = *thePointer;
    output -> gcmd_bdot_spam_magnitude_z = (int8_t) (((fullData & ((uint64_t) 0xff << 8)) >> 8));
    output -> gcmd_bdot_spam_magnitude_y = (int8_t) (((fullData & ((uint64_t) 0xff << 16)) >> 16));
    output -> gcmd_bdot_spam_magnitude_x = (int8_t) (((fullData & ((uint64_t) 0xff << 24)) >> 24));
    output -> gcmd_bdot_spam_time_on = (uint16_t) (((fullData & ((uint64_t) 0xffff << 48)) >> 48));
    output -> gcmd_bdot_spam_time_off = (uint16_t) (((fullData & ((uint64_t) 0xffff << 32)) >> 32));
    output -> gcmd_bdot_spam_control = (uint8_t) (((fullData & ((uint64_t) 0x3 << 6)) >> 6));
}

void encodegcmd_bdot_spam(gcmd_bdot_spam *input, CANPacket *output){
    output -> id = 302252747;
    output -> length = 8;
    uint64_t fullPacketData = 0x0000000000000000;
    fullPacketData |= (((uint64_t)((input -> gcmd_bdot_spam_magnitude_z))) & 0xff) << 8;
    fullPacketData |= (((uint64_t)((input -> gcmd_bdot_spam_magnitude_y))) & 0xff) << 16;
    fullPacketData |= (((uint64_t)((input -> gcmd_bdot_spam_magnitude_x))) & 0xff) << 24;
    fullPacketData |= (((uint64_t)((input -> gcmd_bdot_spam_time_on))) & 0xffff) << 48;
    fullPacketData |= (((uint64_t)((input -> gcmd_bdot_spam_time_off))) & 0xffff) << 32;
    fullPacketData |= (((uint64_t)((input -> gcmd_bdot_spam_control))) & 0x3) << 6;
    uint64_t *thePointer = (uint64_t *) (&(output -> data));
    *thePointer = fullPacketData;
    reverseArray((output->data), 0, 7);
}

void decodegcmd_bdot_control(CANPacket *input, gcmd_bdot_control *output){
    uint64_t *thePointer = (uint64_t *) input -> data;
    reverseArray(input -> data, 0, 7);
    const uint64_t fullData = *thePointer;
    output -> gcmd_bdot_control_mode = (uint8_t) (((fullData & ((uint64_t) 0x3 << 62)) >> 62));
}

void encodegcmd_bdot_control(gcmd_bdot_control *input, CANPacket *output){
    output -> id = 302252746;
    output -> length = 1;
    uint64_t fullPacketData = 0x0000000000000000;
    fullPacketData |= (((uint64_t)((input -> gcmd_bdot_control_mode))) & 0x3) << 62;
    uint64_t *thePointer = (uint64_t *) (&(output -> data));
    *thePointer = fullPacketData;
    reverseArray((output->data), 0, 7);
}

void decodegcmd_bdot_mag_control(CANPacket *input, gcmd_bdot_mag_control *output){
    uint64_t *thePointer = (uint64_t *) input -> data;
    reverseArray(input -> data, 0, 7);
    const uint64_t fullData = *thePointer;
    output -> gcmd_bdot_mag_control_mode = (uint8_t) (((fullData & ((uint64_t) 0x3 << 62)) >> 62));
}

void encodegcmd_bdot_mag_control(gcmd_bdot_mag_control *input, CANPacket *output){
    output -> id = 302252745;
    output -> length = 1;
    uint64_t fullPacketData = 0x0000000000000000;
    fullPacketData |= (((uint64_t)((input -> gcmd_bdot_mag_control_mode))) & 0x3) << 62;
    uint64_t *thePointer = (uint64_t *) (&(output -> data));
    *thePointer = fullPacketData;
    reverseArray((output->data), 0, 7);
}

void decodegcmd_bdot_pole_override(CANPacket *input, gcmd_bdot_pole_override *output){
    uint64_t *thePointer = (uint64_t *) input -> data;
    reverseArray(input -> data, 0, 7);
    const uint64_t fullData = *thePointer;
    output -> gcmd_bdot_pole_override_gain_z = (uint8_t) (((fullData & ((uint64_t) 0xff << 40)) >> 40));
    output -> gcmd_bdot_pole_override_gain_y = (uint8_t) (((fullData & ((uint64_t) 0xff << 48)) >> 48));
    output -> gcmd_bdot_pole_override_gain_x = (uint8_t) (((fullData & ((uint64_t) 0xff << 56)) >> 56));
    output -> gcmd_bdot_pole_override_z = (uint8_t) (((fullData & ((uint64_t) 0x3 << 34)) >> 34));
    output -> gcmd_bdot_pole_override_y = (uint8_t) (((fullData & ((uint64_t) 0x3 << 36)) >> 36));
    output -> gcmd_bdot_pole_override_x = (uint8_t) (((fullData & ((uint64_t) 0x3 << 38)) >> 38));
}

void encodegcmd_bdot_pole_override(gcmd_bdot_pole_override *input, CANPacket *output){
    output -> id = 302252744;
    output -> length = 4;
    uint64_t fullPacketData = 0x0000000000000000;
    fullPacketData |= (((uint64_t)((input -> gcmd_bdot_pole_override_gain_z))) & 0xff) << 40;
    fullPacketData |= (((uint64_t)((input -> gcmd_bdot_pole_override_gain_y))) & 0xff) << 48;
    fullPacketData |= (((uint64_t)((input -> gcmd_bdot_pole_override_gain_x))) & 0xff) << 56;
    fullPacketData |= (((uint64_t)((input -> gcmd_bdot_pole_override_z))) & 0x3) << 34;
    fullPacketData |= (((uint64_t)((input -> gcmd_bdot_pole_override_y))) & 0x3) << 36;
    fullPacketData |= (((uint64_t)((input -> gcmd_bdot_pole_override_x))) & 0x3) << 38;
    uint64_t *thePointer = (uint64_t *) (&(output -> data));
    *thePointer = fullPacketData;
    reverseArray((output->data), 0, 7);
}

void decodegcmd_gen_set_pt_state(CANPacket *input, gcmd_gen_set_pt_state *output){
    uint64_t *thePointer = (uint64_t *) input -> data;
    reverseArray(input -> data, 0, 7);
    const uint64_t fullData = *thePointer;
    output -> gcmd_gen_set_pt_state_3 = (uint8_t) (((fullData & ((uint64_t) 0x3 << 58)) >> 58));
    output -> gcmd_gen_set_pt_state_2 = (uint8_t) (((fullData & ((uint64_t) 0x3 << 60)) >> 60));
    output -> gcmd_gen_set_pt_state_1 = (uint8_t) (((fullData & ((uint64_t) 0x3 << 62)) >> 62));
}

void encodegcmd_gen_set_pt_state(gcmd_gen_set_pt_state *input, CANPacket *output){
    output -> id = 302252742;
    output -> length = 1;
    uint64_t fullPacketData = 0x0000000000000000;
    fullPacketData |= (((uint64_t)((input -> gcmd_gen_set_pt_state_3))) & 0x3) << 58;
    fullPacketData |= (((uint64_t)((input -> gcmd_gen_set_pt_state_2))) & 0x3) << 60;
    fullPacketData |= (((uint64_t)((input -> gcmd_gen_set_pt_state_1))) & 0x3) << 62;
    uint64_t *thePointer = (uint64_t *) (&(output -> data));
    *thePointer = fullPacketData;
    reverseArray((output->data), 0, 7);
}

void decodegcmd_dist_set_pd_ovc_ppt(CANPacket *input, gcmd_dist_set_pd_ovc_ppt *output){
    uint64_t *thePointer = (uint64_t *) input -> data;
    reverseArray(input -> data, 0, 7);
    const uint64_t fullData = *thePointer;
    uint32_t tempgcmd_dist_set_pd_ovc_ppt_ovc = (uint32_t) ((fullData & ((uint64_t) 0xffffffff << 32)) >> 32);
    output -> gcmd_dist_set_pd_ovc_ppt_ovc = (*((float *)(&(tempgcmd_dist_set_pd_ovc_ppt_ovc))));
}

void encodegcmd_dist_set_pd_ovc_ppt(gcmd_dist_set_pd_ovc_ppt *input, CANPacket *output){
    output -> id = 302252741;
    output -> length = 4;
    uint64_t fullPacketData = 0x0000000000000000;
    const float tempgcmd_dist_set_pd_ovc_ppt_ovc = ((input -> gcmd_dist_set_pd_ovc_ppt_ovc));
    fullPacketData |= ((uint64_t)(*((uint32_t *)(&(tempgcmd_dist_set_pd_ovc_ppt_ovc))))) << 32;
    uint64_t *thePointer = (uint64_t *) (&(output -> data));
    *thePointer = fullPacketData;
    reverseArray((output->data), 0, 7);
}

void decodegcmd_dist_set_pd_ovc_eps(CANPacket *input, gcmd_dist_set_pd_ovc_eps *output){
    uint64_t *thePointer = (uint64_t *) input -> data;
    reverseArray(input -> data, 0, 7);
    const uint64_t fullData = *thePointer;
    uint32_t tempgcmd_dist_set_pd_ovc_eps_ovc = (uint32_t) ((fullData & ((uint64_t) 0xffffffff << 32)) >> 32);
    output -> gcmd_dist_set_pd_ovc_eps_ovc = (*((float *)(&(tempgcmd_dist_set_pd_ovc_eps_ovc))));
}

void encodegcmd_dist_set_pd_ovc_eps(gcmd_dist_set_pd_ovc_eps *input, CANPacket *output){
    output -> id = 302252740;
    output -> length = 4;
    uint64_t fullPacketData = 0x0000000000000000;
    const float tempgcmd_dist_set_pd_ovc_eps_ovc = ((input -> gcmd_dist_set_pd_ovc_eps_ovc));
    fullPacketData |= ((uint64_t)(*((uint32_t *)(&(tempgcmd_dist_set_pd_ovc_eps_ovc))))) << 32;
    uint64_t *thePointer = (uint64_t *) (&(output -> data));
    *thePointer = fullPacketData;
    reverseArray((output->data), 0, 7);
}

void decodegcmd_dist_set_pd_ovc_estim(CANPacket *input, gcmd_dist_set_pd_ovc_estim *output){
    uint64_t *thePointer = (uint64_t *) input -> data;
    reverseArray(input -> data, 0, 7);
    const uint64_t fullData = *thePointer;
    uint32_t tempgcmd_dist_set_pd_ovc_estim_ovc = (uint32_t) ((fullData & ((uint64_t) 0xffffffff << 32)) >> 32);
    output -> gcmd_dist_set_pd_ovc_estim_ovc = (*((float *)(&(tempgcmd_dist_set_pd_ovc_estim_ovc))));
}

void encodegcmd_dist_set_pd_ovc_estim(gcmd_dist_set_pd_ovc_estim *input, CANPacket *output){
    output -> id = 302252738;
    output -> length = 4;
    uint64_t fullPacketData = 0x0000000000000000;
    const float tempgcmd_dist_set_pd_ovc_estim_ovc = ((input -> gcmd_dist_set_pd_ovc_estim_ovc));
    fullPacketData |= ((uint64_t)(*((uint32_t *)(&(tempgcmd_dist_set_pd_ovc_estim_ovc))))) << 32;
    uint64_t *thePointer = (uint64_t *) (&(output -> data));
    *thePointer = fullPacketData;
    reverseArray((output->data), 0, 7);
}

void decodegcmd_dist_set_pd_ovc_bdot(CANPacket *input, gcmd_dist_set_pd_ovc_bdot *output){
    uint64_t *thePointer = (uint64_t *) input -> data;
    reverseArray(input -> data, 0, 7);
    const uint64_t fullData = *thePointer;
    uint32_t tempgcmd_dist_set_pd_ovc_bdot_ovc = (uint32_t) ((fullData & ((uint64_t) 0xffffffff << 32)) >> 32);
    output -> gcmd_dist_set_pd_ovc_bdot_ovc = (*((float *)(&(tempgcmd_dist_set_pd_ovc_bdot_ovc))));
}

void encodegcmd_dist_set_pd_ovc_bdot(gcmd_dist_set_pd_ovc_bdot *input, CANPacket *output){
    output -> id = 302252737;
    output -> length = 4;
    uint64_t fullPacketData = 0x0000000000000000;
    const float tempgcmd_dist_set_pd_ovc_bdot_ovc = ((input -> gcmd_dist_set_pd_ovc_bdot_ovc));
    fullPacketData |= ((uint64_t)(*((uint32_t *)(&(tempgcmd_dist_set_pd_ovc_bdot_ovc))))) << 32;
    uint64_t *thePointer = (uint64_t *) (&(output -> data));
    *thePointer = fullPacketData;
    reverseArray((output->data), 0, 7);
}

void decodegcmd_dist_set_pd_ovc_rahs(CANPacket *input, gcmd_dist_set_pd_ovc_rahs *output){
    uint64_t *thePointer = (uint64_t *) input -> data;
    reverseArray(input -> data, 0, 7);
    const uint64_t fullData = *thePointer;
    uint32_t tempgcmd_dist_set_pd_ovc_rahs_ovc = (uint32_t) ((fullData & ((uint64_t) 0xffffffff << 32)) >> 32);
    output -> gcmd_dist_set_pd_ovc_rahs_ovc = (*((float *)(&(tempgcmd_dist_set_pd_ovc_rahs_ovc))));
}

void encodegcmd_dist_set_pd_ovc_rahs(gcmd_dist_set_pd_ovc_rahs *input, CANPacket *output){
    output -> id = 302252736;
    output -> length = 4;
    uint64_t fullPacketData = 0x0000000000000000;
    const float tempgcmd_dist_set_pd_ovc_rahs_ovc = ((input -> gcmd_dist_set_pd_ovc_rahs_ovc));
    fullPacketData |= ((uint64_t)(*((uint32_t *)(&(tempgcmd_dist_set_pd_ovc_rahs_ovc))))) << 32;
    uint64_t *thePointer = (uint64_t *) (&(output -> data));
    *thePointer = fullPacketData;
    reverseArray((output->data), 0, 7);
}

void decodegcmd_dist_set_pd_ovc_com2(CANPacket *input, gcmd_dist_set_pd_ovc_com2 *output){
    uint64_t *thePointer = (uint64_t *) input -> data;
    reverseArray(input -> data, 0, 7);
    const uint64_t fullData = *thePointer;
    uint32_t tempgcmd_dist_set_pd_ovc_com2_ovc = (uint32_t) ((fullData & ((uint64_t) 0xffffffff << 32)) >> 32);
    output -> gcmd_dist_set_pd_ovc_com2_ovc = (*((float *)(&(tempgcmd_dist_set_pd_ovc_com2_ovc))));
}

void encodegcmd_dist_set_pd_ovc_com2(gcmd_dist_set_pd_ovc_com2 *input, CANPacket *output){
    output -> id = 302252735;
    output -> length = 4;
    uint64_t fullPacketData = 0x0000000000000000;
    const float tempgcmd_dist_set_pd_ovc_com2_ovc = ((input -> gcmd_dist_set_pd_ovc_com2_ovc));
    fullPacketData |= ((uint64_t)(*((uint32_t *)(&(tempgcmd_dist_set_pd_ovc_com2_ovc))))) << 32;
    uint64_t *thePointer = (uint64_t *) (&(output -> data));
    *thePointer = fullPacketData;
    reverseArray((output->data), 0, 7);
}

void decodegcmd_dist_set_pd_state(CANPacket *input, gcmd_dist_set_pd_state *output){
    uint64_t *thePointer = (uint64_t *) input -> data;
    reverseArray(input -> data, 0, 7);
    const uint64_t fullData = *thePointer;
    output -> gcmd_dist_set_pd_state_wheels = (uint8_t) (((fullData & ((uint64_t) 0x3 << 52)) >> 52));
    output -> gcmd_dist_set_pd_state_rahs = (uint8_t) (((fullData & ((uint64_t) 0x3 << 58)) >> 58));
    output -> gcmd_dist_set_pd_state_ppt = (uint8_t) (((fullData & ((uint64_t) 0x3 << 48)) >> 48));
    output -> gcmd_dist_set_pd_state_estim = (uint8_t) (((fullData & ((uint64_t) 0x3 << 54)) >> 54));
    output -> gcmd_dist_set_pd_state_eps = (uint8_t) (((fullData & ((uint64_t) 0x3 << 50)) >> 50));
    output -> gcmd_dist_set_pd_state_com2 = (uint8_t) (((fullData & ((uint64_t) 0x3 << 60)) >> 60));
    output -> gcmd_dist_set_pd_state_com1 = (uint8_t) (((fullData & ((uint64_t) 0x3 << 62)) >> 62));
    output -> gcmd_dist_set_pd_state_bdot = (uint8_t) (((fullData & ((uint64_t) 0x3 << 56)) >> 56));
}

void encodegcmd_dist_set_pd_state(gcmd_dist_set_pd_state *input, CANPacket *output){
    output -> id = 302252733;
    output -> length = 2;
    uint64_t fullPacketData = 0x0000000000000000;
    fullPacketData |= (((uint64_t)((input -> gcmd_dist_set_pd_state_wheels))) & 0x3) << 52;
    fullPacketData |= (((uint64_t)((input -> gcmd_dist_set_pd_state_rahs))) & 0x3) << 58;
    fullPacketData |= (((uint64_t)((input -> gcmd_dist_set_pd_state_ppt))) & 0x3) << 48;
    fullPacketData |= (((uint64_t)((input -> gcmd_dist_set_pd_state_estim))) & 0x3) << 54;
    fullPacketData |= (((uint64_t)((input -> gcmd_dist_set_pd_state_eps))) & 0x3) << 50;
    fullPacketData |= (((uint64_t)((input -> gcmd_dist_set_pd_state_com2))) & 0x3) << 60;
    fullPacketData |= (((uint64_t)((input -> gcmd_dist_set_pd_state_com1))) & 0x3) << 62;
    fullPacketData |= (((uint64_t)((input -> gcmd_dist_set_pd_state_bdot))) & 0x3) << 56;
    uint64_t *thePointer = (uint64_t *) (&(output -> data));
    *thePointer = fullPacketData;
    reverseArray((output->data), 0, 7);
}

void decodegcmd_mtq_pop(CANPacket *input, gcmd_mtq_pop *output){
    uint64_t *thePointer = (uint64_t *) input -> data;
    reverseArray(input -> data, 0, 7);
    const uint64_t fullData = *thePointer;
    output -> gcmd_mtq_pop_z = (uint8_t) (((fullData & ((uint64_t) 0x3 << 58)) >> 58));
    output -> gcmd_mtq_pop_y = (uint8_t) (((fullData & ((uint64_t) 0x3 << 60)) >> 60));
    output -> gcmd_mtq_pop_x = (uint8_t) (((fullData & ((uint64_t) 0x3 << 62)) >> 62));
}

void encodegcmd_mtq_pop(gcmd_mtq_pop *input, CANPacket *output){
    output -> id = 302449340;
    output -> length = 6;
    uint64_t fullPacketData = 0x0000000000000000;
    fullPacketData |= (((uint64_t)((input -> gcmd_mtq_pop_z))) & 0x3) << 58;
    fullPacketData |= (((uint64_t)((input -> gcmd_mtq_pop_y))) & 0x3) << 60;
    fullPacketData |= (((uint64_t)((input -> gcmd_mtq_pop_x))) & 0x3) << 62;
    uint64_t *thePointer = (uint64_t *) (&(output -> data));
    *thePointer = fullPacketData;
    reverseArray((output->data), 0, 7);
}

void decoderc_eps_batt_7(CANPacket *input, rc_eps_batt_7 *output){
    uint64_t *thePointer = (uint64_t *) input -> data;
    reverseArray(input -> data, 0, 7);
    const uint64_t fullData = *thePointer;
    output -> rc_eps_batt_7_acc_charge_min = (uint16_t) (((fullData & ((uint64_t) 0xffff << 48)) >> 48));
    output -> rc_eps_batt_7_acc_charge_max = (uint16_t) (((fullData & ((uint64_t) 0xffff << 32)) >> 32));
    output -> rc_eps_batt_7_acc_charge_avg = (uint16_t) (((fullData & ((uint64_t) 0xffff << 16)) >> 16));
}

void encoderc_eps_batt_7(rc_eps_batt_7 *input, CANPacket *output){
    output -> id = 307823194;
    output -> length = 6;
    uint64_t fullPacketData = 0x0000000000000000;
    fullPacketData |= (((uint64_t)((input -> rc_eps_batt_7_acc_charge_min))) & 0xffff) << 48;
    fullPacketData |= (((uint64_t)((input -> rc_eps_batt_7_acc_charge_max))) & 0xffff) << 32;
    fullPacketData |= (((uint64_t)((input -> rc_eps_batt_7_acc_charge_avg))) & 0xffff) << 16;
    uint64_t *thePointer = (uint64_t *) (&(output -> data));
    *thePointer = fullPacketData;
    reverseArray((output->data), 0, 7);
}

void decodesensorproc_mag2(CANPacket *input, sensorproc_mag2 *output){
    uint64_t *thePointer = (uint64_t *) input -> data;
    reverseArray(input -> data, 0, 7);
    const uint64_t fullData = *thePointer;
    output -> sensorproc_mag2_bdot_valid = (uint8_t) (((fullData & ((uint64_t) 0x1 << 14)) >> 14));
    output -> sensorproc_mag2_z = (int16_t) (((fullData & ((uint64_t) 0xffff << 16)) >> 16));
    output -> sensorproc_mag2_y = (int16_t) (((fullData & ((uint64_t) 0xffff << 32)) >> 32));
    output -> sensorproc_mag2_x = (int16_t) (((fullData & ((uint64_t) 0xffff << 48)) >> 48));
    output -> sensorproc_mag2_valid = (uint8_t) (((fullData & ((uint64_t) 0x1 << 15)) >> 15));
}

void encodesensorproc_mag2(sensorproc_mag2 *input, CANPacket *output){
    output -> id = 335872068;
    output -> length = 8;
    uint64_t fullPacketData = 0x0000000000000000;
    fullPacketData |= (((uint64_t)((input -> sensorproc_mag2_bdot_valid))) & 0x1) << 14;
    fullPacketData |= (((uint64_t)((input -> sensorproc_mag2_z))) & 0xffff) << 16;
    fullPacketData |= (((uint64_t)((input -> sensorproc_mag2_y))) & 0xffff) << 32;
    fullPacketData |= (((uint64_t)((input -> sensorproc_mag2_x))) & 0xffff) << 48;
    fullPacketData |= (((uint64_t)((input -> sensorproc_mag2_valid))) & 0x1) << 15;
    uint64_t *thePointer = (uint64_t *) (&(output -> data));
    *thePointer = fullPacketData;
    reverseArray((output->data), 0, 7);
}

void decoderc_adcs_estim_14(CANPacket *input, rc_adcs_estim_14 *output){
    uint64_t *thePointer = (uint64_t *) input -> data;
    reverseArray(input -> data, 0, 7);
    const uint64_t fullData = *thePointer;
    uint64_t temprc_adcs_estim_14_mag_z = (uint64_t) ((fullData & ((uint64_t) 0xffffffffffffffff)));
output -> rc_adcs_estim_14_mag_z = (*((double *)(&(temprc_adcs_estim_14_mag_z))));
}

void encoderc_adcs_estim_14(rc_adcs_estim_14 *input, CANPacket *output){
    output -> id = 307823193;
    output -> length = 8;
    uint64_t fullPacketData = 0x0000000000000000;
    const double temprc_adcs_estim_14_mag_z = ((input -> rc_adcs_estim_14_mag_z));
    fullPacketData |= ((uint64_t)(*((uint64_t *)(&(temprc_adcs_estim_14_mag_z)))));
    uint64_t *thePointer = (uint64_t *) (&(output -> data));
    *thePointer = fullPacketData;
    reverseArray((output->data), 0, 7);
}

void decoderc_adcs_estim_13(CANPacket *input, rc_adcs_estim_13 *output){
    uint64_t *thePointer = (uint64_t *) input -> data;
    reverseArray(input -> data, 0, 7);
    const uint64_t fullData = *thePointer;
    uint64_t temprc_adcs_estim_13_mag_y = (uint64_t) ((fullData & ((uint64_t) 0xffffffffffffffff)));
output -> rc_adcs_estim_13_mag_y = (*((double *)(&(temprc_adcs_estim_13_mag_y))));
}

void encoderc_adcs_estim_13(rc_adcs_estim_13 *input, CANPacket *output){
    output -> id = 307823192;
    output -> length = 8;
    uint64_t fullPacketData = 0x0000000000000000;
    const double temprc_adcs_estim_13_mag_y = ((input -> rc_adcs_estim_13_mag_y));
    fullPacketData |= ((uint64_t)(*((uint64_t *)(&(temprc_adcs_estim_13_mag_y)))));
    uint64_t *thePointer = (uint64_t *) (&(output -> data));
    *thePointer = fullPacketData;
    reverseArray((output->data), 0, 7);
}

void decoderc_adcs_estim_12(CANPacket *input, rc_adcs_estim_12 *output){
    uint64_t *thePointer = (uint64_t *) input -> data;
    reverseArray(input -> data, 0, 7);
    const uint64_t fullData = *thePointer;
    uint64_t temprc_adcs_estim_12_mag_x = (uint64_t) ((fullData & ((uint64_t) 0xffffffffffffffff)));
output -> rc_adcs_estim_12_mag_x = (*((double *)(&(temprc_adcs_estim_12_mag_x))));
}

void encoderc_adcs_estim_12(rc_adcs_estim_12 *input, CANPacket *output){
    output -> id = 307823191;
    output -> length = 8;
    uint64_t fullPacketData = 0x0000000000000000;
    const double temprc_adcs_estim_12_mag_x = ((input -> rc_adcs_estim_12_mag_x));
    fullPacketData |= ((uint64_t)(*((uint64_t *)(&(temprc_adcs_estim_12_mag_x)))));
    uint64_t *thePointer = (uint64_t *) (&(output -> data));
    *thePointer = fullPacketData;
    reverseArray((output->data), 0, 7);
}

void decoderc_adcs_estim_11(CANPacket *input, rc_adcs_estim_11 *output){
    uint64_t *thePointer = (uint64_t *) input -> data;
    reverseArray(input -> data, 0, 7);
    const uint64_t fullData = *thePointer;
    uint64_t temprc_adcs_estim_11_sun_z = (uint64_t) ((fullData & ((uint64_t) 0xffffffffffffffff)));
output -> rc_adcs_estim_11_sun_z = (*((double *)(&(temprc_adcs_estim_11_sun_z))));
}

void encoderc_adcs_estim_11(rc_adcs_estim_11 *input, CANPacket *output){
    output -> id = 307823190;
    output -> length = 8;
    uint64_t fullPacketData = 0x0000000000000000;
    const double temprc_adcs_estim_11_sun_z = ((input -> rc_adcs_estim_11_sun_z));
    fullPacketData |= ((uint64_t)(*((uint64_t *)(&(temprc_adcs_estim_11_sun_z)))));
    uint64_t *thePointer = (uint64_t *) (&(output -> data));
    *thePointer = fullPacketData;
    reverseArray((output->data), 0, 7);
}

void decoderc_adcs_estim_10(CANPacket *input, rc_adcs_estim_10 *output){
    uint64_t *thePointer = (uint64_t *) input -> data;
    reverseArray(input -> data, 0, 7);
    const uint64_t fullData = *thePointer;
    uint64_t temprc_adcs_estim_10_sun_y = (uint64_t) ((fullData & ((uint64_t) 0xffffffffffffffff)));
output -> rc_adcs_estim_10_sun_y = (*((double *)(&(temprc_adcs_estim_10_sun_y))));
}

void encoderc_adcs_estim_10(rc_adcs_estim_10 *input, CANPacket *output){
    output -> id = 307823189;
    output -> length = 8;
    uint64_t fullPacketData = 0x0000000000000000;
    const double temprc_adcs_estim_10_sun_y = ((input -> rc_adcs_estim_10_sun_y));
    fullPacketData |= ((uint64_t)(*((uint64_t *)(&(temprc_adcs_estim_10_sun_y)))));
    uint64_t *thePointer = (uint64_t *) (&(output -> data));
    *thePointer = fullPacketData;
    reverseArray((output->data), 0, 7);
}

void decoderc_adcs_estim_9(CANPacket *input, rc_adcs_estim_9 *output){
    uint64_t *thePointer = (uint64_t *) input -> data;
    reverseArray(input -> data, 0, 7);
    const uint64_t fullData = *thePointer;
    uint64_t temprc_adcs_estim_9_sun_x = (uint64_t) ((fullData & ((uint64_t) 0xffffffffffffffff)));
output -> rc_adcs_estim_9_sun_x = (*((double *)(&(temprc_adcs_estim_9_sun_x))));
}

void encoderc_adcs_estim_9(rc_adcs_estim_9 *input, CANPacket *output){
    output -> id = 307823188;
    output -> length = 8;
    uint64_t fullPacketData = 0x0000000000000000;
    const double temprc_adcs_estim_9_sun_x = ((input -> rc_adcs_estim_9_sun_x));
    fullPacketData |= ((uint64_t)(*((uint64_t *)(&(temprc_adcs_estim_9_sun_x)))));
    uint64_t *thePointer = (uint64_t *) (&(output -> data));
    *thePointer = fullPacketData;
    reverseArray((output->data), 0, 7);
}

void decoderc_eps_dist_16(CANPacket *input, rc_eps_dist_16 *output){
    uint64_t *thePointer = (uint64_t *) input -> data;
    reverseArray(input -> data, 0, 7);
    const uint64_t fullData = *thePointer;
    output -> rc_eps_dist_16_ppt_state = (uint8_t) (((fullData & ((uint64_t) 0xff << 56)) >> 56));
    output -> rc_eps_dist_16_ppt_c_min = (int16_t) (((fullData & ((uint64_t) 0xffff << 40)) >> 40));
    output -> rc_eps_dist_16_ppt_c_max = (int16_t) (((fullData & ((uint64_t) 0xffff << 24)) >> 24));
    output -> rc_eps_dist_16_ppt_c_avg = (int16_t) (((fullData & ((uint64_t) 0xffff << 8)) >> 8));
}

void encoderc_eps_dist_16(rc_eps_dist_16 *input, CANPacket *output){
    output -> id = 307823186;
    output -> length = 7;
    uint64_t fullPacketData = 0x0000000000000000;
    fullPacketData |= (((uint64_t)((input -> rc_eps_dist_16_ppt_state))) & 0xff) << 56;
    fullPacketData |= (((uint64_t)((input -> rc_eps_dist_16_ppt_c_min))) & 0xffff) << 40;
    fullPacketData |= (((uint64_t)((input -> rc_eps_dist_16_ppt_c_max))) & 0xffff) << 24;
    fullPacketData |= (((uint64_t)((input -> rc_eps_dist_16_ppt_c_avg))) & 0xffff) << 8;
    uint64_t *thePointer = (uint64_t *) (&(output -> data));
    *thePointer = fullPacketData;
    reverseArray((output->data), 0, 7);
}

void decoderc_eps_dist_9(CANPacket *input, rc_eps_dist_9 *output){
    uint64_t *thePointer = (uint64_t *) input -> data;
    reverseArray(input -> data, 0, 7);
    const uint64_t fullData = *thePointer;
    output -> rc_eps_dist_9_rahs_v_min = (uint16_t) (((fullData & ((uint64_t) 0xffff << 48)) >> 48));
    output -> rc_eps_dist_9_rahs_v_max = (uint16_t) (((fullData & ((uint64_t) 0xffff << 32)) >> 32));
    output -> rc_eps_dist_9_rahs_v_avg = (uint16_t) (((fullData & ((uint64_t) 0xffff << 16)) >> 16));
}

void encoderc_eps_dist_9(rc_eps_dist_9 *input, CANPacket *output){
    output -> id = 307823179;
    output -> length = 6;
    uint64_t fullPacketData = 0x0000000000000000;
    fullPacketData |= (((uint64_t)((input -> rc_eps_dist_9_rahs_v_min))) & 0xffff) << 48;
    fullPacketData |= (((uint64_t)((input -> rc_eps_dist_9_rahs_v_max))) & 0xffff) << 32;
    fullPacketData |= (((uint64_t)((input -> rc_eps_dist_9_rahs_v_avg))) & 0xffff) << 16;
    uint64_t *thePointer = (uint64_t *) (&(output -> data));
    *thePointer = fullPacketData;
    reverseArray((output->data), 0, 7);
}

void decoderc_eps_dist_7(CANPacket *input, rc_eps_dist_7 *output){
    uint64_t *thePointer = (uint64_t *) input -> data;
    reverseArray(input -> data, 0, 7);
    const uint64_t fullData = *thePointer;
    output -> rc_eps_dist_7_com2_v_min = (uint16_t) (((fullData & ((uint64_t) 0xffff << 48)) >> 48));
    output -> rc_eps_dist_7_com2_v_max = (uint16_t) (((fullData & ((uint64_t) 0xffff << 32)) >> 32));
    output -> rc_eps_dist_7_com2_v_avg = (uint16_t) (((fullData & ((uint64_t) 0xffff << 16)) >> 16));
}

void encoderc_eps_dist_7(rc_eps_dist_7 *input, CANPacket *output){
    output -> id = 307823177;
    output -> length = 6;
    uint64_t fullPacketData = 0x0000000000000000;
    fullPacketData |= (((uint64_t)((input -> rc_eps_dist_7_com2_v_min))) & 0xffff) << 48;
    fullPacketData |= (((uint64_t)((input -> rc_eps_dist_7_com2_v_max))) & 0xffff) << 32;
    fullPacketData |= (((uint64_t)((input -> rc_eps_dist_7_com2_v_avg))) & 0xffff) << 16;
    uint64_t *thePointer = (uint64_t *) (&(output -> data));
    *thePointer = fullPacketData;
    reverseArray((output->data), 0, 7);
}

void decoderc_eps_dist_6(CANPacket *input, rc_eps_dist_6 *output){
    uint64_t *thePointer = (uint64_t *) input -> data;
    reverseArray(input -> data, 0, 7);
    const uint64_t fullData = *thePointer;
    output -> rc_eps_dist_6_com2_state = (uint8_t) (((fullData & ((uint64_t) 0xff << 56)) >> 56));
    output -> rc_eps_dist_6_com2_c_min = (int16_t) (((fullData & ((uint64_t) 0xffff << 40)) >> 40));
    output -> rc_eps_dist_6_com2_c_max = (int16_t) (((fullData & ((uint64_t) 0xffff << 24)) >> 24));
    output -> rc_eps_dist_6_com2_c_avg = (int16_t) (((fullData & ((uint64_t) 0xffff << 8)) >> 8));
}

void encoderc_eps_dist_6(rc_eps_dist_6 *input, CANPacket *output){
    output -> id = 307823176;
    output -> length = 7;
    uint64_t fullPacketData = 0x0000000000000000;
    fullPacketData |= (((uint64_t)((input -> rc_eps_dist_6_com2_state))) & 0xff) << 56;
    fullPacketData |= (((uint64_t)((input -> rc_eps_dist_6_com2_c_min))) & 0xffff) << 40;
    fullPacketData |= (((uint64_t)((input -> rc_eps_dist_6_com2_c_max))) & 0xffff) << 24;
    fullPacketData |= (((uint64_t)((input -> rc_eps_dist_6_com2_c_avg))) & 0xffff) << 8;
    uint64_t *thePointer = (uint64_t *) (&(output -> data));
    *thePointer = fullPacketData;
    reverseArray((output->data), 0, 7);
}

void decoderc_eps_dist_5(CANPacket *input, rc_eps_dist_5 *output){
    uint64_t *thePointer = (uint64_t *) input -> data;
    reverseArray(input -> data, 0, 7);
    const uint64_t fullData = *thePointer;
    output -> rc_eps_dist_5_com1_v_min = (uint16_t) (((fullData & ((uint64_t) 0xffff << 48)) >> 48));
    output -> rc_eps_dist_5_com1_v_max = (uint16_t) (((fullData & ((uint64_t) 0xffff << 32)) >> 32));
    output -> rc_eps_dist_5_com1_v_avg = (uint16_t) (((fullData & ((uint64_t) 0xffff << 16)) >> 16));
}

void encoderc_eps_dist_5(rc_eps_dist_5 *input, CANPacket *output){
    output -> id = 307823175;
    output -> length = 6;
    uint64_t fullPacketData = 0x0000000000000000;
    fullPacketData |= (((uint64_t)((input -> rc_eps_dist_5_com1_v_min))) & 0xffff) << 48;
    fullPacketData |= (((uint64_t)((input -> rc_eps_dist_5_com1_v_max))) & 0xffff) << 32;
    fullPacketData |= (((uint64_t)((input -> rc_eps_dist_5_com1_v_avg))) & 0xffff) << 16;
    uint64_t *thePointer = (uint64_t *) (&(output -> data));
    *thePointer = fullPacketData;
    reverseArray((output->data), 0, 7);
}

void decoderc_eps_dist_3(CANPacket *input, rc_eps_dist_3 *output){
    uint64_t *thePointer = (uint64_t *) input -> data;
    reverseArray(input -> data, 0, 7);
    const uint64_t fullData = *thePointer;
    output -> rc_eps_dist_3_batt_v_avg = (uint16_t) (((fullData & ((uint64_t) 0xffff << 16)) >> 16));
    output -> rc_eps_dist_3_batt_v_max = (uint16_t) (((fullData & ((uint64_t) 0xffff << 32)) >> 32));
    output -> rc_eps_dist_3_batt_v_min = (uint16_t) (((fullData & ((uint64_t) 0xffff << 48)) >> 48));
}

void encoderc_eps_dist_3(rc_eps_dist_3 *input, CANPacket *output){
    output -> id = 307823173;
    output -> length = 6;
    uint64_t fullPacketData = 0x0000000000000000;
    fullPacketData |= (((uint64_t)((input -> rc_eps_dist_3_batt_v_avg))) & 0xffff) << 16;
    fullPacketData |= (((uint64_t)((input -> rc_eps_dist_3_batt_v_max))) & 0xffff) << 32;
    fullPacketData |= (((uint64_t)((input -> rc_eps_dist_3_batt_v_min))) & 0xffff) << 48;
    uint64_t *thePointer = (uint64_t *) (&(output -> data));
    *thePointer = fullPacketData;
    reverseArray((output->data), 0, 7);
}

void decoderc_eps_dist_2(CANPacket *input, rc_eps_dist_2 *output){
    uint64_t *thePointer = (uint64_t *) input -> data;
    reverseArray(input -> data, 0, 7);
    const uint64_t fullData = *thePointer;
    output -> rc_eps_dist_2_uv_state = (uint8_t) (((fullData & ((uint64_t) 0xff << 56)) >> 56));
    output -> rc_eps_dist_2_met_overflow = (uint8_t) (((fullData & ((uint64_t) 0xff << 48)) >> 48));
    output -> rc_eps_dist_2_met = (uint64_t) (((fullData & ((uint64_t) 0xffffffff << 16)) >> 16));
}

void encoderc_eps_dist_2(rc_eps_dist_2 *input, CANPacket *output){
    output -> id = 307823172;
    output -> length = 6;
    uint64_t fullPacketData = 0x0000000000000000;
    fullPacketData |= (((uint64_t)((input -> rc_eps_dist_2_uv_state))) & 0xff) << 56;
    fullPacketData |= (((uint64_t)((input -> rc_eps_dist_2_met_overflow))) & 0xff) << 48;
    fullPacketData |= (((uint64_t)((input -> rc_eps_dist_2_met))) & 0xffffffff) << 16;
    uint64_t *thePointer = (uint64_t *) (&(output -> data));
    *thePointer = fullPacketData;
    reverseArray((output->data), 0, 7);
}

void decoderc_eps_dist_17(CANPacket *input, rc_eps_dist_17 *output){
    uint64_t *thePointer = (uint64_t *) input -> data;
    reverseArray(input -> data, 0, 7);
    const uint64_t fullData = *thePointer;
    output -> rc_eps_dist_17_ppt_v_min = (uint16_t) (((fullData & ((uint64_t) 0xffff << 48)) >> 48));
    output -> rc_eps_dist_17_ppt_v_max = (uint16_t) (((fullData & ((uint64_t) 0xffff << 32)) >> 32));
    output -> rc_eps_dist_17_ppt_v_avg = (uint16_t) (((fullData & ((uint64_t) 0xffff << 16)) >> 16));
}

void encoderc_eps_dist_17(rc_eps_dist_17 *input, CANPacket *output){
    output -> id = 307823187;
    output -> length = 6;
    uint64_t fullPacketData = 0x0000000000000000;
    fullPacketData |= (((uint64_t)((input -> rc_eps_dist_17_ppt_v_min))) & 0xffff) << 48;
    fullPacketData |= (((uint64_t)((input -> rc_eps_dist_17_ppt_v_max))) & 0xffff) << 32;
    fullPacketData |= (((uint64_t)((input -> rc_eps_dist_17_ppt_v_avg))) & 0xffff) << 16;
    uint64_t *thePointer = (uint64_t *) (&(output -> data));
    *thePointer = fullPacketData;
    reverseArray((output->data), 0, 7);
}

void decoderc_eps_dist_14(CANPacket *input, rc_eps_dist_14 *output){
    uint64_t *thePointer = (uint64_t *) input -> data;
    reverseArray(input -> data, 0, 7);
    const uint64_t fullData = *thePointer;
    output -> rc_eps_dist_14_eps_state = (uint8_t) (((fullData & ((uint64_t) 0xff << 56)) >> 56));
    output -> rc_eps_dist_14_eps_c_min = (int16_t) (((fullData & ((uint64_t) 0xffff << 40)) >> 40));
    output -> rc_eps_dist_14_eps_c_max = (int16_t) (((fullData & ((uint64_t) 0xffff << 24)) >> 24));
    output -> rc_eps_dist_14_eps_c_avg = (int16_t) (((fullData & ((uint64_t) 0xffff << 8)) >> 8));
}

void encoderc_eps_dist_14(rc_eps_dist_14 *input, CANPacket *output){
    output -> id = 307823184;
    output -> length = 8;
    uint64_t fullPacketData = 0x0000000000000000;
    fullPacketData |= (((uint64_t)((input -> rc_eps_dist_14_eps_state))) & 0xff) << 56;
    fullPacketData |= (((uint64_t)((input -> rc_eps_dist_14_eps_c_min))) & 0xffff) << 40;
    fullPacketData |= (((uint64_t)((input -> rc_eps_dist_14_eps_c_max))) & 0xffff) << 24;
    fullPacketData |= (((uint64_t)((input -> rc_eps_dist_14_eps_c_avg))) & 0xffff) << 8;
    uint64_t *thePointer = (uint64_t *) (&(output -> data));
    *thePointer = fullPacketData;
    reverseArray((output->data), 0, 7);
}

void decoderc_eps_dist_13(CANPacket *input, rc_eps_dist_13 *output){
    uint64_t *thePointer = (uint64_t *) input -> data;
    reverseArray(input -> data, 0, 7);
    const uint64_t fullData = *thePointer;
    output -> rc_eps_dist_13_estim_v_min = (uint16_t) (((fullData & ((uint64_t) 0xffff << 48)) >> 48));
    output -> rc_eps_dist_13_estim_v_max = (uint16_t) (((fullData & ((uint64_t) 0xffff << 32)) >> 32));
    output -> rc_eps_dist_13_estim_v_avg = (uint16_t) (((fullData & ((uint64_t) 0xffff << 16)) >> 16));
}

void encoderc_eps_dist_13(rc_eps_dist_13 *input, CANPacket *output){
    output -> id = 307823183;
    output -> length = 6;
    uint64_t fullPacketData = 0x0000000000000000;
    fullPacketData |= (((uint64_t)((input -> rc_eps_dist_13_estim_v_min))) & 0xffff) << 48;
    fullPacketData |= (((uint64_t)((input -> rc_eps_dist_13_estim_v_max))) & 0xffff) << 32;
    fullPacketData |= (((uint64_t)((input -> rc_eps_dist_13_estim_v_avg))) & 0xffff) << 16;
    uint64_t *thePointer = (uint64_t *) (&(output -> data));
    *thePointer = fullPacketData;
    reverseArray((output->data), 0, 7);
}

void decoderc_eps_dist_11(CANPacket *input, rc_eps_dist_11 *output){
    uint64_t *thePointer = (uint64_t *) input -> data;
    reverseArray(input -> data, 0, 7);
    const uint64_t fullData = *thePointer;
    output -> rc_eps_dist_11_bdot_v_min = (uint16_t) (((fullData & ((uint64_t) 0xffff << 48)) >> 48));
    output -> rc_eps_dist_11_bdot_v_max = (uint16_t) (((fullData & ((uint64_t) 0xffff << 32)) >> 32));
    output -> rc_eps_dist_11_bdot_v_avg = (uint16_t) (((fullData & ((uint64_t) 0xffff << 16)) >> 16));
}

void encoderc_eps_dist_11(rc_eps_dist_11 *input, CANPacket *output){
    output -> id = 307823181;
    output -> length = 6;
    uint64_t fullPacketData = 0x0000000000000000;
    fullPacketData |= (((uint64_t)((input -> rc_eps_dist_11_bdot_v_min))) & 0xffff) << 48;
    fullPacketData |= (((uint64_t)((input -> rc_eps_dist_11_bdot_v_max))) & 0xffff) << 32;
    fullPacketData |= (((uint64_t)((input -> rc_eps_dist_11_bdot_v_avg))) & 0xffff) << 16;
    uint64_t *thePointer = (uint64_t *) (&(output -> data));
    *thePointer = fullPacketData;
    reverseArray((output->data), 0, 7);
}

void decoderc_eps_dist_12(CANPacket *input, rc_eps_dist_12 *output){
    uint64_t *thePointer = (uint64_t *) input -> data;
    reverseArray(input -> data, 0, 7);
    const uint64_t fullData = *thePointer;
    output -> rc_eps_dist_12_estim_state = (uint8_t) (((fullData & ((uint64_t) 0xff << 56)) >> 56));
    output -> rc_eps_dist_12_estim_c_min = (int16_t) (((fullData & ((uint64_t) 0xffff << 40)) >> 40));
    output -> rc_eps_dist_12_estim_c_max = (int16_t) (((fullData & ((uint64_t) 0xffff << 24)) >> 24));
    output -> rc_eps_dist_12_estim_c_avg = (int16_t) (((fullData & ((uint64_t) 0xffff << 8)) >> 8));
}

void encoderc_eps_dist_12(rc_eps_dist_12 *input, CANPacket *output){
    output -> id = 307823182;
    output -> length = 7;
    uint64_t fullPacketData = 0x0000000000000000;
    fullPacketData |= (((uint64_t)((input -> rc_eps_dist_12_estim_state))) & 0xff) << 56;
    fullPacketData |= (((uint64_t)((input -> rc_eps_dist_12_estim_c_min))) & 0xffff) << 40;
    fullPacketData |= (((uint64_t)((input -> rc_eps_dist_12_estim_c_max))) & 0xffff) << 24;
    fullPacketData |= (((uint64_t)((input -> rc_eps_dist_12_estim_c_avg))) & 0xffff) << 8;
    uint64_t *thePointer = (uint64_t *) (&(output -> data));
    *thePointer = fullPacketData;
    reverseArray((output->data), 0, 7);
}

void decoderc_eps_dist_15(CANPacket *input, rc_eps_dist_15 *output){
    uint64_t *thePointer = (uint64_t *) input -> data;
    reverseArray(input -> data, 0, 7);
    const uint64_t fullData = *thePointer;
    output -> rc_eps_dist_15_eps_v_min = (uint16_t) (((fullData & ((uint64_t) 0xffff << 48)) >> 48));
    output -> rc_eps_dist_15_eps_v_max = (uint16_t) (((fullData & ((uint64_t) 0xffff << 32)) >> 32));
    output -> rc_eps_dist_15_eps_v_avg = (uint16_t) (((fullData & ((uint64_t) 0xffff << 16)) >> 16));
}

void encoderc_eps_dist_15(rc_eps_dist_15 *input, CANPacket *output){
    output -> id = 307823185;
    output -> length = 6;
    uint64_t fullPacketData = 0x0000000000000000;
    fullPacketData |= (((uint64_t)((input -> rc_eps_dist_15_eps_v_min))) & 0xffff) << 48;
    fullPacketData |= (((uint64_t)((input -> rc_eps_dist_15_eps_v_max))) & 0xffff) << 32;
    fullPacketData |= (((uint64_t)((input -> rc_eps_dist_15_eps_v_avg))) & 0xffff) << 16;
    uint64_t *thePointer = (uint64_t *) (&(output -> data));
    *thePointer = fullPacketData;
    reverseArray((output->data), 0, 7);
}

void decoderc_eps_dist_10(CANPacket *input, rc_eps_dist_10 *output){
    uint64_t *thePointer = (uint64_t *) input -> data;
    reverseArray(input -> data, 0, 7);
    const uint64_t fullData = *thePointer;
    output -> rc_eps_dist_10_bdot_state = (uint8_t) (((fullData & ((uint64_t) 0xff << 56)) >> 56));
    output -> rc_eps_dist_10_bdot_c_min = (int16_t) (((fullData & ((uint64_t) 0xffff << 40)) >> 40));
    output -> rc_eps_dist_10_bdot_c_max = (int16_t) (((fullData & ((uint64_t) 0xffff << 24)) >> 24));
    output -> rc_eps_dist_10_bdot_c_avg = (int16_t) (((fullData & ((uint64_t) 0xffff << 8)) >> 8));
}

void encoderc_eps_dist_10(rc_eps_dist_10 *input, CANPacket *output){
    output -> id = 307823180;
    output -> length = 7;
    uint64_t fullPacketData = 0x0000000000000000;
    fullPacketData |= (((uint64_t)((input -> rc_eps_dist_10_bdot_state))) & 0xff) << 56;
    fullPacketData |= (((uint64_t)((input -> rc_eps_dist_10_bdot_c_min))) & 0xffff) << 40;
    fullPacketData |= (((uint64_t)((input -> rc_eps_dist_10_bdot_c_max))) & 0xffff) << 24;
    fullPacketData |= (((uint64_t)((input -> rc_eps_dist_10_bdot_c_avg))) & 0xffff) << 8;
    uint64_t *thePointer = (uint64_t *) (&(output -> data));
    *thePointer = fullPacketData;
    reverseArray((output->data), 0, 7);
}

void decoderc_eps_dist_8(CANPacket *input, rc_eps_dist_8 *output){
    uint64_t *thePointer = (uint64_t *) input -> data;
    reverseArray(input -> data, 0, 7);
    const uint64_t fullData = *thePointer;
    output -> rc_eps_dist_8_rahs_state = (uint8_t) (((fullData & ((uint64_t) 0xff << 56)) >> 56));
    output -> rc_eps_dist_8_rahs_c_min = (int16_t) (((fullData & ((uint64_t) 0xffff << 40)) >> 40));
    output -> rc_eps_dist_8_rahs_c_max = (int16_t) (((fullData & ((uint64_t) 0xffff << 24)) >> 24));
    output -> rc_eps_dist_8_rahs_c_avg = (int16_t) (((fullData & ((uint64_t) 0xffff << 8)) >> 8));
}

void encoderc_eps_dist_8(rc_eps_dist_8 *input, CANPacket *output){
    output -> id = 307823178;
    output -> length = 7;
    uint64_t fullPacketData = 0x0000000000000000;
    fullPacketData |= (((uint64_t)((input -> rc_eps_dist_8_rahs_state))) & 0xff) << 56;
    fullPacketData |= (((uint64_t)((input -> rc_eps_dist_8_rahs_c_min))) & 0xffff) << 40;
    fullPacketData |= (((uint64_t)((input -> rc_eps_dist_8_rahs_c_max))) & 0xffff) << 24;
    fullPacketData |= (((uint64_t)((input -> rc_eps_dist_8_rahs_c_avg))) & 0xffff) << 8;
    uint64_t *thePointer = (uint64_t *) (&(output -> data));
    *thePointer = fullPacketData;
    reverseArray((output->data), 0, 7);
}

void decoderc_eps_dist_4(CANPacket *input, rc_eps_dist_4 *output){
    uint64_t *thePointer = (uint64_t *) input -> data;
    reverseArray(input -> data, 0, 7);
    const uint64_t fullData = *thePointer;
    output -> rc_eps_dist_4_com1_state = (uint8_t) (((fullData & ((uint64_t) 0xff << 56)) >> 56));
    output -> rc_eps_dist_4_com1_c_min = (int16_t) (((fullData & ((uint64_t) 0xffff << 40)) >> 40));
    output -> rc_eps_dist_4_com1_c_max = (int16_t) (((fullData & ((uint64_t) 0xffff << 24)) >> 24));
    output -> rc_eps_dist_4_com1_c_avg = (int16_t) (((fullData & ((uint64_t) 0xffff << 8)) >> 8));
}

void encoderc_eps_dist_4(rc_eps_dist_4 *input, CANPacket *output){
    output -> id = 308871750;
    output -> length = 7;
    uint64_t fullPacketData = 0x0000000000000000;
    fullPacketData |= (((uint64_t)((input -> rc_eps_dist_4_com1_state))) & 0xff) << 56;
    fullPacketData |= (((uint64_t)((input -> rc_eps_dist_4_com1_c_min))) & 0xffff) << 40;
    fullPacketData |= (((uint64_t)((input -> rc_eps_dist_4_com1_c_max))) & 0xffff) << 24;
    fullPacketData |= (((uint64_t)((input -> rc_eps_dist_4_com1_c_avg))) & 0xffff) << 8;
    uint64_t *thePointer = (uint64_t *) (&(output -> data));
    *thePointer = fullPacketData;
    reverseArray((output->data), 0, 7);
}

void decoderc_eps_dist_1(CANPacket *input, rc_eps_dist_1 *output){
    uint64_t *thePointer = (uint64_t *) input -> data;
    reverseArray(input -> data, 0, 7);
    const uint64_t fullData = *thePointer;
    output -> rc_eps_dist_1_temp_avg = (uint16_t) (((fullData & ((uint64_t) 0xffff << 16)) >> 16));
    output -> rc_eps_dist_1_com1_c_avg = (uint16_t) (((fullData & ((uint64_t) 0xffff << 32)) >> 32));
    output -> rc_eps_dist_1_batt_v_avg = (uint16_t) (((fullData & ((uint64_t) 0xffff << 48)) >> 48));
}

void encoderc_eps_dist_1(rc_eps_dist_1 *input, CANPacket *output){
    output -> id = 309330499;
    output -> length = 6;
    uint64_t fullPacketData = 0x0000000000000000;
    fullPacketData |= (((uint64_t)((input -> rc_eps_dist_1_temp_avg))) & 0xffff) << 16;
    fullPacketData |= (((uint64_t)((input -> rc_eps_dist_1_com1_c_avg))) & 0xffff) << 32;
    fullPacketData |= (((uint64_t)((input -> rc_eps_dist_1_batt_v_avg))) & 0xffff) << 48;
    uint64_t *thePointer = (uint64_t *) (&(output -> data));
    *thePointer = fullPacketData;
    reverseArray((output->data), 0, 7);
}

void decoderc_adcs_mpc_11(CANPacket *input, rc_adcs_mpc_11 *output){
    uint64_t *thePointer = (uint64_t *) input -> data;
    reverseArray(input -> data, 0, 7);
    const uint64_t fullData = *thePointer;
    uint64_t temprc_adcs_mpc_11_omega_z = (uint64_t) ((fullData & ((uint64_t) 0xffffffffffffffff)));
output -> rc_adcs_mpc_11_omega_z = (*((double *)(&(temprc_adcs_mpc_11_omega_z))));
}

void encoderc_adcs_mpc_11(rc_adcs_mpc_11 *input, CANPacket *output){
    output -> id = 307823166;
    output -> length = 8;
    uint64_t fullPacketData = 0x0000000000000000;
    const double temprc_adcs_mpc_11_omega_z = ((input -> rc_adcs_mpc_11_omega_z));
    fullPacketData |= ((uint64_t)(*((uint64_t *)(&(temprc_adcs_mpc_11_omega_z)))));
    uint64_t *thePointer = (uint64_t *) (&(output -> data));
    *thePointer = fullPacketData;
    reverseArray((output->data), 0, 7);
}

void decoderc_adcs_mpc_7(CANPacket *input, rc_adcs_mpc_7 *output){
    uint64_t *thePointer = (uint64_t *) input -> data;
    reverseArray(input -> data, 0, 7);
    const uint64_t fullData = *thePointer;
    uint64_t temprc_adcs_mpc_7_omega_max = (uint64_t) ((fullData & ((uint64_t) 0xffffffffffffffff)));
output -> rc_adcs_mpc_7_omega_max = (*((double *)(&(temprc_adcs_mpc_7_omega_max))));
}

void encoderc_adcs_mpc_7(rc_adcs_mpc_7 *input, CANPacket *output){
    output -> id = 307823162;
    output -> length = 8;
    uint64_t fullPacketData = 0x0000000000000000;
    const double temprc_adcs_mpc_7_omega_max = ((input -> rc_adcs_mpc_7_omega_max));
    fullPacketData |= ((uint64_t)(*((uint64_t *)(&(temprc_adcs_mpc_7_omega_max)))));
    uint64_t *thePointer = (uint64_t *) (&(output -> data));
    *thePointer = fullPacketData;
    reverseArray((output->data), 0, 7);
}

void decoderc_adcs_mpc_8(CANPacket *input, rc_adcs_mpc_8 *output){
    uint64_t *thePointer = (uint64_t *) input -> data;
    reverseArray(input -> data, 0, 7);
    const uint64_t fullData = *thePointer;
    uint64_t temprc_adcs_mpc_8_omega_avg = (uint64_t) ((fullData & ((uint64_t) 0xffffffffffffffff)));
output -> rc_adcs_mpc_8_omega_avg = (*((double *)(&(temprc_adcs_mpc_8_omega_avg))));
}

void encoderc_adcs_mpc_8(rc_adcs_mpc_8 *input, CANPacket *output){
    output -> id = 307823163;
    output -> length = 8;
    uint64_t fullPacketData = 0x0000000000000000;
    const double temprc_adcs_mpc_8_omega_avg = ((input -> rc_adcs_mpc_8_omega_avg));
    fullPacketData |= ((uint64_t)(*((uint64_t *)(&(temprc_adcs_mpc_8_omega_avg)))));
    uint64_t *thePointer = (uint64_t *) (&(output -> data));
    *thePointer = fullPacketData;
    reverseArray((output->data), 0, 7);
}

void decoderc_adcs_mpc_9(CANPacket *input, rc_adcs_mpc_9 *output){
    uint64_t *thePointer = (uint64_t *) input -> data;
    reverseArray(input -> data, 0, 7);
    const uint64_t fullData = *thePointer;
    uint64_t temprc_adcs_mpc_9_omega_x = (uint64_t) ((fullData & ((uint64_t) 0xffffffffffffffff)));
output -> rc_adcs_mpc_9_omega_x = (*((double *)(&(temprc_adcs_mpc_9_omega_x))));
}

void encoderc_adcs_mpc_9(rc_adcs_mpc_9 *input, CANPacket *output){
    output -> id = 307823164;
    output -> length = 8;
    uint64_t fullPacketData = 0x0000000000000000;
    const double temprc_adcs_mpc_9_omega_x = ((input -> rc_adcs_mpc_9_omega_x));
    fullPacketData |= ((uint64_t)(*((uint64_t *)(&(temprc_adcs_mpc_9_omega_x)))));
    uint64_t *thePointer = (uint64_t *) (&(output -> data));
    *thePointer = fullPacketData;
    reverseArray((output->data), 0, 7);
}

void decoderc_adcs_mpc_5(CANPacket *input, rc_adcs_mpc_5 *output){
    uint64_t *thePointer = (uint64_t *) input -> data;
    reverseArray(input -> data, 0, 7);
    const uint64_t fullData = *thePointer;
    uint64_t temprc_adcs_mpc_5_sc_quat_4 = (uint64_t) ((fullData & ((uint64_t) 0xffffffffffffffff)));
output -> rc_adcs_mpc_5_sc_quat_4 = (*((double *)(&(temprc_adcs_mpc_5_sc_quat_4))));
}

void encoderc_adcs_mpc_5(rc_adcs_mpc_5 *input, CANPacket *output){
    output -> id = 307823160;
    output -> length = 8;
    uint64_t fullPacketData = 0x0000000000000000;
    const double temprc_adcs_mpc_5_sc_quat_4 = ((input -> rc_adcs_mpc_5_sc_quat_4));
    fullPacketData |= ((uint64_t)(*((uint64_t *)(&(temprc_adcs_mpc_5_sc_quat_4)))));
    uint64_t *thePointer = (uint64_t *) (&(output -> data));
    *thePointer = fullPacketData;
    reverseArray((output->data), 0, 7);
}

void decoderc_adcs_mpc_6(CANPacket *input, rc_adcs_mpc_6 *output){
    uint64_t *thePointer = (uint64_t *) input -> data;
    reverseArray(input -> data, 0, 7);
    const uint64_t fullData = *thePointer;
    uint64_t temprc_adcs_mpc_6_omega_min = (uint64_t) ((fullData & ((uint64_t) 0xffffffffffffffff)));
output -> rc_adcs_mpc_6_omega_min = (*((double *)(&(temprc_adcs_mpc_6_omega_min))));
}

void encoderc_adcs_mpc_6(rc_adcs_mpc_6 *input, CANPacket *output){
    output -> id = 307823161;
    output -> length = 8;
    uint64_t fullPacketData = 0x0000000000000000;
    const double temprc_adcs_mpc_6_omega_min = ((input -> rc_adcs_mpc_6_omega_min));
    fullPacketData |= ((uint64_t)(*((uint64_t *)(&(temprc_adcs_mpc_6_omega_min)))));
    uint64_t *thePointer = (uint64_t *) (&(output -> data));
    *thePointer = fullPacketData;
    reverseArray((output->data), 0, 7);
}

void decoderc_adcs_mpc_4(CANPacket *input, rc_adcs_mpc_4 *output){
    uint64_t *thePointer = (uint64_t *) input -> data;
    reverseArray(input -> data, 0, 7);
    const uint64_t fullData = *thePointer;
    uint64_t temprc_adcs_mpc_4_sc_quat_3 = (uint64_t) ((fullData & ((uint64_t) 0xffffffffffffffff)));
output -> rc_adcs_mpc_4_sc_quat_3 = (*((double *)(&(temprc_adcs_mpc_4_sc_quat_3))));
}

void encoderc_adcs_mpc_4(rc_adcs_mpc_4 *input, CANPacket *output){
    output -> id = 307823159;
    output -> length = 8;
    uint64_t fullPacketData = 0x0000000000000000;
    const double temprc_adcs_mpc_4_sc_quat_3 = ((input -> rc_adcs_mpc_4_sc_quat_3));
    fullPacketData |= ((uint64_t)(*((uint64_t *)(&(temprc_adcs_mpc_4_sc_quat_3)))));
    uint64_t *thePointer = (uint64_t *) (&(output -> data));
    *thePointer = fullPacketData;
    reverseArray((output->data), 0, 7);
}

void decoderc_adcs_mpc_3(CANPacket *input, rc_adcs_mpc_3 *output){
    uint64_t *thePointer = (uint64_t *) input -> data;
    reverseArray(input -> data, 0, 7);
    const uint64_t fullData = *thePointer;
    uint64_t temprc_adcs_mpc_3_sc_quat_2 = (uint64_t) ((fullData & ((uint64_t) 0xffffffffffffffff)));
output -> rc_adcs_mpc_3_sc_quat_2 = (*((double *)(&(temprc_adcs_mpc_3_sc_quat_2))));
}

void encoderc_adcs_mpc_3(rc_adcs_mpc_3 *input, CANPacket *output){
    output -> id = 307823158;
    output -> length = 8;
    uint64_t fullPacketData = 0x0000000000000000;
    const double temprc_adcs_mpc_3_sc_quat_2 = ((input -> rc_adcs_mpc_3_sc_quat_2));
    fullPacketData |= ((uint64_t)(*((uint64_t *)(&(temprc_adcs_mpc_3_sc_quat_2)))));
    uint64_t *thePointer = (uint64_t *) (&(output -> data));
    *thePointer = fullPacketData;
    reverseArray((output->data), 0, 7);
}

void decoderc_adcs_mpc_15(CANPacket *input, rc_adcs_mpc_15 *output){
    uint64_t *thePointer = (uint64_t *) input -> data;
    reverseArray(input -> data, 0, 7);
    const uint64_t fullData = *thePointer;
    output -> rc_adcs_mpc_15_sc_mode = (uint8_t) (((fullData & ((uint64_t) 0xff << 56)) >> 56));
    output -> rc_adcs_mpc_15_point_true = (uint8_t) (((fullData & ((uint64_t) 0xff << 48)) >> 48));
}

void encoderc_adcs_mpc_15(rc_adcs_mpc_15 *input, CANPacket *output){
    output -> id = 307823170;
    output -> length = 2;
    uint64_t fullPacketData = 0x0000000000000000;
    fullPacketData |= (((uint64_t)((input -> rc_adcs_mpc_15_sc_mode))) & 0xff) << 56;
    fullPacketData |= (((uint64_t)((input -> rc_adcs_mpc_15_point_true))) & 0xff) << 48;
    uint64_t *thePointer = (uint64_t *) (&(output -> data));
    *thePointer = fullPacketData;
    reverseArray((output->data), 0, 7);
}

void decoderc_adcs_mpc_12(CANPacket *input, rc_adcs_mpc_12 *output){
    uint64_t *thePointer = (uint64_t *) input -> data;
    reverseArray(input -> data, 0, 7);
    const uint64_t fullData = *thePointer;
}

void encoderc_adcs_mpc_12(rc_adcs_mpc_12 *input, CANPacket *output){
    output -> id = 307823167;
    output -> length = 8;
    uint64_t fullPacketData = 0x0000000000000000;
    uint64_t *thePointer = (uint64_t *) (&(output -> data));
    *thePointer = fullPacketData;
    reverseArray((output->data), 0, 7);
}

void decoderc_adcs_mpc_13(CANPacket *input, rc_adcs_mpc_13 *output){
    uint64_t *thePointer = (uint64_t *) input -> data;
    reverseArray(input -> data, 0, 7);
    const uint64_t fullData = *thePointer;
}

void encoderc_adcs_mpc_13(rc_adcs_mpc_13 *input, CANPacket *output){
    output -> id = 307823168;
    output -> length = 8;
    uint64_t fullPacketData = 0x0000000000000000;
    uint64_t *thePointer = (uint64_t *) (&(output -> data));
    *thePointer = fullPacketData;
    reverseArray((output->data), 0, 7);
}

void decoderc_adcs_mpc_14(CANPacket *input, rc_adcs_mpc_14 *output){
    uint64_t *thePointer = (uint64_t *) input -> data;
    reverseArray(input -> data, 0, 7);
    const uint64_t fullData = *thePointer;
}

void encoderc_adcs_mpc_14(rc_adcs_mpc_14 *input, CANPacket *output){
    output -> id = 307823169;
    output -> length = 8;
    uint64_t fullPacketData = 0x0000000000000000;
    uint64_t *thePointer = (uint64_t *) (&(output -> data));
    *thePointer = fullPacketData;
    reverseArray((output->data), 0, 7);
}

void decoderc_adcs_mpc_10(CANPacket *input, rc_adcs_mpc_10 *output){
    uint64_t *thePointer = (uint64_t *) input -> data;
    reverseArray(input -> data, 0, 7);
    const uint64_t fullData = *thePointer;
    uint64_t temprc_adcs_mpc_10_omega_y = (uint64_t) ((fullData & ((uint64_t) 0xffffffffffffffff)));
output -> rc_adcs_mpc_10_omega_y = (*((double *)(&(temprc_adcs_mpc_10_omega_y))));
}

void encoderc_adcs_mpc_10(rc_adcs_mpc_10 *input, CANPacket *output){
    output -> id = 307823165;
    output -> length = 8;
    uint64_t fullPacketData = 0x0000000000000000;
    const double temprc_adcs_mpc_10_omega_y = ((input -> rc_adcs_mpc_10_omega_y));
    fullPacketData |= ((uint64_t)(*((uint64_t *)(&(temprc_adcs_mpc_10_omega_y)))));
    uint64_t *thePointer = (uint64_t *) (&(output -> data));
    *thePointer = fullPacketData;
    reverseArray((output->data), 0, 7);
}

void decoderc_adcs_mpc_2(CANPacket *input, rc_adcs_mpc_2 *output){
    uint64_t *thePointer = (uint64_t *) input -> data;
    reverseArray(input -> data, 0, 7);
    const uint64_t fullData = *thePointer;
    uint64_t temprc_adcs_mpc_2_sc_quat_1 = (uint64_t) ((fullData & ((uint64_t) 0xffffffffffffffff)));
output -> rc_adcs_mpc_2_sc_quat_1 = (*((double *)(&(temprc_adcs_mpc_2_sc_quat_1))));
}

void encoderc_adcs_mpc_2(rc_adcs_mpc_2 *input, CANPacket *output){
    output -> id = 307823157;
    output -> length = 8;
    uint64_t fullPacketData = 0x0000000000000000;
    const double temprc_adcs_mpc_2_sc_quat_1 = ((input -> rc_adcs_mpc_2_sc_quat_1));
    fullPacketData |= ((uint64_t)(*((uint64_t *)(&(temprc_adcs_mpc_2_sc_quat_1)))));
    uint64_t *thePointer = (uint64_t *) (&(output -> data));
    *thePointer = fullPacketData;
    reverseArray((output->data), 0, 7);
}

void decoderc_adcs_mpc_1(CANPacket *input, rc_adcs_mpc_1 *output){
    uint64_t *thePointer = (uint64_t *) input -> data;
    reverseArray(input -> data, 0, 7);
    const uint64_t fullData = *thePointer;
}

void encoderc_adcs_mpc_1(rc_adcs_mpc_1 *input, CANPacket *output){
    output -> id = 307823156;
    output -> length = 8;
    uint64_t fullPacketData = 0x0000000000000000;
    uint64_t *thePointer = (uint64_t *) (&(output -> data));
    *thePointer = fullPacketData;
    reverseArray((output->data), 0, 7);
}

void decoderc_adcs_estim_8(CANPacket *input, rc_adcs_estim_8 *output){
    uint64_t *thePointer = (uint64_t *) input -> data;
    reverseArray(input -> data, 0, 7);
    const uint64_t fullData = *thePointer;
    output -> rc_adcs_estim_8_tle_id = (uint8_t) (((fullData & ((uint64_t) 0x1 << 13)) >> 13));
    output -> rc_adcs_estim_8_sgp4_flag = (int8_t) (((fullData & ((uint64_t) 0xff << 16)) >> 16));
    output -> rc_adcs_estim_8_sc_in_sun = (uint8_t) (((fullData & ((uint64_t) 0x1 << 15)) >> 15));
    output -> rc_adcs_estim_8_sc_above_gs = (uint8_t) (((fullData & ((uint64_t) 0x1 << 14)) >> 14));
    output -> rc_adcs_estim_8_epoch_overflow = (uint8_t) (((fullData & ((uint64_t) 0xff << 24)) >> 24));
    output -> rc_adcs_estim_8_epoch = (uint32_t) (((fullData & ((uint64_t) 0xffffffff << 32)) >> 32));
}

void encoderc_adcs_estim_8(rc_adcs_estim_8 *input, CANPacket *output){
    output -> id = 307823155;
    output -> length = 7;
    uint64_t fullPacketData = 0x0000000000000000;
    fullPacketData |= (((uint64_t)((input -> rc_adcs_estim_8_tle_id))) & 0x1) << 13;
    fullPacketData |= (((uint64_t)((input -> rc_adcs_estim_8_sgp4_flag))) & 0xff) << 16;
    fullPacketData |= (((uint64_t)((input -> rc_adcs_estim_8_sc_in_sun))) & 0x1) << 15;
    fullPacketData |= (((uint64_t)((input -> rc_adcs_estim_8_sc_above_gs))) & 0x1) << 14;
    fullPacketData |= (((uint64_t)((input -> rc_adcs_estim_8_epoch_overflow))) & 0xff) << 24;
    fullPacketData |= (((uint64_t)((input -> rc_adcs_estim_8_epoch))) & 0xffffffff) << 32;
    uint64_t *thePointer = (uint64_t *) (&(output -> data));
    *thePointer = fullPacketData;
    reverseArray((output->data), 0, 7);
}

void decoderc_adcs_estim_7(CANPacket *input, rc_adcs_estim_7 *output){
    uint64_t *thePointer = (uint64_t *) input -> data;
    reverseArray(input -> data, 0, 7);
    const uint64_t fullData = *thePointer;
    uint64_t temprc_adcs_estim_7_vel_z = (uint64_t) ((fullData & ((uint64_t) 0xffffffffffffffff)));
output -> rc_adcs_estim_7_vel_z = (*((double *)(&(temprc_adcs_estim_7_vel_z))));
}

void encoderc_adcs_estim_7(rc_adcs_estim_7 *input, CANPacket *output){
    output -> id = 307823154;
    output -> length = 8;
    uint64_t fullPacketData = 0x0000000000000000;
    const double temprc_adcs_estim_7_vel_z = ((input -> rc_adcs_estim_7_vel_z));
    fullPacketData |= ((uint64_t)(*((uint64_t *)(&(temprc_adcs_estim_7_vel_z)))));
    uint64_t *thePointer = (uint64_t *) (&(output -> data));
    *thePointer = fullPacketData;
    reverseArray((output->data), 0, 7);
}

void decoderc_adcs_estim_6(CANPacket *input, rc_adcs_estim_6 *output){
    uint64_t *thePointer = (uint64_t *) input -> data;
    reverseArray(input -> data, 0, 7);
    const uint64_t fullData = *thePointer;
    uint64_t temprc_adcs_estim_6_vel_y = (uint64_t) ((fullData & ((uint64_t) 0xffffffffffffffff)));
output -> rc_adcs_estim_6_vel_y = (*((double *)(&(temprc_adcs_estim_6_vel_y))));
}

void encoderc_adcs_estim_6(rc_adcs_estim_6 *input, CANPacket *output){
    output -> id = 307823153;
    output -> length = 8;
    uint64_t fullPacketData = 0x0000000000000000;
    const double temprc_adcs_estim_6_vel_y = ((input -> rc_adcs_estim_6_vel_y));
    fullPacketData |= ((uint64_t)(*((uint64_t *)(&(temprc_adcs_estim_6_vel_y)))));
    uint64_t *thePointer = (uint64_t *) (&(output -> data));
    *thePointer = fullPacketData;
    reverseArray((output->data), 0, 7);
}
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
