UWCubeSat/DubSat1/(commit log)

2017-04-10 Initial check-in of early I2C support, along with (barely) working HMC5883 magnetometer support. Genericized magtom interface sketched out but not truly started, nor is the MAG3110 support.
2017-04-11 Cleaned up nagging timing issue on reads (sometimes the automatic byte counting ability of the "enhanced" eUSCI modules didn't fire in time for loop to pick it up, so it would get stick waiting to gr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
    [magnetometer.c, main.c]
2017-04-29 I2C: Fixed another race-condition in one of the busy-wait loops, spiffed up some other areas. Sensors: MAG3110 support added, conversion mode cleaned up, now fully supports generic magnetometers.
    [HMC5883L_Magnetometer.h, MAG3110_Magnetometer.h, mag_test_main.c, magnetometer.c, magnetometer.h]
2017-04-29 Adding datasheet for the ADC we'll be using for photodiodes.
2017-04-30 Added initial debug tools and UART wrappers. Transmit only, currently.
2017-05-05 Changes to definitions for HW/board choices, plus some API cleanup here and there.
2017-05-06 Ported over CAN and SPI for MSP430FR5994
    Moved into core. Further testing required.
2017-05-13 BSP work to support new CAN-MSP block v1 boards, plus some other cleanup.
2017-05-20 Set Interrupt Receive Read
    When we receive a message the user can decide what to do with the data
    by setting a function pointer.
2017-05-20 Added Wiring List for MSP430-to-25625S (CAN Controller) to the MSP430 Resource Plan
2017-05-27 Working Callback Message with small Bug
    Bug is that once we enter the interrupt vector, the INT pin goes low
    and always stays low, and never goes back up to high, making it
    permeanantly be in a state of calling the interrupt.
    [can.c]
2017-06-17 Debug infrastructure tweaks, including bumping UART speed from 9600->115.2kbps, added debugPrintF, which takes a format string and variable args, just like printf, but doesn't require a buffer and (m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
    [SUBSYSTEMNAME_main.c, bsp.c, debugtools.c, debugtools.h, uart.c]
2017-06-17 Publishing latest dsbase code (including CAN and SPI libs).
2017-06-30 Moving 1) all valid subsystem modules into ssmods folder (please keep this folder "pristine" from now on, each subfolder within ssmods should correspond to an actual MSP43x on the satellite); and 2) 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
    [SUBSYSTEMNAME_main.c]
2017-06-30 Fix up ss_TEST so it compiles in new ssmods-based location. Renamed redirect/virtual folder "support" (stupiud name) to a more proper dsbase (not as stupid).
    [SUBSYSTEMNAME_main.c]
2017-06-30 Cleanup oops-checkin of Debug folder. Sigh. Probably should make a more general .gitignore filter for all ../Debug/.. folders ... candy cane for anyone who reads this and adds that.
2017-06-30 Fix-up aggravating warnigs - including finally removing the intentional #warning for using the I2C "sync mode" (which is the only mode implemented currently!).
    [debugtools.c, i2c.h, uart.c]
2017-07-12 Initial test implementation of the IMU support, along with some I2C tweaks. Still need to figure out why the byte counts are getting hosed in the automatic byte-counting mechanism on the eUSCI periph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
2017-07-13 Most of the sprint 2 payload from me. Main portion is making the debugging infrastructure more pluggable - services or buses or subsystems (collectively "entities") can register to provide either inf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
    [SUBSYSTEMNAME_main.c, bsp.c, debugtools.c, debugtools.h, systeminfo.c, systeminfo.h, uart.c]
2017-07-19 Phase 1b of the Great Repo Reorg of Sprint 2 - new teams/<teamname> folders created, with starter readmes to make them actually appear. Created the new "devmods" folder that is a peer to ssmods under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
2017-07-21 SPI and CAN libarary update
    SPI library has been updated to work with the CAN-MSP block v2, and the CAN Library has been updated to work with the updated SPI Library
2017-07-25 Revert "Add files via upload"
    This reverts commit 67cbfa6c9218d45cb308c7c35cd230feb29d5168.
    [Battery board V4.0.brd, Battery board V4.0.sch]
2017-07-25 This commit is to begin adding files to the power repo
    [Battery board V4.0.brd, Battery board V4.0.sch]
2017-07-27 Bug Fixing CAN API
    There are still some bugs, don't get me wrong, and we also need to make it compatible with the new CANnumeration, standby for that.
    [SUBSYSTEMNAME_main.c, can.c, can.h]
2017-07-28 This is the second version of the distribution board. Will update with latest version after Spring Meeting 7/27
    [DistributionBoard.brd, DistributionBoard.sch]
2017-07-28 Revert "This is the second version of the distribution board. Will update with latest version after Spring Meeting 7/27"
    This reverts commit fc800a6ca987bea3dc69a260f7d8089fe9c8fc88.
    [DistributionBoard.brd, DistributionBoard.sch]
2017-07-28 FIrst version of distribution board. WIll be updated later after sprint 7/27
    [DanielDist_board_1.0.brd, DanielDist_board_1.0.sch]
2017-07-31 Folder organization and datasheets for sensors
2017-07-31 Added folder structure and datasheets for actuators
2017-07-31 Added magnetorquers and sensors to global library
    Full change list:
    - MT_FERROCORE
    - MT_AIRCORE
    - A3903 H-Bridge
    - LSM6DSM IMU
    - HMC 5983 Magnetometer
2017-08-01 Power organization
    [DanielDist_board_1.0.brd, DanielDist_board_1.0.sch]
2017-08-01 Updated boards / added sun sensor DXFs
    [Center panel V1.1.brd, mounted temp sensor breakout board V1.brd, mounted temp sensor breakout board V1.sch, over-under sun sensor panel mount footprint.dxf, side-by-side sun sensor panel mount footprint.dxf]
2017-08-02 Added HMC 5983 Breakout devboard
    [HMC5983 Breakout.brd, HMC5983 Breakout.sch]
2017-08-02 Add LSM6DSM Breakout board
    [LSM6DSM Breakout.brd, LSM6DSM Breakout.sch]
2017-08-02 Added photodiode breakout board
    [SFH 2430 Breakout.brd, SFH 2430 Breakout.sch]
2017-08-02 Added magnetorquer stack board
    [Magnetorquer Board.brd, Magnetorquer Board.sch]
2017-08-02 updating center pannel
    [Center panel V1.1.brd, over-under sun sensor panel mount footprint.dxf, side-by-side sun sensor panel mount footprint.dxf]
2017-08-02 Add TI DRV10970 Motor Driver
2017-08-07 Create DRV 10970/MSP 430 testing board
    [motor_controller_single.sch]
2017-08-09 First layout revision of single motor/controller board
    [motor_controller_single.brd, motor_controller_single.sch]
2017-08-10 Support for Board V3, Extended CAN IDs and Filters
    The CAN Filter API is much much more simple now too.
2017-08-11 Fix labeling on SDA/SCL
    [HMC5983 Breakout.brd]
2017-08-11 Revision and relayout
    [motor_controller_single.brd, motor_controller_single.sch]
2017-08-11 Revert last change :(
    [HMC5983 Breakout.brd]
2017-08-12 Added IMU breakout
    [LSM6DSM_breakout.brd, LSM6DSM_breakout.sch]
2017-08-12 Add photodiode amplifier breakout
    [photodiode_breakout.brd, photodiode_breakout.sch]
2017-08-14 Ongoing design changes in battery board V4.1
    [Battery board V4.1 - simple signals.brd, Battery board V4.1 - simple signals.sch]
2017-08-14 Adding Distribution Board V2, making final edits, and adding gerber files.
    [DanielDist_board_1.17.GBL, DanielDist_board_1.17.GBO, DanielDist_board_1.17.GBP, DanielDist_board_1.17.GBS, DanielDist_board_1.17.GTL, DanielDist_board_1.17.GTO, DanielDist_board_1.17.GTP, DanielDist_board_1.17.GTS]
2017-08-14 Adding Gen board V4 with final edits and gerber files
    [PwrGenBrd_v4.2.GBL, PwrGenBrd_v4.2.GBO, PwrGenBrd_v4.2.GBP, PwrGenBrd_v4.2.GBS, PwrGenBrd_v4.2.GTL, PwrGenBrd_v4.2.GTO, PwrGenBrd_v4.2.GTP, PwrGenBrd_v4.2.GTS]
2017-08-14 Documenting attempts to add more solar cells per panel with new mounting scheme.
    [7 cell demonstration.brd, Side Panel Experement - 6 cells.brd, Side Panel Experement - 6 cells.sch]
2017-08-14 Tracking trade study for deployment relay.
2017-08-15 Modifications to breakout board layout
    [LSM6DSM Breakout.brd, LSM6DSM Breakout.sch]
2017-08-19 Add prototype GPS code
    Add arduino code to read GPS binay output.
2017-08-20 Tweak to fix include issue in new analog header/source files.
    [analogread.c]
2017-08-20 Add arduino code for simple gps IO
    Tunnel serial data to/from the GPS.
2017-08-21 Reaction wheel driver frequency reading test - not yet working, sadly.
2017-08-22 Adding solar cell mounting procedure to documentation
2017-08-22 Remove SoC pin and tie SoC lead to ground
    [HMC5983 Breakout.brd, HMC5983 Breakout.sch]
2017-08-22 Remove antenna pin
2017-08-24 Change the length of the ferrocores + 1 mm
2017-08-25 Added MOLEX PicoLock connectors
2017-08-26 Checking in more reaction wheel test work, and the stubs for a set of timer utilities. *NOTE*: Also includes a change to the ACLK clock source from internal, junky and slooooow (~10kHz) to external c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
2017-08-26 Initial CAN message tracking documents.
    [CAN Message Ideas.csv, CAN Message Priorities.csv, CAN Message Types.csv]
2017-08-27 Update CAN Message Types.csv
    Added CMD type.
    [CAN Message Types.csv]
2017-08-27 Centralizing CAN stuff in a separate folder, adding a test DBC file.
    [CAN Message Ideas.csv, CAN Message Priorities.csv, CAN Message Types.csv]
2017-08-27 Tweaks to CAN message info.
    [CAN Message Ideas.csv]
2017-08-27 Fixed stupid issue with multple RW command packets.
    [CANDB-MASTER-DS1.ini]
2017-08-29 Fixing a super stupid error where I didn't heed my own advice about preparing for dsbase-dev going away.
    [BMI160_IMU.h, imu.c, imu.h]
2017-08-29 minor change to solar cell mounting procedure
2017-08-29 Repopulating power folder with personal backup after botched merge.
    [7 cell demonstration.brd, Center panel V1.2.brd, Center panel V1.2.dxf, Center panel V1.2.sch, Center panel V1.2_2.dxf, Center panel V1.2_3.dxf, Center panel V1.2_4.dxf, Center panel sensor placement.brd]
2017-08-30 Newest dist board as of ordering
    [Dist_board_(1.21).brd, Dist_board_(1.21).sch]
2017-08-31 Documenting justification for deployment relay size.
2017-08-31 Added preliminary motor momentum calculator
2017-08-31 Start of sensor board
    [gps_and_sensor_board.brd, gps_and_sensor_board.sch]
2017-08-31 Create motor/estimator schematic
    [motor_and_estimator_board.sch]
2017-08-31 Git got confused
    [7 cell demonstration.brd, Center panel V1.2.brd, Center panel V1.2.dxf, Center panel V1.2.sch, Center panel V1.2_2.dxf, Center panel V1.2_3.dxf, Center panel V1.2_4.dxf, Center panel sensor placement.brd]
2017-08-31 Fixed PICOLOCK_4 with names and silkscreen
2017-08-31 Add silkscreens for PICOLOCK 6 and 7
2017-08-31 Add silkscreens for PICOLOCK 8, 10, and 12
2017-09-01 Small CAN Matrix fixes
    like changing the id to extended
    [test.c]
2017-09-02 updating solar panels with picolock connector, temp sensor, and 3D models
    [Center panel V1.2.brd, Center panel V1.2.brd v4.iges, Center panel V1.2.brd v4.step, Center panel V1.2.sch, side panel V5.brd, side panel V5.sch]
2017-09-02 Organizing DXFs.
    [Center panel V1.2.dxf, Center panel V1.2_2.dxf, Center panel V1.2_3.dxf, Center panel V1.2_4.dxf, over-under sun sensor panel mount footprint.dxf, side panel V5.dxf, side-by-side sun sensor panel mount footprint.dxf]
2017-09-04 Auto stash before merge of "develop" and "origin/develop"
    [Center panel V1.2.brd, Center panel V1.2.brd v4.iges, Center panel V1.2.brd v4.step, Center panel V1.2.dxf, Center panel V1.2.sch, Center panel V1.2_2.dxf, Center panel V1.2_3.dxf, Center panel V1.2_4.dxf]
2017-09-04 Rename engineering model folder
    [gps_and_sensor_board.brd, gps_and_sensor_board.sch, motor_and_estimator_board.sch]
2017-09-04 Added engineering model photodiode board
    [photodiode.brd, photodiode.sch]
2017-09-04 Added... mounting holes...
    [photodiode.brd, photodiode.sch]
2017-09-04 Added silkscreen to indicate panel cutout
    [photodiode.brd]
2017-09-05 made gerber files for motor contorller and updated eagle library
    [motor_controller_single.GBL, motor_controller_single.GBO, motor_controller_single.GBP, motor_controller_single.GBS, motor_controller_single.GTL, motor_controller_single.GTO, motor_controller_single.GTP, motor_controller_single.GTS]
2017-09-06 Added extra silkscreen to annotate mounting
    [photodiode.brd]
2017-09-06 Add extra silkscreen to annotate mounting
    [photodiode.brd]
2017-09-06 Added mounting silkscreen again
    [photodiode.brd]
2017-09-07 Added CAN DBC Wrapper Encode Function
    🙌
2017-09-08 Added sync connections and reorganized
    [Magnetorquer Board.sch]
2017-09-09 Added 3rd PWM output pin config, to match latest RW test boards.
2017-09-09 Added SYNC pulse connections
    [Magnetorquer Board.brd, Magnetorquer Board.sch]
2017-09-09 Added temp sensor and transistor to library
2017-09-09 Added folder for eagle design blocks (in general), and added temp sensor design block.
2017-09-11 Add full schematic of motor board (sans power converters)
    [motor_board.sch]
2017-09-11 Add 0805 0 Ohm resistor jumper
2017-09-11 Remove old/redundant motor board
    [motor_and_estimator_board.sch]
2017-09-11 Slight tweaks and initial board organization
    [motor_board.brd, motor_board.sch]
2017-09-13 Sensor characterization: ongoing MATLAB script experiments with new Total Phase hardware, goal of getting noise parameters from IMUs, magtoms, etc.
2017-09-13 Sensor characterization (pt 2): Rest of script work for MATLAB IMU characterization.
2017-09-13 ADCS/RW - Added voltage nets for MCU regulators
    [motor_board.brd, motor_board.sch]
2017-09-13 ADCS/RW: Routed motor/connector region
    [motor_board.brd, motor_board.sch]
2017-09-14 Sensor characterization (pt3): Additional tweaks and initial data on BMI160 IMU noise figures.
2017-09-14 ADCS/GPS: Port prototype code to C
    closes #69
2017-09-14 Test infrastructure: Working out MATLAB incantations to monitor and measure PWM duty cycle, amplitude, etc., for use in measuring output of Bdot/MTQ controller duo HIL testing (though we might measur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
2017-09-14 ADCS/RW: Add motor bracket footprint
2017-09-14 ADCS/Sensors: Update eagle version in file header
    [LSM6DSM_breakout.brd, LSM6DSM_breakout.sch]
2017-09-14 ADCS/RW: Add motor bracket to drawing
    [motor_board.brd, motor_board.sch]
2017-09-14 ADCS/GPS: Use uartTransmit
2017-09-14 ADCS/GPS: Add CAN message ideas
    [CAN Message Ideas.csv]
2017-09-14 Core/UART feature work: updated bus plans; added most of multi-bus handling though need to move buffers over to
2017-09-14 ADCS/RW: More progress routing motor drivers
    [motor_board.brd]
2017-09-14 added estimator_board and updated dubsat library to include: CAN-block, MSP432, LDO
    [estimator_board.brd, estimator_board.sch]
2017-09-14 Removed inserted git delimiters
2017-09-15 Core/UART feature work: more work to play well with the actual flight chip model chosen (d'oh). Other tweaks. Just need to make buffers per-peripheral instance, and put up some guards to protect agai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
2017-09-15 ADCS/GPS: Add standard deviation CAN messages
    Also restore the previous changes which were somehow lost.
    [CAN Message Ideas.csv]
2017-09-15 ADCS/GPS: Restore GPS test
    The adcs_gps_test folder seems to have vanishes without a trace. I restored it from an earlier commit.
2017-09-15 Core/UART: More reliability fixes.
    [bsp.h, uart.c, uart.h]
2017-09-15 Core/UART: Completed dual-UART support, moving to a handle-based model, i.e. uartInit() now takes an enum - either BackchannelUART (used by the debug system, don't use) or ApplicationUART (use this o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
    [SUBSYSTEMNAME_main.c, bsp.h, uart.c]
2017-09-15 ADCS/GPS: Cram std dev into fewer CAN messages
    [CAN Message Ideas.csv]
2017-09-15 ADCS/GPS: Use new uart
    Also moved some things around and fixed the uartTransmit calls.
2017-09-15 Test infrastructure: Experiment with max analog voltage read speed on Arduino with MATLAB support package ... 40Hz at 1 channel, 20Hz at 3 channels. Boo.
2017-09-16 Core/UART: fixed aggravating bug that crept back in with the multi-handle addition. Symptom is not being able to called debugPrintF/uartTransmit in an "overlapped" way (not waiting for previous call 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
    [SUBSYSTEMNAME_main.c, systeminfo.c, uart.c, uart.h]
2017-09-16 Core/Debug: bug fix, misordered status fields. D'oh.
    [uart.c]
2017-09-16 Core/BSP: Added new board code for MSP/CAN block v2.4, with initial pin assignments (not yet complete).
2017-09-16 Core/BSP: Moved I2C pin config into BSP funcions/macro definitions, so I2C users don't need to hunt down pin config settings anymore. Currently uses what we refer to as "I2C bus 2", corresponding to 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
2017-09-16 Core/BSP: added correct defines for LEDs (and how they differ between the LaunchPad and the latest test boards).
    [bsp.h]
2017-09-18 ADCS/RWS: Working on RW driver compnents in test app. New board responding well with PID controller v0.7 installed, but still getting the noise spikes where the RPM suddenly appears to jump. External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
    [SUBSYSTEMNAME_main.c, bsp.c, rwstest_main.c, timers.h]
2017-09-19 ADCS/RW: Moved v0.7 PID and other assorted code into new rw.c/.h library, in a new dsbase/actuators folder. Includes a number of fixes to get us to around +/-5rpm with very little overshoot or oscill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
    [SUBSYSTEMNAME_main.c, bsp.c, rw.c, rw.h, rws_test_main.c, systeminfo.c]
2017-09-19 ADCS/RWS: Fixed annoying warning/pseudo-error around behavior of rwsPIDStep() if PID constroller is in manual (aka off) mode.
    [rw.c]
2017-09-19 Revert some missing boards back to f71e3d5410
    [motor_and_estimator_board.sch, motor_board.brd, motor_board.sch, photodiode.brd]
2017-09-19 ADCS/IMU: Fixed some vias under pads
    [LSM6DSM_breakout.brd]
2017-09-19 ADCS/RW: Added motor driver design block
2017-09-19 ADCS/RW: Utilize design block in further routing progress
    [motor_board.brd, motor_board.sch]
2017-09-19 ADCS/RW: Further routing
    [motor_board.brd, motor_board.sch]
2017-09-19 ADCS/RW: Added LDOs for microcontrollers
    [motor_board.brd, motor_board.sch]
2017-09-19 Core/UART: Fix super stupid bug brought on by bumping up buffer sizes > 255 bytes. Sigh.
    [uart.c, uart.h]
2017-09-19 Core/UART: Small bug fixes to status reporting for UART bus state.
    [debugtools.c, systeminfo.c, uart.c, uart.h]
2017-09-19 ADCS/IMU: Updates to sensor characterizer script, to read ST LSM6DSM IMU.
2017-09-19 Core/UART: Expose setter for enabling/disabling echo behavior in initializer.
2017-09-20 ADCS/IMU: Charactertization information for the ST IMU, reflecting 800Hz ODR setting. Changed script to go back to 400-ish Hz and hobbled MATLAB a bit so it always gets new data (needed for the Allan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
2017-09-20 ADCS/IMU: Characterization data and Allan variance for ST IMU LSM6DSM, running at 400Hz (and renamed previous set of data to _800Hz to distinguish).
2017-09-20 Core/Debug: Commanding over UART now working (mostly) properly. Each debug 'entity' is registered with the debug service with a "path character". This character is used giving commands to entities at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
2017-09-20 ADCS/IMU: Added scripting to autocalc the angle random walk and bias instability, and some other ODR setting options for the ST IMU.
2017-09-20 ADCS/GPS: Fix echo bug and printf
    Also fixed error reporting.
    The message contents are still bugged.
    [tunnel.ino]
2017-09-20 Update CAN unit test
    The example unit test for ceedling broke after commit 0cfa823cd762ef1fec8e60147a7aecfb62a73852.
    [spi.h]
2017-09-21 ADCS/GPS: Fix message misalignment
    I also moved nearly everything to gps.c.
    [gps.c, gps.h]
2017-09-21 ADCS/RW: Added direct setpoint and direction control to the debug console for the reaction wheel PID/support library.
2017-09-21 ADCS/RW: Added complete layout for MCU/Motor Driver
2017-09-21 ADCS/RW: Routed everything but SEPIC
    [motor_board.brd, motor_board.sch]
2017-09-22 ADCS/GPS: Fix CRC missing sync bytes
    [gps.c]
2017-09-22 Core/UART: Added uartSetEchoOn/Off() functions, so echo can be manipulated after bus is initialized - needed to support switching debug modes on the fly (which the ground segment will do during integ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
2017-09-23 EPS: updating temp sensor design block
2017-09-23 ADCS/IMU: Broke out IMU sensor testing scripts by model, and now setup with arrays of configurations to test in bulk. Results stored in new folders, will be used to make final call on IMU model today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
2017-09-24 Core/General: renamed the "ss_TEST" project in ssmods to "ss_TEMPLATE", which is now what it truly is. The src/devmods/ss_TEST project will remain for testing in the devmods folder, as we don't want 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
    [IMUComparison.xlsx]
2017-09-24 ADCS/MT: Switched from distributed 3V3/5V to LDOs
    [Magnetorquer Board.brd, Magnetorquer Board.sch]
2017-09-25 ADCS/MT: Routed LDOs and cleaned up schematic
    [Magnetorquer Board.brd, Magnetorquer Board.sch]
2017-09-25 Added LT8330 Boost/SEPIC/Inverting Regulator
2017-09-25 Added PMEG6010CEJ Schottky Diode
2017-09-25 ADCS/MT: Start building SEPIC converter topology
    [Magnetorquer Board.brd, Magnetorquer Board.sch]
2017-09-25 ADCS/GPS: Minimize use of read callback
    Doing too much in the read callback seems to put the buffer out of sync. This still needs some work.
    [gps.c, gps.h]
2017-09-26 Core/Misc: Changed default settings in ss_TEST/ss_TEMPLATE to generate the "TI TXT" hex output as a normal build output (in addition to what is built today). This paves the way to load those into ima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
2017-09-26 New placeholder folder for team ground segment.
    Near term, will hold info on the COSMOS targets and infrastructure (keeping the 'COSMOS' folder mapped directly atop the COSMOS main folder on an active installation of COSMOS. Yes, we'll have to copy stuff over back and forth ... yay.
2017-09-26 Ground/COSMOS: Initial checkin of COSMOS demo projects
    Yes, it's a lot of files. Sorry.
    [ConfigTables_def.txt, EventAction.csv, MCConfigurationTable_fsw1_def.txt, MCConfigurationTable_fsw2_def.txt, McConfigTable.csv, McConfigTable_def.txt, diamond.STL, sequence.tsv]
2017-09-26 ADCS/RW: Change motor bracket footprint
2017-09-26 ADCS/RW: Update RW bracket in drawing
    [motor_board.brd, motor_board.sch]
2017-09-26 Add LT8335 Switching Regulator
2017-09-26 Core/General: Started master compute module list
    Here we will determine the exact compute element identity, so we can start baking that into the shared libraries and configuration and full-stack build scripts.
    [ComputeModuleList.csv]
2017-09-27 ADCS: Added Design block for LT8335 SEPIC configured at 6V
2017-09-27 ADCS/MT: Rerouted with new power converter
    [Magnetorquer Board.brd, Magnetorquer Board.sch]
2017-09-27 Ground/COSMOS: Created Arduino-based set of tests
    This is a simple demo to experiment with several aspects of COSMOS. We will then move those to the MSP430, then start adding functionality.
2017-09-27 Add SEPIC converter and connect to one motor
    [motor_board.brd, motor_board.sch]
2017-09-28 Ground/COSMOS: Further experiments with other settings
    Added multiple commands, other stuff. Will next move Arduino code to the MSP430 and test for any new issues in our UART framework.
    [BlinkMOS.ino]
2017-09-28 ADCS/RW: Connect motor power traces and verify DRC
    [motor_board.brd]
2017-09-28 ADCS/RW: Widen some small traces to pass DRC
    [motor_board.brd]
2017-09-28 Move LT8335 6V buck converter block to general
2017-09-28 Remove old LT8335 6V buck converter block
2017-09-28 ADCS/MT: Move magnetorquer board to the engineering model folder
    [magnetorquer_board.brd, magnetorquer_board.sch]
2017-09-28 ADCS/RW: Rename to something more specific
    [reaction_wheel_board.brd, reaction_wheel_board.sch]
2017-09-28 ADCS/MT: Move some vias out from under pads and do a DRC
    [magnetorquer_board.brd]
2017-09-29 Ground/COSMOS: Added sync pattern for more reliable telemetry reads; added experimental MATLAB target
2017-09-29 Ground/COSMOS: Added another target for providing reaction wheel data stream for testing.
2017-09-29 ADCS/IMU: Add design block for LSM6DSM
2017-09-29 ADCS/Estimator: Add LSM6DSM to estimator board (unconnected)
    [estimator_board.brd, estimator_board.sch]
2017-09-30 UART and COSMOS [!!BC!!]: Debug mode enums renamed. Changes to UART, RWS to support usage with COSMOS, and added RWS test COSMOS target. __INITIAL_DEBUG_MODE__ added for forcing a specific mode from 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
2017-09-30 Ground/COSMOS + Misc [!!BC!!]: debugRegisterEntity no longer takes pathchar (2nd param), it is stashed in an array in debugtools.c/.h. If you want to add a new entity type, please do so there and let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
    [bsp.c, debugtools.c, debugtools.h, rw.c, rw.h, rws_test_main.c, uart.c, utils.h]
2017-10-01 Ground/COSMOS: Significant (but hopefully not breaking) changes made to support COSMOS-driven commanding. Still working through bugs, but it's a good start.
    [debugtools.c, debugtools.h, rw.c, rw.h, rws_test_main.c]
2017-10-01 Ground/COSMOS: Fixed stupidity bug with the state machine for the COSMOS-friendly telemetry mode.
    [debugtools.c]
2017-10-01 Ground/COSMOS: First ruby test script (closely increments reaction wheel setpoint for PID tests). Works great, and three lines of code!
2017-10-01 Ground & Core: Fixed to binary telemetry mode (echo was forced on, which was ticking off COSMOS); other tweaks.
    [debugtools.c]
2017-10-02 Ground/Misc: Various helpers, COSMOS tweaks; changed RW commanding struct, plan to eventually consolidate into single command packet with all parameters; added purdy RW telem screen, with limits.
2017-10-02 ADCS/RW: Add hall outputs to GPIO
    [reaction_wheel_board.brd, reaction_wheel_board.sch]
2017-10-03 Change to Solar cell mounting procedure
2017-10-03 Tracking solar panel 3D models from fusion 360.
    [Center panel V1.3.brd v1.step, side panel V5.1 v1.step, side panel V5.1.brd v2.step]
2017-10-03 Minor change to 2 layer gerber generator
2017-10-03 Correcting location of Temp sensor breakout gerbers
    [mounted temp sensor breakout board V1.GBL, mounted temp sensor breakout board V1.GBO, mounted temp sensor breakout board V1.GBP, mounted temp sensor breakout board V1.GBS, mounted temp sensor breakout board V1.GTL, mounted temp sensor breakout board V1.GTO, mounted temp sensor breakout board V1.GTP, mounted temp sensor breakout board V1.GTS]
2017-10-03 Documenting battery module/holder info.
    [Battery Holder Other Side.DXF, Battery Holder Other Side.STEP, Battery Holder.DXF, Battery Holder.STEP]
2017-10-03 Renaming Battery Board V4.1-simple signals to just V4.1
    [Battery board V4.1.brd, Battery board V4.1.sch]
2017-10-03 Tracking solar cell stencil, .brd, gerbers, and v1.2
    [Solar cell stencil V1.2.brd, Solar cell stencil.brd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]
2017-10-03 Changes to Center Panel V1.2, Tracking V1.3, and gerbers of V1.3
    [Center panel V1.3.brd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]
2017-10-03 Tracking Side Panel V5.1 and V5.3, and moving Side Panel V5.x and associated files to it's own folder seperate from V4.
    [Solar 5 cell V4_fixed_footprint.brd, Solar 5 cell V4_fixed_footprint.sch, side panel V5.1.brd, side panel V5.1.sch, side panel V5.2.brd, side panel V5.2.sch, side panel V5.brd, side panel V5.dxf]
2017-10-03 Tracking Battery board V4.2 and V4.3 and parts list.
    [Battery board V4 Parts list.xlsx, Battery board V4.2.brd, Battery board V4.2.sch, Battery board V4.3.brd, Battery board V4.3.sch]
2017-10-03 Storing Zip folder for BQ29209 breakout board gerbers
2017-10-03 Adding READMEs to finished boards
2017-10-03 Documenting Power Mosfet trade study and breakout board
    [Mosfet switch options breakout board.brd, Mosfet switch options breakout board.sch]
2017-10-03 Moving extrenous documents.
    [solar_panel_center_PCB.DXF]
2017-10-03 Documenting Adresses for sensors that connect to Pwr gen board msp
    [sensor addresses.xlsx]
2017-10-04 Ground/COSMOS: Added "last command" info to telemetry, for chasing down UART race condition bug.
    [SUBSYSTEMNAME_main.c, debugtools.c, rw.c, rw.h, rws_test_main.c]
2017-10-04 Ground/COSMOS: Starting list backchannel telemetry items that all subsystems should share.
    [BackchannelTelemetry.csv]
2017-10-04 Core/UART: [!!BC: uartInit() now takes third parameter, an enum that chooses between three speeds. Since the debug UART is setup by the core library code, to change from the default speed there (115.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
2017-10-04 Ground/COSMOS: Tweaks to test project, settings.
2017-10-06 Ground/COSMOS: Added new target to extra V/I/P info from all three channels on the programmable Rigol power supply. Nifty.
2017-10-06 Ground/COSMOS: Setup for using chained cmd/tlm servers, helps with scaling UI (particularly telemetry viewers/graphers) out to multiple machines from the central server.
2017-10-06 finished estimator_board
    [estimator_board.brd, estimator_board.sch]
2017-10-06 Resize pad on footprint basde on measured size
2017-10-07 ADCS/GPS: Update uart and debug calls
2017-10-07 Ground/COSMOS: Moving installation forward to COSMOS 4.0.3.
2017-10-07 Core/CAN: Kvaser CAN API headers and import libs, needed for all language bindings (except Python, which is separate).
    [canlib.h, canstat.h, j1587lib.h, kvaDbLib.h, kvaMemoLibXML.h, kvlclib.h, kvmlib.h, kvrlib.h]
2017-10-07 Ground/CAN: Starting project to create the CAN<->COSMOS link, using the Kvaser APIs. Sorry, this is using Visual Studio (free 2017 Community edition, specifically). Solution/project files should have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
2017-10-08 Ground/Core: First prototype of CAN->TCP converter. Python implementation currently, needs to at least be re-written so that the CAN and sockert layers merge at a lower architectural level ... but li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
2017-10-08 Ground/Core: CAN to TCP bridge working (though still all-Python, which needs to change at some point). New "CANTEST" target added to experimental COSMOS config, hard-wired to look for a particular CA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
2017-10-08 ADCS/RW: Finish routing motor hall sensor traces 👏
    [reaction_wheel_board.brd]
2017-10-10 Ground/COSMOS: Added support for SCPI access to multimeter, to gauge actual vs. calculated wheel RPM. This uses the new Python "bridge" technique, obviating the need to poll the DM from within the Ru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
    [fiddle.py]
2017-10-10 ADCS/RW: Upload reaction wheel bracket footprint
    [RW03 - Reaction Wheel Bracket Footprint.DXF]
2017-10-10 ADCS/RW: Added new reaction wheel bracket footprint
2017-10-11 ADCS/RW: Start moving drivers around to accomodate bracket
    [reaction_wheel_board.brd, reaction_wheel_board.sch]
2017-10-11 added the burn resistor
2017-10-12 ADCS/GPS: Eliminate race condition
    Previously, if a new message came in from uart while the last one was still being parsed, the new message would be skipped. These changes add messages to a queue to avoid this problem. This might create out-of-memory bugs down the line.
2017-10-12 Ground/COSMOS: Tweak
2017-10-13 ADCS/RW: Remove Solidworks watermark
    [RW03 - Reaction Wheel Bracket Footprint.DXF]
2017-10-13 ADCS/RW: Revert reaction wheel board to commit with hall traces
    [reaction_wheel_board.brd, reaction_wheel_board.sch]
2017-10-13 ADCS/RW: Make some room for the new motor bracket
    [reaction_wheel_board.brd, reaction_wheel_board.sch]
2017-10-13 ADCS/RW: Tie ENABLE pins high on LDOs
    [reaction_wheel_board.sch]
2017-10-13 ADCS/RW: Tie LDO ENABLE input high
    [reaction_wheel_board.sch]
2017-10-13 ADCS/RW: Remove motor hall hookups to MSP430 😭😭😭
    [reaction_wheel_board.brd]
2017-10-14 ADCS/Sun Sensor: MATLAB test script for driving sensor. NOTE: based on other I2C device tests, but hasn't been tested on this sensor yet as I couldn't find connectors to actually work with the sensor.
2017-10-14 Added photodiode ADC (LTC2481) libraries and test file. Issues: i2c initialization hangs unless stepped through in debug mode. Calling voltage and temperature functions sequentially will result in in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
    [photodiode_test_main.c]
2017-10-14 ADCS/RW: Add new smoothing capacitors to LDOs
    [reaction_wheel_board.brd, reaction_wheel_board.sch]
2017-10-15 Ground/Test Infrastructure: Scribbled MATLAB tests for getting VISA interface to Rigol bench instruments working. NOTE, not a "real" script, just a capture of command history working throughy connect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
2017-10-15 ADCS/Photodiode: Fix to make key variables local to file (naming conflicting with all other I2C components)
2017-10-15 Core/I2C: Initial checkin of test project for feature work.
2017-10-15 Minor changes to battery board V4.3 and tracking V4.4 with battery ballancer fix in progress/
    [Battery board V4.4.brd, Battery board V4.4.sch]
2017-10-15 Documenting Pico-lock order request.
2017-10-15 uploading alternate version of Solar cell stencil
    [Solar cell stencil V1.1.brd]
2017-10-15 EPS/Docu: uploading 3D files for battery board
    [BATTERY_PACK.f3d, Batery Pack v3 v7 v1.step, Fusion Batery Pack v3 v5.step]
2017-10-15 EPS / Solar Panels: uploading zip file of ordered center panlel Gerbers.
    [Center panel V1.3.brd]
2017-10-15 EPS / Testing: Uploading testing logs for Distribution board and Battery Ballancer
2017-10-15 Core/I2C: Function name changes, function additions (stubbed), tweaks to testbed code.
2017-10-16 Testing/General: Notes on what applications/drivers need to be install on HSL lab/testing machines to make them work properly with the HVVT infrastructure.
2017-10-17 EPS / Battery board: Re-routed Balancer and added silkscreen for orgonization.
    [Battery board V4.4.brd]
2017-10-18 EPS / Battery board: Set design rules and fixed clearance errors.
    [Battery board V4.4.brd, Battery board V4.4.sch]
2017-10-18 EPS / Battery board: Fixed distances between all vias to .3mm minimum
    [Battery board V4.4.brd]
2017-10-19 EPS / Battery board: Uploaded gerbers for ordered version of V4
    [Battery board V4.4.GBL, Battery board V4.4.GBO, Battery board V4.4.GBP, Battery board V4.4.GBS, Battery board V4.4.GTL, Battery board V4.4.GTO, Battery board V4.4.GTP, Battery board V4.4.GTS]
2017-10-19 EPS / General: Added Distribution switch to Design block library
2017-10-19 Fixed boo-boo in canheadertest
    [CANCHeaderTest.py]
2017-10-20 General: updated resource usage chart (specifically, added notes for various timers in use in some subsystems or all library code).
2017-10-21 ADCS/GPS: Update CAN outputs
    Removed std dev.
    [CAN Message Ideas.csv]
2017-10-21 Fixed bugs in C generator
    [CANCHeaderTest.py, canwrap.c, canwrap.h, test.c]
2017-10-21 EPS / Solar cell: adding step file for mounting plate
    [Solar Panel Plate.STEP]
2017-10-21 Core/I2C: Moving towards multi-device, multi-bus ...
2017-10-22 ADCS/MT: Add capacitor to VBAT
    [magnetorquer_board.brd, magnetorquer_board.sch]
2017-10-22 Ground/COSMOS: Created new "CAN_LOCAL" target for COSMOS, uses the PCAN Ethernet gateway to successfully listen to all CAN traffic on the flat sat CAN bus.
2017-10-22 Core/I2C: Added dev handles to API (non-functional so far); totall refactored read/write functions, now have a clean public API and the guts are all shared in "i2cCore..." functions that can be maint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
2017-10-23 Core/I2C: Dual-bus, multi-device support feature complete. Works with a single device on the normal (I2C #2 bus, the only one available on LaunchPads), but haven't tested extensively beyond that.
2017-10-23 Ground/COSMOS: Cleaning up COSMOS file repo (specifically: keep ../outputs/handbooks, ...saved_config, and ..tables, remove everything else).
2017-10-23 ADCS: Add LT 8335 SEPIC converter breakout
    [8335-breakout.brd, 8335-breakout.sch]
2017-10-24 ADCS/IMU: Cleanup of the IMU library to use the LSM6DSM. Setting up to confirm multi-device support on the I2C bus.
2017-10-25 ADCS/GPS: Prepare for integration with COSMOS
    Populated a bunch of binary telemetry structs.
    This also moves almost everthing to a seperate gps.h in preparation for sharing the MSP with other sensors.
2017-10-26 PPT/Software: Adding enum/entity entries for the PPT (plus some other fixes).
    [debugtools.c, debugtools.h, imu.c, systeminfo.h]
2017-10-26 PPT/Software: Loose ends from new project.
    [SUBSYSTEMNAME_main.c]
2017-10-26 Ground/COSMOS: .gitignore tweak to ignore certain saved_configs
2017-10-26 Multi-threaded socket server working.
2017-10-28 Created eagle board for front photodiode sensor
    [photodiode front.brd, photodiode front.sch]
2017-10-29 ADCS/Sun Sensor: MATLAB script for checking out angle output from sun sensor.
2017-10-29 Fixed front photodiode board
    [photodiode front.brd, photodiode front.sch]
2017-10-29 Photodiode front board changes: same hole locations as before, 2x extra picolock connectors to go to side boards, capacitors changed from 0603 to 0805, smoothing capacitors moved next to power input 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
    [photodiode front.brd, photodiode front.sch]
2017-10-30 Adddesign blocks for 3v3 and 5V LDO
2017-10-30 ADCS/RW: Clean up/reinforce LDOs
    [reaction_wheel_board.brd, reaction_wheel_board.sch]
2017-10-30 ADCS/GPS: Start laying out GPS board
    [gps_and_sensor_board.brd, gps_and_sensor_board.sch]
2017-10-30 ADCS/Photodiodes: Change copper pour type
    [photodiode front.brd]
2017-10-30 ADCS/Photodiodes: A few aesthetic tweaks
    [photodiode front.brd, photodiode front.sch]
2017-10-30 ADCS/MT: Switched existing LDOs to LDOs from design blocks
    [magnetorquer_board.brd, magnetorquer_board.sch]
2017-10-30 ADCS/GPS: Added LDOs from design blocks and added connectors
    [gps_and_sensor_board.brd, gps_and_sensor_board.sch]
2017-10-31 EPS / distribution board: uploading data from overcurrent protection test
2017-11-01 Ground/COSMOS: Add/tweak helper test scripts.
2017-11-03 ADCS/MT: Clean up for DRC
    [magnetorquer_board.brd, magnetorquer_board.sch]
2017-11-04 Add a Molex logo silkscreen logo and create logos library
2017-11-04 ADCS/GPS: Added a silly polygon
    [gps_and_sensor_board.brd]
2017-11-04 Add initial sun sensor library
2017-11-04 ADCS/Sun Sensor: Fix parsing errors
    It seems to read correctly now. Had to fix off-by-one errors on the length and offsets. Also fixed how I'm reading floats.
    [sun_sensor.c]
2017-11-04 removed device board_template_rahs. device board_template now has 3 versions: the original, secured (which has enlargened corners), and rahs
2017-11-04 Updated with full module list.
    [ComputeModuleList.csv]
2017-11-04 ADCS: Fix broken git remote
    [gps_and_sensor_board.brd, gps_and_sensor_board.sch, magnetorquer_board.brd, magnetorquer_board.sch, photodiode front.brd, photodiode front.sch, reaction_wheel_board.brd, reaction_wheel_board.sch]
2017-11-05 Ground/COSMOS: Clean up
2017-11-06 ADCS: Add SEPIC converter breakout and migrate SEPIC block to general
    [LT8335_6V.brd, LT8335_6V.sch]
2017-11-06 General Timer first draft with setTime and endTime
2017-11-06 Core/Timers: small fixup to macros that might cause issues
2017-11-06 Ground/COSMOS: re-adding some files that apparently went poof.
2017-11-06 Add LTC3624 buck converter
2017-11-06 Add 3v3 buck converter design block
2017-11-06 ADCS/GPS: Add 3v3 buck converter to GPS board
    [gps_and_sensor_board.brd, gps_and_sensor_board.sch]
2017-11-07 Replace largest capacitor with a 1206 package
2017-11-07 ADCS/GPS: USe updated LTC3624 design block
    [gps_and_sensor_board.brd, gps_and_sensor_board.sch]
2017-11-07 ADCS/GPS: Add GPIO hookups to MSP for buck converter
    [gps_and_sensor_board.brd, gps_and_sensor_board.sch]
2017-11-07 ADCS/GPS: Replace GPS part with new one and more layout
    [gps_and_sensor_board.brd, gps_and_sensor_board.sch]
2017-11-08 ADCS/GPS: Finish routing/designing GPS board
    [gps_and_sensor_board.brd, gps_and_sensor_board.sch]
2017-11-08 added two new capacitors to eagle library moved estimator, photodiode_center, and magetorquer board to their own foldr and created gerbers for them
    [estimator_board.GBL, estimator_board.GBO, estimator_board.GBP, estimator_board.GBS, estimator_board.GTL, estimator_board.GTO, estimator_board.GTP, estimator_board.GTS]
2017-11-08 Core/Analog: Test project, working out parameters/setting for single sensor. Also skeleton for multi-device
2017-11-09 EPS / Distribution board: pushing changes to test log.
2017-11-09 adding RF front end PCB design
    [RFfrontend_v3.brd, RFfrontend_v3.sch, RFfrontend_v4.brd, RFfrontend_v4.sch]
2017-11-09 Design block / switch: made TPS25927 into design block.
2017-11-09 Re-add 3v3 and 5v LDO design blocks
2017-11-09 ADCS/GPS: Update components with new labels and design blocks
    [gps_and_sensor_board.brd, gps_and_sensor_board.sch]
2017-11-11 Ground/COSMOS: Fixing COSMOS version lock info, mangled in merge.
2017-11-11 Core: Cleanup old file that was reintroduced (?) - looks like photodiode.c replaces it (and has the correct I2C API version)
2017-11-12 ADCS/GPS: Re-add GPS after master-pushing debacle
    [gps_and_sensor_board.brd, gps_and_sensor_board.sch]
2017-11-12 ADCS/GPS: Add Molex logo
    [gps_and_sensor_board.brd, gps_and_sensor_board.sch]
2017-11-12 Add newest versions of voltage converter design blocks
2017-11-12 Re-add LTC3624 buck converter after I borked master
2017-11-12 ADCS/GPS: Fix connectors to match new library version
    [gps_and_sensor_board.brd, gps_and_sensor_board.sch]
2017-11-12 ADCS/GPS: Add values to some unlabeled capacitors
    [gps_and_sensor_board.brd, gps_and_sensor_board.sch]
2017-11-12 ADCS/MT: PCB revision
    [magnetorquer_board.brd, magnetorquer_board.sch]
2017-11-12 ADCS/RW: Add more smoothing capacitors to SEPIC output
    [reaction_wheel_board.brd, reaction_wheel_board.sch]
2017-11-12 Add more smoothing capacitors to SEPIC output
2017-11-12 ADCS/MT: Rename 'magnetorquer_board' to 'magnetorquer'
    [magnetorquer_board.GBL, magnetorquer_board.GBO, magnetorquer_board.GBP, magnetorquer_board.GBS, magnetorquer_board.GTL, magnetorquer_board.GTO, magnetorquer_board.GTP, magnetorquer_board.GTS]
2017-11-12 ADCS: Move un-foldered engineering boards to folders
    [gps_and_sensor_board.brd, gps_and_sensor_board.sch, photodiode.brd, photodiode.sch, reaction_wheel_board.brd, reaction_wheel_board.sch]
2017-11-12 ADCS/Sensors: Rename connectors for clarity
    [gps_and_sensor_board.brd, gps_and_sensor_board.sch]
2017-11-16 ADCS: Reorganize engineering model board structure
    [estimator_board.GBL, estimator_board.GBO, estimator_board.GBP, estimator_board.GBS, estimator_board.GTL, estimator_board.GTO, estimator_board.GTP, estimator_board.GTS]
2017-11-16 ADCS/GPS: Add power switch and route most connections
    [gps_and_sensor_board.brd, gps_and_sensor_board.sch]
2017-11-18 chaged S008 package name to SOT-23-8 rebuilt INA219 device to prepare for making design block for it
2017-11-19 INA219 current measurement design block
    [INA219_design_block_buildin.brd, INA219_design_block_buildin.sch]
2017-11-19 added new power switch to library. added design block for generic power switch and power switch with combined shunt and Pi filter
2017-11-21 ADCS/GPS: Add bulk capacitors and a GPS switch
    [gps_and_sensor_board.brd, gps_and_sensor_board.sch]
2017-11-22 power sensors; rename project
    Gave the project a better name, since we are not limited to INA 219s.
2017-11-22 Debugged Can Buffer Clearing Problem
    #SprintGoals
    [SUBSYSTEMNAME_main.c, can.c]
2017-11-23 CAN DBC Based filters in CANWrap work.
2017-11-24 ADCS/FSW: Finish reorganizing MSP432 board
    [flight_computer_board.brd, flight_computer_board.sch]
2017-11-24 ADCS/FSW: Route BDOT with new changes
    [flight_computer_board.brd, flight_computer_board.sch]
2017-11-25 Ground/COSMOS: Updating to COSMOS 4.1.0 (which includes Ruby 2.2->2.4 mandatory move).
2017-11-25 Ground/COSMOS: Fixing security issue.
2017-11-25 Tested functional photodiode code to support addressing multiple boards. Issue: code must be stepped through during initialization to avoid hanging on i2cWaitReadyToTransmitByte()
    [photodiode.c, photodiode.h, photodiode_test_main.c]
2017-11-26 Fixed bugs with weird types, added ENUM support
    [CANCHeaderTest.py]
2017-11-28 added timer project
2017-12-01 eagle library updates: -updated board template secured to have chamfered corners -removed bottom silk screan text on PC104 boards since this hasn't been helpful ever -renamed some inductors
2017-12-02 ADCS/GPS: Fix bugs with hwmonitor
    - fix the temperature reading (was printing struct)
    - add missing measurement to hwmonitor
    - update status messages to be hardware-specific
    [gps.c]
2017-12-02 Git is confused about case sensitivity on the LDO design blocks
2017-12-02 Readding compoonents with case sensitivity options
2017-12-02 ADCS/FSW: Add LDOs to the FSW board
    [flight_computer_board.brd, flight_computer_board.sch]
2017-12-04 ADCS/FSW: Finish routing flight software board engineering model 🎉
    [flight_computer_board.brd]
2017-12-05 Eagle updates: design blocks for LDOs updated, battery holders added, high power and low power switch design blocks , PC104 connector updates, LED description added on MSP-CAN block
2017-12-05 ADCS/FSW: Add LEDs to the BDOT MSP430
    [flight_computer_board.brd, flight_computer_board.sch]
2017-12-05 ADCS/RW: Rearrange circuit to make room for bracket
    [reaction_wheel_board.brd, reaction_wheel_board.sch]
2017-12-05 ADCS/RW: Add LEDs to RW board
    [reaction_wheel_board.brd, reaction_wheel_board.sch]
2017-12-05 ADCS/RW: Add debugging outputs for FG and PWM
    [reaction_wheel_board.brd, reaction_wheel_board.sch]
2017-12-06 ADCS/RW: Add results of DRC
    [reaction_wheel_board.brd, reaction_wheel_board.sch]
2017-12-06 ADCS/GPS: Fix COSMOS serial interface (it's case sensitive!)
2017-12-06 Added support for CAN floats, custom message lengths, fixed bugs
    [CANCHeaderTest.py, SUBSYSTEMNAME_main.c, canwrap.c, canwrap.h]
2017-12-06 update dataArray.h for new features
    resetAvg
    resetMinMax
    keep min/max/avg untill resetAll
    [dataArray.h]
2017-12-06 Updated code to connect to and read from two photodiode boards on a common bus
2017-12-08 added anode board, other minor updates
    [anode_board.GBL, anode_board.GBO, anode_board.GBP, anode_board.GBS, anode_board.GTL, anode_board.GTO, anode_board.GTP, anode_board.GTS]
2017-12-08 Minor CAN Bug Fixes
    [canwrap.c, canwrap.h]
2017-12-10 ADCS/MT: Update LDO and PC104 stack board
    [magnetorquer_board.brd, magnetorquer_board.sch]
2017-12-10 added another board template used for motherboard. added design blocks used in making motherboard, distribution board, and generation board. added generation and distribution board
    [distribution_board_v3.GBL, distribution_board_v3.GBO, distribution_board_v3.GBP, distribution_board_v3.GBS, distribution_board_v3.GTL, distribution_board_v3.GTO, distribution_board_v3.GTP, distribution_board_v3.GTS]
2017-12-10 ADCS/MT: Update LDOs and stack board
    [flight_computer_board.brd, flight_computer_board.sch]
2017-12-10 ADCS/GPS: Replace switches with event handlers
    [gps.c, gps.h]
2017-12-10 Update 6V SEPIC with a less noisy topology
2017-12-10 ADCS/RW: Include new SEPIC layout
    [reaction_wheel_board.brd, reaction_wheel_board.sch]
2017-12-10 Update stack labels to omit unused ADCS 3v3/5V rails
2017-12-10 ADCS/MT: Reconnect to stack and use new SEPIC layout
    [magnetorquer_board.brd, magnetorquer_board.sch]
2017-12-10 ADCS/Sensors: Reconnect to stack
    [gps_and_sensor_board.brd, gps_and_sensor_board.sch]
2017-12-10 Add better power trace for intermediate converter stage
2017-12-10 ADCS: Switch to new SEPIC layout
    [magnetorquer_board.brd, reaction_wheel_board.brd, reaction_wheel_board.sch]
2017-12-12 ADCS/Sensors: Add another capacitor to buck converter
    [gps_and_sensor_board.brd, gps_and_sensor_board.sch]
2017-12-13 small changes to component values for distribution and generation board
    [distribution_board_v3.brd, distribution_board_v3.sch, generation_board_v5.brd, generation_board_v5.sch]
2017-12-14 ADCS/GPD: Add capacitor values for GPS buffer
    [gps_and_sensor_board.brd, gps_and_sensor_board.sch]
2017-12-18 minor updates to distribution board
    [distribution_board_v3.sch]
2017-12-19 ADCS/RW: Relocate the reaction wheel bracket from off the board
    [reaction_wheel_board.brd]
2017-12-19 ADCS/FSW: Fix labeling of I2C device jumpers
    [flight_computer_board.brd]
2017-12-19 Changes to battery board V4.4 (Out of date)
    [Battery board V4.4.brd, Battery board V4.4.sch]
2017-12-19 EPS/ dist board: Testing log for distribution board V2
2017-12-19 EPS/ old panels: Remove ground plane and changed temp sensor to TMP36
    [Center panel V1.3.brd, Center panel V1.3.sch, side panel V5.2.brd, side panel V5.2.sch]
2017-12-19 General/ intro projects: stashing intro project boards.
    [ADC.brd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]
2017-12-19 EPS/ design block: added solar panel's temp sensor with convinient connection to pico-lock connector
2017-12-19 EPS/ battery board: V5 of battery board!
    [Battery Board V5 2 layer.brd, Battery Board V5 2 layer.sch, Battery Board V5 4 layer.brd, Battery Board V5 4 layer.sch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]
2017-12-19 EPS/ battery board: stashing a bunch of useful 3D step files for battery board components
    [92398A112_TWIST-RESISTANT PRESS-FIT INSERT FOR PLASTICS.STEP, Battery Holder Left Side.stl, Battery Holder Right side.stl]
2017-12-19 EPS/ Documentation: uploaded a bunch of documentation.
    [Coulomb counter Accuracy vs current.xlsx, Power system data outputs.xlsx]
2017-12-19 EPS / Documentation: Documenting purchase requests
    [Hex inserts purchase request.xlsx, INA219 breakout purchase request.xlsx, Intro projects + temp sensor.xls, RTV162 and silver sheet purchase request.xlsx, RTV162 purchase request.xlsx, Through hole temp sensors.xlsx, silver sheet purchase request.xlsx]
2017-12-19 EPS/ Power gen: documenting attemts at a mppt algorythm in matlab
2017-12-19 EPS / panels: removed ground plane and changed temp sensor to TMP36
    [Center panel V2.brd, Center panel V2.sch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]
2017-12-19 deleted some out of date files
    [estimator_board.GBL, estimator_board.GBO, estimator_board.GBP, estimator_board.GBS, estimator_board.GTL, estimator_board.GTO, estimator_board.GTP, estimator_board.GTS]
2017-12-20 deleted old gerber files as they're now outdated since file name version aren't being used
    [magnetorquer_board.GBL, magnetorquer_board.GBO, magnetorquer_board.GBP, magnetorquer_board.GBS, magnetorquer_board.GTL, magnetorquer_board.GTO, magnetorquer_board.GTP, magnetorquer_board.GTS]
2017-12-20 EPS/Sensors: INA219 wrapper moved into dsbase, finished basic single instrument bus and shunt voltage reads, confirmed correct with multimeter/power supply inputs.
    [INA219_pcvsensor.h, pcvsensor.c, pcvsensor.h]
2017-12-20 EPS/Sensors: Multi-device support added, up to 16(!) INA219's.
2017-12-20 EPS/Sensors: on-chip current now calculated, matches external calculations without having to wait for the floating point math to happen on the 430.
2017-12-21 made gerbers for adcs boards
    [flight_computer_board.GBL, flight_computer_board.GBO, flight_computer_board.GBP, flight_computer_board.GBS, flight_computer_board.GTL, flight_computer_board.GTO, flight_computer_board.GTP, flight_computer_board.GTS]
2017-12-21 updated i2c address on distribution board
    [distribution_board_v3.brd, distribution_board_v3.sch]
2017-12-21 Core: Change default printf/floating point handling in the template to FULL so we don't keep wasting time with debugging issues.
2017-12-22 Core/AnalogSensors: New test using built-in temp sensor to work out kinks before generalizing. Blocking single-shot call implemented for temp, will expand out to async next.
2017-12-23 Core/Sensors: Added calibration factors for the temp sensor under different reference voltages.
2017-12-23 EPS/Software: Distribution board v0.5 - can enable/disable power domains, beginnings of code for other functionality.
2017-12-23 Core/I2C: "Fixed" off-by-one error in read length, manifesting itself by an extra byte tacked onto "combined" read/writes.
    [i2c.c]
2017-12-23 EPS/Software: Scans all channels, proper voltage/current reporting. Enables/disables all channels as well (though no logic hooked up to do so in response to observed draw).
2017-12-26 EPS/Debugging: Added COSMOS telemetry for reading current (or whatever).
2017-12-26 EPS/Sensors: Added ability to specify what values to read from sensor (few values means faster reads).
2017-12-27 EPS/Sensors: Added COSMOS commanding for the power domain channels, plus cleaned up other helpers.
2017-12-28 fixed component values
    [generation_board_v5.brd, generation_board_v5.sch]
2017-12-28 Core: Stubbing out mission elapsed timer for non-critical timing needs.
2017-12-28 EPS/Debug: Switch state sniffing, other features for COSMOS.
2017-12-28 ADCS/RW: Update some net and component names
    [reaction_wheel_board.brd, reaction_wheel_board.sch]
2017-12-29 EPS/Dist: Distribution board core software. Watches power domain currents on all domains at 10Hz, COSMOS commanding and telem available.
2017-12-29 EPS/Core: Added current monitoring and overcurrent protection via software monitoring INA's. Works with COSMOS now.
2017-12-29 Gave each compute node/module correct general identifiers
    This change matches the DS1Ops change that updates the STATE ... _shared_mod_ids.txt file, so that modules can be identified properly.
    [ComputeModuleList.csv]
2017-12-29 Tweaks
    Cleaned up empty first line.
    [ComputeModuleList.csv]
2017-12-29 EPS/Ground: Added ability to easily change all the thresholds for the power domains, and tracking for that (useful for testing).
2017-12-31 Core/AnalogSensor: Almost there, just pesky bug fixes now.
    [analogsensor.c, analogsensor.h, eps_dist_main.c]
2017-12-31 EPS / battery board: uploaded V6
    [Battery Board V6.GBL, Battery Board V6.GBO, Battery Board V6.GBP, Battery Board V6.GBS, Battery Board V6.GTL, Battery Board V6.GTO, Battery Board V6.GTP, Battery Board V6.GTS]
2017-12-31 EPS / devmods: Uploaded Coulomb counter driver.
2017-12-31 Core/Analog Sensors: refactored API, fixed ENC enable/disable bug that was hosing everything else, mostly done at this point.
    [analogsensor.c, analogsensor.h, pcvsensor.c, photodiode.h]
2018-01-01 Sensors/Analog: Fixed several bugs where temp sensor would lose settings; centralized conversion logic; added asensor "types" (internal temp, external temp with TMP-36, or straight voltage)
    [analogsensor.c, analogsensor.h]
2018-01-02 EPS/Dist: Bus voltage monitoring; batt voltage and auto-shutdown at threshold; more internal temp hooks added; added cleaner interface for indicating which measurements to get from INA; added support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
2018-01-03 Various: added subsystem-specific BSP code (means "now running on engineering board"); lots of EPS telemetry and default tweaks; added skeletons for Gen and Batt boards. Cleaned up oldest (garbage) s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
2018-01-03 Deployment: Working with gang programmer, trying to test to get a script that will flash 3 boards automatically in sequence.
2018-01-03 Added keepout zones to picolock connectors
2018-01-03 ADCS/RW: Move debug LED out from under Picolock connector 😞
    [reaction_wheel_board.brd, reaction_wheel_board.sch]
2018-01-04 Core/Deployment: Added scripts for gathering binaries from each subsystem module, putting them in one place (and committing them to source control), and running scripts against the GANG programmer to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
    [eps_batt_main.c, eps_dist_main.c, eps_gen_main.c]
2018-01-05 ADCS/GPS: Added hookup for serial line
    [gps_and_sensor_board.brd, gps_and_sensor_board.sch]
2018-01-05 Core: Added HW/SW key/lock comparisons at BSP initialization; if the software is loaded onto a chipID it doesn't recognize, it will not run normally and instead emit a complaint every 3 seconds via C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
    [bsp.c, bsp.h, debugtools.c, debugtools.h, eps_dist_main.c]
2018-01-05 EPS / Batery Board: Start of V7 which has no changes from V6 except a more presentable schematic
    [Battery Board V7.brd, Battery Board V7.sch]
2018-01-06 Core: Clean-up old or wrong stuff.
    [rw.c]
2018-01-06 Core: Fully HWSW and COM matching lock checks implemented. Also UART bus status mostly working as well, will likely add more info to it at some point, plus TIMESTAMPS.
2018-01-06 ADCS/GPS: Add debug header near edge of board
    [gps_and_sensor_board.brd, gps_and_sensor_board.sch]
2018-01-06 ADCS/GPS: Updated outdated library components
    [gps_and_sensor_board.brd, gps_and_sensor_board.sch]
2018-01-06 ADCS/IMU: Add 26Hz option
2018-01-06 ADCS/Magnetorquer: Create project
2018-01-06 EPS: Bringing EPS table flatsat online with most recent images. Added "B" dist board ID
2018-01-06 ADCS/Sun Sensor: Move code to dsbase
2018-01-07 ADCS/SensorProc: added some defines/constants
2018-01-07 Misc: Aardvark I2C/HIL testing, other misc.
2018-01-07 ADCS/GPS: Remove printf requirement
    Sorry again for breaking every build
2018-01-07 ADCS/SENSORPROC: Add template project to ssmods
2018-01-07 Tweaks to have predefined symbols and flatsat connection numbers included
    [ComputeModuleList.csv]
2018-01-07 More fleshing out of module list.
    [ComputeModuleList.csv]
2018-01-07 Ugh again.
    [ComputeModuleList.csv]
2018-01-07 Last changes, I promise.
    [ComputeModuleList.csv]
2018-01-07 ADCS/GPS: Move gps code to sensorproc module
2018-01-07 ADCS/GPS: Fix initial subsystem state
    [adcs_sensorproc_main.c]
2018-01-08 ADCS: Add sun sensor and gps enable command
2018-01-08 Deployment: temporarily turned off HW/SW checks until we have all the keys in place for this round of boards; moved gen board to the right deployment script for the gang programmers.
2018-01-09 Sensors: Stubbed out the functions for dealing with external temp sensors.
2018-01-09 EPS/Gen Board: Stubbing out code for gen board, includes definitions for IO and beginnings of initialization
2018-01-09 EPS/Gen: temporarily disabling INA setup/reads as board I2C bus non-operative (no pull ups)
2018-01-10 ADCS: Send gps power state and sun sensor data
2018-01-10 ADCS/GPS: Add LED to GPIO 3.5
    [gps_and_sensor_board.brd, gps_and_sensor_board.sch]
2018-01-10 ADCS/GPS: Add debug header for GPS UART, PV, and RESET pins
    [gps_and_sensor_board.brd, gps_and_sensor_board.sch]
2018-01-10 ADCS/GPS: Add debug jumpers for all I2C devices
    [gps_and_sensor_board.brd, gps_and_sensor_board.sch]
2018-01-10 ADCS/MT: Add LED to GPIO 3.5
    [magnetorquer_board.brd, magnetorquer_board.sch]
2018-01-10 minor changes
    [distribution_board_v3.brd, generation_board_v5.brd, generation_board_v5.sch]
2018-01-10 ADCS/GPS: Add additional smoothing capacitor before sensors
    [gps_and_sensor_board.brd, gps_and_sensor_board.sch]
2018-01-10 ADCS/GPS: Update GPS footprint and begin rerouting
    [gps_and_sensor_board.brd, gps_and_sensor_board.sch]
2018-01-11 General: All subsystem module projects have been created, correct predefined subsystem symbol for each. HW/SW keying still off.
    [adcs_bdot.h, adcs_bdot_main.c, adcs_estim.h, adcs_estim_main.c, adcs_mpc.h, adcs_mpc_main.c, adcs_mtq.h, adcs_mtq_main.c]
2018-01-11 ADCS/GPS: Add input capacitance to 3v3 buck
    [gps_and_sensor_board.brd, gps_and_sensor_board.sch]
2018-01-11 ADCS/GPS: Add some smoothing capacitors to GPS switch
    [gps_and_sensor_board.brd, gps_and_sensor_board.sch]
2018-01-11 ADCS/GPS: Route connections to GPS header
    [gps_and_sensor_board.brd, gps_and_sensor_board.sch]
2018-01-11 ADCS/GPS: Route connections to GPS switch output capacitor
    [gps_and_sensor_board.brd]
2018-01-11 ADCS/GPS: Add pulldown to GPS switch input
    [gps_and_sensor_board.brd, gps_and_sensor_board.sch]
2018-01-11 ADCS/GPS: Clean up some weird traces
    [gps_and_sensor_board.brd]
2018-01-11 ADCS/GPS: Switch naming scheme for archival of purchased boards
    [gps_and_sensor_20171211.brd, gps_and_sensor_20171211.sch, gps_and_sensor_20180111.brd, gps_and_sensor_20180111.sch, gps_and_sensor_CURRENT.brd, gps_and_sensor_CURRENT.sch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]
2018-01-12 made gerber files. added a resistor
    [gps_and_sensor_CURRENT.GBL, gps_and_sensor_CURRENT.GBO, gps_and_sensor_CURRENT.GBP, gps_and_sensor_CURRENT.GBS, gps_and_sensor_CURRENT.GTL, gps_and_sensor_CURRENT.GTO, gps_and_sensor_CURRENT.GTP, gps_and_sensor_CURRENT.GTS]
2018-01-15 adding propulsion charge board to git
    [anode_board.GBL, anode_board.GBO, anode_board.GBP, anode_board.GBS, anode_board.GTL, anode_board.GTO, anode_board.GTP, anode_board.GTS]
2018-01-16 ADCS/GPS: Relocate antenna keepout zone
2018-01-16 ADCS/GPS: Relocate GPS LNA keepout zone
    [gps_and_sensor_CURRENT.brd, gps_and_sensor_CURRENT.sch]
2018-01-16 Power: Some unstaged purchase request that someone put in my folder
    [Intro projects + temp sensor.xls]
2018-01-17 ADCS/GPS: Fix tx overrun
    Also added health telemetry and LED.
    [adcs_sensorproc.h, adcs_sensorproc_main.c]
2018-01-17 ADCS/GPS: Log software errors to backchannel
    [adcs_sensorproc.h, adcs_sensorproc_main.c, gps.c, gps.h]
2018-01-20 ADCS/GPS: Add project to test power switch
2018-01-20 ADCS/GPS: WIP buffered reader (totally broken)
    [BufferedReader.c, BufferedReader.h, gps.c, gps.h]
2018-01-20 ADCS/GPS: Add buck enable to switch experiment
2018-01-20 ADCS/GPS: Alternate buck/gps enable/disable states
    For experiment
2018-01-23 ADCS/GPS: Consolidate GPS files and optimize memory
    -- Some telemetry segments now share memory
    -- Replaced "handlers" with switch statements. This saves memory and elimates the possibility of runtime registration errors.
    [adcs_sensorproc.h, adcs_sensorproc_main.c, crc.c, crc.h, gps.c, gps.h]
2018-01-23 ADCS/GPS: Fix garbage data in range telemetry
    [adcs_sensorproc_main.c]
2018-01-24 ADCS/GPS: Fix out-of-order measurements
    [adcs_sensorproc.h, adcs_sensorproc_main.c, gps.h]
2018-01-27 Add SMD connectors for U.FL and MMCX
2018-01-27 ADCS/GPS: Make adapter board for antenna to GPS
    [antenna_adapter.brd, antenna_adapter.sch]
2018-01-28 ADCS/GPS: Read buck converter status
2018-01-28 ADCS/GPS: Check buck status when enabling GPS
2018-01-28 updated photodiode library. No longer uses floating point operations, enabled gain settings, added addresses for all 6 boards
    [photodiode.c, photodiode.h, photodiode_test_main.c]
2018-01-28 ADCS/RW: start dated versioning of boards
    [reaction_wheel_board_2017_12_11.brd, reaction_wheel_board_2017_12_11.sch, reaction_wheel_board_CURRENT.brd, reaction_wheel_board_CURRENT.sch]
2018-01-28 ADCS/FSW: started dated versioning of boards
    [flight_computer_board_2017_12_11.brd, flight_computer_board_2017_12_11.sch, flight_computer_board_CURRENT.brd, flight_computer_board_CURRENT.sch]
2018-01-28 ADCS/MT: started dated versioning of boards
    [magnetorquer_board.GBL, magnetorquer_board.GBO, magnetorquer_board.GBP, magnetorquer_board.GBS, magnetorquer_board.GTL, magnetorquer_board.GTO, magnetorquer_board.GTP, magnetorquer_board.GTS]
2018-01-28 ADCS/PHOTODIODE: started dated versioning of boards
    [photodiode front.GBL, photodiode front.GBO, photodiode front.GBP, photodiode front.GBS, photodiode front.GTL, photodiode front.GTO, photodiode front.GTP, photodiode front.GTS]
2018-01-28 ADCS/RW: more version name updates
    [reaction_wheel_board.GBL, reaction_wheel_board.GBO, reaction_wheel_board.GBP, reaction_wheel_board.GBS, reaction_wheel_board.GTL, reaction_wheel_board.GTO, reaction_wheel_board.GTP, reaction_wheel_board.GTS]
2018-01-28 ADCS/RW: Add updated reaction wheel footprint
    [RW01 - RW Board Assy Rev02 Footprint.DXF, RW03 - Reaction Wheel Bracket Footprint.DXF]
2018-01-29 ADCS/Sensor Proc.: Add photodiode support
    Very buggy. Hangs on i2cWaitForStartComplete unless there is a breakpoint just before the photodiode read.
    [adcs_sensorproc.h, adcs_sensorproc_main.c]
2018-01-29 ADCS/RW: Update reaction wheel footprint
2018-01-29 ADCS/RW: Add new reaction wheel footprint to board
    [reaction_wheel_board_CURRENT.brd, reaction_wheel_board_CURRENT.sch]
2018-01-29 ADCS/RW: Fix scaling
    [RW01 - RW Board Assy Rev02 Footprint.DXF, RW03 - Reaction Wheel Bracket Footprint.DXF]
2018-01-29 ADCS/Sensor proc.: Shuffle functions around
2018-01-29 ADCS/Sensor proc.: Add msp temp CAN packet
    Also removed dumb memory "optimization"
2018-01-29 ADCS/Sensor proc.: Send CAN packets
2018-01-30 ADCS/Sensor proc.: Fix units on CAN messages
    [adcs_sensorproc.h, adcs_sensorproc_main.c]
2018-01-30 ADCS/GPS: Disable interrupts when reading from rx buffer
2018-01-30 added center solar panel and made CAN design block
    [Center panel V3.brd, Center panel V3.sch]
2018-02-04 ADCS/FSW: Add on-board documentation
    [flight_computer_board_CURRENT.brd, flight_computer_board_CURRENT.sch]
2018-02-04 ADCS/Sensor proc.: Make I2C bus configurable
    Launchpads use I2CBus2 but the sensor board uses I2CBus1.
2018-02-04 "Fix" for crappy I2C interface to the photodiodes - thanks Linear, you guys suck
    [photodiode.c]
2018-02-04 CDH/DataAnalysis: Testing code and Define
    Created testing framework for testing math library. Incorporated testing code previously written by TinTin into Unity framework and added a few other tests. Added define macro to make it type compatible in the future.
2018-02-07 Sensors/Magtom: fixed hard-wired I2C bus instance
    [magnetometer.c, magnetometer.h]
2018-02-09 ADCS/GPS: Rename gerbers to match proper board version
2018-02-09 ADCS/GPS: Rename to standardized part value naming scheme
    [gps_and_sensor_CURRENT.brd, gps_and_sensor_CURRENT.sch]
2018-02-11 ADCS/Sensors: Photodiode library investigation project.
2018-02-11 move timer to core
2018-02-11 ADCS/Sensor proc.: Move GPS IO
2018-02-11 ADCS/Sensor proc.: Refactor sensors to seperate files
2018-02-11 deleting timer junk
2018-02-11 DBC file sign fix
    [CANDB-MASTER-DS1.ini]
2018-02-14 ADCS/GPS: Extend ground plane
    [antenna_adapter.brd]
2018-02-14 ADCS/IMU: Add second slave address
2018-02-15 ADCS/IMU: Add board B test results
2018-02-17 ADCS/GPS: Grow ground plane in coupler board
    [antenna_adapter.brd]
2018-02-17 Core/Analog Sensors: Fixed stupid bug, added interrupt enable in bspInit
    [analogsensor.c, bsp.c]
2018-02-17 EPS/Gen: Added commanding for enabling/disabling charging, and confirmation telemetry forthe switch state on enabling. The charging input pins to the MSP (from the PTs) are being read, but are not ye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
2018-02-17 ADCS/GPS: Revise GPS antenna coupler with new footprints
    [antenna_adapter.brd, antenna_adapter.sch]
2018-02-18 EPS / code: Pushing coulomb_counter driver to dsbase. (attempt #1)
2018-02-19 EPS/Batt: Added Jaime's initial battery balancer enable and supporting code.
2018-02-20 EPS/Batt: core COSMOS stuff in place, streaming balancer and heater state and commands for turning on/off. Sensor packets partially defined, just need to filled in. Also tweak to asensor behavior.
2018-02-21 ADCS/GPS: TX/RX flip
    [gps_and_sensor_CURRENT.brd, gps_and_sensor_CURRENT.sch]
2018-02-22 Minor fix to dbc py generator
    [CANCHeaderTest.py, canwrap.c]
2018-02-22 ADCS/GPS: "Fix" hardware monitor log
    The timed poll for the HWMONITOR log is unresponsive, so I'm calling its log manually instead.
    Also added some quality of life improvements for debugging.
    [adcs_sensorproc_main.c, gps.c]
2018-02-22 Fix canwrap genereator again
    [CANCHeaderTest.py, canwrap.c]
2018-02-22 handshake verified. MTQ code for PWM test
2018-02-22 ADCS/IMU: Add board A test results
2018-02-23 ADCS/GPS: Add simple power project
    This is a copy of the ss_ADCS_SENSORPROC module that just turns the GPS on but doesn't attempt to configure it.
    [adcs_sensorproc_ids.h]
2018-02-24 PPT; changed to timer B, added and removed timing spaces as necessary
2018-02-25 PPT: sync pulse before first fire, fixed stop fire cmd, pin interrupts disabled when not firing
    [PPT.h, PPT_main.c]
2018-02-25 PPT: reverted disabling pin interrupts b/c it causes problems
    [PPT_main.c]
2018-02-26 EPS/Batt: fixed header inclusions
    [eps_batt_main.c]
2018-02-26 Deployment: cached current previbe builds of EPS modules.
2018-02-26 EPS / code: added rough accumulated charge measurement to the coulomb counter
2018-02-26 Added interface for canwrap filter (push w/ implementation pending test)
2018-02-28 ADCS/GPS: Don't power on GPS by default
2018-03-02 Core: added (minimal) infrastructure for counting resets of each MSP
    [bsp.c, bsp.h, eps_batt_main.c, eps_dist_main.c, eps_gen_main.c]
2018-03-02 EPS/ BATT: added heater and balancer state reads, added battcharge measurement, removed "Isballance"
2018-03-03 ADCS/GPS: Fix resistor values for buck converter
    [gps_and_sensor_CURRENT.brd, gps_and_sensor_CURRENT.sch]
2018-03-07 Implemented Filter API
2018-03-07 ADCS/IMU: Add final pre-vibe test
2018-03-07 Made filters work with currnet DBC Setup so subteams can test
2018-03-11 ADCS/GPS: Add RESET and !PGOOD to state machine
    [gps.c, gps.h]
2018-03-11 ADCS/GPS: Remove redundant power project
2018-03-11 ADCS/GPS: Add buck converter status override
2018-03-13 Added 3D packages to the PICOLOCK connectors linked to the cubesat autodesk
2018-03-13 Components library: Added 3D model to board template. (P.S. See Aaron or Sean to learn new 3D eagle parts process before attempting to contribute)
2018-03-13 EPS code: Fixed conversion errors in coulomb counter driver
    [coulomb_counter.c, coulomb_counter.h]
2018-03-13 ADCS/RW: Add 3D reaction wheel bracket
2018-03-15 added capacitor 0805 3d model
2018-03-16 ADCS/RW: Clean up schematic
    [reaction_wheel_board_CURRENT.brd, reaction_wheel_board_CURRENT.sch]
2018-03-16 ADCS/GPS: Add reset status and buck override command
    [adcs_sensorproc_ids.h]
2018-03-16 ADCS/RW: Update LDO capacitor values
    [reaction_wheel_board_CURRENT.brd, reaction_wheel_board_CURRENT.sch]
2018-03-17 Timer with comments/procedure
2018-03-17 timer with comments
2018-03-17 ADCS/IMU: Add postvibe test results
2018-03-17 ADCS/GPS: Replace some counters with timers
    [adcs_sensorproc_main.c]
2018-03-19 ADCS/GPS: Add timers and refactor fsm (again)
2018-03-19 ADCS/Sensor proc.: Add photodiode timer
    One less way I2C can kill us now 🤞
2018-03-19 Additions to timer
2018-03-19 ADCS/Sensor proc.: Initialize timer library for photodiodes
2018-03-19 ADCS/GPS: Fix timer leaks
    [adcs_sensorproc_main.c]
2018-03-20 ADCS/IMU: Add simple test for thermal
2018-03-20 Ruby control of PS_DP832A power supply
2018-03-21 Added functions to the timer
2018-03-22 EPS / batt board: Added temp sensor read/
2018-03-22 ADCS/IMU: Add test project
2018-03-23 ADCS/Photodiodes: Use timer conversion function
2018-03-23 ADCS/Sensor proc.: Use timer conversion function
2018-03-23 ADCS/GPS: Ignore buck timer when not overridden
2018-03-23 ADCS/Sensor proc.: Add testing commands
    Also updates hwmonitor telemetry
2018-03-24 eps / batt board: Fixes to gpio enable/disable
    [eps_batt_main.c]
2018-03-24 ADCS/GPS: Fix timing bug
    [adcs_sensorproc_main.c, gps.h]
2018-03-24 ADCS/Sensors: Create flight-model sensor board
    [gps_and_sensor_2018_03_24.brd, gps_and_sensor_2018_03_24.sch]
2018-03-24 ADCS/Sensor proc.: Fix photodiode timer bug
    [adcs_sensorproc_main.c, photodiode.c]
2018-03-24 ADCS/Sensor: Use picolock with more connectors and reformat component values
    [gps_and_sensor_2018_03_24.brd, gps_and_sensor_2018_03_24.sch]
2018-03-25 ADCS/BDOT: Fix reversed magnetometer labels
    [flight_computer_board_CURRENT.brd]
2018-03-25 ADCS/Sensor: Added pin documentation
    [gps_and_sensor_2018_03_24.brd]
2018-03-25 ADCS/Photodiodes: Add timer test project
2018-03-25 Add timer tests
2018-03-25 ADCS/MT: Relabel component values and tidy up schematic
    [magnetorquer_board_CURRENT.brd, magnetorquer_board_CURRENT.sch]
2018-03-25 ADCS/MT: Add on-board documentation
    [magnetorquer_board_CURRENT.brd]
2018-03-25 ADCS/MT: Remove SEPIC converter
    [magnetorquer_board_CURRENT.brd, magnetorquer_board_CURRENT.sch]
2018-03-25 ADCS/Sensor proc.: Fix memory issue
    [gps.h]
2018-03-27 EPS battery board: Added more debuging information for cosmos. Reworked coulomb counter confugure function.
    [coulomb_counter.c, coulomb_counter.h, eps_batt.h, eps_batt_main.c]
2018-03-28 ADCS/Sensor proc.: Optimize memory
    RAM utilization is 99%, but now 500 bytes of that is for big GPS messages.
2018-03-29 ADCS/Sensor proc.: Refactor to use less casting
    Less ugly with the same memory footprint.
2018-03-29 added code to allow heater to regulate temp
2018-03-29 ADCS/Sensor proc.: Refactor to ease descope
    Sensors are now less coupled to the board
2018-03-29 fixed a brief typo that would have been an issue
    [eps_batt.h]
2018-03-29 added code to make the PPT fire on powerup, fixed reported charging time
    [PPT_main.c]
2018-03-29 ADCS/Sensor proc.: Add simple mag and imu interfaces
2018-03-30 EPS / Battery board: debugged coulomb counter
2018-03-30 EPS / battery code: debegged heater logic
2018-03-30 added logic to toggle heater only on crossing the defined thresholds
2018-03-31 ADCS/Sensor proc.: Refactor to use fewer timers
2018-03-31 ADCS/Sensor proc.: Send raw magnetometer readings
2018-03-31 ADCS/Sensor proc.: Add second magnetometer
2018-04-01 ADCS/Sensor proc.: Minimize changes to magnetometer code
    RIP 44 bytes of memory
2018-04-01 Added power supply orbit sim
2018-04-03 fixed a few bugs. ready 4 degauss testing
    [adcs_mtq.h, adcs_mtq_main.c]
2018-04-03 fixed a bug that might prevent the battery heater triggering, added a 30min delay to dist startup
    [eps_batt_main.c, eps_dist_main.c]
2018-04-03 made the dist board startup wait persistent
2018-04-04 added MET and a minor fix to batt
    [MET.c, MET.h, eps_batt_main.c]
2018-04-06 Added Gen Board packets to DBC
2018-04-06 changed logic to support driver chopping mode everywhere
2018-04-07 added MET init to BSP, added time persistence for dist, added PPT logic to charge w/o firing, removed sending sync1 on last PPT fire, added single fire/stop fire to high/low of pin 1.5, added handlin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
2018-04-08 Fixed Sun Sensor enums
    Now 11/12 from 17/18
    [canwrap.c, canwrap.h]
2018-04-08 ADCS/Sensor proc.: Descope harder
    The previous commit broke my build, so RIP the dream of un-descoping GPS with a macro.
    [adcs_sensorproc_main.c, mag_io.c]
2018-04-10 ADCS/FSW: Run simulation
    I had to move the stack (7 KB) into FRAM and turn off the MPU to get this to work, and only at 1.5 Hz. This would probably run much faster if we reduce the stack to < 3KB and move it back into SRAM.
2018-04-10 Filters redesigned with new Class system.
    [CANCHeaderTest.py, canwrap.c, test.c]
2018-04-12 EPS / Code: fixed accumulated charge calibration check.
    [coulomb_counter.c]
2018-04-13 updated shunt resistance values w/ TWO digits of precision
2018-04-14 ADCS/Sensor proc.: Add autocode to existing framework
2018-04-14 ADCS/Sensor: Add flight model design with single IMU
    [gps_and_sensor_CURRENT.brd, gps_and_sensor_CURRENT.sch]
2018-04-14 ADCS/Sensor: Add magnetometer design block
2018-04-14 ADCS: Duplicate most recent engineering model boards for flight model
    [flight_computer_board_CURRENT.brd, flight_computer_board_CURRENT.sch, magnetorquer_board_CURRENT.brd, magnetorquer_board_CURRENT.sch]
2018-04-14 ADCS/Sensor: Add silkscreen for sun sensor jumper and sever IMU connection
    [gps_and_sensor_CURRENT.brd]
2018-04-14 ADCS/Sensor: Add jumper connections to sensors
    [gps_and_sensor_CURRENT.brd, gps_and_sensor_CURRENT.sch]
2018-04-14 Files renamed to reflect current date
    [flight_computer_board_2018_04_14.brd, flight_computer_board_2018_04_14.sch, gps_and_sensor_2018_04_14.brd, gps_and_sensor_2018_04_14.sch, magnetorquer_board_2018_04_14.brd, magnetorquer_board_2018_04_14.sch]
2018-04-15 ADCS/Sensor proc.: Fix callback and mag2 typo
    [adcs_sensorproc_main.c, mag_io.c]
2018-04-15 ADCS/Sensor proc.: Update to autocode with all 4 sensors
2018-04-15 ADCS/Sensor proc.: Update dbc with new sensors
2018-04-15 ADCS/Sensor proc.: Prevent duplicate readings
    [adcs_sensorproc_main.c]
2018-04-15 integrated sensorproc packets
2018-04-15 added dist power doimain stats
2018-04-16 ADCS/Sensor proc.: Mock sensor readings and send over CAN
2018-04-16 ADCS/Sensor: Rename board files and reconnect second magnetometer ti I2C bus 2
    [sensor_f1.brd, sensor_f1.sch]
2018-04-16 ADCS: Rename boards to be consistent with global naming scheme
    [flight_computer_board_f1.brd, flight_computer_board_f1.sch, magnetorquer_board_f1.brd, magnetorquer_board_f1.sch]
2018-04-16 ADCS/MT: Delete ferrocores
    [magnetorquer_board_f1.brd, magnetorquer_board_f1.sch]
2018-04-16 ADCS/FSW: Add debug header and LEDs to 430
    [flight_computer_board_f1.brd, flight_computer_board_f1.sch]
2018-04-17 ADCS/MT: Add stack hookups for X/Y aircore magnetorquers
    [magnetorquer_board_f1.brd, magnetorquer_board_f1.sch]
2018-04-17 ADCS/MT: Allocate 8 stack pins for magnetorquers
2018-04-17 ADCS/MT: Move buck converter and clean up stray traces
    [magnetorquer_board_f1.brd, magnetorquer_board_f1.sch]
2018-04-17 adding gen and dist boards
    [distribution_board_f1.GBL, distribution_board_f1.GBO, distribution_board_f1.GBP, distribution_board_f1.GBS, distribution_board_f1.GTL, distribution_board_f1.GTO, distribution_board_f1.GTP, distribution_board_f1.GTS]
2018-04-17 fixed folder structure
    [distribution_board_f1.GBL, distribution_board_f1.GBO, distribution_board_f1.GBP, distribution_board_f1.GBS, distribution_board_f1.GTL, distribution_board_f1.GTO, distribution_board_f1.GTP, distribution_board_f1.GTS]
2018-04-17 added gen board gerbers and bringing over all flight COM2 boards
    [FeedAssembly_v1.brd, FeedAssembly_v1.dxf, FeedAssembly_v1.iges, FeedAssembly_v1.step, RFfrontend_v3.brd, RFfrontend_v3.sch, RFfrontend_v4.brd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]
2018-04-17 ADCS/MT: Add new magnetorquer extension board
    [magnetorquer_extension_board_f1.brd, magnetorquer_extension_board_f1.sch]
2018-04-17 ADCS/MT: Swap some magnetorquer extension pins
2018-04-17 ADCS/MT: Complete magnetorquer extension board
    [magnetorquer_extension_board_f1.brd, magnetorquer_extension_board_f1.sch]
2018-04-17 ADCS/MT: Put silkscreen on the right layer
2018-04-17 ADCS/MT: Update aircore magnetorquer footprint to reflect library fix
    [magnetorquer_extension_board_f1.brd, magnetorquer_extension_board_f1.sch]
2018-04-17 ADCS/Sensor: Rotate IMU and fix layers for silkscreen
    [sensor_f1.brd]
2018-04-17 added undervoltage spike protection for dist, changed undervoltage powerdown to only happen at the threshold (so that we can manually enable domains in undervoltage)
2018-04-18 EPS / Batt: Updated battery board with Flight changes
    [Battery_Board_f1.brd, Battery_Board_f1.sch]
2018-04-18 CAN Filter filters reflect rx_classes in nodes in CAN Packet Reqs sheet
2018-04-18 added high power LDO design block
2018-04-18 Bdot code outdated version: bdot controlls magnetorquer duty cycle
2018-04-18 ADCS/Sensor proc.: Use 40Hz updaate with fewer steps
2018-04-19 ADCS/MT: Remove SYNC traces
    [magnetorquer_board_f1.brd, magnetorquer_board_f1.sch]
2018-04-19 ADCS/MT: Reconnect CAN
    [magnetorquer_board_f1.brd]
2018-04-19 ADCS/MT: Properly connect buck converter and reposition smoothing capacitors on H-Bridge
    [magnetorquer_board_f1.brd, magnetorquer_board_f1.sch]
2018-04-19 updated gen board: rerouted 3.3V for shorter length, added via for deploy_en, added double vias for critical 3.3V route, made new gerbers
    [generation_board_f1.brd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]
2018-04-19 updated picolock connectors
    [distribution_board_f1.brd]
2018-04-19 added umbilical and com2 connector
    [magnetorquer_extension_board_f1.brd, magnetorquer_extension_board_f1.sch]
2018-04-19 reviewed sensor board. converted to 4 layers for improved full ground plane
    [sensor_f1.GBL, sensor_f1.GBO, sensor_f1.GBP, sensor_f1.GBS, sensor_f1.GTL, sensor_f1.GTO, sensor_f1.GTP, sensor_f1.GTS]
2018-04-20 PC104 connector change: switched X and Y pin assignments, MQT board: converted to 4 layer board, layer 4 GND, previous layer 2 traces moved to new layer 2; added X and Y MQT outputs; added 3x LDOs
    [magnetorquer_board_f1.brd, magnetorquer_board_f1.sch, magnetorquer_extension_board_f1.sch]
2018-04-20 ADCS/FSW: Remove SYNC connections to BDOT
    [flight_computer_board_f1.brd, flight_computer_board_f1.sch]
2018-04-20 ADCS/FSW: Connect debug header and debug LEDs on secondary MSP430
    [flight_computer_board_f1.brd]
2018-04-20 ADCS/FSW: Add CAN hookups to both MSP430s
    [flight_computer_board_f1.brd]
2018-04-20 ADCS/FSW: Add 3V3/5V microcontroller hookups
    [flight_computer_board_f1.brd]
2018-04-20 ADCS/FSW: Add informative silkscreen
    [flight_computer_board_f1.brd]
2018-04-20 ADCS/FSW: Double all power vias for reliability
    [flight_computer_board_f1.brd]
2018-04-21 Updating binaries ...
    [aardvark_thunk_pcwin64.obj]
2018-04-21 Fix MET and add conversion to seconds
    Thanks Garret
    [MET.c, MET.h, adcs_estim_main.c]
2018-04-22 DataAnalysis Changes. Overflow fixed
    [dataArray.c, dataArray.h]
2018-04-22 ADCS/Estim: Fix mock TLE
    [adcs_estim_main.c, tle.c, tle.h]
2018-04-22 ADCS/Sensor proc.: Fix units of sun sensor CAN packet
    [mag_io.c, sunsensor_io.c]
2018-04-22 Fix data type of imu/mag to be unsigned
2018-04-22 ADCS/FSW: Change font style on silkscreen
    [flight_computer_board_f1.brd]
2018-04-22 Added ADCS_state class to adcs_estim filter
2018-04-22 EPS / Flight: Made flight solar panels.
    [Center_Panel_f1.brd, Center_Panel_f1.sch, Side_Panel_f1.brd, Side_Panel_f1.sch]
2018-04-22 storing thermal test data
    [heater test arduino data processed.csv, heater test arduino data processed.xlsx, heater test board data processed.csv, heater test board data processed.xlsx]
2018-04-22 Added Solar cell resistor
2018-04-22 Added pad for bypas diode on center panel cell.
2018-04-23 EPS / flight: made dist board and schematic consistant.
    [distribution_board_f1.brd, distribution_board_f1.sch]
2018-04-23 added GERBERS for batt board
    [Battery_Board_f1.GBL, Battery_Board_f1.GBO, Battery_Board_f1.GBP, Battery_Board_f1.GBS, Battery_Board_f1.GTL, Battery_Board_f1.GTO, Battery_Board_f1.GTP, Battery_Board_f1.GTS]
2018-04-23 added gerbers for magnetorquer_extension_board
    [magnetorquer_extension_board_f1.GBL, magnetorquer_extension_board_f1.GBO, magnetorquer_extension_board_f1.GBP, magnetorquer_extension_board_f1.GBS, magnetorquer_extension_board_f1.GTL, magnetorquer_extension_board_f1.GTO, magnetorquer_extension_board_f1.GTP, magnetorquer_extension_board_f1.GTS]
2018-04-23 added GERBERs for flight computer
    [flight_computer_board_f1.GBL, flight_computer_board_f1.GBO, flight_computer_board_f1.GBP, flight_computer_board_f1.GBS, flight_computer_board_f1.GTL, flight_computer_board_f1.GTO, flight_computer_board_f1.GTP, flight_computer_board_f1.GTS]
2018-04-23 ADCS/MT: Add input capacitance on buck converter
    [magnetorquer_board_f1.brd, magnetorquer_board_f1.sch]
2018-04-23 ADCS/MT: Routing to accomodate new buck input capacitors
    [magnetorquer_board_f1.brd]
2018-04-23 ADCS/MT: Reconnect leg of CAN transceiver that somehow got unrouted
    [magnetorquer_board_f1.brd]
2018-04-23 ADCS/MT: Fix magnetorquer current output coils
    [magnetorquer_board_f1.brd, magnetorquer_board_f1.sch]
2018-04-23 added PPT charger board to source control and made gerbers.
    [full charger v5-3.brd, full charger v5-3.sch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]
2018-04-23 added LEDs to MQT board for Z coil current direction and made GERBERs
    [magnetorquer_board_f1.GBL, magnetorquer_board_f1.GBO, magnetorquer_board_f1.GBP, magnetorquer_board_f1.GBS, magnetorquer_board_f1.GTL, magnetorquer_board_f1.GTO, magnetorquer_board_f1.GTP, magnetorquer_board_f1.GTS]
2018-04-23 fixed distribution board. previous picolock library updating is broken. problem fixed by replacing with legacy part
    [distribution_board_f1.brd, distribution_board_f1.sch]
2018-04-23 added ressetable fuse for MSP430 and remade GERBERs
    [distribution_board_f1.GBL, distribution_board_f1.GBO, distribution_board_f1.GBP, distribution_board_f1.GBS, distribution_board_f1.GTL, distribution_board_f1.GTO, distribution_board_f1.GTP, distribution_board_f1.GTS]
2018-04-24 I2C fix for byte count issues ...
    [i2c.c]
2018-04-24 fixed min max of last charge
    [CANDB-MASTER-DS1.ini, canwrap.c, canwrap.h]
2018-04-24 added reset to COSMOS health packet
    [adcs_mtq.h, adcs_mtq_main.c]
2018-04-25 flight solar panels
    [Center_Panel_f1.brd, Center_Panel_f1.sch, Side_Panel_f1.brd, Side_Panel_f1.sch]
2018-04-25 Adding solar panel diode to library
2018-04-25 Added spot for external bypas diode in library component, and updated boards.
    [Center_Panel_f1.brd, Center_Panel_f1.sch]
2018-04-25 ADCS/Sensor proc.: Move autocode out of interrupt
2018-04-25 ADCS/Sensor proc.: Set IMU update rate to 52 Hz
2018-04-25 added p3.5 LED toggle
2018-04-25 put LED toggle in a difference place
2018-04-26 ADCS/Sensor proc.: Fix sun sensor validty and CAN conversion
    [sunsensor_io.c]
2018-04-26 Band-Aid for SPI not working.
    [spi.c]
2018-04-26 Spi interrupted by spi detection tool
2018-04-26 Added SPI Debug info
2018-04-26 Add callback to spi and a lock to prevent self-interrupt
    [can.c, spi.c, spi.h]
2018-04-26 Disable interrupts during SPI Transactions.
2018-04-26 Fix to last commit
    [can.c]
2018-04-28 ADCS/Sensor proc.: Do unit conversions
2018-04-28 ADCS/Estim: Read TLE over multiple passes
    This is kind of slow. It needs 2 of each packet to work. We should move to using a bit instead to prevent duplicates.
    [adcs_estim_main.c, tle.c, tle.h]
2018-04-28 ADCS/Sensor proc.: Send at 10 Hz
2018-04-28 ADCS/Sensor proc.: Remove duplicate mag packets
2018-04-29 thickened solar panel power traces and made GERBERs
    [Center_Panel_f1.GBL, Center_Panel_f1.GBO, Center_Panel_f1.GBP, Center_Panel_f1.GBS, Center_Panel_f1.GTL, Center_Panel_f1.GTO, Center_Panel_f1.GTP, Center_Panel_f1.GTS]
2018-04-29 Added RC_PPT frames and signals
2018-04-30 Fix I2C device index
    Using pBus->num_devices as an index for devices wasn't working with multiple buses. I added a new numDevices variable for the total number of devices acrosses all buses.
    [i2c.c]
2018-04-30 EPS/Dist: hardcoded sequenced startup of all power domains on initial boot.
2018-05-01 Manual fix from merge conflict devistation
    [canwrap.c, canwrap.h, test.c]
2018-05-01 Fixing DBC Mess pt 3
    [canwrap.c, canwrap.h, test.c]
2018-05-01 Fixing DBC Mess pt 4
    [canwrap.c, canwrap.h]
2018-05-01 fixed bdot death timer. added can filters
    [adcs_mtq_main.c]
2018-05-01 added the correct MET conversion functions
    [MET.c, MET.h]
2018-05-01 adding feed antenna mounting bracket
    [FeedAssembly_v1 DXF for flat mount2.dxf, FeedAssembly_v1 for flat mount 3.dxf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]
2018-05-01 moved power connector due to collision with aluminum on below board
    [ppt_full_charger_f1.GBL, ppt_full_charger_f1.GBO, ppt_full_charger_f1.GBP, ppt_full_charger_f1.GBS, ppt_full_charger_f1.GTL, ppt_full_charger_f1.GTO, ppt_full_charger_f1.GTP, ppt_full_charger_f1.GTS]
2018-05-01 adding PPT controller board
    [PPT_controller_flight1.GBL, PPT_controller_flight1.GBO, PPT_controller_flight1.GBP, PPT_controller_flight1.GBS, PPT_controller_flight1.GTL, PPT_controller_flight1.GTO, PPT_controller_flight1.GTP, PPT_controller_flight1.GTS]
2018-05-01 parsed data for hil
    [aardvark_thunk_pcwin64.obj]
2018-05-02 Fix IMU blunder
2018-05-03 Fix missing import in IMU
    [imu.c]
2018-05-03 ADCS/Sensor proc.: Process CSV into .dat files
2018-05-03 ADCS/Sensor proc.: Add sendMag script
2018-05-03 Implement Can Receive Error Check function
    [can.c, can.h]
2018-05-03 ADCS/Sensor proc.: Save data locally
2018-05-04 ADCS/Sensor proc.: Add sendIMU script
2018-05-04 ADCS/Sensor proc.: Add sendSun script
2018-05-04 ADCS/Sensor proc.: Flush slave read buffer
2018-05-04 ADCS/Sensor proc.: Only read if there is data ready
2018-05-04 ADCS/Sensor proc.: Fix async poll and index in scripts
2018-05-04 Moved rtOneStep out of timer interrupt to prevent can from hanging
    [adcs_bdot_main.c]
2018-05-04 Magtom: fix (again!) for both the rtonestep and Aardvark issue
    [adcs_bdot_main.c, adcs_mtq_main.c, imu.h, magnetometer.c]
2018-05-04 fixed gen board ags and added MET updating
    [eps_dist_main.c, eps_gen_main.c]
2018-05-04 Attempt to fix #135 Possibly was using incorrect mask.
    [CANCHeaderTest.py, canwrap.c]
2018-05-05 finished fixing gen rc to be uints
    [eps_gen_main.c]
2018-05-05 didn't save the file
    [eps_gen_main.c]
2018-05-05 a function name was wrong
    [MET.c]
2018-05-05 ADCS/Sensor proc.: Don't send I2C for testing
2018-05-05 deleted Reaction Wheels. Rest in peace
2018-05-05 Fixed bdot rollcall and updated canwrap
    [canwrap.c, canwrap.h, test.c]
2018-05-05 MTQ: timer initialization fix
    [adcs_mtq_main.c]
2018-05-05 added check bounds on timer library
2018-05-06 fixed rollcall sending too fast issue
    [adcs_bdot_main.c, adcs_mtq_main.c]
2018-05-06 Fixed duplicate rollcall issues
    [adcs_bdot_main.c]
2018-05-07 moved rollcall sending on gen to a function, commented out a problematic line #138
    [eps_gen_main.c]
2018-05-07 fixed timer intialization and rollcall ugliness. jk thanks garrett
    [adcs_mtq_main.c]
2018-05-07 moved timer function so it's no longer implicitly declared
    [timer.c]
2018-05-07 MTQ and Timer tweaks, to address flatsat hangs
2018-05-07 Fixed Dataarray update issues
    [dataArray.c]
2018-05-07 added timer handle typedef
2018-05-07 timer handle typdef change to timer.h
2018-05-07 updated: change all timerID to timer handle
2018-05-07 changed data type of timer handle
2018-05-08 ADCS/Sensor proc.: Update scripts for testing
2018-05-08 ADCS/Sensor proc.: Fix CAN types to be signed
2018-05-08 hil environment angular velocity and magnetic fields in .dat files
2018-05-08 Fixed the rollcall bug using the new dataArray changes #138
    [eps_gen_main.c]
2018-05-08 Matlab bdot: aardvark data combined with can bus
2018-05-08 ADCS/Sensor proc.: Fix mag byte order
2018-05-08 Fix for last commit
    [CANCHeaderTest.py, canwrap.c, canwrap.h]
2018-05-08 ADCS/Sensor proc.: Add sun plot and update script
2018-05-08 first hil voltage testy test mtq ya
2018-05-08 fixed rollcall sending #141
    [eps_dist_main.c]
2018-05-09 commented out rollcall and fixed dumb spelling mistake ....
    [adcs_mtq.h, adcs_mtq_main.c]
2018-05-09 Regenerated CAN Wrappers for correct mtq_ack length
    [canwrap.c]
2018-05-09 Fixed orphan rc_adcs_sp_gen_1_reset count signal
    [canwrap.c, canwrap.h, test.c]
2018-05-10 ADCS/Sensor proc.: Refactor and add roll call functions
2018-05-10 Added SP RC, Fixed MTQACK, Added RST count
    [canwrap.c, canwrap.h, test.c]
2018-05-10 ADCS/Sensor proc.: Add roll call packets
2018-05-10 fixed sp_rollcall min max issues
    [canwrap.c, canwrap.h]
2018-05-10 fixed mtq mismatched min and max
    [canwrap.c, canwrap.h, test.c]
2018-05-10 fixed bdot_tumble_Status wrong size
    [canwrap.c, canwrap.h]
2018-05-10 ADCS/Sensor proc.: Update sun sensor angles only when valid
2018-05-10 ADCS/Sensor proc.: Fix mag conversion factor
2018-05-10 ADCS/Sensor proc.: Add script to mock all bus 1 sensors
2018-05-11 added shutting off power domains if no rollcall response
2018-05-11 ADCS/Sensor proc.: Add script to fix path
2018-05-11 Fix averages when it would div by zero
    [agglib.c]
2018-05-11 got rid of enable command update and took bdot death timer out of interrupt
2018-05-11 EPS / battery board: fixed inconsistency issues.
    [Battery_Board_f1.brd, Battery_Board_f1.sch]
2018-05-11 oops fixed timout bug
    [adcs_mtq_main.c]
2018-05-11 ADCS/Sensor proc.: Migrate to agglib
2018-05-11 ADCS/Sensor proc.: Fix sun sensor validity update
    [sunsensor_io.c]
2018-05-11 didn't fix dataArray, but made it so that it would at least built
    [dataArray.c]
2018-05-11 temporarily removed the feature that shuts off power domains if no rc response
2018-05-12 fixed a bug where dist would send rollcall as fast as possible
    [eps_dist_main.c]
2018-05-12 Update Master Read to only doing 1 read for magnetometer and 1 read for temp
2018-05-12 Added estim and mpc/fsw packets (#157)
    * added adcs estim to dbc
    * added estim rollcall packets
    * fixed signage of estim sgp4 packet
    * Made it vectors not doubles
    * added mpc/fsw rollcall
    [canwrap.c, canwrap.h]
2018-05-12 Added dist frames and numbers for the signals
2018-05-12 ADCS/Sensor proc.: Update to work with new agglib
2018-05-13 ADCS/FSW: Fix board/schematic consistency break
    [flight_computer_board_f1.brd, flight_computer_board_f1.sch]
2018-05-13 MTQ: this appears to fix one or both of #142 or #162. We'll see ...
    [adcs_mtq_main.c]
2018-05-14 added error count to timer library
    [adcs_bdot_main.c, timer.c, timer.h]
2018-05-14 fixed batt rc sending, moved CAN init
    [eps_batt_main.c]
2018-05-15 Fixed duplicate frames error
    [canwrap.c, canwrap.h]
2018-05-15 added timer debug stuff
2018-05-15 Add script to mock bdot and sensor proc sensors together
2018-05-15 Fix ADCS sensors script to sort of work
2018-05-15 Make sensors script less annoying to use
    Loads faster and automatically determines enabled/disabled state based on which aardvarks are plugged in.
2018-05-15 Fix byte order in imu part of script
2018-05-15 Fix missing void and warnings in rollcall
    [rollcall.c]
2018-05-15 moved globals and prototypes to .h took out old rollcall
2018-05-15 ADCS: Switch mspTemp from float to int
2018-05-16 added mtq rollcall; doesn't actually update values
    [adcs_mtq.h, adcs_mtq_main.c, test.c]
2018-05-16 added meta back for uart
2018-05-16 timer bug
2018-05-17 fixed some warnings. about to test on flipsat.
    [adcs_mtq.h, adcs_mtq_main.c]
2018-05-17 ADCS/Sensor proc: Send missing rollcall packet 7
    [adcs_sensorproc_main.c]
2018-05-17 Enable sun and mag1 in sensors script
2018-05-17 bdot added another pin 3.4
2018-05-17 Fixed 3.4 high on EPS boards
    [eps_batt_main.c, eps_dist_main.c, eps_gen_main.c]
2018-05-17 ADCS/Sensor proc.: Pull P3.4 high to help fix phantom power
    [adcs_sensorproc_main.c]
2018-05-18 ADCS/Sensor proc.: Speed up LED
2018-05-18 Enable pullups in sensor script
2018-05-18 Add button to stop sendData while loop and close aardvarks
2018-05-19 added a function to read raw temperature values (uint16)
2018-05-19 added watchdog to dist, added rc debugging packet to dist, added rc framework
2018-05-19 fixed get avg error
    [adcs_bdot_main.c]
2018-05-19 ADCS: send raw temperature over CAN
2018-05-20 added msp temp and reset count to bdot rollcall
    [adcs_bdot_main.c]
2018-05-20 ADCS/Sensor proc.: Set mag valid bit
2018-05-20 ADCS/Sensor proc.: Add expected outputs to UDP
2018-05-21 Fix sun sensor output over UDP
2018-05-22 ADCS/Sensor proc.: Update autocode
2018-05-23 setting a dist threshold to 0.0 now does no change, added 60min dist reboot, added some more dist rc framing
    [eps_dist_main.c]
2018-05-25 ADCS/Sensor proc.: Revert to older compiler
2018-05-25 ADCS/Sensor proc.: Switch to the *correct* compiler
2018-05-26 added the safeRead macro to utils for volatile register reading, implemented safeRead in MET, preemptively fixed a bug in MET
    [MET.c, utils.h]
2018-05-26 ADCS/Sensor proc.: Use separate filtered mag outputs
2018-05-26 ADCS/Sensor proc.: Finish splitting mag outputs
2018-05-26 Clean up comment code in magnetometer source file. Implement bdot function of determining best magnetometer readings (Version 1)
2018-05-26 Garrett fixed timer
2018-05-26 flipped the maximum and minimum of the met and met overflow
    [canwrap.c, canwrap.h]
2018-05-26 ADCS/FSW: Fix sun vector unit conversion
    [adcs_mpc_main.c]
2018-05-26 new glitch filter and predfined symbols in magnetometer source file
    [adcs_bdot_main.obj, bdot_controller_lib.obj, bdot_controller_lib_data.obj, ert_main.obj]
2018-05-26 debug HIL
    [adcs_bdot_main.obj]
2018-05-26 ADCS/Sensor proc.: Use new HIL symbols
2018-05-26 added more stuff to bdot code
    [BufferedReader.obj, MET.obj, agglib.obj, analogsensor.obj, bsp.obj, can.obj, canwrap.obj, config_bus_uart.obj]
2018-05-26 fix comparison bug in magnetometer.c
    [magnetometer.c]
2018-05-26 Better Documentation within SPI Code
2018-05-26 ADCS/Sensor proc.: Send unfiltered mag input as output temporarily
2018-05-26 Note regarding magnetorquer buck converter solder bridge
2018-05-26 Add IMU glitch filter
    [imu.c, imu.h, imu_io.h]
2018-05-26 Add sun sensor glitch filter
    [imu.c, imu.h, sun_sensor.c]
2018-05-26 ADCS/Sensor proc.: Fix mag enable/disable
    [adcs_sensorproc_main.c, mag_io.c, mag_io.h]
2018-05-27 made changes on batt from SOC to acc charge
2018-05-27 ADCS/Sensor proc.: Lower IMU glitch threshold
    [imu.c, mag_io.h]
2018-05-27 fixed sensor proc rollcall
    [canwrap.c, canwrap.h]
2018-05-27 Prevent rollcall from populating packets too soon
    [rollcall.c]
2018-05-27 Removing stuff that shouldn't have ever been checked in, oops.
    [BufferedReader.obj, MET.obj, adcs_bdot_main.obj, agglib.obj, analogsensor.obj, bdot_controller_lib.obj, bdot_controller_lib_data.obj, bsp.obj]
2018-05-27 improvement on the magnetometer filter
    [BufferedReader.obj, MET.obj, adcs_bdot_main.obj, agglib.obj, analogsensor.obj, bdot_controller_lib.obj, bdot_controller_lib_data.obj, bsp.obj]
2018-05-27 Added more features to magnetometer filter including signed comparisons
2018-05-28 added cosmos commands for magnetometer selection
2018-05-29 ADCS/Sensor proc.: Update rollcall calls (still broken)
    [adcs_sensorproc_main.c]
2018-05-29 Added glitter count to help debug glitches for the magnetometer
    [magnetometer.c]
2018-05-29 bug in bdot found
    [adcs_bdot.h, adcs_bdot_main.c]
2018-05-30 bdot code that shows mag reading that is sent into rt onestep AND continuous 10hz readings
2018-05-30 ADCS/Sensor proc.: Update rollcall packets
2018-05-30 Set 3.4 pin high in ESTIM & FSW for backchannel fix
    [adcs_estim_main.c, adcs_mpc_main.c]
2018-05-31 ADCS/Sensor proc.: Tidy up and add documentation
2018-05-31 ADCS/Sensor proc.: Fix garbage CAN packets in rollcall
    [adcs_sensorproc_main.c]
2018-06-03 Make boards work before I leave
2018-06-03 Fix sensor proc units in dbc
2018-06-03 Fixed Filter for MPC
    [CANCHeaderTest.py, canwrap.c, canwrap.h]
2018-06-04 fixed rollcall 1 packets
    [canwrap.c, canwrap.h]
2018-06-09 fixed a bug on dist where Paul's fix doesn't work, cleaned up the code
    [eps_dist_main.c]
2018-06-10 AMSAT Test payload
    Pins 1.0, 1.1, 1.2, 1.3, 1.4, 1.5, 3.0, 3.1, 3.2, 3.3 are high. Bring 1.7 high for high speed packet transfer, bring 1.6 high for gnd_none, 3.7 for gnd_realtime, 3.6 for gnd_health, 2.2 for gnd_wod (no rahs packets exist yet)
2018-06-10 reorganize bdot code to add NAP feature, Magnetometer Testing mode, along with cosmos commands for nap and mag testing
2018-06-10 fixed id of cmd_gen_rst
    [canwrap.c, canwrap.h]
2018-06-10 added quite a few ground commands
2018-06-11 quick fix to gen backpwr
    [eps_gen_main.c]
2018-06-11 fixed can macro issue
    [can.c]
2018-06-11 fixed backpower on gen, minor changes to dist
    [eps_batt_main.c, eps_dist_main.c]
2018-06-12 fixed unit bug in timer, still has bugs in bdot code but board is flashing older version. Will fix tomorrow
    [adcs_bdot_main.c, timer.c, timer.h]
2018-06-12 made nap bug better/disappear
    [adcs_bdot_main.c]
2018-06-12 added a helper function to bsp for Paul's fix
    [bsp.c, bsp.h]
2018-06-13 changed the float compression to multiplication and division, initialized aggVecs in gen, added other temperature ags in dist
2018-06-14 deleted all commented out codes and set spam timer settings to be default values, not testing values
2018-06-15 added ground commands for bdot
2018-06-15 fixed spam bug in bdot's code
    [adcs_bdot.h, adcs_bdot_main.c, timer.c]
2018-06-15 added correct signage for eps rc
    [canwrap.c, canwrap.h]
2018-06-16 fixed references to rc_*_1_ packets
    [PPT_main.c, adcs_bdot_main.c, adcs_estim_main.c, adcs_mpc_main.c, adcs_mtq_main.c, adcs_sensorproc_main.c, canwrap.c, canwrap.h]
2018-06-17 Replace FSW axis aggregates with magnitude aggregates (#209)
    * added canrxerror to health packet 2
    * ADCS/FSW: Update omega rollcall
    For issue #195
    * Restore rollcall h2
    Not sure how these went missing. Oops
    * Update canwrap
    [canwrap.c, canwrap.h]
2018-06-18 fixed bug, nathan pls look at it
    [adcs_bdot_main.c]
2018-06-18 various CAN fixes across the board
    [adcs_bdot.h, adcs_bdot_main.c, adcs_estim_main.c, adcs_mpc_main.c, adcs_mtq.h, adcs_mtq_main.c, analogsensor.c, analogsensor.h]
2018-06-19 changed sign of temperature and unit
2018-06-19 added agg reset min max ground command
    [canwrap.c, canwrap.h, test.c]
2018-06-19 fixed a bug where bdot's reported magnetometer averages reported over CAN were incorrect
    [adcs_bdot_main.c]
2018-06-19 changed units for battery and gen panel temp
2018-06-19 added gen panel temp and made various fixes to CAN
    [adcs_bdot_main.c, adcs_sensorproc_main.c, eps_batt_main.c, eps_dist_main.c, eps_gen_main.c]
2018-06-20 fixed rollcall resetting on MTQ
    [adcs_mtq_main.c]
2018-06-20 added framework for the spam avg framework on bdot; averages still not quite correct, likely due to inconsistent reading
    [adcs_bdot.h, adcs_bdot_main.c]
2018-06-21 fixed units for distribution can voltage reporting
    [canwrap.h]
2018-06-21 fix spam bug + cleanup code
    [adcs_bdot.h, adcs_bdot_main.c]
2018-06-21 fixed command operations, spam_control_op only enables and disables SPAM, not changes the state. That's another command
    [adcs_bdot_main.c]
2018-06-22 capped min/max count in aggVec to avoid issues #202; made the definition of battery full exposed in coulomb counter and handled a gcmd to change it in batt; made bdot send rc packet 5
    [adcs_bdot.h, adcs_bdot_main.c, agglib.c, agglib.h, coulomb_counter.c, coulomb_counter.h, eps_batt_main.c]
2018-06-22 fixed size of spam on
    [canwrap.c, canwrap.h]
2018-06-23 clean up aggregate code in bdot, fix aggregate issue in bdot for spam avg, implemented pop
    [adcs_bdot.h, adcs_bdot_main.c]
2018-06-23 ADCS/Sensor proc: Fix sun sensor unit conversion to int
    [adcs_sensorproc_ids.h, sunsensor_io.c]
2018-06-25 added comments to dbc
    [signals.csv]
2018-06-25 add mtq pwm time
2018-06-25 added calibration settings
2018-06-26 created autosequence library, replaced dist's autostart sequence with autosequencer
    [autosequence.c, autosequence.h, eps_dist.h, eps_dist_main.c]
2018-06-27 ADSC/FSW: Update autocode
    Update for processing second mag reading from sensor proc
2018-06-27 ADCS/Sensor proc.: Update autocode
    For the mag1/mag2 update
2018-06-28 added missing data to MTQ rollcall
    [adcs_mtq_main.c]
2018-06-28 implemented rollcall sending on PPT; added totalFire count and fixed aggs
    [PPT_main.c]
2018-06-29 added main charge aggs back to PPT
2018-06-29 added condititons for battery balancer to turn off
2018-06-29 fixed the persistence bug with the autosequencer on dist
    [MET.c, MET.h, autosequence.c, autosequence.h, bsp.c, eps_dist_main.c]
2018-06-30 ADCS/Sensor proc.: Fix mag rollcall
    Fixes #180
    [mag_io.c]
2018-06-30 ADCS/Estim: Fix mock TLE epoch
    [adcs_estim_main.c]
2018-06-30 ADCS/Estim: Fix TLE receive and add more to ack
    [adcs_estim.h, adcs_estim_main.c, tle.c, tle.h]
2018-07-02 added rolling variance to aggLib and initialized on MTQ, also some CAN fixes on MTQ
    [adcs_mtq_main.c, agglib.c, agglib.h]
2018-07-02 corrected a mistake in the variance calculation
    [agglib.c]
2018-07-02 reverted removing average reset on some MTQ aggs
    [adcs_mtq_main.c]
2018-07-03 added gain functionality + fix rollcall issue where it gives weird readings for mag. when spam is on
    [adcs_bdot.h, adcs_bdot_main.c, bdot_controller_lib.c, bdot_controller_lib.h, bdot_controller_lib_data.c]
2018-07-05 fixed ppt main done timing
    [PPT_main.c]
2018-07-05 added current range for battery balancing
2018-07-05 reversed gen panel charging polarity
    [eps_gen_main.c]
2018-07-05 fixed a bug in batt where the balancer would never come on
    [eps_batt_main.c]
2018-07-06 added autosequencer CAN packets, accounted for a data length rounding issue in the header generation script
    [CANCHeaderTest.py, canwrap.c, canwrap.h, test.c]
2018-07-09 changed batt's 'MET of last charge' to 'time since last charge'
2018-07-09 added a wait to the sensorproc code so that it doesn't hang on bootup (likely due to the sun sensor starting up)
    [adcs_sensorproc_main.c]
2018-07-09 added gen panel state and charging; added a command to enable/disable battery heater automation
2018-07-10 added logic to batt so that the heater turns off if checking and outside of acceptable conditions
2018-07-10 added reporting gen panels enabled and charging over rollcall
2018-07-10 added a dist rollcall packet for voltage thresholds
2018-07-10 changed voltage to current in dbc
2018-07-12 bdot version with calibration separate from spam. calibration is set to go off every 16 minutes
2018-07-12 version of bdot with two contin. mag data, one w/ calibration, one w/o
2018-07-12 fixed a bug where dist would report the incorrect power state for domains; will help fix #218
    [eps_dist_main.c]
2018-07-12 fixed a bug where gen would not send panel enabled and charging flags properly
    [eps_gen_main.c]
2018-07-12 added back the feature where dist turns off power domains if they don't respond to rollcall
2018-07-13 fixed issues resulting from the merge conflict resolution
    [CANDB-MASTER-DS1.ini, canwrap.c, canwrap.h, test.c]
2018-07-13 fixed more issues that were lost in the dbc merge
    [canwrap.c, canwrap.h]
2018-07-13 fixed some signal names
    [canwrap.c, canwrap.h]
2018-07-13 added grounds commands for dist; added value tables for gen panels
2018-07-13 handled ground commands to reboot dist and before-flight command
    [eps_dist_main.c]
2018-07-16 changed dbc ready to run id replace
    [after.csv, before.csv]
2018-07-16 added a macro for resetminmax, set CAN speed to 62.5
    [can.h, eps_dist_main.c, utils.h]
2018-07-16 c gen from rollcall id revert
    [canwrap.c, canwrap.h, eps_dist_main.c]
2018-07-17 added a rollcall watchdog on dist to reset the CAN chip
    [eps_dist_main.c]
2018-07-18 deleted calibration settings
2018-07-18 added parameters for specific subsystems in reset_minmax; added a packet for dist autoshutoff
    [CANDB-MASTER-DS1.ini, canwrap.c, canwrap.h, test.c]
2018-07-18 added the ability to disable dist's autoshutoff for specific power domains
2018-07-18 handled specific minmax resets on every subsystem
    [PPT_main.c, adcs_bdot_main.c, adcs_estim_main.c, adcs_mpc_main.c, adcs_mtq_main.c, adcs_sensorproc_main.c, eps_batt_main.c, eps_gen_main.c]
2018-07-19 tested all bdot cmds, fixed bugs
    [adcs_bdot.h, adcs_bdot_main.c]
2018-07-19 added timeouts to the i2c library, handled somewhat in the cc and imu libs
2018-07-19 added counts for bytes read/written to the i2c lib; removed logic that could lead to inflated i2c error counts
    [i2c.c, i2c.h]
2018-07-19 handled i2c errors and cleaned up some initialization in dist
    [eps_dist.h, eps_dist_main.c]
2018-07-20 fixed a bug where dist's rollcall watchdog would not restart the CAN controller correctly, leading to the inability to send or receive CAN packets
    [eps_dist.h, eps_dist_main.c]
2018-07-21 Fix IMU endianness
2018-07-22 Configure IMU endianness
2018-07-23 minor fix to i2c waits
    [i2c.c, i2c.h]
2018-07-24 handled nacks in i2c; added an enum for i2c result
2018-07-24 improvements to i2c library reporting
2018-07-24 fixed a bug in dist's autoshutoff where a pd couldn't be turned back on after a shutoff of any kind
    [eps_dist_main.c]
2018-07-25 added a delay before dist checks for responses from power domains to account for startup time
2018-07-27 canBlast changes
    [after.csv, before.csv]
2018-07-27 added a command to set the automation state for battery balancing
2018-07-27 made battery balancing automation on by default, and added a command to change it
2018-07-27 moved the signals in gen's first rc packet closer together to avoid errors when parsed by cosmos
    [canwrap.c]
2018-07-28 added i2c results to sp rollcall 17
2018-07-30 changed dist autoshutoff to be resilient to very fast rollcall; added a power domain state for the initial off and other; drastically slowed down sending of mcp_vp
2018-07-30 added new power domain states to dbc
2018-07-31 fixed bugs in PPT that would cause the SMT to always read low and ign pulse to never go low after firing
    [PPT_main.c]
2018-07-31 added reporting for battery heater and balancer automation states
2018-08-02 cleared reset counts on reset mission command
    [PPT_main.c, adcs_bdot_main.c, adcs_estim_main.c, adcs_mpc_main.c, adcs_mtq_main.c, adcs_sensorproc_main.c, bsp.c, bsp.h]
2018-08-02 changed bdot CAN enums and added variance for magnetometer readings to sp rollcall
2018-08-02 removed setting bdot to auto-determine magnetometer
2018-08-02 added bits to sensorproc mag packets for whether readings are valid for bdot; various small dbc fixes
    [canwrap.c, canwrap.h]
2018-08-03 added a function to bsp to get last reset reason, as SYSRSTIV would clear; handled new signals in bdot
    [PPT_main.c, adcs_bdot_main.c, adcs_estim_main.c, adcs_mpc_main.c, adcs_mtq_main.c, adcs_sensorproc_main.c, bsp.c, bsp.h]
2018-08-03 fixed a bug in the PPT with the new SMT override signal
    [PPT_main.c, canwrap.c]
2018-08-06 added variance reporting to sensorproc
2018-08-06 added magnetorquer phase to magnetometer readings
2018-08-16 commented out part of the magnetometer code to get DEBUG_HIL to work
2018-08-24 moved COM2 and RAHS timed shutoffs to timer lib (independent of the autosequencer) add pd states for autoshutoff
2018-08-24 moved COM2/RAHS timed shutoff to polling timers because we were out of polling timers on dist
2018-09-21 missed some unsaved changes
    [eps_gen_main.c]
2018-10-27 changed dist to send multiple copies of average temp and battV and reset after both send, changed some value tables in the dbc
    [canwrap.h, eps_dist_main.c]
2018-10-29 Revert "Made a script to re-do CAN IDs"
    This reverts commit 5201b11052fb79f20eb795bb934c4e07722ca72a.
    [gnd_class_refactor.py]
2018-10-30 regen of canwrap after ground class bit changes
2018-11-03 updated the CAN model generation script to use correct DLCs
    [CANCHeaderTest.py, CANModelTemplate.c, CAN_Model.h, CAN_Model_main.c]
2018-11-07 changed the battery undervoltage threshold from 5.2V to 6.0V
2018-11-16 fixed spam bug in bdot
    [adcs_bdot_main.c]
2018-12-04 PPT Controller Board Revisions
    Revisions to the PPT Controller Board to reflect the mirroring of the PC-104. CAN routing has been addressed and a diode added to the Charge Board trace. DubSat-1 Components library change is to add Paige's diode to the library.
    [PPT_controller_flight1.brd, PPT_controller_flight1.sch]
2018-12-19 updated AMSAT pins on PC104 connector
2019-01-17 latest CAN Model generation - added opposite pins on, virtual power domains on by default
2019-02-01 fixed a small units error in the gen board
    [eps_gen_main.c]
2019-02-06 moved led toggling around for debugging
2019-02-06 removed writing to config on INA219, reverted LED debugging changes
    [INA219_pcvsensor.h, eps_dist_main.c, pcvsensor.c]
2019-02-06 sped up dist board code
2019-02-17 added packets to the dbc for camera data and COM1 commands
2019-02-23 reverted the core changes to dist logic, but sped up old logic and changed the ina config
    [INA219_pcvsensor.h, bsp.c, eps_dist_main.c, pcvsensor.c]
2019-02-23 added camera data to the CAN model
2019-02-24 increased precision of CAN model timings by 10x; fixed camera data timing
    [CANCHeaderTest.py, CANModelTemplate.c, CANModelTemplate.h, CAN_Model.h, CAN_Model_main.c]
2019-02-25 reverted removing the correct COM1 CAN packets from the dbc
    [canwrap.c, canwrap.h]
2019-02-25 last fixes for DBC revert
    [CAN_Model.h, canwrap.c, canwrap.h]
2019-03-08 fixed a bug in batt's time since last full charge
    [eps_batt_main.c]
2019-03-09 switched default polarity i MTQ y and z axis
2019-03-09 removed battery balancer automation set set balancer to always on
2019-03-12 fixed com1 current units in the dbc
    [CAN_Model.h, canwrap.h]
2019-03-22 fixed a bug where the reason for shutoff on power domains could be reported incorrectly
    [eps_dist_main.c]
2019-03-22 changed pcvsensor to only record results on successful i2c read
2019-03-22 fixed a signal name from the last commit
    [canwrap.c, canwrap.h]
2019-03-22 populated mag variance packet in bdot; fixed dlc in the dbc
    [adcs_bdot.h, adcs_bdot_main.c, canwrap.c]
2019-03-30 added an additional sensorproc packet to the dbc and re-generated canwrap
2019-03-30 added signals for mag variance from sensorproc to the dbc
2019-03-30 reverted added sensorproc packets, since they were already in the dbc
    [CAN_Model.h, CAN_Model_main.c, canwrap.c, canwrap.h, test.c]
2019-04-21 added some error-handling and a new magnetometer subsystem
    [MS5611_Barometer.h, altimeter.c, altimeter.h]
2019-04-21 added simple test harness for barebones magnetometer reading
2019-04-21 some error handling for i2c operations and updated altitude calculation
    [altimeter.c]
2019-05-08 added a command to the dbc for resetting i2c
    [canwrap.c, canwrap.h]
2019-05-09 fixed a bug where the i2c library wouldn't initialize properly
    [i2c.c]
2019-05-11 added a signal to batt_h2 for the last i2c result
2019-05-14 added code to i2c init to reset the bus state; reset now re-initializes i2c registers
    [bsp.c, i2c.c, i2c.h]
2019-05-16 added clock pullup to i2c init
2019-05-17 handled the GCMD_RESET_I2C CAN commmand on dist, gen, and batt by calling the `i2CReset` function
2019-05-17 implemented initial autosequencer methods with the correct timestamps; cleaned up dist code
    [autosequence.h, eps_dist_main.c]
2019-07-06 Flight merge (#230)
    Merge of the flight code into master
    [Battery_Board_f1.GBL, Battery_Board_f1.GBO, Battery_Board_f1.GBP, Battery_Board_f1.GBS, Battery_Board_f1.GTL, Battery_Board_f1.GTO, Battery_Board_f1.GTP, Battery_Board_f1.GTS]
2019-07-11 fix for unpushed mag code
    [magnetometer.c]
