UWCubeSat/DubSat1/(notices)

Notices in the files:
parts and their libraries:
SparkFun-Connectors: Licensing: Creative Commons ShareAlike 4.0 International - https://creativecommons.org/licenses/by-sa/4.0
dicons: Copyright (C) 2004, Bob Starr (rtzaudio@mindspring.com)
